LilywantbecomeNIUBI/fpga-system-integration/docs/evidence/adc_remap_v2/timing_report.txt

//Copyright (C)2014-2026 Gowin Semiconductor Corporation.
//All rights reserved.

INTRODUCTION:
The document contains two main sections: Timing Report Directory and Core Timing Report.

============================================================
Note:Timing Report Directory

1. Timing Message
2. Timing Summaries
	2.1 STA Tool Run Summary
	2.2 Clock Summary
	2.3 Max Frequency Summary
	2.4 Total Negative Slack Summary
3. Timing Details
	3.1 Path Slacks Table
		3.1.1 Setup Paths Table
		3.1.2 Hold Paths Table
		3.1.3 Recovery Paths Table
		3.1.4 Removal Paths Table
	3.2 Minimum Pulse Width Table
	3.3 Timing Report By Analysis Type
		3.3.1 Setup Analysis Report
		3.3.2 Hold Analysis Report
		3.3.3 Recovery Analysis Report
		3.3.4 Removal Analysis Report
	3.4 Minimum Pulse Width Report
	3.5 High Fanout Nets Report
	3.6 Route Congestions Report
	3.7 Timing Exceptions Report
		3.7.1 Setup Analysis Report
		3.7.2 Hold Analysis Report
		3.7.3 Recovery Analysis Report
		3.7.4 Recovery Analysis Report
	3.8 Timing Constraints Report

============================================================

Note:Core Timing Report

1. Timing Messages
<Report Title>: Timing Analysis Report
<Design File>: E:\Gowin_project\fpga_project\team_repos\fpga-system-integration\build\system\impl\gwsynthesis\system.vg
<Physical Constraints File>: E:\Gowin_project\fpga_project\team_repos\fpga-system-integration\build\system\system.cst
<Timing Constraints File>: E:\Gowin_project\fpga_project\team_repos\fpga-system-integration\build\system\system.sdc
<Tool Version>: V1.9.12.04 (64-bit)
<Part Number>: GW5AT-LV138PG484AC1/I0
<Device>: GW5AT-138
<Device Version>: B
<Created Time>: Thu Oct 29 13:29:05 2026

2. Timing Summaries
2.1 STA Tool Run Summary
<Setup Delay Model>:Slow 0.873V 0C C1/I0
<Hold Delay Model>:Fast 0.927V 85C C1/I0
<Numbers of Paths Analyzed>:73251
<Numbers of Endpoints Analyzed>:58299
<Numbers of Falling Endpoints>:5
<Numbers of Setup Violated Endpoints>:0
<Numbers of Hold Violated Endpoints>:0

2.2 Clock Summary
  NO.   Clock Name     Type      Period   Frequency    Rise     Fall    Source    Master      Objects
 ===== ============ =========== ======== ============ ======= ======== ========= ======== ================
  1     sys50        Base        20.000   50.000MHz    0.000   10.000                      clk50m
  2     cam_pclk     Base        11.905   84.000MHz    0.000   5.952                       camera_pclk
  3     eth_rx125    Base        8.000    125.000MHz   0.000   4.000                       rgmii_rxc
  4     control50    Generated   20.000   50.000MHz    0.000   10.000   clk50m    sys50    camera/clk50
  5     eth125       Generated   8.000    125.000MHz   0.000   4.000    clk50m    sys50    camera/clk125

2.3 Max Frequency Summary
  NO.   Clock Name    Constraint    Actual Fmax    Level   Entity
 ===== ============ ============== ============== ======= ========
  1     sys50        50.000(MHz)    73.301(MHz)    8       TOP
  2     cam_pclk     84.000(MHz)    84.184(MHz)    16      TOP
  3     eth_rx125    125.000(MHz)   372.537(MHz)   3       TOP
  4     control50    50.000(MHz)    158.688(MHz)   9       TOP
  5     eth125       125.000(MHz)   125.589(MHz)   1       TOP

2.4 Total Negative Slack Summary
  Clock Name   Analysis Type   EndPoints TNS   Number of EndPoints
 ============ =============== =============== =====================
  sys50        setup           0.000           0
  sys50        hold            0.000           0
  cam_pclk     setup           0.000           0
  cam_pclk     hold            0.000           0
  eth_rx125    setup           0.000           0
  eth_rx125    hold            0.000           0
  control50    setup           0.000           0
  control50    hold            0.000           0
  eth125       setup           0.000           0
  eth125       hold            0.000           0

3. Timing Details
3.1 Path Slacks Table
3.1.1 Setup Paths Table
<Report Command>:report_timing -setup -max_paths 25 -max_common_paths 1
  Path Number   Path Slack                     From Node                                           To Node                         From Clock      To Clock     Relation   Clock Skew   Data Delay
 ============= ============ ================================================ =================================================== ============== ============== ========== ============ ============
  1             0.026        camera/tracker/forward_u_6_s1/Q                  camera/tracker/lk/n1522_s/C[28]                     cam_pclk:[R]   cam_pclk:[R]   11.905     0.033        11.121
  2             0.029        camera/tracker/forward_u_6_s1/Q                  camera/tracker/lk/n1338_s/C[10]                     cam_pclk:[R]   cam_pclk:[R]   11.905     0.025        11.171
  3             0.038        camera/stream/frame_address_10_s9/Q              camera/stream/ram_ram_3_13_s/ADB[10]                eth125:[R]     eth125:[R]     8.000      0.066        7.962
  4             0.042        camera/tracker/forward_u_6_s1/Q                  camera/tracker/lk/n1522_s/C[45]                     cam_pclk:[R]   cam_pclk:[R]   11.905     0.033        11.313
  5             0.047        camera/tracker/sort_j_3_s3/Q                     camera/tracker/sort_u_sort_u_RAMREG_13_G[7]_s0/CE   cam_pclk:[R]   cam_pclk:[R]   11.905     0.020        11.558
  6             0.052        camera/stream/frame_address_2_s11/Q              camera/stream/ram_ram_1_1_s/ADB[2]                  eth125:[R]     eth125:[R]     8.000      0.050        7.963
  7             0.056        camera/tracker/forward_u_6_s1/Q                  camera/tracker/lk/n1522_s/C[46]                     cam_pclk:[R]   cam_pclk:[R]   11.905     0.033        11.186
  8             0.063        camera/stream/line_ram_line_ram_0_0_s/DO[5]      camera/runtime_network.net/udp/tx_data_5_s0/D       eth125:[R]     eth125:[R]     8.000      -0.022       7.902
  9             0.064        camera/runtime_network.net/retry_count_26_s0/Q   camera/runtime_network.net/action_2_s17/D           eth125:[R]     eth125:[R]     8.000      0.009        7.869
  10            0.074        camera/runtime_network.net/retry_count_26_s0/Q   camera/runtime_network.net/action_2_s8/D            eth125:[R]     eth125:[R]     8.000      0.041        7.828
  11            0.074        camera/runtime_network.net/retry_count_26_s0/Q   camera/runtime_network.net/action_2_s7/D            eth125:[R]     eth125:[R]     8.000      0.041        7.828
  12            0.074        camera/runtime_network.net/retry_count_26_s0/Q   camera/runtime_network.net/action_2_s6/D            eth125:[R]     eth125:[R]     8.000      0.041        7.828
  13            0.074        camera/runtime_network.net/retry_count_26_s0/Q   camera/runtime_network.net/action_2_s4/D            eth125:[R]     eth125:[R]     8.000      0.041        7.828
  14            0.074        camera/runtime_network.net/retry_count_26_s0/Q   camera/runtime_network.net/action_2_s0/D            eth125:[R]     eth125:[R]     8.000      0.041        7.828
  15            0.079        camera/stream/line_ram_line_ram_0_0_s/DO[15]     camera/runtime_network.net/udp/tx_data_7_s0/D       eth125:[R]     eth125:[R]     8.000      -0.028       7.892
  16            0.088        camera/tracker/forward_v_9_s1/Q                  camera/tracker/lk/n1338_s/A[10]                     cam_pclk:[R]   cam_pclk:[R]   11.905     -0.003       11.294
  17            0.092        camera/stream/line_ram_line_ram_0_0_s/DO[14]     camera/runtime_network.net/udp/tx_data_6_s0/D       eth125:[R]     eth125:[R]     8.000      -0.022       7.873
  18            0.092        camera/runtime_network.net/retry_count_26_s0/Q   camera/runtime_network.net/action_2_s16/D           eth125:[R]     eth125:[R]     8.000      0.052        7.799
  19            0.092        camera/runtime_network.net/retry_count_26_s0/Q   camera/runtime_network.net/action_2_s13/D           eth125:[R]     eth125:[R]     8.000      0.052        7.799
  20            0.097        camera/tracker/forward_u_6_s1/Q                  camera/tracker/lk/n1522_s/C[47]                     cam_pclk:[R]   cam_pclk:[R]   11.905     0.033        11.186
  21            0.101        camera/runtime_network.net/retry_count_26_s0/Q   camera/runtime_network.net/retry_count_3_s0/D       eth125:[R]     eth125:[R]     8.000      0.020        7.822
  22            0.101        camera/stream/line_ram_line_ram_0_0_s/DO[2]      camera/runtime_network.net/udp/tx_data_2_s0/D       eth125:[R]     eth125:[R]     8.000      -0.022       7.864
  23            0.104        camera/tracker/sort_j_3_s3/Q                     camera/tracker/sort_u_sort_u_RAMREG_15_G[2]_s0/CE   cam_pclk:[R]   cam_pclk:[R]   11.905     -0.070       11.591
  24            0.110        camera/tracker/x2_4_s0/Q                         camera/tracker/y2_1_s0/CE                           cam_pclk:[R]   cam_pclk:[R]   11.905     -0.015       11.529
  25            0.110        camera/tracker/x2_4_s0/Q                         camera/tracker/y2_4_s0/CE                           cam_pclk:[R]   cam_pclk:[R]   11.905     -0.015       11.529

3.1.2 Hold Paths Table
<Report Command>:report_timing -hold -max_paths 25 -max_common_paths 1
  Path Number   Path Slack                           From Node                                                       To Node                               From Clock       To Clock      Relation   Clock Skew   Data Delay
 ============= ============ ============================================================ =============================================================== =============== =============== ========== ============ ============
  1             0.216        camera/grid/a_col_6_s0/Q                                     camera/grid/vertical_y_vertical_y_0_0_s/ADB[10]                 cam_pclk:[R]    cam_pclk:[R]    0.000      -0.009       0.256
  2             0.222        camera/stream/frame_address_2_s1/Q                           camera/stream/ram_ram_0_15_s/ADB[2]                             eth125:[R]      eth125:[R]      0.000      -0.008       0.262
  3             0.230        camera/grid/a_col_2_s0/Q                                     camera/grid/vertical_y_vertical_y_0_0_s/ADB[6]                  cam_pclk:[R]    cam_pclk:[R]    0.000      0.003        0.258
  4             0.232        camera/pixels/out_pixel_3_s0/Q                               camera/stream/ram_ram_2_3_s/DI[0]                               cam_pclk:[R]    cam_pclk:[R]    0.000      -0.002       0.267
  5             0.239        camera/runtime_network.net/write_index_6_s5/Q                camera/runtime_network.net/packet_ram_packet_ram_0_0_s/ADA[9]   eth125:[R]      eth125:[R]      0.000      0.007        0.265
  6             0.247        sender/uart/count_3_s1/Q                                     sender/uart/count_3_s1/D                                        sys50:[R]       sys50:[R]       0.000      0.000        0.270
  7             0.247        imu_status/debug_seq_9_s0/Q                                  imu_status/debug_seq_9_s0/D                                     sys50:[R]       sys50:[R]       0.000      0.000        0.270
  8             0.247        imu_status/debug_seq_24_s0/Q                                 imu_status/debug_seq_24_s0/D                                    sys50:[R]       sys50:[R]       0.000      0.000        0.270
  9             0.247        imu/reader/bus/received_4_s0/Q                               imu/reader/bus/received_4_s0/D                                  sys50:[R]       sys50:[R]       0.000      0.000        0.270
  10            0.247        imu/reader/wait_count_27_s0/Q                                imu/reader/wait_count_27_s0/D                                   sys50:[R]       sys50:[R]       0.000      0.000        0.270
  11            0.247        camera/runtime_network.semantics/frame_idle_cycles_0_s3/Q    camera/runtime_network.semantics/frame_idle_cycles_0_s3/D       eth125:[R]      eth125:[R]      0.000      0.000        0.270
  12            0.247        camera/runtime_network.semantics/frame_idle_cycles_15_s1/Q   camera/runtime_network.semantics/frame_idle_cycles_15_s1/D      eth125:[R]      eth125:[R]      0.000      0.000        0.270
  13            0.247        camera/runtime_network.semantics/frame_idle_cycles_24_s1/Q   camera/runtime_network.semantics/frame_idle_cycles_24_s1/D      eth125:[R]      eth125:[R]      0.000      0.000        0.270
  14            0.247        camera/runtime_network.semantics/frame_idle_cycles_25_s1/Q   camera/runtime_network.semantics/frame_idle_cycles_25_s1/D      eth125:[R]      eth125:[R]      0.000      0.000        0.270
  15            0.247        camera/runtime_network.semantics/frame_idle_cycles_31_s1/Q   camera/runtime_network.semantics/frame_idle_cycles_31_s1/D      eth125:[R]      eth125:[R]      0.000      0.000        0.270
  16            0.247        camera/runtime_network.semantics/idle_cycles_12_s1/Q         camera/runtime_network.semantics/idle_cycles_12_s1/D            eth125:[R]      eth125:[R]      0.000      0.000        0.270
  17            0.247        camera/runtime_network.semantics/idle_cycles_15_s1/Q         camera/runtime_network.semantics/idle_cycles_15_s1/D            eth125:[R]      eth125:[R]      0.000      0.000        0.270
  18            0.247        camera/runtime_network.semantics/idle_cycles_19_s1/Q         camera/runtime_network.semantics/idle_cycles_19_s1/D            eth125:[R]      eth125:[R]      0.000      0.000        0.270
  19            0.247        camera/runtime_network.semantics/idle_cycles_31_s1/Q         camera/runtime_network.semantics/idle_cycles_31_s1/D            eth125:[R]      eth125:[R]      0.000      0.000        0.270
  20            0.247        camera/runtime_network.net/udp/cnt_data_3_s0/Q               camera/runtime_network.net/udp/cnt_data_3_s0/D                  eth125:[R]      eth125:[R]      0.000      0.000        0.270
  21            0.247        camera/runtime_network.net/udp/cnt_data_14_s0/Q              camera/runtime_network.net/udp/cnt_data_14_s0/D                 eth125:[R]      eth125:[R]      0.000      0.000        0.270
  22            0.247        camera/runtime_network.net/udp/cnt_preamble_0_s0/Q           camera/runtime_network.net/udp/cnt_preamble_0_s0/D              eth125:[R]      eth125:[R]      0.000      0.000        0.270
  23            0.247        camera/runtime_network.net/udp/cnt_preamble_1_s0/Q           camera/runtime_network.net/udp/cnt_preamble_1_s0/D              eth125:[R]      eth125:[R]      0.000      0.000        0.270
  24            0.247        camera/runtime_network.net/preamble_1_s1/Q                   camera/runtime_network.net/preamble_1_s1/D                      eth_rx125:[R]   eth_rx125:[R]   0.000      0.000        0.270
  25            0.247        camera/runtime_network.net/arp_index_2_s1/Q                  camera/runtime_network.net/arp_index_2_s1/D                     eth125:[R]      eth125:[R]      0.000      0.000        0.270

3.1.3 Recovery Paths Table
<Report Command>:report_timing -recovery -max_paths 25 -max_common_paths 1
  Path Number   Path Slack                    From Node                                  To Node                  From Clock      To Clock     Relation   Clock Skew   Data Delay
 ============= ============ ============================================= ===================================== ============== ============== ========== ============ ============
  1             2.022        camera/cap_reset/release_pipe_2_s0/Q          camera/tracker/lk/n2885_s/RESET[0]    cam_pclk:[R]   cam_pclk:[R]   11.905     -0.021       9.398
  2             2.272        camera/cap_reset/release_pipe_2_s0/Q          camera/tracker/lk/n2787_s/RESET[0]    cam_pclk:[R]   cam_pclk:[R]   11.905     -0.029       9.156
  3             2.454        camera/cap_reset/release_pipe_2_s0/Q          camera/tracker/lk/n2835_s/RESET[0]    cam_pclk:[R]   cam_pclk:[R]   11.905     -0.021       8.966
  4             2.571        camera/cap_reset/release_pipe_2_s0/Q          camera/tracker/lk/n2739_s/RESET[0]    cam_pclk:[R]   cam_pclk:[R]   11.905     0.068        8.762
  5             2.623        camera/cap_reset/release_pipe_2_s0/Q          camera/tracker/lk/n2691_s/RESET[0]    cam_pclk:[R]   cam_pclk:[R]   11.905     0.076        8.701
  6             4.184        camera/cap_reset/release_pipe_2_s0/Q          camera/tracker/n4966_s/RESET[0]       cam_pclk:[R]   cam_pclk:[R]   11.905     -0.029       7.245
  7             4.252        camera/cap_reset/release_pipe_2_s0/Q          camera/grid/n310_s/RESET[0]           cam_pclk:[R]   cam_pclk:[R]   11.905     -0.029       7.176
  8             4.346        camera/cap_reset/release_pipe_2_s0/Q          camera/tracker/n4674_s0/RESET[0]      cam_pclk:[R]   cam_pclk:[R]   11.905     -0.021       7.129
  9             4.398        camera/cap_reset/release_pipe_2_s0/Q          camera/tracker/lk/n1522_s/RESET[0]    cam_pclk:[R]   cam_pclk:[R]   11.905     -0.012       7.014
  10            4.400        camera/perception_reset/release_pipe_2_s0/Q   camera/stream/gap_0_s3/CLEAR          eth125:[R]     eth125:[R]     8.000      -0.017       3.304
  11            4.400        camera/perception_reset/release_pipe_2_s0/Q   camera/stream/gap_1_s0/CLEAR          eth125:[R]     eth125:[R]     8.000      -0.017       3.304
  12            4.400        camera/perception_reset/release_pipe_2_s0/Q   camera/stream/gap_2_s0/CLEAR          eth125:[R]     eth125:[R]     8.000      -0.017       3.304
  13            4.400        camera/perception_reset/release_pipe_2_s0/Q   camera/stream/ws1_0_s0/CLEAR          eth125:[R]     eth125:[R]     8.000      -0.017       3.304
  14            4.400        camera/perception_reset/release_pipe_2_s0/Q   camera/stream/state_1_s4/CLEAR        eth125:[R]     eth125:[R]     8.000      -0.008       3.296
  15            4.400        camera/perception_reset/release_pipe_2_s0/Q   camera/stream/state_2_s9/CLEAR        eth125:[R]     eth125:[R]     8.000      -0.008       3.296
  16            4.400        camera/perception_reset/release_pipe_2_s0/Q   camera/stream/state_2_s8/CLEAR        eth125:[R]     eth125:[R]     8.000      0.000        3.287
  17            4.400        camera/perception_reset/release_pipe_2_s0/Q   camera/stream/index_0_s4/CLEAR        eth125:[R]     eth125:[R]     8.000      -0.008       3.296
  18            4.400        camera/perception_reset/release_pipe_2_s0/Q   camera/stream/index_1_s3/CLEAR        eth125:[R]     eth125:[R]     8.000      0.000        3.287
  19            4.400        camera/perception_reset/release_pipe_2_s0/Q   camera/stream/state_0_s2/CLEAR        eth125:[R]     eth125:[R]     8.000      0.000        3.287
  20            4.400        camera/perception_reset/release_pipe_2_s0/Q   camera/stream/state_1_s3/CLEAR        eth125:[R]     eth125:[R]     8.000      -0.008       3.296
  21            4.400        camera/perception_reset/release_pipe_2_s0/Q   camera/stream/state_1_s2/CLEAR        eth125:[R]     eth125:[R]     8.000      0.000        3.287
  22            4.400        camera/perception_reset/release_pipe_2_s0/Q   camera/stream/state_2_s7/CLEAR        eth125:[R]     eth125:[R]     8.000      0.000        3.287
  23            4.400        camera/perception_reset/release_pipe_2_s0/Q   camera/stream/rptr_0_s4/CLEAR         eth125:[R]     eth125:[R]     8.000      0.000        3.287
  24            4.400        camera/perception_reset/release_pipe_2_s0/Q   camera/stream/word_index_0_s1/CLEAR   eth125:[R]     eth125:[R]     8.000      -0.008       3.296
  25            4.400        camera/perception_reset/release_pipe_2_s0/Q   camera/stream/word_index_4_s1/CLEAR   eth125:[R]     eth125:[R]     8.000      -0.008       3.296

3.1.4 Removal Paths Table
<Report Command>:report_timing -removal -max_paths 25 -max_common_paths 1
  Path Number   Path Slack                          From Node                                                      To Node                               From Clock       To Clock      Relation   Clock Skew   Data Delay
 ============= ============ ========================================================== =============================================================== =============== =============== ========== ============ ============
  1             0.369        camera/runtime_network.receive_reset/release_pipe_2_s1/Q   camera/runtime_network.net/write_mask_67_s0/CLEAR               eth_rx125:[R]   eth_rx125:[R]   0.000      0.004        0.318
  2             0.369        camera/runtime_network.receive_reset/release_pipe_2_s1/Q   camera/runtime_network.net/write_mask_69_s0/CLEAR               eth_rx125:[R]   eth_rx125:[R]   0.000      0.004        0.318
  3             0.369        camera/runtime_network.receive_reset/release_pipe_2_s1/Q   camera/runtime_network.net/write_mask_71_s0/CLEAR               eth_rx125:[R]   eth_rx125:[R]   0.000      0.004        0.318
  4             0.369        camera/runtime_network.receive_reset/release_pipe_2_s1/Q   camera/runtime_network.net/write_mask_73_s0/CLEAR               eth_rx125:[R]   eth_rx125:[R]   0.000      0.004        0.318
  5             0.369        camera/runtime_network.receive_reset/release_pipe_2_s1/Q   camera/runtime_network.net/rx_byte_2_s0/CLEAR                   eth_rx125:[R]   eth_rx125:[R]   0.000      0.004        0.318
  6             0.380        camera/sys_reset/release_pipe_2_s0/Q                       camera/config_camera/bus/dly_cnt_4_s1/CLEAR                     control50:[R]   control50:[R]   0.000      -0.007       0.339
  7             0.380        camera/sys_reset/release_pipe_2_s0/Q                       camera/config_camera/bus/dly_cnt_5_s1/CLEAR                     control50:[R]   control50:[R]   0.000      -0.007       0.339
  8             0.380        camera/sys_reset/release_pipe_2_s0/Q                       camera/config_camera/bus/dly_cnt_6_s1/CLEAR                     control50:[R]   control50:[R]   0.000      -0.007       0.339
  9             0.380        camera/sys_reset/release_pipe_2_s0/Q                       camera/config_camera/bus/dly_cnt_7_s1/CLEAR                     control50:[R]   control50:[R]   0.000      -0.007       0.339
  10            0.381        camera/sys_reset/release_pipe_2_s0/Q                       camera/config_camera/bus/i2c_bit_shift/state.RD_DATA_s0/CLEAR   control50:[R]   control50:[R]   0.000      0.002        0.332
  11            0.382        camera/sys_reset/release_pipe_2_s0/Q                       camera/config_camera/bus/RW_Done_s2/CLEAR                       control50:[R]   control50:[R]   0.000      -0.005       0.339
  12            0.382        camera/sys_reset/release_pipe_2_s0/Q                       camera/config_camera/bus/dly_cnt_2_s1/CLEAR                     control50:[R]   control50:[R]   0.000      -0.005       0.339
  13            0.383        camera/sys_reset/release_pipe_2_s0/Q                       camera/config_camera/bus/dly_cnt_15_s1/CLEAR                    control50:[R]   control50:[R]   0.000      -0.004       0.339
  14            0.383        camera/sys_reset/release_pipe_2_s0/Q                       camera/config_camera/bus/dly_cnt_16_s1/CLEAR                    control50:[R]   control50:[R]   0.000      -0.004       0.339
  15            0.383        camera/sys_reset/release_pipe_2_s0/Q                       camera/config_camera/bus/dly_cnt_17_s1/CLEAR                    control50:[R]   control50:[R]   0.000      -0.004       0.339
  16            0.385        camera/runtime_network.receive_reset/release_pipe_2_s1/Q   camera/runtime_network.net/write_mask_23_s0/CLEAR               eth_rx125:[R]   eth_rx125:[R]   0.000      -0.005       0.342
  17            0.385        camera/runtime_network.receive_reset/release_pipe_2_s1/Q   camera/runtime_network.net/write_mask_27_s0/CLEAR               eth_rx125:[R]   eth_rx125:[R]   0.000      -0.005       0.342
  18            0.385        camera/runtime_network.receive_reset/release_pipe_2_s1/Q   camera/runtime_network.net/write_mask_65_s0/CLEAR               eth_rx125:[R]   eth_rx125:[R]   0.000      -0.005       0.342
  19            0.385        camera/runtime_network.receive_reset/release_pipe_2_s1/Q   camera/runtime_network.net/write_mask_76_s0/CLEAR               eth_rx125:[R]   eth_rx125:[R]   0.000      -0.005       0.342
  20            0.385        camera/runtime_network.receive_reset/release_pipe_2_s1/Q   camera/runtime_network.net/write_mask_77_s0/CLEAR               eth_rx125:[R]   eth_rx125:[R]   0.000      -0.005       0.342
  21            0.385        camera/runtime_network.receive_reset/release_pipe_2_s1/Q   camera/runtime_network.net/write_mask_78_s0/CLEAR               eth_rx125:[R]   eth_rx125:[R]   0.000      -0.005       0.342
  22            0.387        camera/sys_reset/release_pipe_2_s0/Q                       camera/config_camera/bus/dly_cnt_12_s1/CLEAR                    control50:[R]   control50:[R]   0.000      0.000        0.339
  23            0.387        camera/sys_reset/release_pipe_2_s0/Q                       camera/config_camera/bus/dly_cnt_13_s1/CLEAR                    control50:[R]   control50:[R]   0.000      0.000        0.339
  24            0.387        camera/sys_reset/release_pipe_2_s0/Q                       camera/config_camera/bus/dly_cnt_14_s1/CLEAR                    control50:[R]   control50:[R]   0.000      0.000        0.339
  25            0.387        camera/sys_reset/release_pipe_2_s0/Q                       camera/config_camera/bus/state.IDLE_s0/PRESET                   control50:[R]   control50:[R]   0.000      0.000        0.339

3.2 Minimum Pulse Width Table
Report Command:report_min_pulse_width -nworst 10 -detail
  Number   Slack    Actual Width   Required Width         Type         Clock                   Objects
 ======== ======== ============== ================ ================== ======== =======================================
  1        -0.688   0.212          0.900            High Pulse Width   eth125   camera/stream/ram_ram_0_1_s
  2        -0.688   0.212          0.900            High Pulse Width   eth125   camera/stream/ram_ram_2_15_s
  3        -0.688   0.212          0.900            High Pulse Width   eth125   camera/stream/ram_ram_3_7_s
  4        -0.688   0.212          0.900            High Pulse Width   eth125   camera/stream/ram_ram_4_1_s
  5        -0.688   0.212          0.900            High Pulse Width   eth125   camera/stream/ram_ram_4_13_s
  6        -0.688   0.212          0.900            High Pulse Width   eth125   camera/stream/ram_ram_5_5_s
  7        -0.688   0.212          0.900            High Pulse Width   eth125   camera/stream/ram_ram_6_4_s
  8        -0.688   0.212          0.900            High Pulse Width   eth125   camera/stream/ram_ram_6_10_s
  9        -0.688   0.212          0.900            High Pulse Width   eth125   camera/stream/line_ram_line_ram_0_0_s
  10       -0.688   0.212          0.900            High Pulse Width   eth125   camera/stream/ram_ram_0_14_s

3.3 Timing Report By Analysis Type
3.3.1 Setup Analysis Report
Report Command:report_timing -setup -max_paths 25 -max_common_paths 1
						Path1
Path Summary:
Slack             : 0.026
Data Arrival Time : 16.583
Data Required Time: 16.609
From              : camera/tracker/forward_u_6_s1
To                : camera/tracker/lk/n1522_s
Launch Clk        : cam_pclk:[R]
Latch Clk         : cam_pclk:[R]

Data Arrival Path:
    AT     DELAY   TYPE   RF   FANOUT       LOC                      NODE
 ======== ======= ====== ==== ======== ============== ===================================
  0.000    0.000                                       active clock edge time
  0.000    0.000                                       cam_pclk
  0.000    0.000   tCL    RR   1        IOL2[A]        camera_pclk_ibuf/I
  0.614    0.614   tINS   RR   5101     IOL2[A]        camera_pclk_ibuf/O
  5.462    4.848   tNET   RR   1        R40C46[1][A]   camera/tracker/forward_u_6_s1/CLK
  5.807    0.344   tC2Q   RR   11       R40C46[1][A]   camera/tracker/forward_u_6_s1/Q
  6.262    0.456   tNET   RR   1        R44C47[2][A]   camera/tracker/n1646_s3/I0
  6.773    0.511   tINS   RR   1        R44C47[2][A]   camera/tracker/n1646_s3/F
  7.116    0.343   tNET   RR   2        R45C47[0][A]   camera/tracker/reverse_x_0_s/I1
  7.607    0.490   tINS   RR   1        R45C47[0][A]   camera/tracker/reverse_x_0_s/COUT
  7.607    0.000   tNET   RR   2        R45C47[0][B]   camera/tracker/reverse_x_1_s/CIN
  7.873    0.267   tINS   RR   3        R45C47[0][B]   camera/tracker/reverse_x_1_s/SUM
  8.337    0.463   tNET   RR   1        R49C47[3][B]   camera/tracker/lk/n218_s6/I1
  8.830    0.493   tINS   RR   1        R49C47[3][B]   camera/tracker/lk/n218_s6/F
  8.832    0.002   tNET   RR   1        R49C47[1][B]   camera/tracker/lk/n218_s5/I2
  9.353    0.521   tINS   RR   2        R49C47[1][B]   camera/tracker/lk/n218_s5/F
  9.886    0.533   tNET   RR   1        R50C51[2][B]   camera/tracker/lk/n217_s6/I3
  10.146   0.260   tINS   RR   2        R50C51[2][B]   camera/tracker/lk/n217_s6/F
  10.284   0.138   tNET   RR   1        R50C51[3][A]   camera/tracker/lk/n216_s6/I3
  10.571   0.287   tINS   RF   2        R50C51[3][A]   camera/tracker/lk/n216_s6/F
  10.716   0.145   tNET   FF   1        R50C51[2][A]   camera/tracker/lk/n215_s6/I3
  10.976   0.260   tINS   FR   3        R50C51[2][A]   camera/tracker/lk/n215_s6/F
  11.136   0.160   tNET   RR   1        R49C51[3][A]   camera/tracker/lk/n214_s6/I3
  11.423   0.287   tINS   RF   2        R49C51[3][A]   camera/tracker/lk/n214_s6/F
  11.432   0.009   tNET   FF   1        R49C51[1][B]   camera/tracker/lk/n213_s6/I3
  11.888   0.457   tINS   FR   3        R49C51[1][B]   camera/tracker/lk/n213_s6/F
  12.215   0.326   tNET   RR   1        R49C49[3][A]   camera/tracker/lk/n4680_s39/I2
  12.502   0.287   tINS   RF   2        R49C49[3][A]   camera/tracker/lk/n4680_s39/F
  12.511   0.009   tNET   FF   1        R49C49[2][A]   camera/tracker/lk/n211_s5/I3
  12.967   0.457   tINS   FR   1        R49C49[2][A]   camera/tracker/lk/n211_s5/F
  14.005   1.037   tNET   RR   2        R60C58[2][A]   camera/tracker/lk/n322_s/I0
  14.545   0.540   tINS   RF   1        R60C58[2][A]   camera/tracker/lk/n322_s/COUT
  14.545   0.000   tNET   FF   2        R60C58[2][B]   camera/tracker/lk/n321_s/CIN
  14.811   0.267   tINS   FR   5        R60C58[2][B]   camera/tracker/lk/n321_s/SUM
  15.568   0.757   tNET   RR   1        R57C55[3][A]   camera/tracker/lk/n4713_s43/I0
  15.830   0.262   tINS   RR   16       R57C55[3][A]   camera/tracker/lk/n4713_s43/F
  16.583   0.753   tNET   RR   1        DSP_R55[17]    camera/tracker/lk/n1522_s/C[28]

Data Required Path:
    AT     DELAY    TYPE   RF   FANOUT       LOC                     NODE
 ======== ======== ====== ==== ======== ============= ==================================
  11.905   11.905                                      active clock edge time
  11.905   0.000                                       cam_pclk
  11.905   0.000    tCL    RR   1        IOL2[A]       camera_pclk_ibuf/I
  12.519   0.614    tINS   RR   5101     IOL2[A]       camera_pclk_ibuf/O
  17.334   4.815    tNET   RR   1        DSP_R55[17]   camera/tracker/lk/n1522_s/CLK[0]
  16.609   -0.725   tSu         1        DSP_R55[17]   camera/tracker/lk/n1522_s

Path Statistics:
Clock Skew: -0.033
Setup Relationship: 11.905
Logic Level: 16
Arrival Clock Path delay: (cell: 0.614 11.245%,
                     route: 4.848 88.755%)
Arrival Data Path Delay: (cell: 5.644 50.754%,
                    route: 5.132 46.151%,
                    tC2Q: 0.344 3.096%)
Required Clock Path Delay: (cell: 0.614 11.314%,
                     route: 4.815 88.686%)

						Path2
Path Summary:
Slack             : 0.029
Data Arrival Time : 16.634
Data Required Time: 16.663
From              : camera/tracker/forward_u_6_s1
To                : camera/tracker/lk/n1338_s
Launch Clk        : cam_pclk:[R]
Latch Clk         : cam_pclk:[R]

Data Arrival Path:
    AT     DELAY   TYPE   RF   FANOUT       LOC                      NODE
 ======== ======= ====== ==== ======== ============== ===================================
  0.000    0.000                                       active clock edge time
  0.000    0.000                                       cam_pclk
  0.000    0.000   tCL    RR   1        IOL2[A]        camera_pclk_ibuf/I
  0.614    0.614   tINS   RR   5101     IOL2[A]        camera_pclk_ibuf/O
  5.462    4.848   tNET   RR   1        R40C46[1][A]   camera/tracker/forward_u_6_s1/CLK
  5.807    0.344   tC2Q   RR   11       R40C46[1][A]   camera/tracker/forward_u_6_s1/Q
  6.262    0.456   tNET   RR   1        R44C47[2][A]   camera/tracker/n1646_s3/I0
  6.773    0.511   tINS   RR   1        R44C47[2][A]   camera/tracker/n1646_s3/F
  7.116    0.343   tNET   RR   2        R45C47[0][A]   camera/tracker/reverse_x_0_s/I1
  7.607    0.490   tINS   RR   1        R45C47[0][A]   camera/tracker/reverse_x_0_s/COUT
  7.607    0.000   tNET   RR   2        R45C47[0][B]   camera/tracker/reverse_x_1_s/CIN
  7.873    0.267   tINS   RR   3        R45C47[0][B]   camera/tracker/reverse_x_1_s/SUM
  8.337    0.463   tNET   RR   1        R49C47[3][B]   camera/tracker/lk/n218_s6/I1
  8.830    0.493   tINS   RR   1        R49C47[3][B]   camera/tracker/lk/n218_s6/F
  8.832    0.002   tNET   RR   1        R49C47[1][B]   camera/tracker/lk/n218_s5/I2
  9.353    0.521   tINS   RR   2        R49C47[1][B]   camera/tracker/lk/n218_s5/F
  9.886    0.533   tNET   RR   1        R50C51[2][B]   camera/tracker/lk/n217_s6/I3
  10.146   0.260   tINS   RR   2        R50C51[2][B]   camera/tracker/lk/n217_s6/F
  10.284   0.138   tNET   RR   1        R50C51[3][A]   camera/tracker/lk/n216_s6/I3
  10.571   0.287   tINS   RF   2        R50C51[3][A]   camera/tracker/lk/n216_s6/F
  10.716   0.145   tNET   FF   1        R50C51[2][A]   camera/tracker/lk/n215_s6/I3
  10.976   0.260   tINS   FR   3        R50C51[2][A]   camera/tracker/lk/n215_s6/F
  11.136   0.160   tNET   RR   1        R49C51[3][A]   camera/tracker/lk/n214_s6/I3
  11.423   0.287   tINS   RF   2        R49C51[3][A]   camera/tracker/lk/n214_s6/F
  11.432   0.009   tNET   FF   1        R49C51[1][B]   camera/tracker/lk/n213_s6/I3
  11.888   0.457   tINS   FR   3        R49C51[1][B]   camera/tracker/lk/n213_s6/F
  12.215   0.326   tNET   RR   1        R49C49[3][A]   camera/tracker/lk/n4680_s39/I2
  12.502   0.287   tINS   RF   2        R49C49[3][A]   camera/tracker/lk/n4680_s39/F
  12.511   0.009   tNET   FF   1        R49C49[2][A]   camera/tracker/lk/n211_s5/I3
  12.967   0.457   tINS   FR   1        R49C49[2][A]   camera/tracker/lk/n211_s5/F
  14.005   1.037   tNET   RR   2        R60C58[2][A]   camera/tracker/lk/n322_s/I0
  14.708   0.703   tINS   RR   1        R60C58[2][A]   camera/tracker/lk/n322_s/SUM
  15.636   0.928   tNET   RR   1        R54C54[0][A]   camera/tracker/lk/n4714_s37/I0
  15.896   0.260   tINS   RR   3        R54C54[0][A]   camera/tracker/lk/n4714_s37/F
  16.634   0.738   tNET   RR   1        DSP_R55[18]    camera/tracker/lk/n1338_s/C[10]

Data Required Path:
    AT     DELAY    TYPE   RF   FANOUT       LOC                     NODE
 ======== ======== ====== ==== ======== ============= ==================================
  11.905   11.905                                      active clock edge time
  11.905   0.000                                       cam_pclk
  11.905   0.000    tCL    RR   1        IOL2[A]       camera_pclk_ibuf/I
  12.519   0.614    tINS   RR   5101     IOL2[A]       camera_pclk_ibuf/O
  17.342   4.823    tNET   RR   1        DSP_R55[18]   camera/tracker/lk/n1338_s/CLK[0]
  16.663   -0.680   tSu         1        DSP_R55[18]   camera/tracker/lk/n1338_s

Path Statistics:
Clock Skew: -0.025
Setup Relationship: 11.905
Logic Level: 15
Arrival Clock Path delay: (cell: 0.614 11.245%,
                     route: 4.848 88.755%)
Arrival Data Path Delay: (cell: 5.538 49.577%,
                    route: 5.289 47.341%,
                    tC2Q: 0.344 3.082%)
Required Clock Path Delay: (cell: 0.614 11.296%,
                     route: 4.823 88.704%)

						Path3
Path Summary:
Slack             : 0.038
Data Arrival Time : 15.152
Data Required Time: 15.189
From              : camera/stream/frame_address_10_s9
To                : camera/stream/ram_ram_3_13_s
Launch Clk        : eth125:[R]
Latch Clk         : eth125:[R]

Data Arrival Path:
    AT     DELAY   TYPE   RF   FANOUT         LOC                          NODE
 ======== ======= ====== ==== ======== ================== =======================================
  0.000    0.000                                           active clock edge time
  0.000    0.000                                           eth125
  3.835    3.835   tCL    RR   4971     PLL_B[2]           camera/pll/PLL_inst/CLKOUT1
  7.190    3.355   tNET   RR   1        R56C76[0][A]       camera/stream/frame_address_10_s9/CLK
  7.534    0.344   tC2Q   RR   16       R56C76[0][A]       camera/stream/frame_address_10_s9/Q
  15.152   7.617   tNET   RR   1        BSRAM_R64[23][A]   camera/stream/ram_ram_3_13_s/ADB[10]

Data Required Path:
    AT     DELAY   TYPE   RF   FANOUT         LOC                        NODE
 ======== ======= ====== ==== ======== ================== ===================================
  8.000    8.000                                           active clock edge time
  8.000    0.000                                           eth125
  11.835   3.835   tCL    RR   4971     PLL_B[2]           camera/pll/PLL_inst/CLKOUT1
  15.124   3.289   tNET   RR   1        BSRAM_R64[23][A]   camera/stream/ram_ram_3_13_s/CLKB
  15.189   0.065   tSu         1        BSRAM_R64[23][A]   camera/stream/ram_ram_3_13_s

Path Statistics:
Clock Skew: -0.066
Setup Relationship: 8.000
Logic Level: 1
Arrival Clock Path delay: (cell: 0.000 0.000%,
                     route: 3.355 100.000%)
Arrival Data Path Delay: (cell: 0.000 0.000%,
                    route: 7.617 95.676%,
                    tC2Q: 0.344 4.324%)
Required Clock Path Delay: (cell: 0.000 0.000%,
                     route: 3.289 100.000%)

						Path4
Path Summary:
Slack             : 0.042
Data Arrival Time : 16.775
Data Required Time: 16.817
From              : camera/tracker/forward_u_6_s1
To                : camera/tracker/lk/n1522_s
Launch Clk        : cam_pclk:[R]
Latch Clk         : cam_pclk:[R]

Data Arrival Path:
    AT     DELAY   TYPE   RF   FANOUT       LOC                      NODE
 ======== ======= ====== ==== ======== ============== ===================================
  0.000    0.000                                       active clock edge time
  0.000    0.000                                       cam_pclk
  0.000    0.000   tCL    RR   1        IOL2[A]        camera_pclk_ibuf/I
  0.614    0.614   tINS   RR   5101     IOL2[A]        camera_pclk_ibuf/O
  5.462    4.848   tNET   RR   1        R40C46[1][A]   camera/tracker/forward_u_6_s1/CLK
  5.807    0.344   tC2Q   RR   11       R40C46[1][A]   camera/tracker/forward_u_6_s1/Q
  6.262    0.456   tNET   RR   1        R44C47[2][A]   camera/tracker/n1646_s3/I0
  6.773    0.511   tINS   RR   1        R44C47[2][A]   camera/tracker/n1646_s3/F
  7.116    0.343   tNET   RR   2        R45C47[0][A]   camera/tracker/reverse_x_0_s/I1
  7.607    0.490   tINS   RR   1        R45C47[0][A]   camera/tracker/reverse_x_0_s/COUT
  7.607    0.000   tNET   RR   2        R45C47[0][B]   camera/tracker/reverse_x_1_s/CIN
  7.873    0.267   tINS   RR   3        R45C47[0][B]   camera/tracker/reverse_x_1_s/SUM
  8.337    0.463   tNET   RR   1        R49C47[3][B]   camera/tracker/lk/n218_s6/I1
  8.830    0.493   tINS   RR   1        R49C47[3][B]   camera/tracker/lk/n218_s6/F
  8.832    0.002   tNET   RR   1        R49C47[1][B]   camera/tracker/lk/n218_s5/I2
  9.353    0.521   tINS   RR   2        R49C47[1][B]   camera/tracker/lk/n218_s5/F
  9.886    0.533   tNET   RR   1        R50C51[2][B]   camera/tracker/lk/n217_s6/I3
  10.146   0.260   tINS   RR   2        R50C51[2][B]   camera/tracker/lk/n217_s6/F
  10.284   0.138   tNET   RR   1        R50C51[3][A]   camera/tracker/lk/n216_s6/I3
  10.571   0.287   tINS   RF   2        R50C51[3][A]   camera/tracker/lk/n216_s6/F
  10.716   0.145   tNET   FF   1        R50C51[2][A]   camera/tracker/lk/n215_s6/I3
  10.976   0.260   tINS   FR   3        R50C51[2][A]   camera/tracker/lk/n215_s6/F
  11.136   0.160   tNET   RR   1        R49C51[3][A]   camera/tracker/lk/n214_s6/I3
  11.423   0.287   tINS   RF   2        R49C51[3][A]   camera/tracker/lk/n214_s6/F
  11.432   0.009   tNET   FF   1        R49C51[1][B]   camera/tracker/lk/n213_s6/I3
  11.888   0.457   tINS   FR   3        R49C51[1][B]   camera/tracker/lk/n213_s6/F
  12.215   0.326   tNET   RR   1        R49C49[3][A]   camera/tracker/lk/n4680_s39/I2
  12.502   0.287   tINS   RF   2        R49C49[3][A]   camera/tracker/lk/n4680_s39/F
  12.511   0.009   tNET   FF   1        R49C49[2][A]   camera/tracker/lk/n211_s5/I3
  12.967   0.457   tINS   FR   1        R49C49[2][A]   camera/tracker/lk/n211_s5/F
  14.005   1.037   tNET   RR   2        R60C58[2][A]   camera/tracker/lk/n322_s/I0
  14.545   0.540   tINS   RF   1        R60C58[2][A]   camera/tracker/lk/n322_s/COUT
  14.545   0.000   tNET   FF   2        R60C58[2][B]   camera/tracker/lk/n321_s/CIN
  14.811   0.267   tINS   FR   5        R60C58[2][B]   camera/tracker/lk/n321_s/SUM
  15.568   0.757   tNET   RR   1        R57C55[0][A]   camera/tracker/lk/n4713_s37/I0
  16.025   0.457   tINS   RR   11       R57C55[0][A]   camera/tracker/lk/n4713_s37/F
  16.775   0.750   tNET   RR   1        DSP_R55[17]    camera/tracker/lk/n1522_s/C[45]

Data Required Path:
    AT     DELAY    TYPE   RF   FANOUT       LOC                     NODE
 ======== ======== ====== ==== ======== ============= ==================================
  11.905   11.905                                      active clock edge time
  11.905   0.000                                       cam_pclk
  11.905   0.000    tCL    RR   1        IOL2[A]       camera_pclk_ibuf/I
  12.519   0.614    tINS   RR   5101     IOL2[A]       camera_pclk_ibuf/O
  17.334   4.815    tNET   RR   1        DSP_R55[17]   camera/tracker/lk/n1522_s/CLK[0]
  16.817   -0.517   tSu         1        DSP_R55[17]   camera/tracker/lk/n1522_s

Path Statistics:
Clock Skew: -0.033
Setup Relationship: 11.905
Logic Level: 16
Arrival Clock Path delay: (cell: 0.614 11.245%,
                     route: 4.848 88.755%)
Arrival Data Path Delay: (cell: 5.839 51.611%,
                    route: 5.130 45.346%,
                    tC2Q: 0.344 3.043%)
Required Clock Path Delay: (cell: 0.614 11.314%,
                     route: 4.815 88.686%)

						Path5
Path Summary:
Slack             : 0.047
Data Arrival Time : 16.916
Data Required Time: 16.962
From              : camera/tracker/sort_j_3_s3
To                : camera/tracker/sort_u_sort_u_RAMREG_13_G[7]_s0
Launch Clk        : cam_pclk:[R]
Latch Clk         : cam_pclk:[R]

Data Arrival Path:
    AT     DELAY   TYPE   RF   FANOUT       LOC                              NODE
 ======== ======= ====== ==== ======== ============== ===================================================
  0.000    0.000                                       active clock edge time
  0.000    0.000                                       cam_pclk
  0.000    0.000   tCL    RR   1        IOL2[A]        camera_pclk_ibuf/I
  0.614    0.614   tINS   RR   5101     IOL2[A]        camera_pclk_ibuf/O
  5.357    4.743   tNET   RR   1        R40C35[3][B]   camera/tracker/sort_j_3_s3/CLK
  5.701    0.344   tC2Q   RR   16       R40C35[3][B]   camera/tracker/sort_j_3_s3/Q
  6.993    1.291   tNET   RR   1        R38C32[2][B]   camera/tracker/n3796_s17/I3
  7.504    0.511   tINS   RR   16       R38C32[2][B]   camera/tracker/n3796_s17/F
  8.318    0.815   tNET   RR   1        R35C30[0][B]   camera/tracker/sort_u_RAMOUT_105_G[0]_s42/I2
  8.829    0.511   tINS   RR   1        R35C30[0][B]   camera/tracker/sort_u_RAMOUT_105_G[0]_s42/F
  8.829    0.000   tNET   RR   1        R35C30[0][A]   camera/tracker/sort_u_RAMOUT_105_G[0]_s20/I1
  8.964    0.135   tINS   RR   1        R35C30[0][A]   camera/tracker/sort_u_RAMOUT_105_G[0]_s20/O
  8.964    0.000   tNET   RR   1        R35C30[0][B]   camera/tracker/sort_u_RAMOUT_105_G[0]_s10/I1
  9.042    0.078   tINS   RR   1        R35C30[0][B]   camera/tracker/sort_u_RAMOUT_105_G[0]_s10/O
  9.042    0.000   tNET   RR   1        R35C30[1][B]   camera/tracker/sort_u_RAMOUT_105_G[0]_s4/I1
  9.119    0.078   tINS   RR   2        R35C30[1][B]   camera/tracker/sort_u_RAMOUT_105_G[0]_s4/O
  10.680   1.560   tNET   RR   2        R31C34[0][B]   camera/tracker/n3816_s39/I1
  11.170   0.490   tINS   RR   1        R31C34[0][B]   camera/tracker/n3816_s39/COUT
  11.170   0.000   tNET   RR   2        R31C34[1][A]   camera/tracker/n3816_s40/CIN
  11.215   0.045   tINS   RR   1        R31C34[1][A]   camera/tracker/n3816_s40/COUT
  11.215   0.000   tNET   RR   2        R31C34[1][B]   camera/tracker/n3816_s41/CIN
  11.260   0.045   tINS   RR   1        R31C34[1][B]   camera/tracker/n3816_s41/COUT
  11.260   0.000   tNET   RR   2        R31C34[2][A]   camera/tracker/n3816_s42/CIN
  11.305   0.045   tINS   RR   1        R31C34[2][A]   camera/tracker/n3816_s42/COUT
  11.305   0.000   tNET   RR   2        R31C34[2][B]   camera/tracker/n3816_s43/CIN
  11.350   0.045   tINS   RR   1        R31C34[2][B]   camera/tracker/n3816_s43/COUT
  11.350   0.000   tNET   RR   2        R31C35[0][A]   camera/tracker/n3816_s44/CIN
  11.395   0.045   tINS   RR   1        R31C35[0][A]   camera/tracker/n3816_s44/COUT
  11.395   0.000   tNET   RR   2        R31C35[0][B]   camera/tracker/n3816_s45/CIN
  11.440   0.045   tINS   RR   1        R31C35[0][B]   camera/tracker/n3816_s45/COUT
  11.440   0.000   tNET   RR   2        R31C35[1][A]   camera/tracker/n3816_s46/CIN
  11.485   0.045   tINS   RR   1        R31C35[1][A]   camera/tracker/n3816_s46/COUT
  11.485   0.000   tNET   RR   2        R31C35[1][B]   camera/tracker/n3816_s47/CIN
  11.530   0.045   tINS   RR   7        R31C35[1][B]   camera/tracker/n3816_s47/COUT
  12.641   1.110   tNET   RR   1        R43C32[0][B]   camera/tracker/sort_u_s1376/I1
  13.151   0.511   tINS   RR   10       R43C32[0][B]   camera/tracker/sort_u_s1376/F
  13.323   0.172   tNET   RR   1        R43C31[2][A]   camera/tracker/sort_u_s1373/I2
  13.583   0.260   tINS   RR   8        R43C31[2][A]   camera/tracker/sort_u_s1373/F
  14.154   0.570   tNET   RR   1        R41C34[2][B]   camera/tracker/sort_u_s1304/I2
  14.610   0.457   tINS   RR   16       R41C34[2][B]   camera/tracker/sort_u_s1304/F
  16.916   2.305   tNET   RR   1        R35C28[2][A]   camera/tracker/sort_u_sort_u_RAMREG_13_G[7]_s0/CE

Data Required Path:
    AT     DELAY    TYPE   RF   FANOUT       LOC                               NODE
 ======== ======== ====== ==== ======== ============== ====================================================
  11.905   11.905                                       active clock edge time
  11.905   0.000                                        cam_pclk
  11.905   0.000    tCL    RR   1        IOL2[A]        camera_pclk_ibuf/I
  12.519   0.614    tINS   RR   5101     IOL2[A]        camera_pclk_ibuf/O
  17.242   4.723    tNET   RR   1        R35C28[2][A]   camera/tracker/sort_u_sort_u_RAMREG_13_G[7]_s0/CLK
  16.962   -0.280   tSu         1        R35C28[2][A]   camera/tracker/sort_u_sort_u_RAMREG_13_G[7]_s0

Path Statistics:
Clock Skew: -0.020
Setup Relationship: 11.905
Logic Level: 9
Arrival Clock Path delay: (cell: 0.614 11.466%,
                     route: 4.743 88.534%)
Arrival Data Path Delay: (cell: 3.390 29.326%,
                    route: 7.824 67.695%,
                    tC2Q: 0.344 2.978%)
Required Clock Path Delay: (cell: 0.614 11.508%,
                     route: 4.723 88.492%)

						Path6
Path Summary:
Slack             : 0.052
Data Arrival Time : 15.137
Data Required Time: 15.189
From              : camera/stream/frame_address_2_s11
To                : camera/stream/ram_ram_1_1_s
Launch Clk        : eth125:[R]
Latch Clk         : eth125:[R]

Data Arrival Path:
    AT     DELAY   TYPE   RF   FANOUT        LOC                        NODE
 ======== ======= ====== ==== ======== =============== =======================================
  0.000    0.000                                        active clock edge time
  0.000    0.000                                        eth125
  3.835    3.835   tCL    RR   4971     PLL_B[2]        camera/pll/PLL_inst/CLKOUT1
  7.174    3.339   tNET   RR   1        R53C78[0][B]    camera/stream/frame_address_2_s11/CLK
  7.518    0.344   tC2Q   RR   16       R53C78[0][B]    camera/stream/frame_address_2_s11/Q
  15.137   7.618   tNET   RR   1        BSRAM_R64[20]   camera/stream/ram_ram_1_1_s/ADB[2]

Data Required Path:
    AT     DELAY   TYPE   RF   FANOUT        LOC                      NODE
 ======== ======= ====== ==== ======== =============== ==================================
  8.000    8.000                                        active clock edge time
  8.000    0.000                                        eth125
  11.835   3.835   tCL    RR   4971     PLL_B[2]        camera/pll/PLL_inst/CLKOUT1
  15.124   3.289   tNET   RR   1        BSRAM_R64[20]   camera/stream/ram_ram_1_1_s/CLKB
  15.189   0.065   tSu         1        BSRAM_R64[20]   camera/stream/ram_ram_1_1_s

Path Statistics:
Clock Skew: -0.050
Setup Relationship: 8.000
Logic Level: 1
Arrival Clock Path delay: (cell: 0.000 0.000%,
                     route: 3.339 100.000%)
Arrival Data Path Delay: (cell: 0.000 0.000%,
                    route: 7.618 95.677%,
                    tC2Q: 0.344 4.323%)
Required Clock Path Delay: (cell: 0.000 0.000%,
                     route: 3.289 100.000%)

						Path7
Path Summary:
Slack             : 0.056
Data Arrival Time : 16.648
Data Required Time: 16.705
From              : camera/tracker/forward_u_6_s1
To                : camera/tracker/lk/n1522_s
Launch Clk        : cam_pclk:[R]
Latch Clk         : cam_pclk:[R]

Data Arrival Path:
    AT     DELAY   TYPE   RF   FANOUT       LOC                      NODE
 ======== ======= ====== ==== ======== ============== ===================================
  0.000    0.000                                       active clock edge time
  0.000    0.000                                       cam_pclk
  0.000    0.000   tCL    RR   1        IOL2[A]        camera_pclk_ibuf/I
  0.614    0.614   tINS   RR   5101     IOL2[A]        camera_pclk_ibuf/O
  5.462    4.848   tNET   RR   1        R40C46[1][A]   camera/tracker/forward_u_6_s1/CLK
  5.807    0.344   tC2Q   RR   11       R40C46[1][A]   camera/tracker/forward_u_6_s1/Q
  6.262    0.456   tNET   RR   1        R44C47[2][A]   camera/tracker/n1646_s3/I0
  6.773    0.511   tINS   RR   1        R44C47[2][A]   camera/tracker/n1646_s3/F
  7.116    0.343   tNET   RR   2        R45C47[0][A]   camera/tracker/reverse_x_0_s/I1
  7.607    0.490   tINS   RR   1        R45C47[0][A]   camera/tracker/reverse_x_0_s/COUT
  7.607    0.000   tNET   RR   2        R45C47[0][B]   camera/tracker/reverse_x_1_s/CIN
  7.873    0.267   tINS   RR   3        R45C47[0][B]   camera/tracker/reverse_x_1_s/SUM
  8.337    0.463   tNET   RR   1        R49C47[3][B]   camera/tracker/lk/n218_s6/I1
  8.830    0.493   tINS   RR   1        R49C47[3][B]   camera/tracker/lk/n218_s6/F
  8.832    0.002   tNET   RR   1        R49C47[1][B]   camera/tracker/lk/n218_s5/I2
  9.353    0.521   tINS   RR   2        R49C47[1][B]   camera/tracker/lk/n218_s5/F
  9.886    0.533   tNET   RR   1        R50C51[2][B]   camera/tracker/lk/n217_s6/I3
  10.146   0.260   tINS   RR   2        R50C51[2][B]   camera/tracker/lk/n217_s6/F
  10.284   0.138   tNET   RR   1        R50C51[3][A]   camera/tracker/lk/n216_s6/I3
  10.571   0.287   tINS   RF   2        R50C51[3][A]   camera/tracker/lk/n216_s6/F
  10.716   0.145   tNET   FF   1        R50C51[2][A]   camera/tracker/lk/n215_s6/I3
  10.976   0.260   tINS   FR   3        R50C51[2][A]   camera/tracker/lk/n215_s6/F
  11.136   0.160   tNET   RR   1        R49C51[3][A]   camera/tracker/lk/n214_s6/I3
  11.423   0.287   tINS   RF   2        R49C51[3][A]   camera/tracker/lk/n214_s6/F
  11.432   0.009   tNET   FF   1        R49C51[1][B]   camera/tracker/lk/n213_s6/I3
  11.888   0.457   tINS   FR   3        R49C51[1][B]   camera/tracker/lk/n213_s6/F
  12.215   0.326   tNET   RR   1        R49C49[3][A]   camera/tracker/lk/n4680_s39/I2
  12.502   0.287   tINS   RF   2        R49C49[3][A]   camera/tracker/lk/n4680_s39/F
  12.511   0.009   tNET   FF   1        R49C49[2][A]   camera/tracker/lk/n211_s5/I3
  12.967   0.457   tINS   FR   1        R49C49[2][A]   camera/tracker/lk/n211_s5/F
  14.005   1.037   tNET   RR   2        R60C58[2][A]   camera/tracker/lk/n322_s/I0
  14.545   0.540   tINS   RF   1        R60C58[2][A]   camera/tracker/lk/n322_s/COUT
  14.545   0.000   tNET   FF   2        R60C58[2][B]   camera/tracker/lk/n321_s/CIN
  14.811   0.267   tINS   FR   5        R60C58[2][B]   camera/tracker/lk/n321_s/SUM
  15.568   0.757   tNET   RR   1        R57C55[0][A]   camera/tracker/lk/n4713_s37/I0
  16.025   0.457   tINS   RR   11       R57C55[0][A]   camera/tracker/lk/n4713_s37/F
  16.648   0.623   tNET   RR   1        DSP_R55[17]    camera/tracker/lk/n1522_s/C[46]

Data Required Path:
    AT     DELAY    TYPE   RF   FANOUT       LOC                     NODE
 ======== ======== ====== ==== ======== ============= ==================================
  11.905   11.905                                      active clock edge time
  11.905   0.000                                       cam_pclk
  11.905   0.000    tCL    RR   1        IOL2[A]       camera_pclk_ibuf/I
  12.519   0.614    tINS   RR   5101     IOL2[A]       camera_pclk_ibuf/O
  17.334   4.815    tNET   RR   1        DSP_R55[17]   camera/tracker/lk/n1522_s/CLK[0]
  16.705   -0.629   tSu         1        DSP_R55[17]   camera/tracker/lk/n1522_s

Path Statistics:
Clock Skew: -0.033
Setup Relationship: 11.905
Logic Level: 16
Arrival Clock Path delay: (cell: 0.614 11.245%,
                     route: 4.848 88.755%)
Arrival Data Path Delay: (cell: 5.839 52.198%,
                    route: 5.003 44.725%,
                    tC2Q: 0.344 3.078%)
Required Clock Path Delay: (cell: 0.614 11.314%,
                     route: 4.815 88.686%)

						Path8
Path Summary:
Slack             : 0.063
Data Arrival Time : 15.070
Data Required Time: 15.132
From              : camera/stream/line_ram_line_ram_0_0_s
To                : camera/runtime_network.net/udp/tx_data_5_s0
Launch Clk        : eth125:[R]
Latch Clk         : eth125:[R]

Data Arrival Path:
    AT     DELAY   TYPE   RF   FANOUT        LOC                            NODE
 ======== ======= ====== ==== ======== =============== ===============================================
  0.000    0.000                                        active clock edge time
  0.000    0.000                                        eth125
  3.835    3.835   tCL    RR   4971     PLL_B[2]        camera/pll/PLL_inst/CLKOUT1
  7.168    3.333   tNET   RR   16       BSRAM_R64[15]   camera/stream/line_ram_line_ram_0_0_s/CLKB
  8.977    1.809   tC2Q   RR   1        BSRAM_R64[15]   camera/stream/line_ram_line_ram_0_0_s/DO[5]
  10.356   1.379   tNET   RR   1        R45C71[1][B]    camera/stream/payload_5_s0/I1
  10.813   0.457   tINS   RR   1        R45C71[1][B]    camera/stream/payload_5_s0/F
  12.138   1.325   tNET   RR   1        R68C78[1][B]    camera/stream/payload_5_s/I2
  12.398   0.260   tINS   RR   2        R68C78[1][B]    camera/stream/payload_5_s/F
  12.997   0.600   tNET   RR   1        R77C80[2][A]    camera/runtime_network.net/udp/n936_s21/I0
  13.257   0.260   tINS   RR   1        R77C80[2][A]    camera/runtime_network.net/udp/n936_s21/F
  13.788   0.531   tNET   RR   1        R75C82[0][B]    camera/runtime_network.net/udp/n936_s15/I1
  14.048   0.260   tINS   RR   1        R75C82[0][B]    camera/runtime_network.net/udp/n936_s15/F
  14.203   0.155   tNET   RR   1        R74C82[2][B]    camera/runtime_network.net/udp/n936_s9/I2
  14.463   0.260   tINS   RR   1        R74C82[2][B]    camera/runtime_network.net/udp/n936_s9/F
  14.810   0.346   tNET   RR   1        R74C84[1][B]    camera/runtime_network.net/udp/n936_s6/I3
  15.070   0.260   tINS   RR   1        R74C84[1][B]    camera/runtime_network.net/udp/n936_s6/F
  15.070   0.000   tNET   RR   1        R74C84[1][B]    camera/runtime_network.net/udp/tx_data_5_s0/D

Data Required Path:
    AT     DELAY    TYPE   RF   FANOUT       LOC                             NODE
 ======== ======== ====== ==== ======== ============== =================================================
  8.000    8.000                                        active clock edge time
  8.000    0.000                                        eth125
  11.835   3.835    tCL    RR   4971     PLL_B[2]       camera/pll/PLL_inst/CLKOUT1
  15.190   3.355    tNET   RR   1        R74C84[1][B]   camera/runtime_network.net/udp/tx_data_5_s0/CLK
  15.132   -0.057   tSu         1        R74C84[1][B]   camera/runtime_network.net/udp/tx_data_5_s0

Path Statistics:
Clock Skew: 0.022
Setup Relationship: 8.000
Logic Level: 7
Arrival Clock Path delay: (cell: 0.000 0.000%,
                     route: 3.333 100.000%)
Arrival Data Path Delay: (cell: 1.756 22.224%,
                    route: 4.337 54.883%,
                    tC2Q: 1.809 22.893%)
Required Clock Path Delay: (cell: 0.000 0.000%,
                     route: 3.355 100.000%)

						Path9
Path Summary:
Slack             : 0.064
Data Arrival Time : 15.024
Data Required Time: 15.088
From              : camera/runtime_network.net/retry_count_26_s0
To                : camera/runtime_network.net/action_2_s17
Launch Clk        : eth125:[R]
Latch Clk         : eth125:[R]

Data Arrival Path:
    AT     DELAY   TYPE   RF   FANOUT        LOC                              NODE
 ======== ======= ====== ==== ======== =============== ==================================================
  0.000    0.000                                        active clock edge time
  0.000    0.000                                        eth125
  3.835    3.835   tCL    RR   4971     PLL_B[2]        camera/pll/PLL_inst/CLKOUT1
  7.154    3.319   tNET   RR   1        R74C97[0][A]    camera/runtime_network.net/retry_count_26_s0/CLK
  7.499    0.344   tC2Q   RR   3        R74C97[0][A]    camera/runtime_network.net/retry_count_26_s0/Q
  8.256    0.757   tNET   RR   1        R78C102[3][B]   camera/runtime_network.net/n14594_s10/I0
  8.772    0.516   tINS   RR   1        R78C102[3][B]   camera/runtime_network.net/n14594_s10/F
  8.927    0.155   tNET   RR   1        R79C102[1][A]   camera/runtime_network.net/n14594_s8/I2
  9.438    0.511   tINS   RR   3        R79C102[1][A]   camera/runtime_network.net/n14594_s8/F
  9.920    0.481   tNET   RR   1        R80C103[3][A]   camera/runtime_network.net/n14621_s7/I3
  10.412   0.493   tINS   RR   2        R80C103[3][A]   camera/runtime_network.net/n14621_s7/F
  10.570   0.157   tNET   RR   1        R79C103[3][B]   camera/runtime_network.net/n14621_s6/I2
  11.086   0.516   tINS   RR   11       R79C103[3][B]   camera/runtime_network.net/n14621_s6/F
  12.020   0.934   tNET   RR   1        R70C93[2][B]    camera/runtime_network.net/n10253_s5/I3
  12.541   0.521   tINS   RR   4        R70C93[2][B]    camera/runtime_network.net/n10253_s5/F
  12.891   0.350   tNET   RR   1        R71C92[1][A]    camera/runtime_network.net/n10253_s9/I0
  13.402   0.511   tINS   RR   9        R71C92[1][A]    camera/runtime_network.net/n10253_s9/F
  14.503   1.101   tNET   RR   1        R60C101[0][A]   camera/runtime_network.net/n10252_s21/I2
  15.024   0.521   tINS   RR   1        R60C101[0][A]   camera/runtime_network.net/n10252_s21/F
  15.024   0.000   tNET   RR   1        R60C101[0][A]   camera/runtime_network.net/action_2_s17/D

Data Required Path:
    AT     DELAY    TYPE   RF   FANOUT        LOC                           NODE
 ======== ======== ====== ==== ======== =============== =============================================
  8.000    8.000                                         active clock edge time
  8.000    0.000                                         eth125
  11.835   3.835    tCL    RR   4971     PLL_B[2]        camera/pll/PLL_inst/CLKOUT1
  15.145   3.310    tNET   RR   1        R60C101[0][A]   camera/runtime_network.net/action_2_s17/CLK
  15.088   -0.057   tSu         1        R60C101[0][A]   camera/runtime_network.net/action_2_s17

Path Statistics:
Clock Skew: -0.009
Setup Relationship: 8.000
Logic Level: 8
Arrival Clock Path delay: (cell: 0.000 0.000%,
                     route: 3.319 100.000%)
Arrival Data Path Delay: (cell: 3.589 45.604%,
                    route: 3.936 50.021%,
                    tC2Q: 0.344 4.375%)
Required Clock Path Delay: (cell: 0.000 0.000%,
                     route: 3.310 100.000%)

						Path10
Path Summary:
Slack             : 0.074
Data Arrival Time : 14.982
Data Required Time: 15.056
From              : camera/runtime_network.net/retry_count_26_s0
To                : camera/runtime_network.net/action_2_s8
Launch Clk        : eth125:[R]
Latch Clk         : eth125:[R]

Data Arrival Path:
    AT     DELAY   TYPE   RF   FANOUT        LOC                              NODE
 ======== ======= ====== ==== ======== =============== ==================================================
  0.000    0.000                                        active clock edge time
  0.000    0.000                                        eth125
  3.835    3.835   tCL    RR   4971     PLL_B[2]        camera/pll/PLL_inst/CLKOUT1
  7.154    3.319   tNET   RR   1        R74C97[0][A]    camera/runtime_network.net/retry_count_26_s0/CLK
  7.499    0.344   tC2Q   RR   3        R74C97[0][A]    camera/runtime_network.net/retry_count_26_s0/Q
  8.256    0.757   tNET   RR   1        R78C102[3][B]   camera/runtime_network.net/n14594_s10/I0
  8.772    0.516   tINS   RR   1        R78C102[3][B]   camera/runtime_network.net/n14594_s10/F
  8.927    0.155   tNET   RR   1        R79C102[1][A]   camera/runtime_network.net/n14594_s8/I2
  9.438    0.511   tINS   RR   3        R79C102[1][A]   camera/runtime_network.net/n14594_s8/F
  9.920    0.481   tNET   RR   1        R80C103[3][A]   camera/runtime_network.net/n14621_s7/I3
  10.412   0.493   tINS   RR   2        R80C103[3][A]   camera/runtime_network.net/n14621_s7/F
  10.570   0.157   tNET   RR   1        R79C103[3][B]   camera/runtime_network.net/n14621_s6/I2
  11.086   0.516   tINS   RR   11       R79C103[3][B]   camera/runtime_network.net/n14621_s6/F
  12.020   0.934   tNET   RR   1        R70C93[2][B]    camera/runtime_network.net/n10253_s5/I3
  12.541   0.521   tINS   RR   4        R70C93[2][B]    camera/runtime_network.net/n10253_s5/F
  12.891   0.350   tNET   RR   1        R71C92[2][B]    camera/runtime_network.net/n10253_s8/I0
  13.412   0.521   tINS   RR   10       R71C92[2][B]    camera/runtime_network.net/n10253_s8/F
  14.471   1.060   tNET   RR   1        R68C103[2][A]   camera/runtime_network.net/n10252_s12/I2
  14.982   0.511   tINS   RR   1        R68C103[2][A]   camera/runtime_network.net/n10252_s12/F
  14.982   0.000   tNET   RR   1        R68C103[2][A]   camera/runtime_network.net/action_2_s8/D

Data Required Path:
    AT     DELAY    TYPE   RF   FANOUT        LOC                           NODE
 ======== ======== ====== ==== ======== =============== ============================================
  8.000    8.000                                         active clock edge time
  8.000    0.000                                         eth125
  11.835   3.835    tCL    RR   4971     PLL_B[2]        camera/pll/PLL_inst/CLKOUT1
  15.113   3.278    tNET   RR   1        R68C103[2][A]   camera/runtime_network.net/action_2_s8/CLK
  15.056   -0.057   tSu         1        R68C103[2][A]   camera/runtime_network.net/action_2_s8

Path Statistics:
Clock Skew: -0.041
Setup Relationship: 8.000
Logic Level: 8
Arrival Clock Path delay: (cell: 0.000 0.000%,
                     route: 3.319 100.000%)
Arrival Data Path Delay: (cell: 3.589 45.847%,
                    route: 3.895 49.756%,
                    tC2Q: 0.344 4.398%)
Required Clock Path Delay: (cell: 0.000 0.000%,
                     route: 3.278 100.000%)

						Path11
Path Summary:
Slack             : 0.074
Data Arrival Time : 14.982
Data Required Time: 15.056
From              : camera/runtime_network.net/retry_count_26_s0
To                : camera/runtime_network.net/action_2_s7
Launch Clk        : eth125:[R]
Latch Clk         : eth125:[R]

Data Arrival Path:
    AT     DELAY   TYPE   RF   FANOUT        LOC                              NODE
 ======== ======= ====== ==== ======== =============== ==================================================
  0.000    0.000                                        active clock edge time
  0.000    0.000                                        eth125
  3.835    3.835   tCL    RR   4971     PLL_B[2]        camera/pll/PLL_inst/CLKOUT1
  7.154    3.319   tNET   RR   1        R74C97[0][A]    camera/runtime_network.net/retry_count_26_s0/CLK
  7.499    0.344   tC2Q   RR   3        R74C97[0][A]    camera/runtime_network.net/retry_count_26_s0/Q
  8.256    0.757   tNET   RR   1        R78C102[3][B]   camera/runtime_network.net/n14594_s10/I0
  8.772    0.516   tINS   RR   1        R78C102[3][B]   camera/runtime_network.net/n14594_s10/F
  8.927    0.155   tNET   RR   1        R79C102[1][A]   camera/runtime_network.net/n14594_s8/I2
  9.438    0.511   tINS   RR   3        R79C102[1][A]   camera/runtime_network.net/n14594_s8/F
  9.920    0.481   tNET   RR   1        R80C103[3][A]   camera/runtime_network.net/n14621_s7/I3
  10.412   0.493   tINS   RR   2        R80C103[3][A]   camera/runtime_network.net/n14621_s7/F
  10.570   0.157   tNET   RR   1        R79C103[3][B]   camera/runtime_network.net/n14621_s6/I2
  11.086   0.516   tINS   RR   11       R79C103[3][B]   camera/runtime_network.net/n14621_s6/F
  12.020   0.934   tNET   RR   1        R70C93[2][B]    camera/runtime_network.net/n10253_s5/I3
  12.541   0.521   tINS   RR   4        R70C93[2][B]    camera/runtime_network.net/n10253_s5/F
  12.891   0.350   tNET   RR   1        R71C92[2][B]    camera/runtime_network.net/n10253_s8/I0
  13.412   0.521   tINS   RR   10       R71C92[2][B]    camera/runtime_network.net/n10253_s8/F
  14.471   1.060   tNET   RR   1        R68C103[2][B]   camera/runtime_network.net/n10252_s11/I2
  14.982   0.511   tINS   RR   1        R68C103[2][B]   camera/runtime_network.net/n10252_s11/F
  14.982   0.000   tNET   RR   1        R68C103[2][B]   camera/runtime_network.net/action_2_s7/D

Data Required Path:
    AT     DELAY    TYPE   RF   FANOUT        LOC                           NODE
 ======== ======== ====== ==== ======== =============== ============================================
  8.000    8.000                                         active clock edge time
  8.000    0.000                                         eth125
  11.835   3.835    tCL    RR   4971     PLL_B[2]        camera/pll/PLL_inst/CLKOUT1
  15.113   3.278    tNET   RR   1        R68C103[2][B]   camera/runtime_network.net/action_2_s7/CLK
  15.056   -0.057   tSu         1        R68C103[2][B]   camera/runtime_network.net/action_2_s7

Path Statistics:
Clock Skew: -0.041
Setup Relationship: 8.000
Logic Level: 8
Arrival Clock Path delay: (cell: 0.000 0.000%,
                     route: 3.319 100.000%)
Arrival Data Path Delay: (cell: 3.589 45.847%,
                    route: 3.895 49.756%,
                    tC2Q: 0.344 4.398%)
Required Clock Path Delay: (cell: 0.000 0.000%,
                     route: 3.278 100.000%)

						Path12
Path Summary:
Slack             : 0.074
Data Arrival Time : 14.982
Data Required Time: 15.056
From              : camera/runtime_network.net/retry_count_26_s0
To                : camera/runtime_network.net/action_2_s6
Launch Clk        : eth125:[R]
Latch Clk         : eth125:[R]

Data Arrival Path:
    AT     DELAY   TYPE   RF   FANOUT        LOC                              NODE
 ======== ======= ====== ==== ======== =============== ==================================================
  0.000    0.000                                        active clock edge time
  0.000    0.000                                        eth125
  3.835    3.835   tCL    RR   4971     PLL_B[2]        camera/pll/PLL_inst/CLKOUT1
  7.154    3.319   tNET   RR   1        R74C97[0][A]    camera/runtime_network.net/retry_count_26_s0/CLK
  7.499    0.344   tC2Q   RR   3        R74C97[0][A]    camera/runtime_network.net/retry_count_26_s0/Q
  8.256    0.757   tNET   RR   1        R78C102[3][B]   camera/runtime_network.net/n14594_s10/I0
  8.772    0.516   tINS   RR   1        R78C102[3][B]   camera/runtime_network.net/n14594_s10/F
  8.927    0.155   tNET   RR   1        R79C102[1][A]   camera/runtime_network.net/n14594_s8/I2
  9.438    0.511   tINS   RR   3        R79C102[1][A]   camera/runtime_network.net/n14594_s8/F
  9.920    0.481   tNET   RR   1        R80C103[3][A]   camera/runtime_network.net/n14621_s7/I3
  10.412   0.493   tINS   RR   2        R80C103[3][A]   camera/runtime_network.net/n14621_s7/F
  10.570   0.157   tNET   RR   1        R79C103[3][B]   camera/runtime_network.net/n14621_s6/I2
  11.086   0.516   tINS   RR   11       R79C103[3][B]   camera/runtime_network.net/n14621_s6/F
  12.020   0.934   tNET   RR   1        R70C93[2][B]    camera/runtime_network.net/n10253_s5/I3
  12.541   0.521   tINS   RR   4        R70C93[2][B]    camera/runtime_network.net/n10253_s5/F
  12.891   0.350   tNET   RR   1        R71C92[2][B]    camera/runtime_network.net/n10253_s8/I0
  13.412   0.521   tINS   RR   10       R71C92[2][B]    camera/runtime_network.net/n10253_s8/F
  14.471   1.060   tNET   RR   1        R68C103[1][A]   camera/runtime_network.net/n10252_s10/I2
  14.982   0.511   tINS   RR   1        R68C103[1][A]   camera/runtime_network.net/n10252_s10/F
  14.982   0.000   tNET   RR   1        R68C103[1][A]   camera/runtime_network.net/action_2_s6/D

Data Required Path:
    AT     DELAY    TYPE   RF   FANOUT        LOC                           NODE
 ======== ======== ====== ==== ======== =============== ============================================
  8.000    8.000                                         active clock edge time
  8.000    0.000                                         eth125
  11.835   3.835    tCL    RR   4971     PLL_B[2]        camera/pll/PLL_inst/CLKOUT1
  15.113   3.278    tNET   RR   1        R68C103[1][A]   camera/runtime_network.net/action_2_s6/CLK
  15.056   -0.057   tSu         1        R68C103[1][A]   camera/runtime_network.net/action_2_s6

Path Statistics:
Clock Skew: -0.041
Setup Relationship: 8.000
Logic Level: 8
Arrival Clock Path delay: (cell: 0.000 0.000%,
                     route: 3.319 100.000%)
Arrival Data Path Delay: (cell: 3.589 45.847%,
                    route: 3.895 49.756%,
                    tC2Q: 0.344 4.398%)
Required Clock Path Delay: (cell: 0.000 0.000%,
                     route: 3.278 100.000%)

						Path13
Path Summary:
Slack             : 0.074
Data Arrival Time : 14.982
Data Required Time: 15.056
From              : camera/runtime_network.net/retry_count_26_s0
To                : camera/runtime_network.net/action_2_s4
Launch Clk        : eth125:[R]
Latch Clk         : eth125:[R]

Data Arrival Path:
    AT     DELAY   TYPE   RF   FANOUT        LOC                              NODE
 ======== ======= ====== ==== ======== =============== ==================================================
  0.000    0.000                                        active clock edge time
  0.000    0.000                                        eth125
  3.835    3.835   tCL    RR   4971     PLL_B[2]        camera/pll/PLL_inst/CLKOUT1
  7.154    3.319   tNET   RR   1        R74C97[0][A]    camera/runtime_network.net/retry_count_26_s0/CLK
  7.499    0.344   tC2Q   RR   3        R74C97[0][A]    camera/runtime_network.net/retry_count_26_s0/Q
  8.256    0.757   tNET   RR   1        R78C102[3][B]   camera/runtime_network.net/n14594_s10/I0
  8.772    0.516   tINS   RR   1        R78C102[3][B]   camera/runtime_network.net/n14594_s10/F
  8.927    0.155   tNET   RR   1        R79C102[1][A]   camera/runtime_network.net/n14594_s8/I2
  9.438    0.511   tINS   RR   3        R79C102[1][A]   camera/runtime_network.net/n14594_s8/F
  9.920    0.481   tNET   RR   1        R80C103[3][A]   camera/runtime_network.net/n14621_s7/I3
  10.412   0.493   tINS   RR   2        R80C103[3][A]   camera/runtime_network.net/n14621_s7/F
  10.570   0.157   tNET   RR   1        R79C103[3][B]   camera/runtime_network.net/n14621_s6/I2
  11.086   0.516   tINS   RR   11       R79C103[3][B]   camera/runtime_network.net/n14621_s6/F
  12.020   0.934   tNET   RR   1        R70C93[2][B]    camera/runtime_network.net/n10253_s5/I3
  12.541   0.521   tINS   RR   4        R70C93[2][B]    camera/runtime_network.net/n10253_s5/F
  12.891   0.350   tNET   RR   1        R71C92[2][B]    camera/runtime_network.net/n10253_s8/I0
  13.412   0.521   tINS   RR   10       R71C92[2][B]    camera/runtime_network.net/n10253_s8/F
  14.471   1.060   tNET   RR   1        R68C103[0][A]   camera/runtime_network.net/n10252_s8/I2
  14.982   0.511   tINS   RR   1        R68C103[0][A]   camera/runtime_network.net/n10252_s8/F
  14.982   0.000   tNET   RR   1        R68C103[0][A]   camera/runtime_network.net/action_2_s4/D

Data Required Path:
    AT     DELAY    TYPE   RF   FANOUT        LOC                           NODE
 ======== ======== ====== ==== ======== =============== ============================================
  8.000    8.000                                         active clock edge time
  8.000    0.000                                         eth125
  11.835   3.835    tCL    RR   4971     PLL_B[2]        camera/pll/PLL_inst/CLKOUT1
  15.113   3.278    tNET   RR   1        R68C103[0][A]   camera/runtime_network.net/action_2_s4/CLK
  15.056   -0.057   tSu         1        R68C103[0][A]   camera/runtime_network.net/action_2_s4

Path Statistics:
Clock Skew: -0.041
Setup Relationship: 8.000
Logic Level: 8
Arrival Clock Path delay: (cell: 0.000 0.000%,
                     route: 3.319 100.000%)
Arrival Data Path Delay: (cell: 3.589 45.847%,
                    route: 3.895 49.756%,
                    tC2Q: 0.344 4.398%)
Required Clock Path Delay: (cell: 0.000 0.000%,
                     route: 3.278 100.000%)

						Path14
Path Summary:
Slack             : 0.074
Data Arrival Time : 14.982
Data Required Time: 15.056
From              : camera/runtime_network.net/retry_count_26_s0
To                : camera/runtime_network.net/action_2_s0
Launch Clk        : eth125:[R]
Latch Clk         : eth125:[R]

Data Arrival Path:
    AT     DELAY   TYPE   RF   FANOUT        LOC                              NODE
 ======== ======= ====== ==== ======== =============== ==================================================
  0.000    0.000                                        active clock edge time
  0.000    0.000                                        eth125
  3.835    3.835   tCL    RR   4971     PLL_B[2]        camera/pll/PLL_inst/CLKOUT1
  7.154    3.319   tNET   RR   1        R74C97[0][A]    camera/runtime_network.net/retry_count_26_s0/CLK
  7.499    0.344   tC2Q   RR   3        R74C97[0][A]    camera/runtime_network.net/retry_count_26_s0/Q
  8.256    0.757   tNET   RR   1        R78C102[3][B]   camera/runtime_network.net/n14594_s10/I0
  8.772    0.516   tINS   RR   1        R78C102[3][B]   camera/runtime_network.net/n14594_s10/F
  8.927    0.155   tNET   RR   1        R79C102[1][A]   camera/runtime_network.net/n14594_s8/I2
  9.438    0.511   tINS   RR   3        R79C102[1][A]   camera/runtime_network.net/n14594_s8/F
  9.920    0.481   tNET   RR   1        R80C103[3][A]   camera/runtime_network.net/n14621_s7/I3
  10.412   0.493   tINS   RR   2        R80C103[3][A]   camera/runtime_network.net/n14621_s7/F
  10.570   0.157   tNET   RR   1        R79C103[3][B]   camera/runtime_network.net/n14621_s6/I2
  11.086   0.516   tINS   RR   11       R79C103[3][B]   camera/runtime_network.net/n14621_s6/F
  12.020   0.934   tNET   RR   1        R70C93[2][B]    camera/runtime_network.net/n10253_s5/I3
  12.541   0.521   tINS   RR   4        R70C93[2][B]    camera/runtime_network.net/n10253_s5/F
  12.891   0.350   tNET   RR   1        R71C92[2][B]    camera/runtime_network.net/n10253_s8/I0
  13.412   0.521   tINS   RR   10       R71C92[2][B]    camera/runtime_network.net/n10253_s8/F
  14.471   1.060   tNET   RR   1        R68C103[0][B]   camera/runtime_network.net/n10252_s1/I2
  14.982   0.511   tINS   RR   1        R68C103[0][B]   camera/runtime_network.net/n10252_s1/F
  14.982   0.000   tNET   RR   1        R68C103[0][B]   camera/runtime_network.net/action_2_s0/D

Data Required Path:
    AT     DELAY    TYPE   RF   FANOUT        LOC                           NODE
 ======== ======== ====== ==== ======== =============== ============================================
  8.000    8.000                                         active clock edge time
  8.000    0.000                                         eth125
  11.835   3.835    tCL    RR   4971     PLL_B[2]        camera/pll/PLL_inst/CLKOUT1
  15.113   3.278    tNET   RR   1        R68C103[0][B]   camera/runtime_network.net/action_2_s0/CLK
  15.056   -0.057   tSu         1        R68C103[0][B]   camera/runtime_network.net/action_2_s0

Path Statistics:
Clock Skew: -0.041
Setup Relationship: 8.000
Logic Level: 8
Arrival Clock Path delay: (cell: 0.000 0.000%,
                     route: 3.319 100.000%)
Arrival Data Path Delay: (cell: 3.589 45.847%,
                    route: 3.895 49.756%,
                    tC2Q: 0.344 4.398%)
Required Clock Path Delay: (cell: 0.000 0.000%,
                     route: 3.278 100.000%)

						Path15
Path Summary:
Slack             : 0.079
Data Arrival Time : 15.060
Data Required Time: 15.139
From              : camera/stream/line_ram_line_ram_0_0_s
To                : camera/runtime_network.net/udp/tx_data_7_s0
Launch Clk        : eth125:[R]
Latch Clk         : eth125:[R]

Data Arrival Path:
    AT     DELAY   TYPE   RF   FANOUT        LOC                            NODE
 ======== ======= ====== ==== ======== =============== ===============================================
  0.000    0.000                                        active clock edge time
  0.000    0.000                                        eth125
  3.835    3.835   tCL    RR   4971     PLL_B[2]        camera/pll/PLL_inst/CLKOUT1
  7.168    3.333   tNET   RR   16       BSRAM_R64[15]   camera/stream/line_ram_line_ram_0_0_s/CLKB
  8.977    1.809   tC2Q   RR   1        BSRAM_R64[15]   camera/stream/line_ram_line_ram_0_0_s/DO[15]
  10.538   1.561   tNET   RR   1        R45C71[2][B]    camera/stream/payload_7_s1/I0
  10.798   0.260   tINS   RR   1        R45C71[2][B]    camera/stream/payload_7_s1/F
  11.953   1.155   tNET   RR   1        R69C78[3][B]    camera/stream/payload_7_s/I2
  12.470   0.516   tINS   RR   2        R69C78[3][B]    camera/stream/payload_7_s/F
  13.069   0.600   tNET   RR   1        R77C81[0][A]    camera/runtime_network.net/udp/n932_s17/I0
  13.580   0.511   tINS   RR   1        R77C81[0][A]    camera/runtime_network.net/udp/n932_s17/F
  13.923   0.343   tNET   RR   1        R75C82[2][B]    camera/runtime_network.net/udp/n932_s10/I2
  14.434   0.511   tINS   RR   1        R75C82[2][B]    camera/runtime_network.net/udp/n932_s10/F
  14.800   0.366   tNET   RR   1        R75C85[2][B]    camera/runtime_network.net/udp/n932_s7/I3
  15.060   0.260   tINS   RR   1        R75C85[2][B]    camera/runtime_network.net/udp/n932_s7/F
  15.060   0.000   tNET   RR   1        R75C85[2][B]    camera/runtime_network.net/udp/tx_data_7_s0/D

Data Required Path:
    AT     DELAY    TYPE   RF   FANOUT       LOC                             NODE
 ======== ======== ====== ==== ======== ============== =================================================
  8.000    8.000                                        active clock edge time
  8.000    0.000                                        eth125
  11.835   3.835    tCL    RR   4971     PLL_B[2]       camera/pll/PLL_inst/CLKOUT1
  15.196   3.361    tNET   RR   1        R75C85[2][B]   camera/runtime_network.net/udp/tx_data_7_s0/CLK
  15.139   -0.057   tSu         1        R75C85[2][B]   camera/runtime_network.net/udp/tx_data_7_s0

Path Statistics:
Clock Skew: 0.028
Setup Relationship: 8.000
Logic Level: 6
Arrival Clock Path delay: (cell: 0.000 0.000%,
                     route: 3.333 100.000%)
Arrival Data Path Delay: (cell: 2.058 26.073%,
                    route: 4.025 51.005%,
                    tC2Q: 1.809 22.922%)
Required Clock Path Delay: (cell: 0.000 0.000%,
                     route: 3.361 100.000%)

						Path16
Path Summary:
Slack             : 0.088
Data Arrival Time : 16.728
Data Required Time: 16.817
From              : camera/tracker/forward_v_9_s1
To                : camera/tracker/lk/n1338_s
Launch Clk        : cam_pclk:[R]
Latch Clk         : cam_pclk:[R]

Data Arrival Path:
    AT     DELAY   TYPE   RF   FANOUT       LOC                      NODE
 ======== ======= ====== ==== ======== ============== ===================================
  0.000    0.000                                       active clock edge time
  0.000    0.000                                       cam_pclk
  0.000    0.000   tCL    RR   1        IOL2[A]        camera_pclk_ibuf/I
  0.614    0.614   tINS   RR   5101     IOL2[A]        camera_pclk_ibuf/O
  5.434    4.820   tNET   RR   1        R45C47[2][B]   camera/tracker/forward_v_9_s1/CLK
  5.779    0.344   tC2Q   RR   10       R45C47[2][B]   camera/tracker/forward_v_9_s1/Q
  6.163    0.385   tNET   RR   1        R44C49[3][B]   camera/tracker/n1674_s3/I3
  6.680    0.516   tINS   RR   1        R44C49[3][B]   camera/tracker/n1674_s3/F
  7.583    0.903   tNET   RR   2        R45C54[1][A]   camera/tracker/reverse_y_2_s/I1
  8.143    0.560   tINS   RR   3        R45C54[1][A]   camera/tracker/reverse_y_2_s/SUM
  8.570    0.426   tNET   RR   1        R47C53[0][B]   camera/tracker/lk/n250_s6/I0
  9.091    0.521   tINS   RR   1        R47C53[0][B]   camera/tracker/lk/n250_s6/F
  9.093    0.002   tNET   RR   1        R47C53[0][A]   camera/tracker/lk/n250_s5/I2
  9.604    0.511   tINS   RR   2        R47C53[0][A]   camera/tracker/lk/n250_s5/F
  9.796    0.192   tNET   RR   1        R47C51[0][B]   camera/tracker/lk/n249_s6/I3
  10.056   0.260   tINS   RR   2        R47C51[0][B]   camera/tracker/lk/n249_s6/F
  10.401   0.345   tNET   RR   1        R47C48[2][B]   camera/tracker/lk/n248_s6/I3
  10.912   0.511   tINS   RR   2        R47C48[2][B]   camera/tracker/lk/n248_s6/F
  11.050   0.138   tNET   RR   1        R47C48[3][B]   camera/tracker/lk/n247_s6/I3
  11.312   0.262   tINS   RR   3        R47C48[3][B]   camera/tracker/lk/n247_s6/F
  11.829   0.516   tNET   RR   1        R47C52[3][B]   camera/tracker/lk/n246_s6/I3
  12.116   0.287   tINS   RF   2        R47C52[3][B]   camera/tracker/lk/n246_s6/F
  12.261   0.145   tNET   FF   1        R47C51[3][B]   camera/tracker/lk/n245_s6/I3
  12.777   0.516   tINS   FR   3        R47C51[3][B]   camera/tracker/lk/n245_s6/F
  13.125   0.348   tNET   RR   1        R49C52[1][A]   camera/tracker/lk/n4697_s38/I2
  13.636   0.511   tINS   RR   2        R49C52[1][A]   camera/tracker/lk/n4697_s38/F
  13.979   0.343   tNET   RR   1        R48C54[3][B]   camera/tracker/lk/n243_s5/I3
  14.471   0.493   tINS   RR   1        R48C54[3][B]   camera/tracker/lk/n243_s5/F
  14.627   0.155   tNET   RR   2        R48C55[2][A]   camera/tracker/lk/n387_s/I0
  15.330   0.703   tINS   RR   1        R48C55[2][A]   camera/tracker/lk/n387_s/SUM
  15.485   0.155   tNET   RR   1        R49C55[3][B]   camera/tracker/lk/n4731_s38/I0
  15.978   0.493   tINS   RR   2        R49C55[3][B]   camera/tracker/lk/n4731_s38/F
  16.728   0.750   tNET   RR   1        DSP_R55[18]    camera/tracker/lk/n1338_s/A[10]

Data Required Path:
    AT     DELAY    TYPE   RF   FANOUT       LOC                     NODE
 ======== ======== ====== ==== ======== ============= ==================================
  11.905   11.905                                      active clock edge time
  11.905   0.000                                       cam_pclk
  11.905   0.000    tCL    RR   1        IOL2[A]       camera_pclk_ibuf/I
  12.519   0.614    tINS   RR   5101     IOL2[A]       camera_pclk_ibuf/O
  17.342   4.823    tNET   RR   1        DSP_R55[18]   camera/tracker/lk/n1338_s/CLK[0]
  16.817   -0.526   tSu         1        DSP_R55[18]   camera/tracker/lk/n1338_s

Path Statistics:
Clock Skew: 0.003
Setup Relationship: 11.905
Logic Level: 14
Arrival Clock Path delay: (cell: 0.614 11.303%,
                     route: 4.820 88.697%)
Arrival Data Path Delay: (cell: 6.144 54.398%,
                    route: 4.806 42.554%,
                    tC2Q: 0.344 3.048%)
Required Clock Path Delay: (cell: 0.614 11.296%,
                     route: 4.823 88.704%)

						Path17
Path Summary:
Slack             : 0.092
Data Arrival Time : 15.040
Data Required Time: 15.132
From              : camera/stream/line_ram_line_ram_0_0_s
To                : camera/runtime_network.net/udp/tx_data_6_s0
Launch Clk        : eth125:[R]
Latch Clk         : eth125:[R]

Data Arrival Path:
    AT     DELAY   TYPE   RF   FANOUT        LOC                            NODE
 ======== ======= ====== ==== ======== =============== ===============================================
  0.000    0.000                                        active clock edge time
  0.000    0.000                                        eth125
  3.835    3.835   tCL    RR   4971     PLL_B[2]        camera/pll/PLL_inst/CLKOUT1
  7.168    3.333   tNET   RR   16       BSRAM_R64[15]   camera/stream/line_ram_line_ram_0_0_s/CLKB
  8.977    1.809   tC2Q   RR   1        BSRAM_R64[15]   camera/stream/line_ram_line_ram_0_0_s/DO[14]
  10.403   1.426   tNET   RR   1        R45C71[2][A]    camera/stream/payload_6_s1/I0
  10.663   0.260   tINS   RR   1        R45C71[2][A]    camera/stream/payload_6_s1/F
  11.818   1.155   tNET   RR   1        R69C76[0][B]    camera/stream/payload_6_s/I1
  12.329   0.511   tINS   RR   2        R69C76[0][B]    camera/stream/payload_6_s/F
  13.238   0.909   tNET   RR   1        R76C81[0][A]    camera/runtime_network.net/udp/n934_s15/I0
  13.498   0.260   tINS   RR   1        R76C81[0][A]    camera/runtime_network.net/udp/n934_s15/F
  13.899   0.400   tNET   RR   1        R74C82[3][A]    camera/runtime_network.net/udp/n934_s11/I1
  14.185   0.287   tINS   RF   1        R74C82[3][A]    camera/runtime_network.net/udp/n934_s11/F
  14.530   0.344   tNET   FF   1        R74C84[0][B]    camera/runtime_network.net/udp/n934_s7/I3
  15.040   0.511   tINS   FR   1        R74C84[0][B]    camera/runtime_network.net/udp/n934_s7/F
  15.040   0.000   tNET   RR   1        R74C84[0][B]    camera/runtime_network.net/udp/tx_data_6_s0/D

Data Required Path:
    AT     DELAY    TYPE   RF   FANOUT       LOC                             NODE
 ======== ======== ====== ==== ======== ============== =================================================
  8.000    8.000                                        active clock edge time
  8.000    0.000                                        eth125
  11.835   3.835    tCL    RR   4971     PLL_B[2]       camera/pll/PLL_inst/CLKOUT1
  15.190   3.355    tNET   RR   1        R74C84[0][B]   camera/runtime_network.net/udp/tx_data_6_s0/CLK
  15.132   -0.057   tSu         1        R74C84[0][B]   camera/runtime_network.net/udp/tx_data_6_s0

Path Statistics:
Clock Skew: 0.022
Setup Relationship: 8.000
Logic Level: 6
Arrival Clock Path delay: (cell: 0.000 0.000%,
                     route: 3.333 100.000%)
Arrival Data Path Delay: (cell: 1.828 23.221%,
                    route: 4.236 53.801%,
                    tC2Q: 1.809 22.978%)
Required Clock Path Delay: (cell: 0.000 0.000%,
                     route: 3.355 100.000%)

						Path18
Path Summary:
Slack             : 0.092
Data Arrival Time : 14.953
Data Required Time: 15.045
From              : camera/runtime_network.net/retry_count_26_s0
To                : camera/runtime_network.net/action_2_s16
Launch Clk        : eth125:[R]
Latch Clk         : eth125:[R]

Data Arrival Path:
    AT     DELAY   TYPE   RF   FANOUT        LOC                              NODE
 ======== ======= ====== ==== ======== =============== ==================================================
  0.000    0.000                                        active clock edge time
  0.000    0.000                                        eth125
  3.835    3.835   tCL    RR   4971     PLL_B[2]        camera/pll/PLL_inst/CLKOUT1
  7.154    3.319   tNET   RR   1        R74C97[0][A]    camera/runtime_network.net/retry_count_26_s0/CLK
  7.499    0.344   tC2Q   RR   3        R74C97[0][A]    camera/runtime_network.net/retry_count_26_s0/Q
  8.256    0.757   tNET   RR   1        R78C102[3][B]   camera/runtime_network.net/n14594_s10/I0
  8.772    0.516   tINS   RR   1        R78C102[3][B]   camera/runtime_network.net/n14594_s10/F
  8.927    0.155   tNET   RR   1        R79C102[1][A]   camera/runtime_network.net/n14594_s8/I2
  9.438    0.511   tINS   RR   3        R79C102[1][A]   camera/runtime_network.net/n14594_s8/F
  9.920    0.481   tNET   RR   1        R80C103[3][A]   camera/runtime_network.net/n14621_s7/I3
  10.412   0.493   tINS   RR   2        R80C103[3][A]   camera/runtime_network.net/n14621_s7/F
  10.570   0.157   tNET   RR   1        R79C103[3][B]   camera/runtime_network.net/n14621_s6/I2
  11.086   0.516   tINS   RR   11       R79C103[3][B]   camera/runtime_network.net/n14621_s6/F
  12.020   0.934   tNET   RR   1        R70C93[2][B]    camera/runtime_network.net/n10253_s5/I3
  12.541   0.521   tINS   RR   4        R70C93[2][B]    camera/runtime_network.net/n10253_s5/F
  12.891   0.350   tNET   RR   1        R71C92[1][A]    camera/runtime_network.net/n10253_s9/I0
  13.402   0.511   tINS   RR   9        R71C92[1][A]    camera/runtime_network.net/n10253_s9/F
  14.442   1.041   tNET   RR   1        R66C99[0][B]    camera/runtime_network.net/n10252_s20/I2
  14.953   0.511   tINS   RR   1        R66C99[0][B]    camera/runtime_network.net/n10252_s20/F
  14.953   0.000   tNET   RR   1        R66C99[0][B]    camera/runtime_network.net/action_2_s16/D

Data Required Path:
    AT     DELAY    TYPE   RF   FANOUT       LOC                           NODE
 ======== ======== ====== ==== ======== ============== =============================================
  8.000    8.000                                        active clock edge time
  8.000    0.000                                        eth125
  11.835   3.835    tCL    RR   4971     PLL_B[2]       camera/pll/PLL_inst/CLKOUT1
  15.102   3.267    tNET   RR   1        R66C99[0][B]   camera/runtime_network.net/action_2_s16/CLK
  15.045   -0.057   tSu         1        R66C99[0][B]   camera/runtime_network.net/action_2_s16

Path Statistics:
Clock Skew: -0.052
Setup Relationship: 8.000
Logic Level: 8
Arrival Clock Path delay: (cell: 0.000 0.000%,
                     route: 3.319 100.000%)
Arrival Data Path Delay: (cell: 3.579 45.889%,
                    route: 3.876 49.697%,
                    tC2Q: 0.344 4.414%)
Required Clock Path Delay: (cell: 0.000 0.000%,
                     route: 3.267 100.000%)

						Path19
Path Summary:
Slack             : 0.092
Data Arrival Time : 14.953
Data Required Time: 15.045
From              : camera/runtime_network.net/retry_count_26_s0
To                : camera/runtime_network.net/action_2_s13
Launch Clk        : eth125:[R]
Latch Clk         : eth125:[R]

Data Arrival Path:
    AT     DELAY   TYPE   RF   FANOUT        LOC                              NODE
 ======== ======= ====== ==== ======== =============== ==================================================
  0.000    0.000                                        active clock edge time
  0.000    0.000                                        eth125
  3.835    3.835   tCL    RR   4971     PLL_B[2]        camera/pll/PLL_inst/CLKOUT1
  7.154    3.319   tNET   RR   1        R74C97[0][A]    camera/runtime_network.net/retry_count_26_s0/CLK
  7.499    0.344   tC2Q   RR   3        R74C97[0][A]    camera/runtime_network.net/retry_count_26_s0/Q
  8.256    0.757   tNET   RR   1        R78C102[3][B]   camera/runtime_network.net/n14594_s10/I0
  8.772    0.516   tINS   RR   1        R78C102[3][B]   camera/runtime_network.net/n14594_s10/F
  8.927    0.155   tNET   RR   1        R79C102[1][A]   camera/runtime_network.net/n14594_s8/I2
  9.438    0.511   tINS   RR   3        R79C102[1][A]   camera/runtime_network.net/n14594_s8/F
  9.920    0.481   tNET   RR   1        R80C103[3][A]   camera/runtime_network.net/n14621_s7/I3
  10.412   0.493   tINS   RR   2        R80C103[3][A]   camera/runtime_network.net/n14621_s7/F
  10.570   0.157   tNET   RR   1        R79C103[3][B]   camera/runtime_network.net/n14621_s6/I2
  11.086   0.516   tINS   RR   11       R79C103[3][B]   camera/runtime_network.net/n14621_s6/F
  12.020   0.934   tNET   RR   1        R70C93[2][B]    camera/runtime_network.net/n10253_s5/I3
  12.541   0.521   tINS   RR   4        R70C93[2][B]    camera/runtime_network.net/n10253_s5/F
  12.891   0.350   tNET   RR   1        R71C92[1][A]    camera/runtime_network.net/n10253_s9/I0
  13.402   0.511   tINS   RR   9        R71C92[1][A]    camera/runtime_network.net/n10253_s9/F
  14.442   1.041   tNET   RR   1        R66C99[0][A]    camera/runtime_network.net/n10252_s17/I2
  14.953   0.511   tINS   RR   1        R66C99[0][A]    camera/runtime_network.net/n10252_s17/F
  14.953   0.000   tNET   RR   1        R66C99[0][A]    camera/runtime_network.net/action_2_s13/D

Data Required Path:
    AT     DELAY    TYPE   RF   FANOUT       LOC                           NODE
 ======== ======== ====== ==== ======== ============== =============================================
  8.000    8.000                                        active clock edge time
  8.000    0.000                                        eth125
  11.835   3.835    tCL    RR   4971     PLL_B[2]       camera/pll/PLL_inst/CLKOUT1
  15.102   3.267    tNET   RR   1        R66C99[0][A]   camera/runtime_network.net/action_2_s13/CLK
  15.045   -0.057   tSu         1        R66C99[0][A]   camera/runtime_network.net/action_2_s13

Path Statistics:
Clock Skew: -0.052
Setup Relationship: 8.000
Logic Level: 8
Arrival Clock Path delay: (cell: 0.000 0.000%,
                     route: 3.319 100.000%)
Arrival Data Path Delay: (cell: 3.579 45.889%,
                    route: 3.876 49.697%,
                    tC2Q: 0.344 4.414%)
Required Clock Path Delay: (cell: 0.000 0.000%,
                     route: 3.267 100.000%)

						Path20
Path Summary:
Slack             : 0.097
Data Arrival Time : 16.648
Data Required Time: 16.745
From              : camera/tracker/forward_u_6_s1
To                : camera/tracker/lk/n1522_s
Launch Clk        : cam_pclk:[R]
Latch Clk         : cam_pclk:[R]

Data Arrival Path:
    AT     DELAY   TYPE   RF   FANOUT       LOC                      NODE
 ======== ======= ====== ==== ======== ============== ===================================
  0.000    0.000                                       active clock edge time
  0.000    0.000                                       cam_pclk
  0.000    0.000   tCL    RR   1        IOL2[A]        camera_pclk_ibuf/I
  0.614    0.614   tINS   RR   5101     IOL2[A]        camera_pclk_ibuf/O
  5.462    4.848   tNET   RR   1        R40C46[1][A]   camera/tracker/forward_u_6_s1/CLK
  5.807    0.344   tC2Q   RR   11       R40C46[1][A]   camera/tracker/forward_u_6_s1/Q
  6.262    0.456   tNET   RR   1        R44C47[2][A]   camera/tracker/n1646_s3/I0
  6.773    0.511   tINS   RR   1        R44C47[2][A]   camera/tracker/n1646_s3/F
  7.116    0.343   tNET   RR   2        R45C47[0][A]   camera/tracker/reverse_x_0_s/I1
  7.607    0.490   tINS   RR   1        R45C47[0][A]   camera/tracker/reverse_x_0_s/COUT
  7.607    0.000   tNET   RR   2        R45C47[0][B]   camera/tracker/reverse_x_1_s/CIN
  7.873    0.267   tINS   RR   3        R45C47[0][B]   camera/tracker/reverse_x_1_s/SUM
  8.337    0.463   tNET   RR   1        R49C47[3][B]   camera/tracker/lk/n218_s6/I1
  8.830    0.493   tINS   RR   1        R49C47[3][B]   camera/tracker/lk/n218_s6/F
  8.832    0.002   tNET   RR   1        R49C47[1][B]   camera/tracker/lk/n218_s5/I2
  9.353    0.521   tINS   RR   2        R49C47[1][B]   camera/tracker/lk/n218_s5/F
  9.886    0.533   tNET   RR   1        R50C51[2][B]   camera/tracker/lk/n217_s6/I3
  10.146   0.260   tINS   RR   2        R50C51[2][B]   camera/tracker/lk/n217_s6/F
  10.284   0.138   tNET   RR   1        R50C51[3][A]   camera/tracker/lk/n216_s6/I3
  10.571   0.287   tINS   RF   2        R50C51[3][A]   camera/tracker/lk/n216_s6/F
  10.716   0.145   tNET   FF   1        R50C51[2][A]   camera/tracker/lk/n215_s6/I3
  10.976   0.260   tINS   FR   3        R50C51[2][A]   camera/tracker/lk/n215_s6/F
  11.136   0.160   tNET   RR   1        R49C51[3][A]   camera/tracker/lk/n214_s6/I3
  11.423   0.287   tINS   RF   2        R49C51[3][A]   camera/tracker/lk/n214_s6/F
  11.432   0.009   tNET   FF   1        R49C51[1][B]   camera/tracker/lk/n213_s6/I3
  11.888   0.457   tINS   FR   3        R49C51[1][B]   camera/tracker/lk/n213_s6/F
  12.215   0.326   tNET   RR   1        R49C49[3][A]   camera/tracker/lk/n4680_s39/I2
  12.502   0.287   tINS   RF   2        R49C49[3][A]   camera/tracker/lk/n4680_s39/F
  12.511   0.009   tNET   FF   1        R49C49[2][A]   camera/tracker/lk/n211_s5/I3
  12.967   0.457   tINS   FR   1        R49C49[2][A]   camera/tracker/lk/n211_s5/F
  14.005   1.037   tNET   RR   2        R60C58[2][A]   camera/tracker/lk/n322_s/I0
  14.545   0.540   tINS   RF   1        R60C58[2][A]   camera/tracker/lk/n322_s/COUT
  14.545   0.000   tNET   FF   2        R60C58[2][B]   camera/tracker/lk/n321_s/CIN
  14.811   0.267   tINS   FR   5        R60C58[2][B]   camera/tracker/lk/n321_s/SUM
  15.568   0.757   tNET   RR   1        R57C55[0][A]   camera/tracker/lk/n4713_s37/I0
  16.025   0.457   tINS   RR   11       R57C55[0][A]   camera/tracker/lk/n4713_s37/F
  16.648   0.623   tNET   RR   1        DSP_R55[17]    camera/tracker/lk/n1522_s/C[47]

Data Required Path:
    AT     DELAY    TYPE   RF   FANOUT       LOC                     NODE
 ======== ======== ====== ==== ======== ============= ==================================
  11.905   11.905                                      active clock edge time
  11.905   0.000                                       cam_pclk
  11.905   0.000    tCL    RR   1        IOL2[A]       camera_pclk_ibuf/I
  12.519   0.614    tINS   RR   5101     IOL2[A]       camera_pclk_ibuf/O
  17.334   4.815    tNET   RR   1        DSP_R55[17]   camera/tracker/lk/n1522_s/CLK[0]
  16.745   -0.589   tSu         1        DSP_R55[17]   camera/tracker/lk/n1522_s

Path Statistics:
Clock Skew: -0.033
Setup Relationship: 11.905
Logic Level: 16
Arrival Clock Path delay: (cell: 0.614 11.245%,
                     route: 4.848 88.755%)
Arrival Data Path Delay: (cell: 5.839 52.198%,
                    route: 5.003 44.725%,
                    tC2Q: 0.344 3.078%)
Required Clock Path Delay: (cell: 0.614 11.314%,
                     route: 4.815 88.686%)

						Path21
Path Summary:
Slack             : 0.101
Data Arrival Time : 14.977
Data Required Time: 15.077
From              : camera/runtime_network.net/retry_count_26_s0
To                : camera/runtime_network.net/retry_count_3_s0
Launch Clk        : eth125:[R]
Latch Clk         : eth125:[R]

Data Arrival Path:
    AT     DELAY   TYPE   RF   FANOUT        LOC                              NODE
 ======== ======= ====== ==== ======== =============== ==================================================
  0.000    0.000                                        active clock edge time
  0.000    0.000                                        eth125
  3.835    3.835   tCL    RR   4971     PLL_B[2]        camera/pll/PLL_inst/CLKOUT1
  7.154    3.319   tNET   RR   1        R74C97[0][A]    camera/runtime_network.net/retry_count_26_s0/CLK
  7.499    0.344   tC2Q   RR   3        R74C97[0][A]    camera/runtime_network.net/retry_count_26_s0/Q
  8.256    0.757   tNET   RR   1        R78C102[3][B]   camera/runtime_network.net/n14594_s10/I0
  8.772    0.516   tINS   RR   1        R78C102[3][B]   camera/runtime_network.net/n14594_s10/F
  8.927    0.155   tNET   RR   1        R79C102[1][A]   camera/runtime_network.net/n14594_s8/I2
  9.438    0.511   tINS   RR   3        R79C102[1][A]   camera/runtime_network.net/n14594_s8/F
  9.920    0.481   tNET   RR   1        R80C103[3][A]   camera/runtime_network.net/n14621_s7/I3
  10.412   0.493   tINS   RR   2        R80C103[3][A]   camera/runtime_network.net/n14621_s7/F
  10.570   0.157   tNET   RR   1        R79C103[3][B]   camera/runtime_network.net/n14621_s6/I2
  11.086   0.516   tINS   RR   11       R79C103[3][B]   camera/runtime_network.net/n14621_s6/F
  12.172   1.086   tNET   RR   1        R81C102[3][B]   camera/runtime_network.net/n14619_s6/I3
  12.688   0.516   tINS   RR   1        R81C102[3][B]   camera/runtime_network.net/n14619_s6/F
  13.629   0.941   tNET   RR   1        R75C96[0][B]    camera/runtime_network.net/n14619_s7/I0
  14.086   0.457   tINS   RR   1        R75C96[0][B]    camera/runtime_network.net/n14619_s7/F
  14.977   0.891   tNET   RR   1        R79C100[0][A]   camera/runtime_network.net/retry_count_3_s0/D

Data Required Path:
    AT     DELAY    TYPE   RF   FANOUT        LOC                             NODE
 ======== ======== ====== ==== ======== =============== =================================================
  8.000    8.000                                         active clock edge time
  8.000    0.000                                         eth125
  11.835   3.835    tCL    RR   4971     PLL_B[2]        camera/pll/PLL_inst/CLKOUT1
  15.135   3.300    tNET   RR   1        R79C100[0][A]   camera/runtime_network.net/retry_count_3_s0/CLK
  15.077   -0.057   tSu         1        R79C100[0][A]   camera/runtime_network.net/retry_count_3_s0

Path Statistics:
Clock Skew: -0.020
Setup Relationship: 8.000
Logic Level: 7
Arrival Clock Path delay: (cell: 0.000 0.000%,
                     route: 3.319 100.000%)
Arrival Data Path Delay: (cell: 3.009 38.473%,
                    route: 4.469 57.126%,
                    tC2Q: 0.344 4.401%)
Required Clock Path Delay: (cell: 0.000 0.000%,
                     route: 3.300 100.000%)

						Path22
Path Summary:
Slack             : 0.101
Data Arrival Time : 15.031
Data Required Time: 15.132
From              : camera/stream/line_ram_line_ram_0_0_s
To                : camera/runtime_network.net/udp/tx_data_2_s0
Launch Clk        : eth125:[R]
Latch Clk         : eth125:[R]

Data Arrival Path:
    AT     DELAY   TYPE   RF   FANOUT        LOC                            NODE
 ======== ======= ====== ==== ======== =============== ===============================================
  0.000    0.000                                        active clock edge time
  0.000    0.000                                        eth125
  3.835    3.835   tCL    RR   4971     PLL_B[2]        camera/pll/PLL_inst/CLKOUT1
  7.168    3.333   tNET   RR   16       BSRAM_R64[15]   camera/stream/line_ram_line_ram_0_0_s/CLKB
  8.977    1.809   tC2Q   RR   1        BSRAM_R64[15]   camera/stream/line_ram_line_ram_0_0_s/DO[2]
  9.980    1.003   tNET   RR   1        R47C72[3][B]    camera/stream/payload_2_s1/I1
  10.497   0.516   tINS   RR   1        R47C72[3][B]    camera/stream/payload_2_s1/F
  11.804   1.307   tNET   RR   1        R70C78[0][B]    camera/stream/payload_2_s/I2
  12.325   0.521   tINS   RR   2        R70C78[0][B]    camera/stream/payload_2_s/F
  12.942   0.618   tNET   RR   1        R77C80[1][A]    camera/runtime_network.net/udp/n942_s13/I0
  13.453   0.511   tINS   RR   1        R77C80[1][A]    camera/runtime_network.net/udp/n942_s13/F
  14.016   0.563   tNET   RR   1        R74C82[3][B]    camera/runtime_network.net/udp/n942_s10/I2
  14.302   0.287   tINS   RF   1        R74C82[3][B]    camera/runtime_network.net/udp/n942_s10/F
  14.511   0.208   tNET   FF   1        R74C84[1][A]    camera/runtime_network.net/udp/n942_s7/I3
  15.031   0.521   tINS   FR   1        R74C84[1][A]    camera/runtime_network.net/udp/n942_s7/F
  15.031   0.000   tNET   RR   1        R74C84[1][A]    camera/runtime_network.net/udp/tx_data_2_s0/D

Data Required Path:
    AT     DELAY    TYPE   RF   FANOUT       LOC                             NODE
 ======== ======== ====== ==== ======== ============== =================================================
  8.000    8.000                                        active clock edge time
  8.000    0.000                                        eth125
  11.835   3.835    tCL    RR   4971     PLL_B[2]       camera/pll/PLL_inst/CLKOUT1
  15.190   3.355    tNET   RR   1        R74C84[1][A]   camera/runtime_network.net/udp/tx_data_2_s0/CLK
  15.132   -0.057   tSu         1        R74C84[1][A]   camera/runtime_network.net/udp/tx_data_2_s0

Path Statistics:
Clock Skew: 0.022
Setup Relationship: 8.000
Logic Level: 6
Arrival Clock Path delay: (cell: 0.000 0.000%,
                     route: 3.333 100.000%)
Arrival Data Path Delay: (cell: 2.356 29.957%,
                    route: 3.699 47.039%,
                    tC2Q: 1.809 23.004%)
Required Clock Path Delay: (cell: 0.000 0.000%,
                     route: 3.355 100.000%)

						Path23
Path Summary:
Slack             : 0.104
Data Arrival Time : 16.948
Data Required Time: 17.052
From              : camera/tracker/sort_j_3_s3
To                : camera/tracker/sort_u_sort_u_RAMREG_15_G[2]_s0
Launch Clk        : cam_pclk:[R]
Latch Clk         : cam_pclk:[R]

Data Arrival Path:
    AT     DELAY   TYPE   RF   FANOUT       LOC                              NODE
 ======== ======= ====== ==== ======== ============== ===================================================
  0.000    0.000                                       active clock edge time
  0.000    0.000                                       cam_pclk
  0.000    0.000   tCL    RR   1        IOL2[A]        camera_pclk_ibuf/I
  0.614    0.614   tINS   RR   5101     IOL2[A]        camera_pclk_ibuf/O
  5.357    4.743   tNET   RR   1        R40C35[3][B]   camera/tracker/sort_j_3_s3/CLK
  5.701    0.344   tC2Q   RR   16       R40C35[3][B]   camera/tracker/sort_j_3_s3/Q
  6.993    1.291   tNET   RR   1        R38C32[2][B]   camera/tracker/n3796_s17/I3
  7.504    0.511   tINS   RR   16       R38C32[2][B]   camera/tracker/n3796_s17/F
  8.318    0.815   tNET   RR   1        R35C30[0][B]   camera/tracker/sort_u_RAMOUT_105_G[0]_s42/I2
  8.829    0.511   tINS   RR   1        R35C30[0][B]   camera/tracker/sort_u_RAMOUT_105_G[0]_s42/F
  8.829    0.000   tNET   RR   1        R35C30[0][A]   camera/tracker/sort_u_RAMOUT_105_G[0]_s20/I1
  8.964    0.135   tINS   RR   1        R35C30[0][A]   camera/tracker/sort_u_RAMOUT_105_G[0]_s20/O
  8.964    0.000   tNET   RR   1        R35C30[0][B]   camera/tracker/sort_u_RAMOUT_105_G[0]_s10/I1
  9.042    0.078   tINS   RR   1        R35C30[0][B]   camera/tracker/sort_u_RAMOUT_105_G[0]_s10/O
  9.042    0.000   tNET   RR   1        R35C30[1][B]   camera/tracker/sort_u_RAMOUT_105_G[0]_s4/I1
  9.119    0.078   tINS   RR   2        R35C30[1][B]   camera/tracker/sort_u_RAMOUT_105_G[0]_s4/O
  10.680   1.560   tNET   RR   2        R31C34[0][B]   camera/tracker/n3816_s39/I1
  11.170   0.490   tINS   RR   1        R31C34[0][B]   camera/tracker/n3816_s39/COUT
  11.170   0.000   tNET   RR   2        R31C34[1][A]   camera/tracker/n3816_s40/CIN
  11.215   0.045   tINS   RR   1        R31C34[1][A]   camera/tracker/n3816_s40/COUT
  11.215   0.000   tNET   RR   2        R31C34[1][B]   camera/tracker/n3816_s41/CIN
  11.260   0.045   tINS   RR   1        R31C34[1][B]   camera/tracker/n3816_s41/COUT
  11.260   0.000   tNET   RR   2        R31C34[2][A]   camera/tracker/n3816_s42/CIN
  11.305   0.045   tINS   RR   1        R31C34[2][A]   camera/tracker/n3816_s42/COUT
  11.305   0.000   tNET   RR   2        R31C34[2][B]   camera/tracker/n3816_s43/CIN
  11.350   0.045   tINS   RR   1        R31C34[2][B]   camera/tracker/n3816_s43/COUT
  11.350   0.000   tNET   RR   2        R31C35[0][A]   camera/tracker/n3816_s44/CIN
  11.395   0.045   tINS   RR   1        R31C35[0][A]   camera/tracker/n3816_s44/COUT
  11.395   0.000   tNET   RR   2        R31C35[0][B]   camera/tracker/n3816_s45/CIN
  11.440   0.045   tINS   RR   1        R31C35[0][B]   camera/tracker/n3816_s45/COUT
  11.440   0.000   tNET   RR   2        R31C35[1][A]   camera/tracker/n3816_s46/CIN
  11.485   0.045   tINS   RR   1        R31C35[1][A]   camera/tracker/n3816_s46/COUT
  11.485   0.000   tNET   RR   2        R31C35[1][B]   camera/tracker/n3816_s47/CIN
  11.530   0.045   tINS   RR   7        R31C35[1][B]   camera/tracker/n3816_s47/COUT
  12.544   1.014   tNET   RR   1        R42C33[1][A]   camera/tracker/sort_u_s1377/I1
  12.804   0.260   tINS   RR   16       R42C33[1][A]   camera/tracker/sort_u_s1377/F
  13.174   0.370   tNET   RR   1        R43C34[0][B]   camera/tracker/sort_u_s1346/I3
  13.685   0.511   tINS   RR   4        R43C34[0][B]   camera/tracker/sort_u_s1346/F
  14.203   0.519   tNET   RR   1        R42C32[0][A]   camera/tracker/sort_u_s1306/I0
  14.660   0.457   tINS   RR   16       R42C32[0][A]   camera/tracker/sort_u_s1306/F
  16.948   2.288   tNET   RR   1        R36C39[2][A]   camera/tracker/sort_u_sort_u_RAMREG_15_G[2]_s0/CE

Data Required Path:
    AT     DELAY    TYPE   RF   FANOUT       LOC                               NODE
 ======== ======== ====== ==== ======== ============== ====================================================
  11.905   11.905                                       active clock edge time
  11.905   0.000                                        cam_pclk
  11.905   0.000    tCL    RR   1        IOL2[A]        camera_pclk_ibuf/I
  12.519   0.614    tINS   RR   5101     IOL2[A]        camera_pclk_ibuf/O
  17.332   4.813    tNET   RR   1        R36C39[2][A]   camera/tracker/sort_u_sort_u_RAMREG_15_G[2]_s0/CLK
  17.052   -0.280   tSu         1        R36C39[2][A]   camera/tracker/sort_u_sort_u_RAMREG_15_G[2]_s0

Path Statistics:
Clock Skew: 0.070
Setup Relationship: 11.905
Logic Level: 9
Arrival Clock Path delay: (cell: 0.614 11.466%,
                     route: 4.743 88.534%)
Arrival Data Path Delay: (cell: 3.390 29.244%,
                    route: 7.857 67.786%,
                    tC2Q: 0.344 2.970%)
Required Clock Path Delay: (cell: 0.614 11.317%,
                     route: 4.813 88.683%)

						Path24
Path Summary:
Slack             : 0.110
Data Arrival Time : 16.962
Data Required Time: 17.072
From              : camera/tracker/x2_4_s0
To                : camera/tracker/y2_1_s0
Launch Clk        : cam_pclk:[R]
Latch Clk         : cam_pclk:[R]

Data Arrival Path:
    AT     DELAY   TYPE   RF   FANOUT       LOC                       NODE
 ======== ======= ====== ==== ======== ============== =====================================
  0.000    0.000                                       active clock edge time
  0.000    0.000                                       cam_pclk
  0.000    0.000   tCL    RR   1        IOL2[A]        camera_pclk_ibuf/I
  0.614    0.614   tINS   RR   5101     IOL2[A]        camera_pclk_ibuf/O
  5.433    4.818   tNET   RR   1        R34C56[0][A]   camera/tracker/x2_4_s0/CLK
  5.763    0.331   tC2Q   RF   10       R34C56[0][A]   camera/tracker/x2_4_s0/Q
  6.709    0.946   tNET   FF   2        R36C54[2][A]   camera/tracker/next_x2_4_s/I0
  7.249    0.540   tINS   FF   1        R36C54[2][A]   camera/tracker/next_x2_4_s/COUT
  7.249    0.000   tNET   FF   2        R36C54[2][B]   camera/tracker/next_x2_5_s/CIN
  7.294    0.045   tINS   FR   1        R36C54[2][B]   camera/tracker/next_x2_5_s/COUT
  7.294    0.000   tNET   RR   2        R36C55[0][A]   camera/tracker/next_x2_6_s/CIN
  7.339    0.045   tINS   RR   1        R36C55[0][A]   camera/tracker/next_x2_6_s/COUT
  7.339    0.000   tNET   RR   2        R36C55[0][B]   camera/tracker/next_x2_7_s/CIN
  7.385    0.045   tINS   RR   1        R36C55[0][B]   camera/tracker/next_x2_7_s/COUT
  7.385    0.000   tNET   RR   2        R36C55[1][A]   camera/tracker/next_x2_8_s/CIN
  7.430    0.045   tINS   RR   1        R36C55[1][A]   camera/tracker/next_x2_8_s/COUT
  7.430    0.000   tNET   RR   2        R36C55[1][B]   camera/tracker/next_x2_9_s/CIN
  7.475    0.045   tINS   RR   1        R36C55[1][B]   camera/tracker/next_x2_9_s/COUT
  7.475    0.000   tNET   RR   2        R36C55[2][A]   camera/tracker/next_x2_10_s/CIN
  7.520    0.045   tINS   RR   1        R36C55[2][A]   camera/tracker/next_x2_10_s/COUT
  7.520    0.000   tNET   RR   2        R36C55[2][B]   camera/tracker/next_x2_11_s/CIN
  7.565    0.045   tINS   RR   1        R36C55[2][B]   camera/tracker/next_x2_11_s/COUT
  7.565    0.000   tNET   RR   2        R36C56[0][A]   camera/tracker/next_x2_12_s/CIN
  7.610    0.045   tINS   RR   1        R36C56[0][A]   camera/tracker/next_x2_12_s/COUT
  7.610    0.000   tNET   RR   2        R36C56[0][B]   camera/tracker/next_x2_13_s/CIN
  7.655    0.045   tINS   RR   1        R36C56[0][B]   camera/tracker/next_x2_13_s/COUT
  7.655    0.000   tNET   RR   2        R36C56[1][A]   camera/tracker/next_x2_14_s/CIN
  7.700    0.045   tINS   RR   1        R36C56[1][A]   camera/tracker/next_x2_14_s/COUT
  7.700    0.000   tNET   RR   2        R36C56[1][B]   camera/tracker/next_x2_15_s/CIN
  7.745    0.045   tINS   RR   1        R36C56[1][B]   camera/tracker/next_x2_15_s/COUT
  7.745    0.000   tNET   RR   2        R36C56[2][A]   camera/tracker/next_x2_16_s/CIN
  7.790    0.045   tINS   RR   1        R36C56[2][A]   camera/tracker/next_x2_16_s/COUT
  7.790    0.000   tNET   RR   2        R36C56[2][B]   camera/tracker/next_x2_17_s/CIN
  8.056    0.267   tINS   RR   1        R36C56[2][B]   camera/tracker/next_x2_17_s/SUM
  8.399    0.343   tNET   RR   1        R36C57[3][A]   camera/tracker/track_ok_s23/I0
  8.810    0.411   tINS   RR   1        R36C57[3][A]   camera/tracker/track_ok_s23/F
  8.965    0.155   tNET   RR   1        R35C57[2][A]   camera/tracker/track_ok_s19/I2
  9.422    0.457   tINS   RR   1        R35C57[2][A]   camera/tracker/track_ok_s19/F
  9.424    0.002   tNET   RR   1        R35C57[2][B]   camera/tracker/track_ok_s12/I3
  9.881    0.457   tINS   RR   1        R35C57[2][B]   camera/tracker/track_ok_s12/F
  10.224   0.343   tNET   RR   1        R36C58[3][A]   camera/tracker/track_ok_s27/I0
  10.717   0.493   tINS   RR   1        R36C58[3][A]   camera/tracker/track_ok_s27/F
  11.328   0.611   tNET   RR   1        R47C58[3][B]   camera/tracker/track_ok_s26/I0
  11.615   0.287   tINS   RF   1        R47C58[3][B]   camera/tracker/track_ok_s26/F
  11.936   0.322   tNET   FF   1        R48C57[0][A]   camera/tracker/track_ok_s7/I3
  12.447   0.511   tINS   FR   7        R48C57[0][A]   camera/tracker/track_ok_s7/F
  13.017   0.570   tNET   RR   1        R42C56[1][A]   camera/tracker/tracked_fid_15_s8/I2
  13.277   0.260   tINS   RR   2        R42C56[1][A]   camera/tracker/tracked_fid_15_s8/F
  13.282   0.005   tNET   RR   1        R42C56[1][B]   camera/tracker/x1_15_s5/I3
  13.542   0.260   tINS   RR   2        R42C56[1][B]   camera/tracker/x1_15_s5/F
  14.393   0.852   tNET   RR   1        R48C59[1][B]   camera/tracker/x1_15_s6/I3
  14.653   0.260   tINS   RR   120      R48C59[1][B]   camera/tracker/x1_15_s6/F
  16.962   2.309   tNET   RR   1        R61C55[1][A]   camera/tracker/y2_1_s0/CE

Data Required Path:
    AT     DELAY    TYPE   RF   FANOUT       LOC                   NODE
 ======== ======== ====== ==== ======== ============== ============================
  11.905   11.905                                       active clock edge time
  11.905   0.000                                        cam_pclk
  11.905   0.000    tCL    RR   1        IOL2[A]        camera_pclk_ibuf/I
  12.519   0.614    tINS   RR   5101     IOL2[A]        camera_pclk_ibuf/O
  17.352   4.833    tNET   RR   1        R61C55[1][A]   camera/tracker/y2_1_s0/CLK
  17.072   -0.280   tSu         1        R61C55[1][A]   camera/tracker/y2_1_s0

Path Statistics:
Clock Skew: 0.015
Setup Relationship: 11.905
Logic Level: 13
Arrival Clock Path delay: (cell: 0.614 11.307%,
                     route: 4.818 88.693%)
Arrival Data Path Delay: (cell: 4.741 41.120%,
                    route: 6.457 56.011%,
                    tC2Q: 0.331 2.869%)
Required Clock Path Delay: (cell: 0.614 11.276%,
                     route: 4.833 88.724%)

						Path25
Path Summary:
Slack             : 0.110
Data Arrival Time : 16.962
Data Required Time: 17.072
From              : camera/tracker/x2_4_s0
To                : camera/tracker/y2_4_s0
Launch Clk        : cam_pclk:[R]
Latch Clk         : cam_pclk:[R]

Data Arrival Path:
    AT     DELAY   TYPE   RF   FANOUT       LOC                       NODE
 ======== ======= ====== ==== ======== ============== =====================================
  0.000    0.000                                       active clock edge time
  0.000    0.000                                       cam_pclk
  0.000    0.000   tCL    RR   1        IOL2[A]        camera_pclk_ibuf/I
  0.614    0.614   tINS   RR   5101     IOL2[A]        camera_pclk_ibuf/O
  5.433    4.818   tNET   RR   1        R34C56[0][A]   camera/tracker/x2_4_s0/CLK
  5.763    0.331   tC2Q   RF   10       R34C56[0][A]   camera/tracker/x2_4_s0/Q
  6.709    0.946   tNET   FF   2        R36C54[2][A]   camera/tracker/next_x2_4_s/I0
  7.249    0.540   tINS   FF   1        R36C54[2][A]   camera/tracker/next_x2_4_s/COUT
  7.249    0.000   tNET   FF   2        R36C54[2][B]   camera/tracker/next_x2_5_s/CIN
  7.294    0.045   tINS   FR   1        R36C54[2][B]   camera/tracker/next_x2_5_s/COUT
  7.294    0.000   tNET   RR   2        R36C55[0][A]   camera/tracker/next_x2_6_s/CIN
  7.339    0.045   tINS   RR   1        R36C55[0][A]   camera/tracker/next_x2_6_s/COUT
  7.339    0.000   tNET   RR   2        R36C55[0][B]   camera/tracker/next_x2_7_s/CIN
  7.385    0.045   tINS   RR   1        R36C55[0][B]   camera/tracker/next_x2_7_s/COUT
  7.385    0.000   tNET   RR   2        R36C55[1][A]   camera/tracker/next_x2_8_s/CIN
  7.430    0.045   tINS   RR   1        R36C55[1][A]   camera/tracker/next_x2_8_s/COUT
  7.430    0.000   tNET   RR   2        R36C55[1][B]   camera/tracker/next_x2_9_s/CIN
  7.475    0.045   tINS   RR   1        R36C55[1][B]   camera/tracker/next_x2_9_s/COUT
  7.475    0.000   tNET   RR   2        R36C55[2][A]   camera/tracker/next_x2_10_s/CIN
  7.520    0.045   tINS   RR   1        R36C55[2][A]   camera/tracker/next_x2_10_s/COUT
  7.520    0.000   tNET   RR   2        R36C55[2][B]   camera/tracker/next_x2_11_s/CIN
  7.565    0.045   tINS   RR   1        R36C55[2][B]   camera/tracker/next_x2_11_s/COUT
  7.565    0.000   tNET   RR   2        R36C56[0][A]   camera/tracker/next_x2_12_s/CIN
  7.610    0.045   tINS   RR   1        R36C56[0][A]   camera/tracker/next_x2_12_s/COUT
  7.610    0.000   tNET   RR   2        R36C56[0][B]   camera/tracker/next_x2_13_s/CIN
  7.655    0.045   tINS   RR   1        R36C56[0][B]   camera/tracker/next_x2_13_s/COUT
  7.655    0.000   tNET   RR   2        R36C56[1][A]   camera/tracker/next_x2_14_s/CIN
  7.700    0.045   tINS   RR   1        R36C56[1][A]   camera/tracker/next_x2_14_s/COUT
  7.700    0.000   tNET   RR   2        R36C56[1][B]   camera/tracker/next_x2_15_s/CIN
  7.745    0.045   tINS   RR   1        R36C56[1][B]   camera/tracker/next_x2_15_s/COUT
  7.745    0.000   tNET   RR   2        R36C56[2][A]   camera/tracker/next_x2_16_s/CIN
  7.790    0.045   tINS   RR   1        R36C56[2][A]   camera/tracker/next_x2_16_s/COUT
  7.790    0.000   tNET   RR   2        R36C56[2][B]   camera/tracker/next_x2_17_s/CIN
  8.056    0.267   tINS   RR   1        R36C56[2][B]   camera/tracker/next_x2_17_s/SUM
  8.399    0.343   tNET   RR   1        R36C57[3][A]   camera/tracker/track_ok_s23/I0
  8.810    0.411   tINS   RR   1        R36C57[3][A]   camera/tracker/track_ok_s23/F
  8.965    0.155   tNET   RR   1        R35C57[2][A]   camera/tracker/track_ok_s19/I2
  9.422    0.457   tINS   RR   1        R35C57[2][A]   camera/tracker/track_ok_s19/F
  9.424    0.002   tNET   RR   1        R35C57[2][B]   camera/tracker/track_ok_s12/I3
  9.881    0.457   tINS   RR   1        R35C57[2][B]   camera/tracker/track_ok_s12/F
  10.224   0.343   tNET   RR   1        R36C58[3][A]   camera/tracker/track_ok_s27/I0
  10.717   0.493   tINS   RR   1        R36C58[3][A]   camera/tracker/track_ok_s27/F
  11.328   0.611   tNET   RR   1        R47C58[3][B]   camera/tracker/track_ok_s26/I0
  11.615   0.287   tINS   RF   1        R47C58[3][B]   camera/tracker/track_ok_s26/F
  11.936   0.322   tNET   FF   1        R48C57[0][A]   camera/tracker/track_ok_s7/I3
  12.447   0.511   tINS   FR   7        R48C57[0][A]   camera/tracker/track_ok_s7/F
  13.017   0.570   tNET   RR   1        R42C56[1][A]   camera/tracker/tracked_fid_15_s8/I2
  13.277   0.260   tINS   RR   2        R42C56[1][A]   camera/tracker/tracked_fid_15_s8/F
  13.282   0.005   tNET   RR   1        R42C56[1][B]   camera/tracker/x1_15_s5/I3
  13.542   0.260   tINS   RR   2        R42C56[1][B]   camera/tracker/x1_15_s5/F
  14.393   0.852   tNET   RR   1        R48C59[1][B]   camera/tracker/x1_15_s6/I3
  14.653   0.260   tINS   RR   120      R48C59[1][B]   camera/tracker/x1_15_s6/F
  16.962   2.309   tNET   RR   1        R61C55[0][A]   camera/tracker/y2_4_s0/CE

Data Required Path:
    AT     DELAY    TYPE   RF   FANOUT       LOC                   NODE
 ======== ======== ====== ==== ======== ============== ============================
  11.905   11.905                                       active clock edge time
  11.905   0.000                                        cam_pclk
  11.905   0.000    tCL    RR   1        IOL2[A]        camera_pclk_ibuf/I
  12.519   0.614    tINS   RR   5101     IOL2[A]        camera_pclk_ibuf/O
  17.352   4.833    tNET   RR   1        R61C55[0][A]   camera/tracker/y2_4_s0/CLK
  17.072   -0.280   tSu         1        R61C55[0][A]   camera/tracker/y2_4_s0

Path Statistics:
Clock Skew: 0.015
Setup Relationship: 11.905
Logic Level: 13
Arrival Clock Path delay: (cell: 0.614 11.307%,
                     route: 4.818 88.693%)
Arrival Data Path Delay: (cell: 4.741 41.120%,
                    route: 6.457 56.011%,
                    tC2Q: 0.331 2.869%)
Required Clock Path Delay: (cell: 0.614 11.276%,
                     route: 4.833 88.724%)

3.3.2 Hold Analysis Report
Report Command:report_timing -hold -max_paths 25 -max_common_paths 1
						Path1
Path Summary:
Slack             : 0.216
Data Arrival Time : 2.781
Data Required Time: 2.565
From              : camera/grid/a_col_6_s0
To                : camera/grid/vertical_y_vertical_y_0_0_s
Launch Clk        : cam_pclk:[R]
Latch Clk         : cam_pclk:[R]

Data Arrival Path:
   AT     DELAY   TYPE   RF   FANOUT        LOC                             NODE
 ======= ======= ====== ==== ======== =============== =================================================
  0.000   0.000                                        active clock edge time
  0.000   0.000                                        cam_pclk
  0.000   0.000   tCL    RR   1        IOL2[A]         camera_pclk_ibuf/I
  0.608   0.608   tINS   RR   5101     IOL2[A]         camera_pclk_ibuf/O
  2.524   1.916   tNET   RR   1        R66C65[0][B]    camera/grid/a_col_6_s0/CLK
  2.654   0.130   tC2Q   RR   2        R66C65[0][B]    camera/grid/a_col_6_s0/Q
  2.781   0.127   tNET   RR   1        BSRAM_R64[13]   camera/grid/vertical_y_vertical_y_0_0_s/ADB[10]

Data Required Path:
   AT     DELAY   TYPE   RF   FANOUT        LOC                            NODE
 ======= ======= ====== ==== ======== =============== ==============================================
  0.000   0.000                                        active clock edge time
  0.000   0.000                                        cam_pclk
  0.000   0.000   tCL    RR   1        IOL2[A]         camera_pclk_ibuf/I
  0.608   0.608   tINS   RR   5101     IOL2[A]         camera_pclk_ibuf/O
  2.533   1.925   tNET   RR   1        BSRAM_R64[13]   camera/grid/vertical_y_vertical_y_0_0_s/CLKB
  2.565   0.032   tHld        1        BSRAM_R64[13]   camera/grid/vertical_y_vertical_y_0_0_s

Path Statistics:
Clock Skew: 0.009
Hold Relationship: 0.000
Logic Level: 1
Arrival Clock Path delay: (cell: 0.608 24.086%,
                     route: 1.916 75.914%)
Arrival Data Path Delay: (cell: 0.000 0.000%,
                    route: 0.127 49.474%,
                    tC2Q: 0.130 50.526%)
Required Clock Path Delay: (cell: 0.608 24.001%,
                     route: 1.925 75.999%)

						Path2
Path Summary:
Slack             : 0.222
Data Arrival Time : 3.398
Data Required Time: 3.176
From              : camera/stream/frame_address_2_s1
To                : camera/stream/ram_ram_0_15_s
Launch Clk        : eth125:[R]
Latch Clk         : eth125:[R]

Data Arrival Path:
   AT     DELAY   TYPE   RF   FANOUT         LOC                          NODE
 ======= ======= ====== ==== ======== ================== ======================================
  0.000   0.000                                           active clock edge time
  0.000   0.000                                           eth125
  1.869   1.869   tCL    RR   4971     PLL_B[2]           camera/pll/PLL_inst/CLKOUT1
  3.136   1.267   tNET   RR   1        R65C79[2][B]       camera/stream/frame_address_2_s1/CLK
  3.266   0.130   tC2Q   RR   27       R65C79[2][B]       camera/stream/frame_address_2_s1/Q
  3.398   0.132   tNET   RR   1        BSRAM_R64[16][A]   camera/stream/ram_ram_0_15_s/ADB[2]

Data Required Path:
   AT     DELAY   TYPE   RF   FANOUT         LOC                        NODE
 ======= ======= ====== ==== ======== ================== ===================================
  0.000   0.000                                           active clock edge time
  0.000   0.000                                           eth125
  1.869   1.869   tCL    RR   4971     PLL_B[2]           camera/pll/PLL_inst/CLKOUT1
  3.144   1.275   tNET   RR   1        BSRAM_R64[16][A]   camera/stream/ram_ram_0_15_s/CLKB
  3.176   0.032   tHld        1        BSRAM_R64[16][A]   camera/stream/ram_ram_0_15_s

Path Statistics:
Clock Skew: 0.008
Hold Relationship: 0.000
Logic Level: 1
Arrival Clock Path delay: (cell: 0.000 0.000%,
                     route: 1.267 100.000%)
Arrival Data Path Delay: (cell: 0.000 0.000%,
                    route: 0.132 50.515%,
                    tC2Q: 0.130 49.485%)
Required Clock Path Delay: (cell: 0.000 0.000%,
                     route: 1.275 100.000%)

						Path3
Path Summary:
Slack             : 0.230
Data Arrival Time : 2.794
Data Required Time: 2.565
From              : camera/grid/a_col_2_s0
To                : camera/grid/vertical_y_vertical_y_0_0_s
Launch Clk        : cam_pclk:[R]
Latch Clk         : cam_pclk:[R]

Data Arrival Path:
   AT     DELAY   TYPE   RF   FANOUT        LOC                             NODE
 ======= ======= ====== ==== ======== =============== ================================================
  0.000   0.000                                        active clock edge time
  0.000   0.000                                        cam_pclk
  0.000   0.000   tCL    RR   1        IOL2[A]         camera_pclk_ibuf/I
  0.608   0.608   tINS   RR   5101     IOL2[A]         camera_pclk_ibuf/O
  2.536   1.928   tNET   RR   1        R70C65[2][B]    camera/grid/a_col_2_s0/CLK
  2.666   0.130   tC2Q   RR   2        R70C65[2][B]    camera/grid/a_col_2_s0/Q
  2.794   0.129   tNET   RR   1        BSRAM_R64[13]   camera/grid/vertical_y_vertical_y_0_0_s/ADB[6]

Data Required Path:
   AT     DELAY   TYPE   RF   FANOUT        LOC                            NODE
 ======= ======= ====== ==== ======== =============== ==============================================
  0.000   0.000                                        active clock edge time
  0.000   0.000                                        cam_pclk
  0.000   0.000   tCL    RR   1        IOL2[A]         camera_pclk_ibuf/I
  0.608   0.608   tINS   RR   5101     IOL2[A]         camera_pclk_ibuf/O
  2.533   1.925   tNET   RR   1        BSRAM_R64[13]   camera/grid/vertical_y_vertical_y_0_0_s/CLKB
  2.565   0.032   tHld        1        BSRAM_R64[13]   camera/grid/vertical_y_vertical_y_0_0_s

Path Statistics:
Clock Skew: -0.003
Hold Relationship: 0.000
Logic Level: 1
Arrival Clock Path delay: (cell: 0.608 23.973%,
                     route: 1.928 76.027%)
Arrival Data Path Delay: (cell: 0.000 0.000%,
                    route: 0.129 49.826%,
                    tC2Q: 0.130 50.174%)
Required Clock Path Delay: (cell: 0.608 24.001%,
                     route: 1.925 75.999%)

						Path4
Path Summary:
Slack             : 0.232
Data Arrival Time : 2.795
Data Required Time: 2.563
From              : camera/pixels/out_pixel_3_s0
To                : camera/stream/ram_ram_2_3_s
Launch Clk        : cam_pclk:[R]
Latch Clk         : cam_pclk:[R]

Data Arrival Path:
   AT     DELAY   TYPE   RF   FANOUT       LOC                      NODE
 ======= ======= ====== ==== ======== ============== ===================================
  0.000   0.000                                       active clock edge time
  0.000   0.000                                       cam_pclk
  0.000   0.000   tCL    RR   1        IOL2[A]        camera_pclk_ibuf/I
  0.608   0.608   tINS   RR   5101     IOL2[A]        camera_pclk_ibuf/O
  2.528   1.920   tNET   RR   1        R86C46[0][A]   camera/pixels/out_pixel_3_s0/CLK
  2.657   0.130   tC2Q   RR   8        R86C46[0][A]   camera/pixels/out_pixel_3_s0/Q
  2.795   0.138   tNET   RR   1        BSRAM_R82[9]   camera/stream/ram_ram_2_3_s/DI[0]

Data Required Path:
   AT     DELAY   TYPE   RF   FANOUT       LOC                      NODE
 ======= ======= ====== ==== ======== ============== ==================================
  0.000   0.000                                       active clock edge time
  0.000   0.000                                       cam_pclk
  0.000   0.000   tCL    RR   1        IOL2[A]        camera_pclk_ibuf/I
  0.608   0.608   tINS   RR   5101     IOL2[A]        camera_pclk_ibuf/O
  2.529   1.921   tNET   RR   1        BSRAM_R82[9]   camera/stream/ram_ram_2_3_s/CLKA
  2.563   0.033   tHld        1        BSRAM_R82[9]   camera/stream/ram_ram_2_3_s

Path Statistics:
Clock Skew: 0.002
Hold Relationship: 0.000
Logic Level: 1
Arrival Clock Path delay: (cell: 0.608 24.052%,
                     route: 1.920 75.948%)
Arrival Data Path Delay: (cell: 0.000 0.000%,
                    route: 0.138 51.515%,
                    tC2Q: 0.130 48.485%)
Required Clock Path Delay: (cell: 0.608 24.035%,
                     route: 1.921 75.965%)

						Path5
Path Summary:
Slack             : 0.239
Data Arrival Time : 3.409
Data Required Time: 3.170
From              : camera/runtime_network.net/write_index_6_s5
To                : camera/runtime_network.net/packet_ram_packet_ram_0_0_s
Launch Clk        : eth125:[R]
Latch Clk         : eth125:[R]

Data Arrival Path:
   AT     DELAY   TYPE   RF   FANOUT         LOC                                      NODE
 ======= ======= ====== ==== ======== ================== ===============================================================
  0.000   0.000                                           active clock edge time
  0.000   0.000                                           eth125
  1.869   1.869   tCL    RR   4971     PLL_B[2]           camera/pll/PLL_inst/CLKOUT1
  3.143   1.275   tNET   RR   1        R70C82[0][B]       camera/runtime_network.net/write_index_6_s5/CLK
  3.273   0.130   tC2Q   RR   4        R70C82[0][B]       camera/runtime_network.net/write_index_6_s5/Q
  3.409   0.136   tNET   RR   1        BSRAM_R82[16][B]   camera/runtime_network.net/packet_ram_packet_ram_0_0_s/ADA[9]

Data Required Path:
   AT     DELAY   TYPE   RF   FANOUT         LOC                                     NODE
 ======= ======= ====== ==== ======== ================== =============================================================
  0.000   0.000                                           active clock edge time
  0.000   0.000                                           eth125
  1.869   1.869   tCL    RR   4971     PLL_B[2]           camera/pll/PLL_inst/CLKOUT1
  3.137   1.268   tNET   RR   1        BSRAM_R82[16][B]   camera/runtime_network.net/packet_ram_packet_ram_0_0_s/CLKA
  3.170   0.033   tHld        1        BSRAM_R82[16][B]   camera/runtime_network.net/packet_ram_packet_ram_0_0_s

Path Statistics:
Clock Skew: -0.007
Hold Relationship: 0.000
Logic Level: 1
Arrival Clock Path delay: (cell: 0.000 0.000%,
                     route: 1.275 100.000%)
Arrival Data Path Delay: (cell: 0.000 0.000%,
                    route: 0.136 51.186%,
                    tC2Q: 0.130 48.814%)
Required Clock Path Delay: (cell: 0.000 0.000%,
                     route: 1.268 100.000%)

						Path6
Path Summary:
Slack             : 0.247
Data Arrival Time : 2.136
Data Required Time: 1.889
From              : sender/uart/count_3_s1
To                : sender/uart/count_3_s1
Launch Clk        : sys50:[R]
Latch Clk         : sys50:[R]

Data Arrival Path:
   AT     DELAY   TYPE   RF   FANOUT        LOC                   NODE
 ======= ======= ====== ==== ======== =============== ============================
  0.000   0.000                                        active clock edge time
  0.000   0.000                                        sys50
  0.000   0.000   tCL    RR   1        IOB116[A]       clk50m_ibuf/I
  0.608   0.608   tINS   RR   5833     IOB116[A]       clk50m_ibuf/O
  1.866   1.258   tNET   RR   1        R48C127[0][A]   sender/uart/count_3_s1/CLK
  1.993   0.127   tC2Q   RF   2        R48C127[0][A]   sender/uart/count_3_s1/Q
  1.998   0.005   tNET   FF   1        R48C127[0][A]   sender/uart/n173_s2/I2
  2.136   0.138   tINS   FF   1        R48C127[0][A]   sender/uart/n173_s2/F
  2.136   0.000   tNET   FF   1        R48C127[0][A]   sender/uart/count_3_s1/D

Data Required Path:
   AT     DELAY   TYPE   RF   FANOUT        LOC                   NODE
 ======= ======= ====== ==== ======== =============== ============================
  0.000   0.000                                        active clock edge time
  0.000   0.000                                        sys50
  0.000   0.000   tCL    RR   1        IOB116[A]       clk50m_ibuf/I
  0.608   0.608   tINS   RR   5833     IOB116[A]       clk50m_ibuf/O
  1.866   1.258   tNET   RR   1        R48C127[0][A]   sender/uart/count_3_s1/CLK
  1.889   0.022   tHld        1        R48C127[0][A]   sender/uart/count_3_s1

Path Statistics:
Clock Skew: 0.000
Hold Relationship: 0.000
Logic Level: 2
Arrival Clock Path delay: (cell: 0.608 32.578%,
                     route: 1.258 67.422%)
Arrival Data Path Delay: (cell: 0.138 51.000%,
                    route: 0.005 2.000%,
                    tC2Q: 0.127 47.000%)
Required Clock Path Delay: (cell: 0.608 32.578%,
                     route: 1.258 67.422%)

						Path7
Path Summary:
Slack             : 0.247
Data Arrival Time : 2.135
Data Required Time: 1.888
From              : imu_status/debug_seq_9_s0
To                : imu_status/debug_seq_9_s0
Launch Clk        : sys50:[R]
Latch Clk         : sys50:[R]

Data Arrival Path:
   AT     DELAY   TYPE   RF   FANOUT        LOC                    NODE
 ======= ======= ====== ==== ======== =============== ===============================
  0.000   0.000                                        active clock edge time
  0.000   0.000                                        sys50
  0.000   0.000   tCL    RR   1        IOB116[A]       clk50m_ibuf/I
  0.608   0.608   tINS   RR   5833     IOB116[A]       clk50m_ibuf/O
  1.865   1.257   tNET   RR   1        R29C147[0][A]   imu_status/debug_seq_9_s0/CLK
  1.992   0.127   tC2Q   RF   5        R29C147[0][A]   imu_status/debug_seq_9_s0/Q
  1.998   0.005   tNET   FF   1        R29C147[0][A]   imu_status/n108_s4/I0
  2.135   0.138   tINS   FF   1        R29C147[0][A]   imu_status/n108_s4/F
  2.135   0.000   tNET   FF   1        R29C147[0][A]   imu_status/debug_seq_9_s0/D

Data Required Path:
   AT     DELAY   TYPE   RF   FANOUT        LOC                    NODE
 ======= ======= ====== ==== ======== =============== ===============================
  0.000   0.000                                        active clock edge time
  0.000   0.000                                        sys50
  0.000   0.000   tCL    RR   1        IOB116[A]       clk50m_ibuf/I
  0.608   0.608   tINS   RR   5833     IOB116[A]       clk50m_ibuf/O
  1.865   1.257   tNET   RR   1        R29C147[0][A]   imu_status/debug_seq_9_s0/CLK
  1.888   0.022   tHld        1        R29C147[0][A]   imu_status/debug_seq_9_s0

Path Statistics:
Clock Skew: 0.000
Hold Relationship: 0.000
Logic Level: 2
Arrival Clock Path delay: (cell: 0.608 32.593%,
                     route: 1.257 67.407%)
Arrival Data Path Delay: (cell: 0.138 51.000%,
                    route: 0.005 2.000%,
                    tC2Q: 0.127 47.000%)
Required Clock Path Delay: (cell: 0.608 32.593%,
                     route: 1.257 67.407%)

						Path8
Path Summary:
Slack             : 0.247
Data Arrival Time : 2.124
Data Required Time: 1.876
From              : imu_status/debug_seq_24_s0
To                : imu_status/debug_seq_24_s0
Launch Clk        : sys50:[R]
Latch Clk         : sys50:[R]

Data Arrival Path:
   AT     DELAY   TYPE   RF   FANOUT        LOC                     NODE
 ======= ======= ====== ==== ======== =============== ================================
  0.000   0.000                                        active clock edge time
  0.000   0.000                                        sys50
  0.000   0.000   tCL    RR   1        IOB116[A]       clk50m_ibuf/I
  0.608   0.608   tINS   RR   5833     IOB116[A]       clk50m_ibuf/O
  1.854   1.246   tNET   RR   1        R30C154[1][A]   imu_status/debug_seq_24_s0/CLK
  1.980   0.127   tC2Q   RF   3        R30C154[1][A]   imu_status/debug_seq_24_s0/Q
  1.986   0.005   tNET   FF   1        R30C154[1][A]   imu_status/n93_s4/I3
  2.124   0.138   tINS   FF   1        R30C154[1][A]   imu_status/n93_s4/F
  2.124   0.000   tNET   FF   1        R30C154[1][A]   imu_status/debug_seq_24_s0/D

Data Required Path:
   AT     DELAY   TYPE   RF   FANOUT        LOC                     NODE
 ======= ======= ====== ==== ======== =============== ================================
  0.000   0.000                                        active clock edge time
  0.000   0.000                                        sys50
  0.000   0.000   tCL    RR   1        IOB116[A]       clk50m_ibuf/I
  0.608   0.608   tINS   RR   5833     IOB116[A]       clk50m_ibuf/O
  1.854   1.246   tNET   RR   1        R30C154[1][A]   imu_status/debug_seq_24_s0/CLK
  1.876   0.022   tHld        1        R30C154[1][A]   imu_status/debug_seq_24_s0

Path Statistics:
Clock Skew: 0.000
Hold Relationship: 0.000
Logic Level: 2
Arrival Clock Path delay: (cell: 0.608 32.799%,
                     route: 1.246 67.201%)
Arrival Data Path Delay: (cell: 0.138 51.000%,
                    route: 0.005 2.000%,
                    tC2Q: 0.127 47.000%)
Required Clock Path Delay: (cell: 0.608 32.799%,
                     route: 1.246 67.201%)

						Path9
Path Summary:
Slack             : 0.247
Data Arrival Time : 2.136
Data Required Time: 1.889
From              : imu/reader/bus/received_4_s0
To                : imu/reader/bus/received_4_s0
Launch Clk        : sys50:[R]
Latch Clk         : sys50:[R]

Data Arrival Path:
   AT     DELAY   TYPE   RF   FANOUT        LOC                      NODE
 ======= ======= ====== ==== ======== =============== ==================================
  0.000   0.000                                        active clock edge time
  0.000   0.000                                        sys50
  0.000   0.000   tCL    RR   1        IOB116[A]       clk50m_ibuf/I
  0.608   0.608   tINS   RR   5833     IOB116[A]       clk50m_ibuf/O
  1.866   1.258   tNET   RR   1        R48C125[0][A]   imu/reader/bus/received_4_s0/CLK
  1.993   0.127   tC2Q   RF   3        R48C125[0][A]   imu/reader/bus/received_4_s0/Q
  1.998   0.005   tNET   FF   1        R48C125[0][A]   imu/reader/bus/n1846_s2/I1
  2.136   0.138   tINS   FF   1        R48C125[0][A]   imu/reader/bus/n1846_s2/F
  2.136   0.000   tNET   FF   1        R48C125[0][A]   imu/reader/bus/received_4_s0/D

Data Required Path:
   AT     DELAY   TYPE   RF   FANOUT        LOC                      NODE
 ======= ======= ====== ==== ======== =============== ==================================
  0.000   0.000                                        active clock edge time
  0.000   0.000                                        sys50
  0.000   0.000   tCL    RR   1        IOB116[A]       clk50m_ibuf/I
  0.608   0.608   tINS   RR   5833     IOB116[A]       clk50m_ibuf/O
  1.866   1.258   tNET   RR   1        R48C125[0][A]   imu/reader/bus/received_4_s0/CLK
  1.889   0.022   tHld        1        R48C125[0][A]   imu/reader/bus/received_4_s0

Path Statistics:
Clock Skew: 0.000
Hold Relationship: 0.000
Logic Level: 2
Arrival Clock Path delay: (cell: 0.608 32.578%,
                     route: 1.258 67.422%)
Arrival Data Path Delay: (cell: 0.138 51.000%,
                    route: 0.005 2.000%,
                    tC2Q: 0.127 47.000%)
Required Clock Path Delay: (cell: 0.608 32.578%,
                     route: 1.258 67.422%)

						Path10
Path Summary:
Slack             : 0.247
Data Arrival Time : 2.136
Data Required Time: 1.889
From              : imu/reader/wait_count_27_s0
To                : imu/reader/wait_count_27_s0
Launch Clk        : sys50:[R]
Latch Clk         : sys50:[R]

Data Arrival Path:
   AT     DELAY   TYPE   RF   FANOUT        LOC                     NODE
 ======= ======= ====== ==== ======== =============== =================================
  0.000   0.000                                        active clock edge time
  0.000   0.000                                        sys50
  0.000   0.000   tCL    RR   1        IOB116[A]       clk50m_ibuf/I
  0.608   0.608   tINS   RR   5833     IOB116[A]       clk50m_ibuf/O
  1.866   1.258   tNET   RR   1        R48C115[0][A]   imu/reader/wait_count_27_s0/CLK
  1.993   0.127   tC2Q   RF   3        R48C115[0][A]   imu/reader/wait_count_27_s0/Q
  1.998   0.005   tNET   FF   1        R48C115[0][A]   imu/reader/n3614_s39/I2
  2.136   0.138   tINS   FF   1        R48C115[0][A]   imu/reader/n3614_s39/F
  2.136   0.000   tNET   FF   1        R48C115[0][A]   imu/reader/wait_count_27_s0/D

Data Required Path:
   AT     DELAY   TYPE   RF   FANOUT        LOC                     NODE
 ======= ======= ====== ==== ======== =============== =================================
  0.000   0.000                                        active clock edge time
  0.000   0.000                                        sys50
  0.000   0.000   tCL    RR   1        IOB116[A]       clk50m_ibuf/I
  0.608   0.608   tINS   RR   5833     IOB116[A]       clk50m_ibuf/O
  1.866   1.258   tNET   RR   1        R48C115[0][A]   imu/reader/wait_count_27_s0/CLK
  1.889   0.022   tHld        1        R48C115[0][A]   imu/reader/wait_count_27_s0

Path Statistics:
Clock Skew: 0.000
Hold Relationship: 0.000
Logic Level: 2
Arrival Clock Path delay: (cell: 0.608 32.578%,
                     route: 1.258 67.422%)
Arrival Data Path Delay: (cell: 0.138 51.000%,
                    route: 0.005 2.000%,
                    tC2Q: 0.127 47.000%)
Required Clock Path Delay: (cell: 0.608 32.578%,
                     route: 1.258 67.422%)

						Path11
Path Summary:
Slack             : 0.247
Data Arrival Time : 3.398
Data Required Time: 3.150
From              : camera/runtime_network.semantics/frame_idle_cycles_0_s3
To                : camera/runtime_network.semantics/frame_idle_cycles_0_s3
Launch Clk        : eth125:[R]
Latch Clk         : eth125:[R]

Data Arrival Path:
   AT     DELAY   TYPE   RF   FANOUT       LOC                                   NODE
 ======= ======= ====== ==== ======== ============== =============================================================
  0.000   0.000                                       active clock edge time
  0.000   0.000                                       eth125
  1.869   1.869   tCL    RR   4971     PLL_B[2]       camera/pll/PLL_inst/CLKOUT1
  3.128   1.259   tNET   RR   1        R31C88[1][A]   camera/runtime_network.semantics/frame_idle_cycles_0_s3/CLK
  3.255   0.127   tC2Q   RF   5        R31C88[1][A]   camera/runtime_network.semantics/frame_idle_cycles_0_s3/Q
  3.260   0.005   tNET   FF   1        R31C88[1][A]   camera/runtime_network.semantics/n1045_s7/I3
  3.398   0.138   tINS   FF   1        R31C88[1][A]   camera/runtime_network.semantics/n1045_s7/F
  3.398   0.000   tNET   FF   1        R31C88[1][A]   camera/runtime_network.semantics/frame_idle_cycles_0_s3/D

Data Required Path:
   AT     DELAY   TYPE   RF   FANOUT       LOC                                   NODE
 ======= ======= ====== ==== ======== ============== =============================================================
  0.000   0.000                                       active clock edge time
  0.000   0.000                                       eth125
  1.869   1.869   tCL    RR   4971     PLL_B[2]       camera/pll/PLL_inst/CLKOUT1
  3.128   1.259   tNET   RR   1        R31C88[1][A]   camera/runtime_network.semantics/frame_idle_cycles_0_s3/CLK
  3.150   0.022   tHld        1        R31C88[1][A]   camera/runtime_network.semantics/frame_idle_cycles_0_s3

Path Statistics:
Clock Skew: 0.000
Hold Relationship: 0.000
Logic Level: 2
Arrival Clock Path delay: (cell: 0.000 0.000%,
                     route: 1.259 100.000%)
Arrival Data Path Delay: (cell: 0.138 51.000%,
                    route: 0.005 2.000%,
                    tC2Q: 0.127 47.000%)
Required Clock Path Delay: (cell: 0.000 0.000%,
                     route: 1.259 100.000%)

						Path12
Path Summary:
Slack             : 0.247
Data Arrival Time : 3.398
Data Required Time: 3.150
From              : camera/runtime_network.semantics/frame_idle_cycles_15_s1
To                : camera/runtime_network.semantics/frame_idle_cycles_15_s1
Launch Clk        : eth125:[R]
Latch Clk         : eth125:[R]

Data Arrival Path:
   AT     DELAY   TYPE   RF   FANOUT       LOC                                    NODE
 ======= ======= ====== ==== ======== ============== ==============================================================
  0.000   0.000                                       active clock edge time
  0.000   0.000                                       eth125
  1.869   1.869   tCL    RR   4971     PLL_B[2]       camera/pll/PLL_inst/CLKOUT1
  3.128   1.259   tNET   RR   1        R31C84[1][A]   camera/runtime_network.semantics/frame_idle_cycles_15_s1/CLK
  3.255   0.127   tC2Q   RF   4        R31C84[1][A]   camera/runtime_network.semantics/frame_idle_cycles_15_s1/Q
  3.260   0.005   tNET   FF   1        R31C84[1][A]   camera/runtime_network.semantics/n1030_s4/I2
  3.398   0.138   tINS   FF   1        R31C84[1][A]   camera/runtime_network.semantics/n1030_s4/F
  3.398   0.000   tNET   FF   1        R31C84[1][A]   camera/runtime_network.semantics/frame_idle_cycles_15_s1/D

Data Required Path:
   AT     DELAY   TYPE   RF   FANOUT       LOC                                    NODE
 ======= ======= ====== ==== ======== ============== ==============================================================
  0.000   0.000                                       active clock edge time
  0.000   0.000                                       eth125
  1.869   1.869   tCL    RR   4971     PLL_B[2]       camera/pll/PLL_inst/CLKOUT1
  3.128   1.259   tNET   RR   1        R31C84[1][A]   camera/runtime_network.semantics/frame_idle_cycles_15_s1/CLK
  3.150   0.022   tHld        1        R31C84[1][A]   camera/runtime_network.semantics/frame_idle_cycles_15_s1

Path Statistics:
Clock Skew: 0.000
Hold Relationship: 0.000
Logic Level: 2
Arrival Clock Path delay: (cell: 0.000 0.000%,
                     route: 1.259 100.000%)
Arrival Data Path Delay: (cell: 0.138 51.000%,
                    route: 0.005 2.000%,
                    tC2Q: 0.127 47.000%)
Required Clock Path Delay: (cell: 0.000 0.000%,
                     route: 1.259 100.000%)

						Path13
Path Summary:
Slack             : 0.247
Data Arrival Time : 3.398
Data Required Time: 3.150
From              : camera/runtime_network.semantics/frame_idle_cycles_24_s1
To                : camera/runtime_network.semantics/frame_idle_cycles_24_s1
Launch Clk        : eth125:[R]
Latch Clk         : eth125:[R]

Data Arrival Path:
   AT     DELAY   TYPE   RF   FANOUT       LOC                                    NODE
 ======= ======= ====== ==== ======== ============== ==============================================================
  0.000   0.000                                       active clock edge time
  0.000   0.000                                       eth125
  1.869   1.869   tCL    RR   4971     PLL_B[2]       camera/pll/PLL_inst/CLKOUT1
  3.128   1.259   tNET   RR   1        R30C87[1][A]   camera/runtime_network.semantics/frame_idle_cycles_24_s1/CLK
  3.255   0.127   tC2Q   RF   3        R30C87[1][A]   camera/runtime_network.semantics/frame_idle_cycles_24_s1/Q
  3.260   0.005   tNET   FF   1        R30C87[1][A]   camera/runtime_network.semantics/n1021_s4/I3
  3.398   0.138   tINS   FF   1        R30C87[1][A]   camera/runtime_network.semantics/n1021_s4/F
  3.398   0.000   tNET   FF   1        R30C87[1][A]   camera/runtime_network.semantics/frame_idle_cycles_24_s1/D

Data Required Path:
   AT     DELAY   TYPE   RF   FANOUT       LOC                                    NODE
 ======= ======= ====== ==== ======== ============== ==============================================================
  0.000   0.000                                       active clock edge time
  0.000   0.000                                       eth125
  1.869   1.869   tCL    RR   4971     PLL_B[2]       camera/pll/PLL_inst/CLKOUT1
  3.128   1.259   tNET   RR   1        R30C87[1][A]   camera/runtime_network.semantics/frame_idle_cycles_24_s1/CLK
  3.150   0.022   tHld        1        R30C87[1][A]   camera/runtime_network.semantics/frame_idle_cycles_24_s1

Path Statistics:
Clock Skew: 0.000
Hold Relationship: 0.000
Logic Level: 2
Arrival Clock Path delay: (cell: 0.000 0.000%,
                     route: 1.259 100.000%)
Arrival Data Path Delay: (cell: 0.138 51.000%,
                    route: 0.005 2.000%,
                    tC2Q: 0.127 47.000%)
Required Clock Path Delay: (cell: 0.000 0.000%,
                     route: 1.259 100.000%)

						Path14
Path Summary:
Slack             : 0.247
Data Arrival Time : 3.398
Data Required Time: 3.150
From              : camera/runtime_network.semantics/frame_idle_cycles_25_s1
To                : camera/runtime_network.semantics/frame_idle_cycles_25_s1
Launch Clk        : eth125:[R]
Latch Clk         : eth125:[R]

Data Arrival Path:
   AT     DELAY   TYPE   RF   FANOUT       LOC                                    NODE
 ======= ======= ====== ==== ======== ============== ==============================================================
  0.000   0.000                                       active clock edge time
  0.000   0.000                                       eth125
  1.869   1.869   tCL    RR   4971     PLL_B[2]       camera/pll/PLL_inst/CLKOUT1
  3.128   1.259   tNET   RR   1        R30C87[0][A]   camera/runtime_network.semantics/frame_idle_cycles_25_s1/CLK
  3.255   0.127   tC2Q   RF   2        R30C87[0][A]   camera/runtime_network.semantics/frame_idle_cycles_25_s1/Q
  3.260   0.005   tNET   FF   1        R30C87[0][A]   camera/runtime_network.semantics/n1020_s2/I3
  3.398   0.138   tINS   FF   1        R30C87[0][A]   camera/runtime_network.semantics/n1020_s2/F
  3.398   0.000   tNET   FF   1        R30C87[0][A]   camera/runtime_network.semantics/frame_idle_cycles_25_s1/D

Data Required Path:
   AT     DELAY   TYPE   RF   FANOUT       LOC                                    NODE
 ======= ======= ====== ==== ======== ============== ==============================================================
  0.000   0.000                                       active clock edge time
  0.000   0.000                                       eth125
  1.869   1.869   tCL    RR   4971     PLL_B[2]       camera/pll/PLL_inst/CLKOUT1
  3.128   1.259   tNET   RR   1        R30C87[0][A]   camera/runtime_network.semantics/frame_idle_cycles_25_s1/CLK
  3.150   0.022   tHld        1        R30C87[0][A]   camera/runtime_network.semantics/frame_idle_cycles_25_s1

Path Statistics:
Clock Skew: 0.000
Hold Relationship: 0.000
Logic Level: 2
Arrival Clock Path delay: (cell: 0.000 0.000%,
                     route: 1.259 100.000%)
Arrival Data Path Delay: (cell: 0.138 51.000%,
                    route: 0.005 2.000%,
                    tC2Q: 0.127 47.000%)
Required Clock Path Delay: (cell: 0.000 0.000%,
                     route: 1.259 100.000%)

						Path15
Path Summary:
Slack             : 0.247
Data Arrival Time : 3.398
Data Required Time: 3.150
From              : camera/runtime_network.semantics/frame_idle_cycles_31_s1
To                : camera/runtime_network.semantics/frame_idle_cycles_31_s1
Launch Clk        : eth125:[R]
Latch Clk         : eth125:[R]

Data Arrival Path:
   AT     DELAY   TYPE   RF   FANOUT       LOC                                    NODE
 ======= ======= ====== ==== ======== ============== ==============================================================
  0.000   0.000                                       active clock edge time
  0.000   0.000                                       eth125
  1.869   1.869   tCL    RR   4971     PLL_B[2]       camera/pll/PLL_inst/CLKOUT1
  3.128   1.259   tNET   RR   1        R30C85[0][A]   camera/runtime_network.semantics/frame_idle_cycles_31_s1/CLK
  3.255   0.127   tC2Q   RF   2        R30C85[0][A]   camera/runtime_network.semantics/frame_idle_cycles_31_s1/Q
  3.260   0.005   tNET   FF   1        R30C85[0][A]   camera/runtime_network.semantics/n1014_s2/I3
  3.398   0.138   tINS   FF   1        R30C85[0][A]   camera/runtime_network.semantics/n1014_s2/F
  3.398   0.000   tNET   FF   1        R30C85[0][A]   camera/runtime_network.semantics/frame_idle_cycles_31_s1/D

Data Required Path:
   AT     DELAY   TYPE   RF   FANOUT       LOC                                    NODE
 ======= ======= ====== ==== ======== ============== ==============================================================
  0.000   0.000                                       active clock edge time
  0.000   0.000                                       eth125
  1.869   1.869   tCL    RR   4971     PLL_B[2]       camera/pll/PLL_inst/CLKOUT1
  3.128   1.259   tNET   RR   1        R30C85[0][A]   camera/runtime_network.semantics/frame_idle_cycles_31_s1/CLK
  3.150   0.022   tHld        1        R30C85[0][A]   camera/runtime_network.semantics/frame_idle_cycles_31_s1

Path Statistics:
Clock Skew: 0.000
Hold Relationship: 0.000
Logic Level: 2
Arrival Clock Path delay: (cell: 0.000 0.000%,
                     route: 1.259 100.000%)
Arrival Data Path Delay: (cell: 0.138 51.000%,
                    route: 0.005 2.000%,
                    tC2Q: 0.127 47.000%)
Required Clock Path Delay: (cell: 0.000 0.000%,
                     route: 1.259 100.000%)

						Path16
Path Summary:
Slack             : 0.247
Data Arrival Time : 3.434
Data Required Time: 3.186
From              : camera/runtime_network.semantics/idle_cycles_12_s1
To                : camera/runtime_network.semantics/idle_cycles_12_s1
Launch Clk        : eth125:[R]
Latch Clk         : eth125:[R]

Data Arrival Path:
   AT     DELAY   TYPE   RF   FANOUT       LOC                                 NODE
 ======= ======= ====== ==== ======== ============== ========================================================
  0.000   0.000                                       active clock edge time
  0.000   0.000                                       eth125
  1.869   1.869   tCL    RR   4971     PLL_B[2]       camera/pll/PLL_inst/CLKOUT1
  3.164   1.295   tNET   RR   1        R41C91[0][A]   camera/runtime_network.semantics/idle_cycles_12_s1/CLK
  3.291   0.127   tC2Q   RF   3        R41C91[0][A]   camera/runtime_network.semantics/idle_cycles_12_s1/Q
  3.296   0.005   tNET   FF   1        R41C91[0][A]   camera/runtime_network.semantics/n1148_s1/I2
  3.434   0.138   tINS   FF   1        R41C91[0][A]   camera/runtime_network.semantics/n1148_s1/F
  3.434   0.000   tNET   FF   1        R41C91[0][A]   camera/runtime_network.semantics/idle_cycles_12_s1/D

Data Required Path:
   AT     DELAY   TYPE   RF   FANOUT       LOC                                 NODE
 ======= ======= ====== ==== ======== ============== ========================================================
  0.000   0.000                                       active clock edge time
  0.000   0.000                                       eth125
  1.869   1.869   tCL    RR   4971     PLL_B[2]       camera/pll/PLL_inst/CLKOUT1
  3.164   1.295   tNET   RR   1        R41C91[0][A]   camera/runtime_network.semantics/idle_cycles_12_s1/CLK
  3.186   0.022   tHld        1        R41C91[0][A]   camera/runtime_network.semantics/idle_cycles_12_s1

Path Statistics:
Clock Skew: 0.000
Hold Relationship: 0.000
Logic Level: 2
Arrival Clock Path delay: (cell: 0.000 0.000%,
                     route: 1.295 100.000%)
Arrival Data Path Delay: (cell: 0.138 51.000%,
                    route: 0.005 2.000%,
                    tC2Q: 0.127 47.000%)
Required Clock Path Delay: (cell: 0.000 0.000%,
                     route: 1.295 100.000%)

						Path17
Path Summary:
Slack             : 0.247
Data Arrival Time : 3.426
Data Required Time: 3.179
From              : camera/runtime_network.semantics/idle_cycles_15_s1
To                : camera/runtime_network.semantics/idle_cycles_15_s1
Launch Clk        : eth125:[R]
Latch Clk         : eth125:[R]

Data Arrival Path:
   AT     DELAY   TYPE   RF   FANOUT       LOC                                 NODE
 ======= ======= ====== ==== ======== ============== ========================================================
  0.000   0.000                                       active clock edge time
  0.000   0.000                                       eth125
  1.869   1.869   tCL    RR   4971     PLL_B[2]       camera/pll/PLL_inst/CLKOUT1
  3.156   1.287   tNET   RR   1        R41C93[0][A]   camera/runtime_network.semantics/idle_cycles_15_s1/CLK
  3.283   0.127   tC2Q   RF   4        R41C93[0][A]   camera/runtime_network.semantics/idle_cycles_15_s1/Q
  3.289   0.005   tNET   FF   1        R41C93[0][A]   camera/runtime_network.semantics/n1145_s1/I1
  3.426   0.138   tINS   FF   1        R41C93[0][A]   camera/runtime_network.semantics/n1145_s1/F
  3.426   0.000   tNET   FF   1        R41C93[0][A]   camera/runtime_network.semantics/idle_cycles_15_s1/D

Data Required Path:
   AT     DELAY   TYPE   RF   FANOUT       LOC                                 NODE
 ======= ======= ====== ==== ======== ============== ========================================================
  0.000   0.000                                       active clock edge time
  0.000   0.000                                       eth125
  1.869   1.869   tCL    RR   4971     PLL_B[2]       camera/pll/PLL_inst/CLKOUT1
  3.156   1.287   tNET   RR   1        R41C93[0][A]   camera/runtime_network.semantics/idle_cycles_15_s1/CLK
  3.179   0.022   tHld        1        R41C93[0][A]   camera/runtime_network.semantics/idle_cycles_15_s1

Path Statistics:
Clock Skew: 0.000
Hold Relationship: 0.000
Logic Level: 2
Arrival Clock Path delay: (cell: 0.000 0.000%,
                     route: 1.287 100.000%)
Arrival Data Path Delay: (cell: 0.138 51.000%,
                    route: 0.005 2.000%,
                    tC2Q: 0.127 47.000%)
Required Clock Path Delay: (cell: 0.000 0.000%,
                     route: 1.287 100.000%)

						Path18
Path Summary:
Slack             : 0.247
Data Arrival Time : 3.424
Data Required Time: 3.177
From              : camera/runtime_network.semantics/idle_cycles_19_s1
To                : camera/runtime_network.semantics/idle_cycles_19_s1
Launch Clk        : eth125:[R]
Latch Clk         : eth125:[R]

Data Arrival Path:
   AT     DELAY   TYPE   RF   FANOUT       LOC                                 NODE
 ======= ======= ====== ==== ======== ============== ========================================================
  0.000   0.000                                       active clock edge time
  0.000   0.000                                       eth125
  1.869   1.869   tCL    RR   4971     PLL_B[2]       camera/pll/PLL_inst/CLKOUT1
  3.154   1.285   tNET   RR   1        R40C92[1][A]   camera/runtime_network.semantics/idle_cycles_19_s1/CLK
  3.281   0.127   tC2Q   RF   4        R40C92[1][A]   camera/runtime_network.semantics/idle_cycles_19_s1/Q
  3.287   0.005   tNET   FF   1        R40C92[1][A]   camera/runtime_network.semantics/n1141_s1/I3
  3.424   0.138   tINS   FF   1        R40C92[1][A]   camera/runtime_network.semantics/n1141_s1/F
  3.424   0.000   tNET   FF   1        R40C92[1][A]   camera/runtime_network.semantics/idle_cycles_19_s1/D

Data Required Path:
   AT     DELAY   TYPE   RF   FANOUT       LOC                                 NODE
 ======= ======= ====== ==== ======== ============== ========================================================
  0.000   0.000                                       active clock edge time
  0.000   0.000                                       eth125
  1.869   1.869   tCL    RR   4971     PLL_B[2]       camera/pll/PLL_inst/CLKOUT1
  3.154   1.285   tNET   RR   1        R40C92[1][A]   camera/runtime_network.semantics/idle_cycles_19_s1/CLK
  3.177   0.022   tHld        1        R40C92[1][A]   camera/runtime_network.semantics/idle_cycles_19_s1

Path Statistics:
Clock Skew: 0.000
Hold Relationship: 0.000
Logic Level: 2
Arrival Clock Path delay: (cell: 0.000 0.000%,
                     route: 1.285 100.000%)
Arrival Data Path Delay: (cell: 0.138 51.000%,
                    route: 0.005 2.000%,
                    tC2Q: 0.127 47.000%)
Required Clock Path Delay: (cell: 0.000 0.000%,
                     route: 1.285 100.000%)

						Path19
Path Summary:
Slack             : 0.247
Data Arrival Time : 3.427
Data Required Time: 3.180
From              : camera/runtime_network.semantics/idle_cycles_31_s1
To                : camera/runtime_network.semantics/idle_cycles_31_s1
Launch Clk        : eth125:[R]
Latch Clk         : eth125:[R]

Data Arrival Path:
   AT     DELAY   TYPE   RF   FANOUT       LOC                                 NODE
 ======= ======= ====== ==== ======== ============== ========================================================
  0.000   0.000                                       active clock edge time
  0.000   0.000                                       eth125
  1.869   1.869   tCL    RR   4971     PLL_B[2]       camera/pll/PLL_inst/CLKOUT1
  3.157   1.289   tNET   RR   1        R38C92[0][A]   camera/runtime_network.semantics/idle_cycles_31_s1/CLK
  3.284   0.127   tC2Q   RF   2        R38C92[0][A]   camera/runtime_network.semantics/idle_cycles_31_s1/Q
  3.290   0.005   tNET   FF   1        R38C92[0][A]   camera/runtime_network.semantics/n1129_s1/I3
  3.427   0.138   tINS   FF   1        R38C92[0][A]   camera/runtime_network.semantics/n1129_s1/F
  3.427   0.000   tNET   FF   1        R38C92[0][A]   camera/runtime_network.semantics/idle_cycles_31_s1/D

Data Required Path:
   AT     DELAY   TYPE   RF   FANOUT       LOC                                 NODE
 ======= ======= ====== ==== ======== ============== ========================================================
  0.000   0.000                                       active clock edge time
  0.000   0.000                                       eth125
  1.869   1.869   tCL    RR   4971     PLL_B[2]       camera/pll/PLL_inst/CLKOUT1
  3.157   1.289   tNET   RR   1        R38C92[0][A]   camera/runtime_network.semantics/idle_cycles_31_s1/CLK
  3.180   0.022   tHld        1        R38C92[0][A]   camera/runtime_network.semantics/idle_cycles_31_s1

Path Statistics:
Clock Skew: 0.000
Hold Relationship: 0.000
Logic Level: 2
Arrival Clock Path delay: (cell: 0.000 0.000%,
                     route: 1.289 100.000%)
Arrival Data Path Delay: (cell: 0.138 51.000%,
                    route: 0.005 2.000%,
                    tC2Q: 0.127 47.000%)
Required Clock Path Delay: (cell: 0.000 0.000%,
                     route: 1.289 100.000%)

						Path20
Path Summary:
Slack             : 0.247
Data Arrival Time : 3.428
Data Required Time: 3.180
From              : camera/runtime_network.net/udp/cnt_data_3_s0
To                : camera/runtime_network.net/udp/cnt_data_3_s0
Launch Clk        : eth125:[R]
Latch Clk         : eth125:[R]

Data Arrival Path:
   AT     DELAY   TYPE   RF   FANOUT       LOC                              NODE
 ======= ======= ====== ==== ======== ============== ==================================================
  0.000   0.000                                       active clock edge time
  0.000   0.000                                       eth125
  1.869   1.869   tCL    RR   4971     PLL_B[2]       camera/pll/PLL_inst/CLKOUT1
  3.158   1.289   tNET   RR   1        R79C82[0][A]   camera/runtime_network.net/udp/cnt_data_3_s0/CLK
  3.285   0.127   tC2Q   RF   2        R79C82[0][A]   camera/runtime_network.net/udp/cnt_data_3_s0/Q
  3.290   0.005   tNET   FF   1        R79C82[0][A]   camera/runtime_network.net/udp/n826_s1/I1
  3.428   0.138   tINS   FF   1        R79C82[0][A]   camera/runtime_network.net/udp/n826_s1/F
  3.428   0.000   tNET   FF   1        R79C82[0][A]   camera/runtime_network.net/udp/cnt_data_3_s0/D

Data Required Path:
   AT     DELAY   TYPE   RF   FANOUT       LOC                              NODE
 ======= ======= ====== ==== ======== ============== ==================================================
  0.000   0.000                                       active clock edge time
  0.000   0.000                                       eth125
  1.869   1.869   tCL    RR   4971     PLL_B[2]       camera/pll/PLL_inst/CLKOUT1
  3.158   1.289   tNET   RR   1        R79C82[0][A]   camera/runtime_network.net/udp/cnt_data_3_s0/CLK
  3.180   0.022   tHld        1        R79C82[0][A]   camera/runtime_network.net/udp/cnt_data_3_s0

Path Statistics:
Clock Skew: 0.000
Hold Relationship: 0.000
Logic Level: 2
Arrival Clock Path delay: (cell: 0.000 0.000%,
                     route: 1.289 100.000%)
Arrival Data Path Delay: (cell: 0.138 51.000%,
                    route: 0.005 2.000%,
                    tC2Q: 0.127 47.000%)
Required Clock Path Delay: (cell: 0.000 0.000%,
                     route: 1.289 100.000%)

						Path21
Path Summary:
Slack             : 0.247
Data Arrival Time : 3.424
Data Required Time: 3.177
From              : camera/runtime_network.net/udp/cnt_data_14_s0
To                : camera/runtime_network.net/udp/cnt_data_14_s0
Launch Clk        : eth125:[R]
Latch Clk         : eth125:[R]

Data Arrival Path:
   AT     DELAY   TYPE   RF   FANOUT       LOC                              NODE
 ======= ======= ====== ==== ======== ============== ===================================================
  0.000   0.000                                       active clock edge time
  0.000   0.000                                       eth125
  1.869   1.869   tCL    RR   4971     PLL_B[2]       camera/pll/PLL_inst/CLKOUT1
  3.154   1.285   tNET   RR   1        R79C83[0][A]   camera/runtime_network.net/udp/cnt_data_14_s0/CLK
  3.281   0.127   tC2Q   RF   4        R79C83[0][A]   camera/runtime_network.net/udp/cnt_data_14_s0/Q
  3.286   0.005   tNET   FF   1        R79C83[0][A]   camera/runtime_network.net/udp/n815_s1/I2
  3.424   0.138   tINS   FF   1        R79C83[0][A]   camera/runtime_network.net/udp/n815_s1/F
  3.424   0.000   tNET   FF   1        R79C83[0][A]   camera/runtime_network.net/udp/cnt_data_14_s0/D

Data Required Path:
   AT     DELAY   TYPE   RF   FANOUT       LOC                              NODE
 ======= ======= ====== ==== ======== ============== ===================================================
  0.000   0.000                                       active clock edge time
  0.000   0.000                                       eth125
  1.869   1.869   tCL    RR   4971     PLL_B[2]       camera/pll/PLL_inst/CLKOUT1
  3.154   1.285   tNET   RR   1        R79C83[0][A]   camera/runtime_network.net/udp/cnt_data_14_s0/CLK
  3.177   0.022   tHld        1        R79C83[0][A]   camera/runtime_network.net/udp/cnt_data_14_s0

Path Statistics:
Clock Skew: 0.000
Hold Relationship: 0.000
Logic Level: 2
Arrival Clock Path delay: (cell: 0.000 0.000%,
                     route: 1.285 100.000%)
Arrival Data Path Delay: (cell: 0.138 51.000%,
                    route: 0.005 2.000%,
                    tC2Q: 0.127 47.000%)
Required Clock Path Delay: (cell: 0.000 0.000%,
                     route: 1.285 100.000%)

						Path22
Path Summary:
Slack             : 0.247
Data Arrival Time : 3.412
Data Required Time: 3.165
From              : camera/runtime_network.net/udp/cnt_preamble_0_s0
To                : camera/runtime_network.net/udp/cnt_preamble_0_s0
Launch Clk        : eth125:[R]
Latch Clk         : eth125:[R]

Data Arrival Path:
   AT     DELAY   TYPE   RF   FANOUT       LOC                                NODE
 ======= ======= ====== ==== ======== ============== ======================================================
  0.000   0.000                                       active clock edge time
  0.000   0.000                                       eth125
  1.869   1.869   tCL    RR   4971     PLL_B[2]       camera/pll/PLL_inst/CLKOUT1
  3.142   1.273   tNET   RR   1        R72C85[0][A]   camera/runtime_network.net/udp/cnt_preamble_0_s0/CLK
  3.269   0.127   tC2Q   RF   4        R72C85[0][A]   camera/runtime_network.net/udp/cnt_preamble_0_s0/Q
  3.274   0.005   tNET   FF   1        R72C85[0][A]   camera/runtime_network.net/udp/n742_s2/I0
  3.412   0.138   tINS   FF   1        R72C85[0][A]   camera/runtime_network.net/udp/n742_s2/F
  3.412   0.000   tNET   FF   1        R72C85[0][A]   camera/runtime_network.net/udp/cnt_preamble_0_s0/D

Data Required Path:
   AT     DELAY   TYPE   RF   FANOUT       LOC                                NODE
 ======= ======= ====== ==== ======== ============== ======================================================
  0.000   0.000                                       active clock edge time
  0.000   0.000                                       eth125
  1.869   1.869   tCL    RR   4971     PLL_B[2]       camera/pll/PLL_inst/CLKOUT1
  3.142   1.273   tNET   RR   1        R72C85[0][A]   camera/runtime_network.net/udp/cnt_preamble_0_s0/CLK
  3.165   0.022   tHld        1        R72C85[0][A]   camera/runtime_network.net/udp/cnt_preamble_0_s0

Path Statistics:
Clock Skew: 0.000
Hold Relationship: 0.000
Logic Level: 2
Arrival Clock Path delay: (cell: 0.000 0.000%,
                     route: 1.273 100.000%)
Arrival Data Path Delay: (cell: 0.138 51.000%,
                    route: 0.005 2.000%,
                    tC2Q: 0.127 47.000%)
Required Clock Path Delay: (cell: 0.000 0.000%,
                     route: 1.273 100.000%)

						Path23
Path Summary:
Slack             : 0.247
Data Arrival Time : 3.412
Data Required Time: 3.165
From              : camera/runtime_network.net/udp/cnt_preamble_1_s0
To                : camera/runtime_network.net/udp/cnt_preamble_1_s0
Launch Clk        : eth125:[R]
Latch Clk         : eth125:[R]

Data Arrival Path:
   AT     DELAY   TYPE   RF   FANOUT       LOC                                NODE
 ======= ======= ====== ==== ======== ============== ======================================================
  0.000   0.000                                       active clock edge time
  0.000   0.000                                       eth125
  1.869   1.869   tCL    RR   4971     PLL_B[2]       camera/pll/PLL_inst/CLKOUT1
  3.142   1.273   tNET   RR   1        R72C85[1][A]   camera/runtime_network.net/udp/cnt_preamble_1_s0/CLK
  3.269   0.127   tC2Q   RF   3        R72C85[1][A]   camera/runtime_network.net/udp/cnt_preamble_1_s0/Q
  3.274   0.005   tNET   FF   1        R72C85[1][A]   camera/runtime_network.net/udp/n741_s1/I1
  3.412   0.138   tINS   FF   1        R72C85[1][A]   camera/runtime_network.net/udp/n741_s1/F
  3.412   0.000   tNET   FF   1        R72C85[1][A]   camera/runtime_network.net/udp/cnt_preamble_1_s0/D

Data Required Path:
   AT     DELAY   TYPE   RF   FANOUT       LOC                                NODE
 ======= ======= ====== ==== ======== ============== ======================================================
  0.000   0.000                                       active clock edge time
  0.000   0.000                                       eth125
  1.869   1.869   tCL    RR   4971     PLL_B[2]       camera/pll/PLL_inst/CLKOUT1
  3.142   1.273   tNET   RR   1        R72C85[1][A]   camera/runtime_network.net/udp/cnt_preamble_1_s0/CLK
  3.165   0.022   tHld        1        R72C85[1][A]   camera/runtime_network.net/udp/cnt_preamble_1_s0

Path Statistics:
Clock Skew: 0.000
Hold Relationship: 0.000
Logic Level: 2
Arrival Clock Path delay: (cell: 0.000 0.000%,
                     route: 1.273 100.000%)
Arrival Data Path Delay: (cell: 0.138 51.000%,
                    route: 0.005 2.000%,
                    tC2Q: 0.127 47.000%)
Required Clock Path Delay: (cell: 0.000 0.000%,
                     route: 1.273 100.000%)

						Path24
Path Summary:
Slack             : 0.247
Data Arrival Time : 2.165
Data Required Time: 1.917
From              : camera/runtime_network.net/preamble_1_s1
To                : camera/runtime_network.net/preamble_1_s1
Launch Clk        : eth_rx125:[R]
Latch Clk         : eth_rx125:[R]

Data Arrival Path:
   AT     DELAY   TYPE   RF   FANOUT        LOC                            NODE
 ======= ======= ====== ==== ======== =============== ==============================================
  0.000   0.000                                        active clock edge time
  0.000   0.000                                        eth_rx125
  0.000   0.000   tCL    RR   1        IOB122[A]       rgmii_rxc_ibuf/I
  0.608   0.608   tINS   RR   850      IOB122[A]       rgmii_rxc_ibuf/O
  1.895   1.287   tNET   RR   1        R48C112[1][A]   camera/runtime_network.net/preamble_1_s1/CLK
  2.022   0.127   tC2Q   RF   3        R48C112[1][A]   camera/runtime_network.net/preamble_1_s1/Q
  2.027   0.005   tNET   FF   1        R48C112[1][A]   camera/runtime_network.net/n1530_s2/I3
  2.165   0.138   tINS   FF   1        R48C112[1][A]   camera/runtime_network.net/n1530_s2/F
  2.165   0.000   tNET   FF   1        R48C112[1][A]   camera/runtime_network.net/preamble_1_s1/D

Data Required Path:
   AT     DELAY   TYPE   RF   FANOUT        LOC                            NODE
 ======= ======= ====== ==== ======== =============== ==============================================
  0.000   0.000                                        active clock edge time
  0.000   0.000                                        eth_rx125
  0.000   0.000   tCL    RR   1        IOB122[A]       rgmii_rxc_ibuf/I
  0.608   0.608   tINS   RR   850      IOB122[A]       rgmii_rxc_ibuf/O
  1.895   1.287   tNET   RR   1        R48C112[1][A]   camera/runtime_network.net/preamble_1_s1/CLK
  1.917   0.022   tHld        1        R48C112[1][A]   camera/runtime_network.net/preamble_1_s1

Path Statistics:
Clock Skew: 0.000
Hold Relationship: 0.000
Logic Level: 2
Arrival Clock Path delay: (cell: 0.608 32.083%,
                     route: 1.287 67.917%)
Arrival Data Path Delay: (cell: 0.138 51.000%,
                    route: 0.005 2.000%,
                    tC2Q: 0.127 47.000%)
Required Clock Path Delay: (cell: 0.608 32.083%,
                     route: 1.287 67.917%)

						Path25
Path Summary:
Slack             : 0.247
Data Arrival Time : 3.409
Data Required Time: 3.161
From              : camera/runtime_network.net/arp_index_2_s1
To                : camera/runtime_network.net/arp_index_2_s1
Launch Clk        : eth125:[R]
Latch Clk         : eth125:[R]

Data Arrival Path:
   AT     DELAY   TYPE   RF   FANOUT       LOC                            NODE
 ======= ======= ====== ==== ======== ============== ===============================================
  0.000   0.000                                       active clock edge time
  0.000   0.000                                       eth125
  1.869   1.869   tCL    RR   4971     PLL_B[2]       camera/pll/PLL_inst/CLKOUT1
  3.139   1.270   tNET   RR   1        R51C85[1][A]   camera/runtime_network.net/arp_index_2_s1/CLK
  3.266   0.127   tC2Q   RF   4        R51C85[1][A]   camera/runtime_network.net/arp_index_2_s1/Q
  3.271   0.005   tNET   FF   1        R51C85[1][A]   camera/runtime_network.net/n12226_s11/I3
  3.409   0.138   tINS   FF   1        R51C85[1][A]   camera/runtime_network.net/n12226_s11/F
  3.409   0.000   tNET   FF   1        R51C85[1][A]   camera/runtime_network.net/arp_index_2_s1/D

Data Required Path:
   AT     DELAY   TYPE   RF   FANOUT       LOC                            NODE
 ======= ======= ====== ==== ======== ============== ===============================================
  0.000   0.000                                       active clock edge time
  0.000   0.000                                       eth125
  1.869   1.869   tCL    RR   4971     PLL_B[2]       camera/pll/PLL_inst/CLKOUT1
  3.139   1.270   tNET   RR   1        R51C85[1][A]   camera/runtime_network.net/arp_index_2_s1/CLK
  3.161   0.022   tHld        1        R51C85[1][A]   camera/runtime_network.net/arp_index_2_s1

Path Statistics:
Clock Skew: 0.000
Hold Relationship: 0.000
Logic Level: 2
Arrival Clock Path delay: (cell: 0.000 0.000%,
                     route: 1.270 100.000%)
Arrival Data Path Delay: (cell: 0.138 51.000%,
                    route: 0.005 2.000%,
                    tC2Q: 0.127 47.000%)
Required Clock Path Delay: (cell: 0.000 0.000%,
                     route: 1.270 100.000%)

3.3.3 Recovery Analysis Report
Report Command:report_timing -recovery -max_paths 25 -max_common_paths 1
						Path1
Path Summary:
Slack             : 2.022
Data Arrival Time : 14.815
Data Required Time: 16.838
From              : camera/cap_reset/release_pipe_2_s0
To                : camera/tracker/lk/n2885_s
Launch Clk        : cam_pclk:[R]
Latch Clk         : cam_pclk:[R]

Data Arrival Path:
    AT     DELAY   TYPE   RF   FANOUT       LOC                         NODE
 ======== ======= ====== ==== ======== ============== ========================================
  0.000    0.000                                       active clock edge time
  0.000    0.000                                       cam_pclk
  0.000    0.000   tCL    RR   1        IOL2[A]        camera_pclk_ibuf/I
  0.614    0.614   tINS   RR   5101     IOL2[A]        camera_pclk_ibuf/O
  5.417    4.803   tNET   RR   1        R68C55[0][B]   camera/cap_reset/release_pipe_2_s0/CLK
  5.761    0.344   tC2Q   RR   3876     R68C55[0][B]   camera/cap_reset/release_pipe_2_s0/Q
  10.360   4.599   tNET   RR   1        R65C73[0][A]   camera/capture/n17_s2/I0
  10.736   0.376   tINS   RF   22       R65C73[0][A]   camera/capture/n17_s2/F
  14.815   4.079   tNET   FF   1        DSP_R73[16]    camera/tracker/lk/n2885_s/RESET[0]

Data Required Path:
    AT     DELAY    TYPE   RF   FANOUT       LOC                     NODE
 ======== ======== ====== ==== ======== ============= ==================================
  11.905   11.905                                      active clock edge time
  11.905   0.000                                       cam_pclk
  11.905   0.000    tCL    RR   1        IOL2[A]       camera_pclk_ibuf/I
  12.519   0.614    tINS   RR   5101     IOL2[A]       camera_pclk_ibuf/O
  17.342   4.823    tNET   RR   1        DSP_R73[16]   camera/tracker/lk/n2885_s/CLK[0]
  16.838   -0.505   tSu         1        DSP_R73[16]   camera/tracker/lk/n2885_s

Path Statistics:
Clock Skew: 0.021
Setup Relationship: 11.905
Logic Level: 2
Arrival Clock Path delay: (cell: 0.614 11.339%,
                     route: 4.803 88.661%)
Arrival Data Path Delay: (cell: 0.376 3.998%,
                    route: 8.678 92.339%,
                    tC2Q: 0.344 3.663%)
Required Clock Path Delay: (cell: 0.614 11.296%,
                     route: 4.823 88.704%)

						Path2
Path Summary:
Slack             : 2.272
Data Arrival Time : 14.574
Data Required Time: 16.846
From              : camera/cap_reset/release_pipe_2_s0
To                : camera/tracker/lk/n2787_s
Launch Clk        : cam_pclk:[R]
Latch Clk         : cam_pclk:[R]

Data Arrival Path:
    AT     DELAY   TYPE   RF   FANOUT       LOC                         NODE
 ======== ======= ====== ==== ======== ============== ========================================
  0.000    0.000                                       active clock edge time
  0.000    0.000                                       cam_pclk
  0.000    0.000   tCL    RR   1        IOL2[A]        camera_pclk_ibuf/I
  0.614    0.614   tINS   RR   5101     IOL2[A]        camera_pclk_ibuf/O
  5.417    4.803   tNET   RR   1        R68C55[0][B]   camera/cap_reset/release_pipe_2_s0/CLK
  5.761    0.344   tC2Q   RR   3876     R68C55[0][B]   camera/cap_reset/release_pipe_2_s0/Q
  10.360   4.599   tNET   RR   1        R65C73[0][A]   camera/capture/n17_s2/I0
  10.736   0.376   tINS   RF   22       R65C73[0][A]   camera/capture/n17_s2/F
  14.574   3.837   tNET   FF   1        DSP_R73[14]    camera/tracker/lk/n2787_s/RESET[0]

Data Required Path:
    AT     DELAY    TYPE   RF   FANOUT       LOC                     NODE
 ======== ======== ====== ==== ======== ============= ==================================
  11.905   11.905                                      active clock edge time
  11.905   0.000                                       cam_pclk
  11.905   0.000    tCL    RR   1        IOL2[A]       camera_pclk_ibuf/I
  12.519   0.614    tINS   RR   5101     IOL2[A]       camera_pclk_ibuf/O
  17.351   4.832    tNET   RR   1        DSP_R73[14]   camera/tracker/lk/n2787_s/CLK[0]
  16.846   -0.505   tSu         1        DSP_R73[14]   camera/tracker/lk/n2787_s

Path Statistics:
Clock Skew: 0.029
Setup Relationship: 11.905
Logic Level: 2
Arrival Clock Path delay: (cell: 0.614 11.339%,
                     route: 4.803 88.661%)
Arrival Data Path Delay: (cell: 0.376 4.104%,
                    route: 8.436 92.137%,
                    tC2Q: 0.344 3.760%)
Required Clock Path Delay: (cell: 0.614 11.279%,
                     route: 4.832 88.721%)

						Path3
Path Summary:
Slack             : 2.454
Data Arrival Time : 14.383
Data Required Time: 16.838
From              : camera/cap_reset/release_pipe_2_s0
To                : camera/tracker/lk/n2835_s
Launch Clk        : cam_pclk:[R]
Latch Clk         : cam_pclk:[R]

Data Arrival Path:
    AT     DELAY   TYPE   RF   FANOUT       LOC                         NODE
 ======== ======= ====== ==== ======== ============== ========================================
  0.000    0.000                                       active clock edge time
  0.000    0.000                                       cam_pclk
  0.000    0.000   tCL    RR   1        IOL2[A]        camera_pclk_ibuf/I
  0.614    0.614   tINS   RR   5101     IOL2[A]        camera_pclk_ibuf/O
  5.417    4.803   tNET   RR   1        R68C55[0][B]   camera/cap_reset/release_pipe_2_s0/CLK
  5.761    0.344   tC2Q   RR   3876     R68C55[0][B]   camera/cap_reset/release_pipe_2_s0/Q
  10.360   4.599   tNET   RR   1        R65C73[0][A]   camera/capture/n17_s2/I0
  10.736   0.376   tINS   RF   22       R65C73[0][A]   camera/capture/n17_s2/F
  14.383   3.647   tNET   FF   1        DSP_R73[12]    camera/tracker/lk/n2835_s/RESET[0]

Data Required Path:
    AT     DELAY    TYPE   RF   FANOUT       LOC                     NODE
 ======== ======== ====== ==== ======== ============= ==================================
  11.905   11.905                                      active clock edge time
  11.905   0.000                                       cam_pclk
  11.905   0.000    tCL    RR   1        IOL2[A]       camera_pclk_ibuf/I
  12.519   0.614    tINS   RR   5101     IOL2[A]       camera_pclk_ibuf/O
  17.342   4.823    tNET   RR   1        DSP_R73[12]   camera/tracker/lk/n2835_s/CLK[0]
  16.838   -0.505   tSu         1        DSP_R73[12]   camera/tracker/lk/n2835_s

Path Statistics:
Clock Skew: 0.021
Setup Relationship: 11.905
Logic Level: 2
Arrival Clock Path delay: (cell: 0.614 11.339%,
                     route: 4.803 88.661%)
Arrival Data Path Delay: (cell: 0.376 4.191%,
                    route: 8.246 91.970%,
                    tC2Q: 0.344 3.839%)
Required Clock Path Delay: (cell: 0.614 11.296%,
                     route: 4.823 88.704%)

						Path4
Path Summary:
Slack             : 2.571
Data Arrival Time : 14.179
Data Required Time: 16.749
From              : camera/cap_reset/release_pipe_2_s0
To                : camera/tracker/lk/n2739_s
Launch Clk        : cam_pclk:[R]
Latch Clk         : cam_pclk:[R]

Data Arrival Path:
    AT     DELAY   TYPE   RF   FANOUT       LOC                         NODE
 ======== ======= ====== ==== ======== ============== ========================================
  0.000    0.000                                       active clock edge time
  0.000    0.000                                       cam_pclk
  0.000    0.000   tCL    RR   1        IOL2[A]        camera_pclk_ibuf/I
  0.614    0.614   tINS   RR   5101     IOL2[A]        camera_pclk_ibuf/O
  5.417    4.803   tNET   RR   1        R68C55[0][B]   camera/cap_reset/release_pipe_2_s0/CLK
  5.761    0.344   tC2Q   RR   3876     R68C55[0][B]   camera/cap_reset/release_pipe_2_s0/Q
  10.360   4.599   tNET   RR   1        R65C73[0][A]   camera/capture/n17_s2/I0
  10.736   0.376   tINS   RF   22       R65C73[0][A]   camera/capture/n17_s2/F
  14.179   3.442   tNET   FF   1        DSP_R73[10]    camera/tracker/lk/n2739_s/RESET[0]

Data Required Path:
    AT     DELAY    TYPE   RF   FANOUT       LOC                     NODE
 ======== ======== ====== ==== ======== ============= ==================================
  11.905   11.905                                      active clock edge time
  11.905   0.000                                       cam_pclk
  11.905   0.000    tCL    RR   1        IOL2[A]       camera_pclk_ibuf/I
  12.519   0.614    tINS   RR   5101     IOL2[A]       camera_pclk_ibuf/O
  17.254   4.735    tNET   RR   1        DSP_R73[10]   camera/tracker/lk/n2739_s/CLK[0]
  16.749   -0.505   tSu         1        DSP_R73[10]   camera/tracker/lk/n2739_s

Path Statistics:
Clock Skew: -0.068
Setup Relationship: 11.905
Logic Level: 2
Arrival Clock Path delay: (cell: 0.614 11.339%,
                     route: 4.803 88.661%)
Arrival Data Path Delay: (cell: 0.376 4.289%,
                    route: 8.042 91.782%,
                    tC2Q: 0.344 3.929%)
Required Clock Path Delay: (cell: 0.614 11.483%,
                     route: 4.735 88.517%)

						Path5
Path Summary:
Slack             : 2.623
Data Arrival Time : 14.118
Data Required Time: 16.741
From              : camera/cap_reset/release_pipe_2_s0
To                : camera/tracker/lk/n2691_s
Launch Clk        : cam_pclk:[R]
Latch Clk         : cam_pclk:[R]

Data Arrival Path:
    AT     DELAY   TYPE   RF   FANOUT       LOC                         NODE
 ======== ======= ====== ==== ======== ============== ========================================
  0.000    0.000                                       active clock edge time
  0.000    0.000                                       cam_pclk
  0.000    0.000   tCL    RR   1        IOL2[A]        camera_pclk_ibuf/I
  0.614    0.614   tINS   RR   5101     IOL2[A]        camera_pclk_ibuf/O
  5.417    4.803   tNET   RR   1        R68C55[0][B]   camera/cap_reset/release_pipe_2_s0/CLK
  5.761    0.344   tC2Q   RR   3876     R68C55[0][B]   camera/cap_reset/release_pipe_2_s0/Q
  10.360   4.599   tNET   RR   1        R65C73[0][A]   camera/capture/n17_s2/I0
  10.736   0.376   tINS   RF   22       R65C73[0][A]   camera/capture/n17_s2/F
  14.118   3.382   tNET   FF   1        DSP_R73[8]     camera/tracker/lk/n2691_s/RESET[0]

Data Required Path:
    AT     DELAY    TYPE   RF   FANOUT      LOC                     NODE
 ======== ======== ====== ==== ======== ============ ==================================
  11.905   11.905                                     active clock edge time
  11.905   0.000                                      cam_pclk
  11.905   0.000    tCL    RR   1        IOL2[A]      camera_pclk_ibuf/I
  12.519   0.614    tINS   RR   5101     IOL2[A]      camera_pclk_ibuf/O
  17.246   4.727    tNET   RR   1        DSP_R73[8]   camera/tracker/lk/n2691_s/CLK[0]
  16.741   -0.505   tSu         1        DSP_R73[8]   camera/tracker/lk/n2691_s

Path Statistics:
Clock Skew: -0.076
Setup Relationship: 11.905
Logic Level: 2
Arrival Clock Path delay: (cell: 0.614 11.339%,
                     route: 4.803 88.661%)
Arrival Data Path Delay: (cell: 0.376 4.319%,
                    route: 7.981 91.725%,
                    tC2Q: 0.344 3.957%)
Required Clock Path Delay: (cell: 0.614 11.501%,
                     route: 4.727 88.499%)

						Path6
Path Summary:
Slack             : 4.184
Data Arrival Time : 12.662
Data Required Time: 16.846
From              : camera/cap_reset/release_pipe_2_s0
To                : camera/tracker/n4966_s
Launch Clk        : cam_pclk:[R]
Latch Clk         : cam_pclk:[R]

Data Arrival Path:
    AT     DELAY   TYPE   RF   FANOUT       LOC                         NODE
 ======== ======= ====== ==== ======== ============== ========================================
  0.000    0.000                                       active clock edge time
  0.000    0.000                                       cam_pclk
  0.000    0.000   tCL    RR   1        IOL2[A]        camera_pclk_ibuf/I
  0.614    0.614   tINS   RR   5101     IOL2[A]        camera_pclk_ibuf/O
  5.417    4.803   tNET   RR   1        R68C55[0][B]   camera/cap_reset/release_pipe_2_s0/CLK
  5.761    0.344   tC2Q   RR   3876     R68C55[0][B]   camera/cap_reset/release_pipe_2_s0/Q
  10.360   4.599   tNET   RR   1        R65C73[0][A]   camera/capture/n17_s2/I0
  10.736   0.376   tINS   RF   22       R65C73[0][A]   camera/capture/n17_s2/F
  12.662   1.926   tNET   FF   1        DSP_R55[15]    camera/tracker/n4966_s/RESET[0]

Data Required Path:
    AT     DELAY    TYPE   RF   FANOUT       LOC                   NODE
 ======== ======== ====== ==== ======== ============= ===============================
  11.905   11.905                                      active clock edge time
  11.905   0.000                                       cam_pclk
  11.905   0.000    tCL    RR   1        IOL2[A]       camera_pclk_ibuf/I
  12.519   0.614    tINS   RR   5101     IOL2[A]       camera_pclk_ibuf/O
  17.351   4.832    tNET   RR   1        DSP_R55[15]   camera/tracker/n4966_s/CLK[0]
  16.846   -0.505   tSu         1        DSP_R55[15]   camera/tracker/n4966_s

Path Statistics:
Clock Skew: 0.029
Setup Relationship: 11.905
Logic Level: 2
Arrival Clock Path delay: (cell: 0.614 11.339%,
                     route: 4.803 88.661%)
Arrival Data Path Delay: (cell: 0.376 5.186%,
                    route: 6.525 90.062%,
                    tC2Q: 0.344 4.752%)
Required Clock Path Delay: (cell: 0.614 11.279%,
                     route: 4.832 88.721%)

						Path7
Path Summary:
Slack             : 4.252
Data Arrival Time : 12.594
Data Required Time: 16.846
From              : camera/cap_reset/release_pipe_2_s0
To                : camera/grid/n310_s
Launch Clk        : cam_pclk:[R]
Latch Clk         : cam_pclk:[R]

Data Arrival Path:
    AT     DELAY   TYPE   RF   FANOUT       LOC                         NODE
 ======== ======= ====== ==== ======== ============== ========================================
  0.000    0.000                                       active clock edge time
  0.000    0.000                                       cam_pclk
  0.000    0.000   tCL    RR   1        IOL2[A]        camera_pclk_ibuf/I
  0.614    0.614   tINS   RR   5101     IOL2[A]        camera_pclk_ibuf/O
  5.417    4.803   tNET   RR   1        R68C55[0][B]   camera/cap_reset/release_pipe_2_s0/CLK
  5.761    0.344   tC2Q   RR   3876     R68C55[0][B]   camera/cap_reset/release_pipe_2_s0/Q
  10.360   4.599   tNET   RR   1        R65C73[0][A]   camera/capture/n17_s2/I0
  10.736   0.376   tINS   RF   22       R65C73[0][A]   camera/capture/n17_s2/F
  12.594   1.857   tNET   FF   1        DSP_R55[23]    camera/grid/n310_s/RESET[0]

Data Required Path:
    AT     DELAY    TYPE   RF   FANOUT       LOC                 NODE
 ======== ======== ====== ==== ======== ============= ===========================
  11.905   11.905                                      active clock edge time
  11.905   0.000                                       cam_pclk
  11.905   0.000    tCL    RR   1        IOL2[A]       camera_pclk_ibuf/I
  12.519   0.614    tINS   RR   5101     IOL2[A]       camera_pclk_ibuf/O
  17.351   4.832    tNET   RR   1        DSP_R55[23]   camera/grid/n310_s/CLK[0]
  16.846   -0.505   tSu         1        DSP_R55[23]   camera/grid/n310_s

Path Statistics:
Clock Skew: 0.029
Setup Relationship: 11.905
Logic Level: 2
Arrival Clock Path delay: (cell: 0.614 11.339%,
                     route: 4.803 88.661%)
Arrival Data Path Delay: (cell: 0.376 5.236%,
                    route: 6.456 89.967%,
                    tC2Q: 0.344 4.797%)
Required Clock Path Delay: (cell: 0.614 11.279%,
                     route: 4.832 88.721%)

						Path8
Path Summary:
Slack             : 4.346
Data Arrival Time : 12.546
Data Required Time: 16.892
From              : camera/cap_reset/release_pipe_2_s0
To                : camera/tracker/n4674_s0
Launch Clk        : cam_pclk:[R]
Latch Clk         : cam_pclk:[R]

Data Arrival Path:
    AT     DELAY   TYPE   RF   FANOUT        LOC                          NODE
 ======== ======= ====== ==== ======== ================ ========================================
  0.000    0.000                                         active clock edge time
  0.000    0.000                                         cam_pclk
  0.000    0.000   tCL    RR   1        IOL2[A]          camera_pclk_ibuf/I
  0.614    0.614   tINS   RR   5101     IOL2[A]          camera_pclk_ibuf/O
  5.417    4.803   tNET   RR   1        R68C55[0][B]     camera/cap_reset/release_pipe_2_s0/CLK
  5.761    0.344   tC2Q   RR   3876     R68C55[0][B]     camera/cap_reset/release_pipe_2_s0/Q
  10.360   4.599   tNET   RR   1        R65C73[0][A]     camera/capture/n17_s2/I0
  10.736   0.376   tINS   RF   22       R65C73[0][A]     camera/capture/n17_s2/F
  12.546   1.810   tNET   FF   1        DSP_R55[14][B]   camera/tracker/n4674_s0/RESET[0]

Data Required Path:
    AT     DELAY    TYPE   RF   FANOUT        LOC                      NODE
 ======== ======== ====== ==== ======== ================ ================================
  11.905   11.905                                         active clock edge time
  11.905   0.000                                          cam_pclk
  11.905   0.000    tCL    RR   1        IOL2[A]          camera_pclk_ibuf/I
  12.519   0.614    tINS   RR   5101     IOL2[A]          camera_pclk_ibuf/O
  17.342   4.823    tNET   RR   1        DSP_R55[14][B]   camera/tracker/n4674_s0/CLK[0]
  16.892   -0.450   tSu         1        DSP_R55[14][B]   camera/tracker/n4674_s0

Path Statistics:
Clock Skew: 0.021
Setup Relationship: 11.905
Logic Level: 2
Arrival Clock Path delay: (cell: 0.614 11.339%,
                     route: 4.803 88.661%)
Arrival Data Path Delay: (cell: 0.376 5.271%,
                    route: 6.409 89.901%,
                    tC2Q: 0.344 4.829%)
Required Clock Path Delay: (cell: 0.614 11.296%,
                     route: 4.823 88.704%)

						Path9
Path Summary:
Slack             : 4.398
Data Arrival Time : 12.432
Data Required Time: 16.829
From              : camera/cap_reset/release_pipe_2_s0
To                : camera/tracker/lk/n1522_s
Launch Clk        : cam_pclk:[R]
Latch Clk         : cam_pclk:[R]

Data Arrival Path:
    AT     DELAY   TYPE   RF   FANOUT       LOC                         NODE
 ======== ======= ====== ==== ======== ============== ========================================
  0.000    0.000                                       active clock edge time
  0.000    0.000                                       cam_pclk
  0.000    0.000   tCL    RR   1        IOL2[A]        camera_pclk_ibuf/I
  0.614    0.614   tINS   RR   5101     IOL2[A]        camera_pclk_ibuf/O
  5.417    4.803   tNET   RR   1        R68C55[0][B]   camera/cap_reset/release_pipe_2_s0/CLK
  5.761    0.344   tC2Q   RR   3876     R68C55[0][B]   camera/cap_reset/release_pipe_2_s0/Q
  10.360   4.599   tNET   RR   1        R65C73[0][A]   camera/capture/n17_s2/I0
  10.736   0.376   tINS   RF   22       R65C73[0][A]   camera/capture/n17_s2/F
  12.432   1.695   tNET   FF   1        DSP_R55[17]    camera/tracker/lk/n1522_s/RESET[0]

Data Required Path:
    AT     DELAY    TYPE   RF   FANOUT       LOC                     NODE
 ======== ======== ====== ==== ======== ============= ==================================
  11.905   11.905                                      active clock edge time
  11.905   0.000                                       cam_pclk
  11.905   0.000    tCL    RR   1        IOL2[A]       camera_pclk_ibuf/I
  12.519   0.614    tINS   RR   5101     IOL2[A]       camera_pclk_ibuf/O
  17.334   4.815    tNET   RR   1        DSP_R55[17]   camera/tracker/lk/n1522_s/CLK[0]
  16.829   -0.505   tSu         1        DSP_R55[17]   camera/tracker/lk/n1522_s

Path Statistics:
Clock Skew: 0.012
Setup Relationship: 11.905
Logic Level: 2
Arrival Clock Path delay: (cell: 0.614 11.339%,
                     route: 4.803 88.661%)
Arrival Data Path Delay: (cell: 0.376 5.357%,
                    route: 6.294 89.735%,
                    tC2Q: 0.344 4.908%)
Required Clock Path Delay: (cell: 0.614 11.314%,
                     route: 4.815 88.686%)

						Path10
Path Summary:
Slack             : 4.400
Data Arrival Time : 10.453
Data Required Time: 14.853
From              : camera/perception_reset/release_pipe_2_s0
To                : camera/stream/gap_0_s3
Launch Clk        : eth125:[R]
Latch Clk         : eth125:[R]

Data Arrival Path:
    AT     DELAY   TYPE   RF   FANOUT       LOC                            NODE
 ======== ======= ====== ==== ======== ============== ===============================================
  0.000    0.000                                       active clock edge time
  0.000    0.000                                       eth125
  3.835    3.835   tCL    RR   4971     PLL_B[2]       camera/pll/PLL_inst/CLKOUT1
  7.149    3.313   tNET   RR   1        R50C76[1][A]   camera/perception_reset/release_pipe_2_s0/CLK
  7.479    0.331   tC2Q   RF   1093     R50C76[1][A]   camera/perception_reset/release_pipe_2_s0/Q
  10.453   2.973   tNET   FF   1        R68C78[3][A]   camera/stream/gap_0_s3/CLEAR

Data Required Path:
    AT     DELAY    TYPE   RF   FANOUT       LOC                   NODE
 ======== ======== ====== ==== ======== ============== =============================
  8.000    8.000                                        active clock edge time
  8.000    0.000                                        eth125
  11.835   3.835    tCL    RR   4971     PLL_B[2]       camera/pll/PLL_inst/CLKOUT1
  15.165   3.330    tNET   RR   1        R68C78[3][A]   camera/stream/gap_0_s3/CLK
  14.853   -0.313   tSu         1        R68C78[3][A]   camera/stream/gap_0_s3

Path Statistics:
Clock Skew: 0.017
Setup Relationship: 8.000
Logic Level: 1
Arrival Clock Path delay: (cell: 0.000 0.000%,
                     route: 3.313 100.000%)
Arrival Data Path Delay: (cell: 0.000 0.000%,
                    route: 2.973 89.990%,
                    tC2Q: 0.331 10.010%)
Required Clock Path Delay: (cell: 0.000 0.000%,
                     route: 3.330 100.000%)

						Path11
Path Summary:
Slack             : 4.400
Data Arrival Time : 10.453
Data Required Time: 14.853
From              : camera/perception_reset/release_pipe_2_s0
To                : camera/stream/gap_1_s0
Launch Clk        : eth125:[R]
Latch Clk         : eth125:[R]

Data Arrival Path:
    AT     DELAY   TYPE   RF   FANOUT       LOC                            NODE
 ======== ======= ====== ==== ======== ============== ===============================================
  0.000    0.000                                       active clock edge time
  0.000    0.000                                       eth125
  3.835    3.835   tCL    RR   4971     PLL_B[2]       camera/pll/PLL_inst/CLKOUT1
  7.149    3.313   tNET   RR   1        R50C76[1][A]   camera/perception_reset/release_pipe_2_s0/CLK
  7.479    0.331   tC2Q   RF   1093     R50C76[1][A]   camera/perception_reset/release_pipe_2_s0/Q
  10.453   2.973   tNET   FF   1        R68C78[0][B]   camera/stream/gap_1_s0/CLEAR

Data Required Path:
    AT     DELAY    TYPE   RF   FANOUT       LOC                   NODE
 ======== ======== ====== ==== ======== ============== =============================
  8.000    8.000                                        active clock edge time
  8.000    0.000                                        eth125
  11.835   3.835    tCL    RR   4971     PLL_B[2]       camera/pll/PLL_inst/CLKOUT1
  15.165   3.330    tNET   RR   1        R68C78[0][B]   camera/stream/gap_1_s0/CLK
  14.853   -0.313   tSu         1        R68C78[0][B]   camera/stream/gap_1_s0

Path Statistics:
Clock Skew: 0.017
Setup Relationship: 8.000
Logic Level: 1
Arrival Clock Path delay: (cell: 0.000 0.000%,
                     route: 3.313 100.000%)
Arrival Data Path Delay: (cell: 0.000 0.000%,
                    route: 2.973 89.990%,
                    tC2Q: 0.331 10.010%)
Required Clock Path Delay: (cell: 0.000 0.000%,
                     route: 3.330 100.000%)

						Path12
Path Summary:
Slack             : 4.400
Data Arrival Time : 10.453
Data Required Time: 14.853
From              : camera/perception_reset/release_pipe_2_s0
To                : camera/stream/gap_2_s0
Launch Clk        : eth125:[R]
Latch Clk         : eth125:[R]

Data Arrival Path:
    AT     DELAY   TYPE   RF   FANOUT       LOC                            NODE
 ======== ======= ====== ==== ======== ============== ===============================================
  0.000    0.000                                       active clock edge time
  0.000    0.000                                       eth125
  3.835    3.835   tCL    RR   4971     PLL_B[2]       camera/pll/PLL_inst/CLKOUT1
  7.149    3.313   tNET   RR   1        R50C76[1][A]   camera/perception_reset/release_pipe_2_s0/CLK
  7.479    0.331   tC2Q   RF   1093     R50C76[1][A]   camera/perception_reset/release_pipe_2_s0/Q
  10.453   2.973   tNET   FF   1        R68C78[0][A]   camera/stream/gap_2_s0/CLEAR

Data Required Path:
    AT     DELAY    TYPE   RF   FANOUT       LOC                   NODE
 ======== ======== ====== ==== ======== ============== =============================
  8.000    8.000                                        active clock edge time
  8.000    0.000                                        eth125
  11.835   3.835    tCL    RR   4971     PLL_B[2]       camera/pll/PLL_inst/CLKOUT1
  15.165   3.330    tNET   RR   1        R68C78[0][A]   camera/stream/gap_2_s0/CLK
  14.853   -0.313   tSu         1        R68C78[0][A]   camera/stream/gap_2_s0

Path Statistics:
Clock Skew: 0.017
Setup Relationship: 8.000
Logic Level: 1
Arrival Clock Path delay: (cell: 0.000 0.000%,
                     route: 3.313 100.000%)
Arrival Data Path Delay: (cell: 0.000 0.000%,
                    route: 2.973 89.990%,
                    tC2Q: 0.331 10.010%)
Required Clock Path Delay: (cell: 0.000 0.000%,
                     route: 3.330 100.000%)

						Path13
Path Summary:
Slack             : 4.400
Data Arrival Time : 10.453
Data Required Time: 14.853
From              : camera/perception_reset/release_pipe_2_s0
To                : camera/stream/ws1_0_s0
Launch Clk        : eth125:[R]
Latch Clk         : eth125:[R]

Data Arrival Path:
    AT     DELAY   TYPE   RF   FANOUT       LOC                            NODE
 ======== ======= ====== ==== ======== ============== ===============================================
  0.000    0.000                                       active clock edge time
  0.000    0.000                                       eth125
  3.835    3.835   tCL    RR   4971     PLL_B[2]       camera/pll/PLL_inst/CLKOUT1
  7.149    3.313   tNET   RR   1        R50C76[1][A]   camera/perception_reset/release_pipe_2_s0/CLK
  7.479    0.331   tC2Q   RF   1093     R50C76[1][A]   camera/perception_reset/release_pipe_2_s0/Q
  10.453   2.973   tNET   FF   1        R68C78[1][B]   camera/stream/ws1_0_s0/CLEAR

Data Required Path:
    AT     DELAY    TYPE   RF   FANOUT       LOC                   NODE
 ======== ======== ====== ==== ======== ============== =============================
  8.000    8.000                                        active clock edge time
  8.000    0.000                                        eth125
  11.835   3.835    tCL    RR   4971     PLL_B[2]       camera/pll/PLL_inst/CLKOUT1
  15.165   3.330    tNET   RR   1        R68C78[1][B]   camera/stream/ws1_0_s0/CLK
  14.853   -0.313   tSu         1        R68C78[1][B]   camera/stream/ws1_0_s0

Path Statistics:
Clock Skew: 0.017
Setup Relationship: 8.000
Logic Level: 1
Arrival Clock Path delay: (cell: 0.000 0.000%,
                     route: 3.313 100.000%)
Arrival Data Path Delay: (cell: 0.000 0.000%,
                    route: 2.973 89.990%,
                    tC2Q: 0.331 10.010%)
Required Clock Path Delay: (cell: 0.000 0.000%,
                     route: 3.330 100.000%)

						Path14
Path Summary:
Slack             : 4.400
Data Arrival Time : 10.444
Data Required Time: 14.844
From              : camera/perception_reset/release_pipe_2_s0
To                : camera/stream/state_1_s4
Launch Clk        : eth125:[R]
Latch Clk         : eth125:[R]

Data Arrival Path:
    AT     DELAY   TYPE   RF   FANOUT       LOC                            NODE
 ======== ======= ====== ==== ======== ============== ===============================================
  0.000    0.000                                       active clock edge time
  0.000    0.000                                       eth125
  3.835    3.835   tCL    RR   4971     PLL_B[2]       camera/pll/PLL_inst/CLKOUT1
  7.149    3.313   tNET   RR   1        R50C76[1][A]   camera/perception_reset/release_pipe_2_s0/CLK
  7.479    0.331   tC2Q   RF   1093     R50C76[1][A]   camera/perception_reset/release_pipe_2_s0/Q
  10.444   2.965   tNET   FF   1        R68C79[0][B]   camera/stream/state_1_s4/CLEAR

Data Required Path:
    AT     DELAY    TYPE   RF   FANOUT       LOC                    NODE
 ======== ======== ====== ==== ======== ============== ==============================
  8.000    8.000                                        active clock edge time
  8.000    0.000                                        eth125
  11.835   3.835    tCL    RR   4971     PLL_B[2]       camera/pll/PLL_inst/CLKOUT1
  15.157   3.322    tNET   RR   1        R68C79[0][B]   camera/stream/state_1_s4/CLK
  14.844   -0.313   tSu         1        R68C79[0][B]   camera/stream/state_1_s4

Path Statistics:
Clock Skew: 0.008
Setup Relationship: 8.000
Logic Level: 1
Arrival Clock Path delay: (cell: 0.000 0.000%,
                     route: 3.313 100.000%)
Arrival Data Path Delay: (cell: 0.000 0.000%,
                    route: 2.965 89.964%,
                    tC2Q: 0.331 10.036%)
Required Clock Path Delay: (cell: 0.000 0.000%,
                     route: 3.322 100.000%)

						Path15
Path Summary:
Slack             : 4.400
Data Arrival Time : 10.444
Data Required Time: 14.844
From              : camera/perception_reset/release_pipe_2_s0
To                : camera/stream/state_2_s9
Launch Clk        : eth125:[R]
Latch Clk         : eth125:[R]

Data Arrival Path:
    AT     DELAY   TYPE   RF   FANOUT       LOC                            NODE
 ======== ======= ====== ==== ======== ============== ===============================================
  0.000    0.000                                       active clock edge time
  0.000    0.000                                       eth125
  3.835    3.835   tCL    RR   4971     PLL_B[2]       camera/pll/PLL_inst/CLKOUT1
  7.149    3.313   tNET   RR   1        R50C76[1][A]   camera/perception_reset/release_pipe_2_s0/CLK
  7.479    0.331   tC2Q   RF   1093     R50C76[1][A]   camera/perception_reset/release_pipe_2_s0/Q
  10.444   2.965   tNET   FF   1        R68C79[1][A]   camera/stream/state_2_s9/CLEAR

Data Required Path:
    AT     DELAY    TYPE   RF   FANOUT       LOC                    NODE
 ======== ======== ====== ==== ======== ============== ==============================
  8.000    8.000                                        active clock edge time
  8.000    0.000                                        eth125
  11.835   3.835    tCL    RR   4971     PLL_B[2]       camera/pll/PLL_inst/CLKOUT1
  15.157   3.322    tNET   RR   1        R68C79[1][A]   camera/stream/state_2_s9/CLK
  14.844   -0.313   tSu         1        R68C79[1][A]   camera/stream/state_2_s9

Path Statistics:
Clock Skew: 0.008
Setup Relationship: 8.000
Logic Level: 1
Arrival Clock Path delay: (cell: 0.000 0.000%,
                     route: 3.313 100.000%)
Arrival Data Path Delay: (cell: 0.000 0.000%,
                    route: 2.965 89.964%,
                    tC2Q: 0.331 10.036%)
Required Clock Path Delay: (cell: 0.000 0.000%,
                     route: 3.322 100.000%)

						Path16
Path Summary:
Slack             : 4.400
Data Arrival Time : 10.436
Data Required Time: 14.836
From              : camera/perception_reset/release_pipe_2_s0
To                : camera/stream/state_2_s8
Launch Clk        : eth125:[R]
Latch Clk         : eth125:[R]

Data Arrival Path:
    AT     DELAY   TYPE   RF   FANOUT       LOC                            NODE
 ======== ======= ====== ==== ======== ============== ===============================================
  0.000    0.000                                       active clock edge time
  0.000    0.000                                       eth125
  3.835    3.835   tCL    RR   4971     PLL_B[2]       camera/pll/PLL_inst/CLKOUT1
  7.149    3.313   tNET   RR   1        R50C76[1][A]   camera/perception_reset/release_pipe_2_s0/CLK
  7.479    0.331   tC2Q   RF   1093     R50C76[1][A]   camera/perception_reset/release_pipe_2_s0/Q
  10.436   2.956   tNET   FF   1        R68C80[2][B]   camera/stream/state_2_s8/CLEAR

Data Required Path:
    AT     DELAY    TYPE   RF   FANOUT       LOC                    NODE
 ======== ======== ====== ==== ======== ============== ==============================
  8.000    8.000                                        active clock edge time
  8.000    0.000                                        eth125
  11.835   3.835    tCL    RR   4971     PLL_B[2]       camera/pll/PLL_inst/CLKOUT1
  15.149   3.313    tNET   RR   1        R68C80[2][B]   camera/stream/state_2_s8/CLK
  14.836   -0.313   tSu         1        R68C80[2][B]   camera/stream/state_2_s8

Path Statistics:
Clock Skew: 0.000
Setup Relationship: 8.000
Logic Level: 1
Arrival Clock Path delay: (cell: 0.000 0.000%,
                     route: 3.313 100.000%)
Arrival Data Path Delay: (cell: 0.000 0.000%,
                    route: 2.956 89.938%,
                    tC2Q: 0.331 10.062%)
Required Clock Path Delay: (cell: 0.000 0.000%,
                     route: 3.313 100.000%)

						Path17
Path Summary:
Slack             : 4.400
Data Arrival Time : 10.444
Data Required Time: 14.844
From              : camera/perception_reset/release_pipe_2_s0
To                : camera/stream/index_0_s4
Launch Clk        : eth125:[R]
Latch Clk         : eth125:[R]

Data Arrival Path:
    AT     DELAY   TYPE   RF   FANOUT       LOC                            NODE
 ======== ======= ====== ==== ======== ============== ===============================================
  0.000    0.000                                       active clock edge time
  0.000    0.000                                       eth125
  3.835    3.835   tCL    RR   4971     PLL_B[2]       camera/pll/PLL_inst/CLKOUT1
  7.149    3.313   tNET   RR   1        R50C76[1][A]   camera/perception_reset/release_pipe_2_s0/CLK
  7.479    0.331   tC2Q   RF   1093     R50C76[1][A]   camera/perception_reset/release_pipe_2_s0/Q
  10.444   2.965   tNET   FF   1        R68C77[1][A]   camera/stream/index_0_s4/CLEAR

Data Required Path:
    AT     DELAY    TYPE   RF   FANOUT       LOC                    NODE
 ======== ======== ====== ==== ======== ============== ==============================
  8.000    8.000                                        active clock edge time
  8.000    0.000                                        eth125
  11.835   3.835    tCL    RR   4971     PLL_B[2]       camera/pll/PLL_inst/CLKOUT1
  15.157   3.322    tNET   RR   1        R68C77[1][A]   camera/stream/index_0_s4/CLK
  14.844   -0.313   tSu         1        R68C77[1][A]   camera/stream/index_0_s4

Path Statistics:
Clock Skew: 0.008
Setup Relationship: 8.000
Logic Level: 1
Arrival Clock Path delay: (cell: 0.000 0.000%,
                     route: 3.313 100.000%)
Arrival Data Path Delay: (cell: 0.000 0.000%,
                    route: 2.965 89.964%,
                    tC2Q: 0.331 10.036%)
Required Clock Path Delay: (cell: 0.000 0.000%,
                     route: 3.322 100.000%)

						Path18
Path Summary:
Slack             : 4.400
Data Arrival Time : 10.436
Data Required Time: 14.836
From              : camera/perception_reset/release_pipe_2_s0
To                : camera/stream/index_1_s3
Launch Clk        : eth125:[R]
Latch Clk         : eth125:[R]

Data Arrival Path:
    AT     DELAY   TYPE   RF   FANOUT       LOC                            NODE
 ======== ======= ====== ==== ======== ============== ===============================================
  0.000    0.000                                       active clock edge time
  0.000    0.000                                       eth125
  3.835    3.835   tCL    RR   4971     PLL_B[2]       camera/pll/PLL_inst/CLKOUT1
  7.149    3.313   tNET   RR   1        R50C76[1][A]   camera/perception_reset/release_pipe_2_s0/CLK
  7.479    0.331   tC2Q   RF   1093     R50C76[1][A]   camera/perception_reset/release_pipe_2_s0/Q
  10.436   2.956   tNET   FF   1        R68C76[1][B]   camera/stream/index_1_s3/CLEAR

Data Required Path:
    AT     DELAY    TYPE   RF   FANOUT       LOC                    NODE
 ======== ======== ====== ==== ======== ============== ==============================
  8.000    8.000                                        active clock edge time
  8.000    0.000                                        eth125
  11.835   3.835    tCL    RR   4971     PLL_B[2]       camera/pll/PLL_inst/CLKOUT1
  15.149   3.313    tNET   RR   1        R68C76[1][B]   camera/stream/index_1_s3/CLK
  14.836   -0.313   tSu         1        R68C76[1][B]   camera/stream/index_1_s3

Path Statistics:
Clock Skew: 0.000
Setup Relationship: 8.000
Logic Level: 1
Arrival Clock Path delay: (cell: 0.000 0.000%,
                     route: 3.313 100.000%)
Arrival Data Path Delay: (cell: 0.000 0.000%,
                    route: 2.956 89.938%,
                    tC2Q: 0.331 10.062%)
Required Clock Path Delay: (cell: 0.000 0.000%,
                     route: 3.313 100.000%)

						Path19
Path Summary:
Slack             : 4.400
Data Arrival Time : 10.436
Data Required Time: 14.836
From              : camera/perception_reset/release_pipe_2_s0
To                : camera/stream/state_0_s2
Launch Clk        : eth125:[R]
Latch Clk         : eth125:[R]

Data Arrival Path:
    AT     DELAY   TYPE   RF   FANOUT       LOC                            NODE
 ======== ======= ====== ==== ======== ============== ===============================================
  0.000    0.000                                       active clock edge time
  0.000    0.000                                       eth125
  3.835    3.835   tCL    RR   4971     PLL_B[2]       camera/pll/PLL_inst/CLKOUT1
  7.149    3.313   tNET   RR   1        R50C76[1][A]   camera/perception_reset/release_pipe_2_s0/CLK
  7.479    0.331   tC2Q   RF   1093     R50C76[1][A]   camera/perception_reset/release_pipe_2_s0/Q
  10.436   2.956   tNET   FF   1        R68C80[0][B]   camera/stream/state_0_s2/CLEAR

Data Required Path:
    AT     DELAY    TYPE   RF   FANOUT       LOC                    NODE
 ======== ======== ====== ==== ======== ============== ==============================
  8.000    8.000                                        active clock edge time
  8.000    0.000                                        eth125
  11.835   3.835    tCL    RR   4971     PLL_B[2]       camera/pll/PLL_inst/CLKOUT1
  15.149   3.313    tNET   RR   1        R68C80[0][B]   camera/stream/state_0_s2/CLK
  14.836   -0.313   tSu         1        R68C80[0][B]   camera/stream/state_0_s2

Path Statistics:
Clock Skew: 0.000
Setup Relationship: 8.000
Logic Level: 1
Arrival Clock Path delay: (cell: 0.000 0.000%,
                     route: 3.313 100.000%)
Arrival Data Path Delay: (cell: 0.000 0.000%,
                    route: 2.956 89.938%,
                    tC2Q: 0.331 10.062%)
Required Clock Path Delay: (cell: 0.000 0.000%,
                     route: 3.313 100.000%)

						Path20
Path Summary:
Slack             : 4.400
Data Arrival Time : 10.444
Data Required Time: 14.844
From              : camera/perception_reset/release_pipe_2_s0
To                : camera/stream/state_1_s3
Launch Clk        : eth125:[R]
Latch Clk         : eth125:[R]

Data Arrival Path:
    AT     DELAY   TYPE   RF   FANOUT       LOC                            NODE
 ======== ======= ====== ==== ======== ============== ===============================================
  0.000    0.000                                       active clock edge time
  0.000    0.000                                       eth125
  3.835    3.835   tCL    RR   4971     PLL_B[2]       camera/pll/PLL_inst/CLKOUT1
  7.149    3.313   tNET   RR   1        R50C76[1][A]   camera/perception_reset/release_pipe_2_s0/CLK
  7.479    0.331   tC2Q   RF   1093     R50C76[1][A]   camera/perception_reset/release_pipe_2_s0/Q
  10.444   2.965   tNET   FF   1        R68C79[0][A]   camera/stream/state_1_s3/CLEAR

Data Required Path:
    AT     DELAY    TYPE   RF   FANOUT       LOC                    NODE
 ======== ======== ====== ==== ======== ============== ==============================
  8.000    8.000                                        active clock edge time
  8.000    0.000                                        eth125
  11.835   3.835    tCL    RR   4971     PLL_B[2]       camera/pll/PLL_inst/CLKOUT1
  15.157   3.322    tNET   RR   1        R68C79[0][A]   camera/stream/state_1_s3/CLK
  14.844   -0.313   tSu         1        R68C79[0][A]   camera/stream/state_1_s3

Path Statistics:
Clock Skew: 0.008
Setup Relationship: 8.000
Logic Level: 1
Arrival Clock Path delay: (cell: 0.000 0.000%,
                     route: 3.313 100.000%)
Arrival Data Path Delay: (cell: 0.000 0.000%,
                    route: 2.965 89.964%,
                    tC2Q: 0.331 10.036%)
Required Clock Path Delay: (cell: 0.000 0.000%,
                     route: 3.322 100.000%)

						Path21
Path Summary:
Slack             : 4.400
Data Arrival Time : 10.436
Data Required Time: 14.836
From              : camera/perception_reset/release_pipe_2_s0
To                : camera/stream/state_1_s2
Launch Clk        : eth125:[R]
Latch Clk         : eth125:[R]

Data Arrival Path:
    AT     DELAY   TYPE   RF   FANOUT       LOC                            NODE
 ======== ======= ====== ==== ======== ============== ===============================================
  0.000    0.000                                       active clock edge time
  0.000    0.000                                       eth125
  3.835    3.835   tCL    RR   4971     PLL_B[2]       camera/pll/PLL_inst/CLKOUT1
  7.149    3.313   tNET   RR   1        R50C76[1][A]   camera/perception_reset/release_pipe_2_s0/CLK
  7.479    0.331   tC2Q   RF   1093     R50C76[1][A]   camera/perception_reset/release_pipe_2_s0/Q
  10.436   2.956   tNET   FF   1        R68C80[1][B]   camera/stream/state_1_s2/CLEAR

Data Required Path:
    AT     DELAY    TYPE   RF   FANOUT       LOC                    NODE
 ======== ======== ====== ==== ======== ============== ==============================
  8.000    8.000                                        active clock edge time
  8.000    0.000                                        eth125
  11.835   3.835    tCL    RR   4971     PLL_B[2]       camera/pll/PLL_inst/CLKOUT1
  15.149   3.313    tNET   RR   1        R68C80[1][B]   camera/stream/state_1_s2/CLK
  14.836   -0.313   tSu         1        R68C80[1][B]   camera/stream/state_1_s2

Path Statistics:
Clock Skew: 0.000
Setup Relationship: 8.000
Logic Level: 1
Arrival Clock Path delay: (cell: 0.000 0.000%,
                     route: 3.313 100.000%)
Arrival Data Path Delay: (cell: 0.000 0.000%,
                    route: 2.956 89.938%,
                    tC2Q: 0.331 10.062%)
Required Clock Path Delay: (cell: 0.000 0.000%,
                     route: 3.313 100.000%)

						Path22
Path Summary:
Slack             : 4.400
Data Arrival Time : 10.436
Data Required Time: 14.836
From              : camera/perception_reset/release_pipe_2_s0
To                : camera/stream/state_2_s7
Launch Clk        : eth125:[R]
Latch Clk         : eth125:[R]

Data Arrival Path:
    AT     DELAY   TYPE   RF   FANOUT       LOC                            NODE
 ======== ======= ====== ==== ======== ============== ===============================================
  0.000    0.000                                       active clock edge time
  0.000    0.000                                       eth125
  3.835    3.835   tCL    RR   4971     PLL_B[2]       camera/pll/PLL_inst/CLKOUT1
  7.149    3.313   tNET   RR   1        R50C76[1][A]   camera/perception_reset/release_pipe_2_s0/CLK
  7.479    0.331   tC2Q   RF   1093     R50C76[1][A]   camera/perception_reset/release_pipe_2_s0/Q
  10.436   2.956   tNET   FF   1        R68C80[2][A]   camera/stream/state_2_s7/CLEAR

Data Required Path:
    AT     DELAY    TYPE   RF   FANOUT       LOC                    NODE
 ======== ======== ====== ==== ======== ============== ==============================
  8.000    8.000                                        active clock edge time
  8.000    0.000                                        eth125
  11.835   3.835    tCL    RR   4971     PLL_B[2]       camera/pll/PLL_inst/CLKOUT1
  15.149   3.313    tNET   RR   1        R68C80[2][A]   camera/stream/state_2_s7/CLK
  14.836   -0.313   tSu         1        R68C80[2][A]   camera/stream/state_2_s7

Path Statistics:
Clock Skew: 0.000
Setup Relationship: 8.000
Logic Level: 1
Arrival Clock Path delay: (cell: 0.000 0.000%,
                     route: 3.313 100.000%)
Arrival Data Path Delay: (cell: 0.000 0.000%,
                    route: 2.956 89.938%,
                    tC2Q: 0.331 10.062%)
Required Clock Path Delay: (cell: 0.000 0.000%,
                     route: 3.313 100.000%)

						Path23
Path Summary:
Slack             : 4.400
Data Arrival Time : 10.436
Data Required Time: 14.836
From              : camera/perception_reset/release_pipe_2_s0
To                : camera/stream/rptr_0_s4
Launch Clk        : eth125:[R]
Latch Clk         : eth125:[R]

Data Arrival Path:
    AT     DELAY   TYPE   RF   FANOUT       LOC                            NODE
 ======== ======= ====== ==== ======== ============== ===============================================
  0.000    0.000                                       active clock edge time
  0.000    0.000                                       eth125
  3.835    3.835   tCL    RR   4971     PLL_B[2]       camera/pll/PLL_inst/CLKOUT1
  7.149    3.313   tNET   RR   1        R50C76[1][A]   camera/perception_reset/release_pipe_2_s0/CLK
  7.479    0.331   tC2Q   RF   1093     R50C76[1][A]   camera/perception_reset/release_pipe_2_s0/Q
  10.436   2.956   tNET   FF   1        R68C76[0][A]   camera/stream/rptr_0_s4/CLEAR

Data Required Path:
    AT     DELAY    TYPE   RF   FANOUT       LOC                   NODE
 ======== ======== ====== ==== ======== ============== =============================
  8.000    8.000                                        active clock edge time
  8.000    0.000                                        eth125
  11.835   3.835    tCL    RR   4971     PLL_B[2]       camera/pll/PLL_inst/CLKOUT1
  15.149   3.313    tNET   RR   1        R68C76[0][A]   camera/stream/rptr_0_s4/CLK
  14.836   -0.313   tSu         1        R68C76[0][A]   camera/stream/rptr_0_s4

Path Statistics:
Clock Skew: 0.000
Setup Relationship: 8.000
Logic Level: 1
Arrival Clock Path delay: (cell: 0.000 0.000%,
                     route: 3.313 100.000%)
Arrival Data Path Delay: (cell: 0.000 0.000%,
                    route: 2.956 89.938%,
                    tC2Q: 0.331 10.062%)
Required Clock Path Delay: (cell: 0.000 0.000%,
                     route: 3.313 100.000%)

						Path24
Path Summary:
Slack             : 4.400
Data Arrival Time : 10.444
Data Required Time: 14.844
From              : camera/perception_reset/release_pipe_2_s0
To                : camera/stream/word_index_0_s1
Launch Clk        : eth125:[R]
Latch Clk         : eth125:[R]

Data Arrival Path:
    AT     DELAY   TYPE   RF   FANOUT       LOC                            NODE
 ======== ======= ====== ==== ======== ============== ===============================================
  0.000    0.000                                       active clock edge time
  0.000    0.000                                       eth125
  3.835    3.835   tCL    RR   4971     PLL_B[2]       camera/pll/PLL_inst/CLKOUT1
  7.149    3.313   tNET   RR   1        R50C76[1][A]   camera/perception_reset/release_pipe_2_s0/CLK
  7.479    0.331   tC2Q   RF   1093     R50C76[1][A]   camera/perception_reset/release_pipe_2_s0/Q
  10.444   2.965   tNET   FF   1        R68C73[2][B]   camera/stream/word_index_0_s1/CLEAR

Data Required Path:
    AT     DELAY    TYPE   RF   FANOUT       LOC                      NODE
 ======== ======== ====== ==== ======== ============== ===================================
  8.000    8.000                                        active clock edge time
  8.000    0.000                                        eth125
  11.835   3.835    tCL    RR   4971     PLL_B[2]       camera/pll/PLL_inst/CLKOUT1
  15.157   3.322    tNET   RR   1        R68C73[2][B]   camera/stream/word_index_0_s1/CLK
  14.844   -0.313   tSu         1        R68C73[2][B]   camera/stream/word_index_0_s1

Path Statistics:
Clock Skew: 0.008
Setup Relationship: 8.000
Logic Level: 1
Arrival Clock Path delay: (cell: 0.000 0.000%,
                     route: 3.313 100.000%)
Arrival Data Path Delay: (cell: 0.000 0.000%,
                    route: 2.965 89.964%,
                    tC2Q: 0.331 10.036%)
Required Clock Path Delay: (cell: 0.000 0.000%,
                     route: 3.322 100.000%)

						Path25
Path Summary:
Slack             : 4.400
Data Arrival Time : 10.444
Data Required Time: 14.844
From              : camera/perception_reset/release_pipe_2_s0
To                : camera/stream/word_index_4_s1
Launch Clk        : eth125:[R]
Latch Clk         : eth125:[R]

Data Arrival Path:
    AT     DELAY   TYPE   RF   FANOUT       LOC                            NODE
 ======== ======= ====== ==== ======== ============== ===============================================
  0.000    0.000                                       active clock edge time
  0.000    0.000                                       eth125
  3.835    3.835   tCL    RR   4971     PLL_B[2]       camera/pll/PLL_inst/CLKOUT1
  7.149    3.313   tNET   RR   1        R50C76[1][A]   camera/perception_reset/release_pipe_2_s0/CLK
  7.479    0.331   tC2Q   RF   1093     R50C76[1][A]   camera/perception_reset/release_pipe_2_s0/Q
  10.444   2.965   tNET   FF   1        R68C73[1][B]   camera/stream/word_index_4_s1/CLEAR

Data Required Path:
    AT     DELAY    TYPE   RF   FANOUT       LOC                      NODE
 ======== ======== ====== ==== ======== ============== ===================================
  8.000    8.000                                        active clock edge time
  8.000    0.000                                        eth125
  11.835   3.835    tCL    RR   4971     PLL_B[2]       camera/pll/PLL_inst/CLKOUT1
  15.157   3.322    tNET   RR   1        R68C73[1][B]   camera/stream/word_index_4_s1/CLK
  14.844   -0.313   tSu         1        R68C73[1][B]   camera/stream/word_index_4_s1

Path Statistics:
Clock Skew: 0.008
Setup Relationship: 8.000
Logic Level: 1
Arrival Clock Path delay: (cell: 0.000 0.000%,
                     route: 3.313 100.000%)
Arrival Data Path Delay: (cell: 0.000 0.000%,
                    route: 2.965 89.964%,
                    tC2Q: 0.331 10.036%)
Required Clock Path Delay: (cell: 0.000 0.000%,
                     route: 3.322 100.000%)

3.3.4 Removal Analysis Report
Report Command:report_timing -removal -max_paths 25 -max_common_paths 1
						Path1
Path Summary:
Slack             : 0.369
Data Arrival Time : 2.220
Data Required Time: 1.851
From              : camera/runtime_network.receive_reset/release_pipe_2_s1
To                : camera/runtime_network.net/write_mask_67_s0
Launch Clk        : eth_rx125:[R]
Latch Clk         : eth_rx125:[R]

Data Arrival Path:
   AT     DELAY   TYPE   RF   FANOUT        LOC                                   NODE
 ======= ======= ====== ==== ======== =============== ============================================================
  0.000   0.000                                        active clock edge time
  0.000   0.000                                        eth_rx125
  0.000   0.000   tCL    RR   1        IOB122[A]       rgmii_rxc_ibuf/I
  0.608   0.608   tINS   RR   850      IOB122[A]       rgmii_rxc_ibuf/O
  1.902   1.294   tNET   RR   1        R49C101[1][A]   camera/runtime_network.receive_reset/release_pipe_2_s1/CLK
  2.032   0.130   tC2Q   RR   211      R49C101[1][A]   camera/runtime_network.receive_reset/release_pipe_2_s1/Q
  2.220   0.188   tNET   RR   1        R49C100[1][B]   camera/runtime_network.net/write_mask_67_s0/CLEAR

Data Required Path:
   AT     DELAY    TYPE   RF   FANOUT        LOC                             NODE
 ======= ======== ====== ==== ======== =============== =================================================
  0.000   0.000                                         active clock edge time
  0.000   0.000                                         eth_rx125
  0.000   0.000    tCL    RR   1        IOB122[A]       rgmii_rxc_ibuf/I
  0.608   0.608    tINS   RR   850      IOB122[A]       rgmii_rxc_ibuf/O
  1.899   1.291    tNET   RR   1        R49C100[1][B]   camera/runtime_network.net/write_mask_67_s0/CLK
  1.851   -0.048   tHld        1        R49C100[1][B]   camera/runtime_network.net/write_mask_67_s0

Path Statistics:
Clock Skew: -0.004
Hold Relationship: 0.000
Logic Level: 1
Arrival Clock Path delay: (cell: 0.608 31.961%,
                     route: 1.294 68.039%)
Arrival Data Path Delay: (cell: 0.000 0.000%,
                    route: 0.188 59.207%,
                    tC2Q: 0.130 40.793%)
Required Clock Path Delay: (cell: 0.608 32.022%,
                     route: 1.291 67.978%)

						Path2
Path Summary:
Slack             : 0.369
Data Arrival Time : 2.220
Data Required Time: 1.851
From              : camera/runtime_network.receive_reset/release_pipe_2_s1
To                : camera/runtime_network.net/write_mask_69_s0
Launch Clk        : eth_rx125:[R]
Latch Clk         : eth_rx125:[R]

Data Arrival Path:
   AT     DELAY   TYPE   RF   FANOUT        LOC                                   NODE
 ======= ======= ====== ==== ======== =============== ============================================================
  0.000   0.000                                        active clock edge time
  0.000   0.000                                        eth_rx125
  0.000   0.000   tCL    RR   1        IOB122[A]       rgmii_rxc_ibuf/I
  0.608   0.608   tINS   RR   850      IOB122[A]       rgmii_rxc_ibuf/O
  1.902   1.294   tNET   RR   1        R49C101[1][A]   camera/runtime_network.receive_reset/release_pipe_2_s1/CLK
  2.032   0.130   tC2Q   RR   211      R49C101[1][A]   camera/runtime_network.receive_reset/release_pipe_2_s1/Q
  2.220   0.188   tNET   RR   1        R49C100[1][A]   camera/runtime_network.net/write_mask_69_s0/CLEAR

Data Required Path:
   AT     DELAY    TYPE   RF   FANOUT        LOC                             NODE
 ======= ======== ====== ==== ======== =============== =================================================
  0.000   0.000                                         active clock edge time
  0.000   0.000                                         eth_rx125
  0.000   0.000    tCL    RR   1        IOB122[A]       rgmii_rxc_ibuf/I
  0.608   0.608    tINS   RR   850      IOB122[A]       rgmii_rxc_ibuf/O
  1.899   1.291    tNET   RR   1        R49C100[1][A]   camera/runtime_network.net/write_mask_69_s0/CLK
  1.851   -0.048   tHld        1        R49C100[1][A]   camera/runtime_network.net/write_mask_69_s0

Path Statistics:
Clock Skew: -0.004
Hold Relationship: 0.000
Logic Level: 1
Arrival Clock Path delay: (cell: 0.608 31.961%,
                     route: 1.294 68.039%)
Arrival Data Path Delay: (cell: 0.000 0.000%,
                    route: 0.188 59.207%,
                    tC2Q: 0.130 40.793%)
Required Clock Path Delay: (cell: 0.608 32.022%,
                     route: 1.291 67.978%)

						Path3
Path Summary:
Slack             : 0.369
Data Arrival Time : 2.220
Data Required Time: 1.851
From              : camera/runtime_network.receive_reset/release_pipe_2_s1
To                : camera/runtime_network.net/write_mask_71_s0
Launch Clk        : eth_rx125:[R]
Latch Clk         : eth_rx125:[R]

Data Arrival Path:
   AT     DELAY   TYPE   RF   FANOUT        LOC                                   NODE
 ======= ======= ====== ==== ======== =============== ============================================================
  0.000   0.000                                        active clock edge time
  0.000   0.000                                        eth_rx125
  0.000   0.000   tCL    RR   1        IOB122[A]       rgmii_rxc_ibuf/I
  0.608   0.608   tINS   RR   850      IOB122[A]       rgmii_rxc_ibuf/O
  1.902   1.294   tNET   RR   1        R49C101[1][A]   camera/runtime_network.receive_reset/release_pipe_2_s1/CLK
  2.032   0.130   tC2Q   RR   211      R49C101[1][A]   camera/runtime_network.receive_reset/release_pipe_2_s1/Q
  2.220   0.188   tNET   RR   1        R49C100[0][A]   camera/runtime_network.net/write_mask_71_s0/CLEAR

Data Required Path:
   AT     DELAY    TYPE   RF   FANOUT        LOC                             NODE
 ======= ======== ====== ==== ======== =============== =================================================
  0.000   0.000                                         active clock edge time
  0.000   0.000                                         eth_rx125
  0.000   0.000    tCL    RR   1        IOB122[A]       rgmii_rxc_ibuf/I
  0.608   0.608    tINS   RR   850      IOB122[A]       rgmii_rxc_ibuf/O
  1.899   1.291    tNET   RR   1        R49C100[0][A]   camera/runtime_network.net/write_mask_71_s0/CLK
  1.851   -0.048   tHld        1        R49C100[0][A]   camera/runtime_network.net/write_mask_71_s0

Path Statistics:
Clock Skew: -0.004
Hold Relationship: 0.000
Logic Level: 1
Arrival Clock Path delay: (cell: 0.608 31.961%,
                     route: 1.294 68.039%)
Arrival Data Path Delay: (cell: 0.000 0.000%,
                    route: 0.188 59.207%,
                    tC2Q: 0.130 40.793%)
Required Clock Path Delay: (cell: 0.608 32.022%,
                     route: 1.291 67.978%)

						Path4
Path Summary:
Slack             : 0.369
Data Arrival Time : 2.220
Data Required Time: 1.851
From              : camera/runtime_network.receive_reset/release_pipe_2_s1
To                : camera/runtime_network.net/write_mask_73_s0
Launch Clk        : eth_rx125:[R]
Latch Clk         : eth_rx125:[R]

Data Arrival Path:
   AT     DELAY   TYPE   RF   FANOUT        LOC                                   NODE
 ======= ======= ====== ==== ======== =============== ============================================================
  0.000   0.000                                        active clock edge time
  0.000   0.000                                        eth_rx125
  0.000   0.000   tCL    RR   1        IOB122[A]       rgmii_rxc_ibuf/I
  0.608   0.608   tINS   RR   850      IOB122[A]       rgmii_rxc_ibuf/O
  1.902   1.294   tNET   RR   1        R49C101[1][A]   camera/runtime_network.receive_reset/release_pipe_2_s1/CLK
  2.032   0.130   tC2Q   RR   211      R49C101[1][A]   camera/runtime_network.receive_reset/release_pipe_2_s1/Q
  2.220   0.188   tNET   RR   1        R49C100[2][A]   camera/runtime_network.net/write_mask_73_s0/CLEAR

Data Required Path:
   AT     DELAY    TYPE   RF   FANOUT        LOC                             NODE
 ======= ======== ====== ==== ======== =============== =================================================
  0.000   0.000                                         active clock edge time
  0.000   0.000                                         eth_rx125
  0.000   0.000    tCL    RR   1        IOB122[A]       rgmii_rxc_ibuf/I
  0.608   0.608    tINS   RR   850      IOB122[A]       rgmii_rxc_ibuf/O
  1.899   1.291    tNET   RR   1        R49C100[2][A]   camera/runtime_network.net/write_mask_73_s0/CLK
  1.851   -0.048   tHld        1        R49C100[2][A]   camera/runtime_network.net/write_mask_73_s0

Path Statistics:
Clock Skew: -0.004
Hold Relationship: 0.000
Logic Level: 1
Arrival Clock Path delay: (cell: 0.608 31.961%,
                     route: 1.294 68.039%)
Arrival Data Path Delay: (cell: 0.000 0.000%,
                    route: 0.188 59.207%,
                    tC2Q: 0.130 40.793%)
Required Clock Path Delay: (cell: 0.608 32.022%,
                     route: 1.291 67.978%)

						Path5
Path Summary:
Slack             : 0.369
Data Arrival Time : 2.220
Data Required Time: 1.851
From              : camera/runtime_network.receive_reset/release_pipe_2_s1
To                : camera/runtime_network.net/rx_byte_2_s0
Launch Clk        : eth_rx125:[R]
Latch Clk         : eth_rx125:[R]

Data Arrival Path:
   AT     DELAY   TYPE   RF   FANOUT        LOC                                   NODE
 ======= ======= ====== ==== ======== =============== ============================================================
  0.000   0.000                                        active clock edge time
  0.000   0.000                                        eth_rx125
  0.000   0.000   tCL    RR   1        IOB122[A]       rgmii_rxc_ibuf/I
  0.608   0.608   tINS   RR   850      IOB122[A]       rgmii_rxc_ibuf/O
  1.902   1.294   tNET   RR   1        R49C101[1][A]   camera/runtime_network.receive_reset/release_pipe_2_s1/CLK
  2.032   0.130   tC2Q   RR   211      R49C101[1][A]   camera/runtime_network.receive_reset/release_pipe_2_s1/Q
  2.220   0.188   tNET   RR   1        R49C100[0][B]   camera/runtime_network.net/rx_byte_2_s0/CLEAR

Data Required Path:
   AT     DELAY    TYPE   RF   FANOUT        LOC                           NODE
 ======= ======== ====== ==== ======== =============== =============================================
  0.000   0.000                                         active clock edge time
  0.000   0.000                                         eth_rx125
  0.000   0.000    tCL    RR   1        IOB122[A]       rgmii_rxc_ibuf/I
  0.608   0.608    tINS   RR   850      IOB122[A]       rgmii_rxc_ibuf/O
  1.899   1.291    tNET   RR   1        R49C100[0][B]   camera/runtime_network.net/rx_byte_2_s0/CLK
  1.851   -0.048   tHld        1        R49C100[0][B]   camera/runtime_network.net/rx_byte_2_s0

Path Statistics:
Clock Skew: -0.004
Hold Relationship: 0.000
Logic Level: 1
Arrival Clock Path delay: (cell: 0.608 31.961%,
                     route: 1.294 68.039%)
Arrival Data Path Delay: (cell: 0.000 0.000%,
                    route: 0.188 59.207%,
                    tC2Q: 0.130 40.793%)
Required Clock Path Delay: (cell: 0.608 32.022%,
                     route: 1.291 67.978%)

						Path6
Path Summary:
Slack             : 0.380
Data Arrival Time : 3.013
Data Required Time: 2.633
From              : camera/sys_reset/release_pipe_2_s0
To                : camera/config_camera/bus/dly_cnt_4_s1
Launch Clk        : control50:[R]
Latch Clk         : control50:[R]

Data Arrival Path:
   AT     DELAY   TYPE   RF   FANOUT        LOC                           NODE
 ======= ======= ====== ==== ======== =============== =============================================
  0.000   0.000                                        active clock edge time
  0.000   0.000                                        control50
  1.869   1.869   tCL    RR   219      PLL_B[2]        camera/pll/PLL_inst/CLKOUT0
  2.674   0.805   tNET   RR   1        R78C130[2][A]   camera/sys_reset/release_pipe_2_s0/CLK
  2.804   0.130   tC2Q   RR   175      R78C130[2][A]   camera/sys_reset/release_pipe_2_s0/Q
  3.013   0.210   tNET   RR   1        R76C131[0][A]   camera/config_camera/bus/dly_cnt_4_s1/CLEAR

Data Required Path:
   AT     DELAY    TYPE   RF   FANOUT        LOC                          NODE
 ======= ======== ====== ==== ======== =============== ===========================================
  0.000   0.000                                         active clock edge time
  0.000   0.000                                         control50
  1.869   1.869    tCL    RR   219      PLL_B[2]        camera/pll/PLL_inst/CLKOUT0
  2.681   0.812    tNET   RR   1        R76C131[0][A]   camera/config_camera/bus/dly_cnt_4_s1/CLK
  2.633   -0.048   tHld        1        R76C131[0][A]   camera/config_camera/bus/dly_cnt_4_s1

Path Statistics:
Clock Skew: 0.007
Hold Relationship: 0.000
Logic Level: 1
Arrival Clock Path delay: (cell: 0.000 0.000%,
                     route: 0.805 100.000%)
Arrival Data Path Delay: (cell: 0.000 0.000%,
                    route: 0.210 61.804%,
                    tC2Q: 0.130 38.196%)
Required Clock Path Delay: (cell: 0.000 0.000%,
                     route: 0.812 100.000%)

						Path7
Path Summary:
Slack             : 0.380
Data Arrival Time : 3.013
Data Required Time: 2.633
From              : camera/sys_reset/release_pipe_2_s0
To                : camera/config_camera/bus/dly_cnt_5_s1
Launch Clk        : control50:[R]
Latch Clk         : control50:[R]

Data Arrival Path:
   AT     DELAY   TYPE   RF   FANOUT        LOC                           NODE
 ======= ======= ====== ==== ======== =============== =============================================
  0.000   0.000                                        active clock edge time
  0.000   0.000                                        control50
  1.869   1.869   tCL    RR   219      PLL_B[2]        camera/pll/PLL_inst/CLKOUT0
  2.674   0.805   tNET   RR   1        R78C130[2][A]   camera/sys_reset/release_pipe_2_s0/CLK
  2.804   0.130   tC2Q   RR   175      R78C130[2][A]   camera/sys_reset/release_pipe_2_s0/Q
  3.013   0.210   tNET   RR   1        R76C131[2][A]   camera/config_camera/bus/dly_cnt_5_s1/CLEAR

Data Required Path:
   AT     DELAY    TYPE   RF   FANOUT        LOC                          NODE
 ======= ======== ====== ==== ======== =============== ===========================================
  0.000   0.000                                         active clock edge time
  0.000   0.000                                         control50
  1.869   1.869    tCL    RR   219      PLL_B[2]        camera/pll/PLL_inst/CLKOUT0
  2.681   0.812    tNET   RR   1        R76C131[2][A]   camera/config_camera/bus/dly_cnt_5_s1/CLK
  2.633   -0.048   tHld        1        R76C131[2][A]   camera/config_camera/bus/dly_cnt_5_s1

Path Statistics:
Clock Skew: 0.007
Hold Relationship: 0.000
Logic Level: 1
Arrival Clock Path delay: (cell: 0.000 0.000%,
                     route: 0.805 100.000%)
Arrival Data Path Delay: (cell: 0.000 0.000%,
                    route: 0.210 61.804%,
                    tC2Q: 0.130 38.196%)
Required Clock Path Delay: (cell: 0.000 0.000%,
                     route: 0.812 100.000%)

						Path8
Path Summary:
Slack             : 0.380
Data Arrival Time : 3.013
Data Required Time: 2.633
From              : camera/sys_reset/release_pipe_2_s0
To                : camera/config_camera/bus/dly_cnt_6_s1
Launch Clk        : control50:[R]
Latch Clk         : control50:[R]

Data Arrival Path:
   AT     DELAY   TYPE   RF   FANOUT        LOC                           NODE
 ======= ======= ====== ==== ======== =============== =============================================
  0.000   0.000                                        active clock edge time
  0.000   0.000                                        control50
  1.869   1.869   tCL    RR   219      PLL_B[2]        camera/pll/PLL_inst/CLKOUT0
  2.674   0.805   tNET   RR   1        R78C130[2][A]   camera/sys_reset/release_pipe_2_s0/CLK
  2.804   0.130   tC2Q   RR   175      R78C130[2][A]   camera/sys_reset/release_pipe_2_s0/Q
  3.013   0.210   tNET   RR   1        R76C131[3][A]   camera/config_camera/bus/dly_cnt_6_s1/CLEAR

Data Required Path:
   AT     DELAY    TYPE   RF   FANOUT        LOC                          NODE
 ======= ======== ====== ==== ======== =============== ===========================================
  0.000   0.000                                         active clock edge time
  0.000   0.000                                         control50
  1.869   1.869    tCL    RR   219      PLL_B[2]        camera/pll/PLL_inst/CLKOUT0
  2.681   0.812    tNET   RR   1        R76C131[3][A]   camera/config_camera/bus/dly_cnt_6_s1/CLK
  2.633   -0.048   tHld        1        R76C131[3][A]   camera/config_camera/bus/dly_cnt_6_s1

Path Statistics:
Clock Skew: 0.007
Hold Relationship: 0.000
Logic Level: 1
Arrival Clock Path delay: (cell: 0.000 0.000%,
                     route: 0.805 100.000%)
Arrival Data Path Delay: (cell: 0.000 0.000%,
                    route: 0.210 61.804%,
                    tC2Q: 0.130 38.196%)
Required Clock Path Delay: (cell: 0.000 0.000%,
                     route: 0.812 100.000%)

						Path9
Path Summary:
Slack             : 0.380
Data Arrival Time : 3.013
Data Required Time: 2.633
From              : camera/sys_reset/release_pipe_2_s0
To                : camera/config_camera/bus/dly_cnt_7_s1
Launch Clk        : control50:[R]
Latch Clk         : control50:[R]

Data Arrival Path:
   AT     DELAY   TYPE   RF   FANOUT        LOC                           NODE
 ======= ======= ====== ==== ======== =============== =============================================
  0.000   0.000                                        active clock edge time
  0.000   0.000                                        control50
  1.869   1.869   tCL    RR   219      PLL_B[2]        camera/pll/PLL_inst/CLKOUT0
  2.674   0.805   tNET   RR   1        R78C130[2][A]   camera/sys_reset/release_pipe_2_s0/CLK
  2.804   0.130   tC2Q   RR   175      R78C130[2][A]   camera/sys_reset/release_pipe_2_s0/Q
  3.013   0.210   tNET   RR   1        R76C131[0][B]   camera/config_camera/bus/dly_cnt_7_s1/CLEAR

Data Required Path:
   AT     DELAY    TYPE   RF   FANOUT        LOC                          NODE
 ======= ======== ====== ==== ======== =============== ===========================================
  0.000   0.000                                         active clock edge time
  0.000   0.000                                         control50
  1.869   1.869    tCL    RR   219      PLL_B[2]        camera/pll/PLL_inst/CLKOUT0
  2.681   0.812    tNET   RR   1        R76C131[0][B]   camera/config_camera/bus/dly_cnt_7_s1/CLK
  2.633   -0.048   tHld        1        R76C131[0][B]   camera/config_camera/bus/dly_cnt_7_s1

Path Statistics:
Clock Skew: 0.007
Hold Relationship: 0.000
Logic Level: 1
Arrival Clock Path delay: (cell: 0.000 0.000%,
                     route: 0.805 100.000%)
Arrival Data Path Delay: (cell: 0.000 0.000%,
                    route: 0.210 61.804%,
                    tC2Q: 0.130 38.196%)
Required Clock Path Delay: (cell: 0.000 0.000%,
                     route: 0.812 100.000%)

						Path10
Path Summary:
Slack             : 0.381
Data Arrival Time : 3.006
Data Required Time: 2.625
From              : camera/sys_reset/release_pipe_2_s0
To                : camera/config_camera/bus/i2c_bit_shift/state.RD_DATA_s0
Launch Clk        : control50:[R]
Latch Clk         : control50:[R]

Data Arrival Path:
   AT     DELAY   TYPE   RF   FANOUT        LOC                                    NODE
 ======= ======= ====== ==== ======== =============== ===============================================================
  0.000   0.000                                        active clock edge time
  0.000   0.000                                        control50
  1.869   1.869   tCL    RR   219      PLL_B[2]        camera/pll/PLL_inst/CLKOUT0
  2.674   0.805   tNET   RR   1        R78C130[2][A]   camera/sys_reset/release_pipe_2_s0/CLK
  2.804   0.130   tC2Q   RR   175      R78C130[2][A]   camera/sys_reset/release_pipe_2_s0/Q
  3.006   0.203   tNET   RR   1        R79C132[2][A]   camera/config_camera/bus/i2c_bit_shift/state.RD_DATA_s0/CLEAR

Data Required Path:
   AT     DELAY    TYPE   RF   FANOUT        LOC                                   NODE
 ======= ======== ====== ==== ======== =============== =============================================================
  0.000   0.000                                         active clock edge time
  0.000   0.000                                         control50
  1.869   1.869    tCL    RR   219      PLL_B[2]        camera/pll/PLL_inst/CLKOUT0
  2.673   0.804    tNET   RR   1        R79C132[2][A]   camera/config_camera/bus/i2c_bit_shift/state.RD_DATA_s0/CLK
  2.625   -0.048   tHld        1        R79C132[2][A]   camera/config_camera/bus/i2c_bit_shift/state.RD_DATA_s0

Path Statistics:
Clock Skew: -0.002
Hold Relationship: 0.000
Logic Level: 1
Arrival Clock Path delay: (cell: 0.000 0.000%,
                     route: 0.805 100.000%)
Arrival Data Path Delay: (cell: 0.000 0.000%,
                    route: 0.203 60.976%,
                    tC2Q: 0.130 39.024%)
Required Clock Path Delay: (cell: 0.000 0.000%,
                     route: 0.804 100.000%)

						Path11
Path Summary:
Slack             : 0.382
Data Arrival Time : 3.013
Data Required Time: 2.632
From              : camera/sys_reset/release_pipe_2_s0
To                : camera/config_camera/bus/RW_Done_s2
Launch Clk        : control50:[R]
Latch Clk         : control50:[R]

Data Arrival Path:
   AT     DELAY   TYPE   RF   FANOUT        LOC                          NODE
 ======= ======= ====== ==== ======== =============== ===========================================
  0.000   0.000                                        active clock edge time
  0.000   0.000                                        control50
  1.869   1.869   tCL    RR   219      PLL_B[2]        camera/pll/PLL_inst/CLKOUT0
  2.674   0.805   tNET   RR   1        R78C130[2][A]   camera/sys_reset/release_pipe_2_s0/CLK
  2.804   0.130   tC2Q   RR   175      R78C130[2][A]   camera/sys_reset/release_pipe_2_s0/Q
  3.013   0.210   tNET   RR   1        R77C131[0][A]   camera/config_camera/bus/RW_Done_s2/CLEAR

Data Required Path:
   AT     DELAY    TYPE   RF   FANOUT        LOC                         NODE
 ======= ======== ====== ==== ======== =============== =========================================
  0.000   0.000                                         active clock edge time
  0.000   0.000                                         control50
  1.869   1.869    tCL    RR   219      PLL_B[2]        camera/pll/PLL_inst/CLKOUT0
  2.679   0.810    tNET   RR   1        R77C131[0][A]   camera/config_camera/bus/RW_Done_s2/CLK
  2.632   -0.048   tHld        1        R77C131[0][A]   camera/config_camera/bus/RW_Done_s2

Path Statistics:
Clock Skew: 0.005
Hold Relationship: 0.000
Logic Level: 1
Arrival Clock Path delay: (cell: 0.000 0.000%,
                     route: 0.805 100.000%)
Arrival Data Path Delay: (cell: 0.000 0.000%,
                    route: 0.210 61.804%,
                    tC2Q: 0.130 38.196%)
Required Clock Path Delay: (cell: 0.000 0.000%,
                     route: 0.810 100.000%)

						Path12
Path Summary:
Slack             : 0.382
Data Arrival Time : 3.013
Data Required Time: 2.632
From              : camera/sys_reset/release_pipe_2_s0
To                : camera/config_camera/bus/dly_cnt_2_s1
Launch Clk        : control50:[R]
Latch Clk         : control50:[R]

Data Arrival Path:
   AT     DELAY   TYPE   RF   FANOUT        LOC                           NODE
 ======= ======= ====== ==== ======== =============== =============================================
  0.000   0.000                                        active clock edge time
  0.000   0.000                                        control50
  1.869   1.869   tCL    RR   219      PLL_B[2]        camera/pll/PLL_inst/CLKOUT0
  2.674   0.805   tNET   RR   1        R78C130[2][A]   camera/sys_reset/release_pipe_2_s0/CLK
  2.804   0.130   tC2Q   RR   175      R78C130[2][A]   camera/sys_reset/release_pipe_2_s0/Q
  3.013   0.210   tNET   RR   1        R77C131[2][A]   camera/config_camera/bus/dly_cnt_2_s1/CLEAR

Data Required Path:
   AT     DELAY    TYPE   RF   FANOUT        LOC                          NODE
 ======= ======== ====== ==== ======== =============== ===========================================
  0.000   0.000                                         active clock edge time
  0.000   0.000                                         control50
  1.869   1.869    tCL    RR   219      PLL_B[2]        camera/pll/PLL_inst/CLKOUT0
  2.679   0.810    tNET   RR   1        R77C131[2][A]   camera/config_camera/bus/dly_cnt_2_s1/CLK
  2.632   -0.048   tHld        1        R77C131[2][A]   camera/config_camera/bus/dly_cnt_2_s1

Path Statistics:
Clock Skew: 0.005
Hold Relationship: 0.000
Logic Level: 1
Arrival Clock Path delay: (cell: 0.000 0.000%,
                     route: 0.805 100.000%)
Arrival Data Path Delay: (cell: 0.000 0.000%,
                    route: 0.210 61.804%,
                    tC2Q: 0.130 38.196%)
Required Clock Path Delay: (cell: 0.000 0.000%,
                     route: 0.810 100.000%)

						Path13
Path Summary:
Slack             : 0.383
Data Arrival Time : 3.013
Data Required Time: 2.630
From              : camera/sys_reset/release_pipe_2_s0
To                : camera/config_camera/bus/dly_cnt_15_s1
Launch Clk        : control50:[R]
Latch Clk         : control50:[R]

Data Arrival Path:
   AT     DELAY   TYPE   RF   FANOUT        LOC                            NODE
 ======= ======= ====== ==== ======== =============== ==============================================
  0.000   0.000                                        active clock edge time
  0.000   0.000                                        control50
  1.869   1.869   tCL    RR   219      PLL_B[2]        camera/pll/PLL_inst/CLKOUT0
  2.674   0.805   tNET   RR   1        R78C130[2][A]   camera/sys_reset/release_pipe_2_s0/CLK
  2.804   0.130   tC2Q   RR   175      R78C130[2][A]   camera/sys_reset/release_pipe_2_s0/Q
  3.013   0.210   tNET   RR   1        R78C131[2][B]   camera/config_camera/bus/dly_cnt_15_s1/CLEAR

Data Required Path:
   AT     DELAY    TYPE   RF   FANOUT        LOC                           NODE
 ======= ======== ====== ==== ======== =============== ============================================
  0.000   0.000                                         active clock edge time
  0.000   0.000                                         control50
  1.869   1.869    tCL    RR   219      PLL_B[2]        camera/pll/PLL_inst/CLKOUT0
  2.678   0.809    tNET   RR   1        R78C131[2][B]   camera/config_camera/bus/dly_cnt_15_s1/CLK
  2.630   -0.048   tHld        1        R78C131[2][B]   camera/config_camera/bus/dly_cnt_15_s1

Path Statistics:
Clock Skew: 0.004
Hold Relationship: 0.000
Logic Level: 1
Arrival Clock Path delay: (cell: 0.000 0.000%,
                     route: 0.805 100.000%)
Arrival Data Path Delay: (cell: 0.000 0.000%,
                    route: 0.210 61.804%,
                    tC2Q: 0.130 38.196%)
Required Clock Path Delay: (cell: 0.000 0.000%,
                     route: 0.809 100.000%)

						Path14
Path Summary:
Slack             : 0.383
Data Arrival Time : 3.013
Data Required Time: 2.630
From              : camera/sys_reset/release_pipe_2_s0
To                : camera/config_camera/bus/dly_cnt_16_s1
Launch Clk        : control50:[R]
Latch Clk         : control50:[R]

Data Arrival Path:
   AT     DELAY   TYPE   RF   FANOUT        LOC                            NODE
 ======= ======= ====== ==== ======== =============== ==============================================
  0.000   0.000                                        active clock edge time
  0.000   0.000                                        control50
  1.869   1.869   tCL    RR   219      PLL_B[2]        camera/pll/PLL_inst/CLKOUT0
  2.674   0.805   tNET   RR   1        R78C130[2][A]   camera/sys_reset/release_pipe_2_s0/CLK
  2.804   0.130   tC2Q   RR   175      R78C130[2][A]   camera/sys_reset/release_pipe_2_s0/Q
  3.013   0.210   tNET   RR   1        R78C131[0][A]   camera/config_camera/bus/dly_cnt_16_s1/CLEAR

Data Required Path:
   AT     DELAY    TYPE   RF   FANOUT        LOC                           NODE
 ======= ======== ====== ==== ======== =============== ============================================
  0.000   0.000                                         active clock edge time
  0.000   0.000                                         control50
  1.869   1.869    tCL    RR   219      PLL_B[2]        camera/pll/PLL_inst/CLKOUT0
  2.678   0.809    tNET   RR   1        R78C131[0][A]   camera/config_camera/bus/dly_cnt_16_s1/CLK
  2.630   -0.048   tHld        1        R78C131[0][A]   camera/config_camera/bus/dly_cnt_16_s1

Path Statistics:
Clock Skew: 0.004
Hold Relationship: 0.000
Logic Level: 1
Arrival Clock Path delay: (cell: 0.000 0.000%,
                     route: 0.805 100.000%)
Arrival Data Path Delay: (cell: 0.000 0.000%,
                    route: 0.210 61.804%,
                    tC2Q: 0.130 38.196%)
Required Clock Path Delay: (cell: 0.000 0.000%,
                     route: 0.809 100.000%)

						Path15
Path Summary:
Slack             : 0.383
Data Arrival Time : 3.013
Data Required Time: 2.630
From              : camera/sys_reset/release_pipe_2_s0
To                : camera/config_camera/bus/dly_cnt_17_s1
Launch Clk        : control50:[R]
Latch Clk         : control50:[R]

Data Arrival Path:
   AT     DELAY   TYPE   RF   FANOUT        LOC                            NODE
 ======= ======= ====== ==== ======== =============== ==============================================
  0.000   0.000                                        active clock edge time
  0.000   0.000                                        control50
  1.869   1.869   tCL    RR   219      PLL_B[2]        camera/pll/PLL_inst/CLKOUT0
  2.674   0.805   tNET   RR   1        R78C130[2][A]   camera/sys_reset/release_pipe_2_s0/CLK
  2.804   0.130   tC2Q   RR   175      R78C130[2][A]   camera/sys_reset/release_pipe_2_s0/Q
  3.013   0.210   tNET   RR   1        R78C131[0][B]   camera/config_camera/bus/dly_cnt_17_s1/CLEAR

Data Required Path:
   AT     DELAY    TYPE   RF   FANOUT        LOC                           NODE
 ======= ======== ====== ==== ======== =============== ============================================
  0.000   0.000                                         active clock edge time
  0.000   0.000                                         control50
  1.869   1.869    tCL    RR   219      PLL_B[2]        camera/pll/PLL_inst/CLKOUT0
  2.678   0.809    tNET   RR   1        R78C131[0][B]   camera/config_camera/bus/dly_cnt_17_s1/CLK
  2.630   -0.048   tHld        1        R78C131[0][B]   camera/config_camera/bus/dly_cnt_17_s1

Path Statistics:
Clock Skew: 0.004
Hold Relationship: 0.000
Logic Level: 1
Arrival Clock Path delay: (cell: 0.000 0.000%,
                     route: 0.805 100.000%)
Arrival Data Path Delay: (cell: 0.000 0.000%,
                    route: 0.210 61.804%,
                    tC2Q: 0.130 38.196%)
Required Clock Path Delay: (cell: 0.000 0.000%,
                     route: 0.809 100.000%)

						Path16
Path Summary:
Slack             : 0.385
Data Arrival Time : 2.244
Data Required Time: 1.859
From              : camera/runtime_network.receive_reset/release_pipe_2_s1
To                : camera/runtime_network.net/write_mask_23_s0
Launch Clk        : eth_rx125:[R]
Latch Clk         : eth_rx125:[R]

Data Arrival Path:
   AT     DELAY   TYPE   RF   FANOUT        LOC                                   NODE
 ======= ======= ====== ==== ======== =============== ============================================================
  0.000   0.000                                        active clock edge time
  0.000   0.000                                        eth_rx125
  0.000   0.000   tCL    RR   1        IOB122[A]       rgmii_rxc_ibuf/I
  0.608   0.608   tINS   RR   850      IOB122[A]       rgmii_rxc_ibuf/O
  1.902   1.294   tNET   RR   1        R49C101[1][A]   camera/runtime_network.receive_reset/release_pipe_2_s1/CLK
  2.032   0.130   tC2Q   RR   211      R49C101[1][A]   camera/runtime_network.receive_reset/release_pipe_2_s1/Q
  2.244   0.212   tNET   RR   1        R47C101[0][B]   camera/runtime_network.net/write_mask_23_s0/CLEAR

Data Required Path:
   AT     DELAY    TYPE   RF   FANOUT        LOC                             NODE
 ======= ======== ====== ==== ======== =============== =================================================
  0.000   0.000                                         active clock edge time
  0.000   0.000                                         eth_rx125
  0.000   0.000    tCL    RR   1        IOB122[A]       rgmii_rxc_ibuf/I
  0.608   0.608    tINS   RR   850      IOB122[A]       rgmii_rxc_ibuf/O
  1.907   1.299    tNET   RR   1        R47C101[0][B]   camera/runtime_network.net/write_mask_23_s0/CLK
  1.859   -0.048   tHld        1        R47C101[0][B]   camera/runtime_network.net/write_mask_23_s0

Path Statistics:
Clock Skew: 0.005
Hold Relationship: 0.000
Logic Level: 1
Arrival Clock Path delay: (cell: 0.608 31.961%,
                     route: 1.294 68.039%)
Arrival Data Path Delay: (cell: 0.000 0.000%,
                    route: 0.212 62.105%,
                    tC2Q: 0.130 37.895%)
Required Clock Path Delay: (cell: 0.608 31.886%,
                     route: 1.299 68.114%)

						Path17
Path Summary:
Slack             : 0.385
Data Arrival Time : 2.244
Data Required Time: 1.859
From              : camera/runtime_network.receive_reset/release_pipe_2_s1
To                : camera/runtime_network.net/write_mask_27_s0
Launch Clk        : eth_rx125:[R]
Latch Clk         : eth_rx125:[R]

Data Arrival Path:
   AT     DELAY   TYPE   RF   FANOUT        LOC                                   NODE
 ======= ======= ====== ==== ======== =============== ============================================================
  0.000   0.000                                        active clock edge time
  0.000   0.000                                        eth_rx125
  0.000   0.000   tCL    RR   1        IOB122[A]       rgmii_rxc_ibuf/I
  0.608   0.608   tINS   RR   850      IOB122[A]       rgmii_rxc_ibuf/O
  1.902   1.294   tNET   RR   1        R49C101[1][A]   camera/runtime_network.receive_reset/release_pipe_2_s1/CLK
  2.032   0.130   tC2Q   RR   211      R49C101[1][A]   camera/runtime_network.receive_reset/release_pipe_2_s1/Q
  2.244   0.212   tNET   RR   1        R47C101[0][A]   camera/runtime_network.net/write_mask_27_s0/CLEAR

Data Required Path:
   AT     DELAY    TYPE   RF   FANOUT        LOC                             NODE
 ======= ======== ====== ==== ======== =============== =================================================
  0.000   0.000                                         active clock edge time
  0.000   0.000                                         eth_rx125
  0.000   0.000    tCL    RR   1        IOB122[A]       rgmii_rxc_ibuf/I
  0.608   0.608    tINS   RR   850      IOB122[A]       rgmii_rxc_ibuf/O
  1.907   1.299    tNET   RR   1        R47C101[0][A]   camera/runtime_network.net/write_mask_27_s0/CLK
  1.859   -0.048   tHld        1        R47C101[0][A]   camera/runtime_network.net/write_mask_27_s0

Path Statistics:
Clock Skew: 0.005
Hold Relationship: 0.000
Logic Level: 1
Arrival Clock Path delay: (cell: 0.608 31.961%,
                     route: 1.294 68.039%)
Arrival Data Path Delay: (cell: 0.000 0.000%,
                    route: 0.212 62.105%,
                    tC2Q: 0.130 37.895%)
Required Clock Path Delay: (cell: 0.608 31.886%,
                     route: 1.299 68.114%)

						Path18
Path Summary:
Slack             : 0.385
Data Arrival Time : 2.244
Data Required Time: 1.859
From              : camera/runtime_network.receive_reset/release_pipe_2_s1
To                : camera/runtime_network.net/write_mask_65_s0
Launch Clk        : eth_rx125:[R]
Latch Clk         : eth_rx125:[R]

Data Arrival Path:
   AT     DELAY   TYPE   RF   FANOUT        LOC                                   NODE
 ======= ======= ====== ==== ======== =============== ============================================================
  0.000   0.000                                        active clock edge time
  0.000   0.000                                        eth_rx125
  0.000   0.000   tCL    RR   1        IOB122[A]       rgmii_rxc_ibuf/I
  0.608   0.608   tINS   RR   850      IOB122[A]       rgmii_rxc_ibuf/O
  1.902   1.294   tNET   RR   1        R49C101[1][A]   camera/runtime_network.receive_reset/release_pipe_2_s1/CLK
  2.032   0.130   tC2Q   RR   211      R49C101[1][A]   camera/runtime_network.receive_reset/release_pipe_2_s1/Q
  2.244   0.212   tNET   RR   1        R47C101[1][B]   camera/runtime_network.net/write_mask_65_s0/CLEAR

Data Required Path:
   AT     DELAY    TYPE   RF   FANOUT        LOC                             NODE
 ======= ======== ====== ==== ======== =============== =================================================
  0.000   0.000                                         active clock edge time
  0.000   0.000                                         eth_rx125
  0.000   0.000    tCL    RR   1        IOB122[A]       rgmii_rxc_ibuf/I
  0.608   0.608    tINS   RR   850      IOB122[A]       rgmii_rxc_ibuf/O
  1.907   1.299    tNET   RR   1        R47C101[1][B]   camera/runtime_network.net/write_mask_65_s0/CLK
  1.859   -0.048   tHld        1        R47C101[1][B]   camera/runtime_network.net/write_mask_65_s0

Path Statistics:
Clock Skew: 0.005
Hold Relationship: 0.000
Logic Level: 1
Arrival Clock Path delay: (cell: 0.608 31.961%,
                     route: 1.294 68.039%)
Arrival Data Path Delay: (cell: 0.000 0.000%,
                    route: 0.212 62.105%,
                    tC2Q: 0.130 37.895%)
Required Clock Path Delay: (cell: 0.608 31.886%,
                     route: 1.299 68.114%)

						Path19
Path Summary:
Slack             : 0.385
Data Arrival Time : 2.244
Data Required Time: 1.859
From              : camera/runtime_network.receive_reset/release_pipe_2_s1
To                : camera/runtime_network.net/write_mask_76_s0
Launch Clk        : eth_rx125:[R]
Latch Clk         : eth_rx125:[R]

Data Arrival Path:
   AT     DELAY   TYPE   RF   FANOUT        LOC                                   NODE
 ======= ======= ====== ==== ======== =============== ============================================================
  0.000   0.000                                        active clock edge time
  0.000   0.000                                        eth_rx125
  0.000   0.000   tCL    RR   1        IOB122[A]       rgmii_rxc_ibuf/I
  0.608   0.608   tINS   RR   850      IOB122[A]       rgmii_rxc_ibuf/O
  1.902   1.294   tNET   RR   1        R49C101[1][A]   camera/runtime_network.receive_reset/release_pipe_2_s1/CLK
  2.032   0.130   tC2Q   RR   211      R49C101[1][A]   camera/runtime_network.receive_reset/release_pipe_2_s1/Q
  2.244   0.212   tNET   RR   1        R47C101[3][A]   camera/runtime_network.net/write_mask_76_s0/CLEAR

Data Required Path:
   AT     DELAY    TYPE   RF   FANOUT        LOC                             NODE
 ======= ======== ====== ==== ======== =============== =================================================
  0.000   0.000                                         active clock edge time
  0.000   0.000                                         eth_rx125
  0.000   0.000    tCL    RR   1        IOB122[A]       rgmii_rxc_ibuf/I
  0.608   0.608    tINS   RR   850      IOB122[A]       rgmii_rxc_ibuf/O
  1.907   1.299    tNET   RR   1        R47C101[3][A]   camera/runtime_network.net/write_mask_76_s0/CLK
  1.859   -0.048   tHld        1        R47C101[3][A]   camera/runtime_network.net/write_mask_76_s0

Path Statistics:
Clock Skew: 0.005
Hold Relationship: 0.000
Logic Level: 1
Arrival Clock Path delay: (cell: 0.608 31.961%,
                     route: 1.294 68.039%)
Arrival Data Path Delay: (cell: 0.000 0.000%,
                    route: 0.212 62.105%,
                    tC2Q: 0.130 37.895%)
Required Clock Path Delay: (cell: 0.608 31.886%,
                     route: 1.299 68.114%)

						Path20
Path Summary:
Slack             : 0.385
Data Arrival Time : 2.244
Data Required Time: 1.859
From              : camera/runtime_network.receive_reset/release_pipe_2_s1
To                : camera/runtime_network.net/write_mask_77_s0
Launch Clk        : eth_rx125:[R]
Latch Clk         : eth_rx125:[R]

Data Arrival Path:
   AT     DELAY   TYPE   RF   FANOUT        LOC                                   NODE
 ======= ======= ====== ==== ======== =============== ============================================================
  0.000   0.000                                        active clock edge time
  0.000   0.000                                        eth_rx125
  0.000   0.000   tCL    RR   1        IOB122[A]       rgmii_rxc_ibuf/I
  0.608   0.608   tINS   RR   850      IOB122[A]       rgmii_rxc_ibuf/O
  1.902   1.294   tNET   RR   1        R49C101[1][A]   camera/runtime_network.receive_reset/release_pipe_2_s1/CLK
  2.032   0.130   tC2Q   RR   211      R49C101[1][A]   camera/runtime_network.receive_reset/release_pipe_2_s1/Q
  2.244   0.212   tNET   RR   1        R47C101[2][A]   camera/runtime_network.net/write_mask_77_s0/CLEAR

Data Required Path:
   AT     DELAY    TYPE   RF   FANOUT        LOC                             NODE
 ======= ======== ====== ==== ======== =============== =================================================
  0.000   0.000                                         active clock edge time
  0.000   0.000                                         eth_rx125
  0.000   0.000    tCL    RR   1        IOB122[A]       rgmii_rxc_ibuf/I
  0.608   0.608    tINS   RR   850      IOB122[A]       rgmii_rxc_ibuf/O
  1.907   1.299    tNET   RR   1        R47C101[2][A]   camera/runtime_network.net/write_mask_77_s0/CLK
  1.859   -0.048   tHld        1        R47C101[2][A]   camera/runtime_network.net/write_mask_77_s0

Path Statistics:
Clock Skew: 0.005
Hold Relationship: 0.000
Logic Level: 1
Arrival Clock Path delay: (cell: 0.608 31.961%,
                     route: 1.294 68.039%)
Arrival Data Path Delay: (cell: 0.000 0.000%,
                    route: 0.212 62.105%,
                    tC2Q: 0.130 37.895%)
Required Clock Path Delay: (cell: 0.608 31.886%,
                     route: 1.299 68.114%)

						Path21
Path Summary:
Slack             : 0.385
Data Arrival Time : 2.244
Data Required Time: 1.859
From              : camera/runtime_network.receive_reset/release_pipe_2_s1
To                : camera/runtime_network.net/write_mask_78_s0
Launch Clk        : eth_rx125:[R]
Latch Clk         : eth_rx125:[R]

Data Arrival Path:
   AT     DELAY   TYPE   RF   FANOUT        LOC                                   NODE
 ======= ======= ====== ==== ======== =============== ============================================================
  0.000   0.000                                        active clock edge time
  0.000   0.000                                        eth_rx125
  0.000   0.000   tCL    RR   1        IOB122[A]       rgmii_rxc_ibuf/I
  0.608   0.608   tINS   RR   850      IOB122[A]       rgmii_rxc_ibuf/O
  1.902   1.294   tNET   RR   1        R49C101[1][A]   camera/runtime_network.receive_reset/release_pipe_2_s1/CLK
  2.032   0.130   tC2Q   RR   211      R49C101[1][A]   camera/runtime_network.receive_reset/release_pipe_2_s1/Q
  2.244   0.212   tNET   RR   1        R47C101[2][B]   camera/runtime_network.net/write_mask_78_s0/CLEAR

Data Required Path:
   AT     DELAY    TYPE   RF   FANOUT        LOC                             NODE
 ======= ======== ====== ==== ======== =============== =================================================
  0.000   0.000                                         active clock edge time
  0.000   0.000                                         eth_rx125
  0.000   0.000    tCL    RR   1        IOB122[A]       rgmii_rxc_ibuf/I
  0.608   0.608    tINS   RR   850      IOB122[A]       rgmii_rxc_ibuf/O
  1.907   1.299    tNET   RR   1        R47C101[2][B]   camera/runtime_network.net/write_mask_78_s0/CLK
  1.859   -0.048   tHld        1        R47C101[2][B]   camera/runtime_network.net/write_mask_78_s0

Path Statistics:
Clock Skew: 0.005
Hold Relationship: 0.000
Logic Level: 1
Arrival Clock Path delay: (cell: 0.608 31.961%,
                     route: 1.294 68.039%)
Arrival Data Path Delay: (cell: 0.000 0.000%,
                    route: 0.212 62.105%,
                    tC2Q: 0.130 37.895%)
Required Clock Path Delay: (cell: 0.608 31.886%,
                     route: 1.299 68.114%)

						Path22
Path Summary:
Slack             : 0.387
Data Arrival Time : 3.013
Data Required Time: 2.626
From              : camera/sys_reset/release_pipe_2_s0
To                : camera/config_camera/bus/dly_cnt_12_s1
Launch Clk        : control50:[R]
Latch Clk         : control50:[R]

Data Arrival Path:
   AT     DELAY   TYPE   RF   FANOUT        LOC                            NODE
 ======= ======= ====== ==== ======== =============== ==============================================
  0.000   0.000                                        active clock edge time
  0.000   0.000                                        control50
  1.869   1.869   tCL    RR   219      PLL_B[2]        camera/pll/PLL_inst/CLKOUT0
  2.674   0.805   tNET   RR   1        R78C130[2][A]   camera/sys_reset/release_pipe_2_s0/CLK
  2.804   0.130   tC2Q   RR   175      R78C130[2][A]   camera/sys_reset/release_pipe_2_s0/Q
  3.013   0.210   tNET   RR   1        R78C132[2][B]   camera/config_camera/bus/dly_cnt_12_s1/CLEAR

Data Required Path:
   AT     DELAY    TYPE   RF   FANOUT        LOC                           NODE
 ======= ======== ====== ==== ======== =============== ============================================
  0.000   0.000                                         active clock edge time
  0.000   0.000                                         control50
  1.869   1.869    tCL    RR   219      PLL_B[2]        camera/pll/PLL_inst/CLKOUT0
  2.674   0.805    tNET   RR   1        R78C132[2][B]   camera/config_camera/bus/dly_cnt_12_s1/CLK
  2.626   -0.048   tHld        1        R78C132[2][B]   camera/config_camera/bus/dly_cnt_12_s1

Path Statistics:
Clock Skew: 0.000
Hold Relationship: 0.000
Logic Level: 1
Arrival Clock Path delay: (cell: 0.000 0.000%,
                     route: 0.805 100.000%)
Arrival Data Path Delay: (cell: 0.000 0.000%,
                    route: 0.210 61.804%,
                    tC2Q: 0.130 38.196%)
Required Clock Path Delay: (cell: 0.000 0.000%,
                     route: 0.805 100.000%)

						Path23
Path Summary:
Slack             : 0.387
Data Arrival Time : 3.013
Data Required Time: 2.626
From              : camera/sys_reset/release_pipe_2_s0
To                : camera/config_camera/bus/dly_cnt_13_s1
Launch Clk        : control50:[R]
Latch Clk         : control50:[R]

Data Arrival Path:
   AT     DELAY   TYPE   RF   FANOUT        LOC                            NODE
 ======= ======= ====== ==== ======== =============== ==============================================
  0.000   0.000                                        active clock edge time
  0.000   0.000                                        control50
  1.869   1.869   tCL    RR   219      PLL_B[2]        camera/pll/PLL_inst/CLKOUT0
  2.674   0.805   tNET   RR   1        R78C130[2][A]   camera/sys_reset/release_pipe_2_s0/CLK
  2.804   0.130   tC2Q   RR   175      R78C130[2][A]   camera/sys_reset/release_pipe_2_s0/Q
  3.013   0.210   tNET   RR   1        R78C132[2][A]   camera/config_camera/bus/dly_cnt_13_s1/CLEAR

Data Required Path:
   AT     DELAY    TYPE   RF   FANOUT        LOC                           NODE
 ======= ======== ====== ==== ======== =============== ============================================
  0.000   0.000                                         active clock edge time
  0.000   0.000                                         control50
  1.869   1.869    tCL    RR   219      PLL_B[2]        camera/pll/PLL_inst/CLKOUT0
  2.674   0.805    tNET   RR   1        R78C132[2][A]   camera/config_camera/bus/dly_cnt_13_s1/CLK
  2.626   -0.048   tHld        1        R78C132[2][A]   camera/config_camera/bus/dly_cnt_13_s1

Path Statistics:
Clock Skew: 0.000
Hold Relationship: 0.000
Logic Level: 1
Arrival Clock Path delay: (cell: 0.000 0.000%,
                     route: 0.805 100.000%)
Arrival Data Path Delay: (cell: 0.000 0.000%,
                    route: 0.210 61.804%,
                    tC2Q: 0.130 38.196%)
Required Clock Path Delay: (cell: 0.000 0.000%,
                     route: 0.805 100.000%)

						Path24
Path Summary:
Slack             : 0.387
Data Arrival Time : 3.013
Data Required Time: 2.626
From              : camera/sys_reset/release_pipe_2_s0
To                : camera/config_camera/bus/dly_cnt_14_s1
Launch Clk        : control50:[R]
Latch Clk         : control50:[R]

Data Arrival Path:
   AT     DELAY   TYPE   RF   FANOUT        LOC                            NODE
 ======= ======= ====== ==== ======== =============== ==============================================
  0.000   0.000                                        active clock edge time
  0.000   0.000                                        control50
  1.869   1.869   tCL    RR   219      PLL_B[2]        camera/pll/PLL_inst/CLKOUT0
  2.674   0.805   tNET   RR   1        R78C130[2][A]   camera/sys_reset/release_pipe_2_s0/CLK
  2.804   0.130   tC2Q   RR   175      R78C130[2][A]   camera/sys_reset/release_pipe_2_s0/Q
  3.013   0.210   tNET   RR   1        R78C132[1][A]   camera/config_camera/bus/dly_cnt_14_s1/CLEAR

Data Required Path:
   AT     DELAY    TYPE   RF   FANOUT        LOC                           NODE
 ======= ======== ====== ==== ======== =============== ============================================
  0.000   0.000                                         active clock edge time
  0.000   0.000                                         control50
  1.869   1.869    tCL    RR   219      PLL_B[2]        camera/pll/PLL_inst/CLKOUT0
  2.674   0.805    tNET   RR   1        R78C132[1][A]   camera/config_camera/bus/dly_cnt_14_s1/CLK
  2.626   -0.048   tHld        1        R78C132[1][A]   camera/config_camera/bus/dly_cnt_14_s1

Path Statistics:
Clock Skew: 0.000
Hold Relationship: 0.000
Logic Level: 1
Arrival Clock Path delay: (cell: 0.000 0.000%,
                     route: 0.805 100.000%)
Arrival Data Path Delay: (cell: 0.000 0.000%,
                    route: 0.210 61.804%,
                    tC2Q: 0.130 38.196%)
Required Clock Path Delay: (cell: 0.000 0.000%,
                     route: 0.805 100.000%)

						Path25
Path Summary:
Slack             : 0.387
Data Arrival Time : 3.013
Data Required Time: 2.626
From              : camera/sys_reset/release_pipe_2_s0
To                : camera/config_camera/bus/state.IDLE_s0
Launch Clk        : control50:[R]
Latch Clk         : control50:[R]

Data Arrival Path:
   AT     DELAY   TYPE   RF   FANOUT        LOC                            NODE
 ======= ======= ====== ==== ======== =============== ===============================================
  0.000   0.000                                        active clock edge time
  0.000   0.000                                        control50
  1.869   1.869   tCL    RR   219      PLL_B[2]        camera/pll/PLL_inst/CLKOUT0
  2.674   0.805   tNET   RR   1        R78C130[2][A]   camera/sys_reset/release_pipe_2_s0/CLK
  2.804   0.130   tC2Q   RR   175      R78C130[2][A]   camera/sys_reset/release_pipe_2_s0/Q
  3.013   0.210   tNET   RR   1        R78C132[0][A]   camera/config_camera/bus/state.IDLE_s0/PRESET

Data Required Path:
   AT     DELAY    TYPE   RF   FANOUT        LOC                           NODE
 ======= ======== ====== ==== ======== =============== ============================================
  0.000   0.000                                         active clock edge time
  0.000   0.000                                         control50
  1.869   1.869    tCL    RR   219      PLL_B[2]        camera/pll/PLL_inst/CLKOUT0
  2.674   0.805    tNET   RR   1        R78C132[0][A]   camera/config_camera/bus/state.IDLE_s0/CLK
  2.626   -0.048   tHld        1        R78C132[0][A]   camera/config_camera/bus/state.IDLE_s0

Path Statistics:
Clock Skew: 0.000
Hold Relationship: 0.000
Logic Level: 1
Arrival Clock Path delay: (cell: 0.000 0.000%,
                     route: 0.805 100.000%)
Arrival Data Path Delay: (cell: 0.000 0.000%,
                    route: 0.210 61.804%,
                    tC2Q: 0.130 38.196%)
Required Clock Path Delay: (cell: 0.000 0.000%,
                     route: 0.805 100.000%)

3.4 Minimum Pulse Width Report
Report Command:report_min_pulse_width -nworst 10 -detail

								MPW1
MPW Summary:
Slack:          -0.688
Actual Width:   0.212
Required Width: 0.900
Type:           High Pulse Width
Clock:          eth125
Objects:        camera/stream/ram_ram_0_1_s

Late clock Path:
   AT     DELAY   TYPE   RF                 NODE
 ======= ======= ====== ==== ==================================
  0.000   0.000               active clock edge time
  0.000   0.000               eth125
  3.835   3.835   tCL    RR   camera/pll/PLL_inst/CLKOUT1
  7.176   3.341   tNET   RR   camera/stream/ram_ram_0_1_s/CLKB

Early clock Path:
   AT     DELAY   TYPE   RF                 NODE
 ======= ======= ====== ==== ==================================
  4.000   0.000               active clock edge time
  4.000   0.000               eth125
  5.869   1.869   tCL    FF   camera/pll/PLL_inst/CLKOUT1
  7.388   1.519   tNET   FF   camera/stream/ram_ram_0_1_s/CLKB

								MPW2
MPW Summary:
Slack:          -0.688
Actual Width:   0.212
Required Width: 0.900
Type:           High Pulse Width
Clock:          eth125
Objects:        camera/stream/ram_ram_2_15_s

Late clock Path:
   AT     DELAY   TYPE   RF                 NODE
 ======= ======= ====== ==== ===================================
  0.000   0.000               active clock edge time
  0.000   0.000               eth125
  3.835   3.835   tCL    RR   camera/pll/PLL_inst/CLKOUT1
  7.176   3.341   tNET   RR   camera/stream/ram_ram_2_15_s/CLKB

Early clock Path:
   AT     DELAY   TYPE   RF                 NODE
 ======= ======= ====== ==== ===================================
  4.000   0.000               active clock edge time
  4.000   0.000               eth125
  5.869   1.869   tCL    FF   camera/pll/PLL_inst/CLKOUT1
  7.388   1.519   tNET   FF   camera/stream/ram_ram_2_15_s/CLKB

								MPW3
MPW Summary:
Slack:          -0.688
Actual Width:   0.212
Required Width: 0.900
Type:           High Pulse Width
Clock:          eth125
Objects:        camera/stream/ram_ram_3_7_s

Late clock Path:
   AT     DELAY   TYPE   RF                 NODE
 ======= ======= ====== ==== ==================================
  0.000   0.000               active clock edge time
  0.000   0.000               eth125
  3.835   3.835   tCL    RR   camera/pll/PLL_inst/CLKOUT1
  7.176   3.341   tNET   RR   camera/stream/ram_ram_3_7_s/CLKB

Early clock Path:
   AT     DELAY   TYPE   RF                 NODE
 ======= ======= ====== ==== ==================================
  4.000   0.000               active clock edge time
  4.000   0.000               eth125
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
 ======= ======= ====== ==== ===================================
  4.000   0.000               active clock edge time
  4.000   0.000               eth125
  5.869   1.869   tCL    FF   camera/pll/PLL_inst/CLKOUT1
  7.388   1.519   tNET   FF   camera/stream/ram_ram_6_10_s/CLKB

								MPW9
MPW Summary:
Slack:          -0.688
Actual Width:   0.212
Required Width: 0.900
Type:           High Pulse Width
Clock:          eth125
Objects:        camera/stream/line_ram_line_ram_0_0_s

Late clock Path:
   AT     DELAY   TYPE   RF                      NODE
 ======= ======= ====== ==== ============================================
  0.000   0.000               active clock edge time
  0.000   0.000               eth125
  3.835   3.835   tCL    RR   camera/pll/PLL_inst/CLKOUT1
  7.176   3.341   tNET   RR   camera/stream/line_ram_line_ram_0_0_s/CLKA

Early clock Path:
   AT     DELAY   TYPE   RF                      NODE
 ======= ======= ====== ==== ============================================
  4.000   0.000               active clock edge time
  4.000   0.000               eth125
  5.869   1.869   tCL    FF   camera/pll/PLL_inst/CLKOUT1
  7.388   1.519   tNET   FF   camera/stream/line_ram_line_ram_0_0_s/CLKA

								MPW10
MPW Summary:
Slack:          -0.688
Actual Width:   0.212
Required Width: 0.900
Type:           High Pulse Width
Clock:          eth125
Objects:        camera/stream/ram_ram_0_14_s

Late clock Path:
   AT     DELAY   TYPE   RF                 NODE
 ======= ======= ====== ==== ===================================
  0.000   0.000               active clock edge time
  0.000   0.000               eth125
  3.835   3.835   tCL    RR   camera/pll/PLL_inst/CLKOUT1
  7.176   3.341   tNET   RR   camera/stream/ram_ram_0_14_s/CLKB

Early clock Path:
   AT     DELAY   TYPE   RF                 NODE
 ======= ======= ====== ==== ===================================
  4.000   0.000               active clock edge time
  4.000   0.000               eth125
  5.869   1.869   tCL    FF   camera/pll/PLL_inst/CLKOUT1
  7.388   1.519   tNET   FF   camera/stream/ram_ram_0_14_s/CLKB

3.5 High Fanout Nets Report
Report Command:report_high_fanout_nets -max_nets 10
  FANOUT                  NET NAME                   WORST SLACK   MAX DELAY
 ======== ========================================= ============= ===========
  5833     clk50m_d                                  6.358         3.328
  5101     camera_pclk_d                             0.026         4.861
  4971     camera/clk125                             0.038         3.380
  4839     led_d[0]                                  6.358         4.001
  3876     camera/cap_rst_n                          1.685         4.654
  915      core/n394_5                               6.358         6.548
  850      rgmii_rxc_d                               2.982         3.586
  375      sender/active_383_11                      15.090        2.901
  368      camera/runtime_network.net/arp_crc_31_7   0.598         3.895
  359      telemetry/crc/n1714_5                     12.270        4.072

3.6 Route Congestions Report
Report Command:report_route_congestion -max_grids 10
  GRID LOC   ROUTE CONGESTIONS
 ========== ===================
  R66C79     0.903
  R47C34     0.806
  R48C34     0.792
  R47C35     0.778
  R52C77     0.764
  R54C71     0.764
  R42C34     0.764
  R45C53     0.764
  R61C96     0.764
  R53C73     0.750

3.7 Timing Exceptions Report
3.7.1 Setup Analysis Report
Report Command:report_exceptions -setup -max_paths 5 -max_common_paths 1
No timing exceptions to report!

3.7.2 Hold Analysis Report
Report Command:report_exceptions -hold -max_paths 5 -max_common_paths 1
No timing exceptions to report!

3.7.3 Recovery Analysis Report
Report Command:report_exceptions -recovery -max_paths 5 -max_common_paths 1
No timing exceptions to report!

3.7.4 Removal Analysis Report
Report Command:report_exceptions -removal -max_paths 5 -max_common_paths 1
No timing exceptions to report!

3.8 Timing Constraints Report
   SDC Command Type     State                                                        Detail Command
 ==================== ========= =========================================================================================================================
  TC_CLOCK             Actived   create_clock -name sys50 -period 20 [get_ports {clk50m}]
  TC_CLOCK             Actived   create_clock -name cam_pclk -period 11.9047 [get_ports {camera_pclk}]
  TC_CLOCK             Actived   create_clock -name eth_rx125 -period 8 [get_ports {rgmii_rxc}]
  TC_GENERATED_CLOCK   Actived   create_generated_clock -name control50 -source [get_ports {clk50m}] -divide_by 1 [get_nets {camera/clk50}]
  TC_GENERATED_CLOCK   Actived   create_generated_clock -name eth125 -source [get_ports {clk50m}] -multiply_by 5 -divide_by 2 [get_nets {camera/clk125}]
  TC_INPUT_DELAY       Actived   set_input_delay -clock cam_pclk -clock_fall -max 2.0 [get_ports {camera_data[*] camera_href camera_vsync}]
  TC_INPUT_DELAY       Actived   set_input_delay -clock cam_pclk -clock_fall -min 0.0 [get_ports {camera_data[*] camera_href camera_vsync}]
  TC_INPUT_DELAY       Actived   set_input_delay -clock eth_rx125 -max 2.2 [get_ports {rgmii_rxd[*] rgmii_rxctl}]
  TC_INPUT_DELAY       Actived   set_input_delay -clock eth_rx125 -min 1.8 [get_ports {rgmii_rxd[*] rgmii_rxctl}]
  TC_INPUT_DELAY       Actived   set_input_delay -clock eth_rx125 -clock_fall -add_delay -max 2.2 [get_ports {rgmii_rxd[*] rgmii_rxctl}]
  TC_INPUT_DELAY       Actived   set_input_delay -clock eth_rx125 -clock_fall -add_delay -min 1.8 [get_ports {rgmii_rxd[*] rgmii_rxctl}]
  TC_FALSE_PATH        Actived   set_false_path -from [get_ports {reset_n}]
  TC_FALSE_PATH        Actived   set_false_path -to [get_pins {camera/perception_reset/release_pipe*/CLEAR}]
  TC_FALSE_PATH        Actived   set_false_path -to [get_pins {camera/runtime_network.network_reset/release_pipe*/CLEAR}]
  TC_FALSE_PATH        Actived   set_false_path -to [get_pins {camera/runtime_network.receive_reset/release_pipe*/CLEAR}]
  TC_FALSE_PATH        Actived   set_false_path -to [get_pins {imu/reader/bus/scl_sync_0_s0/D}]
  TC_FALSE_PATH        Actived   set_false_path -to [get_pins {imu/reader/bus/sda_sync_0_s0/D}]
  TC_FALSE_PATH        Actived   set_false_path -to [get_pins {rx/rx_meta_s0/D}]
  TC_FALSE_PATH        Actived   set_false_path -to [get_pins {core/enc_l/ab_meta_0_s0/D}]
  TC_FALSE_PATH        Actived   set_false_path -to [get_pins {core/enc_l/ab_meta_1_s0/D}]
  TC_FALSE_PATH        Actived   set_false_path -to [get_pins {core/enc_r/ab_meta_0_s0/D}]
  TC_FALSE_PATH        Actived   set_false_path -to [get_pins {core/enc_r/ab_meta_1_s0/D}]
  TC_CLOCK_GROUP       Actived   set_clock_groups -asynchronous -group [get_clocks {cam_pclk}] -group [get_clocks {sys50 control50 eth125}]
  TC_CLOCK_GROUP       Actived   set_clock_groups -asynchronous -group [get_clocks {eth_rx125}] -group [get_clocks {sys50 control50 eth125 cam_pclk}]
