LilywantbecomeNIUBI/fpga-system-integration/docs/LIDAR_CONNECTION_CHECK_20261103.md

# 雷达接线后实测 2026-11-03

STL-27L 经 FPGA 原始点云链路和车载路由器接收。恢复已验证的整机 SRAM 位流后，直接只读采集 10 秒，没有发送电机指令。

- 完整扫描 98 圈，9.921 Hz，约 21598 点/秒。
- 诊断窗口 9.8 秒：有效原生包 17638，转发 17638；新增丢包、串口帧错误、CRC 错误、格式错误、超时均为 0。
- 扫描组装缺包、不完整扫描和 UDP 丢包均为 0。
- 累计 dropped_packets 为 143802，是本次采集前的历史计数；窗口内不增长。
- PC 上位机已重新打开并收到新鲜电机与姿态数据；电机未使能，速度和 PWM 均为 0。
- Nano 网页接收器保留 FPGA 重启前的序列，返回 restart_required，网页旧缓存不能用于判断本次雷达状态。本机 SSH 密钥登录不可用，未重启 Nano 服务、未修改冻结版本。

原始记录：runs/commissioning/lidar_connection_20261103_111905/，含 frames.bin 和 scan_latest.json。精简结果见同目录 evidence JSON。
