LilywantbecomeNIUBI/fpga-system-integration/docs/MECANUM_1KHZ_EXTENDED_20261103.md

# 麦轮1kHz速度环与扩展行程（2026-11-03）

最终整机已下载SRAM，位流来自`build/lidar_raw_ethernet_20261102/mecanum/20261103T013936Z`，
SHA256为`a6c985da256170d09ab8c46de288c0465298cb4d9b6af44e0ce6ce2a079b5bd5`。
Place 2 / Route 1共542.8秒，Setup/Hold为0/0，四项整机审计与原始点读出/重试余量审计通过。
原PR1014和eth125 MPW -0.849ns保留，完整STA签核仍标为未通过，按已授权的实验边界上板；未写Flash。

## 重新架空后的实测

用户在首轮测试后更正：前面三档实际未架空。原始记录保留，但不作为架空验收，见`test_condition_correction.json`。
用户重新架空后，已静止校零并重新完成2、4、6档；6档持续2秒，其余各1.1秒。

| 档位 | 标称单轴目标 | 最后约0.4秒四轮平均轮缘换算速度 | 峰值PWM | 运动期间I2C错误增量 |
|---|---:|---:|---:|---:|
| 2 | 50.3 mm/s | 46.9 mm/s | 9.1% | 17 |
| 4 | 100.5 mm/s | 88.0 mm/s | 10.6% | 8 |
| 6 | 150.8 mm/s | 148.5 mm/s | 14.6% | 26 |

6档后段四轮分别约147.7、149.6、149.4、147.3mm/s，最大差约1.5%；为编码器按标称75mm轮径换算，
不代表落地车速标定。每档四轮反馈正向、UDP无丢包、STOP和约250ms看门狗通过，最终未使能、PWM与速度均归零、锁存故障为0。
1kHz功能位和CONTROL_SHIFT=6由实板遥测确认。静止5秒观察未新增I2C错误，原始与推理图传均约30fps。

**IMU间歇NACK仍未解决**，本轮不能称整机完全正常；4m行程和正反360/720°功能通过仿真，落地距离/角度精度尚未验收。
新版上位机已重新打开并只读连接，能够继续导出实时数据供远程观察。

用户随后确认IMU线曾断开并已重连，已进行专门复测，见`imu_reconnect_verification.json`：
校零成功，陀螺偏置从-20更新为-32；校零前后累计错误增加1次。随后静止8秒无新增错误，
2档转动1.1秒新增10次NACK，停车后再静止8秒无新增错误，网络无丢包、最终停车归零。
因此静止通信恢复，但电机运动时的间歇错误仍可复现，遥测尚不足以确定具体原因。上位机已恢复只读连接。

用户随后确认更换IMU供电并断电重启，已重下载同一SHA256的SRAM固件、恢复端点并校零。
此次静止前后各8秒均无新增错误；2档1.1秒、4档1.1秒、6档2秒分别新增0、1、3次NACK。
此前相同架空6档2秒为26次，本轮短测错误减少但没有消失。恢复上位机后又记录到位置/整圈目标操作，
错误累计继续到23次。因此不能只凭这次供电更换和重启后的对比认定纹波为根因。
具体新供电来源和电压尚未提供。记录见`imu_supply_retest.json`；测试后已确认停车，未重编译或写Flash。

## 断电后重载

本次仅下载SRAM，断电后需重载。以下命令在仓库根目录运行，端点示例使用当前无线地址192.168.50.100：

```powershell
python tools/mecanum/program_sram.py build/lidar_raw_ethernet_20261102/mecanum/20261103T013936Z --experimental --expected-sha256 a6c985da256170d09ab8c46de288c0465298cb4d9b6af44e0ce6ce2a079b5bd5
python tools/task4/telemetry_endpoint.py --bind 192.168.50.100 --slot pc --target 192.168.50.100 --video-port 6102
python tools/task4/telemetry_endpoint.py --bind 192.168.50.100 --slot nano --target 192.168.50.20 --video-port 6102
```

再运行`start_mecanum_router.cmd`或桌面无线快捷方式打开上位机。切换有线/无线后由启动器检测PC出口，
命令本身不会ARM、发非零目标或切换Nano服务。

## 行为与范围

新整机保留同一套四轮引脚、UDP6206命令/UDP6205状态和Nano双端点。

- 定点旋转支持正反720°，可连续执行360°整圈；累计角度独立于IMU的±180°表示。
- 单次直线/任意方向平移距离支持4000mm；相对位置X/Y各支持±4000mm。
- 四轮速度内环更新1000Hz，位置/航向外环100Hz，PWM载波10000Hz。
- 默认单轴平移目标约151mm/s，原默认约126mm/s；实际速度由编码器反馈确认，不把标称目标当实测。
- 默认动作时限60秒，继续保留250ms命令看门狗、故障停车、抗积分饱和、斜坡与换向保护。

## 运算结构

四个轮子各自并行实例化 M/T 混合轮速估计和定点流水 PI，不使用软件轮询四个电机。
低速使用编码器边沿周期，高速使用8个1ms桶的滚动窗口，输出Q8的“原始计数/10ms”，每1ms刷新。
M/T除法采用32时钟恢复除法；PI在约40时钟内完成，50MHz下均显著短于1ms。
速度环在估计触发后延后40个FPGA时钟采样，覆盖低速周期估计延迟。
原始10ms轮速遥测和高分辨率位置计数不改变；新增的快速反馈只供速度闭环使用。

PI继续以100Hz参考Kp/Ki语义换算。积分分母中保留10倍因子，不对Ki逐步取整为0。
PWM变化率从20‰/10ms换为2‰/1ms，实际斜坡不变；换向静止等待从10个10ms周期换为100个1ms周期。
PWM上限仍为300‰（30%），本轮默认先提升目标速度，不同时扩大电压占空比限制。
纯横移的150‰起步前馈仍受总PWM限幅和积分抗饱和约束。

## 长行程与整圈编码

V3的24字节命令帧、CRC16和48字节M4/P4状态帧保持不变。
旧POSE opcode6保留；新增opcode9用于明确有方向的旋转，z单位为0.1°，范围±7200。
新定点旋转入口使用opcode9，累计航向不会在360°时被误判为0°到达；位置加大角度组合也使用扩展入口。
M4第45字节新增功能位：bit0=1kHz速度环，bit1=opcode9整圈旋转；旧接收器可忽略该保留字节。

控制位置比例从原始计数/16调整为/64（CONTROL_SHIFT=6）。16位位置目标和Q16局部坐标因而覆盖约4m，
不再因4000mm约63662个旧控制计数而溢出。raw_counts_per_rev=60000、轮径75mm仍为既有标称配置，实际轮径/滑移需标定。
低速缩放保留有符号余数，原始编码器遥测精度没有被丢弃。
默认Kp512→2048、Ki32→128，抵消控制误差单位缩小4倍；角度外环增益和横移前馈渐退距离也同步换算。
新速度档1约等于25.13mm/s，默认档6约150.8mm/s，旧档20约125.7mm/s。
新上位机在ARM前检查控制比例，整圈动作还检查功能位，避免新单位目标发给旧固件。
完成判定要求M4/P4序号匹配且姿态状态在本次目标发送之后收到；延迟到达的上一目标完成状态不能结束新动作。

## 来源与验证

保留 `vendor/mecanum_team` 原件不改。四轮快速PI来自已在仓库中的 `fpga/motor/wheel_control_1khz.sv`，
复制为 `mc_wheel_control_1khz` 后接入横移前馈；M/T估计复用 `fpga/motor/wheel_speed_hybrid.sv`。
`fpga/mecanum/local_overrides.json` 逐项记录相对导入快照的有意修改及SHA256，未修改导入模块继续逐字校验。

专项覆盖：

- 正/反360°和720°、穿越±180°回绕、不可提前到达。
- 3.5m直线/斜线和4m边界的独立运动学模型与坐标溢出检查。
- 四个真实核心并行1kHz节拍、100Hz外环、M/T量纲、STOP及估计故障接口。
- 相同物理时间内新旧PI积分和斜坡一致性、正负前馈、换向和零目标。
- 真实UDP整圈命令经过MAC、CDC、CRC解析到36000 centideg目标，保留网络停车检查。
- 完整生产顶层12000原始雷达点、视频、IMU6500、CRC和输出禁用回归；真实M4/P4功能位与比例核对。

离线回归已通过30组HDL仿真、28项上游Python测试和19项集成Python测试；
冻结整机仿真通过12000点与视频/IMU/CRC检查，实际输出的26帧遥测已核对1kHz功能位和CONTROL_SHIFT=6。

冻结构建：`build/lidar_raw_ethernet_20261102/mecanum/20261102T231025Z`。
首次构建在位流生成阶段达到1800秒超时；部分位流不能下载，超时日志和结果保留为`timeout_attempt1_*`。
同一冻结源码的重跑已结束，Setup/Hold为1/0；唯一Setup违例为eth125网络复位到遥测pending状态，余量-0.039ns。
该候选未下载。原始结果与审计保存在证据目录的`setup_failure_*`中。
后续已拆开内部队列接纳条件和接口复位门控，并补齐通道0的调度专用ARP命中副本。
命令、双端点和47帧逐周期网络等价回归通过。随后增量尝试因PA2136匹配不足被终止；用户明确授权全量后，
Place 0 / Route 2虽仅484.8秒但有701个Setup违例，未下载。最终使用上述Place 2 / Route 1版本。

新建冻结构建可运行：

```powershell
python tools/task4/build_ethernet.py --system --mecanum --raw-points --clock-cleanup --route-option 1 --timeout-seconds 5400
```

该入口现默认使用[整机增量构建](WHOLE_SYSTEM_INCREMENTAL.md)，保存并复用完整`.pr`参考；不会静默回退全量布线。

实测按用户确认四轮架空进行，先零目标，再速度档2/4/6短时前进；不在架空状态宣称完成真实车身360°或3米落地距离验收。
原PR1014、eth125帧缓存RAM的MPW和运动时IMU I2C NACK问题继续保留，不用速度环提频掩盖这些余项。
