LilywantbecomeNIUBI/fpga-system-integration/docs/MECANUM_ROUTER_BOARD_20261103.md

# 路由器控制上板验证（2026-11-03）

用户已上电，并明确确认四轮架空、允许短时低速动作。
下载 `20261102T215739Z` 到 SRAM，位流 SHA256：
`22797c7779a044874aa65f45f28bcf4f12d0483c672f760984b265a79ca3aced`。未写 Flash。
PC 保持 `.10`，Nano 保持第二端点 `.20:6102`，新增 PC 第一端点 `.10:6102`；均接车载路由器 LAN。
本轮所有命令走 UDP6206，状态走 UDP6205，没有打开车辆命令串口。

| 检查 | 实测结果 |
| --- | --- |
| CLEAR、零目标 ARM、STOP | 回执通过；零目标全过程 PWM=0 |
| 停发命令看门狗 | ARM 回执后约 249.96ms 撤销使能并锁存故障 |
| 旧 ARM 重放 | STOP/CLEAR 后重放旧序号，没有重新使能 |
| 架空低速前进 | 完成 1.1s 窗口；四轮编码器增量均为正 |
| 最大驱动/反馈 | PWM 101‰（10.1%）；最大原始轮速 158 计数/10ms |
| 结束状态 | armed=false、故障0、四轮 PWM=0、四轮轮速=0 |
| UDP/CRC | 本轮运动接收102帧，拒收、丢失、重复、过期计数均为0 |
| Nano 公共页面交付 | 原图29.38FPS，识别24.83FPS；每帧键唯一 |
| 静止复查 | IMU WHO=0x70，数据新鲜；NACK计数保持10，没有继续增加 |

前进窗口 FL/FR/RL/RR 原始编码器增量分别为 4208、2522、4870、2734。
这是短时架空驱动、正向反馈与停车验证，不能据此认定落地里程、横移或定角精度通过。
运动期间累计10次可恢复 I²C NACK，沿用既有的校准航向保持策略；不把这些错误记作通信稳定性通过。

首次零目标测试在紧邻发送 STOP/CLEAR 后未能确认 CLEAR，未发送非零目标；已保持停车。
测试脚本改为逐条等待新鲜回执后，全部网络控制项目通过。保留首次失败记录以明确验收过程。
验证脚本：`tools/mecanum/check_router_live.py`，非零动作必须同时提供 `--motion --wheels-raised`。
再次运行会主动产生一次1.1秒低速前进，不能将它当作只读监控命令。

本次实际验证的是有线接口。电脑 WLAN 当前在 `10.194.x.x`，尚未连接到板端 `192.168.50.x` LAN；
无线实测需先连到同一车载路由器 Wi-Fi 后，按其 WLAN 地址配置 PC 槽并绑定该地址。
雷达未收到数据，保持既有暂缓范围。MPW -0.849ns / PR1014 原时序余项仍保留。

逐帧命令/反馈、下载记录、视频及静态复查证据见 `docs/evidence/router_board_20261103/`。
