LilywantbecomeNIUBI/fpga-system-integration/docs/IMU_MPU6050_20261102.md

# MPU-6050 更换及上板测试准备（RevB）

2026-11-02。按用户本轮补充确认执行：原 IMU 已损坏，新模块是之前照片中的 MPU-6050；载板为 99×99mm RevB，模块自带 AD0 下拉，且外形不碰相邻元件。沿用原座八针直插，不增加飞线。新固定孔与固定方式按实物实施，不把外形避让等同于旧固定孔通用。

## 接线结论

| 模块针位 | RevB J_IMU1 同号端点 | 本次配置 |
|---|---|---|
| 1 / VCC | VIO_3V3 | 原座3.3V供电 |
| 2 / GND | GND | 共地 |
| 3 / SCL | P7-39 / F19 | LVCMOS33、开漏、FPGA内部不上拉 |
| 4 / SDA | P7-40 / F20 | 同上 |
| 5 / XDA | 原IMU_AD0，经10k上拉3.3V | 关闭辅助总线主机和旁路 |
| 6 / XCL | 原IMU_CS_H，经10k上拉3.3V | 同上 |
| 7 / AD0 | RevB未连接 | 使用模块自带下拉，地址0x68 |
| 8 / INT | 100k弱下拉，不接FPGA | 不使用硬件中断，轮询状态 |

F19/F20球号不变；F18保持原用途，不改成AD0输出。载板网络依据此前直接核对的 `D:/活动/比赛/电赛/FPGA/Carrier_Hall_RevB/carrier_hall_revb.kicad_pcb` 和同目录 `pin_netlist.csv`。RevC第7针连F18的分支不适用于本车。模块与载板的I²C上拉仍由实物供电后检查高/低电平确认；本轮没有测量物理电压。

## 已修改的软件

- `fpga/imu/mpu6050_reader.v`：地址0x68；先检查WHO_AM_I=0x68，器件复位后再检查；默认上电、复位、唤醒各等待100ms；配置寄存器逐项读回。
- 总线请求400kHz，并强制限制不超过400kHz；复用的开漏主机在50MHz下名义SCL约379kHz，保留时钟拉伸、超时和总线恢复。
- SMPLRT_DIV=0，DLPF_CFG=1，1kHz，±4g（8192 LSB/g）与±1000dps（32.8 LSB/(°/s)）；温度为 raw/340+36.53℃。辅助主机、旁路和FIFO关闭。
- 轮询0x3A的DATA_RDY位，再从0x3B一次读取14字节；六轴与温度同时提交。MPU6050的0x8000是有效负满量程值，不继承旧ICM的无效值过滤规则。
- 保留3ms样本过期提示、10ms采样看门狗、NACK/超时/身份/回读失败诊断与自动重新初始化。序号表示成功读取次数，时间戳是观察时间，不保证等于芯片转换时间或不漏转换。
- 混合UART仍用v2/48字节帧，MPU配置ID=4、WHO=0x68、fast_bus=0；PC与Nano共用解析器按配置ID使用正确温度/角速度换算，旧ICM配置2/3仍可回放。
- `tools/build_system.py` 增加独立产物目录及对应网表/CDC审计；本次使用现有 `system_top` 与现行电机/编码器引脚表，不切换任务四M2引脚配置。

## 数字验证

已通过 `python tools/test_mpu6050.py`：总线地址、400kHz上限及Fast-mode高低电平时间、量程/采样率配置、14字节原子更新、温度字节位置、负满量程值、3ms/10ms过期处理、NACK、突发期间SCL超时、错误身份、配置回读错误、复位不完成及恢复。

`python tools/test_system.py` 已通过70项Python测试、电机/串口数字回归、68个集成引脚唯一性、LK及双目标网络测试。`python tools/test_full_top.py` 已通过实际集成顶层数字仿真：15次IMU提交、25条混合遥测、CRC错误0；相机/网络与IMU故障隔离、STOP及旧无刷禁用输出检查通过。行为传感器不代替真实MPU6050验证。

## 布局布线与产物

独立构建命令：

```powershell
python tools/build_system.py --output-dir build/mpu6050_system_20261102
```

整机项目：`build/mpu6050_system_20261102/system.gprj`；位流：该目录 `impl/pnr/system.fs`；结果：`result.json`。首次新模块检查使用另建的 `build/mpu6050_bringup_20261102/system.gprj`，顶层 `mpu6050_bringup_top`。两个项目均已完成综合、布局布线和位流生成，源码哈希一致。

| 候选 | Setup / Hold违规 | 最小脉宽裕量 | 其他检查 | 用途 |
|---|---:|---:|---|---|
| IMU静态检查版 | 0 / 0 | +7.983ns | 无时钟布线告警；20个电机输出OBUF输入均为GND | 首次上板静态检查；仅IMU/串口/LED |
| 整机system_top | 0 / 0 | eth125 −0.688ns | 网表与CDC审计通过；control50裕量+5.849ns；仍有camera_pclk_d通用时钟布线告警 | 已完成布线，整体时序未签核 |

整机 `result.json` 的 `passed=false` 如实保留原有最小脉宽和时钟布线问题，不通过放宽约束将其改为成功。IMU检查版 `passed=true`，没有命令接收入口，D157B四路控制与旧无刷EN/PWM/CAL共20路输出固定低；未将编码器引脚改成输出，也未占用F18。该版本不提供图传、雷达或电机功能。

位流SHA256：

- IMU检查版：`3ae6b25c5d456d7b941743bf136d4ea1ec72d0c62e90170d44d7c67bf56dad88`
- 整机候选：`0119fce42e3a509da65d84633cebd111d6873c566657698c99f5f919c2a39692`

IMU检查顶层的实际50Hz串口数字仿真也通过：7个完整样本、CRC错误0、观测原始读取速率999.650Hz，20路电机输出始终为低。加速的只有仿真启动等待，实际位流仍使用默认100ms等待。

交付目录：`dist/mpu6050_revb_20261102`，包含 `imu_check.fs`、`system_candidate_timing_pending.fs`、配套Nano代码、构建结果、说明与逐文件SHA256清单。证据位于 `docs/evidence/mpu6050_20261102`。旧工程产物保留，本轮尚未下载、连接实物串口或写Flash。

## 上板顺序

1. 断电后按VCC/Pin1方向安装新模块，保持电机动力支路断开。上电先检查模块无异常发热、SCL/SDA空闲为高、AD0为低。
2. 首次只用 `imu_check.fs` 做SRAM静态测试，先核对SHA256。此文不表示已下载。整机候选仍有原工程时序问题，不作为签核版；本轮不执行整机下载。
3. 配套Nano包在 `dist/mpu6050_revb_20261102/nano`，PC直接使用本仓库新版解析器。先更新网关解析器，再检查新配置ID；旧网关无法正确解释配置4。不改变模型、视觉目录、系统环境或串口所有权。
4. 检查版不输出电机遥测，使用下方 `--imu-only`；整机候选的后续检查去掉该参数并检查电机停机遥测。静止读取10秒，要求WHO=0x68、config_id=4、ready=1、fault/stale=0，CRC、I²C错误和丢帧计数为0，原始读取速率约1kHz，50Hz调试遥测，电机未解锁且输出为0。
5. 手动倾斜和旋转检查各轴符号与安装朝向。轴向保持传感器原始坐标，未凭旧模块安装方向推断新模块方向；随后做静止零偏/安装零点确认，再恢复整车并发测试。

独占PC串口时可使用以下只读工具（将COM号替换为实际端口；先关闭原串口占用者）：

```powershell
python tools/verify_mpu6050.py --port COM20 --seconds 10 --imu-only
```

它只接收，不发送串口字节或运动命令，保存 `results/mpu6050_时间戳/rx.bin` 和 `result.json`。离线验收已有UART记录可用 `--input 路径/rx.bin`，IMU检查版记录同时加 `--imu-only`。检查版的电机固定低由RTL、综合后网表与数字仿真确认，不把缺少电机遥测解释成已读到电机停机反馈。Nano网关已独占串口时沿用网关观测，不另开PC串口。新包仅准备，未部署。

## 器件依据

[TDK/InvenSense PS-MPU-6000A-00 Rev3.4](https://product.tdk.com/system/files/dam/doc/product/sensor/mortion-inertial/imu/data_sheet/mpu-6000-datasheet1.pdf)；RM-MPU-6000A-00 Rev4.2寄存器手册。此前本地提取文本位于 `D:/活动/比赛/电赛/FPGA/小车模型/tmp/pdfs/lqr_at8236/mpu6050_product.txt` 与 `mpu6050_registers.txt`，本轮对照采样率、量程、DRDY、复位、辅助总线与温度定义实施。商品模块的AD0下拉和机械避让来自用户实物确认。
