LilywantbecomeNIUBI/fpga-system-integration/docs/MECANUM_BOARD_20261103.md

# 麦轮整机上板记录（2026-11-03）

当前实板为 `20261102T204810Z` 的全点麦轮整机，位流 SHA256：
`301375bdc7a0986f922ff4993270adc94a04d638824f10f2bb3c58d8ca80ef51`。
通过 Gowin USB cable/location 357 核对器件 ID `0011081B` 后下载 SRAM，未写 Flash。
用户已确认四轮架空；本次没有落地移动。

## 本次发现并修复的合并问题

旧 `20261102T201012Z` 位流的球位正确，但构建脚本把所有 chassis 组信号按电机输出生成下拉，
遗漏了队友 CST 中时钟、复位、UART TX、IMU 和 LED 的 `PULL_MODE=NONE`。
其中 IMU SCL/SDA 的内部下拉与原工程不同，上板持续 NACK、WHO=0、无法校准，手动重连也不恢复。

现在按队友 CST 原样继承所有 `IO_PORT` 电气属性，仅将 IMU 端口名映射到整机名称。
新增回归逐条比较电气声明，下载工具也逐条核对，避免只检查球位再次漏检。
修正后重建、重新布线，Setup/Hold 仍为 0/0；RTL 文件哈希完全未变，原雷达/网络/摄像头优化均保留。
修正版上板后 WHO=0x70、完成校准，初始静态通信错误计数为 0。

同时修复了冻结构建目录在同一秒内重名的问题，避免构建检查后立即编译发生 FileExistsError。

## 实板检查结果

| 检查 | 结果 |
| --- | --- |
| UDP M4/P4 遥测 | 正常；静态及控制检查没有 CRC 或 UDP 序号丢失 |
| IMU | MPU6500，WHO=0x70，已校准、数据新鲜；手动重连/校准回执及恢复通过 |
| COM15 控制 | CLEAR、零目标 ARM、STOP 回执通过 |
| 看门狗 | 零目标 ARM 后不续期，250 ms 看门狗撤销使能并锁存故障；STOP/CLEAR 后恢复 |
| 短时架空前进 | 1.1 s，轴速度限制 8 控制计数/10 ms；四轮反馈均为正 |
| 实测驱动/反馈 | 最大 PWM 96‰（9.6%），最大原始轮速 150 计数/10 ms |
| 最终停车 | armed=false、四轮 PWM=0、四轮速度=0、控制故障=0 |
| Nano 图传/光流 | 恢复在线；后续 4 秒收到 123 帧，图像/光流坏包增量均为 0；图像缺帧增量 6 |
| 雷达 | 用户明确未接线、暂缓；RX 字节 0 不作为本轮其他功能的失败项 |

前进窗口的 FL/FR/RL/RR 原始编码器增量分别为 4978、3554、5114、2422。
该测试确认短时驱动、正方向反馈和停车，不代表落地里程/横移/定角精度验收通过。
所有状态从网口读取，运动命令经 COM15；最终已将第二网口目标恢复 Nano 192.168.50.20:6102。
IMU 和四轮的验收依据是直接解码 M4/P4，不能把旧看板的双轮/九轴字段当作新协议的验收数据。

## 仍需保留的余项

运动期间 IMU 累计出现 **4 次 I²C NACK**，错误上下文标记 armed/PWM/外环均在运行；之后自动恢复，
最终校准保留、数据未过期、错误码恢复 0。静态成功不代表带电机干扰时通信完全稳定。
已有原始逐帧记录，后续需要针对这一现象继续检查；本次没有改动队友的断线保留航向策略。

完整 FPGA signoff 仍未通过：PCLK 的 MPW/PR1014 余项没有因实板能出图而消失。
雷达和落地运动精度未验，因此 `full_hardware_acceptance_passed` 明确保留 false。

证据在 `docs/evidence/mecanum-board-20261103`；冻结构建、Programmer 日志与原始 UDP 数据在
`build/lidar_raw_ethernet_20261102/mecanum/20261102T204810Z/board_20261103_045703`。
测试工具位于 `tools/mecanum/program_sram.py`、`verify_live.py`、`check_controls.py`、`check_low_speed.py`；
运动工具必须显式传入 `--wheels-raised`，遇到过旧反馈、反向反馈、故障或超速会结束，并在 finally 中 STOP。
