LilywantbecomeNIUBI/fpga-system-integration/docs/MECANUM_INTEGRATION_20261103.md

# 麦轮整机集成（2026-11-03）

独立分支：`codex/mecanum-integration-20261103`。基线为
`timing-refactor-20261103`（`acaff0457777a5a4b50c86a7274178452ff09d20`）。
以太网智能体仍在原 checkout 工作；本分支不包含其未提交修改。

后续按用户指定的冻结版 `20261102T192736Z` 迁入其已验证修复，并完成全点模式的 Setup/Hold 0/0 验证；
最新结论、剩余 PCLK 问题和原临界路径加固结果见 [全点整机时序记录](RAW_MECANUM_TIMING_20261103.md)。
以下基线说明描述初次集成时的状态，不能据此忽略该后续迁移。

## 新入口与保留版本

- 新整机顶层：`fpga/mecanum/system_mecanum_top.sv`。
- 保留旧双轮顶层 `fpga/navigation/system_task4_top.sv`、所有已发布位流和全点雷达代码。
- 队友原件保存在 `vendor/mecanum_team`，SHA256 在 `manifest.json`；该快照不参与整机综合。
- 参与综合的副本在 `fpga/mecanum`，模块统一加 `mc_` 前缀。只改造顶层遥测接口，闭环、混轮、编码器、PWM、IMU 实现保留。
- `mc_mecanum_top` 默认保留串口遥测，便于复用原有测试；整机顶层固定启用网口遥测。

## 当前接入范围

四轮位置闭环、定角、任意角度平移、MPU6050/6500、摄像头、光流、视觉事件、360 扇区最近回波雷达。
相机、光流和以太网源码沿用已提交基线，没有为本次集成修改它们的时序实现。

旧 `nav_core` 用双轮里程计及左右轮目标，不适用于四轮横移。因此新顶层使用队友的麦轮相对位置闭环，
**没有启用旧的双轮自动导航/避障驱动**。这部分需另行移植运动模型，不能把左右轮命令直接复制到四个轮子。

IMU 总线由队友驱动独占：100 Hz 陀螺采样、20 Hz P4 姿态遥测，不启用原整机的 1 kHz 九轴字段接口。
沿用队友的断线保留最近航向策略：首次校准完成后，缺帧不单独触发 IMU 停车，P4 仍报告过旧及通信错误。
不会积分断线期间的未知运动；串口命令 250 ms 看门狗、STOP、四轮故障停车继续存在。
这与原主工程的 IMU 超时策略不同，是明确保留的队友行为，并非已完成的两种策略统一。

## 协议与接收端

控制：UART 115200/8N1，V3 24 字节。只保留 0 STOP、1 ARM、3 CLEAR、6 POSE、7 KEEPALIVE、8 IMU 重连校零。
2/4/5 已取消，不重新引入遥控、单轮或保持朝向速度模式。方向保留字段必须为 0。

状态：UDP 6205，现有 TLM1 外封装，内含 48 字节 M4/P4 或雷达帧。M4/P4 为小端 CRC，旧 IMU 帧仍为大端 CRC，
接收器按包头分别处理。`frame_uart_mux` 保持完整活动帧直到网口握手完成；周期快照拥塞时保留较新的待发送值。
全部状态走网口，整机 UART TX 空闲。相机/光流/视觉事件沿用原独立 UDP 通道。

PC 调试入口（运行时需 pyserial；离线测试不接设备）：

```powershell
python host/mecanum/gui.py --telemetry-bind 192.168.50.10
python host/mecanum/console.py --port COMxx --action monitor --telemetry-bind 192.168.50.10
```

GUI 保持默认离线；连接后从 UDP 收状态、从选定串口发命令。监测 CLI 不主动发运动命令。
上述 PC 入口需要 FPGA 的遥测目标已指向 PC；默认硬件网络配置可能仍指向 Nano。
不自动改网络目标。现有 `tools/task4/telemetry_endpoint.py` 可在硬件联调时配置目标，注意它也影响视频目标，须与图传使用方协调。
同一台机器的 GUI 和独立接收器不能同时占用 6205。

Nano：`config/nano.mecanum.ethernet.example.json`，只接收并在 `/api/state` 的 `mecanum` 字段导出四轮及姿态，
旧双轮 HTTP 控制接口明确拒绝命令，不打开命令串口。PC 调试时若改遥测目标到 PC，Nano 不会同时收到该单播。
本次没有部署 Nano 服务，也没有修改正在使用的串口/网口配置。

## 接线与仍需实车确认的内容

新引脚表：`hardware/mecanum.json`，沿用队友四轮 P7 接法；IMU F19/F20，雷达 B16。
原整机 M2 双轮引脚配置不能用于本顶层。构建脚本检查与相机、以太网的引脚重复。

| 逻辑轮位 | PWM P7 | 编码器 P7 | 固定电机/反馈取反 |
| --- | --- | --- | --- |
| FL 左前 | 23/24 | 27/36 | 是 |
| FR 右前 | 21/22 | 31/32 | 否 |
| RL 左后 | 25/26 | 34/35 | 是 |
| RR 右后 | 28/33 | 37/38 | 否 |

表中是顶层前轮交换后的物理轮序。`pins.csv` 外部数组索引 0/1 不是交换后的逻辑 FL/FR。
固定取反值 `0101`、`CONTROL_SHIFT=4`、30% PWM 上限、15% 纯横移起步补偿保持。
最新源码 `LATERAL_REVERSE=0`，约定 +X 前、+Y 左、+Z 逆时针。
队友文档保留了相互覆盖的历史横向标定，最新段明确此修改尚未下载；不能据“源码通过时序”宣称该方向已实车确认。

## 离线验证与构建

```powershell
python tools/mecanum/test.py
python tools/mecanum/build.py
# 上一条输出冻结目录，再传给整机仿真：
python tools/mecanum/test_system.py <冻结目录>
```

`test.py` 在导入后的 RTL 上运行队友测试（24 个 bench）以及集成背压测试，共 25 组；另运行原 28 项上位机测试及新增协议测试。
上游 `tools/test.py` 漏带 `tb_pose_serial_top` 需要的 MPU 模型；本入口显式加入模型，并用 `-s` 限定仿真根，快照原件保持不改。

整机测试含实际 MPU6500 I²C 模型、1000 个合成雷达包及一个损坏包、独立最近回波参考、视频并发、内外 CRC、四轮未使能输出和 UART 空闲检查。
PHY 初始化和视频字节沿用原测试的注入方法；这不能证明实际 PHY 启动或摄像头电气链路正常。

构建脚本只生成冻结源码、GPRJ/CST/SDC、引脚审计与 `build.tcl`，不抢占高云进程、不下载。
真实综合后的同步器名字、SDC 命中、完整时序和资源占用尚需检查，不能据离线仿真判定时序通过。
以太网基线本身仍有已记录的 6 个 setup/recovery 违例以及脉宽/PR1014 问题，另一智能体正在优化。

## 后续合并以太网优化

等待对方把其最终修改提交后，再将明确的提交或分支合并到本集成分支。不要复制其工作目录或切换其分支。
麦轮改动集中在独立目录，现有以太网/视觉时序源码无本次修改，便于合并其修复。
合并后重新执行两侧回归、冻结整机源码、完整 PnR 和时序审计，再做上板验证。
本次未下载 SRAM 或 Flash。
