LilywantbecomeNIUBI/fpga-system-integration/docs/pin_plan_v0.md

# 当前引脚方案：已验证编码器映射 — 2026-10-30

按现有 ACG720（138K）开发板设计，P7 对应关系已核对开发板通用原理图第 11 页及现有 GPIO 映射。用户于 2026-10-29 确认驱动板为 D157B（带稳压、电机 6Pin 插座）。后续实物照片显示D157B 1.1，两个电机插座编码器供电脚均标3V3，用户确认编码器3.3V供电；实际AB波形及转接线尚未测量确认。

## 底盘接口

方向均相对 FPGA。A 通道暂定义左轮，B 通道暂定义右轮；安装后用独立配置校准电机与编码器符号。

| 功能 | 顶层端口 | P7 针号 | FPGA 球号 | 方向 | 驱动模块端点 |
|---|---|---:|---|---|---|
| 左轮控制 1 | left_in1 | 21 | D17 | OUT | AIN1 / D157B J4-4 |
| 左轮控制 2 | left_in2 | 22 | C17 | OUT | AIN2 / D157B J4-3 |
| 右轮控制 1 | right_in1 | 23 | E16 | OUT | BIN1 / D157B J4-2 |
| 右轮控制 2 | right_in2 | 24 | D16 | OUT | BIN2 / D157B J4-1 |
| 左编码器 A | left_enc_a | 31 | F16 | IN | level shifter <- E1A / D157B J5-1 |
| 左编码器 B | left_enc_b | 32 | E17 | IN | level shifter <- E1B / D157B J5-2 |
| 右编码器 A | right_enc_a | 27 | C18 | IN | level shifter <- E2A / D157B J5-3 |
| 右编码器 B | right_enc_b | 36 | D19 | IN | level shifter <- E2B / D157B J5-4 |
| 未使用预留 | p7_37_unused | 37 | F18 | — | 无外部许可依赖，不接29→37跳线 |
| 信号地 | — | 12/30 | — | 电源 | 驱动、电平转换、FPGA共地 |

本车使用 D157B，左电机接 Motor_A 6Pin 插座，右电机接 Motor_B 6Pin 插座。用户确认使用防呆排线直连，本阶段不要求重新排线。表中 FPGA 侧 J4/J5 针号按所附 D157B 原理图定义，接线时核对实物丝印和修订版。万向轮无需电气引脚。

**本版取代此前复用无刷PWM的引脚方案，旧位流不能按新表接线。** 拔下AD7606模块与载板之间的数字接口连接，使ADC_BUSY/DOUT等旧输出和新信号完全断开；从载板/FPGA侧引线。ADC只有7根独立GPIO，右编码器B额外使用P7-36原雷达UART；P7-37不使用；当前STL-27L改走Nano USB，载板雷达TTL接口不能仍接雷达或USB转串口的输出。ADC接口中两个CONVST针脚为同一网络，不能当成两根GPIO。

现有POWER_DRV8323HR_V1.01说明书注明DRV_EN板载R29=10kΩ下拉、默认低；芯片ENABLE低时进入休眠。此依据适用于该版本，实物仍需核对。旧无刷电机机械安装、UVW相线和驱动信号线可以保留，不再与新D157B信号复用。新顶层固定两路DRV_EN、全部12路PWM、两路CAL为0。建议断开旧驱动动力电源支路，并在配置/重启期间确认DRV_EN保持低；固件禁用不是物理断能。不要将EN直接短接地后再允许旧固件把同一GPIO推高。再次下载旧平衡固件前必须恢复接线检查。

## ADC载板侧取线位置

| P7 | 旧网络 | 旧载板接口端点 | 新用途 |
|---:|---|---|---|
|21|ADC_CONVST|J_ADC_DIG1-7/8（同一网）|AIN1|
|22|ADC_BUSY|J_ADC_DIG1-12|AIN2|
|23|ADC_CS_N|J_ADC_DIG1-11|BIN1|
|24|ADC_SCLK|J_ADC_DIG1-10|BIN2|
|25|ADC_DOUT_A|J_ADC_DIG1-22|当前未使用，左编码器已改P7-31|
|26|ADC_DOUT_B|J_ADC_DIG1-23|当前未使用，左编码器已改P7-32|
|27|ADC_RESET|J_ADC_DIG1-9|E2A，经3.3V调理|
|36|LIDAR_UART_RX|J_LIDAR_CORE1-1|E2B，经3.3V调理|
|37|LIDAR_UART_TX|J_LIDAR_CORE1-2|当前未使用；无外部许可输入|

接口端点来自现有Carrier_Hall_RevB映射；实物版本和插头观察方向未现场核验，不按排线颜色猜针号。

## 电平和供电

- 控制与输入统一为 LVCMOS33。AT8236 芯片手册第 4 页给出 VIH 最小 1.5V，3.3V 输出满足芯片逻辑高门限；仍需核对实际模块输入电路。
- 旧版原理图的电机6Pin编码器供电标为5V，AB直接引出；但本车实物D157B 1.1插座丝印为3V3，用户确认3.3V供电，客服确认编码器支持3.3～5V。AB在3.3V域且无5V上拉时可直接接FPGA，不强制外加转换模块；若实际为5V信号，则仍需经确认适用的缓冲器或分压/上拉电路。不要把供电支持范围当作实测输出波形。
- 电机由驱动 VM 接外部 12V，不能从 FPGA GPIO 或 P7 供电。FPGA 保持原供电；D157B 的 5V/3V3 输出不接 FPGA 的电源输出，避免电源并联反灌。P7-11 是 5V，P7-29 是 3.3V，均不属于信号针脚。
- D157B 自带稳压，按模块电源输入接 12V 和 GND，无需另给模块 VREF 接独立 3.3V 电源；不要套用 D107A 的 VCC 接法。
- 四路驱动控制在驱动端预留外部下拉，使 FPGA 配置期间保持 00；具体阻值结合模块电路确认。硬件急停应直接切断驱动能量，本有刷工程不再包含 `estop_n` 输入，也不接29→37跳线。
- D157B 的 ADC 是 VIN 经 1/11 分压的模拟输出，不能接普通 FPGA 数字 IO。此版不连接；如需采集，另接外部 ADC 并核对量程。

## FPGA 控制约定

每轮使用 IN1/IN2 两根线，不额外虚构 EN、DIR、nFAULT 或电流反馈端口。AT8236 输入真值表：00 滑行/休眠，10/01 两个电气方向，11 刹车。电气方向不等于车体前进方向。

电机V1采用 PWM=10kHz（模块手册建议值）。速度闭环已改为现场诊断验证过的慢衰减：正输出在01驱动/11刹车间切换，负输出在10驱动/11刹车间切换；占空比表示驱动时间，零输出和未使能均为00。每次从零输出启动，先以11刹车态维持约1.1ms唤醒，再进入PWM；换向先降为零、进入00，确认静止并等待后才允许反向。物理轮向和编码器符号仍须实测。具体实现见 `motor_v1.md`。

电机V1已包含输入同步、AB解码与异常跳变统计、速度窗口、左右轮独立符号、速度环、加减速限制、指令超时、停机锁存。编码器每输出轴转计数、轮径和轮距暂不填默认值。

## 系统接口预留

完整球号清单见 `hardware/pins.csv`；摄像头和 RGMII 从既有 fpga-robot 约束预留，音频从 fpga-audio 预留。统一顶层已集成视觉/网口/IMU；音频仍预留。引脚检查不能证明电气兼容。

- P7-36 D19 已用于右编码器B；P7-37 F18未使用；FPGA雷达UART不再可用。P7-38 E18仅预留。
- P7-39 F19 / P7-40 F20：MPU-6050 的 I2C SCL/SDA，对应载板 J_IMU1-3/4，与照片模块第 3/4 针同序；外部上拉到 3.3V，整排直插条件和驱动状态见下节。
- P7-21~24/27/31/32 已用于D157B，不能同时连接旧外设；P7-25/26/28/33/34/35 保留备用，不沿用旧 MT6701 SPI 协议。
- P7-7 F13、P7-18 C15 保留为旧驱动关闭输出，两种新顶层均固定低；全部旧PWM和CAL也固定低。旧驱动建议断开动力电源，机械及相线可保留。
- 板载 UART TX M15 / RX J21，50MHz 时钟 Y18、复位 F15；UART双向通路已在电机/IMU独立候选验证，集成候选需另行验收。
- 摄像头使用原 P4 接口，网口使用板载 PHY，音频保留原板载接口，Nano/PC 优先沿用以太网。

未来仅能有一个集成顶层和统一引脚所有权；不能拼接多个旧 CST，旧无刷端口仅可作为固定低的禁用输出，不能实例化旧FOC控制；旧ADC和载板雷达UART不能再占用新信号。

## MPU-6050 整排直插复核 — 2026-11-02

用户已确认载板为 99x99mm RevB，要求不飞线，当前优先核对原座八针整排直插。此前“后四针不同，因此一定不能整排插”的判断已撤回：必须按实际网络判断；弱上拉/弱下拉不等于 FPGA 输出冲突。

| 新模块针位/丝印 | 载板 J_IMU1 同号接点 | 判断 |
|---|---|---|
| 1 / VCC | 3.3V | 对应；需核对模块稳压输出及逻辑电平 |
| 2 / GND | GND | 对应 |
| 3 / SCL | F19 / P7-39 | 对应，球号不变 |
| 4 / SDA | F20 / P7-40 | 对应，球号不变 |
| 5 / XDA | 原 IMU_AD0，经 10k 上拉 3.3V | 辅助总线端接弱上拉，不是 FPGA 输出；保持辅助主机/旁路关闭 |
| 6 / XCL | 原 IMU_CS_H，经 10k 上拉 3.3V | 同上，名称不同本身不构成不能插的理由 |
| 7 / AD0 | RevB：未连接，不通往 FPGA | 用户已确认模块自带AD0下拉，选0x68 |
| 8 / INT | 经 100k 下拉 GND，不接 FPGA | 可作为未使用中断输出的弱负载；本方案轮询，不读取该脚 |

用户已确认：实物是 RevB，新模块自带 AD0 下拉，且外形不碰相邻元件。第 7 针由模块下拉固定低，使用七位地址 0x68；F18 不新增输出。SCL/SDA 保持 F19/F20、LVCMOS33、PULL_MODE=NONE。辅助 XDA/XCL 仅接原载板10k弱上拉，驱动关闭辅助主机和旁路；INT 未接 FPGA，使用状态轮询。

`hardware/pins.csv` 状态为 `mpu6050_ad0_low_bringup_pending`。RTL 已改为 MPU-6050 初始化、最大400kHz、1kHz、±4g/±1000dps与14字节突发读取；配置ID为4，WHO_AM_I=0x68。原机械固定孔不据外形避让确认推断为通用，实际固定按新模块实施。布线与上板状态见 [MPU-6050 更换记录](IMU_MPU6050_20261102.md)。
