LilywantbecomeNIUBI/fpga-system-integration/docs/TIMING_ROOT_CAUSES_20261103.md

# 用户提出的时序根因核查与修复

核查依据是用户提供的路径分析、当前 RTL，以及上一轮冻结报告
`build/lidar_ethernet_20261102/system/20261102T155742Z`。
用户材料主要引用更早的 `20261102T134609Z`：其 eth125 为 828 个违规，上一轮读出流水修复后已为 508 个，全局 setup 为 550 个。不能把旧报告的数量直接当作当前状态。

最终冻结构建为 `build/lidar_ethernet_20261102/system/20261102T172152Z`，使用 place=2、route=0、资源复制和原时钟约束。修改八个 RTL 文件，没有下载或写 Flash。第一轮物理试验 `20261102T164613Z` 也完整保留。

## 逐项判断

| 用户判断 | 核查结果及处理 |
|---|---|
| bridge/age、semantics/idle_cycles 的宽增量链太长 | 路径成立。改为最多 8 位一段的加法器，使用寄存的预进位；比较器仍寄存，清零/暂停/到期优先级保持一致。不能仅凭 RTL 含异步复位就断定一定不能使用 ALU。 |
| vision bridge 下游 ready 直达宽输出 CE | 成立。改为两槽保守队列和寄存写入级；ready 只通过已寄存占用影响后续准入，不组合驱动宽总线写使能。 |
| flow 输入类型译码、stream_ready 驱动宽槽位控制 | 成立。输入数据先采样，类型和 ready 按八个 32 位分组寄存；快控制保持原始实时响应，事件数据经分组快照/写入级到队列。 |
| frame_address 自增与大扇出耦合 | 成立。保留 16 位主计数器，并拆成短进位段；各 Bank 增加 15 位地址寄存器，Bank 选择、有效和行写地址同步增加一拍。综合后确认主计数器 16 个 FF、本地地址 60 个 FF。此前已通过的输出寄存级继续保留。 |
| 雷达 FIFO 读出后应加一拍 | 方向成立。原来已有同步 `fifo_q`，但它会成为 BSRAM 读口，不能算额外的本地逻辑输出流水。本次增加 `point_record` 和 P_BUFFER 状态，将 FIFO 读口与角度除以 100 的量化逻辑分开，时间戳和错误/丢失 epoch 一起传递。 |
| VFH first 路径需要进一步分级 | 成立。将谷边界索引、heading 换算、范围判断拆拍；精确目标所在扇区的搜索也分开计算 heading。226 组独立参考结果一致。 |
| us_counter 产生的脉冲跨模块导致导航长路径 | 路径存在，但代码根因描述不准确。实际穿过 `sample_age_us` 的 32 位减法、`sample_stale` 比较，再进入导航 healthy 和状态提交门控，并非 us 脉冲直驱积分。改为注册过期标志，预先保存截止时间前一微秒，在原本的微秒边界断言。没有在导航健康链上简单延后一拍。 |
| 网络 action 扇出及 RX frame_length CE 过长 | 成立。最终保留原来的全局动作编码，每个不超过 32 位的数据字独立保存 one-hot 操作选择和 load，共 18 个局部数据字模块；ARP 头冻结后经 15 组寄存 load/shift 装入/移动，增加一个 ARP 装入周期。RX 预计算“下一字节计数是否在 64..128”，另寄存 255 饱和标志，EOF/增量使用这些结果。CRC、错误帧、邮箱和字节协议不变。 |

## 为保持语义做的配套改造

两个桥接器将快速有效性/停车控制与事件输出分开。快速控制仍使用当前输入和原始到期边界；事件侧数据与分类同时寄存，epoch 标识防止给旧观测套用新观测的有效期。
每次准入先预留队列空间，数据实际写入后才发布 event_valid；下游背压期间，已经发布的载荷保持不变。连续输入可以合并为最新状态，不能丢失最终状态或混合不同帧字段。语义桥的有效性/到期/帧号不匹配判断与未掩码数据一起寄存，写槽位时再进行掩码，不把比较器和字段写入放在同一长路径上。

预进位寄存器表示当前低位是否即将产生进位，只在对应计数器递增时推进；清零同时清除进位状态，冻结时保持。不能把简单的分段独立自增当作同一个计数器。

图像地址再加一拍后，行预填充总有效流水扩为四级。也修复了先前复现的 TOP=0 无补边条件；4×2 图像、2 行画布的原失败用例现在通过。12×24 图像另验证了行中跨越地址 255→256 时，分段进位、Bank 选择和像素顺序不变。

## 功能验证

- `tools/test_perception.py --events-only`：像素、跨 Bank、无补边、双槽位、读写时钟比、事件、公平性、精确到期、UDP/FCS/IP 校验均通过。光流数值模型复用哈希一致的已验证结果。
- `tools/task4/test_timing_refactor.py`：85,000 拍与固定 SHA 的旧 RTL 对照；覆盖跨 8/16 位进位、冻结、清零、刷新、语义帧号匹配/不匹配、快速控制和 LED。连续 500 拍输入另查事件字段与帧号一致、不乱序、不饥饿，最终帧保留。
- 同一脚本检查 IMU 阈值 0/1/7、微秒计数回绕、到期后刷新和提交恰逢计时边沿；已有真实 I2C 模型测试另覆盖 3ms 告警、10ms 看门狗、NACK/WHO/配置/总线异常恢复。
- 旧双网口黄金测试 47 帧逐字节一致，含 ARP、双目标重放、CRC/IP/UDP、缓存失效和坏包拒收。
- RX 长度另覆盖 63/64/65/127/128/129 和 254/255/256/300 字节，检查饱和、坏 FCS、后续正常接收与邮箱释放。
- VFH 226 组参考通过；导航 STOP、租约、IMU 过期、原始障碍、里程计和 RPP 测试通过。
- 本轮冻结源码的整机仿真通过：360 点独立最近回波参考、视频/事件并发、七类状态、电机未 ARM 时输出低、UART 空闲。该测试强制 PHY 初始化并注入视频，不代替实物启动验收。

弹性队列测试台改为在稳定的时钟相位采样，允许合法的 valid 气泡，仍严格检查 300 条向量的顺序、背压不可变性、复位隔离和无重复输出。没有放宽数据检查。

## MPW 与 PR1014：成立的事实和不能直接下的结论

用户按旧报告计算 `4ns − PLL 早晚差 − 时钟网络早晚差`，能解释那一条 MPW 报告的数值。但 tNET 随布局/布线而变，数值不是由“125MHz + generated clock”决定的恒量；相邻两轮已经分别出现 −0.849ns 和 −0.844ns。仅凭这条报告也不能断定工具是否或如何应用 CPPR。

已核查稳定静态版的综合网表：其中七个 BSRAM 都在 `lidar_scan_360_source`，时钟为 `clk50m_d`，没有 eth125 图像帧缓存 BSRAM。这部分判断正确，说明两种顶层的时钟负载和脉宽检查对象不同，不能把静态版通过等同于整机时钟无问题。

静态版最差 MPW 的具体对象是 `network/telemetry_bridge/dst_payload_417_s0`：STA Actual Width=0.246ns，Required Width=0.225ns，裕量 +0.021ns；其 PLL 早晚差仍是 1.966ns，时钟网络早晚差为 1.788ns。整机 BSRAM 的要求则为 0.900ns。这进一步支持“检查对象和时钟树预算不同”，但这些是 STA 计算值，不能当作示波器测量。

PR1014 确实仍涉及 camera_pclk_d 的物理输入走线；数据流水不能消除它。没有把 PLL 输出重新声明成无关时钟，也没有修改 MPW/告警验收条件来制造通过结果。

## 本轮物理结果

两轮物理试验均正常完成。第一轮全局 setup 统计 537（sys50=13、eth_rx125=7、eth125=517），光流桥与原计数链问题改善，但全局 one-hot 动作没有解决网络宽载荷扇出，不能把总数小幅下降视为充分修复。因此最终采用局部数据字控制，修正 RX 饱和、图像分段计数和语义桥掩码分级。

最终结果（约 599 秒）：

| 指标 | 修改前 `155742Z` | 最终 `172152Z` |
|---|---:|---:|
| 工具 setup 违规端点统计 | 550 | 6 |
| hold 违规 | 0 | 0 |
| sys50 违规 | 38 | 0 |
| eth_rx125 违规 | 4 | 0 |
| cam_pclk / control50 违规 | 0 / 0 | 0 / 0 |
| eth125 违规统计 | 508 | 6 |
| 最小脉宽裕量 | −0.844 ns | −0.849 ns |
| 寄存器 | 38994 | 40659 |
| 逻辑 LUT/ALU | 48955 | 49528 |
| BSRAM | 236/340 | 236/340 |
| DSP | 73.5 | 73 |
| PRIMARY / LW | 5/8、5/8 | 5/8、5/8 |

新增 1665 个寄存器，约占器件寄存器容量 1.20 个百分点；BRAM 没有增加。sys50 最差 setup 裕量 +0.594ns，eth_rx125 最差 +0.266ns。

图像路径定向检查完整覆盖：主地址计数器 16 个端点最差 +3.324ns，本地地址 60 个端点最差 +4.540ns；BSRAM→本地输出 64 个端点最差 +0.538ns，本地输出/选择→cached_word 16 个端点最差 +3.710ns。原文所列 age/idle_cycles、flow_bridge、图像读地址/数据、雷达量化、VFH 和 IMU 过期计算路径已不在失败路径中。

### 剩余六个端点

工具的 setup 总计包含四条数据 setup 和两条异步复位释放检查。默认 setup 路径表只显示前四条，必须同时阅读详细 Recovery 报告，不能漏掉后两条。

| 源 → 目的 | 裕量 |
|---|---:|
| net/parse_state → net/retry_count2[9] | −0.058ns |
| net/clear_cache2 → control_words[2]/operation[7] | −0.028ns |
| net/clear_cache2 → send_length_words[0]/operation[7] | −0.021ns |
| net/retry_count[2] → net/retry_count[8] | −0.009ns |
| perception_reset/release_pipe[2] → bridge/have_latest_s7/CLEAR | −0.069ns |
| perception_reset/release_pipe[2] → bridge/have_latest_s9/CLEAR | −0.062ns |

最后两条复位释放路径的网络延时为 7.358ns，复位驱动扇出 871，属于下一步需处理的局部复位分发问题。没有把它们加入 false path。其余四条需要继续处理重试计数/缓存失效调度控制。

MPW 和 PCLK PR1014 仍未通过，故整机 `passed=false`，没有下载。位流 SHA256：`50e1a2b6ba466ce55fd9ac65c9b36bcbd0eb74dba02331a2c3c8d9b2435b7a70`。
完整证据为冻结目录中的 `result.json`、`test_result.json`、`frame_read_timing_audit.json`、`routing_diagnosis.json` 和 `impl/pnr/sensor.tr`。工作树中网络文件的末尾空白清理单独记在 `working_tree_formatting.json`，冻结的编译输入未改动，逻辑文本一致。
