LilywantbecomeNIUBI/fpga-system-integration/docs/BOARD_SENSING_20261031.md

# 2026-10-31 感知系统首次集成上板

已用实验候选完成IMU、双目标图传、Nano YOLOv8n及FPGA目标LK的现场联调；
独立环境光流先后两次停滞，整体感知验收未通过。没有修改RTL或生产上位机代码。
用户说明当前编码器来自无刷电机，本轮不测试编码器、底盘或平衡控制。

## 候选和现场连接

位流采用2026-10-30最终Place 2 / Route 1候选，SHA256：
`2cdcd3b5ef230803076bee9ee2459d907492653605ee032888d4a11317610fd4`。
下载前核对构建和回归输入哈希、位流哈希；JTAG location 290、器件ID `0x0011081B`。
用户确认电机12V断开后，两次仅执行SRAM Program，同一候选均收到Finished；未写Flash。
这是下载输入及Programmer完成记录，不是FPGA内位流哈希回读。

Setup/Hold=0/0、Setup最差+0.012ns；MPW −0.688ns仍未决、未豁免。
PR1014仅保留既有B1接线的限定配置豁免，整体timing_signoff仍为false。
实测不解除这些时序边界，也不证明停滞由MPW导致或MPW是假违例。

PC有线192.168.50.10与FPGA 192.168.50.30建立1Gbps链路。
最终slot 0发送到PC UDP6104，slot 1发送到Nano 192.168.50.20 UDP6102；
感知事件UDP6202随slot 1发送到Nano。PC综合传感页为
<http://127.0.0.1:8875>，通过Nano HTTP8766读取检测和感知事件。
PC临时网关独占COM20、115200，IMU和电机遥测共用该串口；没有部署Nano串口网关。
8872为早期测试会话，后续图传已经移到8875。

Nano使用独立目录`/home/liwei/robot_sensing_board_20261031_002906`，
36个部署源文件逐项哈希核验。复用原目录的YOLOv8n FP16 TensorRT引擎，
模型未改、旧工程未覆盖。临时启动包装器额外保存原始感知事件；包装器哈希单独记录。
首启模型目录参数错误导致FileNotFoundError，修正为现有`models/yolov8n-coco-320`
后正常加载；错误记录保留，不计为成功推理。

## 观测结果

| 项目 | 现场结果 | 适用范围 |
|---|---|---|
| IMU静态20秒 | 1002个上传样本；原始采样约1002.53Hz、上传50.13Hz；WHO_AM_I=0x47；CRC、序号丢失、传感器错误均0 | 静态通信/采样检查通过，未做安装轴和零偏标定 |
| 双目标图传 | PC和Nano均收到真实320×320 RGB565画面；坏包格式计数0 | 存在缺帧，不是无损验收 |
| YOLO | 用户摆放真实饮料瓶，class39、置信度约0.87～0.90；FPGA收到语义反馈并应答 | 非静态图片或人工框替代检测 |
| 目标LK | 用户左右移动瓶子；初始窗口38个采样点track_valid，质量875～1000‰，原图框中心X范围558～893 | 观察到真实跟踪；仍有边界/颜色失效，不代表持续全程有效 |
| 独立环境光流 | 同位流重载后恢复连续向量，随后再次停滞 | 未通过 |
| 避障 | 超时后显示unknown、停车建议、速度建议0；向量推进期间状态也曾间歇过期 | 失效遮罩可观察；未完成真实障碍方向/风险响应验收 |

模型加载前后的窗口分别保存，不能混用累计fps。最后44.53秒稳定窗口：

| 数据 | 增量/实测速率 |
|---|---|
| PC视频 | 1329帧，29.85fps，缺7帧，坏包0 |
| Nano视频 | 946帧，21.25fps，缺382帧，坏包0 |
| Nano推理 | 943次，21.18fps |
| IMU | 2233个上传样本，CRC及序号缺口新增0 |
| LK | 87次状态采样中46次track_valid |
| 环境流 | 87次采样均过期，帧号固定7016 |

Nano部分反馈已到14帧年龄边界，并出现拒绝计数增长；不能据此宣布满帧率并发通过。
原始事件日志与较频繁的HTTP轮询均开启，它们对接收和推理负载的贡献尚未分离。
网关最终UART CRC累计1，重载之后的上述稳态窗口新增0；不把整场累计写成0。
网关记录队列丢弃0、记录错误为空。

## 复现的待修问题

1. **环境流局部停滞**：首次结果帧停在2197，最后保留向量为序号70、坐标(112,32)。
   真实相机/目标事件继续前进，OFST仍发送但为stale，cycles和dropped_frames持续变化。
   同位流重载后恢复，记录到4103个不同环境流结果帧及523832个向量包；随后再次停在7016。
   最后原始事件尾段包含3886个OFST，帧号全部为7016，且没有OFLW，丢帧从3839增至7724。
   这排除了仅页面缓存不更新；求解器/握手/实现层根因仍未定位。
2. **避障状态更新稀疏**：上述重载后样本中仅338个OFST，相比连续向量帧明显不足。
   源端状态生成、CDC、仲裁与接收端负载尚未分离，不能直接称为网络丢包。
3. **接收器复位帧号恢复**：SRAM重载后两个图像组帧器保留旧完成帧号28273，
   新低帧号的数据包仍到达，但画面/推理不再推进。现有AutoAssembler只在静默后
   捕获到fid≤32时开启新代次，端点重新配置可能错过该窗口。
   本次重建独立图像接收会话后恢复；生产代码尚未修复。
4. **Nano并发吞吐**：稳定窗口约21fps，并有明显缺帧和语义时效压力。
   需要分别测量UDP接收队列、组帧、事件处理、HTTP快照和推理线程，不能只看GPU单次耗时。

下一轮应先增加环境流grid/patch/divider状态、完成握手及阶段周期的只读诊断，
定位停滞，再验证超时恢复；同时修正图像接收代次处理并分离Nano负载测量。
自动重启不能替代停滞原因定位。

## 证据和运行边界

归档摘要：[evidence/board_sensing_20261031/summary.json](evidence/board_sensing_20261031/summary.json)。
其中保留下载日志、静态UART原始压缩数据、并发窗口统计、部署清单、原始事件尾段及摘要，
全部带SHA256。完整原始文件和临时启动程序位于本机
`runs/commissioning/system_static_20261031_002906/`，未包含凭据或令牌到证据目录。

Nano与PC墙钟约差12小时，未假定时间同步；结论使用设备帧号、事件顺序及各自本地时间间隔，
不提供未经同步的跨设备精确延迟。

没有发送ARM、DRIVE或非零目标，直连静态脚本及临时网关只发送STOP。
最终未ARM、两轮应用输出0。编码器输入不用于本轮判断，旧无刷驱动关闭输出保持原固件逻辑。
没有测试自动运动、平衡、真实障碍方向响应或温压范围，也没有消除既有MPW和PCLK路由问题。
