LilywantbecomeNIUBI/fpga-system-integration/docs/closed_loop_20261029.md

# 有刷轮速闭环与专用调参台 — 2026-10-29

本次仅修改本仓库的有刷独立工程和系统集成电机路径。原无刷仓库保留；系统摄像头、网络与 IMU 路径保留。未下载 FPGA，未启动实物电机，未测试雷达。

## 最终行为

- 删除 `estop_n` 顶层输入、控制复位依赖和有效管脚约束。P7-37/F18 未使用，不接 P7-29→37 跳线。
- 删除轮控制器的开环路径、CLI 模式选择及网关 `permille` 入口。ARM/DRIVE 要求 flags bit0=1、Kp>0，旧开环命令会被拒绝。
- 保留上电锁存、CLEAR→ARM 零目标确认、STOP、FPGA 250ms 有效指令看门狗、网关 200ms 心跳/遥测超时、输出限幅、斜坡、换向等待及编码器异常保护。
- 仅提供轮速 PI。目标/反馈为四倍频计数/10ms，不假设 Xp28 减速比、每圈计数、轮径或方向。默认 50MHz、100Hz 控制、10kHz PWM、±300‰ 限幅、20‰/周期斜坡。
- 混合串口保持电机 48 字节/20Hz、IMU 48 字节/100Hz。旧无刷 16 路输出保持低。

## 专用上位机

`python host/motor_tuner.py` 默认启动离线页面 `http://127.0.0.1:8874/`。上位机只访问已有网关，不打开 COM20，也不绑定视频、推理或 IMU 端口。原 8872 视觉/IMU 状态台保留观测入口与 STOP。

界面包含左右目标/反馈曲线、Q8 PI 参数、电机/编码器方向、占空比、位置、故障与累计非法跳变、单轮选择、显式解锁、STOP、100..5000ms 限时测试和 CSV 日志。CSV 包含配置与运行模式。默认目标为零；解锁本身不发非零目标。参数变化需先停机再解锁。

网关固定限时测试的目标与截止时间，心跳不能改变目标或延长测试；到期 STOP 并释放控制。切换窗口、隐藏/关闭页面会释放控制；失联、故障、网关重启后均不自动重新解锁。页面要求网关具有 `timed_test_supported` 能力，旧进程不会开放解锁。

实际连接须先更新并重启唯一网关，再使用：

```powershell
python host/motor_tuner.py --live --token-file runs/commissioning/sram_static_20261029_143616/session_token.json
```

令牌仅在本机读取，不打印、不提交。不要并行打开第二个 COM20 连接。现有正在运行的现场网关和状态台未由本次改造自动替换；8874 提供离线预览。

## 验证与边界

22 项 Python 回归、电机/编码器/PWM/串口仿真、LK 与双目标 UDP 回归、完整生产顶层数字仿真均通过。顶层仿真中记录 15 个 IMU 样本、18 个控制周期和 285919 个以太网发送字节，并验证 STOP 关闭输出。传感器与 PLL 使用行为模型，不代表板级电气、机械运动或闭环实车通过。

浏览器通过完全模拟的 HTTP 网关验证零目标解锁、左轮单独限时测试、到期停车、控制权释放和恢复后保持停机。模拟反馈不能证明真实编码器或电机状态，结果见 `docs/evidence/closed_loop_20261029/`。

集成和独立电机工程均已完成 Gowin 综合布线，源码哈希一致，Setup/Hold 均为零违例。集成位流 SHA-256 为 `6e2c3673da3f7b59ec3bedc7f4c8b8f929f10872138157213d3eaf8d9bb95ef6`，独立电机位流为 `b6f7f2cc6c4ea10872be17c30efa8566a34dd7cf7cc2391c055b5c63d147ae25`。125MHz 最小高脉宽裕量仍为 -0.688ns（实际0.212ns，要求0.900ns），完整时序签核未通过。Setup/Hold 零违例不能覆盖 125MHz 最小脉宽和摄像头 PCLK 通用路由问题；未改变时钟频率或放宽约束来规避这些告警。

## 下一次现场操作

当前物理供电未知。本轮没有执行下载或实车运动，磁盘上的新位流不能证明 FPGA 内当前运行版本。

1. 区分 FPGA 的 USB/逻辑电源和 D157B 电机驱动的 12V 电源。先断开驱动 12V，保持逻辑观测；软件 STOP 不等于物理断电。
2. 复核两路电机、四路驱动信号、AB 编码器与共地。左驱动 P7-21/22，右驱动 P7-23/24；左 AB P7-25/26，右 AB P7-27/36。用户确认编码器使用 3.3V；ADC 已拆离。杜邦线可能松动，先确认接触可靠。
3. 分别手转左、右轮，检查反馈独立、方向可解释、静止稳定及非法跳变。此前左轮一次手转净 -223 计数同时增加 118 次非法跳变，右轮尚未可靠验证；不能屏蔽保护或用闭环加力掩盖此问题。
4. 反馈可靠后，再单独安排 SRAM 下载，重新检查零输出遥测与 STOP/CLEAR/ARM 确认；下载不与转动合并，不烧 Flash。
5. 真正转动前重新确认驱动供电、双轮悬空、线缆和人员状态。之后才由操作员显式解锁与选择单轮限时测试。两轮闭环、方向和物理速度标定仍需实车验收。

旧日志中 `clear_ack` 后 `arm_ack_timeout` 的根因尚未在实物上证实。取消外部许可只消除了该软件依赖，不证明串口下行、编码器接触或电机链路已经恢复。
