LilywantbecomeNIUBI/fpga-system-integration/docs/encoder_review_20261030.md

# 有刷AB编码器资料、RTL与实测日志复核（2026-10-30）

## 结论

现有证据支持“累计非法跳变不等于位置持续错误”。清零复测中的1188次错误集中在位置不变的一小段，之后有较长的有效位置变化且不再报错。不能再仅凭累计值非零，就判断编码器持续失效或禁止一切后续验证；也不能据位置数字有变化就认定精度、方向、左右映射及100Hz速度反馈均已通过。

物理根因尚未确定。实际A/B原始状态轨迹和具体手转动作没有同步标记，无法把异常定为器件损坏、串扰、接线错误、供电变化或RTL/实现故障。本次只做离线研究，未修改生产RTL/保护门限、未下载、未发运动命令。

## 厂家资料

本地资料根目录：`D:/活动/比赛/电赛/FPGA/硬件资料/【WHEELTEC】AT8236驱动模块附送资料/【WHEELTEC】AT8236驱动模块附送资料_V2.8_2026.07.25/`。

1. `2.编码器的使用教程与测速原理/编码器波形与原理简述.png`：A/B有相位先后，用于判转向；编码器需要3.3～5V供电，高电平随供电。它不提供本车准确线数，也不能证明实车脉宽、相位或板级电压。
2. `1.用户手册与教程视频/编码器测试相关说明.txt`：示波器双通道测AB，分别确认供电和输出；万用表平均值只能粗查有无翻转，不证明正交质量。
3. `1.用户手册与教程视频/AT8236带稳压模块问题排查和检测方法(2025.07.10) .pdf`第7页：D157B编码器部分主要承担导线和供电，AB由主控读取，不经过AT8236电机功率控制逻辑。旧资料的5V示例不替代本车已确认的3.3V版本。
4. `1.用户手册与教程视频/电机驱动模块使用手册—AT8236-2025.08.27.pdf`第17～18页：TIM编码器模式使用CH1/CH2；应把采样频率、倍频、减速比、编码器线数纳入速度计算，不能套用裸计数目标。
5. `4.例程源码/1.STM32例程/2.D157B例程/`四个ZIP内的`encoder.c`和`tim.c`已经读取：

|例程|编码模式|滤波写法|方向|
|---|---|---|---|
|霍尔标准库2025.7.8|TI12，四倍频|TIM_ICFilter=10|Read_Encoder保留符号|
|GMR标准库2025.7.8|TI12，四倍频|TIM_ICFilter=10|Read_Encoder取绝对值|
|霍尔HAL 2026.8.18|TI1，二倍频|IC1Filter=0、IC2Filter=0|本次仅核对初始化，未据此认定整体控制行为|
|GMR HAL 2026.8.18|TI1，二倍频|IC1Filter=0、IC2Filter=0|同上|

标准库文件的滤波初始化只有一次TIM_ICInit，不能由“10”推断两路等效滤波时间，更不能将10当作10个时钟或10ms。HAL与标准库的倍频和滤波均不同，不存在一套可不经核对直接照搬的统一配置。之前sources.md对已读标准库的描述不应扩展到HAL版本。

## 对照当前RTL

`fpga/motor/encoder_ab.sv`使用50MHz时钟、两级同步，候选AB二位向量稳定后更新stable。默认FILTER_CYCLES=8，从候选建立到稳定提交约9个时钟（约0.18us），另外还有同步、译码寄存器延迟；不是8ms级去抖。

正常状态变化每次只翻转一位，四倍频增减计数；previous XOR stable为11时累计invalid_count，但step=0，位置和窗口计数都不增加。两位跳变既可能是漏掉中间状态，也可能是两路相关扰动；现有计数不能区分二者。

共同AB稳定滤波不会保留任何比稳定门限更短的中间状态。因此在不知道实际最短有效相间隔前，不应盲目大幅加长滤波；否则可能将原本可解码的相邻变化合并成对角跳变。手转下滤波门限是否是主因仍需实际波形，不凭50MHz名义频率作结论。

通用四倍频解码中把对角状态变化视为无方向信息并忽略，并非本工程特有规则。参考Microchip QEI参考手册Table 15-1，第15-3页：<https://ww1.microchip.com/downloads/en/devicedoc/s15.pdf>。这不意味着Microchip硬件的输入滤波与本工程完全等效。

## 按时间重读清零复测

日志源：`runs/commissioning/speed_live_20261030_021751/gateway/20261030_021751_*/fpga_uart.bin`（目录内实际记录），以`zero_retest_before.json`与`zero_retest_after.json`的packet 4569～6025定位。离线解码该窗口1457帧，整段抓取CRC错误0。

|片段|记录事实|
|---|---|
|packet 5401～5468，约3.35s首末间隔|左累计非法跳变1670→2858，新增1188；有增量的64个遥测间隔中，左位置差均0、该帧左速度均0；最大每相邻20Hz帧新增34|
|packet 5468～6025，约27.85s|左非法跳变恒2858；左位置最小−16941、最大−8462，跨度8479；这说明有明显位置变化而没有新增错误|
|右轮|本次窗口右非法跳变恒1；终点位置仅比起点增加1，不能认定右轮完成有效转动|

错误段“位置无净变化”是遥测事实，不等于物理轮子绝对静止；50ms内正负增量可能抵消，速度字段只代表最近10ms，不能还原整个50ms内每个控制窗口。没有把1188当作丢失1188个真实位置脉冲，也没有按此计算位置误差百分比。

该模式符合“对角扰动被忽略、随后正常计数”的一种解释，但现有数据不能证明具体电气原因，也不能证明之前没有丢数。归纳为持续位置失真过于武断；将累计错误当作完全无害也证据不足。

## 实际RTL离线实验

研究台：`tests/diagnostics/tb_encoder_research.sv`，50MHz、FILTER_CYCLES=8，输入边沿与时钟错开，变化不同驻留时间。

|输入|实际RTL结果|说明|
|---|---|---|
|200圈理想四状态正转再反转|+800再回0，invalid始终0|未发现该干净输入下误报|
|00→11→00的相关双线扰动|位置仍0，invalid增加2|位置净值可不变，同时存在错误诊断|
|实际正转中00→01→11的01状态未被接收|整圈期望+4，接收+2、invalid增加1|某些非法跳变确实意味着丢计数|
|00→01→00的单相来回变化|位置0，invalid0|并非所有干扰都会被这个指标发现|

这些是构造输入的离线机理验证，不是对实车AB波形的重放，不能凭相似性确定物理根因。输出存于`build/encoder_research_20261030/rtl_research.log`；时间分析存于同目录`capture_analysis.json`。

## 保护与下一步

当前FPGA保护不是“累计非零就停机”。`motor_core.sv`每10ms更新上次计数，只在已ARM且某轮本周期新增大于8时锁存bit2。STOP状态也更新统计基线，所以历史累计1188不会在下一次ARM时自动等价为本周期1188次。诊断累计不应直接作为全程有效性判据；现有20Hz日志也不足以反推出每个10ms窗口是否会越界。阈值8是本工程初版值，不是厂家规定。

优先验证“计数是否可信”：供电稳定、STOP下明确标记单轮动作起止，检查只转一轮时另一轮不跟随；标记轮子起点，重复同向整圈计数并检查重复性，再验证往返一致性（考虑减速箱回差、编码器分辨率和手转定位误差）。同时按运动段/非运动段分别统计新增非法跳变，而不是只读总数。不能用尚未确认的Xp28减速比和霍尔/GMR线数算伪精确RPM。

如果仍有“位置不变但invalid快速增加”的段，下一项固件诊断应记录原始AB边沿、滤波后AB、对角跳变方向（00↔11或01↔10）、合法正/负增量和100Hz窗口统计，并保留独立停机。由这些证据决定是否需要独立双通道滤波、滤波参数调整或保护策略调整；本次没有屏蔽保护。

## 后续左轮约半圈检查：发现两路同时响应

用户提出大致转半圈。先STOP并保存起点，明确提示保持供电不变、只转左轮前进约180°、右轮不动；用户回复“半圈完成”。起点左右速度/输出均0、未解锁，新鲜遥测。

原始位置左−18404→−18766（−362），右20681→21500（+819）；左非法跳变11288→11521（新增233），右恒1（新增0）。终点左右速度/输出均0，保持STOP。

按本次首末遥测序号筛选原始UART的824帧，CRC错误0。左右两路第一次变化都在packet 15645，最后变化都在packet 15743；左47个变化间隔、右48个变化间隔。此结果支持两路在同一物理动作期间同时响应，不能用旧累计或前后不同操作来解释本窗口两路响应。

在用户确实仅转左轮的前提下，应优先检查实体轮与显示通道的对应、AB输入独立性或相关耦合，不能只将其归为左编码器位置算法故障。这个证据不能直接区分接线、板级耦合或固件路径错误；还需分别标记实体左右轮并检查四个输入。不要将362或819简单乘2并填写CPR，因为当前独立性未通过且转角为估计值。

本次原始端点及汇总：`runs/commissioning/speed_live_20261030_021751/half_turn_20261030_023023/`。未发送ARM/DRIVE或非零目标。

### 提醒补共地后的再次约半圈检查（02:36:37起点）

用户报告前次没有连地，告知D157B GND接ENC1-5或FPGA GND、不并联3.3V电源。再次提示确认共地、保持供电、STOP下只转左轮前进约半圈，用户回复完成并明确“不是很准的半圈”。此回复不代替实际电气通断测量。

本次左位置−21810→−22090（−280），右位置变化0；左非法跳变新增147，右新增0。终点新鲜遥测、左右速度/输出均0、未ARM。相较前次右通道同步响应，本窗口右通道未跟随，是独立性改善的证据；不凭单次窗口确认所有串扰已消除，也不能把−280乘2作为准确CPR。左新增诊断仍存在，需继续判断其对应输入状态和位置误差。原始端点及汇总：`runs/commissioning/speed_live_20261030_021751/half_turn_ground_20261030_023637/`。
