LilywantbecomeNIUBI/fpga-system-integration/docs/left_encoder_alt_20261030.md

# 左编码器换脚候选与可用IO盘点（2026-10-30）

当前ADC复用版本左AB使用P7-25/B17、P7-26/B18。为比较输入管脚和载板走线，独立准备左AB换脚固件；不修改解码器、PI、右轮、驱动输出及电机保护。不预先认定旧IO或电路损坏。

## 选定的独立备选

|编码器线|新P7|FPGA球号|原载板信号|载板取线点|
|---|---:|---|---|---|
|左E1A|31|F16|ENC1_CLK|J_ENC1 第3脚（CLK）|
|左E1B|32|E17|ENC1_DO|J_ENC1 第4脚（DO）|

两路均约束为LVCMOS33输入。须先拔掉原ENC1/MT6701模块及信号连接，避免DO输出与D157B编码器相连。J_ENC1第1脚是载板3.3V输出，第2脚是原CS，第5脚为GND；只使用已核对的信号脚及共地，不并联D157B和载板电源输出。

P7针号与FPGA封装坐标相对旧脚更分散，但不保证实际PCB线长或物理距离，也不代表换了供电Bank。单靠封装坐标不能判断芯片内部距离。本候选用于对比IO/走线，不能证明或排除Bank供电问题。

构建入口：`python tools/build_motor.py --left-encoder-alt`。独立工程为`build/motor_left_alt/motor.gprj`，位流为`build/motor_left_alt/impl/pnr/motor.fs`。标准`build/motor/`和`hardware/pins.csv`保留原映射。下载工具必须显式加`--left-encoder-alt`才选择本候选，并校验固定哈希；默认仍选择标准目录。

候选CST与标准CST对比只改变left_enc_a（B17→F16）、left_enc_b（B18→E17），无重复球号。所有其余约束保留。构建和离线检查不代表已经下载或板级通过。

候选构建完成：Setup/Hold违规均0，源码哈希与构建记录一致。P&R引脚报告确认左AB为F16/2、E17/2，右AB为C18/2、D19/2，均为LVCMOS33（仍在Bank 2）。候选位流SHA256为`be049edb9456adf52f59454b9aff5829289c93f32b4ee524b8d79c6b81ddd78c`。

## 本次下载与静态结果

2026-10-30用户明确要求按本方案下载。先通过原网关STOP并正常关闭网关，再由下载进程独占COM13，直接发送STOP并收到未使能、零输出确认。未将未确认的12V物理断电状态记为已断电。

执行`python tools/commission_motor_static.py --port COM13 --left-encoder-alt --verify-stop`，扫描location 354、设备ID 0x0011081B，SRAM Program显示Finished。未写Flash，未发送ARM/DRIVE。

下载后5秒收到100帧电机状态，CRC错误0，双轮速度/占空比均0且未使能。左非法跳变在首末帧均为1（静态窗口内未增加），右均0；不能写成左非法跳变累计为0，也不能据此判定手转通过。日志为`runs/commissioning/speed_static_20261030_005430/`。随后恢复唯一串口网关与8874调参页，保持STOP，等待手转对比验证。

## 断电后重载与手转重测

2026-10-30后续用户要求再测。起初网关无有效遥测，用户确认FPGA尚未供电；之后明确确认FPGA已供电、D157B 12V断开。重载同一P7-31/32位流至SRAM，日志`runs/commissioning/speed_static_20261030_021729/`：100帧、CRC错误0、未解锁零输出，左右非法跳变首末均1。

恢复网关，保存手转前基线：左右位置均0，非法跳变均1。用户按提示接通D157B 12V，在STOP下按前进方向先左后右手转，并回复完成。完成后快照左位置−6799、右+3688，左非法跳变1670、右1，即本轮左新增1669次、右新增0次。该快照左窗口速度为11，不宣称快照时两轮均物理静止；左右输出均0、未使能。

上述汇总包含接通12V及手转前后全部时段，不能据此判定手转过程中一直存在非法跳变。起点/终点保存于当次`speed_live_latest.txt`所指目录的`manual_retry_before.json`、`manual_retry_after.json`及`manual_retry_summary.json`。该summary的`encoder_check_passed=false`及“换脚未消除异常”结论过于宽泛，以下按时间复查予以更正；原始记录不覆盖。

### 用户指出手转时无新增非法跳变后的复查

原始UART共3069帧，CRC错误0。左非法跳变最后一次增加发生在packet 943（1669→1670）。从该帧起往后的2416帧中，左位置从−3280变化至−10239、位置跨度6964，最大速度绝对值22计数/10ms，但非法跳变始终1670；右非法跳变全程为1，无新增。这支持后续手转过程中计数变化且未新增非法跳变，与用户页面观察一致。

不能把接通12V前基线到终点的1669次增量全部归因于手转。较早跳变的具体现场动作未同步标注，尚不能确定是供电切换、接触变化还是更早手转产生。撤回仅凭汇总就认定新引脚下左手转仍异常、以及据此要求立即对调AB输入的结论。后续应在编码器供电稳定后设起点，按明确起止窗口验证。此复查不代表动力闭环已通过。

### 页面实际清零后的独立复测（02:21:53）

用户要求清零再测。先STOP并读取新鲜状态，左右速度与输出均0、未使能；基线原始位置为左−17910/右3688、非法跳变1670/1。通过浏览器点击“本次计数清零”，页面显示位置0/0、非法跳变0/0及起点02:21:53。随后提示保持供电不变、先左后右手转，用户回复完成。

完成后页面明确显示左新增非法跳变1188、右0，原始累计2858/1，原始计数与HTTP状态一致。右轮本窗口位置只变化1计数，不能确认右轮有效手转或通过。左位置在后续观察中仍改变，不将不同读取时刻的位置当作固定终点；非法跳变在页面快照及HTTP终点均为1188新增。全程STOP、未使能、零输出、串口错误帧0。

本次确有清零后的新增非法跳变，不能解释为历史累计；发生于该手转检查窗口，但具体信号根因仍未知。截图`runs/commissioning/zero_retest_result_20261030.png`，本次网关目录中的`zero_retest_before.json`、`zero_retest_after.json`保存原始端点。未做动力闭环。

## P7候选资源

下表是当前软件未分配给底盘有效信号、可在解除旧电路占用后复用的资源，并非已经证明实物悬空。

|P7|球号|原网络/载板端点|复用条件|
|---:|---|---|---|
|28|C19|ENC1_CS_N / J_ENC1-2|断开旧ENC1；板上原CS上拉支路仍在|
|31|F16|ENC1_CLK / J_ENC1-3|断开旧ENC1；本次选为左A|
|32|E17|ENC1_DO / J_ENC1-4|断开旧ENC1输出；本次选为左B|
|33|D20|ENC2_CS_N / J_ENC2-2|断开旧ENC2；板上原CS上拉支路仍在|
|34|C20|ENC2_CLK / J_ENC2-3|断开旧ENC2|
|35|E19|ENC2_DO / J_ENC2-4|断开旧ENC2输出|
|37|F18|LIDAR_UART_TX / J_LIDAR_CORE1-2|当前无外部许可用途；确认旧雷达/串口连接断开，原R_LTX支路仍在|
|38|E18|LIDAR_MOTO_CMD / R_BASE1-1|连接雷达电机两管缓冲输入，不优先用于编码器输入；载板MOTOCTL输出不是同一直接GPIO网|
|9|E13|M1_FAULT_N / J_DRV1-14|仍可能连接旧驱动故障输出，不优先；先完全隔离|
|20|B16|M2_FAULT_N / J_DRV2-14|仍可能连接旧驱动故障输出，不优先；先完全隔离|

P7-39/40保留IMU；P7-36仍为右编码器B；P7-21～24为D157B驱动、27为右编码器A。旧无刷PWM/EN/CAL继续固定低，不挪作本次输入。11/29为电源，12/30为地，不是GPIO。

载板端点依据`D:/活动/比赛/电赛/FPGA/Carrier_Hall_RevB/GPIO_40Pin_映射.csv`与`接口与丝印说明.md`；当前实物版本和观察朝向仍须按丝印/针号确认。新候选下载前须断开驱动12V、保留逻辑供电、正常释放唯一串口占用；新固件与新接线必须成对使用，先STOP手转反馈再安排动力测试。
