LilywantbecomeNIUBI/fpga-system-integration/docs/MOTOR_IMU_20261030.md

# 电机＋IMU接入与运动阶段入口

用户现场确认2026-10-30六段起步、停车、左右转基本正确。该反馈支持低速基本动作，不替代整题路线、转角、导航或高速验收。轮径65mm；约1500计数/圈仍为粗估，1m/s尚未达到。

## 数据与端口

- PC上位机8874：`/home`入口、`/motor`轮速及同页IMU面板（`#imu`）。刷新当前服务即可显示。`/imu`独立页在下次正常重启上位机后也可使用。
- Nano网关8873：现有本机配置选择的地址；电机与IMU共用Nano CH340 UART，115200 8N1，唯一串口拥有者仍为Nano。
- FPGA IMU：P7-39/F19 SCL、P7-40/F20 SDA，3.3V逻辑与共地；ICM42688 WHO_AM_I应为0x47。I2C采样1kHz、UART每20个样本取1个，即约50Hz。
- 视觉台沿用8872，图像UDP6102、事件6202等依配置；本次没有启动或宣称验证摄像头链路。IMU不需要另开PC串口或视频端口。

IMU面板显示新鲜状态、三轴加速度/角速度、主机估算俯仰与横滚及CRC/采样信息；过期清空读数，航向角未实现，IMU当前不参与电机控制。

## 候选与验证

构建：`python tools/build_motor.py --left-encoder-alt --pwm-limit 350 --with-imu`。

独立输出目录`build/motor_left_alt/motor_pwm_350_imu`，保留左P7-31/32、四路上拉、左连续性解码/右A双边沿、35%PWM限幅、Kp4096/Ki128使用方式。原电机默认版仍为300‰且不开IMU，旧系统顶层未改成本车当前引脚版，不能直接下载旧system.fs替代。

候选SHA256 `fcc7f652f09718bd91977144d5fe75b05b28d764e9572c6e547714c3c4586e6e`，Setup/Hold违规0/0。新增真实I2C模型＋混合UART仿真验证电机、IMU、编码器诊断、轨迹四种帧及CRC0，STOP输出保持关闭；44项Python回归及三组Node页面测试通过。摘要见`docs/evidence/motor_imu_20261030.json`。

用户随后确认12V断开、逻辑/JTAG/UART保留且IMU已连接。上述候选已SRAM下载成功，Flash未写；55次静态查询确认轮速和IMU同时在线，未ARM、零输出。IMU WHO_AM_I=0x47、原始采样约1002.5Hz、上传约50.1Hz，传感器错误、IMU CRC错误和发送丢帧均0。下载切换时网关累计UART CRC为1，随后30次连续观察未新增（仍1）；8874转发的新鲜IMU也通过。板上证据见`docs/evidence/motor_imu_board_20261030.json`。当前电机12V仍按用户最后确认断开，未发送运动指令；恢复动力须再次获得现场确认。

静止加速度约Z=-1g，姿态约横滚-177°，反映传感器安装坐标朝下，不可直接把该值作为车体倾角控制。整题运动测试前需明确前向/竖直轴、零点与角速度符号；航向角和完整运动闭环尚未接入。

本次尝试正常重启8874被自动审批策略阻止，故保留原服务，通过即时读取HTML的既有路由呈现IMU面板，无需重启；独立`/imu`路由待下次重启生效。
