LilywantbecomeNIUBI/fpga-system-integration/docs/sources.md

# 资料依据和未决项

核对时间：2026-10-29。本仓库不上传供应商原始 PDF、例程压缩包或模型。

本地资料根目录：`D:/活动/比赛/电赛/FPGA/硬件资料/`。

| 资料 | 本次使用内容 |
|---|---|
| `ACG720_硬件图纸/ACG720-138&60K通用原理图.pdf` 第11页 | P7 排针号、电源、封装球号；已渲染核对 |
| `【WHEELTEC】AT8236驱动模块附送资料/【WHEELTEC】AT8236驱动模块附送资料_V2.8_2026.07.25/1.用户手册与教程视频/电机驱动模块使用手册—AT8236-2025.08.27.pdf` | 10kHz建议、IN1/IN2逻辑、两种模块接口 |
| 同资料包 `5.原理图/2.AT8236稳压模块原理图（D157B）.pdf` | J4/J5针序、编码器5V供电、AB直接引出、VIN分压；已渲染核对 |
| 同资料包 `6.芯片手册/AT8236芯片手册.PDF` 第4~6页 | 输入门限、真值表、休眠和唤醒时序 |
| `team_repos/fpga-sensor/docs/hardware/GPIO_40Pin_mapping.csv` | 既有P7映射交叉核对 |
| `team_repos/fpga-robot/fpga/constraints/robot.cst` | 摄像头/网口/时钟/LED/UART/IMU/雷达的候选球号来源；仓库HEAD `8c07906608fd95df9d43b6c4a66320e981fc2d57` |
| `team_repos/fpga-audio/docs/pins.csv` | 音频接口预留；仓库HEAD `ca5d98e0b67cb0cf89b10f34bd76da01da1dcbe9` |
| `team_repos/fpga-balance/motor_control/constraints/motor_selftest.cst` | UART RX J21候选来源 |

上列来源路径以原工作区为基准；本次读取工作树，HEAD仅供定位，不声称其内容与HEAD逐字一致。`hardware/source_hashes.json` 保存实际读取文件的SHA256。

供应商用户手册中电压/电流表述与芯片手册存在差异；不能用芯片峰值电流或芯片最大电压作为实际模块连续能力。本方案仅按用户指定12V设计，驱动和电机电流能力待核实。

Arduino例程注释和手册对编码器A/B、电机正负的描述也有差异。本设计遵循原理图网名，不依照例程注释推断左右轮前进符号。

用户已于 2026-10-29 确认：实际驱动板为 D157B，带稳压、电机 6Pin 插座。此确认不包含 PCB 修订号或电机编码器规格。

随后用户提供MG513商品参数截图，并确认电机直接以防呆插座连接驱动板，无需本阶段重新核对排线。截图所列型号及未覆盖的参数详见 `motor_v1.md`。另已读取资料包 `4.例程源码/1.STM32例程/2.D157B例程/` 下霍尔和GMR两份标准库ZIP的 `encoder.c`、`pwm.c`、`moto.c`、`main.c`，用于参考AB计数、PWM与PI结构，未复制供应商代码。两份例程均采用TIM编码器TI12模式、数字滤波、10kHz PWM；GMR版本Read_Encoder取绝对值，霍尔版本保留符号。本实现保留双向符号、固定采样周期；不用例程中未定时的while循环采样或示例PI增益。

待确认：

- 实际仍为ACG720 138K板卡，以及使用原载板还是新转接板。
- D157B实际PCB修订版。
- MG513Xp28-12V对应的准确型号、编码器供电/输出类型、分辨率、实际减速比和电流能力。用户已提供商品参数截图；截图不能唯一确定Xp28型号及编码器参数，暂以计数域控制，不作为RTL开发阻塞项。
- 轮径、轮距、万向轮布置、急停回路、供电方案及四路电平转换器件。
