LilywantbecomeNIUBI/fpga-system-integration/docs/task4/M2上板验证_20261031.md

# M2 专用整车固件首次静态上板（2026-10-31）

已将 `system_task4_top` / `task4_m2` 候选下载到 FPGA SRAM，不写 Flash。用户确认下载期间电机12V断开、原DRV8323移除，其余逻辑/JTAG/IMU连接保留。未发送 CLEAR、ARM、DRIVE 或导航 START。

当前实际程序使用 [M2接线表](M2接线.md)，不是默认 `system_top` 的旧接线。M2九路分配还与本地RevC的P7映射逐项核对一致。

## 构建与时序

构建工具补入了已验证的control50迁移约束：cam_pclk/control50不再被异步时钟组整体屏蔽，Gray指针、握手和held-data mailbox保留10ns延迟预算；PLL generated clock仍绑定输出引脚。没有放宽时钟、改PLL主时钟或豁免MPW。

全套任务四离线回归通过，包括1083组算术、226组VFH、921600雷达位流、RPP/位姿/保护、完整系统混合遥测及理想运动学用例。参与构建的RTL哈希与通过的完整系统回归逐项一致。

Place2/Route1达到1200秒上限，未生成位流，记录保留。目录迁移曾使两次短重试自动重新综合，已中止并记录；最终采用已有的“综合后恢复冻结网表再PnR”流程。Place3/Route0完成并被选择；未完成的Place2/Route0在选中候选下载后停止，不宣称它时序失败。

|检查|选中候选|
|---|---:|
|Setup / Hold违例端点|0 / 0|
|control50域内最差Setup|+2.061ns|
|cam_pclk域内最差Setup|+0.359ns|
|sys50 / eth125报告Fmax|50.362 / 125.064MHz|
|MPW|−0.688ns，仍未决|
|PR1014|B1现有非专用PCLK接线的限定配置边界，仍记录|

两个域的Setup数字来自定向report_timing，不是全局WNS。跨域18个Gray指针路径及3个mailbox的数据预算检查通过；处理模块实际时钟及LK唯一5位状态寄存器检查通过。Setup/Hold通过不等于完整时序签核，MPW尚未解决，125MHz和sys50裕量也有限。

- 网表SHA256：`82e930e63316b7adf95372c4d93236586625f1f24594dc296bc2b4b5519973dd`
- SRAM位流SHA256：`d8af664f3f72161b27aec40b3b5e7d7185236b24db83d9a7f82a5962dee3fb2e`
- 选中目录：`build/task4/system_/20261031T042625Z_p3r0`

## 板上结果与待测项

JTAG识别ID `0011081B`，程序下载返回 `Finished.`。新的UART为COM13；独立实机诊断页在 `http://127.0.0.1:8877/`，单独记录原始串口，不与旧COM20网关或8876演示台共用UART。

首次10秒采集收到200条电机、501条IMU、63条导航及编码器诊断/轨迹帧，两个解析器CRC错误均为0。IMU WHO_AM_I=0x47、ready=1、fault=0；电机一直未ARM、左右applied=0，上电待CLEAR的fault bit0保留。导航未启动、输出许可为0。

首次检查脚本错误要求STOP更新`last_sequence`，因此该次脚本返回失败；RTL本来只在ARM/DRIVE更新序号，这不是板卡异常。后续通过一次无运动含义的未支持操作码0x3F，使`rejected_commands`按预期从0增加到1，再发送STOP并持续采集零输出，独立确认PC→FPGA和FPGA→PC双向通信。没有为验证通信而ARM或清除上电联锁。原失败记录、检查器修正说明和后续通过记录均保留。

截至归档快照，雷达包/错误计数均为0，尚不能确认雷达电气接入；编码器手转验证等待用户操作，不能把启动时左轮−1计数当作通过。PC以太网仍显示断开，因此本次新载板未验证图传、YOLO或实际光流输出。既往control50的300秒板测不替代本次新载板验收。

新增导航帧复用原IMU辅助遥测通道；原`tx_drop_count`因此会包含辅助通道丢弃，不能直接当作IMU采样丢失计数。本次IMU接收约50Hz，导航约6.3Hz，未声称所有10Hz导航状态均无丢失。

下一步需确认编码器供电与两轮A/B手转计数，以及雷达供电、TX→M2-14和共地，再做轮向/轮距/每圈计数等实测标定。四路驱动输出的实际电机动作和自主导航均未验收。

## 后续断电边界

用户开始手转后，UART流停止，随后明确报告开发板曾断电并要求重下。SRAM配置不能跨断电保留，上述下载及正常静态结果只作为历史窗口。中断窗口里两轮无新增边沿、雷达包为0，UART解析累计1次CRC错误；因为数据随后过期，这段不作为有效编码器或雷达验收，也不据此判定接线故障。

重下时USB下载器354恢复可见，但JTAG目标扫描提示没有有效FPGA目标，尚未再次下载。已请用户恢复FPGA逻辑供电并接稳JTAG，电机12V继续隔离。当前状态见[断电记录](evidence/m2_board_20261031/power_loss.json)。

完整记录见 [汇总](evidence/m2_board_20261031/summary.json)、[时序](evidence/m2_board_20261031/timing.txt)、[串口双向检查](evidence/m2_board_20261031/uart_followup.json) 与 [文件哈希清单](evidence/m2_board_20261031/manifest.json)。位流和综合网表不纳入源码归档，以以上哈希标识。
