LilywantbecomeNIUBI/fpga-system-integration/docs/evidence/adc_remap_v2/pin_plan.md

# 引脚方案 V1：ADC接口复用 — 2026-10-29

按现有 ACG720（138K）开发板设计，P7 对应关系已核对开发板通用原理图第 11 页及现有 GPIO 映射。用户于 2026-10-29 确认驱动板为 D157B（带稳压、电机 6Pin 插座）。实际 PCB 修订版、电机编码器规格和实际转接线尚待确认，本表是候选设计。

## 底盘接口

方向均相对 FPGA。A 通道暂定义左轮，B 通道暂定义右轮；安装后用独立配置校准电机与编码器符号。

| 功能 | 顶层端口 | P7 针号 | FPGA 球号 | 方向 | 驱动模块端点 |
|---|---|---:|---|---|---|
| 左轮控制 1 | left_in1 | 21 | D17 | OUT | AIN1 / D157B J4-4 |
| 左轮控制 2 | left_in2 | 22 | C17 | OUT | AIN2 / D157B J4-3 |
| 右轮控制 1 | right_in1 | 23 | E16 | OUT | BIN1 / D157B J4-2 |
| 右轮控制 2 | right_in2 | 24 | D16 | OUT | BIN2 / D157B J4-1 |
| 左编码器 A | left_enc_a | 25 | B17 | IN | level shifter <- E1A / D157B J5-1 |
| 左编码器 B | left_enc_b | 26 | B18 | IN | level shifter <- E1B / D157B J5-2 |
| 右编码器 A | right_enc_a | 27 | C18 | IN | level shifter <- E2A / D157B J5-3 |
| 右编码器 B | right_enc_b | 36 | D19 | IN | level shifter <- E2B / D157B J5-4 |
| 外部停机状态 | estop_n | 37 | F18 | IN | external safety status / external pulldown |
| 信号地 | — | 12/30 | — | 电源 | 驱动、电平转换、FPGA共地 |

本车使用 D157B，左电机接 Motor_A 6Pin 插座，右电机接 Motor_B 6Pin 插座。用户确认使用防呆排线直连，本阶段不要求重新排线。表中 FPGA 侧 J4/J5 针号按所附 D157B 原理图定义，接线时核对实物丝印和修订版。万向轮无需电气引脚。

**本版取代此前复用无刷PWM的引脚方案，旧位流不能按新表接线。** 拔下AD7606模块与载板之间的数字接口连接，使ADC_BUSY/DOUT等旧输出和新信号完全断开；从载板/FPGA侧引线。ADC只有7根独立GPIO，额外使用P7-36/37原雷达UART两根线；当前STL-27L改走Nano USB，载板雷达TTL接口不能仍接雷达或USB转串口的输出。ADC接口中两个CONVST针脚为同一网络，不能当成两根GPIO。

现有POWER_DRV8323HR_V1.01说明书注明DRV_EN板载R29=10kΩ下拉、默认低；芯片ENABLE低时进入休眠。此依据适用于该版本，实物仍需核对。旧无刷电机机械安装、UVW相线和驱动信号线可以保留，不再与新D157B信号复用。新顶层固定两路DRV_EN、全部12路PWM、两路CAL为0。建议断开旧驱动动力电源支路，并在配置/重启期间确认DRV_EN保持低；固件禁用不是物理断能。不要将EN直接短接地后再允许旧固件把同一GPIO推高。再次下载旧平衡固件前必须恢复接线检查。

## ADC载板侧取线位置

| P7 | 旧网络 | 旧载板接口端点 | 新用途 |
|---:|---|---|---|
|21|ADC_CONVST|J_ADC_DIG1-7/8（同一网）|AIN1|
|22|ADC_BUSY|J_ADC_DIG1-12|AIN2|
|23|ADC_CS_N|J_ADC_DIG1-11|BIN1|
|24|ADC_SCLK|J_ADC_DIG1-10|BIN2|
|25|ADC_DOUT_A|J_ADC_DIG1-22|E1A，经3.3V调理|
|26|ADC_DOUT_B|J_ADC_DIG1-23|E1B，经3.3V调理|
|27|ADC_RESET|J_ADC_DIG1-9|E2A，经3.3V调理|
|36|LIDAR_UART_RX|J_LIDAR_CORE1-1|E2B，经3.3V调理|
|37|LIDAR_UART_TX|J_LIDAR_CORE1-2|急停状态，低停机|

接口端点来自现有Carrier_Hall_RevB映射；实物版本和插头观察方向未现场核验，不按排线颜色猜针号。

## 电平和供电

- 控制与输入统一为 LVCMOS33。AT8236 芯片手册第 4 页给出 VIH 最小 1.5V，3.3V 输出满足芯片逻辑高门限；仍需核对实际模块输入电路。
- D157B 原理图中电机 6Pin 的编码器电源为 5V，E1A/E1B/E2A/E2B 直接引出，没有板载 5V→3.3V 转换。四路 AB 必须经过经器件手册确认可接收 5V 的 3.3V 缓冲器，或按实际输出类型设计的分压/上拉电路。不要仅凭“AB 编码器”推断其电压、推挽/开漏类型。
- 电机由驱动 VM 接外部 12V，不能从 FPGA GPIO 或 P7 供电。FPGA 保持原供电；D157B 的 5V/3V3 输出不接 FPGA 的电源输出，避免电源并联反灌。P7-11 是 5V，P7-29 是 3.3V，均不属于信号针脚。
- D157B 自带稳压，按模块电源输入接 12V 和 GND，无需另给模块 VREF 接独立 3.3V 电源；不要套用 D107A 的 VCC 接法。
- 四路驱动控制在驱动端预留外部下拉，使 FPGA 配置期间保持 00；具体阻值结合模块电路确认。硬件急停应直接切断驱动能量，`estop_n` 只反馈状态，不能替代断电回路。
- D157B 的 ADC 是 VIN 经 1/11 分压的模拟输出，不能接普通 FPGA 数字 IO。此版不连接；如需采集，另接外部 ADC 并核对量程。

## FPGA 控制约定

每轮使用 IN1/IN2 两根线，不额外虚构 EN、DIR、nFAULT 或电流反馈端口。AT8236 输入真值表：00 滑行/休眠，10/01 两个电气方向，11 刹车。电气方向不等于车体前进方向。

电机V1采用 PWM=10kHz（模块手册建议值）。正电气方向采用 PWM/0，负电气方向采用 0/PWM，零输出和未使能均为 00。每次从零输出启动，先以11刹车态维持约1.1ms唤醒，再进入PWM；换向先降为零、进入00，确认静止并等待后才允许反向。不能把其他例程的占空比极性直接套入。具体实现见 `motor_v1.md`。

电机V1已包含输入同步、AB解码与异常跳变统计、速度窗口、左右轮独立符号、速度环、加减速限制、指令超时、停机锁存。编码器每输出轴转计数、轮径和轮距暂不填默认值。

## 系统接口预留

完整球号清单见 `hardware/pins.csv`；摄像头和 RGMII 从既有 fpga-robot 约束预留，音频从 fpga-audio 预留。统一顶层已集成视觉/网口/IMU；音频仍预留。引脚检查不能证明电气兼容。

- P7-36 D19 / P7-37 F18 已用于右编码器B/急停状态；FPGA雷达UART不再可用。P7-38 E18仅预留。
- P7-39 F19 / P7-40 F20：IMU I2C SCL/SDA，外部上拉到 3.3V。
- P7-21~27 已用于D157B，不能同时连接外部ADC；P7-28/31/32/33/34/35 保留备用，不沿用旧 MT6701 SPI 协议。
- P7-7 F13、P7-18 C15 保留为旧驱动关闭输出，两种新顶层均固定低；全部旧PWM和CAL也固定低。旧驱动建议断开动力电源，机械及相线可保留。
- 板载 UART TX M15 / RX J21，50MHz 时钟 Y18、复位 F15；实际 UART 双向通路需要验证。
- 摄像头使用原 P4 接口，网口使用板载 PHY，音频保留原板载接口，Nano/PC 优先沿用以太网。

未来仅能有一个集成顶层和统一引脚所有权；不能拼接多个旧 CST，旧无刷端口仅可作为固定低的禁用输出，不能实例化旧FOC控制；旧ADC和载板雷达UART不能再占用新信号。
