LilywantbecomeNIUBI/fpga-system-integration/docs/task4/evidence/system_synthesis.html

- Synthesis Messages
- Synthesis Details
- Resource
  - Resource Usage Summary
  - Resource Utilization Summary
- Timing
  - Clock Summary
  - Max Frequency Summary
  - Detail Timing Paths Informations

# Synthesis Messages

Report Title | GowinSynthesis Report

Design File

E:\Gowin_project\fpga_project\team_repos\fpga-system-integration\build\task4\system_\20261030T213259Z\source\fpga\motor\at8236_pwm.sv
E:\Gowin_project\fpga_project\team_repos\fpga-system-integration\build\task4\system_\20261030T213259Z\source\fpga\motor\brushed_motor_top.sv
E:\Gowin_project\fpga_project\team_repos\fpga-system-integration\build\task4\system_\20261030T213259Z\source\fpga\motor\encoder_ab.sv
E:\Gowin_project\fpga_project\team_repos\fpga-system-integration\build\task4\system_\20261030T213259Z\source\fpga\motor\encoder_diagnostics.sv
E:\Gowin_project\fpga_project\team_repos\fpga-system-integration\build\task4\system_\20261030T213259Z\source\fpga\motor\frame_transport.sv
E:\Gowin_project\fpga_project\team_repos\fpga-system-integration\build\task4\system_\20261030T213259Z\source\fpga\motor\motor_core.sv
E:\Gowin_project\fpga_project\team_repos\fpga-system-integration\build\task4\system_\20261030T213259Z\source\fpga\motor\motor_protocol.sv
E:\Gowin_project\fpga_project\team_repos\fpga-system-integration\build\task4\system_\20261030T213259Z\source\fpga\motor\motor_telemetry.sv
E:\Gowin_project\fpga_project\team_repos\fpga-system-integration\build\task4\system_\20261030T213259Z\source\fpga\motor\uart_byte.sv
E:\Gowin_project\fpga_project\team_repos\fpga-system-integration\build\task4\system_\20261030T213259Z\source\fpga\motor\wheel_control.sv
E:\Gowin_project\fpga_project\team_repos\fpga-system-integration\build\task4\system_\20261030T213259Z\source\fpga\navigation\nav_command_mux.sv
E:\Gowin_project\fpga_project\team_repos\fpga-system-integration\build\task4\system_\20261030T213259Z\source\fpga\navigation\nav_core.sv
E:\Gowin_project\fpga_project\team_repos\fpga-system-integration\build\task4\system_\20261030T213259Z\source\fpga\navigation\nav_histogram.sv
E:\Gowin_project\fpga_project\team_repos\fpga-system-integration\build\task4\system_\20261030T213259Z\source\fpga\navigation\nav_math.sv
E:\Gowin_project\fpga_project\team_repos\fpga-system-integration\build\task4\system_\20261030T213259Z\source\fpga\navigation\nav_status_source.sv
E:\Gowin_project\fpga_project\team_repos\fpga-system-integration\build\task4\system_\20261030T213259Z\source\fpga\navigation\nav_timing_harness.sv
E:\Gowin_project\fpga_project\team_repos\fpga-system-integration\build\task4\system_\20261030T213259Z\source\fpga\navigation\nav_vfh.sv
E:\Gowin_project\fpga_project\team_repos\fpga-system-integration\build\task4\system_\20261030T213259Z\source\fpga\navigation\system_task4_top.sv
E:\Gowin_project\fpga_project\team_repos\fpga-system-integration\build\task4\system_\20261030T213259Z\source\fpga\navigation\task4_chassis.sv
E:\Gowin_project\fpga_project\team_repos\fpga-system-integration\build\task4\system_\20261030T213259Z\source\fpga\system\imu_status_source.sv
E:\Gowin_project\fpga_project\team_repos\fpga-system-integration\build\task4\system_\20261030T213259Z\source\fpga\vision\src\optical_flow\frame_memory.sv
E:\Gowin_project\fpga_project\team_repos\fpga-system-integration\build\task4\system_\20261030T213259Z\source\fpga\imu\icm42688_fast_reader.v
E:\Gowin_project\fpga_project\team_repos\fpga-system-integration\build\task4\system_\20261030T213259Z\source\fpga\imu\imu_1khz_core.v
E:\Gowin_project\fpga_project\team_repos\fpga-system-integration\build\task4\system_\20261030T213259Z\source\fpga\imu\imu_fast_i2c_master.v
E:\Gowin_project\fpga_project\team_repos\fpga-system-integration\build\task4\system_\20261030T213259Z\source\fpga\system\event_packet_mux.v
E:\Gowin_project\fpga_project\team_repos\fpga-system-integration\build\task4\system_\20261030T213259Z\source\fpga\system\flow_observer.v
E:\Gowin_project\fpga_project\team_repos\fpga-system-integration\build\task4\system_\20261030T213259Z\source\fpga\vision\src\camera_status_uart.v
E:\Gowin_project\fpga_project\team_repos\fpga-system-integration\build\task4\system_\20261030T213259Z\source\fpga\vision\src\network_runtime_dual.v
E:\Gowin_project\fpga_project\team_repos\fpga-system-integration\build\task4\system_\20261030T213259Z\source\fpga\vision\src\ov5640_config.v
E:\Gowin_project\fpga_project\team_repos\fpga-system-integration\build\task4\system_\20261030T213259Z\source\fpga\vision\src\reset_sync.v
E:\Gowin_project\fpga_project\team_repos\fpga-system-integration\build\task4\system_\20261030T213259Z\source\fpga\vision\src\rgmii_input.v
E:\Gowin_project\fpga_project\team_repos\fpga-system-integration\build\task4\system_\20261030T213259Z\source\fpga\vision\src\rgmii_output.v
E:\Gowin_project\fpga_project\team_repos\fpga-system-integration\build\task4\system_\20261030T213259Z\source\fpga\vision\src\camera_init\ov5640_init_table_rgb.v
E:\Gowin_project\fpga_project\team_repos\fpga-system-integration\build\task4\system_\20261030T213259Z\source\fpga\vision\src\ethernet_pll\ethernet_pll.v
E:\Gowin_project\fpga_project\team_repos\fpga-system-integration\build\task4\system_\20261030T213259Z\source\fpga\vision\src\eth_udp_gmii\crc32_d8.v
E:\Gowin_project\fpga_project\team_repos\fpga-system-integration\build\task4\system_\20261030T213259Z\source\fpga\vision\src\eth_udp_gmii\eth_udp_tx_gmii.v
E:\Gowin_project\fpga_project\team_repos\fpga-system-integration\build\task4\system_\20261030T213259Z\source\fpga\vision\src\eth_udp_gmii\ip_checksum.v
E:\Gowin_project\fpga_project\team_repos\fpga-system-integration\build\task4\system_\20261030T213259Z\source\fpga\vision\src\mdio\mdio_bit_shift.v
E:\Gowin_project\fpga_project\team_repos\fpga-system-integration\build\task4\system_\20261030T213259Z\source\fpga\vision\src\mdio\phy_reg_config.v
E:\Gowin_project\fpga_project\team_repos\fpga-system-integration\build\task4\system_\20261030T213259Z\source\fpga\vision\src\optical_flow\camera_flow.v
E:\Gowin_project\fpga_project\team_repos\fpga-system-integration\build\task4\system_\20261030T213259Z\source\fpga\vision\src\optical_flow\camera_flow_v0_top.v
E:\Gowin_project\fpga_project\team_repos\fpga-system-integration\build\task4\system_\20261030T213259Z\source\fpga\vision\src\optical_flow\camera_flow_v1_top.v
E:\Gowin_project\fpga_project\team_repos\fpga-system-integration\build\task4\system_\20261030T213259Z\source\fpga\vision\src\optical_flow\camera_flow_v2_top.v
E:\Gowin_project\fpga_project\team_repos\fpga-system-integration\build\task4\system_\20261030T213259Z\source\fpga\vision\src\optical_flow\flow_avoidance.v
E:\Gowin_project\fpga_project\team_repos\fpga-system-integration\build\task4\system_\20261030T213259Z\source\fpga\vision\src\optical_flow\flow_avoidance_top.v
E:\Gowin_project\fpga_project\team_repos\fpga-system-integration\build\task4\system_\20261030T213259Z\source\fpga\vision\src\optical_flow\flow_event_bridge.v
E:\Gowin_project\fpga_project\team_repos\fpga-system-integration\build\task4\system_\20261030T213259Z\source\fpga\vision\src\optical_flow\flow_event_source.v
E:\Gowin_project\fpga_project\team_repos\fpga-system-integration\build\task4\system_\20261030T213259Z\source\fpga\vision\src\optical_flow\flow_frame_store.v
E:\Gowin_project\fpga_project\team_repos\fpga-system-integration\build\task4\system_\20261030T213259Z\source\fpga\vision\src\optical_flow\flow_grid.v
E:\Gowin_project\fpga_project\team_repos\fpga-system-integration\build\task4\system_\20261030T213259Z\source\fpga\vision\src\optical_flow\flow_grid_pyramid.v
E:\Gowin_project\fpga_project\team_repos\fpga-system-integration\build\task4\system_\20261030T213259Z\source\fpga\vision\src\optical_flow\flow_lk_patch.v
E:\Gowin_project\fpga_project\team_repos\fpga-system-integration\build\task4\system_\20261030T213259Z\source\fpga\vision\src\optical_flow\flow_pipeline.v
E:\Gowin_project\fpga_project\team_repos\fpga-system-integration\build\task4\system_\20261030T213259Z\source\fpga\vision\src\optical_flow\flow_v2_core.v
E:\Gowin_project\fpga_project\team_repos\fpga-system-integration\build\task4\system_\20261030T213259Z\source\fpga\vision\src\vision\camera_perception.v
E:\Gowin_project\fpga_project\team_repos\fpga-system-integration\build\task4\system_\20261030T213259Z\source\fpga\vision\src\vision\vision_divider.v
E:\Gowin_project\fpga_project\team_repos\fpga-system-integration\build\task4\system_\20261030T213259Z\source\fpga\vision\src\vision\vision_dvp_capture.v
E:\Gowin_project\fpga_project\team_repos\fpga-system-integration\build\task4\system_\20261030T213259Z\source\fpga\vision\src\vision\vision_feature_grid.v
E:\Gowin_project\fpga_project\team_repos\fpga-system-integration\build\task4\system_\20261030T213259Z\source\fpga\vision\src\vision\vision_frame_stream.v
E:\Gowin_project\fpga_project\team_repos\fpga-system-integration\build\task4\system_\20261030T213259Z\source\fpga\vision\src\vision\vision_lk_tracker.v
E:\Gowin_project\fpga_project\team_repos\fpga-system-integration\build\task4\system_\20261030T213259Z\source\fpga\vision\src\vision\vision_mailbox.v
E:\Gowin_project\fpga_project\team_repos\fpga-system-integration\build\task4\system_\20261030T213259Z\source\fpga\vision\src\vision\vision_pixel_pipeline.v
E:\Gowin_project\fpga_project\team_repos\fpga-system-integration\build\task4\system_\20261030T213259Z\source\fpga\vision\src\vision\vision_result_core.v
E:\Gowin_project\fpga_project\team_repos\fpga-system-integration\build\task4\system_\20261030T213259Z\source\fpga\vision\src\vision\vision_tracker.v
E:\Gowin_project\fpga_project\team_repos\fpga-system-integration\build\task4\system_\20261030T213259Z\source\fpga\vision\src\vision\vision_v23_bridge.v
E:\Gowin_project\fpga_project\team_repos\fpga-system-integration\build\task4\system_\20261030T213259Z\source\fpga\vision\src\camera_init\i2c_control\i2c_bit_shift.v
E:\Gowin_project\fpga_project\team_repos\fpga-system-integration\build\task4\system_\20261030T213259Z\source\fpga\vision\src\camera_init\i2c_control\i2c_control.v
E:\Gowin_project\fpga_project\team_repos\fpga-system-integration\build\task4\system_\20261030T213259Z\source\fpga\navigation\lidar\stl27l_node_parser.v
E:\Gowin_project\fpga_project\team_repos\fpga-system-integration\build\task4\system_\20261030T213259Z\source\fpga\navigation\lidar\stl27l_uart_rx.v
GowinSynthesis Constraints File | ---
Tool Version | V1.9.12.04 (64-bit)
Part Number | GW5AT-LV138PG484AC1/I0
Device | GW5AT-138
Device Version | B
Created Time | Sat Oct 31 05:35:51 2026
Legal Announcement | Copyright (C)2014-2026 Gowin Semiconductor Corporation. ALL rights reserved.

# Synthesis Details

Top Level Module | system_task4_top

Synthesis Process

Running parser:
CPU time = 0h 0m 2s, Elapsed time = 0h 0m 2s, Peak memory usage = 464.629MB
Running netlist conversion:
CPU time = 0h 0m 0s, Elapsed time = 0h 0m 0s, Peak memory usage = 0MB
Running device independent optimization:
Optimizing Phase 0: CPU time = 0h 0m 8s, Elapsed time = 0h 0m 8s, Peak memory usage = 464.629MB
Optimizing Phase 1: CPU time = 0h 0m 4s, Elapsed time = 0h 0m 4s, Peak memory usage = 464.629MB
Optimizing Phase 2: CPU time = 0h 0m 26s, Elapsed time = 0h 0m 26s, Peak memory usage = 464.629MB
Running inference:
Inferring Phase 0: CPU time = 0h 0m 10s, Elapsed time = 0h 0m 10s, Peak memory usage = 464.629MB
Inferring Phase 1: CPU time = 0h 0m 2s, Elapsed time = 0h 0m 2s, Peak memory usage = 464.629MB
Inferring Phase 2: CPU time = 0h 0m 0.484s, Elapsed time = 0h 0m 0.505s, Peak memory usage = 464.629MB
Inferring Phase 3: CPU time = 0h 0m 0.421s, Elapsed time = 0h 0m 0.429s, Peak memory usage = 464.629MB
Running technical mapping:
Tech-Mapping Phase 0: CPU time = 0h 0m 17s, Elapsed time = 0h 0m 17s, Peak memory usage = 464.629MB
Tech-Mapping Phase 1: CPU time = 0h 0m 3s, Elapsed time = 0h 0m 3s, Peak memory usage = 464.629MB
Tech-Mapping Phase 2: CPU time = 0h 0m 5s, Elapsed time = 0h 0m 5s, Peak memory usage = 464.629MB
Tech-Mapping Phase 3: CPU time = 0h 1m 13s, Elapsed time = 0h 1m 13s, Peak memory usage = 464.629MB
Tech-Mapping Phase 4: CPU time = 0h 0m 5s, Elapsed time = 0h 0m 5s, Peak memory usage = 464.629MB
Generate output files:
CPU time = 0h 0m 4s, Elapsed time = 0h 0m 5s, Peak memory usage = 920.395MB
Total Time and Memory Usage | CPU time = 0h 2m 39s, Elapsed time = 0h 2m 40s, Peak memory usage = 920.395MB

# Resource

## Resource Usage Summary

Resource | Usage
I/O Port | 69
I/O Buf | 69
IBUF | 25
OBUF | 40
TBUF | 1
IOBUF | 3
Register | 33835
DFFSE | 5
DFFRE | 7595
DFFPE | 570
DFFCE | 25665
LUT | 36291
LUT2 | 2931
LUT3 | 14321
LUT4 | 19039
ALU | 8515
ALU | 8515
INV | 112
INV | 112
IOLOGIC | 16
IDDR | 5
ODDR | 6
IODELAY | 5
DSP
MULTALU27X18 | 31
MULT12X12 | 9
MULT27X36 | 17
MULTADDALU12X12 | 5
BSRAM | 220
SDPB | 217
SDPX9B | 2
pROM | 1
CLOCK | 1
PLL | 1

## Resource Utilization Summary

Resource | Usage | Utilization
Logic | 44918(36403 LUT, 8515 ALU) / 138240 | 33%
Register | 33835 / 139095 | 25%
--Register as Latch | 0 / 139095 | 0%
--Register as FF | 33835 / 139095 | 25%
BSRAM | 220 / 340 | 65%

# Timing

## Clock Summary:

NO. | Clock Name | Type | Period | Frequency(MHz) | Rise | Fall | Source | Master | Object
1 | clk50m | Base | 20.000 | 50.000 | 0.000 | 10.000 | | | clk50m_ibuf/I
2 | rgmii_rxc | Base | 10.000 | 100.000 | 0.000 | 5.000 | | | rgmii_rxc_ibuf/I
3 | camera_pclk | Base | 10.000 | 100.000 | 0.000 | 5.000 | | | camera_pclk_ibuf/I
4 | camera/pll/PLL_inst/CLKOUT0.default_gen_clk | Generated | 20.000 | 50.000 | 0.000 | 10.000 | clk50m_ibuf/I | clk50m | camera/pll/PLL_inst/CLKOUT0
5 | camera/pll/PLL_inst/CLKOUT1.default_gen_clk | Generated | 8.000 | 125.000 | 0.000 | 4.000 | clk50m_ibuf/I | clk50m | camera/pll/PLL_inst/CLKOUT1

## Max Frequency Summary:

NO. | Clock Name | Constraint | Actual Fmax | Logic Level | Entity
1 | clk50m | 50.000(MHz) | 52.738(MHz) | 19 | TOP
2 | rgmii_rxc | 100.000(MHz) | 194.889(MHz) | 6 | TOP
3 | camera_pclk | 100.000(MHz) | 85.800(MHz) | 16 | TOP
4 | camera/pll/PLL_inst/CLKOUT0.default_gen_clk | 50.000(MHz) | 103.576(MHz) | 12 | TOP
5 | camera/pll/PLL_inst/CLKOUT1.default_gen_clk | 125.000(MHz) | 105.119(MHz) | 13 | TOP

## Detail Timing Paths Information

### Path 1

Path Summary:

Slack | -8.113
Data Arrival Time | 40.763
Data Required Time | 32.650
From | camera/runtime_network.net/memory[29]_0_s0
To | camera/runtime_network.net/check_sum_19_s1
Launch Clk | rgmii_rxc[R]
Latch Clk | camera/pll/PLL_inst/CLKOUT1.default_gen_clk[R]

Data Arrival Path:

AT | DELAY | TYPE | RF | FANOUT | NODE
30.000 | 30.000 | | | | active clock edge time
30.000 | 0.000 | | | | rgmii_rxc
30.000 | 0.000 | tCL | RR | 1 | rgmii_rxc_ibuf/I
30.000 | 0.000 | tINS | RR | 825 | rgmii_rxc_ibuf/O
30.371 | 0.371 | tNET | RR | 1 | camera/runtime_network.net/memory[29]_0_s0/CLK
30.715 | 0.344 | tC2Q | RR | 11 | camera/runtime_network.net/memory[29]_0_s0/Q
31.087 | 0.371 | tNET | RR | 2 | camera/runtime_network.net/n7634_s/I1
31.627 | 0.540 | tINS | RF | 1 | camera/runtime_network.net/n7634_s/COUT
31.627 | 0.000 | tNET | FF | 2 | camera/runtime_network.net/n7633_s/CIN
31.672 | 0.045 | tINS | FR | 1 | camera/runtime_network.net/n7633_s/COUT
31.672 | 0.000 | tNET | RR | 2 | camera/runtime_network.net/n7632_s/CIN
31.717 | 0.045 | tINS | RR | 1 | camera/runtime_network.net/n7632_s/COUT
31.717 | 0.000 | tNET | RR | 2 | camera/runtime_network.net/n7631_s/CIN
31.762 | 0.045 | tINS | RR | 1 | camera/runtime_network.net/n7631_s/COUT
31.762 | 0.000 | tNET | RR | 2 | camera/runtime_network.net/n7630_s/CIN
31.807 | 0.045 | tINS | RR | 1 | camera/runtime_network.net/n7630_s/COUT
31.807 | 0.000 | tNET | RR | 2 | camera/runtime_network.net/n7629_s/CIN
31.852 | 0.045 | tINS | RR | 1 | camera/runtime_network.net/n7629_s/COUT
31.852 | 0.000 | tNET | RR | 2 | camera/runtime_network.net/n7628_s/CIN
32.071 | 0.219 | tINS | RR | 5 | camera/runtime_network.net/n7628_s/SUM
32.442 | 0.371 | tNET | RR | 1 | camera/runtime_network.net/n7660_s6/I0
32.963 | 0.521 | tINS | RR | 2 | camera/runtime_network.net/n7660_s6/F
33.334 | 0.371 | tNET | RR | 1 | camera/runtime_network.net/n7660_s4/I2
33.791 | 0.457 | tINS | RR | 5 | camera/runtime_network.net/n7660_s4/F
34.162 | 0.371 | tNET | RR | 1 | camera/runtime_network.net/n7654_s7/I2
34.619 | 0.457 | tINS | RR | 1 | camera/runtime_network.net/n7654_s7/F
34.990 | 0.371 | tNET | RR | 1 | camera/runtime_network.net/n7654_s5/I2
35.447 | 0.457 | tINS | RR | 3 | camera/runtime_network.net/n7654_s5/F
35.819 | 0.371 | tNET | RR | 1 | camera/runtime_network.net/n7653_s5/I0
36.339 | 0.521 | tINS | RR | 3 | camera/runtime_network.net/n7653_s5/F
36.711 | 0.371 | tNET | RR | 1 | camera/runtime_network.net/n7653_s3/I2
37.167 | 0.457 | tINS | RR | 1 | camera/runtime_network.net/n7653_s3/F
37.539 | 0.371 | tNET | RR | 2 | camera/runtime_network.net/n7693_s/I0
38.074 | 0.535 | tINS | RF | 1 | camera/runtime_network.net/n7693_s/COUT
38.074 | 0.000 | tNET | FF | 2 | camera/runtime_network.net/n7692_s/CIN
38.293 | 0.219 | tINS | FR | 1 | camera/runtime_network.net/n7692_s/SUM
38.665 | 0.371 | tNET | RR | 2 | camera/runtime_network.net/n7692_s0/I0
39.200 | 0.535 | tINS | RF | 1 | camera/runtime_network.net/n7692_s0/COUT
39.200 | 0.000 | tNET | FF | 2 | camera/runtime_network.net/n7691_s0/CIN
39.245 | 0.045 | tINS | FR | 1 | camera/runtime_network.net/n7691_s0/COUT
39.245 | 0.000 | tNET | RR | 2 | camera/runtime_network.net/n7690_s0/CIN
39.290 | 0.045 | tINS | RR | 1 | camera/runtime_network.net/n7690_s0/COUT
39.290 | 0.000 | tNET | RR | 2 | camera/runtime_network.net/n7689_s0/CIN
39.510 | 0.219 | tINS | RR | 1 | camera/runtime_network.net/n7689_s0/SUM
39.881 | 0.371 | tNET | RR | 1 | camera/runtime_network.net/n8950_s20/I1
40.392 | 0.511 | tINS | RR | 1 | camera/runtime_network.net/n8950_s20/F
40.763 | 0.371 | tNET | RR | 1 | camera/runtime_network.net/check_sum_19_s1/D

Data Required Path:

AT | DELAY | TYPE | RF | FANOUT | NODE
32.000 | 32.000 | | | | active clock edge time
32.000 | 0.000 | | | | camera/pll/PLL_inst/CLKOUT1.default_gen_clk
32.371 | 0.371 | tCL | RR | 6185 | camera/pll/PLL_inst/CLKOUT1
32.743 | 0.371 | tNET | RR | 1 | camera/runtime_network.net/check_sum_19_s1/CLK
32.708 | -0.035 | tUnc | | | camera/runtime_network.net/check_sum_19_s1
32.650 | -0.057 | tSu | | 1 | camera/runtime_network.net/check_sum_19_s1

Path Statistics:

Clock Skew: | 0.371
Setup Relationship: | 2.000
Logic Level: | 15
Arrival Clock Path Delay: | cell: 0.000, 0.000%; route: 0.371, 100.000%
Arrival Data Path Delay: | cell: 5.964, 57.389%; route: 4.084, 39.298%; tC2Q: 0.344, 3.313%
Required Clock Path Delay: | cell: 0.000, 0.000%; route: 0.371, 100.000%

### Path 2

Path Summary:

Slack | -8.068
Data Arrival Time | 40.718
Data Required Time | 32.650
From | camera/runtime_network.net/memory[29]_0_s0
To | camera/runtime_network.net/check_sum_18_s1
Launch Clk | rgmii_rxc[R]
Latch Clk | camera/pll/PLL_inst/CLKOUT1.default_gen_clk[R]

Data Arrival Path:

AT | DELAY | TYPE | RF | FANOUT | NODE
30.000 | 30.000 | | | | active clock edge time
30.000 | 0.000 | | | | rgmii_rxc
30.000 | 0.000 | tCL | RR | 1 | rgmii_rxc_ibuf/I
30.000 | 0.000 | tINS | RR | 825 | rgmii_rxc_ibuf/O
30.371 | 0.371 | tNET | RR | 1 | camera/runtime_network.net/memory[29]_0_s0/CLK
30.715 | 0.344 | tC2Q | RR | 11 | camera/runtime_network.net/memory[29]_0_s0/Q
31.087 | 0.371 | tNET | RR | 2 | camera/runtime_network.net/n7634_s/I1
31.627 | 0.540 | tINS | RF | 1 | camera/runtime_network.net/n7634_s/COUT
31.627 | 0.000 | tNET | FF | 2 | camera/runtime_network.net/n7633_s/CIN
31.672 | 0.045 | tINS | FR | 1 | camera/runtime_network.net/n7633_s/COUT
31.672 | 0.000 | tNET | RR | 2 | camera/runtime_network.net/n7632_s/CIN
31.717 | 0.045 | tINS | RR | 1 | camera/runtime_network.net/n7632_s/COUT
31.717 | 0.000 | tNET | RR | 2 | camera/runtime_network.net/n7631_s/CIN
31.762 | 0.045 | tINS | RR | 1 | camera/runtime_network.net/n7631_s/COUT
31.762 | 0.000 | tNET | RR | 2 | camera/runtime_network.net/n7630_s/CIN
31.807 | 0.045 | tINS | RR | 1 | camera/runtime_network.net/n7630_s/COUT
31.807 | 0.000 | tNET | RR | 2 | camera/runtime_network.net/n7629_s/CIN
31.852 | 0.045 | tINS | RR | 1 | camera/runtime_network.net/n7629_s/COUT
31.852 | 0.000 | tNET | RR | 2 | camera/runtime_network.net/n7628_s/CIN
32.071 | 0.219 | tINS | RR | 5 | camera/runtime_network.net/n7628_s/SUM
32.442 | 0.371 | tNET | RR | 1 | camera/runtime_network.net/n7660_s6/I0
32.963 | 0.521 | tINS | RR | 2 | camera/runtime_network.net/n7660_s6/F
33.334 | 0.371 | tNET | RR | 1 | camera/runtime_network.net/n7660_s4/I2
33.791 | 0.457 | tINS | RR | 5 | camera/runtime_network.net/n7660_s4/F
34.162 | 0.371 | tNET | RR | 1 | camera/runtime_network.net/n7654_s7/I2
34.619 | 0.457 | tINS | RR | 1 | camera/runtime_network.net/n7654_s7/F
34.990 | 0.371 | tNET | RR | 1 | camera/runtime_network.net/n7654_s5/I2
35.447 | 0.457 | tINS | RR | 3 | camera/runtime_network.net/n7654_s5/F
35.819 | 0.371 | tNET | RR | 1 | camera/runtime_network.net/n7653_s5/I0
36.339 | 0.521 | tINS | RR | 3 | camera/runtime_network.net/n7653_s5/F
36.711 | 0.371 | tNET | RR | 1 | camera/runtime_network.net/n7653_s3/I2
37.167 | 0.457 | tINS | RR | 1 | camera/runtime_network.net/n7653_s3/F
37.539 | 0.371 | tNET | RR | 2 | camera/runtime_network.net/n7693_s/I0
38.074 | 0.535 | tINS | RF | 1 | camera/runtime_network.net/n7693_s/COUT
38.074 | 0.000 | tNET | FF | 2 | camera/runtime_network.net/n7692_s/CIN
38.293 | 0.219 | tINS | FR | 1 | camera/runtime_network.net/n7692_s/SUM
38.665 | 0.371 | tNET | RR | 2 | camera/runtime_network.net/n7692_s0/I0
39.200 | 0.535 | tINS | RF | 1 | camera/runtime_network.net/n7692_s0/COUT
39.200 | 0.000 | tNET | FF | 2 | camera/runtime_network.net/n7691_s0/CIN
39.245 | 0.045 | tINS | FR | 1 | camera/runtime_network.net/n7691_s0/COUT
39.245 | 0.000 | tNET | RR | 2 | camera/runtime_network.net/n7690_s0/CIN
39.465 | 0.219 | tINS | RR | 1 | camera/runtime_network.net/n7690_s0/SUM
39.836 | 0.371 | tNET | RR | 1 | camera/runtime_network.net/n8951_s20/I1
40.347 | 0.511 | tINS | RR | 1 | camera/runtime_network.net/n8951_s20/F
40.718 | 0.371 | tNET | RR | 1 | camera/runtime_network.net/check_sum_18_s1/D

Data Required Path:

AT | DELAY | TYPE | RF | FANOUT | NODE
32.000 | 32.000 | | | | active clock edge time
32.000 | 0.000 | | | | camera/pll/PLL_inst/CLKOUT1.default_gen_clk
32.371 | 0.371 | tCL | RR | 6185 | camera/pll/PLL_inst/CLKOUT1
32.743 | 0.371 | tNET | RR | 1 | camera/runtime_network.net/check_sum_18_s1/CLK
32.708 | -0.035 | tUnc | | | camera/runtime_network.net/check_sum_18_s1
32.650 | -0.057 | tSu | | 1 | camera/runtime_network.net/check_sum_18_s1

Path Statistics:

Clock Skew: | 0.371
Setup Relationship: | 2.000
Logic Level: | 15
Arrival Clock Path Delay: | cell: 0.000, 0.000%; route: 0.371, 100.000%
Arrival Data Path Delay: | cell: 5.919, 57.204%; route: 4.084, 39.469%; tC2Q: 0.344, 3.327%
Required Clock Path Delay: | cell: 0.000, 0.000%; route: 0.371, 100.000%

### Path 3

Path Summary:

Slack | -8.023
Data Arrival Time | 40.673
Data Required Time | 32.650
From | camera/runtime_network.net/memory[29]_0_s0
To | camera/runtime_network.net/check_sum_17_s1
Launch Clk | rgmii_rxc[R]
Latch Clk | camera/pll/PLL_inst/CLKOUT1.default_gen_clk[R]

Data Arrival Path:

AT | DELAY | TYPE | RF | FANOUT | NODE
30.000 | 30.000 | | | | active clock edge time
30.000 | 0.000 | | | | rgmii_rxc
30.000 | 0.000 | tCL | RR | 1 | rgmii_rxc_ibuf/I
30.000 | 0.000 | tINS | RR | 825 | rgmii_rxc_ibuf/O
30.371 | 0.371 | tNET | RR | 1 | camera/runtime_network.net/memory[29]_0_s0/CLK
30.715 | 0.344 | tC2Q | RR | 11 | camera/runtime_network.net/memory[29]_0_s0/Q
31.087 | 0.371 | tNET | RR | 2 | camera/runtime_network.net/n7634_s/I1
31.627 | 0.540 | tINS | RF | 1 | camera/runtime_network.net/n7634_s/COUT
31.627 | 0.000 | tNET | FF | 2 | camera/runtime_network.net/n7633_s/CIN
31.672 | 0.045 | tINS | FR | 1 | camera/runtime_network.net/n7633_s/COUT
31.672 | 0.000 | tNET | RR | 2 | camera/runtime_network.net/n7632_s/CIN
31.717 | 0.045 | tINS | RR | 1 | camera/runtime_network.net/n7632_s/COUT
31.717 | 0.000 | tNET | RR | 2 | camera/runtime_network.net/n7631_s/CIN
31.762 | 0.045 | tINS | RR | 1 | camera/runtime_network.net/n7631_s/COUT
31.762 | 0.000 | tNET | RR | 2 | camera/runtime_network.net/n7630_s/CIN
31.807 | 0.045 | tINS | RR | 1 | camera/runtime_network.net/n7630_s/COUT
31.807 | 0.000 | tNET | RR | 2 | camera/runtime_network.net/n7629_s/CIN
31.852 | 0.045 | tINS | RR | 1 | camera/runtime_network.net/n7629_s/COUT
31.852 | 0.000 | tNET | RR | 2 | camera/runtime_network.net/n7628_s/CIN
32.071 | 0.219 | tINS | RR | 5 | camera/runtime_network.net/n7628_s/SUM
32.442 | 0.371 | tNET | RR | 1 | camera/runtime_network.net/n7660_s6/I0
32.963 | 0.521 | tINS | RR | 2 | camera/runtime_network.net/n7660_s6/F
33.334 | 0.371 | tNET | RR | 1 | camera/runtime_network.net/n7660_s4/I2
33.791 | 0.457 | tINS | RR | 5 | camera/runtime_network.net/n7660_s4/F
34.162 | 0.371 | tNET | RR | 1 | camera/runtime_network.net/n7654_s7/I2
34.619 | 0.457 | tINS | RR | 1 | camera/runtime_network.net/n7654_s7/F
34.990 | 0.371 | tNET | RR | 1 | camera/runtime_network.net/n7654_s5/I2
35.447 | 0.457 | tINS | RR | 3 | camera/runtime_network.net/n7654_s5/F
35.819 | 0.371 | tNET | RR | 1 | camera/runtime_network.net/n7653_s5/I0
36.339 | 0.521 | tINS | RR | 3 | camera/runtime_network.net/n7653_s5/F
36.711 | 0.371 | tNET | RR | 1 | camera/runtime_network.net/n7653_s3/I2
37.167 | 0.457 | tINS | RR | 1 | camera/runtime_network.net/n7653_s3/F
37.539 | 0.371 | tNET | RR | 2 | camera/runtime_network.net/n7693_s/I0
38.074 | 0.535 | tINS | RF | 1 | camera/runtime_network.net/n7693_s/COUT
38.074 | 0.000 | tNET | FF | 2 | camera/runtime_network.net/n7692_s/CIN
38.293 | 0.219 | tINS | FR | 1 | camera/runtime_network.net/n7692_s/SUM
38.665 | 0.371 | tNET | RR | 2 | camera/runtime_network.net/n7692_s0/I0
39.200 | 0.535 | tINS | RF | 1 | camera/runtime_network.net/n7692_s0/COUT
39.200 | 0.000 | tNET | FF | 2 | camera/runtime_network.net/n7691_s0/CIN
39.420 | 0.219 | tINS | FR | 1 | camera/runtime_network.net/n7691_s0/SUM
39.791 | 0.371 | tNET | RR | 1 | camera/runtime_network.net/n8952_s20/I1
40.302 | 0.511 | tINS | RR | 1 | camera/runtime_network.net/n8952_s20/F
40.673 | 0.371 | tNET | RR | 1 | camera/runtime_network.net/check_sum_17_s1/D

Data Required Path:

AT | DELAY | TYPE | RF | FANOUT | NODE
32.000 | 32.000 | | | | active clock edge time
32.000 | 0.000 | | | | camera/pll/PLL_inst/CLKOUT1.default_gen_clk
32.371 | 0.371 | tCL | RR | 6185 | camera/pll/PLL_inst/CLKOUT1
32.743 | 0.371 | tNET | RR | 1 | camera/runtime_network.net/check_sum_17_s1/CLK
32.708 | -0.035 | tUnc | | | camera/runtime_network.net/check_sum_17_s1
32.650 | -0.057 | tSu | | 1 | camera/runtime_network.net/check_sum_17_s1

Path Statistics:

Clock Skew: | 0.371
Setup Relationship: | 2.000
Logic Level: | 15
Arrival Clock Path Delay: | cell: 0.000, 0.000%; route: 0.371, 100.000%
Arrival Data Path Delay: | cell: 5.874, 57.016%; route: 4.084, 39.642%; tC2Q: 0.344, 3.342%
Required Clock Path Delay: | cell: 0.000, 0.000%; route: 0.371, 100.000%

### Path 4

Path Summary:

Slack | -7.973
Data Arrival Time | 40.623
Data Required Time | 32.650
From | camera/runtime_network.net/memory[29]_0_s0
To | camera/runtime_network.net/check_sum_16_s1
Launch Clk | rgmii_rxc[R]
Latch Clk | camera/pll/PLL_inst/CLKOUT1.default_gen_clk[R]

Data Arrival Path:

AT | DELAY | TYPE | RF | FANOUT | NODE
30.000 | 30.000 | | | | active clock edge time
30.000 | 0.000 | | | | rgmii_rxc
30.000 | 0.000 | tCL | RR | 1 | rgmii_rxc_ibuf/I
30.000 | 0.000 | tINS | RR | 825 | rgmii_rxc_ibuf/O
30.371 | 0.371 | tNET | RR | 1 | camera/runtime_network.net/memory[29]_0_s0/CLK
30.715 | 0.344 | tC2Q | RR | 11 | camera/runtime_network.net/memory[29]_0_s0/Q
31.087 | 0.371 | tNET | RR | 2 | camera/runtime_network.net/n7634_s/I1
31.627 | 0.540 | tINS | RF | 1 | camera/runtime_network.net/n7634_s/COUT
31.627 | 0.000 | tNET | FF | 2 | camera/runtime_network.net/n7633_s/CIN
31.672 | 0.045 | tINS | FR | 1 | camera/runtime_network.net/n7633_s/COUT
31.672 | 0.000 | tNET | RR | 2 | camera/runtime_network.net/n7632_s/CIN
31.717 | 0.045 | tINS | RR | 1 | camera/runtime_network.net/n7632_s/COUT
31.717 | 0.000 | tNET | RR | 2 | camera/runtime_network.net/n7631_s/CIN
31.762 | 0.045 | tINS | RR | 1 | camera/runtime_network.net/n7631_s/COUT
31.762 | 0.000 | tNET | RR | 2 | camera/runtime_network.net/n7630_s/CIN
31.807 | 0.045 | tINS | RR | 1 | camera/runtime_network.net/n7630_s/COUT
31.807 | 0.000 | tNET | RR | 2 | camera/runtime_network.net/n7629_s/CIN
31.852 | 0.045 | tINS | RR | 1 | camera/runtime_network.net/n7629_s/COUT
31.852 | 0.000 | tNET | RR | 2 | camera/runtime_network.net/n7628_s/CIN
32.071 | 0.219 | tINS | RR | 5 | camera/runtime_network.net/n7628_s/SUM
32.442 | 0.371 | tNET | RR | 1 | camera/runtime_network.net/n7660_s6/I0
32.963 | 0.521 | tINS | RR | 2 | camera/runtime_network.net/n7660_s6/F
33.334 | 0.371 | tNET | RR | 1 | camera/runtime_network.net/n7660_s4/I2
33.791 | 0.457 | tINS | RR | 5 | camera/runtime_network.net/n7660_s4/F
34.162 | 0.371 | tNET | RR | 1 | camera/runtime_network.net/n7654_s7/I2
34.619 | 0.457 | tINS | RR | 1 | camera/runtime_network.net/n7654_s7/F
34.990 | 0.371 | tNET | RR | 1 | camera/runtime_network.net/n7654_s5/I2
35.447 | 0.457 | tINS | RR | 3 | camera/runtime_network.net/n7654_s5/F
35.819 | 0.371 | tNET | RR | 1 | camera/runtime_network.net/n7653_s5/I0
36.339 | 0.521 | tINS | RR | 3 | camera/runtime_network.net/n7653_s5/F
36.711 | 0.371 | tNET | RR | 1 | camera/runtime_network.net/n7653_s3/I2
37.167 | 0.457 | tINS | RR | 1 | camera/runtime_network.net/n7653_s3/F
37.539 | 0.371 | tNET | RR | 2 | camera/runtime_network.net/n7693_s/I0
38.244 | 0.705 | tINS | RR | 1 | camera/runtime_network.net/n7693_s/SUM
38.615 | 0.371 | tNET | RR | 2 | camera/runtime_network.net/n7693_s0/I0
39.151 | 0.535 | tINS | RF | 1 | camera/runtime_network.net/n7693_s0/COUT
39.151 | 0.000 | tNET | FF | 2 | camera/runtime_network.net/n7692_s0/CIN
39.370 | 0.219 | tINS | FR | 1 | camera/runtime_network.net/n7692_s0/SUM
39.741 | 0.371 | tNET | RR | 1 | camera/runtime_network.net/n8953_s20/I1
40.252 | 0.511 | tINS | RR | 1 | camera/runtime_network.net/n8953_s20/F
40.623 | 0.371 | tNET | RR | 1 | camera/runtime_network.net/check_sum_16_s1/D

Data Required Path:

AT | DELAY | TYPE | RF | FANOUT | NODE
32.000 | 32.000 | | | | active clock edge time
32.000 | 0.000 | | | | camera/pll/PLL_inst/CLKOUT1.default_gen_clk
32.371 | 0.371 | tCL | RR | 6185 | camera/pll/PLL_inst/CLKOUT1
32.743 | 0.371 | tNET | RR | 1 | camera/runtime_network.net/check_sum_16_s1/CLK
32.708 | -0.035 | tUnc | | | camera/runtime_network.net/check_sum_16_s1
32.650 | -0.057 | tSu | | 1 | camera/runtime_network.net/check_sum_16_s1

Path Statistics:

Clock Skew: | 0.371
Setup Relationship: | 2.000
Logic Level: | 14
Arrival Clock Path Delay: | cell: 0.000, 0.000%; route: 0.371, 100.000%
Arrival Data Path Delay: | cell: 5.824, 56.809%; route: 4.084, 39.833%; tC2Q: 0.344, 3.358%
Required Clock Path Delay: | cell: 0.000, 0.000%; route: 0.371, 100.000%

### Path 5

Path Summary:

Slack | -7.938
Data Arrival Time | 40.589
Data Required Time | 32.650
From | camera/runtime_network.net/memory[29]_0_s0
To | camera/runtime_network.net/check_sum_20_s1
Launch Clk | rgmii_rxc[R]
Latch Clk | camera/pll/PLL_inst/CLKOUT1.default_gen_clk[R]

Data Arrival Path:

AT | DELAY | TYPE | RF | FANOUT | NODE
30.000 | 30.000 | | | | active clock edge time
30.000 | 0.000 | | | | rgmii_rxc
30.000 | 0.000 | tCL | RR | 1 | rgmii_rxc_ibuf/I
30.000 | 0.000 | tINS | RR | 825 | rgmii_rxc_ibuf/O
30.371 | 0.371 | tNET | RR | 1 | camera/runtime_network.net/memory[29]_0_s0/CLK
30.715 | 0.344 | tC2Q | RR | 11 | camera/runtime_network.net/memory[29]_0_s0/Q
31.087 | 0.371 | tNET | RR | 2 | camera/runtime_network.net/n7634_s/I1
31.627 | 0.540 | tINS | RF | 1 | camera/runtime_network.net/n7634_s/COUT
31.627 | 0.000 | tNET | FF | 2 | camera/runtime_network.net/n7633_s/CIN
31.672 | 0.045 | tINS | FR | 1 | camera/runtime_network.net/n7633_s/COUT
31.672 | 0.000 | tNET | RR | 2 | camera/runtime_network.net/n7632_s/CIN
31.717 | 0.045 | tINS | RR | 1 | camera/runtime_network.net/n7632_s/COUT
31.717 | 0.000 | tNET | RR | 2 | camera/runtime_network.net/n7631_s/CIN
31.762 | 0.045 | tINS | RR | 1 | camera/runtime_network.net/n7631_s/COUT
31.762 | 0.000 | tNET | RR | 2 | camera/runtime_network.net/n7630_s/CIN
31.807 | 0.045 | tINS | RR | 1 | camera/runtime_network.net/n7630_s/COUT
31.807 | 0.000 | tNET | RR | 2 | camera/runtime_network.net/n7629_s/CIN
31.852 | 0.045 | tINS | RR | 1 | camera/runtime_network.net/n7629_s/COUT
31.852 | 0.000 | tNET | RR | 2 | camera/runtime_network.net/n7628_s/CIN
32.071 | 0.219 | tINS | RR | 5 | camera/runtime_network.net/n7628_s/SUM
32.442 | 0.371 | tNET | RR | 1 | camera/runtime_network.net/n7660_s6/I0
32.963 | 0.521 | tINS | RR | 2 | camera/runtime_network.net/n7660_s6/F
33.334 | 0.371 | tNET | RR | 1 | camera/runtime_network.net/n7660_s4/I2
33.791 | 0.457 | tINS | RR | 5 | camera/runtime_network.net/n7660_s4/F
34.162 | 0.371 | tNET | RR | 1 | camera/runtime_network.net/n7654_s7/I2
34.619 | 0.457 | tINS | RR | 1 | camera/runtime_network.net/n7654_s7/F
34.990 | 0.371 | tNET | RR | 1 | camera/runtime_network.net/n7654_s5/I2
35.447 | 0.457 | tINS | RR | 3 | camera/runtime_network.net/n7654_s5/F
35.819 | 0.371 | tNET | RR | 1 | camera/runtime_network.net/n7653_s5/I0
36.339 | 0.521 | tINS | RR | 3 | camera/runtime_network.net/n7653_s5/F
36.711 | 0.371 | tNET | RR | 1 | camera/runtime_network.net/n7653_s3/I2
37.167 | 0.457 | tINS | RR | 1 | camera/runtime_network.net/n7653_s3/F
37.539 | 0.371 | tNET | RR | 2 | camera/runtime_network.net/n7693_s/I0
38.074 | 0.535 | tINS | RF | 1 | camera/runtime_network.net/n7693_s/COUT
38.074 | 0.000 | tNET | FF | 2 | camera/runtime_network.net/n7692_s/CIN
38.293 | 0.219 | tINS | FR | 1 | camera/runtime_network.net/n7692_s/SUM
38.665 | 0.371 | tNET | RR | 2 | camera/runtime_network.net/n7692_s0/I0
39.200 | 0.535 | tINS | RF | 1 | camera/runtime_network.net/n7692_s0/COUT
39.200 | 0.000 | tNET | FF | 2 | camera/runtime_network.net/n7691_s0/CIN
39.245 | 0.045 | tINS | FR | 1 | camera/runtime_network.net/n7691_s0/COUT
39.245 | 0.000 | tNET | RR | 2 | camera/runtime_network.net/n7690_s0/CIN
39.290 | 0.045 | tINS | RR | 1 | camera/runtime_network.net/n7690_s0/COUT
39.290 | 0.000 | tNET | RR | 2 | camera/runtime_network.net/n7689_s0/CIN
39.335 | 0.045 | tINS | RR | 1 | camera/runtime_network.net/n7689_s0/COUT
39.707 | 0.371 | tNET | RR | 1 | camera/runtime_network.net/n8949_s22/I1
40.217 | 0.511 | tINS | RR | 1 | camera/runtime_network.net/n8949_s22/F
40.588 | 0.371 | tNET | RR | 1 | camera/runtime_network.net/check_sum_20_s1/D

Data Required Path:

AT | DELAY | TYPE | RF | FANOUT | NODE
32.000 | 32.000 | | | | active clock edge time
32.000 | 0.000 | | | | camera/pll/PLL_inst/CLKOUT1.default_gen_clk
32.371 | 0.371 | tCL | RR | 6185 | camera/pll/PLL_inst/CLKOUT1
32.743 | 0.371 | tNET | RR | 1 | camera/runtime_network.net/check_sum_20_s1/CLK
32.708 | -0.035 | tUnc | | | camera/runtime_network.net/check_sum_20_s1
32.650 | -0.057 | tSu | | 1 | camera/runtime_network.net/check_sum_20_s1

Path Statistics:

Clock Skew: | 0.371
Setup Relationship: | 2.000
Logic Level: | 15
Arrival Clock Path Delay: | cell: 0.000, 0.000%; route: 0.371, 100.000%
Arrival Data Path Delay: | cell: 5.789, 56.662%; route: 4.084, 39.969%; tC2Q: 0.344, 3.369%
Required Clock Path Delay: | cell: 0.000, 0.000%; route: 0.371, 100.000%

### Path 6

Path Summary:

Slack | -7.924
Data Arrival Time | 40.574
Data Required Time | 32.650
From | camera/runtime_network.net/memory[29]_0_s0
To | camera/runtime_network.net/check_sum_15_s1
Launch Clk | rgmii_rxc[R]
Latch Clk | camera/pll/PLL_inst/CLKOUT1.default_gen_clk[R]

Data Arrival Path:

AT | DELAY | TYPE | RF | FANOUT | NODE
30.000 | 30.000 | | | | active clock edge time
30.000 | 0.000 | | | | rgmii_rxc
30.000 | 0.000 | tCL | RR | 1 | rgmii_rxc_ibuf/I
30.000 | 0.000 | tINS | RR | 825 | rgmii_rxc_ibuf/O
30.371 | 0.371 | tNET | RR | 1 | camera/runtime_network.net/memory[29]_0_s0/CLK
30.715 | 0.344 | tC2Q | RR | 11 | camera/runtime_network.net/memory[29]_0_s0/Q
31.087 | 0.371 | tNET | RR | 2 | camera/runtime_network.net/n7634_s/I1
31.627 | 0.540 | tINS | RF | 1 | camera/runtime_network.net/n7634_s/COUT
31.627 | 0.000 | tNET | FF | 2 | camera/runtime_network.net/n7633_s/CIN
31.672 | 0.045 | tINS | FR | 1 | camera/runtime_network.net/n7633_s/COUT
31.672 | 0.000 | tNET | RR | 2 | camera/runtime_network.net/n7632_s/CIN
31.717 | 0.045 | tINS | RR | 1 | camera/runtime_network.net/n7632_s/COUT
31.717 | 0.000 | tNET | RR | 2 | camera/runtime_network.net/n7631_s/CIN
31.762 | 0.045 | tINS | RR | 1 | camera/runtime_network.net/n7631_s/COUT
31.762 | 0.000 | tNET | RR | 2 | camera/runtime_network.net/n7630_s/CIN
31.807 | 0.045 | tINS | RR | 1 | camera/runtime_network.net/n7630_s/COUT
31.807 | 0.000 | tNET | RR | 2 | camera/runtime_network.net/n7629_s/CIN
31.852 | 0.045 | tINS | RR | 1 | camera/runtime_network.net/n7629_s/COUT
31.852 | 0.000 | tNET | RR | 2 | camera/runtime_network.net/n7628_s/CIN
32.071 | 0.219 | tINS | RR | 5 | camera/runtime_network.net/n7628_s/SUM
32.442 | 0.371 | tNET | RR | 1 | camera/runtime_network.net/n7660_s6/I0
32.963 | 0.521 | tINS | RR | 2 | camera/runtime_network.net/n7660_s6/F
33.334 | 0.371 | tNET | RR | 1 | camera/runtime_network.net/n7660_s4/I2
33.791 | 0.457 | tINS | RR | 5 | camera/runtime_network.net/n7660_s4/F
34.162 | 0.371 | tNET | RR | 1 | camera/runtime_network.net/n7654_s7/I2
34.619 | 0.457 | tINS | RR | 1 | camera/runtime_network.net/n7654_s7/F
34.990 | 0.371 | tNET | RR | 1 | camera/runtime_network.net/n7654_s5/I2
35.447 | 0.457 | tINS | RR | 3 | camera/runtime_network.net/n7654_s5/F
35.819 | 0.371 | tNET | RR | 1 | camera/runtime_network.net/n7653_s5/I0
36.339 | 0.521 | tINS | RR | 3 | camera/runtime_network.net/n7653_s5/F
36.711 | 0.371 | tNET | RR | 1 | camera/runtime_network.net/n7653_s3/I2
37.167 | 0.457 | tINS | RR | 1 | camera/runtime_network.net/n7653_s3/F
37.539 | 0.371 | tNET | RR | 2 | camera/runtime_network.net/n7693_s/I0
38.244 | 0.705 | tINS | RR | 1 | camera/runtime_network.net/n7693_s/SUM
38.615 | 0.371 | tNET | RR | 2 | camera/runtime_network.net/n7693_s0/I0
39.321 | 0.705 | tINS | RR | 1 | camera/runtime_network.net/n7693_s0/SUM
39.692 | 0.371 | tNET | RR | 1 | camera/runtime_network.net/n8954_s20/I1
40.203 | 0.511 | tINS | RR | 1 | camera/runtime_network.net/n8954_s20/F
40.574 | 0.371 | tNET | RR | 1 | camera/runtime_network.net/check_sum_15_s1/D

Data Required Path:

AT | DELAY | TYPE | RF | FANOUT | NODE
32.000 | 32.000 | | | | active clock edge time
32.000 | 0.000 | | | | camera/pll/PLL_inst/CLKOUT1.default_gen_clk
32.371 | 0.371 | tCL | RR | 6185 | camera/pll/PLL_inst/CLKOUT1
32.743 | 0.371 | tNET | RR | 1 | camera/runtime_network.net/check_sum_15_s1/CLK
32.708 | -0.035 | tUnc | | | camera/runtime_network.net/check_sum_15_s1
32.650 | -0.057 | tSu | | 1 | camera/runtime_network.net/check_sum_15_s1

Path Statistics:

Clock Skew: | 0.371
Setup Relationship: | 2.000
Logic Level: | 13
Arrival Clock Path Delay: | cell: 0.000, 0.000%; route: 0.371, 100.000%
Arrival Data Path Delay: | cell: 5.775, 56.600%; route: 4.084, 40.026%; tC2Q: 0.344, 3.374%
Required Clock Path Delay: | cell: 0.000, 0.000%; route: 0.371, 100.000%

### Path 7

Path Summary:

Slack | -7.081
Data Arrival Time | 39.731
Data Required Time | 32.650
From | camera/runtime_network.net/memory[29]_0_s0
To | camera/runtime_network.net/check_sum_14_s1
Launch Clk | rgmii_rxc[R]
Latch Clk | camera/pll/PLL_inst/CLKOUT1.default_gen_clk[R]

Data Arrival Path:

AT | DELAY | TYPE | RF | FANOUT | NODE
30.000 | 30.000 | | | | active clock edge time
30.000 | 0.000 | | | | rgmii_rxc
30.000 | 0.000 | tCL | RR | 1 | rgmii_rxc_ibuf/I
30.000 | 0.000 | tINS | RR | 825 | rgmii_rxc_ibuf/O
30.371 | 0.371 | tNET | RR | 1 | camera/runtime_network.net/memory[29]_0_s0/CLK
30.715 | 0.344 | tC2Q | RR | 11 | camera/runtime_network.net/memory[29]_0_s0/Q
31.087 | 0.371 | tNET | RR | 2 | camera/runtime_network.net/n7634_s/I1
31.627 | 0.540 | tINS | RF | 1 | camera/runtime_network.net/n7634_s/COUT
31.627 | 0.000 | tNET | FF | 2 | camera/runtime_network.net/n7633_s/CIN
31.672 | 0.045 | tINS | FR | 1 | camera/runtime_network.net/n7633_s/COUT
31.672 | 0.000 | tNET | RR | 2 | camera/runtime_network.net/n7632_s/CIN
31.717 | 0.045 | tINS | RR | 1 | camera/runtime_network.net/n7632_s/COUT
31.717 | 0.000 | tNET | RR | 2 | camera/runtime_network.net/n7631_s/CIN
31.762 | 0.045 | tINS | RR | 1 | camera/runtime_network.net/n7631_s/COUT
31.762 | 0.000 | tNET | RR | 2 | camera/runtime_network.net/n7630_s/CIN
31.807 | 0.045 | tINS | RR | 1 | camera/runtime_network.net/n7630_s/COUT
31.807 | 0.000 | tNET | RR | 2 | camera/runtime_network.net/n7629_s/CIN
31.852 | 0.045 | tINS | RR | 1 | camera/runtime_network.net/n7629_s/COUT
31.852 | 0.000 | tNET | RR | 2 | camera/runtime_network.net/n7628_s/CIN
32.071 | 0.219 | tINS | RR | 5 | camera/runtime_network.net/n7628_s/SUM
32.442 | 0.371 | tNET | RR | 1 | camera/runtime_network.net/n7660_s6/I0
32.963 | 0.521 | tINS | RR | 2 | camera/runtime_network.net/n7660_s6/F
33.334 | 0.371 | tNET | RR | 1 | camera/runtime_network.net/n7660_s4/I2
33.791 | 0.457 | tINS | RR | 5 | camera/runtime_network.net/n7660_s4/F
34.162 | 0.371 | tNET | RR | 1 | camera/runtime_network.net/n7654_s7/I2
34.619 | 0.457 | tINS | RR | 1 | camera/runtime_network.net/n7654_s7/F
34.990 | 0.371 | tNET | RR | 1 | camera/runtime_network.net/n7654_s5/I2
35.447 | 0.457 | tINS | RR | 3 | camera/runtime_network.net/n7654_s5/F
35.819 | 0.371 | tNET | RR | 1 | camera/runtime_network.net/n7655_s4/I2
36.275 | 0.457 | tINS | RR | 1 | camera/runtime_network.net/n7655_s4/F
36.646 | 0.371 | tNET | RR | 2 | camera/runtime_network.net/n7695_s/I0
37.352 | 0.705 | tINS | RR | 1 | camera/runtime_network.net/n7695_s/SUM
37.723 | 0.371 | tNET | RR | 2 | camera/runtime_network.net/n7695_s0/I0
38.259 | 0.535 | tINS | RF | 1 | camera/runtime_network.net/n7695_s0/COUT
38.259 | 0.000 | tNET | FF | 2 | camera/runtime_network.net/n7694_s0/CIN
38.478 | 0.219 | tINS | FR | 1 | camera/runtime_network.net/n7694_s0/SUM
38.849 | 0.371 | tNET | RR | 1 | camera/runtime_network.net/n8955_s20/I1
39.360 | 0.511 | tINS | RR | 1 | camera/runtime_network.net/n8955_s20/F
39.731 | 0.371 | tNET | RR | 1 | camera/runtime_network.net/check_sum_14_s1/D

Data Required Path:

AT | DELAY | TYPE | RF | FANOUT | NODE
32.000 | 32.000 | | | | active clock edge time
32.000 | 0.000 | | | | camera/pll/PLL_inst/CLKOUT1.default_gen_clk
32.371 | 0.371 | tCL | RR | 6185 | camera/pll/PLL_inst/CLKOUT1
32.743 | 0.371 | tNET | RR | 1 | camera/runtime_network.net/check_sum_14_s1/CLK
32.708 | -0.035 | tUnc | | | camera/runtime_network.net/check_sum_14_s1
32.650 | -0.057 | tSu | | 1 | camera/runtime_network.net/check_sum_14_s1

Path Statistics:

Clock Skew: | 0.371
Setup Relationship: | 2.000
Logic Level: | 13
Arrival Clock Path Delay: | cell: 0.000, 0.000%; route: 0.371, 100.000%
Arrival Data Path Delay: | cell: 5.303, 56.659%; route: 3.712, 39.663%; tC2Q: 0.344, 3.678%
Required Clock Path Delay: | cell: 0.000, 0.000%; route: 0.371, 100.000%

### Path 8

Path Summary:

Slack | -7.032
Data Arrival Time | 39.682
Data Required Time | 32.650
From | camera/runtime_network.net/memory[29]_0_s0
To | camera/runtime_network.net/check_sum_13_s1
Launch Clk | rgmii_rxc[R]
Latch Clk | camera/pll/PLL_inst/CLKOUT1.default_gen_clk[R]

Data Arrival Path:

AT | DELAY | TYPE | RF | FANOUT | NODE
30.000 | 30.000 | | | | active clock edge time
30.000 | 0.000 | | | | rgmii_rxc
30.000 | 0.000 | tCL | RR | 1 | rgmii_rxc_ibuf/I
30.000 | 0.000 | tINS | RR | 825 | rgmii_rxc_ibuf/O
30.371 | 0.371 | tNET | RR | 1 | camera/runtime_network.net/memory[29]_0_s0/CLK
30.715 | 0.344 | tC2Q | RR | 11 | camera/runtime_network.net/memory[29]_0_s0/Q
31.087 | 0.371 | tNET | RR | 2 | camera/runtime_network.net/n7634_s/I1
31.627 | 0.540 | tINS | RF | 1 | camera/runtime_network.net/n7634_s/COUT
31.627 | 0.000 | tNET | FF | 2 | camera/runtime_network.net/n7633_s/CIN
31.672 | 0.045 | tINS | FR | 1 | camera/runtime_network.net/n7633_s/COUT
31.672 | 0.000 | tNET | RR | 2 | camera/runtime_network.net/n7632_s/CIN
31.717 | 0.045 | tINS | RR | 1 | camera/runtime_network.net/n7632_s/COUT
31.717 | 0.000 | tNET | RR | 2 | camera/runtime_network.net/n7631_s/CIN
31.762 | 0.045 | tINS | RR | 1 | camera/runtime_network.net/n7631_s/COUT
31.762 | 0.000 | tNET | RR | 2 | camera/runtime_network.net/n7630_s/CIN
31.807 | 0.045 | tINS | RR | 1 | camera/runtime_network.net/n7630_s/COUT
31.807 | 0.000 | tNET | RR | 2 | camera/runtime_network.net/n7629_s/CIN
31.852 | 0.045 | tINS | RR | 1 | camera/runtime_network.net/n7629_s/COUT
31.852 | 0.000 | tNET | RR | 2 | camera/runtime_network.net/n7628_s/CIN
32.071 | 0.219 | tINS | RR | 5 | camera/runtime_network.net/n7628_s/SUM
32.442 | 0.371 | tNET | RR | 1 | camera/runtime_network.net/n7660_s6/I0
32.963 | 0.521 | tINS | RR | 2 | camera/runtime_network.net/n7660_s6/F
33.334 | 0.371 | tNET | RR | 1 | camera/runtime_network.net/n7660_s4/I2
33.791 | 0.457 | tINS | RR | 5 | camera/runtime_network.net/n7660_s4/F
34.162 | 0.371 | tNET | RR | 1 | camera/runtime_network.net/n7654_s7/I2
34.619 | 0.457 | tINS | RR | 1 | camera/runtime_network.net/n7654_s7/F
34.990 | 0.371 | tNET | RR | 1 | camera/runtime_network.net/n7654_s5/I2
35.447 | 0.457 | tINS | RR | 3 | camera/runtime_network.net/n7654_s5/F
35.819 | 0.371 | tNET | RR | 1 | camera/runtime_network.net/n7655_s4/I2
36.275 | 0.457 | tINS | RR | 1 | camera/runtime_network.net/n7655_s4/F
36.646 | 0.371 | tNET | RR | 2 | camera/runtime_network.net/n7695_s/I0
37.352 | 0.705 | tINS | RR | 1 | camera/runtime_network.net/n7695_s/SUM
37.723 | 0.371 | tNET | RR | 2 | camera/runtime_network.net/n7695_s0/I0
38.429 | 0.705 | tINS | RR | 1 | camera/runtime_network.net/n7695_s0/SUM
38.800 | 0.371 | tNET | RR | 1 | camera/runtime_network.net/n8956_s20/I1
39.311 | 0.511 | tINS | RR | 1 | camera/runtime_network.net/n8956_s20/F
39.682 | 0.371 | tNET | RR | 1 | camera/runtime_network.net/check_sum_13_s1/D

Data Required Path:

AT | DELAY | TYPE | RF | FANOUT | NODE
32.000 | 32.000 | | | | active clock edge time
32.000 | 0.000 | | | | camera/pll/PLL_inst/CLKOUT1.default_gen_clk
32.371 | 0.371 | tCL | RR | 6185 | camera/pll/PLL_inst/CLKOUT1
32.743 | 0.371 | tNET | RR | 1 | camera/runtime_network.net/check_sum_13_s1/CLK
32.708 | -0.035 | tUnc | | | camera/runtime_network.net/check_sum_13_s1
32.650 | -0.057 | tSu | | 1 | camera/runtime_network.net/check_sum_13_s1

Path Statistics:

Clock Skew: | 0.371
Setup Relationship: | 2.000
Logic Level: | 12
Arrival Clock Path Delay: | cell: 0.000, 0.000%; route: 0.371, 100.000%
Arrival Data Path Delay: | cell: 5.254, 56.429%; route: 3.712, 39.874%; tC2Q: 0.344, 3.697%
Required Clock Path Delay: | cell: 0.000, 0.000%; route: 0.371, 100.000%

### Path 9

Path Summary:

Slack | -6.357
Data Arrival Time | 39.007
Data Required Time | 32.650
From | camera/runtime_network.net/memory[29]_0_s0
To | camera/runtime_network.net/check_sum_12_s1
Launch Clk | rgmii_rxc[R]
Latch Clk | camera/pll/PLL_inst/CLKOUT1.default_gen_clk[R]

Data Arrival Path:

AT | DELAY | TYPE | RF | FANOUT | NODE
30.000 | 30.000 | | | | active clock edge time
30.000 | 0.000 | | | | rgmii_rxc
30.000 | 0.000 | tCL | RR | 1 | rgmii_rxc_ibuf/I
30.000 | 0.000 | tINS | RR | 825 | rgmii_rxc_ibuf/O
30.371 | 0.371 | tNET | RR | 1 | camera/runtime_network.net/memory[29]_0_s0/CLK
30.715 | 0.344 | tC2Q | RR | 11 | camera/runtime_network.net/memory[29]_0_s0/Q
31.087 | 0.371 | tNET | RR | 2 | camera/runtime_network.net/n7634_s/I1
31.627 | 0.540 | tINS | RF | 1 | camera/runtime_network.net/n7634_s/COUT
31.627 | 0.000 | tNET | FF | 2 | camera/runtime_network.net/n7633_s/CIN
31.672 | 0.045 | tINS | FR | 1 | camera/runtime_network.net/n7633_s/COUT
31.672 | 0.000 | tNET | RR | 2 | camera/runtime_network.net/n7632_s/CIN
31.717 | 0.045 | tINS | RR | 1 | camera/runtime_network.net/n7632_s/COUT
31.717 | 0.000 | tNET | RR | 2 | camera/runtime_network.net/n7631_s/CIN
31.762 | 0.045 | tINS | RR | 1 | camera/runtime_network.net/n7631_s/COUT
31.762 | 0.000 | tNET | RR | 2 | camera/runtime_network.net/n7630_s/CIN
31.807 | 0.045 | tINS | RR | 1 | camera/runtime_network.net/n7630_s/COUT
31.807 | 0.000 | tNET | RR | 2 | camera/runtime_network.net/n7629_s/CIN
31.852 | 0.045 | tINS | RR | 1 | camera/runtime_network.net/n7629_s/COUT
31.852 | 0.000 | tNET | RR | 2 | camera/runtime_network.net/n7628_s/CIN
32.071 | 0.219 | tINS | RR | 5 | camera/runtime_network.net/n7628_s/SUM
32.442 | 0.371 | tNET | RR | 1 | camera/runtime_network.net/n7660_s6/I0
32.963 | 0.521 | tINS | RR | 2 | camera/runtime_network.net/n7660_s6/F
33.334 | 0.371 | tNET | RR | 1 | camera/runtime_network.net/n7660_s4/I2
33.791 | 0.457 | tINS | RR | 5 | camera/runtime_network.net/n7660_s4/F
34.162 | 0.371 | tNET | RR | 1 | camera/runtime_network.net/n7658_s5/I2
34.619 | 0.457 | tINS | RR | 3 | camera/runtime_network.net/n7658_s5/F
34.990 | 0.371 | tNET | RR | 1 | camera/runtime_network.net/n7658_s3/I1
35.501 | 0.511 | tINS | RR | 1 | camera/runtime_network.net/n7658_s3/F
35.873 | 0.371 | tNET | RR | 2 | camera/runtime_network.net/n7698_s/I0
36.408 | 0.535 | tINS | RF | 1 | camera/runtime_network.net/n7698_s/COUT
36.408 | 0.000 | tNET | FF | 2 | camera/runtime_network.net/n7697_s/CIN
36.627 | 0.219 | tINS | FR | 1 | camera/runtime_network.net/n7697_s/SUM
36.999 | 0.371 | tNET | RR | 2 | camera/runtime_network.net/n7697_s0/I0
37.534 | 0.535 | tINS | RF | 1 | camera/runtime_network.net/n7697_s0/COUT
37.534 | 0.000 | tNET | FF | 2 | camera/runtime_network.net/n7696_s0/CIN
37.754 | 0.219 | tINS | FR | 1 | camera/runtime_network.net/n7696_s0/SUM
38.125 | 0.371 | tNET | RR | 1 | camera/runtime_network.net/n8957_s20/I1
38.635 | 0.511 | tINS | RR | 1 | camera/runtime_network.net/n8957_s20/F
39.007 | 0.371 | tNET | RR | 1 | camera/runtime_network.net/check_sum_12_s1/D

Data Required Path:

AT | DELAY | TYPE | RF | FANOUT | NODE
32.000 | 32.000 | | | | active clock edge time
32.000 | 0.000 | | | | camera/pll/PLL_inst/CLKOUT1.default_gen_clk
32.371 | 0.371 | tCL | RR | 6185 | camera/pll/PLL_inst/CLKOUT1
32.743 | 0.371 | tNET | RR | 1 | camera/runtime_network.net/check_sum_12_s1/CLK
32.708 | -0.035 | tUnc | | | camera/runtime_network.net/check_sum_12_s1
32.650 | -0.057 | tSu | | 1 | camera/runtime_network.net/check_sum_12_s1

Path Statistics:

Clock Skew: | 0.371
Setup Relationship: | 2.000
Logic Level: | 13
Arrival Clock Path Delay: | cell: 0.000, 0.000%; route: 0.371, 100.000%
Arrival Data Path Delay: | cell: 4.950, 57.322%; route: 3.341, 38.692%; tC2Q: 0.344, 3.986%
Required Clock Path Delay: | cell: 0.000, 0.000%; route: 0.371, 100.000%

### Path 10

Path Summary:

Slack | -6.307
Data Arrival Time | 38.957
Data Required Time | 32.650
From | camera/runtime_network.net/memory[29]_0_s0
To | camera/runtime_network.net/check_sum_11_s1
Launch Clk | rgmii_rxc[R]
Latch Clk | camera/pll/PLL_inst/CLKOUT1.default_gen_clk[R]

Data Arrival Path:

AT | DELAY | TYPE | RF | FANOUT | NODE
30.000 | 30.000 | | | | active clock edge time
30.000 | 0.000 | | | | rgmii_rxc
30.000 | 0.000 | tCL | RR | 1 | rgmii_rxc_ibuf/I
30.000 | 0.000 | tINS | RR | 825 | rgmii_rxc_ibuf/O
30.371 | 0.371 | tNET | RR | 1 | camera/runtime_network.net/memory[29]_0_s0/CLK
30.715 | 0.344 | tC2Q | RR | 11 | camera/runtime_network.net/memory[29]_0_s0/Q
31.087 | 0.371 | tNET | RR | 2 | camera/runtime_network.net/n7634_s/I1
31.627 | 0.540 | tINS | RF | 1 | camera/runtime_network.net/n7634_s/COUT
31.627 | 0.000 | tNET | FF | 2 | camera/runtime_network.net/n7633_s/CIN
31.672 | 0.045 | tINS | FR | 1 | camera/runtime_network.net/n7633_s/COUT
31.672 | 0.000 | tNET | RR | 2 | camera/runtime_network.net/n7632_s/CIN
31.717 | 0.045 | tINS | RR | 1 | camera/runtime_network.net/n7632_s/COUT
31.717 | 0.000 | tNET | RR | 2 | camera/runtime_network.net/n7631_s/CIN
31.762 | 0.045 | tINS | RR | 1 | camera/runtime_network.net/n7631_s/COUT
31.762 | 0.000 | tNET | RR | 2 | camera/runtime_network.net/n7630_s/CIN
31.807 | 0.045 | tINS | RR | 1 | camera/runtime_network.net/n7630_s/COUT
31.807 | 0.000 | tNET | RR | 2 | camera/runtime_network.net/n7629_s/CIN
31.852 | 0.045 | tINS | RR | 1 | camera/runtime_network.net/n7629_s/COUT
31.852 | 0.000 | tNET | RR | 2 | camera/runtime_network.net/n7628_s/CIN
32.071 | 0.219 | tINS | RR | 5 | camera/runtime_network.net/n7628_s/SUM
32.442 | 0.371 | tNET | RR | 1 | camera/runtime_network.net/n7660_s6/I0
32.963 | 0.521 | tINS | RR | 2 | camera/runtime_network.net/n7660_s6/F
33.334 | 0.371 | tNET | RR | 1 | camera/runtime_network.net/n7660_s4/I2
33.791 | 0.457 | tINS | RR | 5 | camera/runtime_network.net/n7660_s4/F
34.162 | 0.371 | tNET | RR | 1 | camera/runtime_network.net/n7658_s5/I2
34.619 | 0.457 | tINS | RR | 3 | camera/runtime_network.net/n7658_s5/F
34.990 | 0.371 | tNET | RR | 1 | camera/runtime_network.net/n7658_s3/I1
35.501 | 0.511 | tINS | RR | 1 | camera/runtime_network.net/n7658_s3/F
35.873 | 0.371 | tNET | RR | 2 | camera/runtime_network.net/n7698_s/I0
36.578 | 0.705 | tINS | RR | 1 | camera/runtime_network.net/n7698_s/SUM
36.949 | 0.371 | tNET | RR | 2 | camera/runtime_network.net/n7698_s0/I0
37.485 | 0.535 | tINS | RF | 1 | camera/runtime_network.net/n7698_s0/COUT
37.485 | 0.000 | tNET | FF | 2 | camera/runtime_network.net/n7697_s0/CIN
37.704 | 0.219 | tINS | FR | 1 | camera/runtime_network.net/n7697_s0/SUM
38.075 | 0.371 | tNET | RR | 1 | camera/runtime_network.net/n8958_s20/I1
38.586 | 0.511 | tINS | RR | 1 | camera/runtime_network.net/n8958_s20/F
38.957 | 0.371 | tNET | RR | 1 | camera/runtime_network.net/check_sum_11_s1/D

Data Required Path:

AT | DELAY | TYPE | RF | FANOUT | NODE
32.000 | 32.000 | | | | active clock edge time
32.000 | 0.000 | | | | camera/pll/PLL_inst/CLKOUT1.default_gen_clk
32.371 | 0.371 | tCL | RR | 6185 | camera/pll/PLL_inst/CLKOUT1
32.743 | 0.371 | tNET | RR | 1 | camera/runtime_network.net/check_sum_11_s1/CLK
32.708 | -0.035 | tUnc | | | camera/runtime_network.net/check_sum_11_s1
32.650 | -0.057 | tSu | | 1 | camera/runtime_network.net/check_sum_11_s1

Path Statistics:

Clock Skew: | 0.371
Setup Relationship: | 2.000
Logic Level: | 12
Arrival Clock Path Delay: | cell: 0.000, 0.000%; route: 0.371, 100.000%
Arrival Data Path Delay: | cell: 4.900, 57.076%; route: 3.341, 38.915%; tC2Q: 0.344, 4.009%
Required Clock Path Delay: | cell: 0.000, 0.000%; route: 0.371, 100.000%

### Path 11

Path Summary:

Slack | -6.258
Data Arrival Time | 38.908
Data Required Time | 32.650
From | camera/runtime_network.net/memory[29]_0_s0
To | camera/runtime_network.net/check_sum_10_s1
Launch Clk | rgmii_rxc[R]
Latch Clk | camera/pll/PLL_inst/CLKOUT1.default_gen_clk[R]

Data Arrival Path:

AT | DELAY | TYPE | RF | FANOUT | NODE
30.000 | 30.000 | | | | active clock edge time
30.000 | 0.000 | | | | rgmii_rxc
30.000 | 0.000 | tCL | RR | 1 | rgmii_rxc_ibuf/I
30.000 | 0.000 | tINS | RR | 825 | rgmii_rxc_ibuf/O
30.371 | 0.371 | tNET | RR | 1 | camera/runtime_network.net/memory[29]_0_s0/CLK
30.715 | 0.344 | tC2Q | RR | 11 | camera/runtime_network.net/memory[29]_0_s0/Q
31.087 | 0.371 | tNET | RR | 2 | camera/runtime_network.net/n7634_s/I1
31.627 | 0.540 | tINS | RF | 1 | camera/runtime_network.net/n7634_s/COUT
31.627 | 0.000 | tNET | FF | 2 | camera/runtime_network.net/n7633_s/CIN
31.672 | 0.045 | tINS | FR | 1 | camera/runtime_network.net/n7633_s/COUT
31.672 | 0.000 | tNET | RR | 2 | camera/runtime_network.net/n7632_s/CIN
31.717 | 0.045 | tINS | RR | 1 | camera/runtime_network.net/n7632_s/COUT
31.717 | 0.000 | tNET | RR | 2 | camera/runtime_network.net/n7631_s/CIN
31.762 | 0.045 | tINS | RR | 1 | camera/runtime_network.net/n7631_s/COUT
31.762 | 0.000 | tNET | RR | 2 | camera/runtime_network.net/n7630_s/CIN
31.807 | 0.045 | tINS | RR | 1 | camera/runtime_network.net/n7630_s/COUT
31.807 | 0.000 | tNET | RR | 2 | camera/runtime_network.net/n7629_s/CIN
31.852 | 0.045 | tINS | RR | 1 | camera/runtime_network.net/n7629_s/COUT
31.852 | 0.000 | tNET | RR | 2 | camera/runtime_network.net/n7628_s/CIN
32.071 | 0.219 | tINS | RR | 5 | camera/runtime_network.net/n7628_s/SUM
32.442 | 0.371 | tNET | RR | 1 | camera/runtime_network.net/n7660_s6/I0
32.963 | 0.521 | tINS | RR | 2 | camera/runtime_network.net/n7660_s6/F
33.334 | 0.371 | tNET | RR | 1 | camera/runtime_network.net/n7660_s4/I2
33.791 | 0.457 | tINS | RR | 5 | camera/runtime_network.net/n7660_s4/F
34.162 | 0.371 | tNET | RR | 1 | camera/runtime_network.net/n7658_s5/I2
34.619 | 0.457 | tINS | RR | 3 | camera/runtime_network.net/n7658_s5/F
34.990 | 0.371 | tNET | RR | 1 | camera/runtime_network.net/n7658_s3/I1
35.501 | 0.511 | tINS | RR | 1 | camera/runtime_network.net/n7658_s3/F
35.873 | 0.371 | tNET | RR | 2 | camera/runtime_network.net/n7698_s/I0
36.578 | 0.705 | tINS | RR | 1 | camera/runtime_network.net/n7698_s/SUM
36.949 | 0.371 | tNET | RR | 2 | camera/runtime_network.net/n7698_s0/I0
37.654 | 0.705 | tINS | RR | 1 | camera/runtime_network.net/n7698_s0/SUM
38.026 | 0.371 | tNET | RR | 1 | camera/runtime_network.net/n8959_s20/I1
38.536 | 0.511 | tINS | RR | 1 | camera/runtime_network.net/n8959_s20/F
38.908 | 0.371 | tNET | RR | 1 | camera/runtime_network.net/check_sum_10_s1/D

Data Required Path:

AT | DELAY | TYPE | RF | FANOUT | NODE
32.000 | 32.000 | | | | active clock edge time
32.000 | 0.000 | | | | camera/pll/PLL_inst/CLKOUT1.default_gen_clk
32.371 | 0.371 | tCL | RR | 6185 | camera/pll/PLL_inst/CLKOUT1
32.743 | 0.371 | tNET | RR | 1 | camera/runtime_network.net/check_sum_10_s1/CLK
32.708 | -0.035 | tUnc | | | camera/runtime_network.net/check_sum_10_s1
32.650 | -0.057 | tSu | | 1 | camera/runtime_network.net/check_sum_10_s1

Path Statistics:

Clock Skew: | 0.371
Setup Relationship: | 2.000
Logic Level: | 11
Arrival Clock Path Delay: | cell: 0.000, 0.000%; route: 0.371, 100.000%
Arrival Data Path Delay: | cell: 4.851, 56.826%; route: 3.341, 39.141%; tC2Q: 0.344, 4.033%
Required Clock Path Delay: | cell: 0.000, 0.000%; route: 0.371, 100.000%

### Path 12

Path Summary:

Slack | -5.479
Data Arrival Time | 38.129
Data Required Time | 32.650
From | camera/runtime_network.net/memory[29]_0_s0
To | camera/runtime_network.net/check_sum_9_s1
Launch Clk | rgmii_rxc[R]
Latch Clk | camera/pll/PLL_inst/CLKOUT1.default_gen_clk[R]

Data Arrival Path:

AT | DELAY | TYPE | RF | FANOUT | NODE
30.000 | 30.000 | | | | active clock edge time
30.000 | 0.000 | | | | rgmii_rxc
30.000 | 0.000 | tCL | RR | 1 | rgmii_rxc_ibuf/I
30.000 | 0.000 | tINS | RR | 825 | rgmii_rxc_ibuf/O
30.371 | 0.371 | tNET | RR | 1 | camera/runtime_network.net/memory[29]_0_s0/CLK
30.715 | 0.344 | tC2Q | RR | 11 | camera/runtime_network.net/memory[29]_0_s0/Q
31.087 | 0.371 | tNET | RR | 2 | camera/runtime_network.net/n7634_s/I1
31.627 | 0.540 | tINS | RF | 1 | camera/runtime_network.net/n7634_s/COUT
31.627 | 0.000 | tNET | FF | 2 | camera/runtime_network.net/n7633_s/CIN
31.672 | 0.045 | tINS | FR | 1 | camera/runtime_network.net/n7633_s/COUT
31.672 | 0.000 | tNET | RR | 2 | camera/runtime_network.net/n7632_s/CIN
31.717 | 0.045 | tINS | RR | 1 | camera/runtime_network.net/n7632_s/COUT
31.717 | 0.000 | tNET | RR | 2 | camera/runtime_network.net/n7631_s/CIN
31.762 | 0.045 | tINS | RR | 1 | camera/runtime_network.net/n7631_s/COUT
31.762 | 0.000 | tNET | RR | 2 | camera/runtime_network.net/n7630_s/CIN
31.807 | 0.045 | tINS | RR | 1 | camera/runtime_network.net/n7630_s/COUT
31.807 | 0.000 | tNET | RR | 2 | camera/runtime_network.net/n7629_s/CIN
31.852 | 0.045 | tINS | RR | 1 | camera/runtime_network.net/n7629_s/COUT
31.852 | 0.000 | tNET | RR | 2 | camera/runtime_network.net/n7628_s/CIN
32.071 | 0.219 | tINS | RR | 5 | camera/runtime_network.net/n7628_s/SUM
32.442 | 0.371 | tNET | RR | 1 | camera/runtime_network.net/n7660_s6/I0
32.963 | 0.521 | tINS | RR | 2 | camera/runtime_network.net/n7660_s6/F
33.334 | 0.371 | tNET | RR | 1 | camera/runtime_network.net/n7660_s4/I2
33.791 | 0.457 | tINS | RR | 5 | camera/runtime_network.net/n7660_s4/F
34.162 | 0.371 | tNET | RR | 1 | camera/runtime_network.net/n7660_s3/I1
34.673 | 0.511 | tINS | RR | 1 | camera/runtime_network.net/n7660_s3/F
35.044 | 0.371 | tNET | RR | 2 | camera/runtime_network.net/n7700_s/I0
35.750 | 0.705 | tINS | RR | 1 | camera/runtime_network.net/n7700_s/SUM
36.121 | 0.371 | tNET | RR | 2 | camera/runtime_network.net/n7700_s0/I0
36.657 | 0.535 | tINS | RF | 1 | camera/runtime_network.net/n7700_s0/COUT
36.657 | 0.000 | tNET | FF | 2 | camera/runtime_network.net/n7699_s0/CIN
36.876 | 0.219 | tINS | FR | 1 | camera/runtime_network.net/n7699_s0/SUM
37.247 | 0.371 | tNET | RR | 1 | camera/runtime_network.net/n8960_s20/I1
37.758 | 0.511 | tINS | RR | 1 | camera/runtime_network.net/n8960_s20/F
38.129 | 0.371 | tNET | RR | 1 | camera/runtime_network.net/check_sum_9_s1/D

Data Required Path:

AT | DELAY | TYPE | RF | FANOUT | NODE
32.000 | 32.000 | | | | active clock edge time
32.000 | 0.000 | | | | camera/pll/PLL_inst/CLKOUT1.default_gen_clk
32.371 | 0.371 | tCL | RR | 6185 | camera/pll/PLL_inst/CLKOUT1
32.743 | 0.371 | tNET | RR | 1 | camera/runtime_network.net/check_sum_9_s1/CLK
32.708 | -0.035 | tUnc | | | camera/runtime_network.net/check_sum_9_s1
32.650 | -0.057 | tSu | | 1 | camera/runtime_network.net/check_sum_9_s1

Path Statistics:

Clock Skew: | 0.371
Setup Relationship: | 2.000
Logic Level: | 11
Arrival Clock Path Delay: | cell: 0.000, 0.000%; route: 0.371, 100.000%
Arrival Data Path Delay: | cell: 4.444, 57.280%; route: 2.970, 38.283%; tC2Q: 0.344, 4.437%
Required Clock Path Delay: | cell: 0.000, 0.000%; route: 0.371, 100.000%

### Path 13

Path Summary:

Slack | -5.430
Data Arrival Time | 38.080
Data Required Time | 32.650
From | camera/runtime_network.net/memory[29]_0_s0
To | camera/runtime_network.net/check_sum_8_s1
Launch Clk | rgmii_rxc[R]
Latch Clk | camera/pll/PLL_inst/CLKOUT1.default_gen_clk[R]

Data Arrival Path:

AT | DELAY | TYPE | RF | FANOUT | NODE
30.000 | 30.000 | | | | active clock edge time
30.000 | 0.000 | | | | rgmii_rxc
30.000 | 0.000 | tCL | RR | 1 | rgmii_rxc_ibuf/I
30.000 | 0.000 | tINS | RR | 825 | rgmii_rxc_ibuf/O
30.371 | 0.371 | tNET | RR | 1 | camera/runtime_network.net/memory[29]_0_s0/CLK
30.715 | 0.344 | tC2Q | RR | 11 | camera/runtime_network.net/memory[29]_0_s0/Q
31.087 | 0.371 | tNET | RR | 2 | camera/runtime_network.net/n7634_s/I1
31.627 | 0.540 | tINS | RF | 1 | camera/runtime_network.net/n7634_s/COUT
31.627 | 0.000 | tNET | FF | 2 | camera/runtime_network.net/n7633_s/CIN
31.672 | 0.045 | tINS | FR | 1 | camera/runtime_network.net/n7633_s/COUT
31.672 | 0.000 | tNET | RR | 2 | camera/runtime_network.net/n7632_s/CIN
31.717 | 0.045 | tINS | RR | 1 | camera/runtime_network.net/n7632_s/COUT
31.717 | 0.000 | tNET | RR | 2 | camera/runtime_network.net/n7631_s/CIN
31.762 | 0.045 | tINS | RR | 1 | camera/runtime_network.net/n7631_s/COUT
31.762 | 0.000 | tNET | RR | 2 | camera/runtime_network.net/n7630_s/CIN
31.807 | 0.045 | tINS | RR | 1 | camera/runtime_network.net/n7630_s/COUT
31.807 | 0.000 | tNET | RR | 2 | camera/runtime_network.net/n7629_s/CIN
31.852 | 0.045 | tINS | RR | 1 | camera/runtime_network.net/n7629_s/COUT
31.852 | 0.000 | tNET | RR | 2 | camera/runtime_network.net/n7628_s/CIN
32.071 | 0.219 | tINS | RR | 5 | camera/runtime_network.net/n7628_s/SUM
32.442 | 0.371 | tNET | RR | 1 | camera/runtime_network.net/n7660_s6/I0
32.963 | 0.521 | tINS | RR | 2 | camera/runtime_network.net/n7660_s6/F
33.334 | 0.371 | tNET | RR | 1 | camera/runtime_network.net/n7660_s4/I2
33.791 | 0.457 | tINS | RR | 5 | camera/runtime_network.net/n7660_s4/F
34.162 | 0.371 | tNET | RR | 1 | camera/runtime_network.net/n7660_s3/I1
34.673 | 0.511 | tINS | RR | 1 | camera/runtime_network.net/n7660_s3/F
35.044 | 0.371 | tNET | RR | 2 | camera/runtime_network.net/n7700_s/I0
35.750 | 0.705 | tINS | RR | 1 | camera/runtime_network.net/n7700_s/SUM
36.121 | 0.371 | tNET | RR | 2 | camera/runtime_network.net/n7700_s0/I0
36.826 | 0.705 | tINS | RR | 1 | camera/runtime_network.net/n7700_s0/SUM
37.198 | 0.371 | tNET | RR | 1 | camera/runtime_network.net/n8961_s20/I1
37.708 | 0.511 | tINS | RR | 1 | camera/runtime_network.net/n8961_s20/F
38.080 | 0.371 | tNET | RR | 1 | camera/runtime_network.net/check_sum_8_s1/D

Data Required Path:

AT | DELAY | TYPE | RF | FANOUT | NODE
32.000 | 32.000 | | | | active clock edge time
32.000 | 0.000 | | | | camera/pll/PLL_inst/CLKOUT1.default_gen_clk
32.371 | 0.371 | tCL | RR | 6185 | camera/pll/PLL_inst/CLKOUT1
32.743 | 0.371 | tNET | RR | 1 | camera/runtime_network.net/check_sum_8_s1/CLK
32.708 | -0.035 | tUnc | | | camera/runtime_network.net/check_sum_8_s1
32.650 | -0.057 | tSu | | 1 | camera/runtime_network.net/check_sum_8_s1

Path Statistics:

Clock Skew: | 0.371
Setup Relationship: | 2.000
Logic Level: | 10
Arrival Clock Path Delay: | cell: 0.000, 0.000%; route: 0.371, 100.000%
Arrival Data Path Delay: | cell: 4.394, 57.005%; route: 2.970, 38.529%; tC2Q: 0.344, 4.466%
Required Clock Path Delay: | cell: 0.000, 0.000%; route: 0.371, 100.000%

### Path 14

Path Summary:

Slack | -5.263
Data Arrival Time | 37.913
Data Required Time | 32.650
From | camera/runtime_network.net/memory[11]_0_s0
To | camera/runtime_network.net/arp_accept_s0
Launch Clk | rgmii_rxc[R]
Latch Clk | camera/pll/PLL_inst/CLKOUT1.default_gen_clk[R]

Data Arrival Path:

AT | DELAY | TYPE | RF | FANOUT | NODE
30.000 | 30.000 | | | | active clock edge time
30.000 | 0.000 | | | | rgmii_rxc
30.000 | 0.000 | tCL | RR | 1 | rgmii_rxc_ibuf/I
30.000 | 0.000 | tINS | RR | 825 | rgmii_rxc_ibuf/O
30.371 | 0.371 | tNET | RR | 1 | camera/runtime_network.net/memory[11]_0_s0/CLK
30.715 | 0.344 | tC2Q | RR | 6 | camera/runtime_network.net/memory[11]_0_s0/Q
31.087 | 0.371 | tNET | RR | 2 | camera/runtime_network.net/n3776_s0/I1
31.627 | 0.540 | tINS | RF | 1 | camera/runtime_network.net/n3776_s0/COUT
31.627 | 0.000 | tNET | FF | 2 | camera/runtime_network.net/n3777_s0/CIN
31.672 | 0.045 | tINS | FR | 1 | camera/runtime_network.net/n3777_s0/COUT
31.672 | 0.000 | tNET | RR | 2 | camera/runtime_network.net/n3778_s0/CIN
31.717 | 0.045 | tINS | RR | 1 | camera/runtime_network.net/n3778_s0/COUT
31.717 | 0.000 | tNET | RR | 2 | camera/runtime_network.net/n3779_s0/CIN
31.762 | 0.045 | tINS | RR | 1 | camera/runtime_network.net/n3779_s0/COUT
31.762 | 0.000 | tNET | RR | 2 | camera/runtime_network.net/n3780_s0/CIN
31.807 | 0.045 | tINS | RR | 1 | camera/runtime_network.net/n3780_s0/COUT
31.807 | 0.000 | tNET | RR | 2 | camera/runtime_network.net/n3781_s0/CIN
31.852 | 0.045 | tINS | RR | 1 | camera/runtime_network.net/n3781_s0/COUT
31.852 | 0.000 | tNET | RR | 2 | camera/runtime_network.net/n3782_s0/CIN
31.897 | 0.045 | tINS | RR | 1 | camera/runtime_network.net/n3782_s0/COUT
31.897 | 0.000 | tNET | RR | 2 | camera/runtime_network.net/n3783_s0/CIN
31.942 | 0.045 | tINS | RR | 1 | camera/runtime_network.net/n3783_s0/COUT
31.942 | 0.000 | tNET | RR | 2 | camera/runtime_network.net/n3784_s0/CIN
31.987 | 0.045 | tINS | RR | 1 | camera/runtime_network.net/n3784_s0/COUT
31.987 | 0.000 | tNET | RR | 2 | camera/runtime_network.net/n3785_s0/CIN
32.032 | 0.045 | tINS | RR | 1 | camera/runtime_network.net/n3785_s0/COUT
32.032 | 0.000 | tNET | RR | 2 | camera/runtime_network.net/n3786_s0/CIN
32.077 | 0.045 | tINS | RR | 1 | camera/runtime_network.net/n3786_s0/COUT
32.077 | 0.000 | tNET | RR | 2 | camera/runtime_network.net/n3787_s0/CIN
32.122 | 0.045 | tINS | RR | 1 | camera/runtime_network.net/n3787_s0/COUT
32.122 | 0.000 | tNET | RR | 2 | camera/runtime_network.net/n3788_s0/CIN
32.167 | 0.045 | tINS | RR | 1 | camera/runtime_network.net/n3788_s0/COUT
32.167 | 0.000 | tNET | RR | 2 | camera/runtime_network.net/n3789_s0/CIN
32.212 | 0.045 | tINS | RR | 1 | camera/runtime_network.net/n3789_s0/COUT
32.212 | 0.000 | tNET | RR | 2 | camera/runtime_network.net/n3790_s0/CIN
32.257 | 0.045 | tINS | RR | 1 | camera/runtime_network.net/n3790_s0/COUT
32.257 | 0.000 | tNET | RR | 2 | camera/runtime_network.net/n3791_s0/CIN
32.302 | 0.045 | tINS | RR | 1 | camera/runtime_network.net/n3791_s0/COUT
32.302 | 0.000 | tNET | RR | 2 | camera/runtime_network.net/n3792_s0/CIN
32.347 | 0.045 | tINS | RR | 1 | camera/runtime_network.net/n3792_s0/COUT
32.347 | 0.000 | tNET | RR | 2 | camera/runtime_network.net/n3793_s0/CIN
32.392 | 0.045 | tINS | RR | 1 | camera/runtime_network.net/n3793_s0/COUT
32.392 | 0.000 | tNET | RR | 2 | camera/runtime_network.net/n3794_s0/CIN
32.437 | 0.045 | tINS | RR | 1 | camera/runtime_network.net/n3794_s0/COUT
32.437 | 0.000 | tNET | RR | 2 | camera/runtime_network.net/n3795_s0/CIN
32.482 | 0.045 | tINS | RR | 1 | camera/runtime_network.net/n3795_s0/COUT
32.482 | 0.000 | tNET | RR | 2 | camera/runtime_network.net/n3796_s0/CIN
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
34.624 | 0.511 | tINS | RR | 1 | camera/runtime_network.net/n3861_s21/F
34.995 | 0.371 | tNET | RR | 1 | camera/runtime_network.net/n3861_s11/I3
35.255 | 0.260 | tINS | RR | 1 | camera/runtime_network.net/n3861_s11/F
35.626 | 0.371 | tNET | RR | 1 | camera/runtime_network.net/n3861_s6/I2
36.083 | 0.457 | tINS | RR | 1 | camera/runtime_network.net/n3861_s6/F
36.454 | 0.371 | tNET | RR | 1 | camera/runtime_network.net/n3861_s2/I2
36.911 | 0.457 | tINS | RR | 1 | camera/runtime_network.net/n3861_s2/F
37.282 | 0.371 | tNET | RR | 1 | camera/runtime_network.net/n3861_s0/I3
37.542 | 0.260 | tINS | RR | 1 | camera/runtime_network.net/n3861_s0/F
37.913 | 0.371 | tNET | RR | 1 | camera/runtime_network.net/arp_accept_s0/D

Data Required Path:

AT | DELAY | TYPE | RF | FANOUT | NODE
32.000 | 32.000 | | | | active clock edge time
32.000 | 0.000 | | | | camera/pll/PLL_inst/CLKOUT1.default_gen_clk
32.371 | 0.371 | tCL | RR | 6185 | camera/pll/PLL_inst/CLKOUT1
32.743 | 0.371 | tNET | RR | 1 | camera/runtime_network.net/arp_accept_s0/CLK
32.708 | -0.035 | tUnc | | | camera/runtime_network.net/arp_accept_s0
32.650 | -0.057 | tSu | | 1 | camera/runtime_network.net/arp_accept_s0

Path Statistics:

Clock Skew: | 0.371
Setup Relationship: | 2.000
Logic Level: | 13
Arrival Clock Path Delay: | cell: 0.000, 0.000%; route: 0.371, 100.000%
Arrival Data Path Delay: | cell: 4.599, 60.979%; route: 2.599, 34.457%; tC2Q: 0.344, 4.564%
Required Clock Path Delay: | cell: 0.000, 0.000%; route: 0.371, 100.000%

### Path 15

Path Summary:

Slack | -4.511
Data Arrival Time | 37.161
Data Required Time | 32.650
From | camera/runtime_network.net/memory[29]_0_s0
To | camera/runtime_network.net/check_sum_7_s1
Launch Clk | rgmii_rxc[R]
Latch Clk | camera/pll/PLL_inst/CLKOUT1.default_gen_clk[R]

Data Arrival Path:

AT | DELAY | TYPE | RF | FANOUT | NODE
30.000 | 30.000 | | | | active clock edge time
30.000 | 0.000 | | | | rgmii_rxc
30.000 | 0.000 | tCL | RR | 1 | rgmii_rxc_ibuf/I
30.000 | 0.000 | tINS | RR | 825 | rgmii_rxc_ibuf/O
30.371 | 0.371 | tNET | RR | 1 | camera/runtime_network.net/memory[29]_0_s0/CLK
30.715 | 0.344 | tC2Q | RR | 11 | camera/runtime_network.net/memory[29]_0_s0/Q
31.087 | 0.371 | tNET | RR | 2 | camera/runtime_network.net/n7634_s/I1
31.627 | 0.540 | tINS | RF | 1 | camera/runtime_network.net/n7634_s/COUT
31.627 | 0.000 | tNET | FF | 2 | camera/runtime_network.net/n7633_s/CIN
31.672 | 0.045 | tINS | FR | 1 | camera/runtime_network.net/n7633_s/COUT
31.672 | 0.000 | tNET | RR | 2 | camera/runtime_network.net/n7632_s/CIN
31.891 | 0.219 | tINS | RR | 5 | camera/runtime_network.net/n7632_s/SUM
32.262 | 0.371 | tNET | RR | 1 | camera/runtime_network.net/n7663_s5/I1
32.773 | 0.511 | tINS | RR | 3 | camera/runtime_network.net/n7663_s5/F
33.144 | 0.371 | tNET | RR | 1 | camera/runtime_network.net/n7663_s3/I1
33.655 | 0.511 | tINS | RR | 1 | camera/runtime_network.net/n7663_s3/F
34.026 | 0.371 | tNET | RR | 2 | camera/runtime_network.net/n7703_s/I0
34.562 | 0.535 | tINS | RF | 1 | camera/runtime_network.net/n7703_s/COUT
34.562 | 0.000 | tNET | FF | 2 | camera/runtime_network.net/n7702_s/CIN
34.781 | 0.219 | tINS | FR | 1 | camera/runtime_network.net/n7702_s/SUM
35.153 | 0.371 | tNET | RR | 2 | camera/runtime_network.net/n7702_s0/I0
35.688 | 0.535 | tINS | RF | 1 | camera/runtime_network.net/n7702_s0/COUT
35.688 | 0.000 | tNET | FF | 2 | camera/runtime_network.net/n7701_s0/CIN
35.907 | 0.219 | tINS | FR | 1 | camera/runtime_network.net/n7701_s0/SUM
36.279 | 0.371 | tNET | RR | 1 | camera/runtime_network.net/n8962_s20/I1
36.789 | 0.511 | tINS | RR | 1 | camera/runtime_network.net/n8962_s20/F
37.161 | 0.371 | tNET | RR | 1 | camera/runtime_network.net/check_sum_7_s1/D

Data Required Path:

AT | DELAY | TYPE | RF | FANOUT | NODE
32.000 | 32.000 | | | | active clock edge time
32.000 | 0.000 | | | | camera/pll/PLL_inst/CLKOUT1.default_gen_clk
32.371 | 0.371 | tCL | RR | 6185 | camera/pll/PLL_inst/CLKOUT1
32.743 | 0.371 | tNET | RR | 1 | camera/runtime_network.net/check_sum_7_s1/CLK
32.708 | -0.035 | tUnc | | | camera/runtime_network.net/check_sum_7_s1
32.650 | -0.057 | tSu | | 1 | camera/runtime_network.net/check_sum_7_s1

Path Statistics:

Clock Skew: | 0.371
Setup Relationship: | 2.000
Logic Level: | 10
Arrival Clock Path Delay: | cell: 0.000, 0.000%; route: 0.371, 100.000%
Arrival Data Path Delay: | cell: 3.846, 56.653%; route: 2.599, 38.277%; tC2Q: 0.344, 5.070%
Required Clock Path Delay: | cell: 0.000, 0.000%; route: 0.371, 100.000%

### Path 16

Path Summary:

Slack | -4.461
Data Arrival Time | 37.111
Data Required Time | 32.650
From | camera/runtime_network.net/memory[29]_0_s0
To | camera/runtime_network.net/check_sum_6_s1
Launch Clk | rgmii_rxc[R]
Latch Clk | camera/pll/PLL_inst/CLKOUT1.default_gen_clk[R]

Data Arrival Path:

AT | DELAY | TYPE | RF | FANOUT | NODE
30.000 | 30.000 | | | | active clock edge time
30.000 | 0.000 | | | | rgmii_rxc
30.000 | 0.000 | tCL | RR | 1 | rgmii_rxc_ibuf/I
30.000 | 0.000 | tINS | RR | 825 | rgmii_rxc_ibuf/O
30.371 | 0.371 | tNET | RR | 1 | camera/runtime_network.net/memory[29]_0_s0/CLK
30.715 | 0.344 | tC2Q | RR | 11 | camera/runtime_network.net/memory[29]_0_s0/Q
31.087 | 0.371 | tNET | RR | 2 | camera/runtime_network.net/n7634_s/I1
31.627 | 0.540 | tINS | RF | 1 | camera/runtime_network.net/n7634_s/COUT
31.627 | 0.000 | tNET | FF | 2 | camera/runtime_network.net/n7633_s/CIN
31.672 | 0.045 | tINS | FR | 1 | camera/runtime_network.net/n7633_s/COUT
31.672 | 0.000 | tNET | RR | 2 | camera/runtime_network.net/n7632_s/CIN
31.891 | 0.219 | tINS | RR | 5 | camera/runtime_network.net/n7632_s/SUM
32.262 | 0.371 | tNET | RR | 1 | camera/runtime_network.net/n7663_s5/I1
32.773 | 0.511 | tINS | RR | 3 | camera/runtime_network.net/n7663_s5/F
33.144 | 0.371 | tNET | RR | 1 | camera/runtime_network.net/n7663_s3/I1
33.655 | 0.511 | tINS | RR | 1 | camera/runtime_network.net/n7663_s3/F
34.026 | 0.371 | tNET | RR | 2 | camera/runtime_network.net/n7703_s/I0
34.732 | 0.705 | tINS | RR | 1 | camera/runtime_network.net/n7703_s/SUM
35.103 | 0.371 | tNET | RR | 2 | camera/runtime_network.net/n7703_s0/I0
35.639 | 0.535 | tINS | RF | 1 | camera/runtime_network.net/n7703_s0/COUT
35.639 | 0.000 | tNET | FF | 2 | camera/runtime_network.net/n7702_s0/CIN
35.858 | 0.219 | tINS | FR | 1 | camera/runtime_network.net/n7702_s0/SUM
36.229 | 0.371 | tNET | RR | 1 | camera/runtime_network.net/n8963_s20/I1
36.740 | 0.511 | tINS | RR | 1 | camera/runtime_network.net/n8963_s20/F
37.111 | 0.371 | tNET | RR | 1 | camera/runtime_network.net/check_sum_6_s1/D

Data Required Path:

AT | DELAY | TYPE | RF | FANOUT | NODE
32.000 | 32.000 | | | | active clock edge time
32.000 | 0.000 | | | | camera/pll/PLL_inst/CLKOUT1.default_gen_clk
32.371 | 0.371 | tCL | RR | 6185 | camera/pll/PLL_inst/CLKOUT1
32.743 | 0.371 | tNET | RR | 1 | camera/runtime_network.net/check_sum_6_s1/CLK
32.708 | -0.035 | tUnc | | | camera/runtime_network.net/check_sum_6_s1
32.650 | -0.057 | tSu | | 1 | camera/runtime_network.net/check_sum_6_s1

Path Statistics:

Clock Skew: | 0.371
Setup Relationship: | 2.000
Logic Level: | 9
Arrival Clock Path Delay: | cell: 0.000, 0.000%; route: 0.371, 100.000%
Arrival Data Path Delay: | cell: 3.797, 56.334%; route: 2.599, 38.558%; tC2Q: 0.344, 5.108%
Required Clock Path Delay: | cell: 0.000, 0.000%; route: 0.371, 100.000%

### Path 17

Path Summary:

Slack | -4.411
Data Arrival Time | 37.062
Data Required Time | 32.650
From | camera/runtime_network.net/memory[29]_0_s0
To | camera/runtime_network.net/check_sum_5_s1
Launch Clk | rgmii_rxc[R]
Latch Clk | camera/pll/PLL_inst/CLKOUT1.default_gen_clk[R]

Data Arrival Path:

AT | DELAY | TYPE | RF | FANOUT | NODE
30.000 | 30.000 | | | | active clock edge time
30.000 | 0.000 | | | | rgmii_rxc
30.000 | 0.000 | tCL | RR | 1 | rgmii_rxc_ibuf/I
30.000 | 0.000 | tINS | RR | 825 | rgmii_rxc_ibuf/O
30.371 | 0.371 | tNET | RR | 1 | camera/runtime_network.net/memory[29]_0_s0/CLK
30.715 | 0.344 | tC2Q | RR | 11 | camera/runtime_network.net/memory[29]_0_s0/Q
31.087 | 0.371 | tNET | RR | 2 | camera/runtime_network.net/n7634_s/I1
31.627 | 0.540 | tINS | RF | 1 | camera/runtime_network.net/n7634_s/COUT
31.627 | 0.000 | tNET | FF | 2 | camera/runtime_network.net/n7633_s/CIN
31.672 | 0.045 | tINS | FR | 1 | camera/runtime_network.net/n7633_s/COUT
31.672 | 0.000 | tNET | RR | 2 | camera/runtime_network.net/n7632_s/CIN
31.891 | 0.219 | tINS | RR | 5 | camera/runtime_network.net/n7632_s/SUM
32.262 | 0.371 | tNET | RR | 1 | camera/runtime_network.net/n7663_s5/I1
32.773 | 0.511 | tINS | RR | 3 | camera/runtime_network.net/n7663_s5/F
33.144 | 0.371 | tNET | RR | 1 | camera/runtime_network.net/n7663_s3/I1
33.655 | 0.511 | tINS | RR | 1 | camera/runtime_network.net/n7663_s3/F
34.026 | 0.371 | tNET | RR | 2 | camera/runtime_network.net/n7703_s/I0
34.732 | 0.705 | tINS | RR | 1 | camera/runtime_network.net/n7703_s/SUM
35.103 | 0.371 | tNET | RR | 2 | camera/runtime_network.net/n7703_s0/I0
35.808 | 0.705 | tINS | RR | 1 | camera/runtime_network.net/n7703_s0/SUM
36.180 | 0.371 | tNET | RR | 1 | camera/runtime_network.net/n8964_s20/I1
36.690 | 0.511 | tINS | RR | 1 | camera/runtime_network.net/n8964_s20/F
37.062 | 0.371 | tNET | RR | 1 | camera/runtime_network.net/check_sum_5_s1/D

Data Required Path:

AT | DELAY | TYPE | RF | FANOUT | NODE
32.000 | 32.000 | | | | active clock edge time
32.000 | 0.000 | | | | camera/pll/PLL_inst/CLKOUT1.default_gen_clk
32.371 | 0.371 | tCL | RR | 6185 | camera/pll/PLL_inst/CLKOUT1
32.743 | 0.371 | tNET | RR | 1 | camera/runtime_network.net/check_sum_5_s1/CLK
32.708 | -0.035 | tUnc | | | camera/runtime_network.net/check_sum_5_s1
32.650 | -0.057 | tSu | | 1 | camera/runtime_network.net/check_sum_5_s1

Path Statistics:

Clock Skew: | 0.371
Setup Relationship: | 2.000
Logic Level: | 8
Arrival Clock Path Delay: | cell: 0.000, 0.000%; route: 0.371, 100.000%
Arrival Data Path Delay: | cell: 3.747, 56.012%; route: 2.599, 38.843%; tC2Q: 0.344, 5.145%
Required Clock Path Delay: | cell: 0.000, 0.000%; route: 0.371, 100.000%
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
