LilywantbecomeNIUBI/fpga-system-integration/hardware/pins.csv

group | signal | ball | direction | p7 | endpoint | status
legacy_disabled | legacy_m1_pwm_disabled[5] | A13 | OUT | 1 | Old DRV8323 PWM fixed low; not D157B | fixed_low
legacy_disabled | legacy_m1_pwm_disabled[4] | A14 | OUT | 2 | Old DRV8323 PWM fixed low; not D157B | fixed_low
legacy_disabled | legacy_m1_pwm_disabled[3] | A15 | OUT | 3 | Old DRV8323 PWM fixed low; not D157B | fixed_low
legacy_disabled | legacy_m1_pwm_disabled[2] | A16 | OUT | 4 | Old DRV8323 PWM fixed low; not D157B | fixed_low
legacy_disabled | legacy_m2_pwm_disabled[4] | C13 | OUT | 13 | Old DRV8323 PWM fixed low; not D157B | fixed_low
legacy_disabled | legacy_m2_pwm_disabled[3] | B13 | OUT | 14 | Old DRV8323 PWM fixed low; not D157B | fixed_low
legacy_disabled | legacy_m2_pwm_disabled[2] | D14 | OUT | 15 | Old DRV8323 PWM fixed low; not D157B | fixed_low
legacy_disabled | legacy_m2_pwm_disabled[1] | D15 | OUT | 16 | Old DRV8323 PWM fixed low; not D157B | fixed_low
spare_p7 | spare_p7_20 | B16 | UNASSIGNED | 20 | Old FOC connection retained; not a new chassis signal | reserved
camera | camera_rst_n | N20 | OUT |  |  | reserved
camera | camera_pwdn | L1 | OUT |  |  | reserved
camera | camera_sclk | M20 | OUT |  |  | reserved
ethernet | eth_rst_n | V22 | OUT |  |  | reserved
ethernet | eth_mdc | AA18 | OUT |  |  | reserved
ethernet | rgmii_txen | AA19 | OUT |  |  | reserved
ethernet | rgmii_txd[3] | Y22 | OUT |  |  | reserved
ethernet | rgmii_txd[2] | W21 | OUT |  |  | reserved
ethernet | rgmii_txd[1] | W22 | OUT |  |  | reserved
ethernet | rgmii_txd[0] | U21 | OUT |  |  | reserved
ethernet | rgmii_gtxc | U22 | OUT |  |  | reserved
camera | camera_sdat | L18 | INOUT |  |  | reserved
ethernet | eth_mdio | W17 | INOUT |  |  | reserved
camera | camera_data[7] | E1 | IN |  |  | reserved
camera | camera_data[6] | D1 | IN |  |  | reserved
camera | camera_data[5] | G2 | IN |  |  | reserved
camera | camera_data[4] | F1 | IN |  |  | reserved
camera | camera_data[3] | H2 | IN |  |  | reserved
camera | camera_data[2] | G1 | IN |  |  | reserved
camera | camera_data[1] | J1 | IN |  |  | reserved
camera | camera_data[0] | J2 | IN |  |  | reserved
camera | camera_pclk | B1 | IN |  |  | reserved
camera | camera_href | A1 | IN |  |  | reserved
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
