LilywantbecomeNIUBI/fpga-system-integration/docs/task4/ideal_model.png

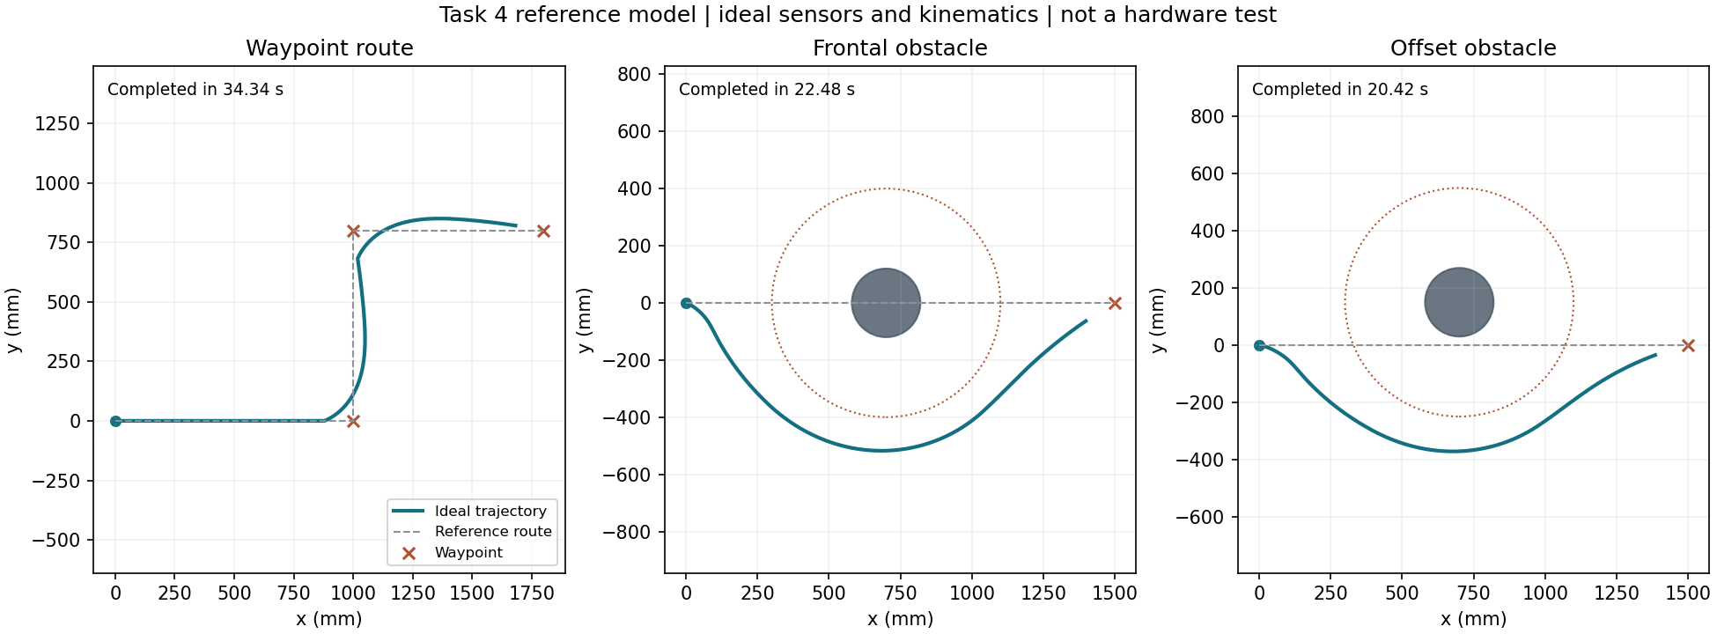
docs/task4/ideal_model.png
