LilywantbecomeNIUBI/fpga-system-integration/releases/experimental-360-routing-20261102/README.md

# 360 点整机实验版：已下载 SRAM，未通过时序验收

本目录包含实际下载的冻结源码、独立 Gowin 工程、压缩位流、时序报告、仿真及下载证据。
相机、光流、导航、IMU、360 点雷达、网口状态上传和原串口命令入口包含在整机中。

**实验状态：setup 881、hold 0，最小脉宽裕量 −0.849 ns，PR1014 仍存在。不得标为时序通过或实板功能验证通过。**
JTAG SRAM 下载完成，未写 Flash。下载后 PC 有线链路断开，未能完成 FPGA/Nano 网口验收。
该整机电机输出不再固定为 GND；仿真中未 ARM 时输出低，下载过程未发送任何串口控制命令。

优化内容：4 Bank RAM 写命令流水、资源复制、place=2/route=0、时钟资源清理和每域详细时序报告。
完整顶层仿真通过，BRAM 总量仍为 236，寄存器增加 288。全点雷达源码完整保留在 source 中。

位流 SHA256：`761696945e914e3685855dabc92544467e5f933eefae7305113223be1eeef2ff`。
`firmware.fs.gz` 是无损 gzip 压缩，用 Python `gzip.decompress` 解压后应核对上述哈希。
Gowin V1.9.12.04 打开 `sensor.gprj`，或执行 `gw_sh build.tcl` 可重新构建；重新构建可能得到不同布局。

恢复稳定版：标签 `lidar360-mpu6500-20261102`；原始稳定标签 `lidar360-static-20261102` 保持不变。
详细比较及后续瓶颈见 `ROUTING_OPTIMIZATION.md`。冻结仿真台中的本机夹具路径保留作证据。
