LilywantbecomeNIUBI/fpga-system-integration/docs/motor_validation.md

# 电机V1离线验证记录 — 2026-10-29

结论：独立双路有刷电机RTL及主机协议已实现，离线仿真与50MHz综合/布局布线通过。没有执行板卡下载、串口连接、电机运行或车辆动态验收；尚未与感知顶层集成。

| 项目 | 结果及证据 |
|---|---|
| AB解码仿真 | 四倍频正反计数、速度快照、毛刺过滤、非法跳变、极性反转、非零上电AB状态通过 |
| 单轮控制仿真 | PWM占空比、限幅、斜坡、静止换向等待、禁用关闭、PI抗饱和及简化无惯性模型收敛通过 |
| 双轮核心仿真 | 上电CLEAR/ARM、左右独立有符号目标、序号/回绕、重复/配置拒绝、超时、异步急停、无编码器运动与编码器异常保护通过 |
| UART端到端仿真 | 串行收发、CRC错误拒绝、残帧恢复、重复帧拒绝、状态快照CRC及STOP通过 |
| Python协议测试 | 3项通过：标准CRC向量、命令布局/范围校验、遥测流恢复 |
| 引脚审计 | 85个候选/预留信号球号无重复、36个P7 GPIO覆盖、9个底盘候选CST端口一致 |
| Gowin综合/布局布线 | V1.9.12.04，GW5AT-LV138PG484AC1/I0，50MHz，Setup=0、Hold=0违例 |
| 报告Fmax | 68.679MHz，仅代表该构建的内部时序估计 |
| 资源 | Logic 3242、Register 2046、DSP 6、I/O 23 |
| 旧驱动使能 | 综合网表确认F13/C15两路legacy disable输出均接GND；旧无刷工程未删除 |

构建启动时间UTC `2026-10-28T19:29:26Z`，对应北京时间2026-10-29 03:29:26。构建后重新核对所有输入文件哈希，与保存的仿真源文件一致。

固件SHA256：`12e18819862419ea4d281d124b373b247fe5ba98bf27ae0c2b24bcf98cc5c1be`。

本地工程：`build/motor/motor.gprj`；固件：`build/motor/impl/pnr/motor.fs`。生成物不提交Git，源码和构建脚本可重建。

详细证据：

- [构建参数与源码哈希](evidence/motor_v1/build.json)
- [仿真用例与源码哈希](evidence/motor_v1/simulation.json)
- [资源与布局布线报告](evidence/motor_v1/pnr_report.txt)

可在构建及测试成功后运行 `python tools/archive_motor_evidence.py` 重新归档；若源码已变或输出哈希不符，工具会拒绝归档。

简化仿真模型不包含实际电机电感、齿隙、摩擦、电池或车体动力学。当前PI增益和保护阈值尚未实车整定；额定电流、速度精度、载荷下稳定性、电气接线与动态性能均不能从该记录推断。编码器每输出轴转计数、极性和3.3V输入条件需要在后续悬空阶段确认。

2026-10-29 更新：有刷工程已移除外部许可输入与开环分支；当前保护回归使用软件 STOP、复位和看门狗。历史表中的“异步急停”仅描述旧版结果，不能作为新固件的外部许可功能。新版本实车轮速闭环仍未验收。
