LilywantbecomeNIUBI/fpga-system-integration/docs/DUAL_NETWORK_DEBUG_20261103.md

# 在线无线调试（2026-11-03）

已实际接通两条独立连接，不需要给车载路由器接 WAN：

| 用途 | 本次电脑接口 | 本次地址 |
| --- | --- | --- |
| 车辆控制、遥测、Nano 图传 | WLAN，CMCC-rDtN-5G | 192.168.50.100/24 |
| 互联网 / 在线协助 | Apple Mobile Device Ethernet，iPhone USB 网络共享 | 172.20.10.2/28，网关172.20.10.1 |

电脑到路由器的有线接口已断开；FPGA 到路由器的 LAN 网线继续保留。
本机另有 Meta 代理虚拟网卡；直接绑定源 IP 的 curl 探测受到其路径影响。
使用真实 DNS 及显式 USB 出口接口的独立 TLS 探测返回 HTTP200，随后切入车载 WLAN 后本次在线会话继续工作。
本次没有改动系统路由、代理配置或路由器 WAN。

## 已验证

无线 UDP6206 的 CLEAR、零目标 ARM、STOP、旧 ARM 拦截及约249.6ms看门狗均通过。
该轮遥测39帧，拒收、重复、丢失、过期计数均为0；四轮 PWM 和轮速保持0。
本轮没有执行非零运动目标，也不把零目标测试算作无线落地运动验收。

新上位机已用无线地址 `.100` 启动并连接，仅监测，不自动发起运动。
5秒状态观察中四轮停止、控制故障0、IMU已校准且数据新鲜；历史IMU NACK计数1910保持未增。
此前动作的可靠性仍须结合实际目标、完整反馈和电机/编码器标定判断，不能仅看网络连通。

## 在线读取方式

上位机每次连接会记录完整 M4/P4 反馈与发出的命令，文件位于：

- `host/runs/telemetry.<PID>.jsonl`：逐帧反馈及命令，单文件最多5MB，另保留一个轮换文件。
- `host/runs/live_status.<PID>.json`：按进程独立的当前状态，附带导出时间和电机/IMU数据年龄。
- `host/runs/live_status.json`：保留兼容入口，多窗口时不用于判定唯一当前来源。

只读检查命令：

```powershell
python tools/mecanum/observe_live.py
python tools/mecanum/observe_live.py --seconds 10 --out runs/wireless_observation.json
```

读取器只选取已连接、非演示且未过期的真实反馈；旧窗口、过期快照不会被当作当前状态。
不占用 UDP6205，不发送命令，可与上位机并用。在线协助时可以读取这些文件来分析四轮速度/PWM、位移、航向、到达状态及新增IMU错误。
上位机持续记录不代表聊天智能体在每一刻自动监测或自动发出报警；需要分析某次动作时，在聊天中指出动作即可读取对应记录。

## 以后启动

保持 iPhone USB 网络共享开启，再双击桌面“麦轮无线控制”。该入口连接已保存的车载 WLAN，配置 PC 回执到当前无线地址，再打开上位机。
若切换手机或网卡导致地址改变，重新启动入口即可重新检测。不要同时运行两个运动控制窗口。
