LilywantbecomeNIUBI/fpga-system-integration/docs/evidence/timing_fix_20261030/timing.html

# Timing Messages

Report Title | Timing Analysis Report
Design File | E:\Gowin_project\fpga_project\team_repos\fpga-system-integration\build\system\impl\gwsynthesis\system.vg
Physical Constraints File | E:\Gowin_project\fpga_project\team_repos\fpga-system-integration\build\system\system.cst
Timing Constraint File | E:\Gowin_project\fpga_project\team_repos\fpga-system-integration\build\system\system.sdc
Tool Version | V1.9.12.04 (64-bit)
Part Number | GW5AT-LV138PG484AC1/I0
Device | GW5AT-138
Device Version | B
Created Time | Fri Oct 30 21:28:53 2026
Legal Announcement | Copyright (C)2014-2026 Gowin Semiconductor Corporation. All rights reserved.

# Timing Summaries

## STA Tool Run Summary:

Setup Delay Model | Slow 0.873V 0C C1/I0
Hold Delay Model | Fast 0.927V 85C C1/I0
Numbers of Paths Analyzed | 94705
Numbers of Endpoints Analyzed | 78570
Numbers of Falling Endpoints | 5
Numbers of Setup Violated Endpoints | 0
Numbers of Hold Violated Endpoints | 0

## Clock Summary:

NO. | Clock Name | Type | Period | Frequency(MHz) | Rise | Fall | Source | Master | Objects
1 | sys50 | Base | 20.000 | 50.000 | 0.000 | 10.000 | | | clk50m
2 | cam_pclk | Base | 11.905 | 84.000 | 0.000 | 5.952 | | | camera_pclk
3 | eth_rx125 | Base | 8.000 | 125.000 | 0.000 | 4.000 | | | rgmii_rxc
4 | control50 | Generated | 20.000 | 50.000 | 0.000 | 10.000 | clk50m | sys50 | camera/pll/PLL_inst/CLKOUT0
5 | eth125 | Generated | 8.000 | 125.000 | 0.000 | 4.000 | clk50m | sys50 | camera/pll/PLL_inst/CLKOUT1

## Max Frequency Summary:

NO. | Clock Name | Constraint | Actual Fmax | Logic Level | Entity
1 | sys50 | 50.000(MHz) | 78.596(MHz) | 7 | TOP
2 | cam_pclk | 84.000(MHz) | 84.164(MHz) | 10 | TOP
3 | eth_rx125 | 125.000(MHz) | 153.620(MHz) | 5 | TOP
4 | control50 | 50.000(MHz) | 122.402(MHz) | 11 | TOP
5 | eth125 | 125.000(MHz) | 125.222(MHz) | 4 | TOP

## Total Negative Slack Summary:

Clock Name | Analysis Type | Endpoints TNS | Number of Endpoints
sys50 | Setup | 0.000 | 0
sys50 | Hold | 0.000 | 0
cam_pclk | Setup | 0.000 | 0
cam_pclk | Hold | 0.000 | 0
eth_rx125 | Setup | 0.000 | 0
eth_rx125 | Hold | 0.000 | 0
control50 | Setup | 0.000 | 0
control50 | Hold | 0.000 | 0
eth125 | Setup | 0.000 | 0
eth125 | Hold | 0.000 | 0

# Timing Details

## Path Slacks Table:

### Setup Paths Table

#### Report Command:report_timing -setup -max_paths 25 -max_common_paths 1

Path Number | Path Slack | From Node | To Node | From Clock | To Clock | Relation | Clock Skew | Data Delay
1 | 0.014 | camera/runtime_network.net/lookup2_valid_s0/Q | camera/flow_bridge/event_payload_107_s0/CE | eth125:[R] | eth125:[R] | 8.000 | -0.017 | 7.723
2 | 0.020 | camera/stream/index_0_s4/Q | camera/runtime_network.net/udp/tx_data_0_s0/D | eth125:[R] | eth125:[R] | 8.000 | -0.007 | 7.929
3 | 0.023 | camera/flow_sensor/flow/two_scale.grid/patch/wy_1_s0/Q | camera/flow_sensor/flow/two_scale.grid/patch/read_address_13_s0/D | cam_pclk:[R] | cam_pclk:[R] | 11.905 | -0.117 | 11.941
4 | 0.027 | camera/runtime_network.net/lookup2_valid_s0/Q | camera/flow_bridge/event_payload_91_s0/CE | eth125:[R] | eth125:[R] | 8.000 | -0.024 | 7.716
5 | 0.027 | camera/runtime_network.net/lookup2_valid_s0/Q | camera/flow_bridge/event_payload_92_s0/CE | eth125:[R] | eth125:[R] | 8.000 | -0.024 | 7.716
6 | 0.042 | camera/runtime_network.semantics/last_age_frame_6_s0/Q | camera/runtime_network.semantics/reason_0_s1/CE | eth125:[R] | eth125:[R] | 8.000 | -0.017 | 7.695
7 | 0.042 | camera/runtime_network.semantics/last_age_frame_6_s0/Q | camera/runtime_network.semantics/reason_1_s1/CE | eth125:[R] | eth125:[R] | 8.000 | -0.017 | 7.695
8 | 0.042 | camera/runtime_network.semantics/last_age_frame_6_s0/Q | camera/runtime_network.semantics/reason_2_s1/CE | eth125:[R] | eth125:[R] | 8.000 | -0.017 | 7.695
9 | 0.061 | camera/flow_bridge/age_0_s3/Q | camera/flow_bridge/age_31_s4/D | eth125:[R] | eth125:[R] | 8.000 | 0.000 | 7.882
10 | 0.069 | camera/flow_sensor/flow/two_scale.grid/patch/gy_2_s0/Q | camera/flow_sensor/flow/two_scale.grid/patch/yy_17_s0/D | cam_pclk:[R] | cam_pclk:[R] | 11.905 | 0.074 | 11.705
11 | 0.100 | camera/runtime_network.net/lookup2_valid_s0/Q | camera/flow_bridge/event_payload_27_s0/CE | eth125:[R] | eth125:[R] | 8.000 | 0.004 | 7.615
12 | 0.102 | camera/flow_sensor/flow/two_scale.grid/patch/gy_2_s0/Q | camera/flow_sensor/flow/two_scale.grid/patch/yt_17_s0/D | cam_pclk:[R] | cam_pclk:[R] | 11.905 | 0.088 | 11.657
13 | 0.102 | camera/tracker/semantic_fid_0_s1/Q | camera/tracker/state_1_s1/D | cam_pclk:[R] | cam_pclk:[R] | 11.905 | 0.045 | 11.700
14 | 0.102 | camera/tracker/semantic_fid_0_s1/Q | camera/tracker/state_1_s0/D | cam_pclk:[R] | cam_pclk:[R] | 11.905 | 0.045 | 11.700
15 | 0.109 | camera/runtime_network.net/lookup2_valid_s0/Q | camera/flow_bridge/event_payload_14_s0/CE | eth125:[R] | eth125:[R] | 8.000 | -0.004 | 7.615
16 | 0.109 | camera/runtime_network.net/lookup2_valid_s0/Q | camera/flow_bridge/event_payload_16_s0/CE | eth125:[R] | eth125:[R] | 8.000 | -0.004 | 7.615
17 | 0.109 | camera/runtime_network.net/lookup2_valid_s0/Q | camera/flow_bridge/event_payload_24_s0/CE | eth125:[R] | eth125:[R] | 8.000 | -0.004 | 7.615
18 | 0.109 | camera/runtime_network.net/lookup2_valid_s0/Q | camera/flow_bridge/event_payload_28_s0/CE | eth125:[R] | eth125:[R] | 8.000 | -0.004 | 7.615
19 | 0.109 | camera/runtime_network.net/lookup2_valid_s0/Q | camera/flow_bridge/event_payload_29_s0/CE | eth125:[R] | eth125:[R] | 8.000 | -0.004 | 7.615
20 | 0.109 | camera/runtime_network.net/lookup2_valid_s0/Q | camera/flow_bridge/event_payload_30_s0/CE | eth125:[R] | eth125:[R] | 8.000 | -0.004 | 7.615
21 | 0.127 | camera/runtime_network.net/retry_count2_1_s0/Q | camera/runtime_network.net/retry_count2_12_s0/D | eth125:[R] | eth125:[R] | 8.000 | 0.006 | 7.810
22 | 0.127 | camera/runtime_network.net/retry_count2_1_s0/Q | camera/runtime_network.net/retry_count2_14_s0/D | eth125:[R] | eth125:[R] | 8.000 | 0.006 | 7.810
23 | 0.129 | camera/tracker/job_fid_0_s4/Q | camera/tracker/history_miss_s1/CE | cam_pclk:[R] | cam_pclk:[R] | 11.905 | 0.029 | 11.467
24 | 0.132 | camera/runtime_network.net/retry_count2_1_s0/Q | camera/runtime_network.net/retry_count2_18_s0/D | eth125:[R] | eth125:[R] | 8.000 | 0.011 | 7.800
25 | 0.147 | camera/runtime_network.net/lookup2_valid_s0/Q | camera/flow_bridge/vector_dirty_s1/CE | eth125:[R] | eth125:[R] | 8.000 | -0.030 | 7.603

### Hold Paths Table

#### Report Command:report_timing -hold -max_paths 25 -max_common_paths 1

Path Number | Path Slack | From Node | To Node | From Clock | To Clock | Relation | Clock Skew | Data Delay
1 | 0.206 | camera/flow_sensor/avoidance.safety/norm_0_s/CASO[23] | camera/flow_sensor/avoidance.safety/norm_0_s0/CASI[23] | cam_pclk:[R] | cam_pclk:[R] | 0.000 | -0.004 | 0.120
2 | 0.207 | camera/flow_sensor/avoidance.safety/norm_0_s/CASO[10] | camera/flow_sensor/avoidance.safety/norm_0_s0/CASI[10] | cam_pclk:[R] | cam_pclk:[R] | 0.000 | -0.004 | 0.123
3 | 0.208 | camera/flow_sensor/avoidance.safety/norm_0_s/CASO[25] | camera/flow_sensor/avoidance.safety/norm_0_s0/CASI[25] | cam_pclk:[R] | cam_pclk:[R] | 0.000 | -0.004 | 0.121
4 | 0.209 | camera/flow_sensor/avoidance.safety/norm_0_s/CASO[1] | camera/flow_sensor/avoidance.safety/norm_0_s0/CASI[1] | cam_pclk:[R] | cam_pclk:[R] | 0.000 | -0.004 | 0.125
5 | 0.210 | camera/flow_sensor/avoidance.safety/norm_0_s/CASO[2] | camera/flow_sensor/avoidance.safety/norm_0_s0/CASI[2] | cam_pclk:[R] | cam_pclk:[R] | 0.000 | -0.004 | 0.125
6 | 0.213 | camera/flow_sensor/avoidance.safety/dot_0_s/CASO[23] | camera/flow_sensor/avoidance.safety/dot_0_s0/CASI[23] | cam_pclk:[R] | cam_pclk:[R] | 0.000 | 0.004 | 0.120
7 | 0.214 | camera/flow_sensor/avoidance.safety/dot_0_s/CASO[10] | camera/flow_sensor/avoidance.safety/dot_0_s0/CASI[10] | cam_pclk:[R] | cam_pclk:[R] | 0.000 | 0.004 | 0.123
8 | 0.214 | camera/flow_sensor/avoidance.safety/norm_0_s/CASO[12] | camera/flow_sensor/avoidance.safety/norm_0_s0/CASI[12] | cam_pclk:[R] | cam_pclk:[R] | 0.000 | -0.004 | 0.126
9 | 0.215 | camera/flow_sensor/avoidance.safety/norm_0_s/CASO[27] | camera/flow_sensor/avoidance.safety/norm_0_s0/CASI[27] | cam_pclk:[R] | cam_pclk:[R] | 0.000 | -0.004 | 0.121
10 | 0.215 | camera/flow_sensor/avoidance.safety/dot_0_s/CASO[25] | camera/flow_sensor/avoidance.safety/dot_0_s0/CASI[25] | cam_pclk:[R] | cam_pclk:[R] | 0.000 | 0.004 | 0.121
11 | 0.216 | camera/flow_sensor/avoidance.safety/dot_0_s/CASO[1] | camera/flow_sensor/avoidance.safety/dot_0_s0/CASI[1] | cam_pclk:[R] | cam_pclk:[R] | 0.000 | 0.004 | 0.125
12 | 0.217 | camera/flow_sensor/avoidance.safety/norm_0_s/CASO[22] | camera/flow_sensor/avoidance.safety/norm_0_s0/CASI[22] | cam_pclk:[R] | cam_pclk:[R] | 0.000 | -0.004 | 0.125
13 | 0.217 | camera/flow_sensor/avoidance.safety/dot_0_s/CASO[2] | camera/flow_sensor/avoidance.safety/dot_0_s0/CASI[2] | cam_pclk:[R] | cam_pclk:[R] | 0.000 | 0.004 | 0.125
14 | 0.220 | camera/grid/feature_address_0_s0/Q | camera/tracker/memory_memory_0_4_s/ADA[0] | cam_pclk:[R] | cam_pclk:[R] | 0.000 | -0.009 | 0.262
15 | 0.220 | camera/flow_sensor/avoidance.safety/norm_0_s/CASO[21] | camera/flow_sensor/avoidance.safety/norm_0_s0/CASI[21] | cam_pclk:[R] | cam_pclk:[R] | 0.000 | -0.004 | 0.125
16 | 0.220 | camera/flow_sensor/avoidance.safety/norm_0_s/CASO[11] | camera/flow_sensor/avoidance.safety/norm_0_s0/CASI[11] | cam_pclk:[R] | cam_pclk:[R] | 0.000 | -0.004 | 0.125
17 | 0.221 | camera/flow_sensor/avoidance.safety/norm_0_s/CASO[0] | camera/flow_sensor/avoidance.safety/norm_0_s0/CASI[0] | cam_pclk:[R] | cam_pclk:[R] | 0.000 | -0.004 | 0.130
18 | 0.221 | camera/flow_sensor/avoidance.safety/norm_0_s/CASO[24] | camera/flow_sensor/avoidance.safety/norm_0_s0/CASI[24] | cam_pclk:[R] | cam_pclk:[R] | 0.000 | -0.004 | 0.122
19 | 0.221 | camera/flow_sensor/avoidance.safety/dot_0_s/CASO[12] | camera/flow_sensor/avoidance.safety/dot_0_s0/CASI[12] | cam_pclk:[R] | cam_pclk:[R] | 0.000 | 0.004 | 0.126
20 | 0.222 | camera/flow_sensor/avoidance.safety/dot_0_s/CASO[27] | camera/flow_sensor/avoidance.safety/dot_0_s0/CASI[27] | cam_pclk:[R] | cam_pclk:[R] | 0.000 | 0.004 | 0.121
21 | 0.224 | camera/flow_sensor/avoidance.safety/norm_0_s/CASO[9] | camera/flow_sensor/avoidance.safety/norm_0_s0/CASI[9] | cam_pclk:[R] | cam_pclk:[R] | 0.000 | -0.004 | 0.127
22 | 0.224 | camera/flow_sensor/avoidance.safety/dot_0_s/CASO[22] | camera/flow_sensor/avoidance.safety/dot_0_s0/CASI[22] | cam_pclk:[R] | cam_pclk:[R] | 0.000 | 0.004 | 0.125
23 | 0.226 | camera/flow_sensor/avoidance.safety/norm_0_s/CASO[31] | camera/flow_sensor/avoidance.safety/norm_0_s0/CASI[31] | cam_pclk:[R] | cam_pclk:[R] | 0.000 | -0.004 | 0.120
24 | 0.226 | camera/grid/feature_address_2_s0/Q | camera/tracker/memory_memory_0_4_s/ADA[2] | cam_pclk:[R] | cam_pclk:[R] | 0.000 | -0.009 | 0.268
25 | 0.227 | camera/flow_sensor/avoidance.safety/dot_0_s/CASO[21] | camera/flow_sensor/avoidance.safety/dot_0_s0/CASI[21] | cam_pclk:[R] | cam_pclk:[R] | 0.000 | 0.004 | 0.125

### Recovery Paths Table

#### Report Command:report_timing -recovery -max_paths 25 -max_common_paths 1

Path Number | Path Slack | From Node | To Node | From Clock | To Clock | Relation | Clock Skew | Data Delay
1 | 4.030 | camera/perception_reset/release_pipe_2_s0/Q | camera/event_mux/out_payload_59_s0/CLEAR | eth125:[R] | eth125:[R] | 8.000 | 0.006 | 3.651
2 | 4.030 | camera/perception_reset/release_pipe_2_s0/Q | camera/event_mux/out_payload_65_s0/CLEAR | eth125:[R] | eth125:[R] | 8.000 | 0.006 | 3.651
3 | 4.030 | camera/perception_reset/release_pipe_2_s0/Q | camera/event_mux/out_payload_77_s0/CLEAR | eth125:[R] | eth125:[R] | 8.000 | -0.002 | 3.660
4 | 4.030 | camera/perception_reset/release_pipe_2_s0/Q | camera/bridge/age_4_s3/CLEAR | eth125:[R] | eth125:[R] | 8.000 | -0.002 | 3.660
5 | 4.030 | camera/perception_reset/release_pipe_2_s0/Q | camera/bridge/age_6_s3/CLEAR | eth125:[R] | eth125:[R] | 8.000 | -0.002 | 3.660
6 | 4.030 | camera/perception_reset/release_pipe_2_s0/Q | camera/bridge/age_11_s1/CLEAR | eth125:[R] | eth125:[R] | 8.000 | 0.006 | 3.651
7 | 4.030 | camera/perception_reset/release_pipe_2_s0/Q | camera/bridge/event_payload_16_s0/CLEAR | eth125:[R] | eth125:[R] | 8.000 | 0.006 | 3.651
8 | 4.030 | camera/perception_reset/release_pipe_2_s0/Q | camera/bridge/event_payload_17_s0/CLEAR | eth125:[R] | eth125:[R] | 8.000 | 0.006 | 3.651
9 | 4.030 | camera/perception_reset/release_pipe_2_s0/Q | camera/bridge/event_payload_35_s0/CLEAR | eth125:[R] | eth125:[R] | 8.000 | 0.006 | 3.651
10 | 4.030 | camera/perception_reset/release_pipe_2_s0/Q | camera/bridge/event_payload_37_s0/CLEAR | eth125:[R] | eth125:[R] | 8.000 | 0.006 | 3.651
11 | 4.030 | camera/perception_reset/release_pipe_2_s0/Q | camera/bridge/event_payload_38_s0/CLEAR | eth125:[R] | eth125:[R] | 8.000 | 0.006 | 3.651
12 | 4.030 | camera/perception_reset/release_pipe_2_s0/Q | camera/bridge/event_payload_77_s0/CLEAR | eth125:[R] | eth125:[R] | 8.000 | -0.002 | 3.660
13 | 4.030 | camera/perception_reset/release_pipe_2_s0/Q | camera/bridge/event_payload_78_s0/CLEAR | eth125:[R] | eth125:[R] | 8.000 | -0.002 | 3.660
14 | 4.030 | camera/perception_reset/release_pipe_2_s0/Q | camera/bridge/event_payload_79_s0/CLEAR | eth125:[R] | eth125:[R] | 8.000 | -0.002 | 3.660
15 | 4.030 | camera/perception_reset/release_pipe_2_s0/Q | camera/bridge/event_payload_80_s0/CLEAR | eth125:[R] | eth125:[R] | 8.000 | -0.002 | 3.660
16 | 4.030 | camera/perception_reset/release_pipe_2_s0/Q | camera/bridge/event_payload_203_s0/CLEAR | eth125:[R] | eth125:[R] | 8.000 | -0.002 | 3.660
17 | 4.030 | camera/perception_reset/release_pipe_2_s0/Q | camera/bridge/have_observation_s0/CLEAR | eth125:[R] | eth125:[R] | 8.000 | 0.006 | 3.651
18 | 4.030 | camera/perception_reset/release_pipe_2_s0/Q | camera/bridge/latest_16_s0/CLEAR | eth125:[R] | eth125:[R] | 8.000 | 0.006 | 3.651
19 | 4.030 | camera/perception_reset/release_pipe_2_s0/Q | camera/bridge/latest_17_s0/CLEAR | eth125:[R] | eth125:[R] | 8.000 | 0.006 | 3.651
20 | 4.030 | camera/perception_reset/release_pipe_2_s0/Q | camera/bridge/latest_35_s0/CLEAR | eth125:[R] | eth125:[R] | 8.000 | 0.006 | 3.651
21 | 4.030 | camera/perception_reset/release_pipe_2_s0/Q | camera/bridge/latest_37_s0/CLEAR | eth125:[R] | eth125:[R] | 8.000 | 0.006 | 3.651
22 | 4.030 | camera/perception_reset/release_pipe_2_s0/Q | camera/bridge/latest_38_s0/CLEAR | eth125:[R] | eth125:[R] | 8.000 | 0.006 | 3.651
23 | 4.030 | camera/perception_reset/release_pipe_2_s0/Q | camera/bridge/latest_39_s0/CLEAR | eth125:[R] | eth125:[R] | 8.000 | 0.006 | 3.651
24 | 4.030 | camera/perception_reset/release_pipe_2_s0/Q | camera/bridge/latest_77_s0/CLEAR | eth125:[R] | eth125:[R] | 8.000 | -0.002 | 3.660
25 | 4.030 | camera/perception_reset/release_pipe_2_s0/Q | camera/bridge/latest_78_s0/CLEAR | eth125:[R] | eth125:[R] | 8.000 | -0.002 | 3.660

### Removal Paths Table

#### Report Command:report_timing -removal -max_paths 25 -max_common_paths 1

Path Number | Path Slack | From Node | To Node | From Clock | To Clock | Relation | Clock Skew | Data Delay
1 | 0.619 | camera/runtime_network.receive_reset/release_pipe_2_s1/Q | camera/runtime_network.net/write_mask_62_s0/CLEAR | eth_rx125:[R] | eth_rx125:[R] | 0.000 | 0.020 | 0.552
2 | 0.619 | camera/runtime_network.receive_reset/release_pipe_2_s1/Q | camera/runtime_network.net/write_mask_69_s0/CLEAR | eth_rx125:[R] | eth_rx125:[R] | 0.000 | 0.020 | 0.552
3 | 0.619 | camera/runtime_network.receive_reset/release_pipe_2_s1/Q | camera/runtime_network.net/write_mask_72_s0/CLEAR | eth_rx125:[R] | eth_rx125:[R] | 0.000 | 0.020 | 0.552
4 | 0.625 | camera/runtime_network.receive_reset/release_pipe_2_s1/Q | camera/runtime_network.net/write_mask_7_s0/CLEAR | eth_rx125:[R] | eth_rx125:[R] | 0.000 | 0.017 | 0.561
5 | 0.625 | camera/runtime_network.receive_reset/release_pipe_2_s1/Q | camera/runtime_network.net/write_mask_35_s0/CLEAR | eth_rx125:[R] | eth_rx125:[R] | 0.000 | 0.017 | 0.561
6 | 0.625 | camera/runtime_network.receive_reset/release_pipe_2_s1/Q | camera/runtime_network.net/write_mask_43_s0/CLEAR | eth_rx125:[R] | eth_rx125:[R] | 0.000 | 0.017 | 0.561
7 | 0.635 | camera/runtime_network.receive_reset/release_pipe_2_s1/Q | camera/runtime_network.net/rx_active_s1/CLEAR | eth_rx125:[R] | eth_rx125:[R] | 0.000 | -0.003 | 0.590
8 | 0.635 | camera/runtime_network.receive_reset/release_pipe_2_s1/Q | camera/runtime_network.net/rx_count_4_s2/CLEAR | eth_rx125:[R] | eth_rx125:[R] | 0.000 | -0.003 | 0.590
9 | 0.635 | camera/runtime_network.receive_reset/release_pipe_2_s1/Q | camera/runtime_network.net/rx_count_5_s2/CLEAR | eth_rx125:[R] | eth_rx125:[R] | 0.000 | -0.003 | 0.590
10 | 0.635 | camera/runtime_network.receive_reset/release_pipe_2_s1/Q | camera/runtime_network.net/rx_count_7_s0/CLEAR | eth_rx125:[R] | eth_rx125:[R] | 0.000 | -0.003 | 0.590
11 | 0.643 | camera/runtime_network.receive_reset/release_pipe_2_s1/Q | camera/runtime_network.net/write_byte_0_s1/CLEAR | eth_rx125:[R] | eth_rx125:[R] | 0.000 | 0.002 | 0.594
12 | 0.644 | camera/runtime_network.receive_reset/release_pipe_2_s1/Q | camera/runtime_network.net/write_mask_0_s0/CLEAR | eth_rx125:[R] | eth_rx125:[R] | 0.000 | -0.004 | 0.600
13 | 0.644 | camera/runtime_network.receive_reset/release_pipe_2_s1/Q | camera/runtime_network.net/write_mask_6_s0/CLEAR | eth_rx125:[R] | eth_rx125:[R] | 0.000 | -0.004 | 0.600
14 | 0.644 | camera/runtime_network.receive_reset/release_pipe_2_s1/Q | camera/runtime_network.net/write_mask_15_s0/CLEAR | eth_rx125:[R] | eth_rx125:[R] | 0.000 | -0.004 | 0.600
15 | 0.656 | camera/runtime_network.receive_reset/release_pipe_2_s1/Q | camera/runtime_network.net/ack_sync1_s0/CLEAR | eth_rx125:[R] | eth_rx125:[R] | 0.000 | 0.025 | 0.583
16 | 0.656 | camera/runtime_network.receive_reset/release_pipe_2_s1/Q | camera/runtime_network.net/ack_sync0_s0/CLEAR | eth_rx125:[R] | eth_rx125:[R] | 0.000 | 0.025 | 0.583
17 | 0.669 | camera/runtime_network.receive_reset/release_pipe_2_s1/Q | camera/runtime_network.net/write_byte_2_s2/CLEAR | eth_rx125:[R] | eth_rx125:[R] | 0.000 | -0.002 | 0.624
18 | 0.669 | camera/runtime_network.receive_reset/release_pipe_2_s1/Q | camera/runtime_network.net/write_byte_2_s1/CLEAR | eth_rx125:[R] | eth_rx125:[R] | 0.000 | -0.002 | 0.624
19 | 0.669 | camera/runtime_network.receive_reset/release_pipe_2_s1/Q | camera/runtime_network.net/write_byte_3_s2/CLEAR | eth_rx125:[R] | eth_rx125:[R] | 0.000 | -0.002 | 0.624
20 | 0.669 | camera/runtime_network.receive_reset/release_pipe_2_s1/Q | camera/runtime_network.net/write_byte_3_s1/CLEAR | eth_rx125:[R] | eth_rx125:[R] | 0.000 | -0.002 | 0.624
21 | 0.669 | camera/runtime_network.receive_reset/release_pipe_2_s1/Q | camera/runtime_network.net/write_byte_6_s1/CLEAR | eth_rx125:[R] | eth_rx125:[R] | 0.000 | -0.002 | 0.624
22 | 0.669 | camera/runtime_network.receive_reset/release_pipe_2_s1/Q | camera/runtime_network.net/write_byte_7_s2/CLEAR | eth_rx125:[R] | eth_rx125:[R] | 0.000 | -0.002 | 0.624
23 | 0.669 | camera/runtime_network.receive_reset/release_pipe_2_s1/Q | camera/runtime_network.net/write_byte_7_s1/CLEAR | eth_rx125:[R] | eth_rx125:[R] | 0.000 | -0.002 | 0.624
24 | 0.670 | camera/runtime_network.receive_reset/release_pipe_2_s1/Q | camera/runtime_network.net/write_mask_3_s0/CLEAR | eth_rx125:[R] | eth_rx125:[R] | 0.000 | 0.013 | 0.609
25 | 0.670 | camera/runtime_network.receive_reset/release_pipe_2_s1/Q | camera/runtime_network.net/write_mask_51_s0/CLEAR | eth_rx125:[R] | eth_rx125:[R] | 0.000 | 0.013 | 0.609

## Minimum Pulse Width Table:

Number | Slack | Actual Width | Required Width | Type | Clock | Objects

#### Report Command:report_min_pulse_width -nworst 10 -detail

1 | -0.688 | 0.212 | 0.900 | High Pulse Width | eth125 | camera/stream/ram_ram_0_6_s
2 | -0.688 | 0.212 | 0.900 | High Pulse Width | eth125 | camera/stream/ram_ram_0_12_s
3 | -0.688 | 0.212 | 0.900 | High Pulse Width | eth125 | camera/runtime_network.net/packet_ram_packet_ram_0_0_s
4 | -0.688 | 0.212 | 0.900 | High Pulse Width | eth125 | camera/stream/ram_ram_1_0_s
5 | -0.688 | 0.212 | 0.900 | High Pulse Width | eth125 | camera/stream/ram_ram_1_5_s
6 | -0.688 | 0.212 | 0.900 | High Pulse Width | eth125 | camera/stream/ram_ram_4_6_s
7 | -0.688 | 0.212 | 0.900 | High Pulse Width | eth125 | camera/stream/ram_ram_4_9_s
8 | -0.688 | 0.212 | 0.900 | High Pulse Width | eth125 | camera/stream/ram_ram_4_13_s
9 | -0.688 | 0.212 | 0.900 | High Pulse Width | eth125 | camera/stream/ram_ram_5_15_s
10 | -0.688 | 0.212 | 0.900 | High Pulse Width | eth125 | camera/stream/ram_ram_6_12_s

## Timing Report By Analysis Type:

### Setup Analysis Report

#### Report Command:report_timing -setup -max_paths 25 -max_common_paths 1

### Path1

Path Summary:

Slack | 0.014
Data Arrival Time | 14.845
Data Required Time | 14.859
From | camera/runtime_network.net/lookup2_valid_s0
To | camera/flow_bridge/event_payload_107_s0
Launch Clk | eth125:[R]
Latch Clk | eth125:[R]

Data Arrival Path:

AT | DELAY | TYPE | RF | FANOUT | LOC | NODE
0.000 | 0.000 | | | | | active clock edge time
0.000 | 0.000 | | | | | eth125
3.835 | 3.835 | tCL | RR | 5898 | PLL_B[2] | camera/pll/PLL_inst/CLKOUT1
7.122 | 3.287 | tNET | RR | 1 | R71C93[2][A] | camera/runtime_network.net/lookup2_valid_s0/CLK
7.466 | 0.344 | tC2Q | RR | 4 | R71C93[2][A] | camera/runtime_network.net/lookup2_valid_s0/Q
8.089 | 0.623 | tNET | RR | 1 | R70C90[3][B] | camera/runtime_network.status_211_s1/I2
8.606 | 0.516 | tINS | RR | 12 | R70C90[3][B] | camera/runtime_network.status_211_s1/F
9.823 | 1.217 | tNET | RR | 1 | R50C89[3][A] | camera/event_mux/available_s0/I1
10.339 | 0.516 | tINS | RR | 8 | R50C89[3][A] | camera/event_mux/available_s0/F
11.770 | 1.431 | tNET | RR | 1 | R27C99[3][B] | camera/flow_bridge/event_payload_255_s4/I0
12.287 | 0.516 | tINS | RR | 193 | R27C99[3][B] | camera/flow_bridge/event_payload_255_s4/F
14.845 | 2.558 | tNET | RR | 1 | R23C104[0][A] | camera/flow_bridge/event_payload_107_s0/CE

Data Required Path:

AT | DELAY | TYPE | RF | FANOUT | LOC | NODE
8.000 | 8.000 | | | | | active clock edge time
8.000 | 0.000 | | | | | eth125
11.835 | 3.835 | tCL | RR | 5898 | PLL_B[2] | camera/pll/PLL_inst/CLKOUT1
15.139 | 3.304 | tNET | RR | 1 | R23C104[0][A] | camera/flow_bridge/event_payload_107_s0/CLK
14.859 | -0.280 | tSu | | 1 | R23C104[0][A] | camera/flow_bridge/event_payload_107_s0

Path Statistics:

Clock Skew | 0.017
Setup Relationship | 8.000
Logic Level | 4
Arrival Clock Path Delay | cell: 0.000, 0.000%; route: 3.287, 100.000%
Arrival Data Path Delay | cell: 1.549, 20.058%; route: 5.830, 75.484%; tC2Q: 0.344, 4.457%
Required Clock Path Delay | cell: 0.000, 0.000%; route: 3.304, 100.000%

### Path2

Path Summary:

Slack | 0.020
Data Arrival Time | 15.118
Data Required Time | 15.139
From | camera/stream/index_0_s4
To | camera/runtime_network.net/udp/tx_data_0_s0
Launch Clk | eth125:[R]
Latch Clk | eth125:[R]

Data Arrival Path:

AT | DELAY | TYPE | RF | FANOUT | LOC | NODE
0.000 | 0.000 | | | | | active clock edge time
0.000 | 0.000 | | | | | eth125
3.835 | 3.835 | tCL | RR | 5898 | PLL_B[2] | camera/pll/PLL_inst/CLKOUT1
7.189 | 3.354 | tNET | RR | 1 | R42C67[1][A] | camera/stream/index_0_s4/CLK
7.534 | 0.344 | tC2Q | RR | 18 | R42C67[1][A] | camera/stream/index_0_s4/Q
8.066 | 0.532 | tNET | RR | 1 | R40C69[0][A] | camera/stream/header_0_s35/I2
8.587 | 0.521 | tINS | RR | 1 | R40C69[0][A] | camera/stream/header_0_s35/F
8.587 | 0.000 | tNET | RR | 1 | R40C69[0][A] | camera/stream/header_0_s34/I0
8.722 | 0.135 | tINS | RR | 1 | R40C69[0][A] | camera/stream/header_0_s34/O
9.370 | 0.648 | tNET | RR | 1 | R47C68[3][B] | camera/stream/payload_0_s2/I1
9.886 | 0.516 | tINS | RR | 1 | R47C68[3][B] | camera/stream/payload_0_s2/F
10.076 | 0.190 | tNET | RR | 1 | R49C68[2][B] | camera/stream/payload_0_s0/I3
10.587 | 0.511 | tINS | RR | 1 | R49C68[2][B] | camera/stream/payload_0_s0/F
11.710 | 1.123 | tNET | RR | 1 | R60C76[0][A] | camera/stream/payload_0_s/I0
12.166 | 0.457 | tINS | RR | 2 | R60C76[0][A] | camera/stream/payload_0_s/F
13.483 | 1.316 | tNET | RR | 1 | R75C86[0][A] | camera/runtime_network.net/udp/next_tx_data_0_s4/I0
13.939 | 0.457 | tINS | RR | 1 | R75C86[0][A] | camera/runtime_network.net/udp/next_tx_data_0_s4/F
14.095 | 0.155 | tNET | RR | 1 | R75C87[1][B] | camera/runtime_network.net/udp/next_tx_data_0_s1/I1
14.605 | 0.511 | tINS | RR | 1 | R75C87[1][B] | camera/runtime_network.net/udp/next_tx_data_0_s1/F
14.608 | 0.002 | tNET | RR | 1 | R75C87[0][A] | camera/runtime_network.net/udp/next_tx_data_0_s0/I1
15.118 | 0.511 | tINS | RR | 1 | R75C87[0][A] | camera/runtime_network.net/udp/next_tx_data_0_s0/F
15.118 | 0.000 | tNET | RR | 1 | R75C87[0][A] | camera/runtime_network.net/udp/tx_data_0_s0/D

Data Required Path:

AT | DELAY | TYPE | RF | FANOUT | LOC | NODE
8.000 | 8.000 | | | | | active clock edge time
8.000 | 0.000 | | | | | eth125
11.835 | 3.835 | tCL | RR | 5898 | PLL_B[2] | camera/pll/PLL_inst/CLKOUT1
15.196 | 3.361 | tNET | RR | 1 | R75C87[0][A] | camera/runtime_network.net/udp/tx_data_0_s0/CLK
15.139 | -0.057 | tSu | | 1 | R75C87[0][A] | camera/runtime_network.net/udp/tx_data_0_s0

Path Statistics:

Clock Skew | 0.007
Setup Relationship | 8.000
Logic Level | 8
Arrival Clock Path Delay | cell: 0.000, 0.000%; route: 3.354, 100.000%
Arrival Data Path Delay | cell: 3.618, 45.630%; route: 3.967, 50.028%; tC2Q: 0.344, 4.342%
Required Clock Path Delay | cell: 0.000, 0.000%; route: 3.361, 100.000%

### Path3

Path Summary:

Slack | 0.023
Data Arrival Time | 17.269
Data Required Time | 17.292
From | camera/flow_sensor/flow/two_scale.grid/patch/wy_1_s0
To | camera/flow_sensor/flow/two_scale.grid/patch/read_address_13_s0
Launch Clk | cam_pclk:[R]
Latch Clk | cam_pclk:[R]

Data Arrival Path:

AT | DELAY | TYPE | RF | FANOUT | LOC | NODE
0.000 | 0.000 | | | | | active clock edge time
0.000 | 0.000 | | | | | cam_pclk
0.000 | 0.000 | tCL | RR | 1 | IOL2[A] | camera_pclk_ibuf/I
0.614 | 0.614 | tINS | RR | 8189 | IOL2[A] | camera_pclk_ibuf/O
5.327 | 4.713 | tNET | RR | 1 | R34C23[0][B] | camera/flow_sensor/flow/two_scale.grid/patch/wy_1_s0/CLK
5.672 | 0.344 | tC2Q | RR | 6 | R34C23[0][B] | camera/flow_sensor/flow/two_scale.grid/patch/wy_1_s0/Q
5.836 | 0.164 | tNET | RR | 1 | R35C23[0][B] | camera/flow_sensor/flow/two_scale.grid/patch/n1452_s4/I1
6.357 | 0.521 | tINS | RR | 3 | R35C23[0][B] | camera/flow_sensor/flow/two_scale.grid/patch/n1452_s4/F
6.551 | 0.195 | tNET | RR | 1 | R33C23[0][B] | camera/flow_sensor/flow/two_scale.grid/patch/n1449_s4/I3
7.062 | 0.511 | tINS | RR | 5 | R33C23[0][B] | camera/flow_sensor/flow/two_scale.grid/patch/n1449_s4/F
7.412 | 0.350 | tNET | RR | 1 | R31C22[3][B] | camera/flow_sensor/flow/two_scale.grid/patch/n1446_s4/I3
7.928 | 0.516 | tINS | RR | 5 | R31C22[3][B] | camera/flow_sensor/flow/two_scale.grid/patch/n1446_s4/F
8.125 | 0.197 | tNET | RR | 1 | R33C22[1][B] | camera/flow_sensor/flow/two_scale.grid/patch/n1443_s4/I3
8.646 | 0.521 | tINS | RR | 5 | R33C22[1][B] | camera/flow_sensor/flow/two_scale.grid/patch/n1443_s4/F
9.327 | 0.681 | tNET | RR | 1 | R30C26[0][B] | camera/flow_sensor/flow/two_scale.grid/patch/n1442_s3/I1
9.587 | 0.260 | tINS | RR | 2 | R30C26[0][B] | camera/flow_sensor/flow/two_scale.grid/patch/n1442_s3/F
10.690 | 1.104 | tNET | RR | 84 | DSP_R19[6] | camera/flow_sensor/flow/two_scale.grid/patch/n1522_s/A[13]
12.658 | 1.968 | tINS | RR | 2 | DSP_R19[6] | camera/flow_sensor/flow/two_scale.grid/patch/n1522_s/DOUT[13]
13.273 | 0.614 | tNET | RR | 1 | R22C22[1][B] | camera/flow_sensor/flow/two_scale.grid/patch/n1664_s19/I2
13.532 | 0.260 | tINS | RR | 1 | R22C22[1][B] | camera/flow_sensor/flow/two_scale.grid/patch/n1664_s19/F
13.723 | 0.190 | tNET | RR | 1 | R22C24[3][B] | camera/flow_sensor/flow/two_scale.grid/patch/n1664_s14/I3
14.239 | 0.516 | tINS | RR | 1 | R22C24[3][B] | camera/flow_sensor/flow/two_scale.grid/patch/n1664_s14/F
14.827 | 0.588 | tNET | RR | 1 | R22C29[2][B] | camera/flow_sensor/flow/two_scale.grid/patch/n1664_s10/I3
15.087 | 0.260 | tINS | RR | 1 | R22C29[2][B] | camera/flow_sensor/flow/two_scale.grid/patch/n1664_s10/F
17.269 | 2.181 | tNET | RR | 1 | R18C69[2][B] | camera/flow_sensor/flow/two_scale.grid/patch/read_address_13_s0/D

Data Required Path:

AT | DELAY | TYPE | RF | FANOUT | LOC | NODE
11.905 | 11.905 | | | | | active clock edge time
11.905 | 0.000 | | | | | cam_pclk
11.905 | 0.000 | tCL | RR | 1 | IOL2[A] | camera_pclk_ibuf/I
12.519 | 0.614 | tINS | RR | 8189 | IOL2[A] | camera_pclk_ibuf/O
17.349 | 4.830 | tNET | RR | 1 | R18C69[2][B] | camera/flow_sensor/flow/two_scale.grid/patch/read_address_13_s0/CLK
17.292 | -0.057 | tSu | | 1 | R18C69[2][B] | camera/flow_sensor/flow/two_scale.grid/patch/read_address_13_s0

Path Statistics:

Clock Skew | 0.117
Setup Relationship | 11.905
Logic Level | 10
Arrival Clock Path Delay | cell: 0.614, 11.530%; route: 4.713, 88.470%
Arrival Data Path Delay | cell: 5.333, 44.660%; route: 6.264, 52.458%; tC2Q: 0.344, 2.883%
Required Clock Path Delay | cell: 0.614, 11.282%; route: 4.830, 88.718%

### Path4

Path Summary:

Slack | 0.027
Data Arrival Time | 14.838
Data Required Time | 14.865
From | camera/runtime_network.net/lookup2_valid_s0
To | camera/flow_bridge/event_payload_91_s0
Launch Clk | eth125:[R]
Latch Clk | eth125:[R]

Data Arrival Path:

AT | DELAY | TYPE | RF | FANOUT | LOC | NODE
0.000 | 0.000 | | | | | active clock edge time
0.000 | 0.000 | | | | | eth125
3.835 | 3.835 | tCL | RR | 5898 | PLL_B[2] | camera/pll/PLL_inst/CLKOUT1
7.122 | 3.287 | tNET | RR | 1 | R71C93[2][A] | camera/runtime_network.net/lookup2_valid_s0/CLK
7.466 | 0.344 | tC2Q | RR | 4 | R71C93[2][A] | camera/runtime_network.net/lookup2_valid_s0/Q
8.089 | 0.623 | tNET | RR | 1 | R70C90[3][B] | camera/runtime_network.status_211_s1/I2
8.606 | 0.516 | tINS | RR | 12 | R70C90[3][B] | camera/runtime_network.status_211_s1/F
9.823 | 1.217 | tNET | RR | 1 | R50C89[3][A] | camera/event_mux/available_s0/I1
10.339 | 0.516 | tINS | RR | 8 | R50C89[3][A] | camera/event_mux/available_s0/F
11.770 | 1.431 | tNET | RR | 1 | R27C99[3][B] | camera/flow_bridge/event_payload_255_s4/I0
12.287 | 0.516 | tINS | RR | 193 | R27C99[3][B] | camera/flow_bridge/event_payload_255_s4/F
14.838 | 2.552 | tNET | RR | 1 | R24C103[1][A] | camera/flow_bridge/event_payload_91_s0/CE

Data Required Path:

AT | DELAY | TYPE | RF | FANOUT | LOC | NODE
8.000 | 8.000 | | | | | active clock edge time
8.000 | 0.000 | | | | | eth125
11.835 | 3.835 | tCL | RR | 5898 | PLL_B[2] | camera/pll/PLL_inst/CLKOUT1
15.145 | 3.310 | tNET | RR | 1 | R24C103[1][A] | camera/flow_bridge/event_payload_91_s0/CLK
14.865 | -0.280 | tSu | | 1 | R24C103[1][A] | camera/flow_bridge/event_payload_91_s0

Path Statistics:

Clock Skew | 0.024
Setup Relationship | 8.000
Logic Level | 4
Arrival Clock Path Delay | cell: 0.000, 0.000%; route: 3.287, 100.000%
Arrival Data Path Delay | cell: 1.549, 20.076%; route: 5.823, 75.463%; tC2Q: 0.344, 4.461%
Required Clock Path Delay | cell: 0.000, 0.000%; route: 3.310, 100.000%

### Path5

Path Summary:

Slack | 0.027
Data Arrival Time | 14.838
Data Required Time | 14.865
From | camera/runtime_network.net/lookup2_valid_s0
To | camera/flow_bridge/event_payload_92_s0
Launch Clk | eth125:[R]
Latch Clk | eth125:[R]

Data Arrival Path:

AT | DELAY | TYPE | RF | FANOUT | LOC | NODE
0.000 | 0.000 | | | | | active clock edge time
0.000 | 0.000 | | | | | eth125
3.835 | 3.835 | tCL | RR | 5898 | PLL_B[2] | camera/pll/PLL_inst/CLKOUT1
7.122 | 3.287 | tNET | RR | 1 | R71C93[2][A] | camera/runtime_network.net/lookup2_valid_s0/CLK
7.466 | 0.344 | tC2Q | RR | 4 | R71C93[2][A] | camera/runtime_network.net/lookup2_valid_s0/Q
8.089 | 0.623 | tNET | RR | 1 | R70C90[3][B] | camera/runtime_network.status_211_s1/I2
8.606 | 0.516 | tINS | RR | 12 | R70C90[3][B] | camera/runtime_network.status_211_s1/F
9.823 | 1.217 | tNET | RR | 1 | R50C89[3][A] | camera/event_mux/available_s0/I1
10.339 | 0.516 | tINS | RR | 8 | R50C89[3][A] | camera/event_mux/available_s0/F
11.770 | 1.431 | tNET | RR | 1 | R27C99[3][B] | camera/flow_bridge/event_payload_255_s4/I0
12.287 | 0.516 | tINS | RR | 193 | R27C99[3][B] | camera/flow_bridge/event_payload_255_s4/F
14.838 | 2.552 | tNET | RR | 1 | R24C103[1][B] | camera/flow_bridge/event_payload_92_s0/CE

Data Required Path:

AT | DELAY | TYPE | RF | FANOUT | LOC | NODE
8.000 | 8.000 | | | | | active clock edge time
8.000 | 0.000 | | | | | eth125
11.835 | 3.835 | tCL | RR | 5898 | PLL_B[2] | camera/pll/PLL_inst/CLKOUT1
15.145 | 3.310 | tNET | RR | 1 | R24C103[1][B] | camera/flow_bridge/event_payload_92_s0/CLK
14.865 | -0.280 | tSu | | 1 | R24C103[1][B] | camera/flow_bridge/event_payload_92_s0

Path Statistics:

Clock Skew | 0.024
Setup Relationship | 8.000
Logic Level | 4
Arrival Clock Path Delay | cell: 0.000, 0.000%; route: 3.287, 100.000%
Arrival Data Path Delay | cell: 1.549, 20.076%; route: 5.823, 75.463%; tC2Q: 0.344, 4.461%
Required Clock Path Delay | cell: 0.000, 0.000%; route: 3.310, 100.000%

### Path6

Path Summary:

Slack | 0.042
Data Arrival Time | 14.808
Data Required Time | 14.850
From | camera/runtime_network.semantics/last_age_frame_6_s0
To | camera/runtime_network.semantics/reason_0_s1
Launch Clk | eth125:[R]
Latch Clk | eth125:[R]

Data Arrival Path:

AT | DELAY | TYPE | RF | FANOUT | LOC | NODE
0.000 | 0.000 | | | | | active clock edge time
0.000 | 0.000 | | | | | eth125
3.835 | 3.835 | tCL | RR | 5898 | PLL_B[2] | camera/pll/PLL_inst/CLKOUT1
7.113 | 3.278 | tNET | RR | 1 | R35C116[3][A] | camera/runtime_network.semantics/last_age_frame_6_s0/CLK
7.458 | 0.344 | tC2Q | RR | 1 | R35C116[3][A] | camera/runtime_network.semantics/last_age_frame_6_s0/Q
8.339 | 0.881 | tNET | RR | 2 | R36C116[0][A] | camera/runtime_network.semantics/n1187_s0/I0
8.874 | 0.535 | tINS | RF | 1 | R36C116[0][A] | camera/runtime_network.semantics/n1187_s0/COUT
8.874 | 0.000 | tNET | FF | 2 | R36C116[0][B] | camera/runtime_network.semantics/n1188_s0/CIN
8.919 | 0.045 | tINS | FR | 1 | R36C116[0][B] | camera/runtime_network.semantics/n1188_s0/COUT
8.919 | 0.000 | tNET | RR | 2 | R36C116[1][A] | camera/runtime_network.semantics/n1189_s0/CIN
8.964 | 0.045 | tINS | RR | 1 | R36C116[1][A] | camera/runtime_network.semantics/n1189_s0/COUT
8.964 | 0.000 | tNET | RR | 2 | R36C116[1][B] | camera/runtime_network.semantics/n1190_s0/CIN
9.009 | 0.045 | tINS | RR | 1 | R36C116[1][B] | camera/runtime_network.semantics/n1190_s0/COUT
9.009 | 0.000 | tNET | RR | 2 | R36C116[2][A] | camera/runtime_network.semantics/n1191_s0/CIN
9.054 | 0.045 | tINS | RR | 1 | R36C116[2][A] | camera/runtime_network.semantics/n1191_s0/COUT
9.054 | 0.000 | tNET | RR | 2 | R36C116[2][B] | camera/runtime_network.semantics/n1192_s0/CIN
9.099 | 0.045 | tINS | RR | 1 | R36C116[2][B] | camera/runtime_network.semantics/n1192_s0/COUT
9.099 | 0.000 | tNET | RR | 2 | R36C117[0][A] | camera/runtime_network.semantics/n1193_s0/CIN
9.144 | 0.045 | tINS | RR | 1 | R36C117[0][A] | camera/runtime_network.semantics/n1193_s0/COUT
9.144 | 0.000 | tNET | RR | 2 | R36C117[0][B] | camera/runtime_network.semantics/n1194_s0/CIN
9.189 | 0.045 | tINS | RR | 1 | R36C117[0][B] | camera/runtime_network.semantics/n1194_s0/COUT
9.189 | 0.000 | tNET | RR | 2 | R36C117[1][A] | camera/runtime_network.semantics/n1195_s0/CIN
9.234 | 0.045 | tINS | RR | 1 | R36C117[1][A] | camera/runtime_network.semantics/n1195_s0/COUT
9.234 | 0.000 | tNET | RR | 2 | R36C117[1][B] | camera/runtime_network.semantics/n1196_s0/CIN
9.279 | 0.045 | tINS | RF | 1 | R36C117[1][B] | camera/runtime_network.semantics/n1196_s0/COUT
10.264 | 0.985 | tNET | FF | 1 | R36C101[1][A] | camera/runtime_network.semantics/n3275_s4/I1
10.524 | 0.260 | tINS | FR | 2 | R36C101[1][A] | camera/runtime_network.semantics/n3275_s4/F
11.735 | 1.211 | tNET | RR | 1 | R54C95[0][A] | camera/runtime_network.semantics/sequence_seen_s6/I0
12.246 | 0.511 | tINS | RR | 2 | R54C95[0][A] | camera/runtime_network.semantics/sequence_seen_s6/F
13.521 | 1.276 | tNET | RR | 1 | R35C94[1][B] | camera/runtime_network.semantics/target_direction_1_s4/I3
13.781 | 0.260 | tINS | RR | 2 | R35C94[1][B] | camera/runtime_network.semantics/target_direction_1_s4/F
14.161 | 0.380 | tNET | RR | 1 | R35C98[0][A] | camera/runtime_network.semantics/reason_0_s3/I3
14.672 | 0.511 | tINS | RR | 3 | R35C98[0][A] | camera/runtime_network.semantics/reason_0_s3/F
14.808 | 0.136 | tNET | RR | 1 | R35C98[2][B] | camera/runtime_network.semantics/reason_0_s1/CE

Data Required Path:

AT | DELAY | TYPE | RF | FANOUT | LOC | NODE
8.000 | 8.000 | | | | | active clock edge time
8.000 | 0.000 | | | | | eth125
11.835 | 3.835 | tCL | RR | 5898 | PLL_B[2] | camera/pll/PLL_inst/CLKOUT1
15.130 | 3.295 | tNET | RR | 1 | R35C98[2][B] | camera/runtime_network.semantics/reason_0_s1/CLK
14.850 | -0.280 | tSu | | 1 | R35C98[2][B] | camera/runtime_network.semantics/reason_0_s1

Path Statistics:

Clock Skew | 0.017
Setup Relationship | 8.000
Logic Level | 8
Arrival Clock Path Delay | cell: 0.000, 0.000%; route: 3.278, 100.000%
Arrival Data Path Delay | cell: 2.482, 32.251%; route: 4.869, 63.275%; tC2Q: 0.344, 4.474%
Required Clock Path Delay | cell: 0.000, 0.000%; route: 3.295, 100.000%

### Path7

Path Summary:

Slack | 0.042
Data Arrival Time | 14.808
Data Required Time | 14.850
From | camera/runtime_network.semantics/last_age_frame_6_s0
To | camera/runtime_network.semantics/reason_1_s1
Launch Clk | eth125:[R]
Latch Clk | eth125:[R]

Data Arrival Path:

AT | DELAY | TYPE | RF | FANOUT | LOC | NODE
0.000 | 0.000 | | | | | active clock edge time
0.000 | 0.000 | | | | | eth125
3.835 | 3.835 | tCL | RR | 5898 | PLL_B[2] | camera/pll/PLL_inst/CLKOUT1
7.113 | 3.278 | tNET | RR | 1 | R35C116[3][A] | camera/runtime_network.semantics/last_age_frame_6_s0/CLK
7.458 | 0.344 | tC2Q | RR | 1 | R35C116[3][A] | camera/runtime_network.semantics/last_age_frame_6_s0/Q
8.339 | 0.881 | tNET | RR | 2 | R36C116[0][A] | camera/runtime_network.semantics/n1187_s0/I0
8.874 | 0.535 | tINS | RF | 1 | R36C116[0][A] | camera/runtime_network.semantics/n1187_s0/COUT
8.874 | 0.000 | tNET | FF | 2 | R36C116[0][B] | camera/runtime_network.semantics/n1188_s0/CIN
8.919 | 0.045 | tINS | FR | 1 | R36C116[0][B] | camera/runtime_network.semantics/n1188_s0/COUT
8.919 | 0.000 | tNET | RR | 2 | R36C116[1][A] | camera/runtime_network.semantics/n1189_s0/CIN
8.964 | 0.045 | tINS | RR | 1 | R36C116[1][A] | camera/runtime_network.semantics/n1189_s0/COUT
8.964 | 0.000 | tNET | RR | 2 | R36C116[1][B] | camera/runtime_network.semantics/n1190_s0/CIN
9.009 | 0.045 | tINS | RR | 1 | R36C116[1][B] | camera/runtime_network.semantics/n1190_s0/COUT
9.009 | 0.000 | tNET | RR | 2 | R36C116[2][A] | camera/runtime_network.semantics/n1191_s0/CIN
9.054 | 0.045 | tINS | RR | 1 | R36C116[2][A] | camera/runtime_network.semantics/n1191_s0/COUT
9.054 | 0.000 | tNET | RR | 2 | R36C116[2][B] | camera/runtime_network.semantics/n1192_s0/CIN
9.099 | 0.045 | tINS | RR | 1 | R36C116[2][B] | camera/runtime_network.semantics/n1192_s0/COUT
9.099 | 0.000 | tNET | RR | 2 | R36C117[0][A] | camera/runtime_network.semantics/n1193_s0/CIN
9.144 | 0.045 | tINS | RR | 1 | R36C117[0][A] | camera/runtime_network.semantics/n1193_s0/COUT
9.144 | 0.000 | tNET | RR | 2 | R36C117[0][B] | camera/runtime_network.semantics/n1194_s0/CIN
9.189 | 0.045 | tINS | RR | 1 | R36C117[0][B] | camera/runtime_network.semantics/n1194_s0/COUT
9.189 | 0.000 | tNET | RR | 2 | R36C117[1][A] | camera/runtime_network.semantics/n1195_s0/CIN
9.234 | 0.045 | tINS | RR | 1 | R36C117[1][A] | camera/runtime_network.semantics/n1195_s0/COUT
9.234 | 0.000 | tNET | RR | 2 | R36C117[1][B] | camera/runtime_network.semantics/n1196_s0/CIN
9.279 | 0.045 | tINS | RF | 1 | R36C117[1][B] | camera/runtime_network.semantics/n1196_s0/COUT
10.264 | 0.985 | tNET | FF | 1 | R36C101[1][A] | camera/runtime_network.semantics/n3275_s4/I1
10.524 | 0.260 | tINS | FR | 2 | R36C101[1][A] | camera/runtime_network.semantics/n3275_s4/F
11.735 | 1.211 | tNET | RR | 1 | R54C95[0][A] | camera/runtime_network.semantics/sequence_seen_s6/I0
12.246 | 0.511 | tINS | RR | 2 | R54C95[0][A] | camera/runtime_network.semantics/sequence_seen_s6/F
13.521 | 1.276 | tNET | RR | 1 | R35C94[1][B] | camera/runtime_network.semantics/target_direction_1_s4/I3
13.781 | 0.260 | tINS | RR | 2 | R35C94[1][B] | camera/runtime_network.semantics/target_direction_1_s4/F
14.161 | 0.380 | tNET | RR | 1 | R35C98[0][A] | camera/runtime_network.semantics/reason_0_s3/I3
14.672 | 0.511 | tINS | RR | 3 | R35C98[0][A] | camera/runtime_network.semantics/reason_0_s3/F
14.808 | 0.136 | tNET | RR | 1 | R35C98[2][A] | camera/runtime_network.semantics/reason_1_s1/CE

Data Required Path:

AT | DELAY | TYPE | RF | FANOUT | LOC | NODE
8.000 | 8.000 | | | | | active clock edge time
8.000 | 0.000 | | | | | eth125
11.835 | 3.835 | tCL | RR | 5898 | PLL_B[2] | camera/pll/PLL_inst/CLKOUT1
15.130 | 3.295 | tNET | RR | 1 | R35C98[2][A] | camera/runtime_network.semantics/reason_1_s1/CLK
14.850 | -0.280 | tSu | | 1 | R35C98[2][A] | camera/runtime_network.semantics/reason_1_s1

Path Statistics:

Clock Skew | 0.017
Setup Relationship | 8.000
Logic Level | 8
Arrival Clock Path Delay | cell: 0.000, 0.000%; route: 3.278, 100.000%
Arrival Data Path Delay | cell: 2.482, 32.251%; route: 4.869, 63.275%; tC2Q: 0.344, 4.474%
Required Clock Path Delay | cell: 0.000, 0.000%; route: 3.295, 100.000%

### Path8

Path Summary:

Slack | 0.042
Data Arrival Time | 14.808
Data Required Time | 14.850
From | camera/runtime_network.semantics/last_age_frame_6_s0
To | camera/runtime_network.semantics/reason_2_s1
Launch Clk | eth125:[R]
Latch Clk | eth125:[R]

Data Arrival Path:

AT | DELAY | TYPE | RF | FANOUT | LOC | NODE
0.000 | 0.000 | | | | | active clock edge time
0.000 | 0.000 | | | | | eth125
3.835 | 3.835 | tCL | RR | 5898 | PLL_B[2] | camera/pll/PLL_inst/CLKOUT1
7.113 | 3.278 | tNET | RR | 1 | R35C116[3][A] | camera/runtime_network.semantics/last_age_frame_6_s0/CLK
7.458 | 0.344 | tC2Q | RR | 1 | R35C116[3][A] | camera/runtime_network.semantics/last_age_frame_6_s0/Q
8.339 | 0.881 | tNET | RR | 2 | R36C116[0][A] | camera/runtime_network.semantics/n1187_s0/I0
8.874 | 0.535 | tINS | RF | 1 | R36C116[0][A] | camera/runtime_network.semantics/n1187_s0/COUT
8.874 | 0.000 | tNET | FF | 2 | R36C116[0][B] | camera/runtime_network.semantics/n1188_s0/CIN
8.919 | 0.045 | tINS | FR | 1 | R36C116[0][B] | camera/runtime_network.semantics/n1188_s0/COUT
8.919 | 0.000 | tNET | RR | 2 | R36C116[1][A] | camera/runtime_network.semantics/n1189_s0/CIN
8.964 | 0.045 | tINS | RR | 1 | R36C116[1][A] | camera/runtime_network.semantics/n1189_s0/COUT
8.964 | 0.000 | tNET | RR | 2 | R36C116[1][B] | camera/runtime_network.semantics/n1190_s0/CIN
9.009 | 0.045 | tINS | RR | 1 | R36C116[1][B] | camera/runtime_network.semantics/n1190_s0/COUT
9.009 | 0.000 | tNET | RR | 2 | R36C116[2][A] | camera/runtime_network.semantics/n1191_s0/CIN
9.054 | 0.045 | tINS | RR | 1 | R36C116[2][A] | camera/runtime_network.semantics/n1191_s0/COUT
9.054 | 0.000 | tNET | RR | 2 | R36C116[2][B] | camera/runtime_network.semantics/n1192_s0/CIN
9.099 | 0.045 | tINS | RR | 1 | R36C116[2][B] | camera/runtime_network.semantics/n1192_s0/COUT
9.099 | 0.000 | tNET | RR | 2 | R36C117[0][A] | camera/runtime_network.semantics/n1193_s0/CIN
9.144 | 0.045 | tINS | RR | 1 | R36C117[0][A] | camera/runtime_network.semantics/n1193_s0/COUT
9.144 | 0.000 | tNET | RR | 2 | R36C117[0][B] | camera/runtime_network.semantics/n1194_s0/CIN
9.189 | 0.045 | tINS | RR | 1 | R36C117[0][B] | camera/runtime_network.semantics/n1194_s0/COUT
9.189 | 0.000 | tNET | RR | 2 | R36C117[1][A] | camera/runtime_network.semantics/n1195_s0/CIN
9.234 | 0.045 | tINS | RR | 1 | R36C117[1][A] | camera/runtime_network.semantics/n1195_s0/COUT
9.234 | 0.000 | tNET | RR | 2 | R36C117[1][B] | camera/runtime_network.semantics/n1196_s0/CIN
9.279 | 0.045 | tINS | RF | 1 | R36C117[1][B] | camera/runtime_network.semantics/n1196_s0/COUT
10.264 | 0.985 | tNET | FF | 1 | R36C101[1][A] | camera/runtime_network.semantics/n3275_s4/I1
10.524 | 0.260 | tINS | FR | 2 | R36C101[1][A] | camera/runtime_network.semantics/n3275_s4/F
11.735 | 1.211 | tNET | RR | 1 | R54C95[0][A] | camera/runtime_network.semantics/sequence_seen_s6/I0
12.246 | 0.511 | tINS | RR | 2 | R54C95[0][A] | camera/runtime_network.semantics/sequence_seen_s6/F
13.521 | 1.276 | tNET | RR | 1 | R35C94[1][B] | camera/runtime_network.semantics/target_direction_1_s4/I3
13.781 | 0.260 | tINS | RR | 2 | R35C94[1][B] | camera/runtime_network.semantics/target_direction_1_s4/F
14.161 | 0.380 | tNET | RR | 1 | R35C98[0][A] | camera/runtime_network.semantics/reason_0_s3/I3
14.672 | 0.511 | tINS | RR | 3 | R35C98[0][A] | camera/runtime_network.semantics/reason_0_s3/F
14.808 | 0.136 | tNET | RR | 1 | R35C98[3][A] | camera/runtime_network.semantics/reason_2_s1/CE

Data Required Path:

AT | DELAY | TYPE | RF | FANOUT | LOC | NODE
8.000 | 8.000 | | | | | active clock edge time
8.000 | 0.000 | | | | | eth125
11.835 | 3.835 | tCL | RR | 5898 | PLL_B[2] | camera/pll/PLL_inst/CLKOUT1
15.130 | 3.295 | tNET | RR | 1 | R35C98[3][A] | camera/runtime_network.semantics/reason_2_s1/CLK
14.850 | -0.280 | tSu | | 1 | R35C98[3][A] | camera/runtime_network.semantics/reason_2_s1

Path Statistics:

Clock Skew | 0.017
Setup Relationship | 8.000
Logic Level | 8
Arrival Clock Path Delay | cell: 0.000, 0.000%; route: 3.278, 100.000%
Arrival Data Path Delay | cell: 2.482, 32.251%; route: 4.869, 63.275%; tC2Q: 0.344, 4.474%
Required Clock Path Delay | cell: 0.000, 0.000%; route: 3.295, 100.000%

### Path9

Path Summary:

Slack | 0.061
Data Arrival Time | 15.004
Data Required Time | 15.064
From | camera/flow_bridge/age_0_s3
To | camera/flow_bridge/age_31_s4
Launch Clk | eth125:[R]
Latch Clk | eth125:[R]

Data Arrival Path:

AT | DELAY | TYPE | RF | FANOUT | LOC | NODE
0.000 | 0.000 | | | | | active clock edge time
0.000 | 0.000 | | | | | eth125
3.835 | 3.835 | tCL | RR | 5898 | PLL_B[2] | camera/pll/PLL_inst/CLKOUT1
7.122 | 3.287 | tNET | RR | 1 | R27C92[0][B] | camera/flow_bridge/age_0_s3/CLK
7.466 | 0.344 | tC2Q | RR | 4 | R27C92[0][B] | camera/flow_bridge/age_0_s3/Q
7.747 | 0.281 | tNET | RR | 1 | R27C90[0][A] | camera/flow_bridge/n654_s3/I2
8.258 | 0.511 | tINS | RR | 4 | R27C90[0][A] | camera/flow_bridge/n654_s3/F
8.534 | 0.276 | tNET | RR | 1 | R29C90[0][A] | camera/flow_bridge/n651_s3/I3
8.794 | 0.260 | tINS | RR | 4 | R29C90[0][A] | camera/flow_bridge/n651_s3/F
9.073 | 0.279 | tNET | RR | 1 | R29C92[0][A] | camera/flow_bridge/n648_s3/I3
9.332 | 0.260 | tINS | RR | 6 | R29C92[0][A] | camera/flow_bridge/n648_s3/F
10.072 | 0.739 | tNET | RR | 1 | R27C89[1][A] | camera/flow_bridge/n643_s4/I2
10.331 | 0.260 | tINS | RR | 5 | R27C89[1][A] | camera/flow_bridge/n643_s4/F
10.684 | 0.352 | tNET | RR | 1 | R26C90[3][B] | camera/flow_bridge/n634_s3/I3
10.946 | 0.262 | tINS | RR | 4 | R26C90[3][B] | camera/flow_bridge/n634_s3/F
11.674 | 0.728 | tNET | RR | 1 | R26C101[1][B] | camera/flow_bridge/n631_s3/I3
12.184 | 0.511 | tINS | RR | 4 | R26C101[1][B] | camera/flow_bridge/n631_s3/F
12.327 | 0.143 | tNET | RR | 1 | R26C101[3][B] | camera/flow_bridge/n629_s4/I2
12.589 | 0.262 | tINS | RR | 2 | R26C101[3][B] | camera/flow_bridge/n629_s4/F
13.279 | 0.690 | tNET | RR | 1 | R26C96[1][B] | camera/flow_bridge/n626_s3/I3
13.539 | 0.260 | tINS | RR | 1 | R26C96[1][B] | camera/flow_bridge/n626_s3/F
13.917 | 0.378 | tNET | RR | 1 | R26C92[3][B] | camera/flow_bridge/n626_s6/I2
14.327 | 0.411 | tINS | RR | 1 | R26C92[3][B] | camera/flow_bridge/n626_s6/F
14.483 | 0.155 | tNET | RR | 1 | R27C92[2][B] | camera/flow_bridge/n626_s7/I0
15.004 | 0.521 | tINS | RR | 1 | R27C92[2][B] | camera/flow_bridge/n626_s7/F
15.004 | 0.000 | tNET | RR | 1 | R27C92[2][B] | camera/flow_bridge/age_31_s4/D

Data Required Path:

AT | DELAY | TYPE | RF | FANOUT | LOC | NODE
8.000 | 8.000 | | | | | active clock edge time
8.000 | 0.000 | | | | | eth125
11.835 | 3.835 | tCL | RR | 5898 | PLL_B[2] | camera/pll/PLL_inst/CLKOUT1
15.122 | 3.287 | tNET | RR | 1 | R27C92[2][B] | camera/flow_bridge/age_31_s4/CLK
15.064 | -0.057 | tSu | | 1 | R27C92[2][B] | camera/flow_bridge/age_31_s4

Path Statistics:

Clock Skew | 0.000
Setup Relationship | 8.000
Logic Level | 11
Arrival Clock Path Delay | cell: 0.000, 0.000%; route: 3.287, 100.000%
Arrival Data Path Delay | cell: 3.517, 44.619%; route: 4.021, 51.013%; tC2Q: 0.344, 4.368%
Required Clock Path Delay | cell: 0.000, 0.000%; route: 3.287, 100.000%

### Path10

Path Summary:

Slack | 0.069
Data Arrival Time | 17.116
Data Required Time | 17.185
From | camera/flow_sensor/flow/two_scale.grid/patch/gy_2_s0
To | camera/flow_sensor/flow/two_scale.grid/patch/yy_17_s0
Launch Clk | cam_pclk:[R]
Latch Clk | cam_pclk:[R]

Data Arrival Path:

AT | DELAY | TYPE | RF | FANOUT | LOC | NODE
0.000 | 0.000 | | | | | active clock edge time
0.000 | 0.000 | | | | | cam_pclk
0.000 | 0.000 | tCL | RR | 1 | IOL2[A] | camera_pclk_ibuf/I
0.614 | 0.614 | tINS | RR | 8189 | IOL2[A] | camera_pclk_ibuf/O
5.412 | 4.798 | tNET | RR | 1 | R31C47[1][B] | camera/flow_sensor/flow/two_scale.grid/patch/gy_2_s0/CLK
5.756 | 0.344 | tC2Q | RR | 29 | R31C47[1][B] | camera/flow_sensor/flow/two_scale.grid/patch/gy_2_s0/Q
9.625 | 3.869 | tNET | RR | 1 | R22C36[1][B] | camera/flow_sensor/flow/two_scale.grid/patch/n2012_s86/I1
10.136 | 0.511 | tINS | RR | 2 | R22C36[1][B] | camera/flow_sensor/flow/two_scale.grid/patch/n2012_s86/F
10.362 | 0.226 | tNET | RR | 2 | R22C37[0][A] | camera/flow_sensor/flow/two_scale.grid/patch/n2012_ATree_1_0_DOUT_1_s/I0
10.902 | 0.540 | tINS | RF | 1 | R22C37[0][A] | camera/flow_sensor/flow/two_scale.grid/patch/n2012_ATree_1_0_DOUT_1_s/COUT
10.902 | 0.000 | tNET | FF | 2 | R22C37[0][B] | camera/flow_sensor/flow/two_scale.grid/patch/n2012_ATree_1_0_DOUT_2_s/CIN
10.947 | 0.045 | tINS | FR | 1 | R22C37[0][B] | camera/flow_sensor/flow/two_scale.grid/patch/n2012_ATree_1_0_DOUT_2_s/COUT
10.947 | 0.000 | tNET | RR | 2 | R22C37[1][A] | camera/flow_sensor/flow/two_scale.grid/patch/n2012_ATree_1_0_DOUT_3_s/CIN
10.992 | 0.045 | tINS | RR | 1 | R22C37[1][A] | camera/flow_sensor/flow/two_scale.grid/patch/n2012_ATree_1_0_DOUT_3_s/COUT
10.992 | 0.000 | tNET | RR | 2 | R22C37[1][B] | camera/flow_sensor/flow/two_scale.grid/patch/n2012_ATree_1_0_DOUT_4_s/CIN
11.037 | 0.045 | tINS | RR | 1 | R22C37[1][B] | camera/flow_sensor/flow/two_scale.grid/patch/n2012_ATree_1_0_DOUT_4_s/COUT
11.037 | 0.000 | tNET | RR | 2 | R22C37[2][A] | camera/flow_sensor/flow/two_scale.grid/patch/n2012_ATree_1_0_DOUT_5_s/CIN
11.082 | 0.045 | tINS | RR | 1 | R22C37[2][A] | camera/flow_sensor/flow/two_scale.grid/patch/n2012_ATree_1_0_DOUT_5_s/COUT
11.082 | 0.000 | tNET | RR | 2 | R22C37[2][B] | camera/flow_sensor/flow/two_scale.grid/patch/n2012_ATree_1_0_DOUT_6_s/CIN
11.348 | 0.267 | tINS | RR | 1 | R22C37[2][B] | camera/flow_sensor/flow/two_scale.grid/patch/n2012_ATree_1_0_DOUT_6_s/SUM
12.102 | 0.754 | tNET | RR | 2 | R23C34[2][B] | camera/flow_sensor/flow/two_scale.grid/patch/n2012_ATree_2_0_DOUT_5_s/I0
12.642 | 0.540 | tINS | RF | 1 | R23C34[2][B] | camera/flow_sensor/flow/two_scale.grid/patch/n2012_ATree_2_0_DOUT_5_s/COUT
12.642 | 0.000 | tNET | FF | 2 | R23C35[0][A] | camera/flow_sensor/flow/two_scale.grid/patch/n2012_ATree_2_0_DOUT_6_s/CIN
12.687 | 0.045 | tINS | FR | 1 | R23C35[0][A] | camera/flow_sensor/flow/two_scale.grid/patch/n2012_ATree_2_0_DOUT_6_s/COUT
12.687 | 0.000 | tNET | RR | 2 | R23C35[0][B] | camera/flow_sensor/flow/two_scale.grid/patch/n2012_ATree_2_0_DOUT_7_s/CIN
12.732 | 0.045 | tINS | RR | 1 | R23C35[0][B] | camera/flow_sensor/flow/two_scale.grid/patch/n2012_ATree_2_0_DOUT_7_s/COUT
12.732 | 0.000 | tNET | RR | 2 | R23C35[1][A] | camera/flow_sensor/flow/two_scale.grid/patch/n2012_ATree_2_0_DOUT_8_s/CIN
12.777 | 0.045 | tINS | RR | 1 | R23C35[1][A] | camera/flow_sensor/flow/two_scale.grid/patch/n2012_ATree_2_0_DOUT_8_s/COUT
12.777 | 0.000 | tNET | RR | 2 | R23C35[1][B] | camera/flow_sensor/flow/two_scale.grid/patch/n2012_ATree_2_0_DOUT_9_s/CIN
12.822 | 0.045 | tINS | RR | 1 | R23C35[1][B] | camera/flow_sensor/flow/two_scale.grid/patch/n2012_ATree_2_0_DOUT_9_s/COUT
12.822 | 0.000 | tNET | RR | 2 | R23C35[2][A] | camera/flow_sensor/flow/two_scale.grid/patch/n2012_ATree_2_0_DOUT_10_s/CIN
13.042 | 0.219 | tINS | RR | 1 | R23C35[2][A] | camera/flow_sensor/flow/two_scale.grid/patch/n2012_ATree_2_0_DOUT_10_s/SUM
13.922 | 0.881 | tNET | RR | 2 | R23C32[1][A] | camera/flow_sensor/flow/two_scale.grid/patch/n2012_ATree_3_0_DOUT_8_s/I0
14.462 | 0.540 | tINS | RF | 1 | R23C32[1][A] | camera/flow_sensor/flow/two_scale.grid/patch/n2012_ATree_3_0_DOUT_8_s/COUT
14.462 | 0.000 | tNET | FF | 2 | R23C32[1][B] | camera/flow_sensor/flow/two_scale.grid/patch/n2012_ATree_3_0_DOUT_9_s/CIN
14.507 | 0.045 | tINS | FR | 1 | R23C32[1][B] | camera/flow_sensor/flow/two_scale.grid/patch/n2012_ATree_3_0_DOUT_9_s/COUT
14.507 | 0.000 | tNET | RR | 2 | R23C32[2][A] | camera/flow_sensor/flow/two_scale.grid/patch/n2012_ATree_3_0_DOUT_10_s/CIN
14.552 | 0.045 | tINS | RR | 1 | R23C32[2][A] | camera/flow_sensor/flow/two_scale.grid/patch/n2012_ATree_3_0_DOUT_10_s/COUT
14.552 | 0.000 | tNET | RR | 2 | R23C32[2][B] | camera/flow_sensor/flow/two_scale.grid/patch/n2012_ATree_3_0_DOUT_11_s/CIN
14.819 | 0.267 | tINS | RR | 1 | R23C32[2][B] | camera/flow_sensor/flow/two_scale.grid/patch/n2012_ATree_3_0_DOUT_11_s/SUM
15.672 | 0.853 | tNET | RR | 2 | R27C35[0][B] | camera/flow_sensor/flow/two_scale.grid/patch/n2014_s/I0
16.212 | 0.540 | tINS | RF | 1 | R27C35[0][B] | camera/flow_sensor/flow/two_scale.grid/patch/n2014_s/COUT
16.212 | 0.000 | tNET | FF | 2 | R27C35[1][A] | camera/flow_sensor/flow/two_scale.grid/patch/n2012_ATree_4_0_DOUT_8_s/CIN
16.257 | 0.045 | tINS | FR | 1 | R27C35[1][A] | camera/flow_sensor/flow/two_scale.grid/patch/n2012_ATree_4_0_DOUT_8_s/COUT
16.257 | 0.000 | tNET | RR | 2 | R27C35[1][B] | camera/flow_sensor/flow/two_scale.grid/patch/n2012_ATree_4_0_DOUT_9_s/CIN
16.523 | 0.267 | tINS | RR | 1 | R27C35[1][B] | camera/flow_sensor/flow/two_scale.grid/patch/n2012_ATree_4_0_DOUT_9_s/SUM
16.660 | 0.136 | tNET | RR | 1 | R27C35[2][A] | camera/flow_sensor/flow/two_scale.grid/patch/n2012_s120/I2
17.116 | 0.457 | tINS | RR | 1 | R27C35[2][A] | camera/flow_sensor/flow/two_scale.grid/patch/n2012_s120/F
17.116 | 0.000 | tNET | RR | 1 | R27C35[2][A] | camera/flow_sensor/flow/two_scale.grid/patch/yy_17_s0/D

Data Required Path:

AT | DELAY | TYPE | RF | FANOUT | LOC | NODE
11.905 | 11.905 | | | | | active clock edge time
11.905 | 0.000 | | | | | cam_pclk
11.905 | 0.000 | tCL | RR | 1 | IOL2[A] | camera_pclk_ibuf/I
12.519 | 0.614 | tINS | RR | 8189 | IOL2[A] | camera_pclk_ibuf/O
17.242 | 4.723 | tNET | RR | 1 | R27C35[2][A] | camera/flow_sensor/flow/two_scale.grid/patch/yy_17_s0/CLK
17.185 | -0.057 | tSu | | 1 | R27C35[2][A] | camera/flow_sensor/flow/two_scale.grid/patch/yy_17_s0

Path Statistics:

Clock Skew | -0.074
Setup Relationship | 11.905
Logic Level | 12
Arrival Clock Path Delay | cell: 0.614, 11.350%; route: 4.798, 88.650%
Arrival Data Path Delay | cell: 4.642, 39.658%; route: 6.719, 57.401%; tC2Q: 0.344, 2.941%
Required Clock Path Delay | cell: 0.614, 11.508%; route: 4.723, 88.492%

### Path11

Path Summary:

Slack | 0.100
Data Arrival Time | 14.737
Data Required Time | 14.837
From | camera/runtime_network.net/lookup2_valid_s0
To | camera/flow_bridge/event_payload_27_s0
Launch Clk | eth125:[R]
Latch Clk | eth125:[R]

Data Arrival Path:

AT | DELAY | TYPE | RF | FANOUT | LOC | NODE
0.000 | 0.000 | | | | | active clock edge time
0.000 | 0.000 | | | | | eth125
3.835 | 3.835 | tCL | RR | 5898 | PLL_B[2] | camera/pll/PLL_inst/CLKOUT1
7.122 | 3.287 | tNET | RR | 1 | R71C93[2][A] | camera/runtime_network.net/lookup2_valid_s0/CLK
7.466 | 0.344 | tC2Q | RR | 4 | R71C93[2][A] | camera/runtime_network.net/lookup2_valid_s0/Q
8.089 | 0.623 | tNET | RR | 1 | R70C90[3][B] | camera/runtime_network.status_211_s1/I2
8.606 | 0.516 | tINS | RR | 12 | R70C90[3][B] | camera/runtime_network.status_211_s1/F
9.823 | 1.217 | tNET | RR | 1 | R50C89[3][A] | camera/event_mux/available_s0/I1
10.339 | 0.516 | tINS | RR | 8 | R50C89[3][A] | camera/event_mux/available_s0/F
11.770 | 1.431 | tNET | RR | 1 | R27C99[3][B] | camera/flow_bridge/event_payload_255_s4/I0
12.287 | 0.516 | tINS | RR | 193 | R27C99[3][B] | camera/flow_bridge/event_payload_255_s4/F
14.737 | 2.450 | tNET | RR | 1 | R29C103[1][B] | camera/flow_bridge/event_payload_27_s0/CE

Data Required Path:

AT | DELAY | TYPE | RF | FANOUT | LOC | NODE
8.000 | 8.000 | | | | | active clock edge time
8.000 | 0.000 | | | | | eth125
11.835 | 3.835 | tCL | RR | 5898 | PLL_B[2] | camera/pll/PLL_inst/CLKOUT1
15.117 | 3.282 | tNET | RR | 1 | R29C103[1][B] | camera/flow_bridge/event_payload_27_s0/CLK
14.837 | -0.280 | tSu | | 1 | R29C103[1][B] | camera/flow_bridge/event_payload_27_s0

Path Statistics:

Clock Skew | -0.004
Setup Relationship | 8.000
Logic Level | 4
Arrival Clock Path Delay | cell: 0.000, 0.000%; route: 3.287, 100.000%
Arrival Data Path Delay | cell: 1.549, 20.343%; route: 5.722, 75.137%; tC2Q: 0.344, 4.521%
Required Clock Path Delay | cell: 0.000, 0.000%; route: 3.282, 100.000%

### Path12

Path Summary:

Slack | 0.102
Data Arrival Time | 17.069
Data Required Time | 17.171
From | camera/flow_sensor/flow/two_scale.grid/patch/gy_2_s0
To | camera/flow_sensor/flow/two_scale.grid/patch/yt_17_s0
Launch Clk | cam_pclk:[R]
Latch Clk | cam_pclk:[R]

Data Arrival Path:

AT | DELAY | TYPE | RF | FANOUT | LOC | NODE
0.000 | 0.000 | | | | | active clock edge time
0.000 | 0.000 | | | | | cam_pclk
0.000 | 0.000 | tCL | RR | 1 | IOL2[A] | camera_pclk_ibuf/I
0.614 | 0.614 | tINS | RR | 8189 | IOL2[A] | camera_pclk_ibuf/O
5.412 | 4.798 | tNET | RR | 1 | R31C47[1][B] | camera/flow_sensor/flow/two_scale.grid/patch/gy_2_s0/CLK
5.756 | 0.344 | tC2Q | RR | 29 | R31C47[1][B] | camera/flow_sensor/flow/two_scale.grid/patch/gy_2_s0/Q
9.500 | 3.744 | tNET | RR | 1 | R22C47[3][A] | camera/flow_sensor/flow/two_scale.grid/patch/n2066_s86/I0
9.911 | 0.411 | tINS | RR | 1 | R22C47[3][A] | camera/flow_sensor/flow/two_scale.grid/patch/n2066_s86/F
10.047 | 0.136 | tNET | RR | 2 | R22C47[0][B] | camera/flow_sensor/flow/two_scale.grid/patch/n2066_ATree_1_0_DOUT_1_s/I0
10.587 | 0.540 | tINS | RF | 1 | R22C47[0][B] | camera/flow_sensor/flow/two_scale.grid/patch/n2066_ATree_1_0_DOUT_1_s/COUT
10.587 | 0.000 | tNET | FF | 2 | R22C47[1][A] | camera/flow_sensor/flow/two_scale.grid/patch/n2066_ATree_1_0_DOUT_2_s/CIN
10.632 | 0.045 | tINS | FR | 1 | R22C47[1][A] | camera/flow_sensor/flow/two_scale.grid/patch/n2066_ATree_1_0_DOUT_2_s/COUT
10.632 | 0.000 | tNET | RR | 2 | R22C47[1][B] | camera/flow_sensor/flow/two_scale.grid/patch/n2066_ATree_1_0_DOUT_3_s/CIN
10.677 | 0.045 | tINS | RR | 1 | R22C47[1][B] | camera/flow_sensor/flow/two_scale.grid/patch/n2066_ATree_1_0_DOUT_3_s/COUT
10.677 | 0.000 | tNET | RR | 2 | R22C47[2][A] | camera/flow_sensor/flow/two_scale.grid/patch/n2066_ATree_1_0_DOUT_4_s/CIN
10.722 | 0.045 | tINS | RR | 1 | R22C47[2][A] | camera/flow_sensor/flow/two_scale.grid/patch/n2066_ATree_1_0_DOUT_4_s/COUT
10.722 | 0.000 | tNET | RR | 2 | R22C47[2][B] | camera/flow_sensor/flow/two_scale.grid/patch/n2066_ATree_1_0_DOUT_5_s/CIN
10.767 | 0.045 | tINS | RR | 1 | R22C47[2][B] | camera/flow_sensor/flow/two_scale.grid/patch/n2066_ATree_1_0_DOUT_5_s/COUT
10.767 | 0.000 | tNET | RR | 2 | R22C48[0][A] | camera/flow_sensor/flow/two_scale.grid/patch/n2066_ATree_1_0_DOUT_6_s/CIN
10.812 | 0.045 | tINS | RR | 1 | R22C48[0][A] | camera/flow_sensor/flow/two_scale.grid/patch/n2066_ATree_1_0_DOUT_6_s/COUT
10.812 | 0.000 | tNET | RR | 2 | R22C48[0][B] | camera/flow_sensor/flow/two_scale.grid/patch/n2066_ATree_1_0_DOUT_7_s/CIN
10.857 | 0.045 | tINS | RR | 1 | R22C48[0][B] | camera/flow_sensor/flow/two_scale.grid/patch/n2066_ATree_1_0_DOUT_7_s/COUT
10.857 | 0.000 | tNET | RR | 2 | R22C48[1][A] | camera/flow_sensor/flow/two_scale.grid/patch/n2066_ATree_1_0_DOUT_8_s/CIN
10.902 | 0.045 | tINS | RR | 1 | R22C48[1][A] | camera/flow_sensor/flow/two_scale.grid/patch/n2066_ATree_1_0_DOUT_8_s/COUT
10.902 | 0.000 | tNET | RR | 2 | R22C48[1][B] | camera/flow_sensor/flow/two_scale.grid/patch/n2066_ATree_1_0_DOUT_9_s/CIN
10.947 | 0.045 | tINS | RR | 1 | R22C48[1][B] | camera/flow_sensor/flow/two_scale.grid/patch/n2066_ATree_1_0_DOUT_9_s/COUT
10.947 | 0.000 | tNET | RR | 2 | R22C48[2][A] | camera/flow_sensor/flow/two_scale.grid/patch/n2066_ATree_1_0_DOUT_10_s/CIN
10.992 | 0.045 | tINS | RR | 1 | R22C48[2][A] | camera/flow_sensor/flow/two_scale.grid/patch/n2066_ATree_1_0_DOUT_10_s/COUT
10.992 | 0.000 | tNET | RR | 2 | R22C48[2][B] | camera/flow_sensor/flow/two_scale.grid/patch/n2066_ATree_1_0_DOUT_11_s/CIN
11.037 | 0.045 | tINS | RR | 1 | R22C48[2][B] | camera/flow_sensor/flow/two_scale.grid/patch/n2066_ATree_1_0_DOUT_11_s/COUT
11.037 | 0.000 | tNET | RR | 2 | R22C49[0][A] | camera/flow_sensor/flow/two_scale.grid/patch/n2066_ATree_1_0_DOUT_12_s/CIN
11.256 | 0.219 | tINS | RR | 1 | R22C49[0][A] | camera/flow_sensor/flow/two_scale.grid/patch/n2066_ATree_1_0_DOUT_12_s/SUM
12.451 | 1.195 | tNET | RR | 2 | R33C44[2][B] | camera/flow_sensor/flow/two_scale.grid/patch/n2066_ATree_2_0_DOUT_11_s/I0
12.991 | 0.540 | tINS | RF | 1 | R33C44[2][B] | camera/flow_sensor/flow/two_scale.grid/patch/n2066_ATree_2_0_DOUT_11_s/COUT
12.991 | 0.000 | tNET | FF | 2 | R33C45[0][A] | camera/flow_sensor/flow/two_scale.grid/patch/n2066_ATree_2_0_DOUT_12_s/CIN
13.036 | 0.045 | tINS | FR | 1 | R33C45[0][A] | camera/flow_sensor/flow/two_scale.grid/patch/n2066_ATree_2_0_DOUT_12_s/COUT
13.036 | 0.000 | tNET | RR | 2 | R33C45[0][B] | camera/flow_sensor/flow/two_scale.grid/patch/n2066_ATree_2_0_DOUT_13_s/CIN
13.303 | 0.267 | tINS | RR | 1 | R33C45[0][B] | camera/flow_sensor/flow/two_scale.grid/patch/n2066_ATree_2_0_DOUT_13_s/SUM
13.834 | 0.531 | tNET | RR | 2 | R34C42[2][B] | camera/flow_sensor/flow/two_scale.grid/patch/n2066_ATree_3_0_DOUT_11_s/I0
14.374 | 0.540 | tINS | RF | 1 | R34C42[2][B] | camera/flow_sensor/flow/two_scale.grid/patch/n2066_ATree_3_0_DOUT_11_s/COUT
14.374 | 0.000 | tNET | FF | 2 | R34C43[0][A] | camera/flow_sensor/flow/two_scale.grid/patch/n2066_ATree_3_0_DOUT_12_s/CIN
14.593 | 0.219 | tINS | FR | 1 | R34C43[0][A] | camera/flow_sensor/flow/two_scale.grid/patch/n2066_ATree_3_0_DOUT_12_s/SUM
15.562 | 0.969 | tNET | RR | 2 | R31C36[1][A] | camera/flow_sensor/flow/two_scale.grid/patch/n2066_ATree_4_0_DOUT_8_s/I0
16.102 | 0.540 | tINS | RF | 1 | R31C36[1][A] | camera/flow_sensor/flow/two_scale.grid/patch/n2066_ATree_4_0_DOUT_8_s/COUT
16.102 | 0.000 | tNET | FF | 2 | R31C36[1][B] | camera/flow_sensor/flow/two_scale.grid/patch/n2066_ATree_4_0_DOUT_9_s/CIN
16.373 | 0.271 | tINS | FF | 1 | R31C36[1][B] | camera/flow_sensor/flow/two_scale.grid/patch/n2066_ATree_4_0_DOUT_9_s/SUM
16.558 | 0.186 | tNET | FF | 1 | R31C34[1][A] | camera/flow_sensor/flow/two_scale.grid/patch/n2066_s165/I2
17.069 | 0.511 | tINS | FR | 1 | R31C34[1][A] | camera/flow_sensor/flow/two_scale.grid/patch/n2066_s165/F
17.069 | 0.000 | tNET | RR | 1 | R31C34[1][A] | camera/flow_sensor/flow/two_scale.grid/patch/yt_17_s0/D

Data Required Path:

AT | DELAY | TYPE | RF | FANOUT | LOC | NODE
11.905 | 11.905 | | | | | active clock edge time
11.905 | 0.000 | | | | | cam_pclk
11.905 | 0.000 | tCL | RR | 1 | IOL2[A] | camera_pclk_ibuf/I
12.519 | 0.614 | tINS | RR | 8189 | IOL2[A] | camera_pclk_ibuf/O
17.228 | 4.709 | tNET | RR | 1 | R31C34[1][A] | camera/flow_sensor/flow/two_scale.grid/patch/yt_17_s0/CLK
17.171 | -0.057 | tSu | | 1 | R31C34[1][A] | camera/flow_sensor/flow/two_scale.grid/patch/yt_17_s0

Path Statistics:

Clock Skew | -0.088
Setup Relationship | 11.905
Logic Level | 12
Arrival Clock Path Delay | cell: 0.614, 11.350%; route: 4.798, 88.650%
Arrival Data Path Delay | cell: 4.553, 39.056%; route: 6.760, 57.991%; tC2Q: 0.344, 2.953%
Required Clock Path Delay | cell: 0.614, 11.538%; route: 4.709, 88.462%

### Path13

Path Summary:

Slack | 0.102
Data Arrival Time | 17.171
Data Required Time | 17.273
From | camera/tracker/semantic_fid_0_s1
To | camera/tracker/state_1_s1
Launch Clk | cam_pclk:[R]
Latch Clk | cam_pclk:[R]

Data Arrival Path:

AT | DELAY | TYPE | RF | FANOUT | LOC | NODE
0.000 | 0.000 | | | | | active clock edge time
0.000 | 0.000 | | | | | cam_pclk
0.000 | 0.000 | tCL | RR | 1 | IOL2[A] | camera_pclk_ibuf/I
0.614 | 0.614 | tINS | RR | 8189 | IOL2[A] | camera_pclk_ibuf/O
5.471 | 4.857 | tNET | RR | 1 | R58C57[3][B] | camera/tracker/semantic_fid_0_s1/CLK
5.802 | 0.331 | tC2Q | RF | 32 | R58C57[3][B] | camera/tracker/semantic_fid_0_s1/Q
6.526 | 0.724 | tNET | FF | 1 | R56C62[3][B] | camera/tracker/n2894_s49/I2
6.905 | 0.379 | tINS | FF | 1 | R56C62[3][B] | camera/tracker/n2894_s49/F
6.905 | 0.000 | tNET | FF | 1 | R56C62[3][A] | camera/tracker/n2894_s46/I1
7.100 | 0.195 | tINS | FF | 1 | R56C62[3][A] | camera/tracker/n2894_s46/O
7.100 | 0.000 | tNET | FF | 1 | R56C62[2][B] | camera/tracker/n2894_s39/I0
7.191 | 0.091 | tINS | FF | 1 | R56C62[2][B] | camera/tracker/n2894_s39/O
8.101 | 0.910 | tNET | FF | 2 | R61C54[0][B] | camera/tracker/n2897_s0/I0
8.637 | 0.535 | tINS | FF | 1 | R61C54[0][B] | camera/tracker/n2897_s0/COUT
8.637 | 0.000 | tNET | FF | 2 | R61C54[1][A] | camera/tracker/n2898_s0/CIN
8.682 | 0.045 | tINS | FR | 1 | R61C54[1][A] | camera/tracker/n2898_s0/COUT
8.682 | 0.000 | tNET | RR | 2 | R61C54[1][B] | camera/tracker/n2899_s0/CIN
8.727 | 0.045 | tINS | RR | 1 | R61C54[1][B] | camera/tracker/n2899_s0/COUT
8.727 | 0.000 | tNET | RR | 2 | R61C54[2][A] | camera/tracker/n2900_s0/CIN
8.772 | 0.045 | tINS | RR | 1 | R61C54[2][A] | camera/tracker/n2900_s0/COUT
8.772 | 0.000 | tNET | RR | 2 | R61C54[2][B] | camera/tracker/n2901_s0/CIN
8.817 | 0.045 | tINS | RR | 1 | R61C54[2][B] | camera/tracker/n2901_s0/COUT
8.817 | 0.000 | tNET | RR | 2 | R61C55[0][A] | camera/tracker/n2902_s0/CIN
8.862 | 0.045 | tINS | RR | 1 | R61C55[0][A] | camera/tracker/n2902_s0/COUT
8.862 | 0.000 | tNET | RR | 2 | R61C55[0][B] | camera/tracker/n2903_s0/CIN
8.907 | 0.045 | tINS | RR | 1 | R61C55[0][B] | camera/tracker/n2903_s0/COUT
8.907 | 0.000 | tNET | RR | 2 | R61C55[1][A] | camera/tracker/n2904_s0/CIN
8.952 | 0.045 | tINS | RR | 1 | R61C55[1][A] | camera/tracker/n2904_s0/COUT
8.952 | 0.000 | tNET | RR | 2 | R61C55[1][B] | camera/tracker/n2905_s0/CIN
8.997 | 0.045 | tINS | RR | 1 | R61C55[1][B] | camera/tracker/n2905_s0/COUT
8.997 | 0.000 | tNET | RR | 2 | R61C55[2][A] | camera/tracker/n2906_s0/CIN
9.042 | 0.045 | tINS | RR | 1 | R61C55[2][A] | camera/tracker/n2906_s0/COUT
9.042 | 0.000 | tNET | RR | 2 | R61C55[2][B] | camera/tracker/n2907_s0/CIN
9.087 | 0.045 | tINS | RR | 1 | R61C55[2][B] | camera/tracker/n2907_s0/COUT
9.087 | 0.000 | tNET | RR | 2 | R61C56[0][A] | camera/tracker/n2908_s0/CIN
9.132 | 0.045 | tINS | RR | 1 | R61C56[0][A] | camera/tracker/n2908_s0/COUT
9.132 | 0.000 | tNET | RR | 2 | R61C56[0][B] | camera/tracker/n2909_s0/CIN
9.177 | 0.045 | tINS | RR | 1 | R61C56[0][B] | camera/tracker/n2909_s0/COUT
9.177 | 0.000 | tNET | RR | 2 | R61C56[1][A] | camera/tracker/n2910_s0/CIN
9.222 | 0.045 | tINS | RR | 1 | R61C56[1][A] | camera/tracker/n2910_s0/COUT
9.222 | 0.000 | tNET | RR | 2 | R61C56[1][B] | camera/tracker/n2911_s0/CIN
9.267 | 0.045 | tINS | RR | 1 | R61C56[1][B] | camera/tracker/n2911_s0/COUT
10.256 | 0.989 | tNET | RR | 1 | R63C65[3][B] | camera/tracker/tracked_fid_15_s14/I3
10.518 | 0.262 | tINS | RR | 1 | R63C65[3][B] | camera/tracker/tracked_fid_15_s14/F
11.400 | 0.882 | tNET | RR | 1 | R66C70[2][B] | camera/tracker/tracked_fid_15_s11/I1
11.856 | 0.457 | tINS | RR | 1 | R66C70[2][B] | camera/tracker/tracked_fid_15_s11/F
12.012 | 0.155 | tNET | RR | 1 | R65C70[1][B] | camera/tracker/tracked_fid_15_s9/I3
12.468 | 0.457 | tINS | RR | 1 | R65C70[1][B] | camera/tracker/tracked_fid_15_s9/F
12.471 | 0.002 | tNET | RR | 1 | R65C70[3][B] | camera/tracker/tracked_fid_15_s7/I3
12.987 | 0.516 | tINS | RR | 4 | R65C70[3][B] | camera/tracker/tracked_fid_15_s7/F
13.454 | 0.467 | tNET | RR | 1 | R69C71[3][A] | camera/tracker/tracked_fid_15_s6/I1
13.947 | 0.493 | tINS | RR | 5 | R69C71[3][A] | camera/tracker/tracked_fid_15_s6/F
14.492 | 0.546 | tNET | RR | 1 | R66C69[1][A] | camera/tracker/n6430_s10/I3
14.752 | 0.260 | tINS | RR | 1 | R66C69[1][A] | camera/tracker/n6430_s10/F
15.462 | 0.710 | tNET | RR | 1 | R72C69[2][B] | camera/tracker/n6430_s6/I1
15.722 | 0.260 | tINS | RR | 1 | R72C69[2][B] | camera/tracker/n6430_s6/F
16.065 | 0.343 | tNET | RR | 1 | R71C67[1][A] | camera/tracker/n6430_s4/I0
16.576 | 0.511 | tINS | RR | 2 | R71C67[1][A] | camera/tracker/n6430_s4/F
16.714 | 0.138 | tNET | RR | 1 | R71C67[0][B] | camera/tracker/n6430_s33/I1
17.171 | 0.457 | tINS | RR | 1 | R71C67[0][B] | camera/tracker/n6430_s33/F
17.171 | 0.000 | tNET | RR | 1 | R71C67[0][B] | camera/tracker/state_1_s1/D

Data Required Path:

AT | DELAY | TYPE | RF | FANOUT | LOC | NODE
11.905 | 11.905 | | | | | active clock edge time
11.905 | 0.000 | | | | | cam_pclk
11.905 | 0.000 | tCL | RR | 1 | IOL2[A] | camera_pclk_ibuf/I
12.519 | 0.614 | tINS | RR | 8189 | IOL2[A] | camera_pclk_ibuf/O
17.331 | 4.812 | tNET | RR | 1 | R71C67[0][B] | camera/tracker/state_1_s1/CLK
17.273 | -0.057 | tSu | | 1 | R71C67[0][B] | camera/tracker/state_1_s1

Path Statistics:

Clock Skew | -0.045
Setup Relationship | 11.905
Logic Level | 15
Arrival Clock Path Delay | cell: 0.614, 11.228%; route: 4.857, 88.772%
Arrival Data Path Delay | cell: 5.502, 47.029%; route: 5.867, 50.144%; tC2Q: 0.331, 2.827%
Required Clock Path Delay | cell: 0.614, 11.321%; route: 4.812, 88.679%

### Path14

Path Summary:

Slack | 0.102
Data Arrival Time | 17.171
Data Required Time | 17.273
From | camera/tracker/semantic_fid_0_s1
To | camera/tracker/state_1_s0
Launch Clk | cam_pclk:[R]
Latch Clk | cam_pclk:[R]

Data Arrival Path:

AT | DELAY | TYPE | RF | FANOUT | LOC | NODE
0.000 | 0.000 | | | | | active clock edge time
0.000 | 0.000 | | | | | cam_pclk
0.000 | 0.000 | tCL | RR | 1 | IOL2[A] | camera_pclk_ibuf/I
0.614 | 0.614 | tINS | RR | 8189 | IOL2[A] | camera_pclk_ibuf/O
5.471 | 4.857 | tNET | RR | 1 | R58C57[3][B] | camera/tracker/semantic_fid_0_s1/CLK
5.802 | 0.331 | tC2Q | RF | 32 | R58C57[3][B] | camera/tracker/semantic_fid_0_s1/Q
6.526 | 0.724 | tNET | FF | 1 | R56C62[3][B] | camera/tracker/n2894_s49/I2
6.905 | 0.379 | tINS | FF | 1 | R56C62[3][B] | camera/tracker/n2894_s49/F
6.905 | 0.000 | tNET | FF | 1 | R56C62[3][A] | camera/tracker/n2894_s46/I1
7.100 | 0.195 | tINS | FF | 1 | R56C62[3][A] | camera/tracker/n2894_s46/O
7.100 | 0.000 | tNET | FF | 1 | R56C62[2][B] | camera/tracker/n2894_s39/I0
7.191 | 0.091 | tINS | FF | 1 | R56C62[2][B] | camera/tracker/n2894_s39/O
8.101 | 0.910 | tNET | FF | 2 | R61C54[0][B] | camera/tracker/n2897_s0/I0
8.637 | 0.535 | tINS | FF | 1 | R61C54[0][B] | camera/tracker/n2897_s0/COUT
8.637 | 0.000 | tNET | FF | 2 | R61C54[1][A] | camera/tracker/n2898_s0/CIN
8.682 | 0.045 | tINS | FR | 1 | R61C54[1][A] | camera/tracker/n2898_s0/COUT
8.682 | 0.000 | tNET | RR | 2 | R61C54[1][B] | camera/tracker/n2899_s0/CIN
8.727 | 0.045 | tINS | RR | 1 | R61C54[1][B] | camera/tracker/n2899_s0/COUT
8.727 | 0.000 | tNET | RR | 2 | R61C54[2][A] | camera/tracker/n2900_s0/CIN
8.772 | 0.045 | tINS | RR | 1 | R61C54[2][A] | camera/tracker/n2900_s0/COUT
8.772 | 0.000 | tNET | RR | 2 | R61C54[2][B] | camera/tracker/n2901_s0/CIN
8.817 | 0.045 | tINS | RR | 1 | R61C54[2][B] | camera/tracker/n2901_s0/COUT
8.817 | 0.000 | tNET | RR | 2 | R61C55[0][A] | camera/tracker/n2902_s0/CIN
8.862 | 0.045 | tINS | RR | 1 | R61C55[0][A] | camera/tracker/n2902_s0/COUT
8.862 | 0.000 | tNET | RR | 2 | R61C55[0][B] | camera/tracker/n2903_s0/CIN
8.907 | 0.045 | tINS | RR | 1 | R61C55[0][B] | camera/tracker/n2903_s0/COUT
8.907 | 0.000 | tNET | RR | 2 | R61C55[1][A] | camera/tracker/n2904_s0/CIN
8.952 | 0.045 | tINS | RR | 1 | R61C55[1][A] | camera/tracker/n2904_s0/COUT
8.952 | 0.000 | tNET | RR | 2 | R61C55[1][B] | camera/tracker/n2905_s0/CIN
8.997 | 0.045 | tINS | RR | 1 | R61C55[1][B] | camera/tracker/n2905_s0/COUT
8.997 | 0.000 | tNET | RR | 2 | R61C55[2][A] | camera/tracker/n2906_s0/CIN
9.042 | 0.045 | tINS | RR | 1 | R61C55[2][A] | camera/tracker/n2906_s0/COUT
9.042 | 0.000 | tNET | RR | 2 | R61C55[2][B] | camera/tracker/n2907_s0/CIN
9.087 | 0.045 | tINS | RR | 1 | R61C55[2][B] | camera/tracker/n2907_s0/COUT
9.087 | 0.000 | tNET | RR | 2 | R61C56[0][A] | camera/tracker/n2908_s0/CIN
9.132 | 0.045 | tINS | RR | 1 | R61C56[0][A] | camera/tracker/n2908_s0/COUT
9.132 | 0.000 | tNET | RR | 2 | R61C56[0][B] | camera/tracker/n2909_s0/CIN
9.177 | 0.045 | tINS | RR | 1 | R61C56[0][B] | camera/tracker/n2909_s0/COUT
9.177 | 0.000 | tNET | RR | 2 | R61C56[1][A] | camera/tracker/n2910_s0/CIN
9.222 | 0.045 | tINS | RR | 1 | R61C56[1][A] | camera/tracker/n2910_s0/COUT
9.222 | 0.000 | tNET | RR | 2 | R61C56[1][B] | camera/tracker/n2911_s0/CIN
9.267 | 0.045 | tINS | RR | 1 | R61C56[1][B] | camera/tracker/n2911_s0/COUT
10.256 | 0.989 | tNET | RR | 1 | R63C65[3][B] | camera/tracker/tracked_fid_15_s14/I3
10.518 | 0.262 | tINS | RR | 1 | R63C65[3][B] | camera/tracker/tracked_fid_15_s14/F
11.400 | 0.882 | tNET | RR | 1 | R66C70[2][B] | camera/tracker/tracked_fid_15_s11/I1
11.856 | 0.457 | tINS | RR | 1 | R66C70[2][B] | camera/tracker/tracked_fid_15_s11/F
12.012 | 0.155 | tNET | RR | 1 | R65C70[1][B] | camera/tracker/tracked_fid_15_s9/I3
12.468 | 0.457 | tINS | RR | 1 | R65C70[1][B] | camera/tracker/tracked_fid_15_s9/F
12.471 | 0.002 | tNET | RR | 1 | R65C70[3][B] | camera/tracker/tracked_fid_15_s7/I3
12.987 | 0.516 | tINS | RR | 4 | R65C70[3][B] | camera/tracker/tracked_fid_15_s7/F
13.454 | 0.467 | tNET | RR | 1 | R69C71[3][A] | camera/tracker/tracked_fid_15_s6/I1
13.947 | 0.493 | tINS | RR | 5 | R69C71[3][A] | camera/tracker/tracked_fid_15_s6/F
14.492 | 0.546 | tNET | RR | 1 | R66C69[1][A] | camera/tracker/n6430_s10/I3
14.752 | 0.260 | tINS | RR | 1 | R66C69[1][A] | camera/tracker/n6430_s10/F
15.462 | 0.710 | tNET | RR | 1 | R72C69[2][B] | camera/tracker/n6430_s6/I1
15.722 | 0.260 | tINS | RR | 1 | R72C69[2][B] | camera/tracker/n6430_s6/F
16.065 | 0.343 | tNET | RR | 1 | R71C67[1][A] | camera/tracker/n6430_s4/I0
16.576 | 0.511 | tINS | RR | 2 | R71C67[1][A] | camera/tracker/n6430_s4/F
16.714 | 0.138 | tNET | RR | 1 | R71C67[0][A] | camera/tracker/n6430_s2/I1
17.171 | 0.457 | tINS | RR | 1 | R71C67[0][A] | camera/tracker/n6430_s2/F
17.171 | 0.000 | tNET | RR | 1 | R71C67[0][A] | camera/tracker/state_1_s0/D

Data Required Path:

AT | DELAY | TYPE | RF | FANOUT | LOC | NODE
11.905 | 11.905 | | | | | active clock edge time
11.905 | 0.000 | | | | | cam_pclk
11.905 | 0.000 | tCL | RR | 1 | IOL2[A] | camera_pclk_ibuf/I
12.519 | 0.614 | tINS | RR | 8189 | IOL2[A] | camera_pclk_ibuf/O
17.331 | 4.812 | tNET | RR | 1 | R71C67[0][A] | camera/tracker/state_1_s0/CLK
17.273 | -0.057 | tSu | | 1 | R71C67[0][A] | camera/tracker/state_1_s0

Path Statistics:

Clock Skew | -0.045
Setup Relationship | 11.905
Logic Level | 15
Arrival Clock Path Delay | cell: 0.614, 11.228%; route: 4.857, 88.772%
Arrival Data Path Delay | cell: 5.502, 47.029%; route: 5.867, 50.144%; tC2Q: 0.331, 2.827%
Required Clock Path Delay | cell: 0.614, 11.321%; route: 4.812, 88.679%

### Path15

Path Summary:

Slack | 0.109
Data Arrival Time | 14.737
Data Required Time | 14.846
From | camera/runtime_network.net/lookup2_valid_s0
To | camera/flow_bridge/event_payload_14_s0
Launch Clk | eth125:[R]
Latch Clk | eth125:[R]

Data Arrival Path:

AT | DELAY | TYPE | RF | FANOUT | LOC | NODE
0.000 | 0.000 | | | | | active clock edge time
0.000 | 0.000 | | | | | eth125
3.835 | 3.835 | tCL | RR | 5898 | PLL_B[2] | camera/pll/PLL_inst/CLKOUT1
7.122 | 3.287 | tNET | RR | 1 | R71C93[2][A] | camera/runtime_network.net/lookup2_valid_s0/CLK
7.466 | 0.344 | tC2Q | RR | 4 | R71C93[2][A] | camera/runtime_network.net/lookup2_valid_s0/Q
8.089 | 0.623 | tNET | RR | 1 | R70C90[3][B] | camera/runtime_network.status_211_s1/I2
8.606 | 0.516 | tINS | RR | 12 | R70C90[3][B] | camera/runtime_network.status_211_s1/F
9.823 | 1.217 | tNET | RR | 1 | R50C89[3][A] | camera/event_mux/available_s0/I1
10.339 | 0.516 | tINS | RR | 8 | R50C89[3][A] | camera/event_mux/available_s0/F
11.770 | 1.431 | tNET | RR | 1 | R27C99[3][B] | camera/flow_bridge/event_payload_255_s4/I0
12.287 | 0.516 | tINS | RR | 193 | R27C99[3][B] | camera/flow_bridge/event_payload_255_s4/F
14.737 | 2.450 | tNET | RR | 1 | R29C102[0][B] | camera/flow_bridge/event_payload_14_s0/CE

Data Required Path:

AT | DELAY | TYPE | RF | FANOUT | LOC | NODE
8.000 | 8.000 | | | | | active clock edge time
8.000 | 0.000 | | | | | eth125
11.835 | 3.835 | tCL | RR | 5898 | PLL_B[2] | camera/pll/PLL_inst/CLKOUT1
15.126 | 3.291 | tNET | RR | 1 | R29C102[0][B] | camera/flow_bridge/event_payload_14_s0/CLK
14.846 | -0.280 | tSu | | 1 | R29C102[0][B] | camera/flow_bridge/event_payload_14_s0

Path Statistics:

Clock Skew | 0.004
Setup Relationship | 8.000
Logic Level | 4
Arrival Clock Path Delay | cell: 0.000, 0.000%; route: 3.287, 100.000%
Arrival Data Path Delay | cell: 1.549, 20.343%; route: 5.722, 75.137%; tC2Q: 0.344, 4.521%
Required Clock Path Delay | cell: 0.000, 0.000%; route: 3.291, 100.000%

### Path16

Path Summary:

Slack | 0.109
Data Arrival Time | 14.737
Data Required Time | 14.846
From | camera/runtime_network.net/lookup2_valid_s0
To | camera/flow_bridge/event_payload_16_s0
Launch Clk | eth125:[R]
Latch Clk | eth125:[R]

Data Arrival Path:

AT | DELAY | TYPE | RF | FANOUT | LOC | NODE
0.000 | 0.000 | | | | | active clock edge time
0.000 | 0.000 | | | | | eth125
3.835 | 3.835 | tCL | RR | 5898 | PLL_B[2] | camera/pll/PLL_inst/CLKOUT1
7.122 | 3.287 | tNET | RR | 1 | R71C93[2][A] | camera/runtime_network.net/lookup2_valid_s0/CLK
7.466 | 0.344 | tC2Q | RR | 4 | R71C93[2][A] | camera/runtime_network.net/lookup2_valid_s0/Q
8.089 | 0.623 | tNET | RR | 1 | R70C90[3][B] | camera/runtime_network.status_211_s1/I2
8.606 | 0.516 | tINS | RR | 12 | R70C90[3][B] | camera/runtime_network.status_211_s1/F
9.823 | 1.217 | tNET | RR | 1 | R50C89[3][A] | camera/event_mux/available_s0/I1
10.339 | 0.516 | tINS | RR | 8 | R50C89[3][A] | camera/event_mux/available_s0/F
11.770 | 1.431 | tNET | RR | 1 | R27C99[3][B] | camera/flow_bridge/event_payload_255_s4/I0
12.287 | 0.516 | tINS | RR | 193 | R27C99[3][B] | camera/flow_bridge/event_payload_255_s4/F
14.737 | 2.450 | tNET | RR | 1 | R29C102[3][A] | camera/flow_bridge/event_payload_16_s0/CE

Data Required Path:

AT | DELAY | TYPE | RF | FANOUT | LOC | NODE
8.000 | 8.000 | | | | | active clock edge time
8.000 | 0.000 | | | | | eth125
11.835 | 3.835 | tCL | RR | 5898 | PLL_B[2] | camera/pll/PLL_inst/CLKOUT1
15.126 | 3.291 | tNET | RR | 1 | R29C102[3][A] | camera/flow_bridge/event_payload_16_s0/CLK
14.846 | -0.280 | tSu | | 1 | R29C102[3][A] | camera/flow_bridge/event_payload_16_s0

Path Statistics:

Clock Skew | 0.004
Setup Relationship | 8.000
Logic Level | 4
Arrival Clock Path Delay | cell: 0.000, 0.000%; route: 3.287, 100.000%
Arrival Data Path Delay | cell: 1.549, 20.343%; route: 5.722, 75.137%; tC2Q: 0.344, 4.521%
Required Clock Path Delay | cell: 0.000, 0.000%; route: 3.291, 100.000%

### Path17

Path Summary:

Slack | 0.109
Data Arrival Time | 14.737
Data Required Time | 14.846
From | camera/runtime_network.net/lookup2_valid_s0
To | camera/flow_bridge/event_payload_24_s0
Launch Clk | eth125:[R]
Latch Clk | eth125:[R]

Data Arrival Path:

AT | DELAY | TYPE | RF | FANOUT | LOC | NODE
0.000 | 0.000 | | | | | active clock edge time
0.000 | 0.000 | | | | | eth125
3.835 | 3.835 | tCL | RR | 5898 | PLL_B[2] | camera/pll/PLL_inst/CLKOUT1
7.122 | 3.287 | tNET | RR | 1 | R71C93[2][A] | camera/runtime_network.net/lookup2_valid_s0/CLK
7.466 | 0.344 | tC2Q | RR | 4 | R71C93[2][A] | camera/runtime_network.net/lookup2_valid_s0/Q
8.089 | 0.623 | tNET | RR | 1 | R70C90[3][B] | camera/runtime_network.status_211_s1/I2
8.606 | 0.516 | tINS | RR | 12 | R70C90[3][B] | camera/runtime_network.status_211_s1/F
9.823 | 1.217 | tNET | RR | 1 | R50C89[3][A] | camera/event_mux/available_s0/I1
10.339 | 0.516 | tINS | RR | 8 | R50C89[3][A] | camera/event_mux/available_s0/F
11.770 | 1.431 | tNET | RR | 1 | R27C99[3][B] | camera/flow_bridge/event_payload_255_s4/I0
12.287 | 0.516 | tINS | RR | 193 | R27C99[3][B] | camera/flow_bridge/event_payload_255_s4/F
14.737 | 2.450 | tNET | RR | 1 | R29C102[3][B] | camera/flow_bridge/event_payload_24_s0/CE

Data Required Path:

AT | DELAY | TYPE | RF | FANOUT | LOC | NODE
8.000 | 8.000 | | | | | active clock edge time
8.000 | 0.000 | | | | | eth125
11.835 | 3.835 | tCL | RR | 5898 | PLL_B[2] | camera/pll/PLL_inst/CLKOUT1
15.126 | 3.291 | tNET | RR | 1 | R29C102[3][B] | camera/flow_bridge/event_payload_24_s0/CLK
14.846 | -0.280 | tSu | | 1 | R29C102[3][B] | camera/flow_bridge/event_payload_24_s0

Path Statistics:

Clock Skew | 0.004
Setup Relationship | 8.000
Logic Level | 4
Arrival Clock Path Delay | cell: 0.000, 0.000%; route: 3.287, 100.000%
Arrival Data Path Delay | cell: 1.549, 20.343%; route: 5.722, 75.137%; tC2Q: 0.344, 4.521%
Required Clock Path Delay | cell: 0.000, 0.000%; route: 3.291, 100.000%

### Path18

Path Summary:

Slack | 0.109
Data Arrival Time | 14.737
Data Required Time | 14.846
From | camera/runtime_network.net/lookup2_valid_s0
To | camera/flow_bridge/event_payload_28_s0
Launch Clk | eth125:[R]
Latch Clk | eth125:[R]

Data Arrival Path:

AT | DELAY | TYPE | RF | FANOUT | LOC | NODE
0.000 | 0.000 | | | | | active clock edge time
0.000 | 0.000 | | | | | eth125
3.835 | 3.835 | tCL | RR | 5898 | PLL_B[2] | camera/pll/PLL_inst/CLKOUT1
7.122 | 3.287 | tNET | RR | 1 | R71C93[2][A] | camera/runtime_network.net/lookup2_valid_s0/CLK
7.466 | 0.344 | tC2Q | RR | 4 | R71C93[2][A] | camera/runtime_network.net/lookup2_valid_s0/Q
8.089 | 0.623 | tNET | RR | 1 | R70C90[3][B] | camera/runtime_network.status_211_s1/I2
8.606 | 0.516 | tINS | RR | 12 | R70C90[3][B] | camera/runtime_network.status_211_s1/F
9.823 | 1.217 | tNET | RR | 1 | R50C89[3][A] | camera/event_mux/available_s0/I1
10.339 | 0.516 | tINS | RR | 8 | R50C89[3][A] | camera/event_mux/available_s0/F
11.770 | 1.431 | tNET | RR | 1 | R27C99[3][B] | camera/flow_bridge/event_payload_255_s4/I0
12.287 | 0.516 | tINS | RR | 193 | R27C99[3][B] | camera/flow_bridge/event_payload_255_s4/F
14.737 | 2.450 | tNET | RR | 1 | R29C102[2][A] | camera/flow_bridge/event_payload_28_s0/CE

Data Required Path:

AT | DELAY | TYPE | RF | FANOUT | LOC | NODE
8.000 | 8.000 | | | | | active clock edge time
8.000 | 0.000 | | | | | eth125
11.835 | 3.835 | tCL | RR | 5898 | PLL_B[2] | camera/pll/PLL_inst/CLKOUT1
15.126 | 3.291 | tNET | RR | 1 | R29C102[2][A] | camera/flow_bridge/event_payload_28_s0/CLK
14.846 | -0.280 | tSu | | 1 | R29C102[2][A] | camera/flow_bridge/event_payload_28_s0

Path Statistics:

Clock Skew | 0.004
Setup Relationship | 8.000
Logic Level | 4
Arrival Clock Path Delay | cell: 0.000, 0.000%; route: 3.287, 100.000%
Arrival Data Path Delay | cell: 1.549, 20.343%; route: 5.722, 75.137%; tC2Q: 0.344, 4.521%
Required Clock Path Delay | cell: 0.000, 0.000%; route: 3.291, 100.000%

### Path19

Path Summary:

Slack | 0.109
Data Arrival Time | 14.737
Data Required Time | 14.846
From | camera/runtime_network.net/lookup2_valid_s0
To | camera/flow_bridge/event_payload_29_s0
Launch Clk | eth125:[R]
Latch Clk | eth125:[R]

Data Arrival Path:

AT | DELAY | TYPE | RF | FANOUT | LOC | NODE
0.000 | 0.000 | | | | | active clock edge time
0.000 | 0.000 | | | | | eth125
3.835 | 3.835 | tCL | RR | 5898 | PLL_B[2] | camera/pll/PLL_inst/CLKOUT1
7.122 | 3.287 | tNET | RR | 1 | R71C93[2][A] | camera/runtime_network.net/lookup2_valid_s0/CLK
7.466 | 0.344 | tC2Q | RR | 4 | R71C93[2][A] | camera/runtime_network.net/lookup2_valid_s0/Q
8.089 | 0.623 | tNET | RR | 1 | R70C90[3][B] | camera/runtime_network.status_211_s1/I2
8.606 | 0.516 | tINS | RR | 12 | R70C90[3][B] | camera/runtime_network.status_211_s1/F
9.823 | 1.217 | tNET | RR | 1 | R50C89[3][A] | camera/event_mux/available_s0/I1
10.339 | 0.516 | tINS | RR | 8 | R50C89[3][A] | camera/event_mux/available_s0/F
11.770 | 1.431 | tNET | RR | 1 | R27C99[3][B] | camera/flow_bridge/event_payload_255_s4/I0
12.287 | 0.516 | tINS | RR | 193 | R27C99[3][B] | camera/flow_bridge/event_payload_255_s4/F
14.737 | 2.450 | tNET | RR | 1 | R29C102[2][B] | camera/flow_bridge/event_payload_29_s0/CE

Data Required Path:

AT | DELAY | TYPE | RF | FANOUT | LOC | NODE
8.000 | 8.000 | | | | | active clock edge time
8.000 | 0.000 | | | | | eth125
11.835 | 3.835 | tCL | RR | 5898 | PLL_B[2] | camera/pll/PLL_inst/CLKOUT1
15.126 | 3.291 | tNET | RR | 1 | R29C102[2][B] | camera/flow_bridge/event_payload_29_s0/CLK
14.846 | -0.280 | tSu | | 1 | R29C102[2][B] | camera/flow_bridge/event_payload_29_s0

Path Statistics:

Clock Skew | 0.004
Setup Relationship | 8.000
Logic Level | 4
Arrival Clock Path Delay | cell: 0.000, 0.000%; route: 3.287, 100.000%
Arrival Data Path Delay | cell: 1.549, 20.343%; route: 5.722, 75.137%; tC2Q: 0.344, 4.521%
Required Clock Path Delay | cell: 0.000, 0.000%; route: 3.291, 100.000%

### Path20

Path Summary:

Slack | 0.109
Data Arrival Time | 14.737
Data Required Time | 14.846
From | camera/runtime_network.net/lookup2_valid_s0
To | camera/flow_bridge/event_payload_30_s0
Launch Clk | eth125:[R]
Latch Clk | eth125:[R]

Data Arrival Path:

AT | DELAY | TYPE | RF | FANOUT | LOC | NODE
0.000 | 0.000 | | | | | active clock edge time
0.000 | 0.000 | | | | | eth125
3.835 | 3.835 | tCL | RR | 5898 | PLL_B[2] | camera/pll/PLL_inst/CLKOUT1
7.122 | 3.287 | tNET | RR | 1 | R71C93[2][A] | camera/runtime_network.net/lookup2_valid_s0/CLK
7.466 | 0.344 | tC2Q | RR | 4 | R71C93[2][A] | camera/runtime_network.net/lookup2_valid_s0/Q
8.089 | 0.623 | tNET | RR | 1 | R70C90[3][B] | camera/runtime_network.status_211_s1/I2
8.606 | 0.516 | tINS | RR | 12 | R70C90[3][B] | camera/runtime_network.status_211_s1/F
9.823 | 1.217 | tNET | RR | 1 | R50C89[3][A] | camera/event_mux/available_s0/I1
10.339 | 0.516 | tINS | RR | 8 | R50C89[3][A] | camera/event_mux/available_s0/F
11.770 | 1.431 | tNET | RR | 1 | R27C99[3][B] | camera/flow_bridge/event_payload_255_s4/I0
12.287 | 0.516 | tINS | RR | 193 | R27C99[3][B] | camera/flow_bridge/event_payload_255_s4/F
14.737 | 2.450 | tNET | RR | 1 | R29C102[0][A] | camera/flow_bridge/event_payload_30_s0/CE

Data Required Path:

AT | DELAY | TYPE | RF | FANOUT | LOC | NODE
8.000 | 8.000 | | | | | active clock edge time
8.000 | 0.000 | | | | | eth125
11.835 | 3.835 | tCL | RR | 5898 | PLL_B[2] | camera/pll/PLL_inst/CLKOUT1
15.126 | 3.291 | tNET | RR | 1 | R29C102[0][A] | camera/flow_bridge/event_payload_30_s0/CLK
14.846 | -0.280 | tSu | | 1 | R29C102[0][A] | camera/flow_bridge/event_payload_30_s0

Path Statistics:

Clock Skew | 0.004
Setup Relationship | 8.000
Logic Level | 4
Arrival Clock Path Delay | cell: 0.000, 0.000%; route: 3.287, 100.000%
Arrival Data Path Delay | cell: 1.549, 20.343%; route: 5.722, 75.137%; tC2Q: 0.344, 4.521%
Required Clock Path Delay | cell: 0.000, 0.000%; route: 3.291, 100.000%

### Path21

Path Summary:

Slack | 0.127
Data Arrival Time | 14.932
Data Required Time | 15.059
From | camera/runtime_network.net/retry_count2_1_s0
To | camera/runtime_network.net/retry_count2_12_s0
Launch Clk | eth125:[R]
Latch Clk | eth125:[R]

Data Arrival Path:

AT | DELAY | TYPE | RF | FANOUT | LOC | NODE
0.000 | 0.000 | | | | | active clock edge time
0.000 | 0.000 | | | | | eth125
3.835 | 3.835 | tCL | RR | 5898 | PLL_B[2] | camera/pll/PLL_inst/CLKOUT1
7.122 | 3.287 | tNET | RR | 1 | R81C96[0][A] | camera/runtime_network.net/retry_count2_1_s0/CLK
7.466 | 0.344 | tC2Q | RR | 3 | R81C96[0][A] | camera/runtime_network.net/retry_count2_1_s0/Q
7.607 | 0.141 | tNET | RR | 1 | R81C96[3][B] | camera/runtime_network.net/n15656_s7/I1
8.017 | 0.411 | tINS | RR | 1 | R81C96[3][B] | camera/runtime_network.net/n15656_s7/F
8.288 | 0.271 | tNET | RR | 1 | R83C96[2][B] | camera/runtime_network.net/n15653_s6/I1
8.799 | 0.511 | tINS | RR | 2 | R83C96[2][B] | camera/runtime_network.net/n15653_s6/F
8.992 | 0.192 | tNET | RR | 1 | R83C94[1][B] | camera/runtime_network.net/n15650_s7/I3
9.512 | 0.521 | tINS | RR | 3 | R83C94[1][B] | camera/runtime_network.net/n15650_s7/F
9.672 | 0.160 | tNET | RR | 1 | R84C94[0][A] | camera/runtime_network.net/n15641_s6/I3
10.193 | 0.521 | tINS | RR | 6 | R84C94[0][A] | camera/runtime_network.net/n15641_s6/F
10.545 | 0.352 | tNET | RR | 1 | R85C95[1][B] | camera/runtime_network.net/n15636_s7/I3
10.805 | 0.260 | tINS | RR | 3 | R85C95[1][B] | camera/runtime_network.net/n15636_s7/F
10.965 | 0.160 | tNET | RR | 1 | R84C95[3][B] | camera/runtime_network.net/n15632_s6/I1
11.481 | 0.516 | tINS | RR | 1 | R84C95[3][B] | camera/runtime_network.net/n15632_s6/F
11.671 | 0.190 | tNET | RR | 1 | R83C95[3][A] | camera/runtime_network.net/n15632_s5/I3
12.188 | 0.516 | tINS | RR | 4 | R83C95[3][A] | camera/runtime_network.net/n15632_s5/F
12.535 | 0.348 | tNET | RR | 1 | R85C96[1][B] | camera/runtime_network.net/n15627_s6/I3
12.795 | 0.260 | tINS | RR | 11 | R85C96[1][B] | camera/runtime_network.net/n15627_s6/F
13.159 | 0.363 | tNET | RR | 1 | R83C96[3][B] | camera/runtime_network.net/n15650_s6/I0
13.445 | 0.287 | tINS | RF | 9 | R83C96[3][B] | camera/runtime_network.net/n15650_s6/F
13.796 | 0.351 | tNET | FF | 1 | R84C94[1][A] | camera/runtime_network.net/n15646_s8/I3
14.317 | 0.521 | tINS | FR | 2 | R84C94[1][A] | camera/runtime_network.net/n15646_s8/F
14.475 | 0.157 | tNET | RR | 1 | R85C94[0][A] | camera/runtime_network.net/n15646_s4/I2
14.932 | 0.457 | tINS | RR | 1 | R85C94[0][A] | camera/runtime_network.net/n15646_s4/F
14.932 | 0.000 | tNET | RR | 1 | R85C94[0][A] | camera/runtime_network.net/retry_count2_12_s0/D

Data Required Path:

AT | DELAY | TYPE | RF | FANOUT | LOC | NODE
8.000 | 8.000 | | | | | active clock edge time
8.000 | 0.000 | | | | | eth125
11.835 | 3.835 | tCL | RR | 5898 | PLL_B[2] | camera/pll/PLL_inst/CLKOUT1
15.116 | 3.281 | tNET | RR | 1 | R85C94[0][A] | camera/runtime_network.net/retry_count2_12_s0/CLK
15.059 | -0.057 | tSu | | 1 | R85C94[0][A] | camera/runtime_network.net/retry_count2_12_s0

Path Statistics:

Clock Skew | -0.006
Setup Relationship | 8.000
Logic Level | 12
Arrival Clock Path Delay | cell: 0.000, 0.000%; route: 3.287, 100.000%
Arrival Data Path Delay | cell: 4.780, 61.207%; route: 2.685, 34.385%; tC2Q: 0.344, 4.408%
Required Clock Path Delay | cell: 0.000, 0.000%; route: 3.281, 100.000%

### Path22

Path Summary:

Slack | 0.127
Data Arrival Time | 14.932
Data Required Time | 15.059
From | camera/runtime_network.net/retry_count2_1_s0
To | camera/runtime_network.net/retry_count2_14_s0
Launch Clk | eth125:[R]
Latch Clk | eth125:[R]

Data Arrival Path:

AT | DELAY | TYPE | RF | FANOUT | LOC | NODE
0.000 | 0.000 | | | | | active clock edge time
0.000 | 0.000 | | | | | eth125
3.835 | 3.835 | tCL | RR | 5898 | PLL_B[2] | camera/pll/PLL_inst/CLKOUT1
7.122 | 3.287 | tNET | RR | 1 | R81C96[0][A] | camera/runtime_network.net/retry_count2_1_s0/CLK
7.466 | 0.344 | tC2Q | RR | 3 | R81C96[0][A] | camera/runtime_network.net/retry_count2_1_s0/Q
7.607 | 0.141 | tNET | RR | 1 | R81C96[3][B] | camera/runtime_network.net/n15656_s7/I1
8.017 | 0.411 | tINS | RR | 1 | R81C96[3][B] | camera/runtime_network.net/n15656_s7/F
8.288 | 0.271 | tNET | RR | 1 | R83C96[2][B] | camera/runtime_network.net/n15653_s6/I1
8.799 | 0.511 | tINS | RR | 2 | R83C96[2][B] | camera/runtime_network.net/n15653_s6/F
8.992 | 0.192 | tNET | RR | 1 | R83C94[1][B] | camera/runtime_network.net/n15650_s7/I3
9.512 | 0.521 | tINS | RR | 3 | R83C94[1][B] | camera/runtime_network.net/n15650_s7/F
9.672 | 0.160 | tNET | RR | 1 | R84C94[0][A] | camera/runtime_network.net/n15641_s6/I3
10.193 | 0.521 | tINS | RR | 6 | R84C94[0][A] | camera/runtime_network.net/n15641_s6/F
10.545 | 0.352 | tNET | RR | 1 | R85C95[1][B] | camera/runtime_network.net/n15636_s7/I3
10.805 | 0.260 | tINS | RR | 3 | R85C95[1][B] | camera/runtime_network.net/n15636_s7/F
10.965 | 0.160 | tNET | RR | 1 | R84C95[3][B] | camera/runtime_network.net/n15632_s6/I1
11.481 | 0.516 | tINS | RR | 1 | R84C95[3][B] | camera/runtime_network.net/n15632_s6/F
11.671 | 0.190 | tNET | RR | 1 | R83C95[3][A] | camera/runtime_network.net/n15632_s5/I3
12.188 | 0.516 | tINS | RR | 4 | R83C95[3][A] | camera/runtime_network.net/n15632_s5/F
12.535 | 0.348 | tNET | RR | 1 | R85C96[1][B] | camera/runtime_network.net/n15627_s6/I3
12.795 | 0.260 | tINS | RR | 11 | R85C96[1][B] | camera/runtime_network.net/n15627_s6/F
13.159 | 0.363 | tNET | RR | 1 | R83C96[3][B] | camera/runtime_network.net/n15650_s6/I0
13.445 | 0.287 | tINS | RF | 9 | R83C96[3][B] | camera/runtime_network.net/n15650_s6/F
13.796 | 0.351 | tNET | FF | 1 | R84C94[1][A] | camera/runtime_network.net/n15646_s8/I3
14.317 | 0.521 | tINS | FR | 2 | R84C94[1][A] | camera/runtime_network.net/n15646_s8/F
14.475 | 0.157 | tNET | RR | 1 | R85C94[0][B] | camera/runtime_network.net/n15644_s5/I1
14.932 | 0.457 | tINS | RR | 1 | R85C94[0][B] | camera/runtime_network.net/n15644_s5/F
14.932 | 0.000 | tNET | RR | 1 | R85C94[0][B] | camera/runtime_network.net/retry_count2_14_s0/D

Data Required Path:

AT | DELAY | TYPE | RF | FANOUT | LOC | NODE
8.000 | 8.000 | | | | | active clock edge time
8.000 | 0.000 | | | | | eth125
11.835 | 3.835 | tCL | RR | 5898 | PLL_B[2] | camera/pll/PLL_inst/CLKOUT1
15.116 | 3.281 | tNET | RR | 1 | R85C94[0][B] | camera/runtime_network.net/retry_count2_14_s0/CLK
15.059 | -0.057 | tSu | | 1 | R85C94[0][B] | camera/runtime_network.net/retry_count2_14_s0

Path Statistics:

Clock Skew | -0.006
Setup Relationship | 8.000
Logic Level | 12
Arrival Clock Path Delay | cell: 0.000, 0.000%; route: 3.287, 100.000%
Arrival Data Path Delay | cell: 4.780, 61.207%; route: 2.685, 34.385%; tC2Q: 0.344, 4.408%
Required Clock Path Delay | cell: 0.000, 0.000%; route: 3.281, 100.000%

### Path23

Path Summary:

Slack | 0.129
Data Arrival Time | 16.934
Data Required Time | 17.063
From | camera/tracker/job_fid_0_s4
To | camera/tracker/history_miss_s1
Launch Clk | cam_pclk:[R]
Latch Clk | cam_pclk:[R]

Data Arrival Path:

AT | DELAY | TYPE | RF | FANOUT | LOC | NODE
0.000 | 0.000 | | | | | active clock edge time
0.000 | 0.000 | | | | | cam_pclk
0.000 | 0.000 | tCL | RR | 1 | IOL2[A] | camera_pclk_ibuf/I
0.614 | 0.614 | tINS | RR | 8189 | IOL2[A] | camera_pclk_ibuf/O
5.467 | 4.853 | tNET | RR | 1 | R56C52[2][B] | camera/tracker/job_fid_0_s4/CLK
5.811 | 0.344 | tC2Q | RR | 32 | R56C52[2][B] | camera/tracker/job_fid_0_s4/Q
6.962 | 1.151 | tNET | RR | 1 | R60C56[3][A] | camera/tracker/previous_fid_1_s5/I1
7.478 | 0.516 | tINS | RR | 32 | R60C56[3][A] | camera/tracker/previous_fid_1_s5/F
8.402 | 0.924 | tNET | RR | 1 | R51C51[3][B] | camera/tracker/n3073_s45/I2
8.918 | 0.516 | tINS | RR | 1 | R51C51[3][B] | camera/tracker/n3073_s45/F
8.918 | 0.000 | tNET | RR | 1 | R51C51[3][A] | camera/tracker/n3073_s42/I1
9.053 | 0.135 | tINS | RR | 1 | R51C51[3][A] | camera/tracker/n3073_s42/O
9.053 | 0.000 | tNET | RR | 1 | R51C51[2][B] | camera/tracker/n3073_s41/I0
9.131 | 0.078 | tINS | RR | 2 | R51C51[2][B] | camera/tracker/n3073_s41/O
9.732 | 0.601 | tNET | RR | 1 | R63C51[3][A] | camera/tracker/point_index_3_s42/I0
10.248 | 0.516 | tINS | RR | 1 | R63C51[3][A] | camera/tracker/point_index_3_s42/F
10.250 | 0.002 | tNET | RR | 1 | R63C51[0][A] | camera/tracker/point_index_3_s33/I1
10.707 | 0.457 | tINS | RR | 1 | R63C51[0][A] | camera/tracker/point_index_3_s33/F
10.862 | 0.155 | tNET | RR | 1 | R62C51[1][A] | camera/tracker/point_index_3_s21/I2
11.373 | 0.511 | tINS | RR | 1 | R62C51[1][A] | camera/tracker/point_index_3_s21/F
11.528 | 0.155 | tNET | RR | 1 | R62C52[0][B] | camera/tracker/point_index_3_s12/I2
12.039 | 0.511 | tINS | RR | 1 | R62C52[0][B] | camera/tracker/point_index_3_s12/F
12.382 | 0.343 | tNET | RR | 1 | R63C54[3][B] | camera/tracker/point_index_3_s8/I3
12.644 | 0.262 | tINS | RR | 2 | R63C54[3][B] | camera/tracker/point_index_3_s8/F
13.070 | 0.425 | tNET | RR | 1 | R66C54[3][B] | camera/tracker/n6430_s5/I0
13.480 | 0.411 | tINS | RR | 1 | R66C54[3][B] | camera/tracker/n6430_s5/F
14.092 | 0.612 | tNET | RR | 1 | R66C62[2][A] | camera/tracker/n6430_s3/I3
14.603 | 0.511 | tINS | RR | 25 | R66C62[2][A] | camera/tracker/n6430_s3/F
15.707 | 1.104 | tNET | RR | 1 | R63C70[0][A] | camera/tracker/history_miss_s4/I3
16.217 | 0.511 | tINS | RR | 1 | R63C70[0][A] | camera/tracker/history_miss_s4/F
16.934 | 0.717 | tNET | RR | 1 | R65C65[3][A] | camera/tracker/history_miss_s1/CE

Data Required Path:

AT | DELAY | TYPE | RF | FANOUT | LOC | NODE
11.905 | 11.905 | | | | | active clock edge time
11.905 | 0.000 | | | | | cam_pclk
11.905 | 0.000 | tCL | RR | 1 | IOL2[A] | camera_pclk_ibuf/I
12.519 | 0.614 | tINS | RR | 8189 | IOL2[A] | camera_pclk_ibuf/O
17.343 | 4.824 | tNET | RR | 1 | R65C65[3][A] | camera/tracker/history_miss_s1/CLK
17.063 | -0.280 | tSu | | 1 | R65C65[3][A] | camera/tracker/history_miss_s1

Path Statistics:

Clock Skew | -0.029
Setup Relationship | 11.905
Logic Level | 11
Arrival Clock Path Delay | cell: 0.614, 11.236%; route: 4.853, 88.764%
Arrival Data Path Delay | cell: 4.934, 43.030%; route: 6.189, 53.968%; tC2Q: 0.344, 3.002%
Required Clock Path Delay | cell: 0.614, 11.295%; route: 4.824, 88.705%

### Path24

Path Summary:

Slack | 0.132
Data Arrival Time | 14.921
Data Required Time | 15.053
From | camera/runtime_network.net/retry_count2_1_s0
To | camera/runtime_network.net/retry_count2_18_s0
Launch Clk | eth125:[R]
Latch Clk | eth125:[R]

Data Arrival Path:

AT | DELAY | TYPE | RF | FANOUT | LOC | NODE
0.000 | 0.000 | | | | | active clock edge time
0.000 | 0.000 | | | | | eth125
3.835 | 3.835 | tCL | RR | 5898 | PLL_B[2] | camera/pll/PLL_inst/CLKOUT1
7.122 | 3.287 | tNET | RR | 1 | R81C96[0][A] | camera/runtime_network.net/retry_count2_1_s0/CLK
7.466 | 0.344 | tC2Q | RR | 3 | R81C96[0][A] | camera/runtime_network.net/retry_count2_1_s0/Q
7.607 | 0.141 | tNET | RR | 1 | R81C96[3][B] | camera/runtime_network.net/n15656_s7/I1
8.017 | 0.411 | tINS | RR | 1 | R81C96[3][B] | camera/runtime_network.net/n15656_s7/F
8.288 | 0.271 | tNET | RR | 1 | R83C96[2][B] | camera/runtime_network.net/n15653_s6/I1
8.799 | 0.511 | tINS | RR | 2 | R83C96[2][B] | camera/runtime_network.net/n15653_s6/F
8.992 | 0.192 | tNET | RR | 1 | R83C94[1][B] | camera/runtime_network.net/n15650_s7/I3
9.512 | 0.521 | tINS | RR | 3 | R83C94[1][B] | camera/runtime_network.net/n15650_s7/F
9.672 | 0.160 | tNET | RR | 1 | R84C94[0][A] | camera/runtime_network.net/n15641_s6/I3
10.193 | 0.521 | tINS | RR | 6 | R84C94[0][A] | camera/runtime_network.net/n15641_s6/F
10.545 | 0.352 | tNET | RR | 1 | R85C95[1][B] | camera/runtime_network.net/n15636_s7/I3
10.805 | 0.260 | tINS | RR | 3 | R85C95[1][B] | camera/runtime_network.net/n15636_s7/F
10.965 | 0.160 | tNET | RR | 1 | R84C95[3][B] | camera/runtime_network.net/n15632_s6/I1
11.481 | 0.516 | tINS | RR | 1 | R84C95[3][B] | camera/runtime_network.net/n15632_s6/F
11.671 | 0.190 | tNET | RR | 1 | R83C95[3][A] | camera/runtime_network.net/n15632_s5/I3
12.188 | 0.516 | tINS | RR | 4 | R83C95[3][A] | camera/runtime_network.net/n15632_s5/F
12.535 | 0.348 | tNET | RR | 1 | R85C96[1][B] | camera/runtime_network.net/n15627_s6/I3
12.795 | 0.260 | tINS | RR | 11 | R85C96[1][B] | camera/runtime_network.net/n15627_s6/F
13.241 | 0.446 | tNET | RR | 1 | R81C95[0][A] | camera/runtime_network.net/n4175_s1/I1
13.501 | 0.260 | tINS | RR | 3 | R81C95[0][A] | camera/runtime_network.net/n4175_s1/F
14.115 | 0.614 | tNET | RR | 1 | R84C94[3][B] | camera/runtime_network.net/n15640_s6/I0
14.525 | 0.411 | tINS | RR | 1 | R84C94[3][B] | camera/runtime_network.net/n15640_s6/F
14.662 | 0.136 | tNET | RR | 1 | R84C94[0][B] | camera/runtime_network.net/n15640_s4/I1
14.921 | 0.260 | tINS | RR | 1 | R84C94[0][B] | camera/runtime_network.net/n15640_s4/F
14.921 | 0.000 | tNET | RR | 1 | R84C94[0][B] | camera/runtime_network.net/retry_count2_18_s0/D

Data Required Path:

AT | DELAY | TYPE | RF | FANOUT | LOC | NODE
8.000 | 8.000 | | | | | active clock edge time
8.000 | 0.000 | | | | | eth125
11.835 | 3.835 | tCL | RR | 5898 | PLL_B[2] | camera/pll/PLL_inst/CLKOUT1
15.111 | 3.276 | tNET | RR | 1 | R84C94[0][B] | camera/runtime_network.net/retry_count2_18_s0/CLK
15.053 | -0.057 | tSu | | 1 | R84C94[0][B] | camera/runtime_network.net/retry_count2_18_s0

Path Statistics:

Clock Skew | -0.011
Setup Relationship | 8.000
Logic Level | 12
Arrival Clock Path Delay | cell: 0.000, 0.000%; route: 3.287, 100.000%
Arrival Data Path Delay | cell: 4.446, 57.003%; route: 3.009, 38.584%; tC2Q: 0.344, 4.414%
Required Clock Path Delay | cell: 0.000, 0.000%; route: 3.276, 100.000%

### Path25

Path Summary:

Slack | 0.147
Data Arrival Time | 14.725
Data Required Time | 14.872
From | camera/runtime_network.net/lookup2_valid_s0
To | camera/flow_bridge/vector_dirty_s1
Launch Clk | eth125:[R]
Latch Clk | eth125:[R]

Data Arrival Path:

AT | DELAY | TYPE | RF | FANOUT | LOC | NODE
0.000 | 0.000 | | | | | active clock edge time
0.000 | 0.000 | | | | | eth125
3.835 | 3.835 | tCL | RR | 5898 | PLL_B[2] | camera/pll/PLL_inst/CLKOUT1
7.122 | 3.287 | tNET | RR | 1 | R71C93[2][A] | camera/runtime_network.net/lookup2_valid_s0/CLK
7.466 | 0.344 | tC2Q | RR | 4 | R71C93[2][A] | camera/runtime_network.net/lookup2_valid_s0/Q
8.089 | 0.623 | tNET | RR | 1 | R70C90[3][B] | camera/runtime_network.status_211_s1/I2
8.606 | 0.516 | tINS | RR | 12 | R70C90[3][B] | camera/runtime_network.status_211_s1/F
9.823 | 1.217 | tNET | RR | 1 | R50C89[3][A] | camera/event_mux/available_s0/I1
10.339 | 0.516 | tINS | RR | 8 | R50C89[3][A] | camera/event_mux/available_s0/F
12.026 | 1.686 | tNET | RR | 1 | R27C94[0][B] | camera/flow_bridge/event_payload_255_s3/I0
12.482 | 0.457 | tINS | RR | 1 | R27C94[0][B] | camera/flow_bridge/event_payload_255_s3/F
12.806 | 0.324 | tNET | RR | 1 | R25C94[0][B] | camera/flow_bridge/n1210_s2/I2
13.327 | 0.521 | tINS | RR | 2 | R25C94[0][B] | camera/flow_bridge/n1210_s2/F
13.485 | 0.157 | tNET | RR | 1 | R25C94[1][B] | camera/flow_bridge/vector_dirty_s3/I1
14.006 | 0.521 | tINS | RR | 1 | R25C94[1][B] | camera/flow_bridge/vector_dirty_s3/F
14.725 | 0.719 | tNET | RR | 1 | R25C94[0][A] | camera/flow_bridge/vector_dirty_s1/CE

Data Required Path:

AT | DELAY | TYPE | RF | FANOUT | LOC | NODE
8.000 | 8.000 | | | | | active clock edge time
8.000 | 0.000 | | | | | eth125
11.835 | 3.835 | tCL | RR | 5898 | PLL_B[2] | camera/pll/PLL_inst/CLKOUT1
15.152 | 3.316 | tNET | RR | 1 | R25C94[0][A] | camera/flow_bridge/vector_dirty_s1/CLK
14.872 | -0.280 | tSu | | 1 | R25C94[0][A] | camera/flow_bridge/vector_dirty_s1

Path Statistics:

Clock Skew | 0.030
Setup Relationship | 8.000
Logic Level | 6
Arrival Clock Path Delay | cell: 0.000, 0.000%; route: 3.287, 100.000%
Arrival Data Path Delay | cell: 2.531, 33.294%; route: 4.727, 62.178%; tC2Q: 0.344, 4.528%
Required Clock Path Delay | cell: 0.000, 0.000%; route: 3.316, 100.000%

### Hold Analysis Report

#### Report Command:report_timing -hold -max_paths 25 -max_common_paths 1

### Path1

Path Summary:

Slack | 0.206
Data Arrival Time | 2.656
Data Required Time | 2.450
From | camera/flow_sensor/avoidance.safety/norm_0_s
To | camera/flow_sensor/avoidance.safety/norm_0_s0
Launch Clk | cam_pclk:[R]
Latch Clk | cam_pclk:[R]

Data Arrival Path:

AT | DELAY | TYPE | RF | FANOUT | LOC | NODE
0.000 | 0.000 | | | | | active clock edge time
0.000 | 0.000 | | | | | cam_pclk
0.000 | 0.000 | tCL | RR | 1 | IOL2[A] | camera_pclk_ibuf/I
0.608 | 0.608 | tINS | RR | 8189 | IOL2[A] | camera_pclk_ibuf/O
2.536 | 1.928 | tNET | RR | 48 | DSP_R37[26] | camera/flow_sensor/avoidance.safety/norm_0_s/CLK[0]
2.656 | 0.120 | tC2Q | RF | 1 | DSP_R37[26] | camera/flow_sensor/avoidance.safety/norm_0_s/CASO[23]
2.656 | 0.000 | tNET | FF | 1 | DSP_R37[27] | camera/flow_sensor/avoidance.safety/norm_0_s0/CASI[23]

Data Required Path:

AT | DELAY | TYPE | RF | FANOUT | LOC | NODE
0.000 | 0.000 | | | | | active clock edge time
0.000 | 0.000 | | | | | cam_pclk
0.000 | 0.000 | tCL | RR | 1 | IOL2[A] | camera_pclk_ibuf/I
0.608 | 0.608 | tINS | RR | 8189 | IOL2[A] | camera_pclk_ibuf/O
2.539 | 1.931 | tNET | RR | 1 | DSP_R37[27] | camera/flow_sensor/avoidance.safety/norm_0_s0/CLK[0]
2.450 | -0.089 | tHld | | 1 | DSP_R37[27] | camera/flow_sensor/avoidance.safety/norm_0_s0

Path Statistics:

Clock Skew | 0.004
Hold Relationship | 0.000
Logic Level | 1
Arrival Clock Path Delay | cell: 0.608, 23.975%; route: 1.928, 76.025%
Arrival Data Path Delay | cell: 0.000, 0.000%; route: 0.000, 0.000%; tC2Q: 0.120, 100.000%
Required Clock Path Delay | cell: 0.608, 23.941%; route: 1.931, 76.059%

### Path2

Path Summary:

Slack | 0.207
Data Arrival Time | 2.659
Data Required Time | 2.452
From | camera/flow_sensor/avoidance.safety/norm_0_s
To | camera/flow_sensor/avoidance.safety/norm_0_s0
Launch Clk | cam_pclk:[R]
Latch Clk | cam_pclk:[R]

Data Arrival Path:

AT | DELAY | TYPE | RF | FANOUT | LOC | NODE
0.000 | 0.000 | | | | | active clock edge time
0.000 | 0.000 | | | | | cam_pclk
0.000 | 0.000 | tCL | RR | 1 | IOL2[A] | camera_pclk_ibuf/I
0.608 | 0.608 | tINS | RR | 8189 | IOL2[A] | camera_pclk_ibuf/O
2.536 | 1.928 | tNET | RR | 48 | DSP_R37[26] | camera/flow_sensor/avoidance.safety/norm_0_s/CLK[0]
2.659 | 0.123 | tC2Q | RF | 1 | DSP_R37[26] | camera/flow_sensor/avoidance.safety/norm_0_s/CASO[10]
2.659 | 0.000 | tNET | FF | 1 | DSP_R37[27] | camera/flow_sensor/avoidance.safety/norm_0_s0/CASI[10]

Data Required Path:

AT | DELAY | TYPE | RF | FANOUT | LOC | NODE
0.000 | 0.000 | | | | | active clock edge time
0.000 | 0.000 | | | | | cam_pclk
0.000 | 0.000 | tCL | RR | 1 | IOL2[A] | camera_pclk_ibuf/I
0.608 | 0.608 | tINS | RR | 8189 | IOL2[A] | camera_pclk_ibuf/O
2.539 | 1.931 | tNET | RR | 1 | DSP_R37[27] | camera/flow_sensor/avoidance.safety/norm_0_s0/CLK[0]
2.452 | -0.087 | tHld | | 1 | DSP_R37[27] | camera/flow_sensor/avoidance.safety/norm_0_s0

Path Statistics:

Clock Skew | 0.004
Hold Relationship | 0.000
Logic Level | 1
Arrival Clock Path Delay | cell: 0.608, 23.975%; route: 1.928, 76.025%
Arrival Data Path Delay | cell: 0.000, 0.000%; route: 0.000, 0.000%; tC2Q: 0.123, 100.000%
Required Clock Path Delay | cell: 0.608, 23.941%; route: 1.931, 76.059%

### Path3

Path Summary:

Slack | 0.208
Data Arrival Time | 2.657
Data Required Time | 2.449
From | camera/flow_sensor/avoidance.safety/norm_0_s
To | camera/flow_sensor/avoidance.safety/norm_0_s0
Launch Clk | cam_pclk:[R]
Latch Clk | cam_pclk:[R]

Data Arrival Path:

AT | DELAY | TYPE | RF | FANOUT | LOC | NODE
0.000 | 0.000 | | | | | active clock edge time
0.000 | 0.000 | | | | | cam_pclk
0.000 | 0.000 | tCL | RR | 1 | IOL2[A] | camera_pclk_ibuf/I
0.608 | 0.608 | tINS | RR | 8189 | IOL2[A] | camera_pclk_ibuf/O
2.536 | 1.928 | tNET | RR | 48 | DSP_R37[26] | camera/flow_sensor/avoidance.safety/norm_0_s/CLK[0]
2.657 | 0.121 | tC2Q | RF | 1 | DSP_R37[26] | camera/flow_sensor/avoidance.safety/norm_0_s/CASO[25]
2.657 | 0.000 | tNET | FF | 1 | DSP_R37[27] | camera/flow_sensor/avoidance.safety/norm_0_s0/CASI[25]

Data Required Path:

AT | DELAY | TYPE | RF | FANOUT | LOC | NODE
0.000 | 0.000 | | | | | active clock edge time
0.000 | 0.000 | | | | | cam_pclk
0.000 | 0.000 | tCL | RR | 1 | IOL2[A] | camera_pclk_ibuf/I
0.608 | 0.608 | tINS | RR | 8189 | IOL2[A] | camera_pclk_ibuf/O
2.539 | 1.931 | tNET | RR | 1 | DSP_R37[27] | camera/flow_sensor/avoidance.safety/norm_0_s0/CLK[0]
2.449 | -0.090 | tHld | | 1 | DSP_R37[27] | camera/flow_sensor/avoidance.safety/norm_0_s0

Path Statistics:

Clock Skew | 0.004
Hold Relationship | 0.000
Logic Level | 1
Arrival Clock Path Delay | cell: 0.608, 23.975%; route: 1.928, 76.025%
Arrival Data Path Delay | cell: 0.000, 0.000%; route: 0.000, 0.000%; tC2Q: 0.121, 100.000%
Required Clock Path Delay | cell: 0.608, 23.941%; route: 1.931, 76.059%

### Path4

Path Summary:

Slack | 0.209
Data Arrival Time | 2.661
Data Required Time | 2.451
From | camera/flow_sensor/avoidance.safety/norm_0_s
To | camera/flow_sensor/avoidance.safety/norm_0_s0
Launch Clk | cam_pclk:[R]
Latch Clk | cam_pclk:[R]

Data Arrival Path:

AT | DELAY | TYPE | RF | FANOUT | LOC | NODE
0.000 | 0.000 | | | | | active clock edge time
0.000 | 0.000 | | | | | cam_pclk
0.000 | 0.000 | tCL | RR | 1 | IOL2[A] | camera_pclk_ibuf/I
0.608 | 0.608 | tINS | RR | 8189 | IOL2[A] | camera_pclk_ibuf/O
2.536 | 1.928 | tNET | RR | 48 | DSP_R37[26] | camera/flow_sensor/avoidance.safety/norm_0_s/CLK[0]
2.661 | 0.125 | tC2Q | RF | 1 | DSP_R37[26] | camera/flow_sensor/avoidance.safety/norm_0_s/CASO[1]
2.661 | 0.000 | tNET | FF | 1 | DSP_R37[27] | camera/flow_sensor/avoidance.safety/norm_0_s0/CASI[1]

Data Required Path:

AT | DELAY | TYPE | RF | FANOUT | LOC | NODE
0.000 | 0.000 | | | | | active clock edge time
0.000 | 0.000 | | | | | cam_pclk
0.000 | 0.000 | tCL | RR | 1 | IOL2[A] | camera_pclk_ibuf/I
0.608 | 0.608 | tINS | RR | 8189 | IOL2[A] | camera_pclk_ibuf/O
2.539 | 1.931 | tNET | RR | 1 | DSP_R37[27] | camera/flow_sensor/avoidance.safety/norm_0_s0/CLK[0]
2.451 | -0.088 | tHld | | 1 | DSP_R37[27] | camera/flow_sensor/avoidance.safety/norm_0_s0

Path Statistics:

Clock Skew | 0.004
Hold Relationship | 0.000
Logic Level | 1
Arrival Clock Path Delay | cell: 0.608, 23.975%; route: 1.928, 76.025%
Arrival Data Path Delay | cell: 0.000, 0.000%; route: 0.000, 0.000%; tC2Q: 0.125, 100.000%
Required Clock Path Delay | cell: 0.608, 23.941%; route: 1.931, 76.059%

### Path5

Path Summary:

Slack | 0.210
Data Arrival Time | 2.661
Data Required Time | 2.451
From | camera/flow_sensor/avoidance.safety/norm_0_s
To | camera/flow_sensor/avoidance.safety/norm_0_s0
Launch Clk | cam_pclk:[R]
Latch Clk | cam_pclk:[R]

Data Arrival Path:

AT | DELAY | TYPE | RF | FANOUT | LOC | NODE
0.000 | 0.000 | | | | | active clock edge time
0.000 | 0.000 | | | | | cam_pclk
0.000 | 0.000 | tCL | RR | 1 | IOL2[A] | camera_pclk_ibuf/I
0.608 | 0.608 | tINS | RR | 8189 | IOL2[A] | camera_pclk_ibuf/O
2.536 | 1.928 | tNET | RR | 48 | DSP_R37[26] | camera/flow_sensor/avoidance.safety/norm_0_s/CLK[0]
2.661 | 0.125 | tC2Q | RF | 1 | DSP_R37[26] | camera/flow_sensor/avoidance.safety/norm_0_s/CASO[2]
2.661 | 0.000 | tNET | FF | 1 | DSP_R37[27] | camera/flow_sensor/avoidance.safety/norm_0_s0/CASI[2]

Data Required Path:

AT | DELAY | TYPE | RF | FANOUT | LOC | NODE
0.000 | 0.000 | | | | | active clock edge time
0.000 | 0.000 | | | | | cam_pclk
0.000 | 0.000 | tCL | RR | 1 | IOL2[A] | camera_pclk_ibuf/I
0.608 | 0.608 | tINS | RR | 8189 | IOL2[A] | camera_pclk_ibuf/O
2.539 | 1.931 | tNET | RR | 1 | DSP_R37[27] | camera/flow_sensor/avoidance.safety/norm_0_s0/CLK[0]
2.451 | -0.089 | tHld | | 1 | DSP_R37[27] | camera/flow_sensor/avoidance.safety/norm_0_s0

Path Statistics:

Clock Skew | 0.004
Hold Relationship | 0.000
Logic Level | 1
Arrival Clock Path Delay | cell: 0.608, 23.975%; route: 1.928, 76.025%
Arrival Data Path Delay | cell: 0.000, 0.000%; route: 0.000, 0.000%; tC2Q: 0.125, 100.000%
Required Clock Path Delay | cell: 0.608, 23.941%; route: 1.931, 76.059%

### Path6

Path Summary:

Slack | 0.213
Data Arrival Time | 2.656
Data Required Time | 2.443
From | camera/flow_sensor/avoidance.safety/dot_0_s
To | camera/flow_sensor/avoidance.safety/dot_0_s0
Launch Clk | cam_pclk:[R]
Latch Clk | cam_pclk:[R]

Data Arrival Path:

AT | DELAY | TYPE | RF | FANOUT | LOC | NODE
0.000 | 0.000 | | | | | active clock edge time
0.000 | 0.000 | | | | | cam_pclk
0.000 | 0.000 | tCL | RR | 1 | IOL2[A] | camera_pclk_ibuf/I
0.608 | 0.608 | tINS | RR | 8189 | IOL2[A] | camera_pclk_ibuf/O
2.536 | 1.928 | tNET | RR | 48 | DSP_R37[24] | camera/flow_sensor/avoidance.safety/dot_0_s/CLK[0]
2.656 | 0.120 | tC2Q | RF | 1 | DSP_R37[24] | camera/flow_sensor/avoidance.safety/dot_0_s/CASO[23]
2.656 | 0.000 | tNET | FF | 1 | DSP_R37[25] | camera/flow_sensor/avoidance.safety/dot_0_s0/CASI[23]

Data Required Path:

AT | DELAY | TYPE | RF | FANOUT | LOC | NODE
0.000 | 0.000 | | | | | active clock edge time
0.000 | 0.000 | | | | | cam_pclk
0.000 | 0.000 | tCL | RR | 1 | IOL2[A] | camera_pclk_ibuf/I
0.608 | 0.608 | tINS | RR | 8189 | IOL2[A] | camera_pclk_ibuf/O
2.532 | 1.924 | tNET | RR | 1 | DSP_R37[25] | camera/flow_sensor/avoidance.safety/dot_0_s0/CLK[0]
2.443 | -0.089 | tHld | | 1 | DSP_R37[25] | camera/flow_sensor/avoidance.safety/dot_0_s0

Path Statistics:

Clock Skew | -0.004
Hold Relationship | 0.000
Logic Level | 1
Arrival Clock Path Delay | cell: 0.608, 23.975%; route: 1.928, 76.025%
Arrival Data Path Delay | cell: 0.000, 0.000%; route: 0.000, 0.000%; tC2Q: 0.120, 100.000%
Required Clock Path Delay | cell: 0.608, 24.009%; route: 1.924, 75.991%

### Path7

Path Summary:

Slack | 0.214
Data Arrival Time | 2.659
Data Required Time | 2.445
From | camera/flow_sensor/avoidance.safety/dot_0_s
To | camera/flow_sensor/avoidance.safety/dot_0_s0
Launch Clk | cam_pclk:[R]
Latch Clk | cam_pclk:[R]

Data Arrival Path:

AT | DELAY | TYPE | RF | FANOUT | LOC | NODE
0.000 | 0.000 | | | | | active clock edge time
0.000 | 0.000 | | | | | cam_pclk
0.000 | 0.000 | tCL | RR | 1 | IOL2[A] | camera_pclk_ibuf/I
0.608 | 0.608 | tINS | RR | 8189 | IOL2[A] | camera_pclk_ibuf/O
2.536 | 1.928 | tNET | RR | 48 | DSP_R37[24] | camera/flow_sensor/avoidance.safety/dot_0_s/CLK[0]
2.659 | 0.123 | tC2Q | RF | 1 | DSP_R37[24] | camera/flow_sensor/avoidance.safety/dot_0_s/CASO[10]
2.659 | 0.000 | tNET | FF | 1 | DSP_R37[25] | camera/flow_sensor/avoidance.safety/dot_0_s0/CASI[10]

Data Required Path:

AT | DELAY | TYPE | RF | FANOUT | LOC | NODE
0.000 | 0.000 | | | | | active clock edge time
0.000 | 0.000 | | | | | cam_pclk
0.000 | 0.000 | tCL | RR | 1 | IOL2[A] | camera_pclk_ibuf/I
0.608 | 0.608 | tINS | RR | 8189 | IOL2[A] | camera_pclk_ibuf/O
2.532 | 1.924 | tNET | RR | 1 | DSP_R37[25] | camera/flow_sensor/avoidance.safety/dot_0_s0/CLK[0]
2.445 | -0.087 | tHld | | 1 | DSP_R37[25] | camera/flow_sensor/avoidance.safety/dot_0_s0

Path Statistics:

Clock Skew | -0.004
Hold Relationship | 0.000
Logic Level | 1
Arrival Clock Path Delay | cell: 0.608, 23.975%; route: 1.928, 76.025%
Arrival Data Path Delay | cell: 0.000, 0.000%; route: 0.000, 0.000%; tC2Q: 0.123, 100.000%
Required Clock Path Delay | cell: 0.608, 24.009%; route: 1.924, 75.991%

### Path8

Path Summary:

Slack | 0.214
Data Arrival Time | 2.661
Data Required Time | 2.447
From | camera/flow_sensor/avoidance.safety/norm_0_s
To | camera/flow_sensor/avoidance.safety/norm_0_s0
Launch Clk | cam_pclk:[R]
Latch Clk | cam_pclk:[R]

Data Arrival Path:

AT | DELAY | TYPE | RF | FANOUT | LOC | NODE
0.000 | 0.000 | | | | | active clock edge time
0.000 | 0.000 | | | | | cam_pclk
0.000 | 0.000 | tCL | RR | 1 | IOL2[A] | camera_pclk_ibuf/I
0.608 | 0.608 | tINS | RR | 8189 | IOL2[A] | camera_pclk_ibuf/O
2.536 | 1.928 | tNET | RR | 48 | DSP_R37[26] | camera/flow_sensor/avoidance.safety/norm_0_s/CLK[0]
2.661 | 0.126 | tC2Q | RF | 1 | DSP_R37[26] | camera/flow_sensor/avoidance.safety/norm_0_s/CASO[12]
2.661 | 0.000 | tNET | FF | 1 | DSP_R37[27] | camera/flow_sensor/avoidance.safety/norm_0_s0/CASI[12]

Data Required Path:

AT | DELAY | TYPE | RF | FANOUT | LOC | NODE
0.000 | 0.000 | | | | | active clock edge time
0.000 | 0.000 | | | | | cam_pclk
0.000 | 0.000 | tCL | RR | 1 | IOL2[A] | camera_pclk_ibuf/I
0.608 | 0.608 | tINS | RR | 8189 | IOL2[A] | camera_pclk_ibuf/O
2.539 | 1.931 | tNET | RR | 1 | DSP_R37[27] | camera/flow_sensor/avoidance.safety/norm_0_s0/CLK[0]
2.447 | -0.092 | tHld | | 1 | DSP_R37[27] | camera/flow_sensor/avoidance.safety/norm_0_s0

Path Statistics:

Clock Skew | 0.004
Hold Relationship | 0.000
Logic Level | 1
Arrival Clock Path Delay | cell: 0.608, 23.975%; route: 1.928, 76.025%
Arrival Data Path Delay | cell: 0.000, 0.000%; route: 0.000, 0.000%; tC2Q: 0.126, 100.000%
Required Clock Path Delay | cell: 0.608, 23.941%; route: 1.931, 76.059%

### Path9

Path Summary:

Slack | 0.215
Data Arrival Time | 2.657
Data Required Time | 2.442
From | camera/flow_sensor/avoidance.safety/norm_0_s
To | camera/flow_sensor/avoidance.safety/norm_0_s0
Launch Clk | cam_pclk:[R]
Latch Clk | cam_pclk:[R]

Data Arrival Path:

AT | DELAY | TYPE | RF | FANOUT | LOC | NODE
0.000 | 0.000 | | | | | active clock edge time
0.000 | 0.000 | | | | | cam_pclk
0.000 | 0.000 | tCL | RR | 1 | IOL2[A] | camera_pclk_ibuf/I
0.608 | 0.608 | tINS | RR | 8189 | IOL2[A] | camera_pclk_ibuf/O
2.536 | 1.928 | tNET | RR | 48 | DSP_R37[26] | camera/flow_sensor/avoidance.safety/norm_0_s/CLK[0]
2.657 | 0.121 | tC2Q | RF | 1 | DSP_R37[26] | camera/flow_sensor/avoidance.safety/norm_0_s/CASO[27]
2.657 | 0.000 | tNET | FF | 1 | DSP_R37[27] | camera/flow_sensor/avoidance.safety/norm_0_s0/CASI[27]

Data Required Path:

AT | DELAY | TYPE | RF | FANOUT | LOC | NODE
0.000 | 0.000 | | | | | active clock edge time
0.000 | 0.000 | | | | | cam_pclk
0.000 | 0.000 | tCL | RR | 1 | IOL2[A] | camera_pclk_ibuf/I
0.608 | 0.608 | tINS | RR | 8189 | IOL2[A] | camera_pclk_ibuf/O
2.539 | 1.931 | tNET | RR | 1 | DSP_R37[27] | camera/flow_sensor/avoidance.safety/norm_0_s0/CLK[0]
2.442 | -0.097 | tHld | | 1 | DSP_R37[27] | camera/flow_sensor/avoidance.safety/norm_0_s0

Path Statistics:

Clock Skew | 0.004
Hold Relationship | 0.000
Logic Level | 1
Arrival Clock Path Delay | cell: 0.608, 23.975%; route: 1.928, 76.025%
Arrival Data Path Delay | cell: 0.000, 0.000%; route: 0.000, 0.000%; tC2Q: 0.121, 100.000%
Required Clock Path Delay | cell: 0.608, 23.941%; route: 1.931, 76.059%

### Path10

Path Summary:

Slack | 0.215
Data Arrival Time | 2.657
Data Required Time | 2.442
From | camera/flow_sensor/avoidance.safety/dot_0_s
To | camera/flow_sensor/avoidance.safety/dot_0_s0
Launch Clk | cam_pclk:[R]
Latch Clk | cam_pclk:[R]

Data Arrival Path:

AT | DELAY | TYPE | RF | FANOUT | LOC | NODE
0.000 | 0.000 | | | | | active clock edge time
0.000 | 0.000 | | | | | cam_pclk
0.000 | 0.000 | tCL | RR | 1 | IOL2[A] | camera_pclk_ibuf/I
0.608 | 0.608 | tINS | RR | 8189 | IOL2[A] | camera_pclk_ibuf/O
2.536 | 1.928 | tNET | RR | 48 | DSP_R37[24] | camera/flow_sensor/avoidance.safety/dot_0_s/CLK[0]
2.657 | 0.121 | tC2Q | RF | 1 | DSP_R37[24] | camera/flow_sensor/avoidance.safety/dot_0_s/CASO[25]
2.657 | 0.000 | tNET | FF | 1 | DSP_R37[25] | camera/flow_sensor/avoidance.safety/dot_0_s0/CASI[25]

Data Required Path:

AT | DELAY | TYPE | RF | FANOUT | LOC | NODE
0.000 | 0.000 | | | | | active clock edge time
0.000 | 0.000 | | | | | cam_pclk
0.000 | 0.000 | tCL | RR | 1 | IOL2[A] | camera_pclk_ibuf/I
0.608 | 0.608 | tINS | RR | 8189 | IOL2[A] | camera_pclk_ibuf/O
2.532 | 1.924 | tNET | RR | 1 | DSP_R37[25] | camera/flow_sensor/avoidance.safety/dot_0_s0/CLK[0]
2.442 | -0.090 | tHld | | 1 | DSP_R37[25] | camera/flow_sensor/avoidance.safety/dot_0_s0

Path Statistics:

Clock Skew | -0.004
Hold Relationship | 0.000
Logic Level | 1
Arrival Clock Path Delay | cell: 0.608, 23.975%; route: 1.928, 76.025%
Arrival Data Path Delay | cell: 0.000, 0.000%; route: 0.000, 0.000%; tC2Q: 0.121, 100.000%
Required Clock Path Delay | cell: 0.608, 24.009%; route: 1.924, 75.991%

### Path11

Path Summary:

Slack | 0.216
Data Arrival Time | 2.661
Data Required Time | 2.444
From | camera/flow_sensor/avoidance.safety/dot_0_s
To | camera/flow_sensor/avoidance.safety/dot_0_s0
Launch Clk | cam_pclk:[R]
Latch Clk | cam_pclk:[R]

Data Arrival Path:

AT | DELAY | TYPE | RF | FANOUT | LOC | NODE
0.000 | 0.000 | | | | | active clock edge time
0.000 | 0.000 | | | | | cam_pclk
0.000 | 0.000 | tCL | RR | 1 | IOL2[A] | camera_pclk_ibuf/I
0.608 | 0.608 | tINS | RR | 8189 | IOL2[A] | camera_pclk_ibuf/O
2.536 | 1.928 | tNET | RR | 48 | DSP_R37[24] | camera/flow_sensor/avoidance.safety/dot_0_s/CLK[0]
2.661 | 0.125 | tC2Q | RF | 1 | DSP_R37[24] | camera/flow_sensor/avoidance.safety/dot_0_s/CASO[1]
2.661 | 0.000 | tNET | FF | 1 | DSP_R37[25] | camera/flow_sensor/avoidance.safety/dot_0_s0/CASI[1]

Data Required Path:

AT | DELAY | TYPE | RF | FANOUT | LOC | NODE
0.000 | 0.000 | | | | | active clock edge time
0.000 | 0.000 | | | | | cam_pclk
0.000 | 0.000 | tCL | RR | 1 | IOL2[A] | camera_pclk_ibuf/I
0.608 | 0.608 | tINS | RR | 8189 | IOL2[A] | camera_pclk_ibuf/O
2.532 | 1.924 | tNET | RR | 1 | DSP_R37[25] | camera/flow_sensor/avoidance.safety/dot_0_s0/CLK[0]
2.444 | -0.088 | tHld | | 1 | DSP_R37[25] | camera/flow_sensor/avoidance.safety/dot_0_s0

Path Statistics:

Clock Skew | -0.004
Hold Relationship | 0.000
Logic Level | 1
Arrival Clock Path Delay | cell: 0.608, 23.975%; route: 1.928, 76.025%
Arrival Data Path Delay | cell: 0.000, 0.000%; route: 0.000, 0.000%; tC2Q: 0.125, 100.000%
Required Clock Path Delay | cell: 0.608, 24.009%; route: 1.924, 75.991%

### Path12

Path Summary:

Slack | 0.217
Data Arrival Time | 2.661
Data Required Time | 2.444
From | camera/flow_sensor/avoidance.safety/norm_0_s
To | camera/flow_sensor/avoidance.safety/norm_0_s0
Launch Clk | cam_pclk:[R]
Latch Clk | cam_pclk:[R]

Data Arrival Path:

AT | DELAY | TYPE | RF | FANOUT | LOC | NODE
0.000 | 0.000 | | | | | active clock edge time
0.000 | 0.000 | | | | | cam_pclk
0.000 | 0.000 | tCL | RR | 1 | IOL2[A] | camera_pclk_ibuf/I
0.608 | 0.608 | tINS | RR | 8189 | IOL2[A] | camera_pclk_ibuf/O
2.536 | 1.928 | tNET | RR | 48 | DSP_R37[26] | camera/flow_sensor/avoidance.safety/norm_0_s/CLK[0]
2.661 | 0.125 | tC2Q | RF | 1 | DSP_R37[26] | camera/flow_sensor/avoidance.safety/norm_0_s/CASO[22]
2.661 | 0.000 | tNET | FF | 1 | DSP_R37[27] | camera/flow_sensor/avoidance.safety/norm_0_s0/CASI[22]

Data Required Path:

AT | DELAY | TYPE | RF | FANOUT | LOC | NODE
0.000 | 0.000 | | | | | active clock edge time
0.000 | 0.000 | | | | | cam_pclk
0.000 | 0.000 | tCL | RR | 1 | IOL2[A] | camera_pclk_ibuf/I
0.608 | 0.608 | tINS | RR | 8189 | IOL2[A] | camera_pclk_ibuf/O
2.539 | 1.931 | tNET | RR | 1 | DSP_R37[27] | camera/flow_sensor/avoidance.safety/norm_0_s0/CLK[0]
2.444 | -0.096 | tHld | | 1 | DSP_R37[27] | camera/flow_sensor/avoidance.safety/norm_0_s0

Path Statistics:

Clock Skew | 0.004
Hold Relationship | 0.000
Logic Level | 1
Arrival Clock Path Delay | cell: 0.608, 23.975%; route: 1.928, 76.025%
Arrival Data Path Delay | cell: 0.000, 0.000%; route: 0.000, 0.000%; tC2Q: 0.125, 100.000%
Required Clock Path Delay | cell: 0.608, 23.941%; route: 1.931, 76.059%

### Path13

Path Summary:

Slack | 0.217
Data Arrival Time | 2.661
Data Required Time | 2.443
From | camera/flow_sensor/avoidance.safety/dot_0_s
To | camera/flow_sensor/avoidance.safety/dot_0_s0
Launch Clk | cam_pclk:[R]
Latch Clk | cam_pclk:[R]

Data Arrival Path:

AT | DELAY | TYPE | RF | FANOUT | LOC | NODE
0.000 | 0.000 | | | | | active clock edge time
0.000 | 0.000 | | | | | cam_pclk
0.000 | 0.000 | tCL | RR | 1 | IOL2[A] | camera_pclk_ibuf/I
0.608 | 0.608 | tINS | RR | 8189 | IOL2[A] | camera_pclk_ibuf/O
2.536 | 1.928 | tNET | RR | 48 | DSP_R37[24] | camera/flow_sensor/avoidance.safety/dot_0_s/CLK[0]
2.661 | 0.125 | tC2Q | RF | 1 | DSP_R37[24] | camera/flow_sensor/avoidance.safety/dot_0_s/CASO[2]
2.661 | 0.000 | tNET | FF | 1 | DSP_R37[25] | camera/flow_sensor/avoidance.safety/dot_0_s0/CASI[2]

Data Required Path:

AT | DELAY | TYPE | RF | FANOUT | LOC | NODE
0.000 | 0.000 | | | | | active clock edge time
0.000 | 0.000 | | | | | cam_pclk
0.000 | 0.000 | tCL | RR | 1 | IOL2[A] | camera_pclk_ibuf/I
0.608 | 0.608 | tINS | RR | 8189 | IOL2[A] | camera_pclk_ibuf/O
2.532 | 1.924 | tNET | RR | 1 | DSP_R37[25] | camera/flow_sensor/avoidance.safety/dot_0_s0/CLK[0]
2.443 | -0.089 | tHld | | 1 | DSP_R37[25] | camera/flow_sensor/avoidance.safety/dot_0_s0

Path Statistics:

Clock Skew | -0.004
Hold Relationship | 0.000
Logic Level | 1
Arrival Clock Path Delay | cell: 0.608, 23.975%; route: 1.928, 76.025%
Arrival Data Path Delay | cell: 0.000, 0.000%; route: 0.000, 0.000%; tC2Q: 0.125, 100.000%
Required Clock Path Delay | cell: 0.608, 24.009%; route: 1.924, 75.991%

### Path14

Path Summary:

Slack | 0.220
Data Arrival Time | 2.773
Data Required Time | 2.554
From | camera/grid/feature_address_0_s0
To | camera/tracker/memory_memory_0_4_s
Launch Clk | cam_pclk:[R]
Latch Clk | cam_pclk:[R]

Data Arrival Path:

AT | DELAY | TYPE | RF | FANOUT | LOC | NODE
0.000 | 0.000 | | | | | active clock edge time
0.000 | 0.000 | | | | | cam_pclk
0.000 | 0.000 | tCL | RR | 1 | IOL2[A] | camera_pclk_ibuf/I
0.608 | 0.608 | tINS | RR | 8189 | IOL2[A] | camera_pclk_ibuf/O
2.511 | 1.903 | tNET | RR | 1 | R84C33[0][A] | camera/grid/feature_address_0_s0/CLK
2.641 | 0.130 | tC2Q | RR | 26 | R84C33[0][A] | camera/grid/feature_address_0_s0/Q
2.773 | 0.132 | tNET | RR | 1 | BSRAM_R82[6][A] | camera/tracker/memory_memory_0_4_s/ADA[0]

Data Required Path:

AT | DELAY | TYPE | RF | FANOUT | LOC | NODE
0.000 | 0.000 | | | | | active clock edge time
0.000 | 0.000 | | | | | cam_pclk
0.000 | 0.000 | tCL | RR | 1 | IOL2[A] | camera_pclk_ibuf/I
0.608 | 0.608 | tINS | RR | 8189 | IOL2[A] | camera_pclk_ibuf/O
2.520 | 1.913 | tNET | RR | 1 | BSRAM_R82[6][A] | camera/tracker/memory_memory_0_4_s/CLKA
2.554 | 0.033 | tHld | | 1 | BSRAM_R82[6][A] | camera/tracker/memory_memory_0_4_s

Path Statistics:

Clock Skew | 0.009
Hold Relationship | 0.000
Logic Level | 1
Arrival Clock Path Delay | cell: 0.608, 24.207%; route: 1.903, 75.793%
Arrival Data Path Delay | cell: 0.000, 0.000%; route: 0.132, 50.515%; tC2Q: 0.130, 49.485%
Required Clock Path Delay | cell: 0.608, 24.121%; route: 1.913, 75.879%

### Path15

Path Summary:

Slack | 0.220
Data Arrival Time | 2.661
Data Required Time | 2.441
From | camera/flow_sensor/avoidance.safety/norm_0_s
To | camera/flow_sensor/avoidance.safety/norm_0_s0
Launch Clk | cam_pclk:[R]
Latch Clk | cam_pclk:[R]

Data Arrival Path:

AT | DELAY | TYPE | RF | FANOUT | LOC | NODE
0.000 | 0.000 | | | | | active clock edge time
0.000 | 0.000 | | | | | cam_pclk
0.000 | 0.000 | tCL | RR | 1 | IOL2[A] | camera_pclk_ibuf/I
0.608 | 0.608 | tINS | RR | 8189 | IOL2[A] | camera_pclk_ibuf/O
2.536 | 1.928 | tNET | RR | 48 | DSP_R37[26] | camera/flow_sensor/avoidance.safety/norm_0_s/CLK[0]
2.661 | 0.125 | tC2Q | RF | 1 | DSP_R37[26] | camera/flow_sensor/avoidance.safety/norm_0_s/CASO[21]
2.661 | 0.000 | tNET | FF | 1 | DSP_R37[27] | camera/flow_sensor/avoidance.safety/norm_0_s0/CASI[21]

Data Required Path:

AT | DELAY | TYPE | RF | FANOUT | LOC | NODE
0.000 | 0.000 | | | | | active clock edge time
0.000 | 0.000 | | | | | cam_pclk
0.000 | 0.000 | tCL | RR | 1 | IOL2[A] | camera_pclk_ibuf/I
0.608 | 0.608 | tINS | RR | 8189 | IOL2[A] | camera_pclk_ibuf/O
2.539 | 1.931 | tNET | RR | 1 | DSP_R37[27] | camera/flow_sensor/avoidance.safety/norm_0_s0/CLK[0]
2.441 | -0.098 | tHld | | 1 | DSP_R37[27] | camera/flow_sensor/avoidance.safety/norm_0_s0

Path Statistics:

Clock Skew | 0.004
Hold Relationship | 0.000
Logic Level | 1
Arrival Clock Path Delay | cell: 0.608, 23.975%; route: 1.928, 76.025%
Arrival Data Path Delay | cell: 0.000, 0.000%; route: 0.000, 0.000%; tC2Q: 0.125, 100.000%
Required Clock Path Delay | cell: 0.608, 23.941%; route: 1.931, 76.059%

### Path16

Path Summary:

Slack | 0.220
Data Arrival Time | 2.660
Data Required Time | 2.440
From | camera/flow_sensor/avoidance.safety/norm_0_s
To | camera/flow_sensor/avoidance.safety/norm_0_s0
Launch Clk | cam_pclk:[R]
Latch Clk | cam_pclk:[R]

Data Arrival Path:

AT | DELAY | TYPE | RF | FANOUT | LOC | NODE
0.000 | 0.000 | | | | | active clock edge time
0.000 | 0.000 | | | | | cam_pclk
0.000 | 0.000 | tCL | RR | 1 | IOL2[A] | camera_pclk_ibuf/I
0.608 | 0.608 | tINS | RR | 8189 | IOL2[A] | camera_pclk_ibuf/O
2.536 | 1.928 | tNET | RR | 48 | DSP_R37[26] | camera/flow_sensor/avoidance.safety/norm_0_s/CLK[0]
2.660 | 0.125 | tC2Q | RF | 1 | DSP_R37[26] | camera/flow_sensor/avoidance.safety/norm_0_s/CASO[11]
2.660 | 0.000 | tNET | FF | 1 | DSP_R37[27] | camera/flow_sensor/avoidance.safety/norm_0_s0/CASI[11]

Data Required Path:

AT | DELAY | TYPE | RF | FANOUT | LOC | NODE
0.000 | 0.000 | | | | | active clock edge time
0.000 | 0.000 | | | | | cam_pclk
0.000 | 0.000 | tCL | RR | 1 | IOL2[A] | camera_pclk_ibuf/I
0.608 | 0.608 | tINS | RR | 8189 | IOL2[A] | camera_pclk_ibuf/O
2.539 | 1.931 | tNET | RR | 1 | DSP_R37[27] | camera/flow_sensor/avoidance.safety/norm_0_s0/CLK[0]
2.440 | -0.099 | tHld | | 1 | DSP_R37[27] | camera/flow_sensor/avoidance.safety/norm_0_s0

Path Statistics:

Clock Skew | 0.004
Hold Relationship | 0.000
Logic Level | 1
Arrival Clock Path Delay | cell: 0.608, 23.975%; route: 1.928, 76.025%
Arrival Data Path Delay | cell: 0.000, 0.000%; route: 0.000, 0.000%; tC2Q: 0.125, 100.000%
Required Clock Path Delay | cell: 0.608, 23.941%; route: 1.931, 76.059%

### Path17

Path Summary:

Slack | 0.221
Data Arrival Time | 2.665
Data Required Time | 2.445
From | camera/flow_sensor/avoidance.safety/norm_0_s
To | camera/flow_sensor/avoidance.safety/norm_0_s0
Launch Clk | cam_pclk:[R]
Latch Clk | cam_pclk:[R]

Data Arrival Path:

AT | DELAY | TYPE | RF | FANOUT | LOC | NODE
0.000 | 0.000 | | | | | active clock edge time
0.000 | 0.000 | | | | | cam_pclk
0.000 | 0.000 | tCL | RR | 1 | IOL2[A] | camera_pclk_ibuf/I
0.608 | 0.608 | tINS | RR | 8189 | IOL2[A] | camera_pclk_ibuf/O
2.536 | 1.928 | tNET | RR | 48 | DSP_R37[26] | camera/flow_sensor/avoidance.safety/norm_0_s/CLK[0]
2.665 | 0.130 | tC2Q | RF | 1 | DSP_R37[26] | camera/flow_sensor/avoidance.safety/norm_0_s/CASO[0]
2.665 | 0.000 | tNET | FF | 1 | DSP_R37[27] | camera/flow_sensor/avoidance.safety/norm_0_s0/CASI[0]

Data Required Path:

AT | DELAY | TYPE | RF | FANOUT | LOC | NODE
0.000 | 0.000 | | | | | active clock edge time
0.000 | 0.000 | | | | | cam_pclk
0.000 | 0.000 | tCL | RR | 1 | IOL2[A] | camera_pclk_ibuf/I
0.608 | 0.608 | tINS | RR | 8189 | IOL2[A] | camera_pclk_ibuf/O
2.539 | 1.931 | tNET | RR | 1 | DSP_R37[27] | camera/flow_sensor/avoidance.safety/norm_0_s0/CLK[0]
2.445 | -0.094 | tHld | | 1 | DSP_R37[27] | camera/flow_sensor/avoidance.safety/norm_0_s0

Path Statistics:

Clock Skew | 0.004
Hold Relationship | 0.000
Logic Level | 1
Arrival Clock Path Delay | cell: 0.608, 23.975%; route: 1.928, 76.025%
Arrival Data Path Delay | cell: 0.000, 0.000%; route: 0.000, 0.000%; tC2Q: 0.130, 100.000%
Required Clock Path Delay | cell: 0.608, 23.941%; route: 1.931, 76.059%

### Path18

Path Summary:

Slack | 0.221
Data Arrival Time | 2.658
Data Required Time | 2.437
From | camera/flow_sensor/avoidance.safety/norm_0_s
To | camera/flow_sensor/avoidance.safety/norm_0_s0
Launch Clk | cam_pclk:[R]
Latch Clk | cam_pclk:[R]

Data Arrival Path:

AT | DELAY | TYPE | RF | FANOUT | LOC | NODE
0.000 | 0.000 | | | | | active clock edge time
0.000 | 0.000 | | | | | cam_pclk
0.000 | 0.000 | tCL | RR | 1 | IOL2[A] | camera_pclk_ibuf/I
0.608 | 0.608 | tINS | RR | 8189 | IOL2[A] | camera_pclk_ibuf/O
2.536 | 1.928 | tNET | RR | 48 | DSP_R37[26] | camera/flow_sensor/avoidance.safety/norm_0_s/CLK[0]
2.658 | 0.122 | tC2Q | RF | 1 | DSP_R37[26] | camera/flow_sensor/avoidance.safety/norm_0_s/CASO[24]
2.658 | 0.000 | tNET | FF | 1 | DSP_R37[27] | camera/flow_sensor/avoidance.safety/norm_0_s0/CASI[24]

Data Required Path:

AT | DELAY | TYPE | RF | FANOUT | LOC | NODE
0.000 | 0.000 | | | | | active clock edge time
0.000 | 0.000 | | | | | cam_pclk
0.000 | 0.000 | tCL | RR | 1 | IOL2[A] | camera_pclk_ibuf/I
0.608 | 0.608 | tINS | RR | 8189 | IOL2[A] | camera_pclk_ibuf/O
2.539 | 1.931 | tNET | RR | 1 | DSP_R37[27] | camera/flow_sensor/avoidance.safety/norm_0_s0/CLK[0]
2.437 | -0.103 | tHld | | 1 | DSP_R37[27] | camera/flow_sensor/avoidance.safety/norm_0_s0

Path Statistics:

Clock Skew | 0.004
Hold Relationship | 0.000
Logic Level | 1
Arrival Clock Path Delay | cell: 0.608, 23.975%; route: 1.928, 76.025%
Arrival Data Path Delay | cell: 0.000, 0.000%; route: 0.000, 0.000%; tC2Q: 0.122, 100.000%
Required Clock Path Delay | cell: 0.608, 23.941%; route: 1.931, 76.059%

### Path19

Path Summary:

Slack | 0.221
Data Arrival Time | 2.661
Data Required Time | 2.440
From | camera/flow_sensor/avoidance.safety/dot_0_s
To | camera/flow_sensor/avoidance.safety/dot_0_s0
Launch Clk | cam_pclk:[R]
Latch Clk | cam_pclk:[R]

Data Arrival Path:

AT | DELAY | TYPE | RF | FANOUT | LOC | NODE
0.000 | 0.000 | | | | | active clock edge time
0.000 | 0.000 | | | | | cam_pclk
0.000 | 0.000 | tCL | RR | 1 | IOL2[A] | camera_pclk_ibuf/I
0.608 | 0.608 | tINS | RR | 8189 | IOL2[A] | camera_pclk_ibuf/O
2.536 | 1.928 | tNET | RR | 48 | DSP_R37[24] | camera/flow_sensor/avoidance.safety/dot_0_s/CLK[0]
2.661 | 0.126 | tC2Q | RF | 1 | DSP_R37[24] | camera/flow_sensor/avoidance.safety/dot_0_s/CASO[12]
2.661 | 0.000 | tNET | FF | 1 | DSP_R37[25] | camera/flow_sensor/avoidance.safety/dot_0_s0/CASI[12]

Data Required Path:

AT | DELAY | TYPE | RF | FANOUT | LOC | NODE
0.000 | 0.000 | | | | | active clock edge time
0.000 | 0.000 | | | | | cam_pclk
0.000 | 0.000 | tCL | RR | 1 | IOL2[A] | camera_pclk_ibuf/I
0.608 | 0.608 | tINS | RR | 8189 | IOL2[A] | camera_pclk_ibuf/O
2.532 | 1.924 | tNET | RR | 1 | DSP_R37[25] | camera/flow_sensor/avoidance.safety/dot_0_s0/CLK[0]
2.440 | -0.092 | tHld | | 1 | DSP_R37[25] | camera/flow_sensor/avoidance.safety/dot_0_s0

Path Statistics:

Clock Skew | -0.004
Hold Relationship | 0.000
Logic Level | 1
Arrival Clock Path Delay | cell: 0.608, 23.975%; route: 1.928, 76.025%
Arrival Data Path Delay | cell: 0.000, 0.000%; route: 0.000, 0.000%; tC2Q: 0.126, 100.000%
Required Clock Path Delay | cell: 0.608, 24.009%; route: 1.924, 75.991%

### Path20

Path Summary:

Slack | 0.222
Data Arrival Time | 2.657
Data Required Time | 2.435
From | camera/flow_sensor/avoidance.safety/dot_0_s
To | camera/flow_sensor/avoidance.safety/dot_0_s0
Launch Clk | cam_pclk:[R]
Latch Clk | cam_pclk:[R]

Data Arrival Path:

AT | DELAY | TYPE | RF | FANOUT | LOC | NODE
0.000 | 0.000 | | | | | active clock edge time
0.000 | 0.000 | | | | | cam_pclk
0.000 | 0.000 | tCL | RR | 1 | IOL2[A] | camera_pclk_ibuf/I
0.608 | 0.608 | tINS | RR | 8189 | IOL2[A] | camera_pclk_ibuf/O
2.536 | 1.928 | tNET | RR | 48 | DSP_R37[24] | camera/flow_sensor/avoidance.safety/dot_0_s/CLK[0]
2.657 | 0.121 | tC2Q | RF | 1 | DSP_R37[24] | camera/flow_sensor/avoidance.safety/dot_0_s/CASO[27]
2.657 | 0.000 | tNET | FF | 1 | DSP_R37[25] | camera/flow_sensor/avoidance.safety/dot_0_s0/CASI[27]

Data Required Path:

AT | DELAY | TYPE | RF | FANOUT | LOC | NODE
0.000 | 0.000 | | | | | active clock edge time
0.000 | 0.000 | | | | | cam_pclk
0.000 | 0.000 | tCL | RR | 1 | IOL2[A] | camera_pclk_ibuf/I
0.608 | 0.608 | tINS | RR | 8189 | IOL2[A] | camera_pclk_ibuf/O
2.532 | 1.924 | tNET | RR | 1 | DSP_R37[25] | camera/flow_sensor/avoidance.safety/dot_0_s0/CLK[0]
2.435 | -0.097 | tHld | | 1 | DSP_R37[25] | camera/flow_sensor/avoidance.safety/dot_0_s0

Path Statistics:

Clock Skew | -0.004
Hold Relationship | 0.000
Logic Level | 1
Arrival Clock Path Delay | cell: 0.608, 23.975%; route: 1.928, 76.025%
Arrival Data Path Delay | cell: 0.000, 0.000%; route: 0.000, 0.000%; tC2Q: 0.121, 100.000%
Required Clock Path Delay | cell: 0.608, 24.009%; route: 1.924, 75.991%

### Path21

Path Summary:

Slack | 0.224
Data Arrival Time | 2.663
Data Required Time | 2.438
From | camera/flow_sensor/avoidance.safety/norm_0_s
To | camera/flow_sensor/avoidance.safety/norm_0_s0
Launch Clk | cam_pclk:[R]
Latch Clk | cam_pclk:[R]

Data Arrival Path:

AT | DELAY | TYPE | RF | FANOUT | LOC | NODE
0.000 | 0.000 | | | | | active clock edge time
0.000 | 0.000 | | | | | cam_pclk
0.000 | 0.000 | tCL | RR | 1 | IOL2[A] | camera_pclk_ibuf/I
0.608 | 0.608 | tINS | RR | 8189 | IOL2[A] | camera_pclk_ibuf/O
2.536 | 1.928 | tNET | RR | 48 | DSP_R37[26] | camera/flow_sensor/avoidance.safety/norm_0_s/CLK[0]
2.663 | 0.127 | tC2Q | RF | 1 | DSP_R37[26] | camera/flow_sensor/avoidance.safety/norm_0_s/CASO[9]
2.663 | 0.000 | tNET | FF | 1 | DSP_R37[27] | camera/flow_sensor/avoidance.safety/norm_0_s0/CASI[9]

Data Required Path:

AT | DELAY | TYPE | RF | FANOUT | LOC | NODE
0.000 | 0.000 | | | | | active clock edge time
0.000 | 0.000 | | | | | cam_pclk
0.000 | 0.000 | tCL | RR | 1 | IOL2[A] | camera_pclk_ibuf/I
0.608 | 0.608 | tINS | RR | 8189 | IOL2[A] | camera_pclk_ibuf/O
2.539 | 1.931 | tNET | RR | 1 | DSP_R37[27] | camera/flow_sensor/avoidance.safety/norm_0_s0/CLK[0]
2.438 | -0.101 | tHld | | 1 | DSP_R37[27] | camera/flow_sensor/avoidance.safety/norm_0_s0

Path Statistics:

Clock Skew | 0.004
Hold Relationship | 0.000
Logic Level | 1
Arrival Clock Path Delay | cell: 0.608, 23.975%; route: 1.928, 76.025%
Arrival Data Path Delay | cell: 0.000, 0.000%; route: 0.000, 0.000%; tC2Q: 0.127, 100.000%
Required Clock Path Delay | cell: 0.608, 23.941%; route: 1.931, 76.059%

### Path22

Path Summary:

Slack | 0.224
Data Arrival Time | 2.661
Data Required Time | 2.437
From | camera/flow_sensor/avoidance.safety/dot_0_s
To | camera/flow_sensor/avoidance.safety/dot_0_s0
Launch Clk | cam_pclk:[R]
Latch Clk | cam_pclk:[R]

Data Arrival Path:

AT | DELAY | TYPE | RF | FANOUT | LOC | NODE
0.000 | 0.000 | | | | | active clock edge time
0.000 | 0.000 | | | | | cam_pclk
0.000 | 0.000 | tCL | RR | 1 | IOL2[A] | camera_pclk_ibuf/I
0.608 | 0.608 | tINS | RR | 8189 | IOL2[A] | camera_pclk_ibuf/O
2.536 | 1.928 | tNET | RR | 48 | DSP_R37[24] | camera/flow_sensor/avoidance.safety/dot_0_s/CLK[0]
2.661 | 0.125 | tC2Q | RF | 1 | DSP_R37[24] | camera/flow_sensor/avoidance.safety/dot_0_s/CASO[22]
2.661 | 0.000 | tNET | FF | 1 | DSP_R37[25] | camera/flow_sensor/avoidance.safety/dot_0_s0/CASI[22]

Data Required Path:

AT | DELAY | TYPE | RF | FANOUT | LOC | NODE
0.000 | 0.000 | | | | | active clock edge time
0.000 | 0.000 | | | | | cam_pclk
0.000 | 0.000 | tCL | RR | 1 | IOL2[A] | camera_pclk_ibuf/I
0.608 | 0.608 | tINS | RR | 8189 | IOL2[A] | camera_pclk_ibuf/O
2.532 | 1.924 | tNET | RR | 1 | DSP_R37[25] | camera/flow_sensor/avoidance.safety/dot_0_s0/CLK[0]
2.437 | -0.096 | tHld | | 1 | DSP_R37[25] | camera/flow_sensor/avoidance.safety/dot_0_s0

Path Statistics:

Clock Skew | -0.004
Hold Relationship | 0.000
Logic Level | 1
Arrival Clock Path Delay | cell: 0.608, 23.975%; route: 1.928, 76.025%
Arrival Data Path Delay | cell: 0.000, 0.000%; route: 0.000, 0.000%; tC2Q: 0.125, 100.000%
Required Clock Path Delay | cell: 0.608, 24.009%; route: 1.924, 75.991%

### Path23

Path Summary:

Slack | 0.226
Data Arrival Time | 2.656
Data Required Time | 2.430
From | camera/flow_sensor/avoidance.safety/norm_0_s
To | camera/flow_sensor/avoidance.safety/norm_0_s0
Launch Clk | cam_pclk:[R]
Latch Clk | cam_pclk:[R]

Data Arrival Path:

AT | DELAY | TYPE | RF | FANOUT | LOC | NODE
0.000 | 0.000 | | | | | active clock edge time
0.000 | 0.000 | | | | | cam_pclk
0.000 | 0.000 | tCL | RR | 1 | IOL2[A] | camera_pclk_ibuf/I
0.608 | 0.608 | tINS | RR | 8189 | IOL2[A] | camera_pclk_ibuf/O
2.536 | 1.928 | tNET | RR | 48 | DSP_R37[26] | camera/flow_sensor/avoidance.safety/norm_0_s/CLK[0]
2.656 | 0.120 | tC2Q | RF | 1 | DSP_R37[26] | camera/flow_sensor/avoidance.safety/norm_0_s/CASO[31]
2.656 | 0.000 | tNET | FF | 1 | DSP_R37[27] | camera/flow_sensor/avoidance.safety/norm_0_s0/CASI[31]

Data Required Path:

AT | DELAY | TYPE | RF | FANOUT | LOC | NODE
0.000 | 0.000 | | | | | active clock edge time
0.000 | 0.000 | | | | | cam_pclk
0.000 | 0.000 | tCL | RR | 1 | IOL2[A] | camera_pclk_ibuf/I
0.608 | 0.608 | tINS | RR | 8189 | IOL2[A] | camera_pclk_ibuf/O
2.539 | 1.931 | tNET | RR | 1 | DSP_R37[27] | camera/flow_sensor/avoidance.safety/norm_0_s0/CLK[0]
2.430 | -0.109 | tHld | | 1 | DSP_R37[27] | camera/flow_sensor/avoidance.safety/norm_0_s0

Path Statistics:

Clock Skew | 0.004
Hold Relationship | 0.000
Logic Level | 1
Arrival Clock Path Delay | cell: 0.608, 23.975%; route: 1.928, 76.025%
Arrival Data Path Delay | cell: 0.000, 0.000%; route: 0.000, 0.000%; tC2Q: 0.120, 100.000%
Required Clock Path Delay | cell: 0.608, 23.941%; route: 1.931, 76.059%

### Path24

Path Summary:

Slack | 0.226
Data Arrival Time | 2.780
Data Required Time | 2.554
From | camera/grid/feature_address_2_s0
To | camera/tracker/memory_memory_0_4_s
Launch Clk | cam_pclk:[R]
Latch Clk | cam_pclk:[R]

Data Arrival Path:

AT | DELAY | TYPE | RF | FANOUT | LOC | NODE
0.000 | 0.000 | | | | | active clock edge time
0.000 | 0.000 | | | | | cam_pclk
0.000 | 0.000 | tCL | RR | 1 | IOL2[A] | camera_pclk_ibuf/I
0.608 | 0.608 | tINS | RR | 8189 | IOL2[A] | camera_pclk_ibuf/O
2.511 | 1.903 | tNET | RR | 1 | R84C33[1][A] | camera/grid/feature_address_2_s0/CLK
2.641 | 0.130 | tC2Q | RR | 26 | R84C33[1][A] | camera/grid/feature_address_2_s0/Q
2.780 | 0.139 | tNET | RR | 1 | BSRAM_R82[6][A] | camera/tracker/memory_memory_0_4_s/ADA[2]

Data Required Path:

AT | DELAY | TYPE | RF | FANOUT | LOC | NODE
0.000 | 0.000 | | | | | active clock edge time
0.000 | 0.000 | | | | | cam_pclk
0.000 | 0.000 | tCL | RR | 1 | IOL2[A] | camera_pclk_ibuf/I
0.608 | 0.608 | tINS | RR | 8189 | IOL2[A] | camera_pclk_ibuf/O
2.520 | 1.913 | tNET | RR | 1 | BSRAM_R82[6][A] | camera/tracker/memory_memory_0_4_s/CLKA
2.554 | 0.033 | tHld | | 1 | BSRAM_R82[6][A] | camera/tracker/memory_memory_0_4_s

Path Statistics:

Clock Skew | 0.009
Hold Relationship | 0.000
Logic Level | 1
Arrival Clock Path Delay | cell: 0.608, 24.207%; route: 1.903, 75.793%
Arrival Data Path Delay | cell: 0.000, 0.000%; route: 0.139, 51.678%; tC2Q: 0.130, 48.322%
Required Clock Path Delay | cell: 0.608, 24.121%; route: 1.913, 75.879%

### Path25

Path Summary:

Slack | 0.227
Data Arrival Time | 2.661
Data Required Time | 2.434
From | camera/flow_sensor/avoidance.safety/dot_0_s
To | camera/flow_sensor/avoidance.safety/dot_0_s0
Launch Clk | cam_pclk:[R]
Latch Clk | cam_pclk:[R]

Data Arrival Path:

AT | DELAY | TYPE | RF | FANOUT | LOC | NODE
0.000 | 0.000 | | | | | active clock edge time
0.000 | 0.000 | | | | | cam_pclk
0.000 | 0.000 | tCL | RR | 1 | IOL2[A] | camera_pclk_ibuf/I
0.608 | 0.608 | tINS | RR | 8189 | IOL2[A] | camera_pclk_ibuf/O
2.536 | 1.928 | tNET | RR | 48 | DSP_R37[24] | camera/flow_sensor/avoidance.safety/dot_0_s/CLK[0]
2.661 | 0.125 | tC2Q | RF | 1 | DSP_R37[24] | camera/flow_sensor/avoidance.safety/dot_0_s/CASO[21]
2.661 | 0.000 | tNET | FF | 1 | DSP_R37[25] | camera/flow_sensor/avoidance.safety/dot_0_s0/CASI[21]

Data Required Path:

AT | DELAY | TYPE | RF | FANOUT | LOC | NODE
0.000 | 0.000 | | | | | active clock edge time
0.000 | 0.000 | | | | | cam_pclk
0.000 | 0.000 | tCL | RR | 1 | IOL2[A] | camera_pclk_ibuf/I
0.608 | 0.608 | tINS | RR | 8189 | IOL2[A] | camera_pclk_ibuf/O
2.532 | 1.924 | tNET | RR | 1 | DSP_R37[25] | camera/flow_sensor/avoidance.safety/dot_0_s0/CLK[0]
2.434 | -0.098 | tHld | | 1 | DSP_R37[25] | camera/flow_sensor/avoidance.safety/dot_0_s0

Path Statistics:

Clock Skew | -0.004
Hold Relationship | 0.000
Logic Level | 1
Arrival Clock Path Delay | cell: 0.608, 23.975%; route: 1.928, 76.025%
Arrival Data Path Delay | cell: 0.000, 0.000%; route: 0.000, 0.000%; tC2Q: 0.125, 100.000%
Required Clock Path Delay | cell: 0.608, 24.009%; route: 1.924, 75.991%

### Recovery Analysis Report

#### Report Command:report_timing -recovery -max_paths 25 -max_common_paths 1

### Path1

Path Summary:

Slack | 4.030
Data Arrival Time | 10.856
Data Required Time | 14.886
From | camera/perception_reset/release_pipe_2_s0
To | camera/event_mux/out_payload_59_s0
Launch Clk | eth125:[R]
Latch Clk | eth125:[R]

Data Arrival Path:

AT | DELAY | TYPE | RF | FANOUT | LOC | NODE
0.000 | 0.000 | | | | | active clock edge time
0.000 | 0.000 | | | | | eth125
3.835 | 3.835 | tCL | RR | 5898 | PLL_B[2] | camera/pll/PLL_inst/CLKOUT1
7.204 | 3.369 | tNET | RR | 1 | R39C78[1][B] | camera/perception_reset/release_pipe_2_s0/CLK
7.535 | 0.331 | tC2Q | RF | 2032 | R39C78[1][B] | camera/perception_reset/release_pipe_2_s0/Q
10.856 | 3.320 | tNET | FF | 1 | R56C89[0][B] | camera/event_mux/out_payload_59_s0/CLEAR

Data Required Path:

AT | DELAY | TYPE | RF | FANOUT | LOC | NODE
8.000 | 8.000 | | | | | active clock edge time
8.000 | 0.000 | | | | | eth125
11.835 | 3.835 | tCL | RR | 5898 | PLL_B[2] | camera/pll/PLL_inst/CLKOUT1
15.198 | 3.363 | tNET | RR | 1 | R56C89[0][B] | camera/event_mux/out_payload_59_s0/CLK
14.886 | -0.313 | tSu | | 1 | R56C89[0][B] | camera/event_mux/out_payload_59_s0

Path Statistics:

Clock Skew | -0.006
Setup Relationship | 8.000
Logic Level | 1
Arrival Clock Path Delay | cell: 0.000, 0.000%; route: 3.369, 100.000%
Arrival Data Path Delay | cell: 0.000, 0.000%; route: 3.320, 90.941%; tC2Q: 0.331, 9.059%
Required Clock Path Delay | cell: 0.000, 0.000%; route: 3.363, 100.000%

### Path2

Path Summary:

Slack | 4.030
Data Arrival Time | 10.856
Data Required Time | 14.886
From | camera/perception_reset/release_pipe_2_s0
To | camera/event_mux/out_payload_65_s0
Launch Clk | eth125:[R]
Latch Clk | eth125:[R]

Data Arrival Path:

AT | DELAY | TYPE | RF | FANOUT | LOC | NODE
0.000 | 0.000 | | | | | active clock edge time
0.000 | 0.000 | | | | | eth125
3.835 | 3.835 | tCL | RR | 5898 | PLL_B[2] | camera/pll/PLL_inst/CLKOUT1
7.204 | 3.369 | tNET | RR | 1 | R39C78[1][B] | camera/perception_reset/release_pipe_2_s0/CLK
7.535 | 0.331 | tC2Q | RF | 2032 | R39C78[1][B] | camera/perception_reset/release_pipe_2_s0/Q
10.856 | 3.320 | tNET | FF | 1 | R56C89[0][A] | camera/event_mux/out_payload_65_s0/CLEAR

Data Required Path:

AT | DELAY | TYPE | RF | FANOUT | LOC | NODE
8.000 | 8.000 | | | | | active clock edge time
8.000 | 0.000 | | | | | eth125
11.835 | 3.835 | tCL | RR | 5898 | PLL_B[2] | camera/pll/PLL_inst/CLKOUT1
15.198 | 3.363 | tNET | RR | 1 | R56C89[0][A] | camera/event_mux/out_payload_65_s0/CLK
14.886 | -0.313 | tSu | | 1 | R56C89[0][A] | camera/event_mux/out_payload_65_s0

Path Statistics:

Clock Skew | -0.006
Setup Relationship | 8.000
Logic Level | 1
Arrival Clock Path Delay | cell: 0.000, 0.000%; route: 3.369, 100.000%
Arrival Data Path Delay | cell: 0.000, 0.000%; route: 3.320, 90.941%; tC2Q: 0.331, 9.059%
Required Clock Path Delay | cell: 0.000, 0.000%; route: 3.363, 100.000%

### Path3

Path Summary:

Slack | 4.030
Data Arrival Time | 10.864
Data Required Time | 14.894
From | camera/perception_reset/release_pipe_2_s0
To | camera/event_mux/out_payload_77_s0
Launch Clk | eth125:[R]
Latch Clk | eth125:[R]

Data Arrival Path:

AT | DELAY | TYPE | RF | FANOUT | LOC | NODE
0.000 | 0.000 | | | | | active clock edge time
0.000 | 0.000 | | | | | eth125
3.835 | 3.835 | tCL | RR | 5898 | PLL_B[2] | camera/pll/PLL_inst/CLKOUT1
7.204 | 3.369 | tNET | RR | 1 | R39C78[1][B] | camera/perception_reset/release_pipe_2_s0/CLK
7.535 | 0.331 | tC2Q | RF | 2032 | R39C78[1][B] | camera/perception_reset/release_pipe_2_s0/Q
10.864 | 3.329 | tNET | FF | 1 | R56C90[2][B] | camera/event_mux/out_payload_77_s0/CLEAR

Data Required Path:

AT | DELAY | TYPE | RF | FANOUT | LOC | NODE
8.000 | 8.000 | | | | | active clock edge time
8.000 | 0.000 | | | | | eth125
11.835 | 3.835 | tCL | RR | 5898 | PLL_B[2] | camera/pll/PLL_inst/CLKOUT1
15.207 | 3.372 | tNET | RR | 1 | R56C90[2][B] | camera/event_mux/out_payload_77_s0/CLK
14.894 | -0.313 | tSu | | 1 | R56C90[2][B] | camera/event_mux/out_payload_77_s0

Path Statistics:

Clock Skew | 0.002
Setup Relationship | 8.000
Logic Level | 1
Arrival Clock Path Delay | cell: 0.000, 0.000%; route: 3.369, 100.000%
Arrival Data Path Delay | cell: 0.000, 0.000%; route: 3.329, 90.962%; tC2Q: 0.331, 9.038%
Required Clock Path Delay | cell: 0.000, 0.000%; route: 3.372, 100.000%

### Path4

Path Summary:

Slack | 4.030
Data Arrival Time | 10.864
Data Required Time | 14.894
From | camera/perception_reset/release_pipe_2_s0
To | camera/bridge/age_4_s3
Launch Clk | eth125:[R]
Latch Clk | eth125:[R]

Data Arrival Path:

AT | DELAY | TYPE | RF | FANOUT | LOC | NODE
0.000 | 0.000 | | | | | active clock edge time
0.000 | 0.000 | | | | | eth125
3.835 | 3.835 | tCL | RR | 5898 | PLL_B[2] | camera/pll/PLL_inst/CLKOUT1
7.204 | 3.369 | tNET | RR | 1 | R39C78[1][B] | camera/perception_reset/release_pipe_2_s0/CLK
7.535 | 0.331 | tC2Q | RF | 2032 | R39C78[1][B] | camera/perception_reset/release_pipe_2_s0/Q
10.864 | 3.329 | tNET | FF | 1 | R56C78[0][B] | camera/bridge/age_4_s3/CLEAR

Data Required Path:

AT | DELAY | TYPE | RF | FANOUT | LOC | NODE
8.000 | 8.000 | | | | | active clock edge time
8.000 | 0.000 | | | | | eth125
11.835 | 3.835 | tCL | RR | 5898 | PLL_B[2] | camera/pll/PLL_inst/CLKOUT1
15.207 | 3.372 | tNET | RR | 1 | R56C78[0][B] | camera/bridge/age_4_s3/CLK
14.894 | -0.313 | tSu | | 1 | R56C78[0][B] | camera/bridge/age_4_s3

Path Statistics:

Clock Skew | 0.002
Setup Relationship | 8.000
Logic Level | 1
Arrival Clock Path Delay | cell: 0.000, 0.000%; route: 3.369, 100.000%
Arrival Data Path Delay | cell: 0.000, 0.000%; route: 3.329, 90.962%; tC2Q: 0.331, 9.038%
Required Clock Path Delay | cell: 0.000, 0.000%; route: 3.372, 100.000%

### Path5

Path Summary:

Slack | 4.030
Data Arrival Time | 10.864
Data Required Time | 14.894
From | camera/perception_reset/release_pipe_2_s0
To | camera/bridge/age_6_s3
Launch Clk | eth125:[R]
Latch Clk | eth125:[R]

Data Arrival Path:

AT | DELAY | TYPE | RF | FANOUT | LOC | NODE
0.000 | 0.000 | | | | | active clock edge time
0.000 | 0.000 | | | | | eth125
3.835 | 3.835 | tCL | RR | 5898 | PLL_B[2] | camera/pll/PLL_inst/CLKOUT1
7.204 | 3.369 | tNET | RR | 1 | R39C78[1][B] | camera/perception_reset/release_pipe_2_s0/CLK
7.535 | 0.331 | tC2Q | RF | 2032 | R39C78[1][B] | camera/perception_reset/release_pipe_2_s0/Q
10.864 | 3.329 | tNET | FF | 1 | R56C78[0][A] | camera/bridge/age_6_s3/CLEAR

Data Required Path:

AT | DELAY | TYPE | RF | FANOUT | LOC | NODE
8.000 | 8.000 | | | | | active clock edge time
8.000 | 0.000 | | | | | eth125
11.835 | 3.835 | tCL | RR | 5898 | PLL_B[2] | camera/pll/PLL_inst/CLKOUT1
15.207 | 3.372 | tNET | RR | 1 | R56C78[0][A] | camera/bridge/age_6_s3/CLK
14.894 | -0.313 | tSu | | 1 | R56C78[0][A] | camera/bridge/age_6_s3

Path Statistics:

Clock Skew | 0.002
Setup Relationship | 8.000
Logic Level | 1
Arrival Clock Path Delay | cell: 0.000, 0.000%; route: 3.369, 100.000%
Arrival Data Path Delay | cell: 0.000, 0.000%; route: 3.329, 90.962%; tC2Q: 0.331, 9.038%
Required Clock Path Delay | cell: 0.000, 0.000%; route: 3.372, 100.000%

### Path6

Path Summary:

Slack | 4.030
Data Arrival Time | 10.856
Data Required Time | 14.886
From | camera/perception_reset/release_pipe_2_s0
To | camera/bridge/age_11_s1
Launch Clk | eth125:[R]
Latch Clk | eth125:[R]

Data Arrival Path:

AT | DELAY | TYPE | RF | FANOUT | LOC | NODE
0.000 | 0.000 | | | | | active clock edge time
0.000 | 0.000 | | | | | eth125
3.835 | 3.835 | tCL | RR | 5898 | PLL_B[2] | camera/pll/PLL_inst/CLKOUT1
7.204 | 3.369 | tNET | RR | 1 | R39C78[1][B] | camera/perception_reset/release_pipe_2_s0/CLK
7.535 | 0.331 | tC2Q | RF | 2032 | R39C78[1][B] | camera/perception_reset/release_pipe_2_s0/Q
10.856 | 3.320 | tNET | FF | 1 | R56C79[1][B] | camera/bridge/age_11_s1/CLEAR

Data Required Path:

AT | DELAY | TYPE | RF | FANOUT | LOC | NODE
8.000 | 8.000 | | | | | active clock edge time
8.000 | 0.000 | | | | | eth125
11.835 | 3.835 | tCL | RR | 5898 | PLL_B[2] | camera/pll/PLL_inst/CLKOUT1
15.198 | 3.363 | tNET | RR | 1 | R56C79[1][B] | camera/bridge/age_11_s1/CLK
14.886 | -0.313 | tSu | | 1 | R56C79[1][B] | camera/bridge/age_11_s1

Path Statistics:

Clock Skew | -0.006
Setup Relationship | 8.000
Logic Level | 1
Arrival Clock Path Delay | cell: 0.000, 0.000%; route: 3.369, 100.000%
Arrival Data Path Delay | cell: 0.000, 0.000%; route: 3.320, 90.941%; tC2Q: 0.331, 9.059%
Required Clock Path Delay | cell: 0.000, 0.000%; route: 3.363, 100.000%

### Path7

Path Summary:

Slack | 4.030
Data Arrival Time | 10.856
Data Required Time | 14.886
From | camera/perception_reset/release_pipe_2_s0
To | camera/bridge/event_payload_16_s0
Launch Clk | eth125:[R]
Latch Clk | eth125:[R]

Data Arrival Path:

AT | DELAY | TYPE | RF | FANOUT | LOC | NODE
0.000 | 0.000 | | | | | active clock edge time
0.000 | 0.000 | | | | | eth125
3.835 | 3.835 | tCL | RR | 5898 | PLL_B[2] | camera/pll/PLL_inst/CLKOUT1
7.204 | 3.369 | tNET | RR | 1 | R39C78[1][B] | camera/perception_reset/release_pipe_2_s0/CLK
7.535 | 0.331 | tC2Q | RF | 2032 | R39C78[1][B] | camera/perception_reset/release_pipe_2_s0/Q
10.856 | 3.320 | tNET | FF | 1 | R56C85[2][A] | camera/bridge/event_payload_16_s0/CLEAR

Data Required Path:

AT | DELAY | TYPE | RF | FANOUT | LOC | NODE
8.000 | 8.000 | | | | | active clock edge time
8.000 | 0.000 | | | | | eth125
11.835 | 3.835 | tCL | RR | 5898 | PLL_B[2] | camera/pll/PLL_inst/CLKOUT1
15.198 | 3.363 | tNET | RR | 1 | R56C85[2][A] | camera/bridge/event_payload_16_s0/CLK
14.886 | -0.313 | tSu | | 1 | R56C85[2][A] | camera/bridge/event_payload_16_s0

Path Statistics:

Clock Skew | -0.006
Setup Relationship | 8.000
Logic Level | 1
Arrival Clock Path Delay | cell: 0.000, 0.000%; route: 3.369, 100.000%
Arrival Data Path Delay | cell: 0.000, 0.000%; route: 3.320, 90.941%; tC2Q: 0.331, 9.059%
Required Clock Path Delay | cell: 0.000, 0.000%; route: 3.363, 100.000%

### Path8

Path Summary:

Slack | 4.030
Data Arrival Time | 10.856
Data Required Time | 14.886
From | camera/perception_reset/release_pipe_2_s0
To | camera/bridge/event_payload_17_s0
Launch Clk | eth125:[R]
Latch Clk | eth125:[R]

Data Arrival Path:

AT | DELAY | TYPE | RF | FANOUT | LOC | NODE
0.000 | 0.000 | | | | | active clock edge time
0.000 | 0.000 | | | | | eth125
3.835 | 3.835 | tCL | RR | 5898 | PLL_B[2] | camera/pll/PLL_inst/CLKOUT1
7.204 | 3.369 | tNET | RR | 1 | R39C78[1][B] | camera/perception_reset/release_pipe_2_s0/CLK
7.535 | 0.331 | tC2Q | RF | 2032 | R39C78[1][B] | camera/perception_reset/release_pipe_2_s0/Q
10.856 | 3.320 | tNET | FF | 1 | R56C83[1][A] | camera/bridge/event_payload_17_s0/CLEAR

Data Required Path:

AT | DELAY | TYPE | RF | FANOUT | LOC | NODE
8.000 | 8.000 | | | | | active clock edge time
8.000 | 0.000 | | | | | eth125
11.835 | 3.835 | tCL | RR | 5898 | PLL_B[2] | camera/pll/PLL_inst/CLKOUT1
15.198 | 3.363 | tNET | RR | 1 | R56C83[1][A] | camera/bridge/event_payload_17_s0/CLK
14.886 | -0.313 | tSu | | 1 | R56C83[1][A] | camera/bridge/event_payload_17_s0

Path Statistics:

Clock Skew | -0.006
Setup Relationship | 8.000
Logic Level | 1
Arrival Clock Path Delay | cell: 0.000, 0.000%; route: 3.369, 100.000%
Arrival Data Path Delay | cell: 0.000, 0.000%; route: 3.320, 90.941%; tC2Q: 0.331, 9.059%
Required Clock Path Delay | cell: 0.000, 0.000%; route: 3.363, 100.000%

### Path9

Path Summary:

Slack | 4.030
Data Arrival Time | 10.856
Data Required Time | 14.886
From | camera/perception_reset/release_pipe_2_s0
To | camera/bridge/event_payload_35_s0
Launch Clk | eth125:[R]
Latch Clk | eth125:[R]

Data Arrival Path:

AT | DELAY | TYPE | RF | FANOUT | LOC | NODE
0.000 | 0.000 | | | | | active clock edge time
0.000 | 0.000 | | | | | eth125
3.835 | 3.835 | tCL | RR | 5898 | PLL_B[2] | camera/pll/PLL_inst/CLKOUT1
7.204 | 3.369 | tNET | RR | 1 | R39C78[1][B] | camera/perception_reset/release_pipe_2_s0/CLK
7.535 | 0.331 | tC2Q | RF | 2032 | R39C78[1][B] | camera/perception_reset/release_pipe_2_s0/Q
10.856 | 3.320 | tNET | FF | 1 | R56C85[3][A] | camera/bridge/event_payload_35_s0/CLEAR

Data Required Path:

AT | DELAY | TYPE | RF | FANOUT | LOC | NODE
8.000 | 8.000 | | | | | active clock edge time
8.000 | 0.000 | | | | | eth125
11.835 | 3.835 | tCL | RR | 5898 | PLL_B[2] | camera/pll/PLL_inst/CLKOUT1
15.198 | 3.363 | tNET | RR | 1 | R56C85[3][A] | camera/bridge/event_payload_35_s0/CLK
14.886 | -0.313 | tSu | | 1 | R56C85[3][A] | camera/bridge/event_payload_35_s0

Path Statistics:

Clock Skew | -0.006
Setup Relationship | 8.000
Logic Level | 1
Arrival Clock Path Delay | cell: 0.000, 0.000%; route: 3.369, 100.000%
Arrival Data Path Delay | cell: 0.000, 0.000%; route: 3.320, 90.941%; tC2Q: 0.331, 9.059%
Required Clock Path Delay | cell: 0.000, 0.000%; route: 3.363, 100.000%

### Path10

Path Summary:

Slack | 4.030
Data Arrival Time | 10.856
Data Required Time | 14.886
From | camera/perception_reset/release_pipe_2_s0
To | camera/bridge/event_payload_37_s0
Launch Clk | eth125:[R]
Latch Clk | eth125:[R]

Data Arrival Path:

AT | DELAY | TYPE | RF | FANOUT | LOC | NODE
0.000 | 0.000 | | | | | active clock edge time
0.000 | 0.000 | | | | | eth125
3.835 | 3.835 | tCL | RR | 5898 | PLL_B[2] | camera/pll/PLL_inst/CLKOUT1
7.204 | 3.369 | tNET | RR | 1 | R39C78[1][B] | camera/perception_reset/release_pipe_2_s0/CLK
7.535 | 0.331 | tC2Q | RF | 2032 | R39C78[1][B] | camera/perception_reset/release_pipe_2_s0/Q
10.856 | 3.320 | tNET | FF | 1 | R56C85[2][B] | camera/bridge/event_payload_37_s0/CLEAR

Data Required Path:

AT | DELAY | TYPE | RF | FANOUT | LOC | NODE
8.000 | 8.000 | | | | | active clock edge time
8.000 | 0.000 | | | | | eth125
11.835 | 3.835 | tCL | RR | 5898 | PLL_B[2] | camera/pll/PLL_inst/CLKOUT1
15.198 | 3.363 | tNET | RR | 1 | R56C85[2][B] | camera/bridge/event_payload_37_s0/CLK
14.886 | -0.313 | tSu | | 1 | R56C85[2][B] | camera/bridge/event_payload_37_s0

Path Statistics:

Clock Skew | -0.006
Setup Relationship | 8.000
Logic Level | 1
Arrival Clock Path Delay | cell: 0.000, 0.000%; route: 3.369, 100.000%
Arrival Data Path Delay | cell: 0.000, 0.000%; route: 3.320, 90.941%; tC2Q: 0.331, 9.059%
Required Clock Path Delay | cell: 0.000, 0.000%; route: 3.363, 100.000%

### Path11

Path Summary:

Slack | 4.030
Data Arrival Time | 10.856
Data Required Time | 14.886
From | camera/perception_reset/release_pipe_2_s0
To | camera/bridge/event_payload_38_s0
Launch Clk | eth125:[R]
Latch Clk | eth125:[R]

Data Arrival Path:

AT | DELAY | TYPE | RF | FANOUT | LOC | NODE
0.000 | 0.000 | | | | | active clock edge time
0.000 | 0.000 | | | | | eth125
3.835 | 3.835 | tCL | RR | 5898 | PLL_B[2] | camera/pll/PLL_inst/CLKOUT1
7.204 | 3.369 | tNET | RR | 1 | R39C78[1][B] | camera/perception_reset/release_pipe_2_s0/CLK
7.535 | 0.331 | tC2Q | RF | 2032 | R39C78[1][B] | camera/perception_reset/release_pipe_2_s0/Q
10.856 | 3.320 | tNET | FF | 1 | R56C83[1][B] | camera/bridge/event_payload_38_s0/CLEAR

Data Required Path:

AT | DELAY | TYPE | RF | FANOUT | LOC | NODE
8.000 | 8.000 | | | | | active clock edge time
8.000 | 0.000 | | | | | eth125
11.835 | 3.835 | tCL | RR | 5898 | PLL_B[2] | camera/pll/PLL_inst/CLKOUT1
15.198 | 3.363 | tNET | RR | 1 | R56C83[1][B] | camera/bridge/event_payload_38_s0/CLK
14.886 | -0.313 | tSu | | 1 | R56C83[1][B] | camera/bridge/event_payload_38_s0

Path Statistics:

Clock Skew | -0.006
Setup Relationship | 8.000
Logic Level | 1
Arrival Clock Path Delay | cell: 0.000, 0.000%; route: 3.369, 100.000%
Arrival Data Path Delay | cell: 0.000, 0.000%; route: 3.320, 90.941%; tC2Q: 0.331, 9.059%
Required Clock Path Delay | cell: 0.000, 0.000%; route: 3.363, 100.000%

### Path12

Path Summary:

Slack | 4.030
Data Arrival Time | 10.864
Data Required Time | 14.894
From | camera/perception_reset/release_pipe_2_s0
To | camera/bridge/event_payload_77_s0
Launch Clk | eth125:[R]
Latch Clk | eth125:[R]

Data Arrival Path:

AT | DELAY | TYPE | RF | FANOUT | LOC | NODE
0.000 | 0.000 | | | | | active clock edge time
0.000 | 0.000 | | | | | eth125
3.835 | 3.835 | tCL | RR | 5898 | PLL_B[2] | camera/pll/PLL_inst/CLKOUT1
7.204 | 3.369 | tNET | RR | 1 | R39C78[1][B] | camera/perception_reset/release_pipe_2_s0/CLK
7.535 | 0.331 | tC2Q | RF | 2032 | R39C78[1][B] | camera/perception_reset/release_pipe_2_s0/Q
10.864 | 3.329 | tNET | FF | 1 | R56C74[1][A] | camera/bridge/event_payload_77_s0/CLEAR

Data Required Path:

AT | DELAY | TYPE | RF | FANOUT | LOC | NODE
8.000 | 8.000 | | | | | active clock edge time
8.000 | 0.000 | | | | | eth125
11.835 | 3.835 | tCL | RR | 5898 | PLL_B[2] | camera/pll/PLL_inst/CLKOUT1
15.207 | 3.372 | tNET | RR | 1 | R56C74[1][A] | camera/bridge/event_payload_77_s0/CLK
14.894 | -0.313 | tSu | | 1 | R56C74[1][A] | camera/bridge/event_payload_77_s0

Path Statistics:

Clock Skew | 0.002
Setup Relationship | 8.000
Logic Level | 1
Arrival Clock Path Delay | cell: 0.000, 0.000%; route: 3.369, 100.000%
Arrival Data Path Delay | cell: 0.000, 0.000%; route: 3.329, 90.962%; tC2Q: 0.331, 9.038%
Required Clock Path Delay | cell: 0.000, 0.000%; route: 3.372, 100.000%

### Path13

Path Summary:

Slack | 4.030
Data Arrival Time | 10.864
Data Required Time | 14.894
From | camera/perception_reset/release_pipe_2_s0
To | camera/bridge/event_payload_78_s0
Launch Clk | eth125:[R]
Latch Clk | eth125:[R]

Data Arrival Path:

AT | DELAY | TYPE | RF | FANOUT | LOC | NODE
0.000 | 0.000 | | | | | active clock edge time
0.000 | 0.000 | | | | | eth125
3.835 | 3.835 | tCL | RR | 5898 | PLL_B[2] | camera/pll/PLL_inst/CLKOUT1
7.204 | 3.369 | tNET | RR | 1 | R39C78[1][B] | camera/perception_reset/release_pipe_2_s0/CLK
7.535 | 0.331 | tC2Q | RF | 2032 | R39C78[1][B] | camera/perception_reset/release_pipe_2_s0/Q
10.864 | 3.329 | tNET | FF | 1 | R56C74[1][B] | camera/bridge/event_payload_78_s0/CLEAR

Data Required Path:

AT | DELAY | TYPE | RF | FANOUT | LOC | NODE
8.000 | 8.000 | | | | | active clock edge time
8.000 | 0.000 | | | | | eth125
11.835 | 3.835 | tCL | RR | 5898 | PLL_B[2] | camera/pll/PLL_inst/CLKOUT1
15.207 | 3.372 | tNET | RR | 1 | R56C74[1][B] | camera/bridge/event_payload_78_s0/CLK
14.894 | -0.313 | tSu | | 1 | R56C74[1][B] | camera/bridge/event_payload_78_s0

Path Statistics:

Clock Skew | 0.002
Setup Relationship | 8.000
Logic Level | 1
Arrival Clock Path Delay | cell: 0.000, 0.000%; route: 3.369, 100.000%
Arrival Data Path Delay | cell: 0.000, 0.000%; route: 3.329, 90.962%; tC2Q: 0.331, 9.038%
Required Clock Path Delay | cell: 0.000, 0.000%; route: 3.372, 100.000%

### Path14

Path Summary:

Slack | 4.030
Data Arrival Time | 10.864
Data Required Time | 14.894
From | camera/perception_reset/release_pipe_2_s0
To | camera/bridge/event_payload_79_s0
Launch Clk | eth125:[R]
Latch Clk | eth125:[R]

Data Arrival Path:

AT | DELAY | TYPE | RF | FANOUT | LOC | NODE
0.000 | 0.000 | | | | | active clock edge time
0.000 | 0.000 | | | | | eth125
3.835 | 3.835 | tCL | RR | 5898 | PLL_B[2] | camera/pll/PLL_inst/CLKOUT1
7.204 | 3.369 | tNET | RR | 1 | R39C78[1][B] | camera/perception_reset/release_pipe_2_s0/CLK
7.535 | 0.331 | tC2Q | RF | 2032 | R39C78[1][B] | camera/perception_reset/release_pipe_2_s0/Q
10.864 | 3.329 | tNET | FF | 1 | R56C74[0][A] | camera/bridge/event_payload_79_s0/CLEAR

Data Required Path:

AT | DELAY | TYPE | RF | FANOUT | LOC | NODE
8.000 | 8.000 | | | | | active clock edge time
8.000 | 0.000 | | | | | eth125
11.835 | 3.835 | tCL | RR | 5898 | PLL_B[2] | camera/pll/PLL_inst/CLKOUT1
15.207 | 3.372 | tNET | RR | 1 | R56C74[0][A] | camera/bridge/event_payload_79_s0/CLK
14.894 | -0.313 | tSu | | 1 | R56C74[0][A] | camera/bridge/event_payload_79_s0

Path Statistics:

Clock Skew | 0.002
Setup Relationship | 8.000
Logic Level | 1
Arrival Clock Path Delay | cell: 0.000, 0.000%; route: 3.369, 100.000%
Arrival Data Path Delay | cell: 0.000, 0.000%; route: 3.329, 90.962%; tC2Q: 0.331, 9.038%
Required Clock Path Delay | cell: 0.000, 0.000%; route: 3.372, 100.000%

### Path15

Path Summary:

Slack | 4.030
Data Arrival Time | 10.864
Data Required Time | 14.894
From | camera/perception_reset/release_pipe_2_s0
To | camera/bridge/event_payload_80_s0
Launch Clk | eth125:[R]
Latch Clk | eth125:[R]

Data Arrival Path:

AT | DELAY | TYPE | RF | FANOUT | LOC | NODE
0.000 | 0.000 | | | | | active clock edge time
0.000 | 0.000 | | | | | eth125
3.835 | 3.835 | tCL | RR | 5898 | PLL_B[2] | camera/pll/PLL_inst/CLKOUT1
7.204 | 3.369 | tNET | RR | 1 | R39C78[1][B] | camera/perception_reset/release_pipe_2_s0/CLK
7.535 | 0.331 | tC2Q | RF | 2032 | R39C78[1][B] | camera/perception_reset/release_pipe_2_s0/Q
10.864 | 3.329 | tNET | FF | 1 | R56C74[0][B] | camera/bridge/event_payload_80_s0/CLEAR

Data Required Path:

AT | DELAY | TYPE | RF | FANOUT | LOC | NODE
8.000 | 8.000 | | | | | active clock edge time
8.000 | 0.000 | | | | | eth125
11.835 | 3.835 | tCL | RR | 5898 | PLL_B[2] | camera/pll/PLL_inst/CLKOUT1
15.207 | 3.372 | tNET | RR | 1 | R56C74[0][B] | camera/bridge/event_payload_80_s0/CLK
14.894 | -0.313 | tSu | | 1 | R56C74[0][B] | camera/bridge/event_payload_80_s0

Path Statistics:

Clock Skew | 0.002
Setup Relationship | 8.000
Logic Level | 1
Arrival Clock Path Delay | cell: 0.000, 0.000%; route: 3.369, 100.000%
Arrival Data Path Delay | cell: 0.000, 0.000%; route: 3.329, 90.962%; tC2Q: 0.331, 9.038%
Required Clock Path Delay | cell: 0.000, 0.000%; route: 3.372, 100.000%

### Path16

Path Summary:

Slack | 4.030
Data Arrival Time | 10.864
Data Required Time | 14.894
From | camera/perception_reset/release_pipe_2_s0
To | camera/bridge/event_payload_203_s0
Launch Clk | eth125:[R]
Latch Clk | eth125:[R]

Data Arrival Path:

AT | DELAY | TYPE | RF | FANOUT | LOC | NODE
0.000 | 0.000 | | | | | active clock edge time
0.000 | 0.000 | | | | | eth125
3.835 | 3.835 | tCL | RR | 5898 | PLL_B[2] | camera/pll/PLL_inst/CLKOUT1
7.204 | 3.369 | tNET | RR | 1 | R39C78[1][B] | camera/perception_reset/release_pipe_2_s0/CLK
7.535 | 0.331 | tC2Q | RF | 2032 | R39C78[1][B] | camera/perception_reset/release_pipe_2_s0/Q
10.864 | 3.329 | tNET | FF | 1 | R56C82[2][B] | camera/bridge/event_payload_203_s0/CLEAR

Data Required Path:

AT | DELAY | TYPE | RF | FANOUT | LOC | NODE
8.000 | 8.000 | | | | | active clock edge time
8.000 | 0.000 | | | | | eth125
11.835 | 3.835 | tCL | RR | 5898 | PLL_B[2] | camera/pll/PLL_inst/CLKOUT1
15.207 | 3.372 | tNET | RR | 1 | R56C82[2][B] | camera/bridge/event_payload_203_s0/CLK
14.894 | -0.313 | tSu | | 1 | R56C82[2][B] | camera/bridge/event_payload_203_s0

Path Statistics:

Clock Skew | 0.002
Setup Relationship | 8.000
Logic Level | 1
Arrival Clock Path Delay | cell: 0.000, 0.000%; route: 3.369, 100.000%
Arrival Data Path Delay | cell: 0.000, 0.000%; route: 3.329, 90.962%; tC2Q: 0.331, 9.038%
Required Clock Path Delay | cell: 0.000, 0.000%; route: 3.372, 100.000%

### Path17

Path Summary:

Slack | 4.030
Data Arrival Time | 10.856
Data Required Time | 14.886
From | camera/perception_reset/release_pipe_2_s0
To | camera/bridge/have_observation_s0
Launch Clk | eth125:[R]
Latch Clk | eth125:[R]

Data Arrival Path:

AT | DELAY | TYPE | RF | FANOUT | LOC | NODE
0.000 | 0.000 | | | | | active clock edge time
0.000 | 0.000 | | | | | eth125
3.835 | 3.835 | tCL | RR | 5898 | PLL_B[2] | camera/pll/PLL_inst/CLKOUT1
7.204 | 3.369 | tNET | RR | 1 | R39C78[1][B] | camera/perception_reset/release_pipe_2_s0/CLK
7.535 | 0.331 | tC2Q | RF | 2032 | R39C78[1][B] | camera/perception_reset/release_pipe_2_s0/Q
10.856 | 3.320 | tNET | FF | 1 | R56C83[0][B] | camera/bridge/have_observation_s0/CLEAR

Data Required Path:

AT | DELAY | TYPE | RF | FANOUT | LOC | NODE
8.000 | 8.000 | | | | | active clock edge time
8.000 | 0.000 | | | | | eth125
11.835 | 3.835 | tCL | RR | 5898 | PLL_B[2] | camera/pll/PLL_inst/CLKOUT1
15.198 | 3.363 | tNET | RR | 1 | R56C83[0][B] | camera/bridge/have_observation_s0/CLK
14.886 | -0.313 | tSu | | 1 | R56C83[0][B] | camera/bridge/have_observation_s0

Path Statistics:

Clock Skew | -0.006
Setup Relationship | 8.000
Logic Level | 1
Arrival Clock Path Delay | cell: 0.000, 0.000%; route: 3.369, 100.000%
Arrival Data Path Delay | cell: 0.000, 0.000%; route: 3.320, 90.941%; tC2Q: 0.331, 9.059%
Required Clock Path Delay | cell: 0.000, 0.000%; route: 3.363, 100.000%

### Path18

Path Summary:

Slack | 4.030
Data Arrival Time | 10.856
Data Required Time | 14.886
From | camera/perception_reset/release_pipe_2_s0
To | camera/bridge/latest_16_s0
Launch Clk | eth125:[R]
Latch Clk | eth125:[R]

Data Arrival Path:

AT | DELAY | TYPE | RF | FANOUT | LOC | NODE
0.000 | 0.000 | | | | | active clock edge time
0.000 | 0.000 | | | | | eth125
3.835 | 3.835 | tCL | RR | 5898 | PLL_B[2] | camera/pll/PLL_inst/CLKOUT1
7.204 | 3.369 | tNET | RR | 1 | R39C78[1][B] | camera/perception_reset/release_pipe_2_s0/CLK
7.535 | 0.331 | tC2Q | RF | 2032 | R39C78[1][B] | camera/perception_reset/release_pipe_2_s0/Q
10.856 | 3.320 | tNET | FF | 1 | R56C85[1][B] | camera/bridge/latest_16_s0/CLEAR

Data Required Path:

AT | DELAY | TYPE | RF | FANOUT | LOC | NODE
8.000 | 8.000 | | | | | active clock edge time
8.000 | 0.000 | | | | | eth125
11.835 | 3.835 | tCL | RR | 5898 | PLL_B[2] | camera/pll/PLL_inst/CLKOUT1
15.198 | 3.363 | tNET | RR | 1 | R56C85[1][B] | camera/bridge/latest_16_s0/CLK
14.886 | -0.313 | tSu | | 1 | R56C85[1][B] | camera/bridge/latest_16_s0

Path Statistics:

Clock Skew | -0.006
Setup Relationship | 8.000
Logic Level | 1
Arrival Clock Path Delay | cell: 0.000, 0.000%; route: 3.369, 100.000%
Arrival Data Path Delay | cell: 0.000, 0.000%; route: 3.320, 90.941%; tC2Q: 0.331, 9.059%
Required Clock Path Delay | cell: 0.000, 0.000%; route: 3.363, 100.000%

### Path19

Path Summary:

Slack | 4.030
Data Arrival Time | 10.856
Data Required Time | 14.886
From | camera/perception_reset/release_pipe_2_s0
To | camera/bridge/latest_17_s0
Launch Clk | eth125:[R]
Latch Clk | eth125:[R]

Data Arrival Path:

AT | DELAY | TYPE | RF | FANOUT | LOC | NODE
0.000 | 0.000 | | | | | active clock edge time
0.000 | 0.000 | | | | | eth125
3.835 | 3.835 | tCL | RR | 5898 | PLL_B[2] | camera/pll/PLL_inst/CLKOUT1
7.204 | 3.369 | tNET | RR | 1 | R39C78[1][B] | camera/perception_reset/release_pipe_2_s0/CLK
7.535 | 0.331 | tC2Q | RF | 2032 | R39C78[1][B] | camera/perception_reset/release_pipe_2_s0/Q
10.856 | 3.320 | tNET | FF | 1 | R56C83[2][B] | camera/bridge/latest_17_s0/CLEAR

Data Required Path:

AT | DELAY | TYPE | RF | FANOUT | LOC | NODE
8.000 | 8.000 | | | | | active clock edge time
8.000 | 0.000 | | | | | eth125
11.835 | 3.835 | tCL | RR | 5898 | PLL_B[2] | camera/pll/PLL_inst/CLKOUT1
15.198 | 3.363 | tNET | RR | 1 | R56C83[2][B] | camera/bridge/latest_17_s0/CLK
14.886 | -0.313 | tSu | | 1 | R56C83[2][B] | camera/bridge/latest_17_s0

Path Statistics:

Clock Skew | -0.006
Setup Relationship | 8.000
Logic Level | 1
Arrival Clock Path Delay | cell: 0.000, 0.000%; route: 3.369, 100.000%
Arrival Data Path Delay | cell: 0.000, 0.000%; route: 3.320, 90.941%; tC2Q: 0.331, 9.059%
Required Clock Path Delay | cell: 0.000, 0.000%; route: 3.363, 100.000%

### Path20

Path Summary:

Slack | 4.030
Data Arrival Time | 10.856
Data Required Time | 14.886
From | camera/perception_reset/release_pipe_2_s0
To | camera/bridge/latest_35_s0
Launch Clk | eth125:[R]
Latch Clk | eth125:[R]

Data Arrival Path:

AT | DELAY | TYPE | RF | FANOUT | LOC | NODE
0.000 | 0.000 | | | | | active clock edge time
0.000 | 0.000 | | | | | eth125
3.835 | 3.835 | tCL | RR | 5898 | PLL_B[2] | camera/pll/PLL_inst/CLKOUT1
7.204 | 3.369 | tNET | RR | 1 | R39C78[1][B] | camera/perception_reset/release_pipe_2_s0/CLK
7.535 | 0.331 | tC2Q | RF | 2032 | R39C78[1][B] | camera/perception_reset/release_pipe_2_s0/Q
10.856 | 3.320 | tNET | FF | 1 | R56C85[0][A] | camera/bridge/latest_35_s0/CLEAR

Data Required Path:

AT | DELAY | TYPE | RF | FANOUT | LOC | NODE
8.000 | 8.000 | | | | | active clock edge time
8.000 | 0.000 | | | | | eth125
11.835 | 3.835 | tCL | RR | 5898 | PLL_B[2] | camera/pll/PLL_inst/CLKOUT1
15.198 | 3.363 | tNET | RR | 1 | R56C85[0][A] | camera/bridge/latest_35_s0/CLK
14.886 | -0.313 | tSu | | 1 | R56C85[0][A] | camera/bridge/latest_35_s0

Path Statistics:

Clock Skew | -0.006
Setup Relationship | 8.000
Logic Level | 1
Arrival Clock Path Delay | cell: 0.000, 0.000%; route: 3.369, 100.000%
Arrival Data Path Delay | cell: 0.000, 0.000%; route: 3.320, 90.941%; tC2Q: 0.331, 9.059%
Required Clock Path Delay | cell: 0.000, 0.000%; route: 3.363, 100.000%

### Path21

Path Summary:

Slack | 4.030
Data Arrival Time | 10.856
Data Required Time | 14.886
From | camera/perception_reset/release_pipe_2_s0
To | camera/bridge/latest_37_s0
Launch Clk | eth125:[R]
Latch Clk | eth125:[R]

Data Arrival Path:

AT | DELAY | TYPE | RF | FANOUT | LOC | NODE
0.000 | 0.000 | | | | | active clock edge time
0.000 | 0.000 | | | | | eth125
3.835 | 3.835 | tCL | RR | 5898 | PLL_B[2] | camera/pll/PLL_inst/CLKOUT1
7.204 | 3.369 | tNET | RR | 1 | R39C78[1][B] | camera/perception_reset/release_pipe_2_s0/CLK
7.535 | 0.331 | tC2Q | RF | 2032 | R39C78[1][B] | camera/perception_reset/release_pipe_2_s0/Q
10.856 | 3.320 | tNET | FF | 1 | R56C85[1][A] | camera/bridge/latest_37_s0/CLEAR

Data Required Path:

AT | DELAY | TYPE | RF | FANOUT | LOC | NODE
8.000 | 8.000 | | | | | active clock edge time
8.000 | 0.000 | | | | | eth125
11.835 | 3.835 | tCL | RR | 5898 | PLL_B[2] | camera/pll/PLL_inst/CLKOUT1
15.198 | 3.363 | tNET | RR | 1 | R56C85[1][A] | camera/bridge/latest_37_s0/CLK
14.886 | -0.313 | tSu | | 1 | R56C85[1][A] | camera/bridge/latest_37_s0

Path Statistics:

Clock Skew | -0.006
Setup Relationship | 8.000
Logic Level | 1
Arrival Clock Path Delay | cell: 0.000, 0.000%; route: 3.369, 100.000%
Arrival Data Path Delay | cell: 0.000, 0.000%; route: 3.320, 90.941%; tC2Q: 0.331, 9.059%
Required Clock Path Delay | cell: 0.000, 0.000%; route: 3.363, 100.000%

### Path22

Path Summary:

Slack | 4.030
Data Arrival Time | 10.856
Data Required Time | 14.886
From | camera/perception_reset/release_pipe_2_s0
To | camera/bridge/latest_38_s0
Launch Clk | eth125:[R]
Latch Clk | eth125:[R]

Data Arrival Path:

AT | DELAY | TYPE | RF | FANOUT | LOC | NODE
0.000 | 0.000 | | | | | active clock edge time
0.000 | 0.000 | | | | | eth125
3.835 | 3.835 | tCL | RR | 5898 | PLL_B[2] | camera/pll/PLL_inst/CLKOUT1
7.204 | 3.369 | tNET | RR | 1 | R39C78[1][B] | camera/perception_reset/release_pipe_2_s0/CLK
7.535 | 0.331 | tC2Q | RF | 2032 | R39C78[1][B] | camera/perception_reset/release_pipe_2_s0/Q
10.856 | 3.320 | tNET | FF | 1 | R56C83[2][A] | camera/bridge/latest_38_s0/CLEAR

Data Required Path:

AT | DELAY | TYPE | RF | FANOUT | LOC | NODE
8.000 | 8.000 | | | | | active clock edge time
8.000 | 0.000 | | | | | eth125
11.835 | 3.835 | tCL | RR | 5898 | PLL_B[2] | camera/pll/PLL_inst/CLKOUT1
15.198 | 3.363 | tNET | RR | 1 | R56C83[2][A] | camera/bridge/latest_38_s0/CLK
14.886 | -0.313 | tSu | | 1 | R56C83[2][A] | camera/bridge/latest_38_s0

Path Statistics:

Clock Skew | -0.006
Setup Relationship | 8.000
Logic Level | 1
Arrival Clock Path Delay | cell: 0.000, 0.000%; route: 3.369, 100.000%
Arrival Data Path Delay | cell: 0.000, 0.000%; route: 3.320, 90.941%; tC2Q: 0.331, 9.059%
Required Clock Path Delay | cell: 0.000, 0.000%; route: 3.363, 100.000%

### Path23

Path Summary:

Slack | 4.030
Data Arrival Time | 10.856
Data Required Time | 14.886
From | camera/perception_reset/release_pipe_2_s0
To | camera/bridge/latest_39_s0
Launch Clk | eth125:[R]
Latch Clk | eth125:[R]

Data Arrival Path:

AT | DELAY | TYPE | RF | FANOUT | LOC | NODE
0.000 | 0.000 | | | | | active clock edge time
0.000 | 0.000 | | | | | eth125
3.835 | 3.835 | tCL | RR | 5898 | PLL_B[2] | camera/pll/PLL_inst/CLKOUT1
7.204 | 3.369 | tNET | RR | 1 | R39C78[1][B] | camera/perception_reset/release_pipe_2_s0/CLK
7.535 | 0.331 | tC2Q | RF | 2032 | R39C78[1][B] | camera/perception_reset/release_pipe_2_s0/Q
10.856 | 3.320 | tNET | FF | 1 | R56C83[0][A] | camera/bridge/latest_39_s0/CLEAR

Data Required Path:

AT | DELAY | TYPE | RF | FANOUT | LOC | NODE
8.000 | 8.000 | | | | | active clock edge time
8.000 | 0.000 | | | | | eth125
11.835 | 3.835 | tCL | RR | 5898 | PLL_B[2] | camera/pll/PLL_inst/CLKOUT1
15.198 | 3.363 | tNET | RR | 1 | R56C83[0][A] | camera/bridge/latest_39_s0/CLK
14.886 | -0.313 | tSu | | 1 | R56C83[0][A] | camera/bridge/latest_39_s0

Path Statistics:

Clock Skew | -0.006
Setup Relationship | 8.000
Logic Level | 1
Arrival Clock Path Delay | cell: 0.000, 0.000%; route: 3.369, 100.000%
Arrival Data Path Delay | cell: 0.000, 0.000%; route: 3.320, 90.941%; tC2Q: 0.331, 9.059%
Required Clock Path Delay | cell: 0.000, 0.000%; route: 3.363, 100.000%

### Path24

Path Summary:

Slack | 4.030
Data Arrival Time | 10.864
Data Required Time | 14.894
From | camera/perception_reset/release_pipe_2_s0
To | camera/bridge/latest_77_s0
Launch Clk | eth125:[R]
Latch Clk | eth125:[R]

Data Arrival Path:

AT | DELAY | TYPE | RF | FANOUT | LOC | NODE
0.000 | 0.000 | | | | | active clock edge time
0.000 | 0.000 | | | | | eth125
3.835 | 3.835 | tCL | RR | 5898 | PLL_B[2] | camera/pll/PLL_inst/CLKOUT1
7.204 | 3.369 | tNET | RR | 1 | R39C78[1][B] | camera/perception_reset/release_pipe_2_s0/CLK
7.535 | 0.331 | tC2Q | RF | 2032 | R39C78[1][B] | camera/perception_reset/release_pipe_2_s0/Q
10.864 | 3.329 | tNET | FF | 1 | R56C74[2][A] | camera/bridge/latest_77_s0/CLEAR

Data Required Path:

AT | DELAY | TYPE | RF | FANOUT | LOC | NODE
8.000 | 8.000 | | | | | active clock edge time
8.000 | 0.000 | | | | | eth125
11.835 | 3.835 | tCL | RR | 5898 | PLL_B[2] | camera/pll/PLL_inst/CLKOUT1
15.207 | 3.372 | tNET | RR | 1 | R56C74[2][A] | camera/bridge/latest_77_s0/CLK
14.894 | -0.313 | tSu | | 1 | R56C74[2][A] | camera/bridge/latest_77_s0

Path Statistics:

Clock Skew | 0.002
Setup Relationship | 8.000
Logic Level | 1
Arrival Clock Path Delay | cell: 0.000, 0.000%; route: 3.369, 100.000%
Arrival Data Path Delay | cell: 0.000, 0.000%; route: 3.329, 90.962%; tC2Q: 0.331, 9.038%
Required Clock Path Delay | cell: 0.000, 0.000%; route: 3.372, 100.000%

### Path25

Path Summary:

Slack | 4.030
Data Arrival Time | 10.864
Data Required Time | 14.894
From | camera/perception_reset/release_pipe_2_s0
To | camera/bridge/latest_78_s0
Launch Clk | eth125:[R]
Latch Clk | eth125:[R]

Data Arrival Path:

AT | DELAY | TYPE | RF | FANOUT | LOC | NODE
0.000 | 0.000 | | | | | active clock edge time
0.000 | 0.000 | | | | | eth125
3.835 | 3.835 | tCL | RR | 5898 | PLL_B[2] | camera/pll/PLL_inst/CLKOUT1
7.204 | 3.369 | tNET | RR | 1 | R39C78[1][B] | camera/perception_reset/release_pipe_2_s0/CLK
7.535 | 0.331 | tC2Q | RF | 2032 | R39C78[1][B] | camera/perception_reset/release_pipe_2_s0/Q
10.864 | 3.329 | tNET | FF | 1 | R56C74[2][B] | camera/bridge/latest_78_s0/CLEAR

Data Required Path:

AT | DELAY | TYPE | RF | FANOUT | LOC | NODE
8.000 | 8.000 | | | | | active clock edge time
8.000 | 0.000 | | | | | eth125
11.835 | 3.835 | tCL | RR | 5898 | PLL_B[2] | camera/pll/PLL_inst/CLKOUT1
15.207 | 3.372 | tNET | RR | 1 | R56C74[2][B] | camera/bridge/latest_78_s0/CLK
14.894 | -0.313 | tSu | | 1 | R56C74[2][B] | camera/bridge/latest_78_s0

Path Statistics:

Clock Skew | 0.002
Setup Relationship | 8.000
Logic Level | 1
Arrival Clock Path Delay | cell: 0.000, 0.000%; route: 3.369, 100.000%
Arrival Data Path Delay | cell: 0.000, 0.000%; route: 3.329, 90.962%; tC2Q: 0.331, 9.038%
Required Clock Path Delay | cell: 0.000, 0.000%; route: 3.372, 100.000%

### Removal Analysis Report

#### Report Command:report_timing -removal -max_paths 25 -max_common_paths 1

### Path1

Path Summary:

Slack | 0.619
Data Arrival Time | 2.479
Data Required Time | 1.860
From | camera/runtime_network.receive_reset/release_pipe_2_s1
To | camera/runtime_network.net/write_mask_62_s0
Launch Clk | eth_rx125:[R]
Latch Clk | eth_rx125:[R]

Data Arrival Path:

AT | DELAY | TYPE | RF | FANOUT | LOC | NODE
0.000 | 0.000 | | | | | active clock edge time
0.000 | 0.000 | | | | | eth_rx125
0.000 | 0.000 | tCL | RR | 1 | IOB122[A] | rgmii_rxc_ibuf/I
0.608 | 0.608 | tINS | RR | 825 | IOB122[A] | rgmii_rxc_ibuf/O
1.927 | 1.319 | tNET | RR | 1 | R57C104[2][A] | camera/runtime_network.receive_reset/release_pipe_2_s1/CLK
2.057 | 0.130 | tC2Q | RR | 206 | R57C104[2][A] | camera/runtime_network.receive_reset/release_pipe_2_s1/Q
2.479 | 0.422 | tNET | RR | 1 | R70C86[1][A] | camera/runtime_network.net/write_mask_62_s0/CLEAR

Data Required Path:

AT | DELAY | TYPE | RF | FANOUT | LOC | NODE
0.000 | 0.000 | | | | | active clock edge time
0.000 | 0.000 | | | | | eth_rx125
0.000 | 0.000 | tCL | RR | 1 | IOB122[A] | rgmii_rxc_ibuf/I
0.608 | 0.608 | tINS | RR | 825 | IOB122[A] | rgmii_rxc_ibuf/O
1.908 | 1.300 | tNET | RR | 1 | R70C86[1][A] | camera/runtime_network.net/write_mask_62_s0/CLK
1.860 | -0.048 | tHld | | 1 | R70C86[1][A] | camera/runtime_network.net/write_mask_62_s0

Path Statistics:

Clock Skew | -0.020
Hold Relationship | 0.000
Logic Level | 1
Arrival Clock Path Delay | cell: 0.608, 31.543%; route: 1.319, 68.457%
Arrival Data Path Delay | cell: 0.000, 0.000%; route: 0.422, 76.509%; tC2Q: 0.130, 23.491%
Required Clock Path Delay | cell: 0.608, 31.867%; route: 1.300, 68.133%

### Path2

Path Summary:

Slack | 0.619
Data Arrival Time | 2.479
Data Required Time | 1.860
From | camera/runtime_network.receive_reset/release_pipe_2_s1
To | camera/runtime_network.net/write_mask_69_s0
Launch Clk | eth_rx125:[R]
Latch Clk | eth_rx125:[R]

Data Arrival Path:

AT | DELAY | TYPE | RF | FANOUT | LOC | NODE
0.000 | 0.000 | | | | | active clock edge time
0.000 | 0.000 | | | | | eth_rx125
0.000 | 0.000 | tCL | RR | 1 | IOB122[A] | rgmii_rxc_ibuf/I
0.608 | 0.608 | tINS | RR | 825 | IOB122[A] | rgmii_rxc_ibuf/O
1.927 | 1.319 | tNET | RR | 1 | R57C104[2][A] | camera/runtime_network.receive_reset/release_pipe_2_s1/CLK
2.057 | 0.130 | tC2Q | RR | 206 | R57C104[2][A] | camera/runtime_network.receive_reset/release_pipe_2_s1/Q
2.479 | 0.422 | tNET | RR | 1 | R70C86[2][A] | camera/runtime_network.net/write_mask_69_s0/CLEAR

Data Required Path:

AT | DELAY | TYPE | RF | FANOUT | LOC | NODE
0.000 | 0.000 | | | | | active clock edge time
0.000 | 0.000 | | | | | eth_rx125
0.000 | 0.000 | tCL | RR | 1 | IOB122[A] | rgmii_rxc_ibuf/I
0.608 | 0.608 | tINS | RR | 825 | IOB122[A] | rgmii_rxc_ibuf/O
1.908 | 1.300 | tNET | RR | 1 | R70C86[2][A] | camera/runtime_network.net/write_mask_69_s0/CLK
1.860 | -0.048 | tHld | | 1 | R70C86[2][A] | camera/runtime_network.net/write_mask_69_s0

Path Statistics:

Clock Skew | -0.020
Hold Relationship | 0.000
Logic Level | 1
Arrival Clock Path Delay | cell: 0.608, 31.543%; route: 1.319, 68.457%
Arrival Data Path Delay | cell: 0.000, 0.000%; route: 0.422, 76.509%; tC2Q: 0.130, 23.491%
Required Clock Path Delay | cell: 0.608, 31.867%; route: 1.300, 68.133%

### Path3

Path Summary:

Slack | 0.619
Data Arrival Time | 2.479
Data Required Time | 1.860
From | camera/runtime_network.receive_reset/release_pipe_2_s1
To | camera/runtime_network.net/write_mask_72_s0
Launch Clk | eth_rx125:[R]
Latch Clk | eth_rx125:[R]

Data Arrival Path:

AT | DELAY | TYPE | RF | FANOUT | LOC | NODE
0.000 | 0.000 | | | | | active clock edge time
0.000 | 0.000 | | | | | eth_rx125
0.000 | 0.000 | tCL | RR | 1 | IOB122[A] | rgmii_rxc_ibuf/I
0.608 | 0.608 | tINS | RR | 825 | IOB122[A] | rgmii_rxc_ibuf/O
1.927 | 1.319 | tNET | RR | 1 | R57C104[2][A] | camera/runtime_network.receive_reset/release_pipe_2_s1/CLK
2.057 | 0.130 | tC2Q | RR | 206 | R57C104[2][A] | camera/runtime_network.receive_reset/release_pipe_2_s1/Q
2.479 | 0.422 | tNET | RR | 1 | R70C86[3][A] | camera/runtime_network.net/write_mask_72_s0/CLEAR

Data Required Path:

AT | DELAY | TYPE | RF | FANOUT | LOC | NODE
0.000 | 0.000 | | | | | active clock edge time
0.000 | 0.000 | | | | | eth_rx125
0.000 | 0.000 | tCL | RR | 1 | IOB122[A] | rgmii_rxc_ibuf/I
0.608 | 0.608 | tINS | RR | 825 | IOB122[A] | rgmii_rxc_ibuf/O
1.908 | 1.300 | tNET | RR | 1 | R70C86[3][A] | camera/runtime_network.net/write_mask_72_s0/CLK
1.860 | -0.048 | tHld | | 1 | R70C86[3][A] | camera/runtime_network.net/write_mask_72_s0

Path Statistics:

Clock Skew | -0.020
Hold Relationship | 0.000
Logic Level | 1
Arrival Clock Path Delay | cell: 0.608, 31.543%; route: 1.319, 68.457%
Arrival Data Path Delay | cell: 0.000, 0.000%; route: 0.422, 76.509%; tC2Q: 0.130, 23.491%
Required Clock Path Delay | cell: 0.608, 31.867%; route: 1.300, 68.133%

### Path4

Path Summary:

Slack | 0.625
Data Arrival Time | 2.488
Data Required Time | 1.863
From | camera/runtime_network.receive_reset/release_pipe_2_s1
To | camera/runtime_network.net/write_mask_7_s0
Launch Clk | eth_rx125:[R]
Latch Clk | eth_rx125:[R]

Data Arrival Path:

AT | DELAY | TYPE | RF | FANOUT | LOC | NODE
0.000 | 0.000 | | | | | active clock edge time
0.000 | 0.000 | | | | | eth_rx125
0.000 | 0.000 | tCL | RR | 1 | IOB122[A] | rgmii_rxc_ibuf/I
0.608 | 0.608 | tINS | RR | 825 | IOB122[A] | rgmii_rxc_ibuf/O
1.927 | 1.319 | tNET | RR | 1 | R57C104[2][A] | camera/runtime_network.receive_reset/release_pipe_2_s1/CLK
2.057 | 0.130 | tC2Q | RR | 206 | R57C104[2][A] | camera/runtime_network.receive_reset/release_pipe_2_s1/Q
2.488 | 0.431 | tNET | RR | 1 | R70C93[1][A] | camera/runtime_network.net/write_mask_7_s0/CLEAR

Data Required Path:

AT | DELAY | TYPE | RF | FANOUT | LOC | NODE
0.000 | 0.000 | | | | | active clock edge time
0.000 | 0.000 | | | | | eth_rx125
0.000 | 0.000 | tCL | RR | 1 | IOB122[A] | rgmii_rxc_ibuf/I
0.608 | 0.608 | tINS | RR | 825 | IOB122[A] | rgmii_rxc_ibuf/O
1.910 | 1.303 | tNET | RR | 1 | R70C93[1][A] | camera/runtime_network.net/write_mask_7_s0/CLK
1.863 | -0.048 | tHld | | 1 | R70C93[1][A] | camera/runtime_network.net/write_mask_7_s0

Path Statistics:

Clock Skew | -0.017
Hold Relationship | 0.000
Logic Level | 1
Arrival Clock Path Delay | cell: 0.608, 31.543%; route: 1.319, 68.457%
Arrival Data Path Delay | cell: 0.000, 0.000%; route: 0.431, 76.886%; tC2Q: 0.130, 23.114%
Required Clock Path Delay | cell: 0.608, 31.822%; route: 1.303, 68.178%

### Path5

Path Summary:

Slack | 0.625
Data Arrival Time | 2.488
Data Required Time | 1.863
From | camera/runtime_network.receive_reset/release_pipe_2_s1
To | camera/runtime_network.net/write_mask_35_s0
Launch Clk | eth_rx125:[R]
Latch Clk | eth_rx125:[R]

Data Arrival Path:

AT | DELAY | TYPE | RF | FANOUT | LOC | NODE
0.000 | 0.000 | | | | | active clock edge time
0.000 | 0.000 | | | | | eth_rx125
0.000 | 0.000 | tCL | RR | 1 | IOB122[A] | rgmii_rxc_ibuf/I
0.608 | 0.608 | tINS | RR | 825 | IOB122[A] | rgmii_rxc_ibuf/O
1.927 | 1.319 | tNET | RR | 1 | R57C104[2][A] | camera/runtime_network.receive_reset/release_pipe_2_s1/CLK
2.057 | 0.130 | tC2Q | RR | 206 | R57C104[2][A] | camera/runtime_network.receive_reset/release_pipe_2_s1/Q
2.488 | 0.431 | tNET | RR | 1 | R70C93[2][B] | camera/runtime_network.net/write_mask_35_s0/CLEAR

Data Required Path:

AT | DELAY | TYPE | RF | FANOUT | LOC | NODE
0.000 | 0.000 | | | | | active clock edge time
0.000 | 0.000 | | | | | eth_rx125
0.000 | 0.000 | tCL | RR | 1 | IOB122[A] | rgmii_rxc_ibuf/I
0.608 | 0.608 | tINS | RR | 825 | IOB122[A] | rgmii_rxc_ibuf/O
1.910 | 1.303 | tNET | RR | 1 | R70C93[2][B] | camera/runtime_network.net/write_mask_35_s0/CLK
1.863 | -0.048 | tHld | | 1 | R70C93[2][B] | camera/runtime_network.net/write_mask_35_s0

Path Statistics:

Clock Skew | -0.017
Hold Relationship | 0.000
Logic Level | 1
Arrival Clock Path Delay | cell: 0.608, 31.543%; route: 1.319, 68.457%
Arrival Data Path Delay | cell: 0.000, 0.000%; route: 0.431, 76.886%; tC2Q: 0.130, 23.114%
Required Clock Path Delay | cell: 0.608, 31.822%; route: 1.303, 68.178%

### Path6

Path Summary:

Slack | 0.625
Data Arrival Time | 2.488
Data Required Time | 1.863
From | camera/runtime_network.receive_reset/release_pipe_2_s1
To | camera/runtime_network.net/write_mask_43_s0
Launch Clk | eth_rx125:[R]
Latch Clk | eth_rx125:[R]

Data Arrival Path:

AT | DELAY | TYPE | RF | FANOUT | LOC | NODE
0.000 | 0.000 | | | | | active clock edge time
0.000 | 0.000 | | | | | eth_rx125
0.000 | 0.000 | tCL | RR | 1 | IOB122[A] | rgmii_rxc_ibuf/I
0.608 | 0.608 | tINS | RR | 825 | IOB122[A] | rgmii_rxc_ibuf/O
1.927 | 1.319 | tNET | RR | 1 | R57C104[2][A] | camera/runtime_network.receive_reset/release_pipe_2_s1/CLK
2.057 | 0.130 | tC2Q | RR | 206 | R57C104[2][A] | camera/runtime_network.receive_reset/release_pipe_2_s1/Q
2.488 | 0.431 | tNET | RR | 1 | R70C93[2][A] | camera/runtime_network.net/write_mask_43_s0/CLEAR

Data Required Path:

AT | DELAY | TYPE | RF | FANOUT | LOC | NODE
0.000 | 0.000 | | | | | active clock edge time
0.000 | 0.000 | | | | | eth_rx125
0.000 | 0.000 | tCL | RR | 1 | IOB122[A] | rgmii_rxc_ibuf/I
0.608 | 0.608 | tINS | RR | 825 | IOB122[A] | rgmii_rxc_ibuf/O
1.910 | 1.303 | tNET | RR | 1 | R70C93[2][A] | camera/runtime_network.net/write_mask_43_s0/CLK
1.863 | -0.048 | tHld | | 1 | R70C93[2][A] | camera/runtime_network.net/write_mask_43_s0

Path Statistics:

Clock Skew | -0.017
Hold Relationship | 0.000
Logic Level | 1
Arrival Clock Path Delay | cell: 0.608, 31.543%; route: 1.319, 68.457%
Arrival Data Path Delay | cell: 0.000, 0.000%; route: 0.431, 76.886%; tC2Q: 0.130, 23.114%
Required Clock Path Delay | cell: 0.608, 31.822%; route: 1.303, 68.178%

### Path7

Path Summary:

Slack | 0.635
Data Arrival Time | 2.518
Data Required Time | 1.883
From | camera/runtime_network.receive_reset/release_pipe_2_s1
To | camera/runtime_network.net/rx_active_s1
Launch Clk | eth_rx125:[R]
Latch Clk | eth_rx125:[R]

Data Arrival Path:

AT | DELAY | TYPE | RF | FANOUT | LOC | NODE
0.000 | 0.000 | | | | | active clock edge time
0.000 | 0.000 | | | | | eth_rx125
0.000 | 0.000 | tCL | RR | 1 | IOB122[A] | rgmii_rxc_ibuf/I
0.608 | 0.608 | tINS | RR | 825 | IOB122[A] | rgmii_rxc_ibuf/O
1.927 | 1.319 | tNET | RR | 1 | R57C104[2][A] | camera/runtime_network.receive_reset/release_pipe_2_s1/CLK
2.057 | 0.130 | tC2Q | RR | 206 | R57C104[2][A] | camera/runtime_network.receive_reset/release_pipe_2_s1/Q
2.518 | 0.461 | tNET | RR | 1 | R78C90[1][B] | camera/runtime_network.net/rx_active_s1/CLEAR

Data Required Path:

AT | DELAY | TYPE | RF | FANOUT | LOC | NODE
0.000 | 0.000 | | | | | active clock edge time
0.000 | 0.000 | | | | | eth_rx125
0.000 | 0.000 | tCL | RR | 1 | IOB122[A] | rgmii_rxc_ibuf/I
0.608 | 0.608 | tINS | RR | 825 | IOB122[A] | rgmii_rxc_ibuf/O
1.930 | 1.322 | tNET | RR | 1 | R78C90[1][B] | camera/runtime_network.net/rx_active_s1/CLK
1.883 | -0.048 | tHld | | 1 | R78C90[1][B] | camera/runtime_network.net/rx_active_s1

Path Statistics:

Clock Skew | 0.003
Hold Relationship | 0.000
Logic Level | 1
Arrival Clock Path Delay | cell: 0.608, 31.543%; route: 1.319, 68.457%
Arrival Data Path Delay | cell: 0.000, 0.000%; route: 0.461, 78.049%; tC2Q: 0.130, 21.951%
Required Clock Path Delay | cell: 0.608, 31.496%; route: 1.322, 68.504%

### Path8

Path Summary:

Slack | 0.635
Data Arrival Time | 2.518
Data Required Time | 1.883
From | camera/runtime_network.receive_reset/release_pipe_2_s1
To | camera/runtime_network.net/rx_count_4_s2
Launch Clk | eth_rx125:[R]
Latch Clk | eth_rx125:[R]

Data Arrival Path:

AT | DELAY | TYPE | RF | FANOUT | LOC | NODE
0.000 | 0.000 | | | | | active clock edge time
0.000 | 0.000 | | | | | eth_rx125
0.000 | 0.000 | tCL | RR | 1 | IOB122[A] | rgmii_rxc_ibuf/I
0.608 | 0.608 | tINS | RR | 825 | IOB122[A] | rgmii_rxc_ibuf/O
1.927 | 1.319 | tNET | RR | 1 | R57C104[2][A] | camera/runtime_network.receive_reset/release_pipe_2_s1/CLK
2.057 | 0.130 | tC2Q | RR | 206 | R57C104[2][A] | camera/runtime_network.receive_reset/release_pipe_2_s1/Q
2.518 | 0.461 | tNET | RR | 1 | R78C90[0][B] | camera/runtime_network.net/rx_count_4_s2/CLEAR

Data Required Path:

AT | DELAY | TYPE | RF | FANOUT | LOC | NODE
0.000 | 0.000 | | | | | active clock edge time
0.000 | 0.000 | | | | | eth_rx125
0.000 | 0.000 | tCL | RR | 1 | IOB122[A] | rgmii_rxc_ibuf/I
0.608 | 0.608 | tINS | RR | 825 | IOB122[A] | rgmii_rxc_ibuf/O
1.930 | 1.322 | tNET | RR | 1 | R78C90[0][B] | camera/runtime_network.net/rx_count_4_s2/CLK
1.883 | -0.048 | tHld | | 1 | R78C90[0][B] | camera/runtime_network.net/rx_count_4_s2

Path Statistics:

Clock Skew | 0.003
Hold Relationship | 0.000
Logic Level | 1
Arrival Clock Path Delay | cell: 0.608, 31.543%; route: 1.319, 68.457%
Arrival Data Path Delay | cell: 0.000, 0.000%; route: 0.461, 78.049%; tC2Q: 0.130, 21.951%
Required Clock Path Delay | cell: 0.608, 31.496%; route: 1.322, 68.504%

### Path9

Path Summary:

Slack | 0.635
Data Arrival Time | 2.518
Data Required Time | 1.883
From | camera/runtime_network.receive_reset/release_pipe_2_s1
To | camera/runtime_network.net/rx_count_5_s2
Launch Clk | eth_rx125:[R]
Latch Clk | eth_rx125:[R]

Data Arrival Path:

AT | DELAY | TYPE | RF | FANOUT | LOC | NODE
0.000 | 0.000 | | | | | active clock edge time
0.000 | 0.000 | | | | | eth_rx125
0.000 | 0.000 | tCL | RR | 1 | IOB122[A] | rgmii_rxc_ibuf/I
0.608 | 0.608 | tINS | RR | 825 | IOB122[A] | rgmii_rxc_ibuf/O
1.927 | 1.319 | tNET | RR | 1 | R57C104[2][A] | camera/runtime_network.receive_reset/release_pipe_2_s1/CLK
2.057 | 0.130 | tC2Q | RR | 206 | R57C104[2][A] | camera/runtime_network.receive_reset/release_pipe_2_s1/Q
2.518 | 0.461 | tNET | RR | 1 | R78C90[0][A] | camera/runtime_network.net/rx_count_5_s2/CLEAR

Data Required Path:

AT | DELAY | TYPE | RF | FANOUT | LOC | NODE
0.000 | 0.000 | | | | | active clock edge time
0.000 | 0.000 | | | | | eth_rx125
0.000 | 0.000 | tCL | RR | 1 | IOB122[A] | rgmii_rxc_ibuf/I
0.608 | 0.608 | tINS | RR | 825 | IOB122[A] | rgmii_rxc_ibuf/O
1.930 | 1.322 | tNET | RR | 1 | R78C90[0][A] | camera/runtime_network.net/rx_count_5_s2/CLK
1.883 | -0.048 | tHld | | 1 | R78C90[0][A] | camera/runtime_network.net/rx_count_5_s2

Path Statistics:

Clock Skew | 0.003
Hold Relationship | 0.000
Logic Level | 1
Arrival Clock Path Delay | cell: 0.608, 31.543%; route: 1.319, 68.457%
Arrival Data Path Delay | cell: 0.000, 0.000%; route: 0.461, 78.049%; tC2Q: 0.130, 21.951%
Required Clock Path Delay | cell: 0.608, 31.496%; route: 1.322, 68.504%

### Path10

Path Summary:

Slack | 0.635
Data Arrival Time | 2.518
Data Required Time | 1.883
From | camera/runtime_network.receive_reset/release_pipe_2_s1
To | camera/runtime_network.net/rx_count_7_s0
Launch Clk | eth_rx125:[R]
Latch Clk | eth_rx125:[R]

Data Arrival Path:

AT | DELAY | TYPE | RF | FANOUT | LOC | NODE
0.000 | 0.000 | | | | | active clock edge time
0.000 | 0.000 | | | | | eth_rx125
0.000 | 0.000 | tCL | RR | 1 | IOB122[A] | rgmii_rxc_ibuf/I
0.608 | 0.608 | tINS | RR | 825 | IOB122[A] | rgmii_rxc_ibuf/O
1.927 | 1.319 | tNET | RR | 1 | R57C104[2][A] | camera/runtime_network.receive_reset/release_pipe_2_s1/CLK
2.057 | 0.130 | tC2Q | RR | 206 | R57C104[2][A] | camera/runtime_network.receive_reset/release_pipe_2_s1/Q
2.518 | 0.461 | tNET | RR | 1 | R78C90[2][A] | camera/runtime_network.net/rx_count_7_s0/CLEAR

Data Required Path:

AT | DELAY | TYPE | RF | FANOUT | LOC | NODE
0.000 | 0.000 | | | | | active clock edge time
0.000 | 0.000 | | | | | eth_rx125
0.000 | 0.000 | tCL | RR | 1 | IOB122[A] | rgmii_rxc_ibuf/I
0.608 | 0.608 | tINS | RR | 825 | IOB122[A] | rgmii_rxc_ibuf/O
1.930 | 1.322 | tNET | RR | 1 | R78C90[2][A] | camera/runtime_network.net/rx_count_7_s0/CLK
1.883 | -0.048 | tHld | | 1 | R78C90[2][A] | camera/runtime_network.net/rx_count_7_s0

Path Statistics:

Clock Skew | 0.003
Hold Relationship | 0.000
Logic Level | 1
Arrival Clock Path Delay | cell: 0.608, 31.543%; route: 1.319, 68.457%
Arrival Data Path Delay | cell: 0.000, 0.000%; route: 0.461, 78.049%; tC2Q: 0.130, 21.951%
Required Clock Path Delay | cell: 0.608, 31.496%; route: 1.322, 68.504%

### Path11

Path Summary:

Slack | 0.643
Data Arrival Time | 2.521
Data Required Time | 1.878
From | camera/runtime_network.receive_reset/release_pipe_2_s1
To | camera/runtime_network.net/write_byte_0_s1
Launch Clk | eth_rx125:[R]
Latch Clk | eth_rx125:[R]

Data Arrival Path:

AT | DELAY | TYPE | RF | FANOUT | LOC | NODE
0.000 | 0.000 | | | | | active clock edge time
0.000 | 0.000 | | | | | eth_rx125
0.000 | 0.000 | tCL | RR | 1 | IOB122[A] | rgmii_rxc_ibuf/I
0.608 | 0.608 | tINS | RR | 825 | IOB122[A] | rgmii_rxc_ibuf/O
1.927 | 1.319 | tNET | RR | 1 | R57C104[2][A] | camera/runtime_network.receive_reset/release_pipe_2_s1/CLK
2.057 | 0.130 | tC2Q | RR | 206 | R57C104[2][A] | camera/runtime_network.receive_reset/release_pipe_2_s1/Q
2.521 | 0.464 | tNET | RR | 1 | R76C96[0][A] | camera/runtime_network.net/write_byte_0_s1/CLEAR

Data Required Path:

AT | DELAY | TYPE | RF | FANOUT | LOC | NODE
0.000 | 0.000 | | | | | active clock edge time
0.000 | 0.000 | | | | | eth_rx125
0.000 | 0.000 | tCL | RR | 1 | IOB122[A] | rgmii_rxc_ibuf/I
0.608 | 0.608 | tINS | RR | 825 | IOB122[A] | rgmii_rxc_ibuf/O
1.926 | 1.318 | tNET | RR | 1 | R76C96[0][A] | camera/runtime_network.net/write_byte_0_s1/CLK
1.878 | -0.048 | tHld | | 1 | R76C96[0][A] | camera/runtime_network.net/write_byte_0_s1

Path Statistics:

Clock Skew | -0.002
Hold Relationship | 0.000
Logic Level | 1
Arrival Clock Path Delay | cell: 0.608, 31.543%; route: 1.319, 68.457%
Arrival Data Path Delay | cell: 0.000, 0.000%; route: 0.464, 78.182%; tC2Q: 0.130, 21.818%
Required Clock Path Delay | cell: 0.608, 31.569%; route: 1.318, 68.431%

### Path12

Path Summary:

Slack | 0.644
Data Arrival Time | 2.528
Data Required Time | 1.883
From | camera/runtime_network.receive_reset/release_pipe_2_s1
To | camera/runtime_network.net/write_mask_0_s0
Launch Clk | eth_rx125:[R]
Latch Clk | eth_rx125:[R]

Data Arrival Path:

AT | DELAY | TYPE | RF | FANOUT | LOC | NODE
0.000 | 0.000 | | | | | active clock edge time
0.000 | 0.000 | | | | | eth_rx125
0.000 | 0.000 | tCL | RR | 1 | IOB122[A] | rgmii_rxc_ibuf/I
0.608 | 0.608 | tINS | RR | 825 | IOB122[A] | rgmii_rxc_ibuf/O
1.927 | 1.319 | tNET | RR | 1 | R57C104[2][A] | camera/runtime_network.receive_reset/release_pipe_2_s1/CLK
2.057 | 0.130 | tC2Q | RR | 206 | R57C104[2][A] | camera/runtime_network.receive_reset/release_pipe_2_s1/Q
2.528 | 0.471 | tNET | RR | 1 | R77C92[0][A] | camera/runtime_network.net/write_mask_0_s0/CLEAR

Data Required Path:

AT | DELAY | TYPE | RF | FANOUT | LOC | NODE
0.000 | 0.000 | | | | | active clock edge time
0.000 | 0.000 | | | | | eth_rx125
0.000 | 0.000 | tCL | RR | 1 | IOB122[A] | rgmii_rxc_ibuf/I
0.608 | 0.608 | tINS | RR | 825 | IOB122[A] | rgmii_rxc_ibuf/O
1.931 | 1.323 | tNET | RR | 1 | R77C92[0][A] | camera/runtime_network.net/write_mask_0_s0/CLK
1.883 | -0.048 | tHld | | 1 | R77C92[0][A] | camera/runtime_network.net/write_mask_0_s0

Path Statistics:

Clock Skew | 0.004
Hold Relationship | 0.000
Logic Level | 1
Arrival Clock Path Delay | cell: 0.608, 31.543%; route: 1.319, 68.457%
Arrival Data Path Delay | cell: 0.000, 0.000%; route: 0.471, 78.411%; tC2Q: 0.130, 21.589%
Required Clock Path Delay | cell: 0.608, 31.485%; route: 1.323, 68.515%

### Path13

Path Summary:

Slack | 0.644
Data Arrival Time | 2.528
Data Required Time | 1.883
From | camera/runtime_network.receive_reset/release_pipe_2_s1
To | camera/runtime_network.net/write_mask_6_s0
Launch Clk | eth_rx125:[R]
Latch Clk | eth_rx125:[R]

Data Arrival Path:

AT | DELAY | TYPE | RF | FANOUT | LOC | NODE
0.000 | 0.000 | | | | | active clock edge time
0.000 | 0.000 | | | | | eth_rx125
0.000 | 0.000 | tCL | RR | 1 | IOB122[A] | rgmii_rxc_ibuf/I
0.608 | 0.608 | tINS | RR | 825 | IOB122[A] | rgmii_rxc_ibuf/O
1.927 | 1.319 | tNET | RR | 1 | R57C104[2][A] | camera/runtime_network.receive_reset/release_pipe_2_s1/CLK
2.057 | 0.130 | tC2Q | RR | 206 | R57C104[2][A] | camera/runtime_network.receive_reset/release_pipe_2_s1/Q
2.528 | 0.471 | tNET | RR | 1 | R77C92[1][A] | camera/runtime_network.net/write_mask_6_s0/CLEAR

Data Required Path:

AT | DELAY | TYPE | RF | FANOUT | LOC | NODE
0.000 | 0.000 | | | | | active clock edge time
0.000 | 0.000 | | | | | eth_rx125
0.000 | 0.000 | tCL | RR | 1 | IOB122[A] | rgmii_rxc_ibuf/I
0.608 | 0.608 | tINS | RR | 825 | IOB122[A] | rgmii_rxc_ibuf/O
1.931 | 1.323 | tNET | RR | 1 | R77C92[1][A] | camera/runtime_network.net/write_mask_6_s0/CLK
1.883 | -0.048 | tHld | | 1 | R77C92[1][A] | camera/runtime_network.net/write_mask_6_s0

Path Statistics:

Clock Skew | 0.004
Hold Relationship | 0.000
Logic Level | 1
Arrival Clock Path Delay | cell: 0.608, 31.543%; route: 1.319, 68.457%
Arrival Data Path Delay | cell: 0.000, 0.000%; route: 0.471, 78.411%; tC2Q: 0.130, 21.589%
Required Clock Path Delay | cell: 0.608, 31.485%; route: 1.323, 68.515%

### Path14

Path Summary:

Slack | 0.644
Data Arrival Time | 2.528
Data Required Time | 1.883
From | camera/runtime_network.receive_reset/release_pipe_2_s1
To | camera/runtime_network.net/write_mask_15_s0
Launch Clk | eth_rx125:[R]
Latch Clk | eth_rx125:[R]

Data Arrival Path:

AT | DELAY | TYPE | RF | FANOUT | LOC | NODE
0.000 | 0.000 | | | | | active clock edge time
0.000 | 0.000 | | | | | eth_rx125
0.000 | 0.000 | tCL | RR | 1 | IOB122[A] | rgmii_rxc_ibuf/I
0.608 | 0.608 | tINS | RR | 825 | IOB122[A] | rgmii_rxc_ibuf/O
1.927 | 1.319 | tNET | RR | 1 | R57C104[2][A] | camera/runtime_network.receive_reset/release_pipe_2_s1/CLK
2.057 | 0.130 | tC2Q | RR | 206 | R57C104[2][A] | camera/runtime_network.receive_reset/release_pipe_2_s1/Q
2.528 | 0.471 | tNET | RR | 1 | R77C92[1][B] | camera/runtime_network.net/write_mask_15_s0/CLEAR

Data Required Path:

AT | DELAY | TYPE | RF | FANOUT | LOC | NODE
0.000 | 0.000 | | | | | active clock edge time
0.000 | 0.000 | | | | | eth_rx125
0.000 | 0.000 | tCL | RR | 1 | IOB122[A] | rgmii_rxc_ibuf/I
0.608 | 0.608 | tINS | RR | 825 | IOB122[A] | rgmii_rxc_ibuf/O
1.931 | 1.323 | tNET | RR | 1 | R77C92[1][B] | camera/runtime_network.net/write_mask_15_s0/CLK
1.883 | -0.048 | tHld | | 1 | R77C92[1][B] | camera/runtime_network.net/write_mask_15_s0

Path Statistics:

Clock Skew | 0.004
Hold Relationship | 0.000
Logic Level | 1
Arrival Clock Path Delay | cell: 0.608, 31.543%; route: 1.319, 68.457%
Arrival Data Path Delay | cell: 0.000, 0.000%; route: 0.471, 78.411%; tC2Q: 0.130, 21.589%
Required Clock Path Delay | cell: 0.608, 31.485%; route: 1.323, 68.515%

### Path15

Path Summary:

Slack | 0.656
Data Arrival Time | 2.511
Data Required Time | 1.854
From | camera/runtime_network.receive_reset/release_pipe_2_s1
To | camera/runtime_network.net/ack_sync1_s0
Launch Clk | eth_rx125:[R]
Latch Clk | eth_rx125:[R]

Data Arrival Path:

AT | DELAY | TYPE | RF | FANOUT | LOC | NODE
0.000 | 0.000 | | | | | active clock edge time
0.000 | 0.000 | | | | | eth_rx125
0.000 | 0.000 | tCL | RR | 1 | IOB122[A] | rgmii_rxc_ibuf/I
0.608 | 0.608 | tINS | RR | 825 | IOB122[A] | rgmii_rxc_ibuf/O
1.927 | 1.319 | tNET | RR | 1 | R57C104[2][A] | camera/runtime_network.receive_reset/release_pipe_2_s1/CLK
2.057 | 0.130 | tC2Q | RR | 206 | R57C104[2][A] | camera/runtime_network.receive_reset/release_pipe_2_s1/Q
2.511 | 0.454 | tNET | RR | 1 | R67C97[1][A] | camera/runtime_network.net/ack_sync1_s0/CLEAR

Data Required Path:

AT | DELAY | TYPE | RF | FANOUT | LOC | NODE
0.000 | 0.000 | | | | | active clock edge time
0.000 | 0.000 | | | | | eth_rx125
0.000 | 0.000 | tCL | RR | 1 | IOB122[A] | rgmii_rxc_ibuf/I
0.608 | 0.608 | tINS | RR | 825 | IOB122[A] | rgmii_rxc_ibuf/O
1.902 | 1.294 | tNET | RR | 1 | R67C97[1][A] | camera/runtime_network.net/ack_sync1_s0/CLK
1.854 | -0.048 | tHld | | 1 | R67C97[1][A] | camera/runtime_network.net/ack_sync1_s0

Path Statistics:

Clock Skew | -0.025
Hold Relationship | 0.000
Logic Level | 1
Arrival Clock Path Delay | cell: 0.608, 31.543%; route: 1.319, 68.457%
Arrival Data Path Delay | cell: 0.000, 0.000%; route: 0.454, 77.778%; tC2Q: 0.130, 22.222%
Required Clock Path Delay | cell: 0.608, 31.961%; route: 1.294, 68.039%

### Path16

Path Summary:

Slack | 0.656
Data Arrival Time | 2.511
Data Required Time | 1.854
From | camera/runtime_network.receive_reset/release_pipe_2_s1
To | camera/runtime_network.net/ack_sync0_s0
Launch Clk | eth_rx125:[R]
Latch Clk | eth_rx125:[R]

Data Arrival Path:

AT | DELAY | TYPE | RF | FANOUT | LOC | NODE
0.000 | 0.000 | | | | | active clock edge time
0.000 | 0.000 | | | | | eth_rx125
0.000 | 0.000 | tCL | RR | 1 | IOB122[A] | rgmii_rxc_ibuf/I
0.608 | 0.608 | tINS | RR | 825 | IOB122[A] | rgmii_rxc_ibuf/O
1.927 | 1.319 | tNET | RR | 1 | R57C104[2][A] | camera/runtime_network.receive_reset/release_pipe_2_s1/CLK
2.057 | 0.130 | tC2Q | RR | 206 | R57C104[2][A] | camera/runtime_network.receive_reset/release_pipe_2_s1/Q
2.511 | 0.454 | tNET | RR | 1 | R67C97[1][B] | camera/runtime_network.net/ack_sync0_s0/CLEAR

Data Required Path:

AT | DELAY | TYPE | RF | FANOUT | LOC | NODE
0.000 | 0.000 | | | | | active clock edge time
0.000 | 0.000 | | | | | eth_rx125
0.000 | 0.000 | tCL | RR | 1 | IOB122[A] | rgmii_rxc_ibuf/I
0.608 | 0.608 | tINS | RR | 825 | IOB122[A] | rgmii_rxc_ibuf/O
1.902 | 1.294 | tNET | RR | 1 | R67C97[1][B] | camera/runtime_network.net/ack_sync0_s0/CLK
1.854 | -0.048 | tHld | | 1 | R67C97[1][B] | camera/runtime_network.net/ack_sync0_s0

Path Statistics:

Clock Skew | -0.025
Hold Relationship | 0.000
Logic Level | 1
Arrival Clock Path Delay | cell: 0.608, 31.543%; route: 1.319, 68.457%
Arrival Data Path Delay | cell: 0.000, 0.000%; route: 0.454, 77.778%; tC2Q: 0.130, 22.222%
Required Clock Path Delay | cell: 0.608, 31.961%; route: 1.294, 68.039%

### Path17

Path Summary:

Slack | 0.669
Data Arrival Time | 2.551
Data Required Time | 1.882
From | camera/runtime_network.receive_reset/release_pipe_2_s1
To | camera/runtime_network.net/write_byte_2_s2
Launch Clk | eth_rx125:[R]
Latch Clk | eth_rx125:[R]

Data Arrival Path:

AT | DELAY | TYPE | RF | FANOUT | LOC | NODE
0.000 | 0.000 | | | | | active clock edge time
0.000 | 0.000 | | | | | eth_rx125
0.000 | 0.000 | tCL | RR | 1 | IOB122[A] | rgmii_rxc_ibuf/I
0.608 | 0.608 | tINS | RR | 825 | IOB122[A] | rgmii_rxc_ibuf/O
1.927 | 1.319 | tNET | RR | 1 | R57C104[2][A] | camera/runtime_network.receive_reset/release_pipe_2_s1/CLK
2.057 | 0.130 | tC2Q | RR | 206 | R57C104[2][A] | camera/runtime_network.receive_reset/release_pipe_2_s1/Q
2.551 | 0.494 | tNET | RR | 1 | R76C97[1][A] | camera/runtime_network.net/write_byte_2_s2/CLEAR

Data Required Path:

AT | DELAY | TYPE | RF | FANOUT | LOC | NODE
0.000 | 0.000 | | | | | active clock edge time
0.000 | 0.000 | | | | | eth_rx125
0.000 | 0.000 | tCL | RR | 1 | IOB122[A] | rgmii_rxc_ibuf/I
0.608 | 0.608 | tINS | RR | 825 | IOB122[A] | rgmii_rxc_ibuf/O
1.929 | 1.321 | tNET | RR | 1 | R76C97[1][A] | camera/runtime_network.net/write_byte_2_s2/CLK
1.882 | -0.048 | tHld | | 1 | R76C97[1][A] | camera/runtime_network.net/write_byte_2_s2

Path Statistics:

Clock Skew | 0.002
Hold Relationship | 0.000
Logic Level | 1
Arrival Clock Path Delay | cell: 0.608, 31.543%; route: 1.319, 68.457%
Arrival Data Path Delay | cell: 0.000, 0.000%; route: 0.494, 79.221%; tC2Q: 0.130, 20.779%
Required Clock Path Delay | cell: 0.608, 31.510%; route: 1.321, 68.490%

### Path18

Path Summary:

Slack | 0.669
Data Arrival Time | 2.551
Data Required Time | 1.882
From | camera/runtime_network.receive_reset/release_pipe_2_s1
To | camera/runtime_network.net/write_byte_2_s1
Launch Clk | eth_rx125:[R]
Latch Clk | eth_rx125:[R]

Data Arrival Path:

AT | DELAY | TYPE | RF | FANOUT | LOC | NODE
0.000 | 0.000 | | | | | active clock edge time
0.000 | 0.000 | | | | | eth_rx125
0.000 | 0.000 | tCL | RR | 1 | IOB122[A] | rgmii_rxc_ibuf/I
0.608 | 0.608 | tINS | RR | 825 | IOB122[A] | rgmii_rxc_ibuf/O
1.927 | 1.319 | tNET | RR | 1 | R57C104[2][A] | camera/runtime_network.receive_reset/release_pipe_2_s1/CLK
2.057 | 0.130 | tC2Q | RR | 206 | R57C104[2][A] | camera/runtime_network.receive_reset/release_pipe_2_s1/Q
2.551 | 0.494 | tNET | RR | 1 | R76C97[0][A] | camera/runtime_network.net/write_byte_2_s1/CLEAR

Data Required Path:

AT | DELAY | TYPE | RF | FANOUT | LOC | NODE
0.000 | 0.000 | | | | | active clock edge time
0.000 | 0.000 | | | | | eth_rx125
0.000 | 0.000 | tCL | RR | 1 | IOB122[A] | rgmii_rxc_ibuf/I
0.608 | 0.608 | tINS | RR | 825 | IOB122[A] | rgmii_rxc_ibuf/O
1.929 | 1.321 | tNET | RR | 1 | R76C97[0][A] | camera/runtime_network.net/write_byte_2_s1/CLK
1.882 | -0.048 | tHld | | 1 | R76C97[0][A] | camera/runtime_network.net/write_byte_2_s1

Path Statistics:

Clock Skew | 0.002
Hold Relationship | 0.000
Logic Level | 1
Arrival Clock Path Delay | cell: 0.608, 31.543%; route: 1.319, 68.457%
Arrival Data Path Delay | cell: 0.000, 0.000%; route: 0.494, 79.221%; tC2Q: 0.130, 20.779%
Required Clock Path Delay | cell: 0.608, 31.510%; route: 1.321, 68.490%

### Path19

Path Summary:

Slack | 0.669
Data Arrival Time | 2.551
Data Required Time | 1.882
From | camera/runtime_network.receive_reset/release_pipe_2_s1
To | camera/runtime_network.net/write_byte_3_s2
Launch Clk | eth_rx125:[R]
Latch Clk | eth_rx125:[R]

Data Arrival Path:

AT | DELAY | TYPE | RF | FANOUT | LOC | NODE
0.000 | 0.000 | | | | | active clock edge time
0.000 | 0.000 | | | | | eth_rx125
0.000 | 0.000 | tCL | RR | 1 | IOB122[A] | rgmii_rxc_ibuf/I
0.608 | 0.608 | tINS | RR | 825 | IOB122[A] | rgmii_rxc_ibuf/O
1.927 | 1.319 | tNET | RR | 1 | R57C104[2][A] | camera/runtime_network.receive_reset/release_pipe_2_s1/CLK
2.057 | 0.130 | tC2Q | RR | 206 | R57C104[2][A] | camera/runtime_network.receive_reset/release_pipe_2_s1/Q
2.551 | 0.494 | tNET | RR | 1 | R76C97[2][B] | camera/runtime_network.net/write_byte_3_s2/CLEAR

Data Required Path:

AT | DELAY | TYPE | RF | FANOUT | LOC | NODE
0.000 | 0.000 | | | | | active clock edge time
0.000 | 0.000 | | | | | eth_rx125
0.000 | 0.000 | tCL | RR | 1 | IOB122[A] | rgmii_rxc_ibuf/I
0.608 | 0.608 | tINS | RR | 825 | IOB122[A] | rgmii_rxc_ibuf/O
1.929 | 1.321 | tNET | RR | 1 | R76C97[2][B] | camera/runtime_network.net/write_byte_3_s2/CLK
1.882 | -0.048 | tHld | | 1 | R76C97[2][B] | camera/runtime_network.net/write_byte_3_s2

Path Statistics:

Clock Skew | 0.002
Hold Relationship | 0.000
Logic Level | 1
Arrival Clock Path Delay | cell: 0.608, 31.543%; route: 1.319, 68.457%
Arrival Data Path Delay | cell: 0.000, 0.000%; route: 0.494, 79.221%; tC2Q: 0.130, 20.779%
Required Clock Path Delay | cell: 0.608, 31.510%; route: 1.321, 68.490%

### Path20

Path Summary:

Slack | 0.669
Data Arrival Time | 2.551
Data Required Time | 1.882
From | camera/runtime_network.receive_reset/release_pipe_2_s1
To | camera/runtime_network.net/write_byte_3_s1
Launch Clk | eth_rx125:[R]
Latch Clk | eth_rx125:[R]

Data Arrival Path:

AT | DELAY | TYPE | RF | FANOUT | LOC | NODE
0.000 | 0.000 | | | | | active clock edge time
0.000 | 0.000 | | | | | eth_rx125
0.000 | 0.000 | tCL | RR | 1 | IOB122[A] | rgmii_rxc_ibuf/I
0.608 | 0.608 | tINS | RR | 825 | IOB122[A] | rgmii_rxc_ibuf/O
1.927 | 1.319 | tNET | RR | 1 | R57C104[2][A] | camera/runtime_network.receive_reset/release_pipe_2_s1/CLK
2.057 | 0.130 | tC2Q | RR | 206 | R57C104[2][A] | camera/runtime_network.receive_reset/release_pipe_2_s1/Q
2.551 | 0.494 | tNET | RR | 1 | R76C97[0][B] | camera/runtime_network.net/write_byte_3_s1/CLEAR

Data Required Path:

AT | DELAY | TYPE | RF | FANOUT | LOC | NODE
0.000 | 0.000 | | | | | active clock edge time
0.000 | 0.000 | | | | | eth_rx125
0.000 | 0.000 | tCL | RR | 1 | IOB122[A] | rgmii_rxc_ibuf/I
0.608 | 0.608 | tINS | RR | 825 | IOB122[A] | rgmii_rxc_ibuf/O
1.929 | 1.321 | tNET | RR | 1 | R76C97[0][B] | camera/runtime_network.net/write_byte_3_s1/CLK
1.882 | -0.048 | tHld | | 1 | R76C97[0][B] | camera/runtime_network.net/write_byte_3_s1

Path Statistics:

Clock Skew | 0.002
Hold Relationship | 0.000
Logic Level | 1
Arrival Clock Path Delay | cell: 0.608, 31.543%; route: 1.319, 68.457%
Arrival Data Path Delay | cell: 0.000, 0.000%; route: 0.494, 79.221%; tC2Q: 0.130, 20.779%
Required Clock Path Delay | cell: 0.608, 31.510%; route: 1.321, 68.490%

### Path21

Path Summary:

Slack | 0.669
Data Arrival Time | 2.551
Data Required Time | 1.882
From | camera/runtime_network.receive_reset/release_pipe_2_s1
To | camera/runtime_network.net/write_byte_6_s1
Launch Clk | eth_rx125:[R]
Latch Clk | eth_rx125:[R]

Data Arrival Path:

AT | DELAY | TYPE | RF | FANOUT | LOC | NODE
0.000 | 0.000 | | | | | active clock edge time
0.000 | 0.000 | | | | | eth_rx125
0.000 | 0.000 | tCL | RR | 1 | IOB122[A] | rgmii_rxc_ibuf/I
0.608 | 0.608 | tINS | RR | 825 | IOB122[A] | rgmii_rxc_ibuf/O
1.927 | 1.319 | tNET | RR | 1 | R57C104[2][A] | camera/runtime_network.receive_reset/release_pipe_2_s1/CLK
2.057 | 0.130 | tC2Q | RR | 206 | R57C104[2][A] | camera/runtime_network.receive_reset/release_pipe_2_s1/Q
2.551 | 0.494 | tNET | RR | 1 | R76C97[3][A] | camera/runtime_network.net/write_byte_6_s1/CLEAR

Data Required Path:

AT | DELAY | TYPE | RF | FANOUT | LOC | NODE
0.000 | 0.000 | | | | | active clock edge time
0.000 | 0.000 | | | | | eth_rx125
0.000 | 0.000 | tCL | RR | 1 | IOB122[A] | rgmii_rxc_ibuf/I
0.608 | 0.608 | tINS | RR | 825 | IOB122[A] | rgmii_rxc_ibuf/O
1.929 | 1.321 | tNET | RR | 1 | R76C97[3][A] | camera/runtime_network.net/write_byte_6_s1/CLK
1.882 | -0.048 | tHld | | 1 | R76C97[3][A] | camera/runtime_network.net/write_byte_6_s1

Path Statistics:

Clock Skew | 0.002
Hold Relationship | 0.000
Logic Level | 1
Arrival Clock Path Delay | cell: 0.608, 31.543%; route: 1.319, 68.457%
Arrival Data Path Delay | cell: 0.000, 0.000%; route: 0.494, 79.221%; tC2Q: 0.130, 20.779%
Required Clock Path Delay | cell: 0.608, 31.510%; route: 1.321, 68.490%

### Path22

Path Summary:

Slack | 0.669
Data Arrival Time | 2.551
Data Required Time | 1.882
From | camera/runtime_network.receive_reset/release_pipe_2_s1
To | camera/runtime_network.net/write_byte_7_s2
Launch Clk | eth_rx125:[R]
Latch Clk | eth_rx125:[R]

Data Arrival Path:

AT | DELAY | TYPE | RF | FANOUT | LOC | NODE
0.000 | 0.000 | | | | | active clock edge time
0.000 | 0.000 | | | | | eth_rx125
0.000 | 0.000 | tCL | RR | 1 | IOB122[A] | rgmii_rxc_ibuf/I
0.608 | 0.608 | tINS | RR | 825 | IOB122[A] | rgmii_rxc_ibuf/O
1.927 | 1.319 | tNET | RR | 1 | R57C104[2][A] | camera/runtime_network.receive_reset/release_pipe_2_s1/CLK
2.057 | 0.130 | tC2Q | RR | 206 | R57C104[2][A] | camera/runtime_network.receive_reset/release_pipe_2_s1/Q
2.551 | 0.494 | tNET | RR | 1 | R76C97[1][B] | camera/runtime_network.net/write_byte_7_s2/CLEAR

Data Required Path:

AT | DELAY | TYPE | RF | FANOUT | LOC | NODE
0.000 | 0.000 | | | | | active clock edge time
0.000 | 0.000 | | | | | eth_rx125
0.000 | 0.000 | tCL | RR | 1 | IOB122[A] | rgmii_rxc_ibuf/I
0.608 | 0.608 | tINS | RR | 825 | IOB122[A] | rgmii_rxc_ibuf/O
1.929 | 1.321 | tNET | RR | 1 | R76C97[1][B] | camera/runtime_network.net/write_byte_7_s2/CLK
1.882 | -0.048 | tHld | | 1 | R76C97[1][B] | camera/runtime_network.net/write_byte_7_s2

Path Statistics:

Clock Skew | 0.002
Hold Relationship | 0.000
Logic Level | 1
Arrival Clock Path Delay | cell: 0.608, 31.543%; route: 1.319, 68.457%
Arrival Data Path Delay | cell: 0.000, 0.000%; route: 0.494, 79.221%; tC2Q: 0.130, 20.779%
Required Clock Path Delay | cell: 0.608, 31.510%; route: 1.321, 68.490%

### Path23

Path Summary:

Slack | 0.669
Data Arrival Time | 2.551
Data Required Time | 1.882
From | camera/runtime_network.receive_reset/release_pipe_2_s1
To | camera/runtime_network.net/write_byte_7_s1
Launch Clk | eth_rx125:[R]
Latch Clk | eth_rx125:[R]

Data Arrival Path:

AT | DELAY | TYPE | RF | FANOUT | LOC | NODE
0.000 | 0.000 | | | | | active clock edge time
0.000 | 0.000 | | | | | eth_rx125
0.000 | 0.000 | tCL | RR | 1 | IOB122[A] | rgmii_rxc_ibuf/I
0.608 | 0.608 | tINS | RR | 825 | IOB122[A] | rgmii_rxc_ibuf/O
1.927 | 1.319 | tNET | RR | 1 | R57C104[2][A] | camera/runtime_network.receive_reset/release_pipe_2_s1/CLK
2.057 | 0.130 | tC2Q | RR | 206 | R57C104[2][A] | camera/runtime_network.receive_reset/release_pipe_2_s1/Q
2.551 | 0.494 | tNET | RR | 1 | R76C97[2][A] | camera/runtime_network.net/write_byte_7_s1/CLEAR

Data Required Path:

AT | DELAY | TYPE | RF | FANOUT | LOC | NODE
0.000 | 0.000 | | | | | active clock edge time
0.000 | 0.000 | | | | | eth_rx125
0.000 | 0.000 | tCL | RR | 1 | IOB122[A] | rgmii_rxc_ibuf/I
0.608 | 0.608 | tINS | RR | 825 | IOB122[A] | rgmii_rxc_ibuf/O
1.929 | 1.321 | tNET | RR | 1 | R76C97[2][A] | camera/runtime_network.net/write_byte_7_s1/CLK
1.882 | -0.048 | tHld | | 1 | R76C97[2][A] | camera/runtime_network.net/write_byte_7_s1

Path Statistics:

Clock Skew | 0.002
Hold Relationship | 0.000
Logic Level | 1
Arrival Clock Path Delay | cell: 0.608, 31.543%; route: 1.319, 68.457%
Arrival Data Path Delay | cell: 0.000, 0.000%; route: 0.494, 79.221%; tC2Q: 0.130, 20.779%
Required Clock Path Delay | cell: 0.608, 31.510%; route: 1.321, 68.490%

### Path24

Path Summary:

Slack | 0.670
Data Arrival Time | 2.537
Data Required Time | 1.867
From | camera/runtime_network.receive_reset/release_pipe_2_s1
To | camera/runtime_network.net/write_mask_3_s0
Launch Clk | eth_rx125:[R]
Latch Clk | eth_rx125:[R]

Data Arrival Path:

AT | DELAY | TYPE | RF | FANOUT | LOC | NODE
0.000 | 0.000 | | | | | active clock edge time
0.000 | 0.000 | | | | | eth_rx125
0.000 | 0.000 | tCL | RR | 1 | IOB122[A] | rgmii_rxc_ibuf/I
0.608 | 0.608 | tINS | RR | 825 | IOB122[A] | rgmii_rxc_ibuf/O
1.927 | 1.319 | tNET | RR | 1 | R57C104[2][A] | camera/runtime_network.receive_reset/release_pipe_2_s1/CLK
2.057 | 0.130 | tC2Q | RR | 206 | R57C104[2][A] | camera/runtime_network.receive_reset/release_pipe_2_s1/Q
2.537 | 0.480 | tNET | RR | 1 | R70C90[2][B] | camera/runtime_network.net/write_mask_3_s0/CLEAR

Data Required Path:

AT | DELAY | TYPE | RF | FANOUT | LOC | NODE
0.000 | 0.000 | | | | | active clock edge time
0.000 | 0.000 | | | | | eth_rx125
0.000 | 0.000 | tCL | RR | 1 | IOB122[A] | rgmii_rxc_ibuf/I
0.608 | 0.608 | tINS | RR | 825 | IOB122[A] | rgmii_rxc_ibuf/O
1.915 | 1.307 | tNET | RR | 1 | R70C90[2][B] | camera/runtime_network.net/write_mask_3_s0/CLK
1.867 | -0.048 | tHld | | 1 | R70C90[2][B] | camera/runtime_network.net/write_mask_3_s0

Path Statistics:

Clock Skew | -0.013
Hold Relationship | 0.000
Logic Level | 1
Arrival Clock Path Delay | cell: 0.608, 31.543%; route: 1.319, 68.457%
Arrival Data Path Delay | cell: 0.000, 0.000%; route: 0.480, 78.730%; tC2Q: 0.130, 21.270%
Required Clock Path Delay | cell: 0.608, 31.755%; route: 1.307, 68.245%

### Path25

Path Summary:

Slack | 0.670
Data Arrival Time | 2.537
Data Required Time | 1.867
From | camera/runtime_network.receive_reset/release_pipe_2_s1
To | camera/runtime_network.net/write_mask_51_s0
Launch Clk | eth_rx125:[R]
Latch Clk | eth_rx125:[R]

Data Arrival Path:

AT | DELAY | TYPE | RF | FANOUT | LOC | NODE
0.000 | 0.000 | | | | | active clock edge time
0.000 | 0.000 | | | | | eth_rx125
0.000 | 0.000 | tCL | RR | 1 | IOB122[A] | rgmii_rxc_ibuf/I
0.608 | 0.608 | tINS | RR | 825 | IOB122[A] | rgmii_rxc_ibuf/O
1.927 | 1.319 | tNET | RR | 1 | R57C104[2][A] | camera/runtime_network.receive_reset/release_pipe_2_s1/CLK
2.057 | 0.130 | tC2Q | RR | 206 | R57C104[2][A] | camera/runtime_network.receive_reset/release_pipe_2_s1/Q
2.537 | 0.480 | tNET | RR | 1 | R70C90[3][A] | camera/runtime_network.net/write_mask_51_s0/CLEAR

Data Required Path:

AT | DELAY | TYPE | RF | FANOUT | LOC | NODE
0.000 | 0.000 | | | | | active clock edge time
0.000 | 0.000 | | | | | eth_rx125
0.000 | 0.000 | tCL | RR | 1 | IOB122[A] | rgmii_rxc_ibuf/I
0.608 | 0.608 | tINS | RR | 825 | IOB122[A] | rgmii_rxc_ibuf/O
1.915 | 1.307 | tNET | RR | 1 | R70C90[3][A] | camera/runtime_network.net/write_mask_51_s0/CLK
1.867 | -0.048 | tHld | | 1 | R70C90[3][A] | camera/runtime_network.net/write_mask_51_s0

Path Statistics:

Clock Skew | -0.013
Hold Relationship | 0.000
Logic Level | 1
Arrival Clock Path Delay | cell: 0.608, 31.543%; route: 1.319, 68.457%
Arrival Data Path Delay | cell: 0.000, 0.000%; route: 0.480, 78.730%; tC2Q: 0.130, 21.270%
Required Clock Path Delay | cell: 0.608, 31.755%; route: 1.307, 68.245%

## Minimum Pulse Width Report:

#### Report Command:report_min_pulse_width -nworst 10 -detail

### MPW1

MPW Summary:

Slack: | -0.688
Actual Width: | 0.212
Required Width: | 0.900
Type: | High Pulse Width
Clock: | eth125
Objects: | camera/stream/ram_ram_0_6_s

Late clock Path:

AT | DELAY | TYPE | RF | NODE
0.000 | 0.000 | | | active clock edge time
0.000 | 0.000 | | | eth125
3.835 | 3.835 | tCL | RR | camera/pll/PLL_inst/CLKOUT1
7.176 | 3.341 | tNET | RR | camera/stream/ram_ram_0_6_s/CLKB

Early clock Path:

AT | DELAY | TYPE | RF | NODE
4.000 | 0.000 | | | active clock edge time
4.000 | 0.000 | | | eth125
5.869 | 1.869 | tCL | FF | camera/pll/PLL_inst/CLKOUT1
7.388 | 1.519 | tNET | FF | camera/stream/ram_ram_0_6_s/CLKB

### MPW2

MPW Summary:

Slack: | -0.688
Actual Width: | 0.212
Required Width: | 0.900
Type: | High Pulse Width
Clock: | eth125
Objects: | camera/stream/ram_ram_0_12_s

Late clock Path:

AT | DELAY | TYPE | RF | NODE
0.000 | 0.000 | | | active clock edge time
0.000 | 0.000 | | | eth125
3.835 | 3.835 | tCL | RR | camera/pll/PLL_inst/CLKOUT1
7.176 | 3.341 | tNET | RR | camera/stream/ram_ram_0_12_s/CLKB

Early clock Path:

AT | DELAY | TYPE | RF | NODE
4.000 | 0.000 | | | active clock edge time
4.000 | 0.000 | | | eth125
5.869 | 1.869 | tCL | FF | camera/pll/PLL_inst/CLKOUT1
7.388 | 1.519 | tNET | FF | camera/stream/ram_ram_0_12_s/CLKB

### MPW3

MPW Summary:

Slack: | -0.688
Actual Width: | 0.212
Required Width: | 0.900
Type: | High Pulse Width
Clock: | eth125
Objects: | camera/runtime_network.net/packet_ram_packet_ram_0_0_s

Late clock Path:

AT | DELAY | TYPE | RF | NODE
0.000 | 0.000 | | | active clock edge time
0.000 | 0.000 | | | eth125
3.835 | 3.835 | tCL | RR | camera/pll/PLL_inst/CLKOUT1
7.176 | 3.341 | tNET | RR | camera/runtime_network.net/packet_ram_packet_ram_0_0_s/CLKA

Early clock Path:

AT | DELAY | TYPE | RF | NODE
4.000 | 0.000 | | | active clock edge time
4.000 | 0.000 | | | eth125
5.869 | 1.869 | tCL | FF | camera/pll/PLL_inst/CLKOUT1
7.388 | 1.519 | tNET | FF | camera/runtime_network.net/packet_ram_packet_ram_0_0_s/CLKA

### MPW4

MPW Summary:

Slack: | -0.688
Actual Width: | 0.212
Required Width: | 0.900
Type: | High Pulse Width
Clock: | eth125
Objects: | camera/stream/ram_ram_1_0_s

Late clock Path:

AT | DELAY | TYPE | RF | NODE
0.000 | 0.000 | | | active clock edge time
0.000 | 0.000 | | | eth125
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
4.000 | 0.000 | | | active clock edge time
4.000 | 0.000 | | | eth125
5.869 | 1.869 | tCL | FF | camera/pll/PLL_inst/CLKOUT1
7.388 | 1.519 | tNET | FF | camera/stream/ram_ram_6_12_s/CLKB

## High Fanout Nets Report:

#### Report Command:report_high_fanout_nets -max_nets 10

FANOUT | NET NAME | WORST SLACK | MAX DELAY
8189 | camera_pclk_d | 0.023 | 4.861
7948 | clk50m_d | 7.277 | 3.328
6772 | camera/cap_rst_n | 1.675 | 3.868
5981 | led_d[0] | 7.277 | 4.800
5898 | camera/clk125 | 0.014 | 3.380
825 | rgmii_rxc_d | 1.490 | 3.599
369 | chassis/telemetry/sender/active_383_12 | 13.787 | 3.185
360 | camera/runtime_network.net/arp_crc_31_8 | 1.011 | 1.965
353 | imu_status/n281_3 | 11.664 | 3.721
341 | chassis/telemetry/diagnostic_enabled.diagnostics/crc/n1714_5 | 13.855 | 3.833

## Route Congestions Report:

#### Report Command:report_route_congestion -max_grids 10

GRID LOC | ROUTE CONGESTIONS
R67C66 | 88.89%
R69C70 | 87.50%
R65C59 | 86.11%
R44C61 | 84.72%
R66C69 | 84.72%
R44C65 | 84.72%
R79C72 | 84.72%
R45C64 | 83.33%
R48C75 | 83.33%
R66C66 | 81.94%

## Timing Exceptions Report:

### Setup Analysis Report

#### Report Command:report_exceptions -setup -max_paths 5 -max_common_paths 1

#### No timing exceptions to report!

### Hold Analysis Report

#### Report Command:report_exceptions -hold -max_paths 5 -max_common_paths 1

#### No timing exceptions to report!

### Recovery Analysis Report

#### Report Command:report_exceptions -recovery -max_paths 5 -max_common_paths 1

#### No timing exceptions to report!

### Removal Analysis Report

#### Report Command:report_exceptions -removal -max_paths 5 -max_common_paths 1

#### No timing exceptions to report!

## Timing Constraints Report:

SDC Command Type | State | Detail Command
TC_CLOCK | Actived | create_clock -name sys50 -period 20 [get_ports {clk50m}]
TC_CLOCK | Actived | create_clock -name cam_pclk -period 11.9047 [get_ports {camera_pclk}]
TC_CLOCK | Actived | create_clock -name eth_rx125 -period 8 [get_ports {rgmii_rxc}]
TC_GENERATED_CLOCK | Actived | create_generated_clock -name control50 -source [get_ports {clk50m}] -divide_by 1 [get_pins {camera/pll/PLL_inst/CLKOUT0}]
TC_GENERATED_CLOCK | Actived | create_generated_clock -name eth125 -source [get_ports {clk50m}] -multiply_by 5 -divide_by 2 [get_pins {camera/pll/PLL_inst/CLKOUT1}]
TC_INPUT_DELAY | Actived | set_input_delay -clock cam_pclk -clock_fall -max 2.0 [get_ports {camera_data[*] camera_href camera_vsync}]
TC_INPUT_DELAY | Actived | set_input_delay -clock cam_pclk -clock_fall -min 0.0 [get_ports {camera_data[*] camera_href camera_vsync}]
TC_INPUT_DELAY | Actived | set_input_delay -clock eth_rx125 -max 2.2 [get_ports {rgmii_rxd[*] rgmii_rxctl}]
TC_INPUT_DELAY | Actived | set_input_delay -clock eth_rx125 -min 1.8 [get_ports {rgmii_rxd[*] rgmii_rxctl}]
TC_INPUT_DELAY | Actived | set_input_delay -clock eth_rx125 -clock_fall -add_delay -max 2.2 [get_ports {rgmii_rxd[*] rgmii_rxctl}]
TC_INPUT_DELAY | Actived | set_input_delay -clock eth_rx125 -clock_fall -add_delay -min 1.8 [get_ports {rgmii_rxd[*] rgmii_rxctl}]
TC_FALSE_PATH | Actived | set_false_path -from [get_ports {reset_n}]
TC_FALSE_PATH | Actived | set_false_path -to [get_pins {camera/perception_reset/release_pipe*/CLEAR}]
TC_FALSE_PATH | Actived | set_false_path -to [get_pins {camera/runtime_network.network_reset/release_pipe*/CLEAR}]
TC_FALSE_PATH | Actived | set_false_path -to [get_pins {camera/runtime_network.receive_reset/release_pipe*/CLEAR}]
TC_FALSE_PATH | Actived | set_false_path -to [get_pins {imu/reader/bus/scl_sync_0_s0/D}]
TC_FALSE_PATH | Actived | set_false_path -to [get_pins {imu/reader/bus/sda_sync_0_s0/D}]
TC_FALSE_PATH | Actived | set_false_path -to [get_pins {chassis/rx/rx_meta_s0/D}]
TC_FALSE_PATH | Actived | set_false_path -to [get_pins {chassis/core/enc_l/ab_meta_0_s0/D}]
TC_FALSE_PATH | Actived | set_false_path -to [get_pins {chassis/core/enc_l/ab_meta_1_s0/D}]
TC_FALSE_PATH | Actived | set_false_path -to [get_pins {chassis/core/enc_r/ab_meta_0_s0/D}]
TC_FALSE_PATH | Actived | set_false_path -to [get_pins {chassis/core/enc_r/ab_meta_1_s0/D}]
TC_CLOCK_GROUP | Actived | set_clock_groups -asynchronous -group [get_clocks {cam_pclk}] -group [get_clocks {sys50 control50 eth125}]
TC_CLOCK_GROUP | Actived | set_clock_groups -asynchronous -group [get_clocks {eth_rx125}] -group [get_clocks {sys50 control50 eth125 cam_pclk}]
