LilywantbecomeNIUBI/fpga-system-integration/docs/MECANUM_NAV_STA_FIX_20261103.md

# STA问题核对与修改

冻结111214Z的实际结果为5557个Setup违例、0个Hold违例，不是合格上板候选。
最差路径omega/10为45.524ns；path数学初始化39.647ns；轨迹步长35.966ns；
LK绝对值29.883ns；相机地址长连线17.791ns/14.491ns。实际CLS59868/69120，
BSRAM241/340；综合232/340不能替代布局后资源。整机布线43分37秒。

修改保持五个时钟原频率，外部引脚、协议及安全许可不变。

| 项目 | 处理 |
|---|---|
| omega/10 | 有界幅值使用共享乘法器，分拍幅值/乘法/寄存符号恢复；最坏幅值22876 |
| planner步长/加速度 | 除10分拍乘法；除20选52429>>20覆盖完整u16。26215公式不是在436899内恒精确，43699即会出错 |
| planner代价/标志 | 预存速度、窗口许可；分拍合计/比较/提交；硬50ms预算不变 |
| 地图清除 | common rst_n直连异步复位；map_enable_q控制同步清除/失效，不生成LUT异步复位树 |
| nav_math | 乘法带符号累计；除法末拍符号恢复并行；开方OR/共享减法；绝对值按16位分段；有效操作延迟不变 |
| histogram | FIFO无复位同步RAM；两份128x32镜像SDP；known寄存器；标签与同址写旁路；VFH/服务等待相应延长 |
| VFH | px/py/py_turn s18，预存转弯偏移；RAM延迟对齐，226参考场景通过 |
| 雷达显示 | 有效角0..35999倒数乘法，72扇区加FIFO输出缓存；逐角验证 |
| LK | PREP_U/PREP_V分段幅值+符号寄存；下一拍仅移位并启动除法；单start/done与原状态恢复保留 |
| 相机帧流 | 同一四bank同深度RAM；写local级与读local级；commit3拍/fill5拍，所有标签同步调整 |

回归中发现旧bench以128字节寄存器保存路径；当前worktree绝对路径加pipeline.txt共129字节，
输出路径被截断。扩大测试路径缓冲并检查fopen，未改变期望像素、流场或周期预算。

CPU并行：本机16GB内存。V1.9.12.04的全部导出Tcl选项与SUG1220未提供线程数选项；
对multi_thread/num_threads/num_cpus/max_threads的显式探测均返回unknown option。
不伪造开启记录，不同时启动多份整机PnR。若发现受支持入口，再依据峰值内存启用。

最终仍以新版冻结整机综合、BSRAM映射、CDC/复位释放、扇出/拥塞与Setup/Hold报告为准。
旧PR1014及eth125 MPW -0.849ns单独记录，不能称完整STA通过。不下载、不写Flash。

当前整机冻结：20261103T125735Z，Place2/Route2，用户单独授权本轮全量。
不把先前失败的111214Z位流当作新版结果。旧完整.pr及SRAM保留，默认后续整机增量不变。

新增验证：18组导航bench通过；实际RTL寄存通路穷举111289个有符号角速度/步长，
全部65536个u16加速度；新旧数学1734例58248拍；新旧直方图2560次读，且在
Gowin综合后SDPB模型中同样通过；VFH226例及综合后原语逐项/周期一致。
光流13组金字塔场景及真实帧流/UDP像素、FCS/IPv4校验均通过。

CPU实际检查：Windows报告20个逻辑处理器，Gowin亲和性1048575（全部20位），
综合时实际21..24个线程。不存在操作系统强制单核限制；这不证明PnR每阶段都能
并行。当前版本没有已确认的线程数Tcl开关，未添加无效/不受支持选项。

核对修正：旧111214Z Recovery最差-2.296ns来自
camera/runtime_network.network_reset/release_pipe_2_s1/Q ->
camera/runtime_network.net/arp_crc_0_s1/PRESET（10.036ns），最差25条采样中
没有导航地图项。地图LUT异步复位改同步清除有结构依据，但不能因此宣称旧最差
Recovery根因已经关闭。新版需独立复核网络复位，不新增false path消除该报告。

新版整机综合审核：73619逻辑、51298寄存器、234/340 BSRAM；nav_histogram
实际整机优化后286个FF、4 SDPB；地图4 SDPB、相机129 SDPB；数学未用通路已裁剪。
注意最终PnR可能因合法SDP宽度转换增加BSRAM，仍以物理报告为准。

## 首次修正版物理结果125735Z

整机布局7分15秒、布线5分8秒，峰值2471MB；旧111214Z布线43分37秒。
布局/布线选项也由Place0/Route2改为Place2/Route2，因此不能把全部收益都归因于RTL。
物理资源74041逻辑、51424寄存器、247/340 BSRAM、154.5/298 DSP。

| 时钟 | 旧最差Setup余量ns | 新余量ns | 新违例数 |
|---|---:|---:|---:|
| sys50 | -25.595 | -0.187 |2 |
| control50 | -9.971 |1.140 |0 |
| cam_pclk | -2.511 |0.721 |0 |
| eth125 | -9.722 | -0.392 |33 |
| eth_rx125 |1.775 |3.059 |0 |

总Setup5557->35，Hold0；Recovery2.740ns、Removal0.348ns通过。
导航64bit mailbox动态52位实际捕获路径与10ns界限通过，所有相关约束Actived，
时钟连接清点通过；但35个Setup未过使完整时序审核保持false。
PR1014及MPW-0.849ns实验边界保留，未下载该位流。

剩余最差sys50在IMU时间新鲜度至电机PWM许可，eth125在网络复位/使能以及
少量帧RAM读地址连线（最差-0.392ns）。125735Z完整.pr/.fs和失败报告均保留。
下一轮131623Z源码/CST/SDC逐字节相同，使用Place2/Route1争取剩余物理余量；
功能证据按哈希复用，所有物理审计重新执行。没有降低时钟或新增时序例外。

## Route1复核与剩余控制路径

131623Z未放行：48个Setup违例，最差-0.391ns；Hold0，control50余量4.231ns、
cam_pclk4.281ns，帧缓存地址路径已通过。Recovery2.740ns、Removal0.339ns通过。
不是更换路由选项就一定改善，故不发布为合格候选。

剩余sys50链来自地图/IMU安全许可至PWM的32位内部phase计数器CE。修正为严格
有界位宽：phase=$clog2(PERIOD)、duty=$clog2(PERIOD+1)、wake_count按wake上限。
不寄存/延迟原始GPIO安全门，不改变任何PWM或唤醒周期。277000拍新旧逐周期
对照（含实际50MHz/10kHz、符号极值、异步禁用/复位）通过。

网络剩余复位至CE存在冗余：命令CDC内部已在非复位分支，却再次使用含复位的
src_ready。保留外部ready复位限定，内部改为request==ack_sync的同等准入。
遥测桥和网络共用同一复位，增加仅内部连接的telemetry_ready_local槽许可，
外部telemetry_ready仍复位限定；桥在自身非复位分支使用槽许可，避免复位再
穿过数据CE。板级端口与协议、丢帧/握手行为不变。

事件仲裁按32位小组保留组合load网络，无新增拍；5000拍新旧仲裁/背压/保持对照通过。
UDP重放字节的三层嵌套选择改为等价互斥掩码OR，不增加FIFO、时钟或字节延迟。
360点/视频/遥测真实线缆字节/FCS回归、麦轮全兼容性回归通过；整机及物理复核重跑。
新冻结134947Z，Place2/Route2，原完整.pr和失败位流均保留。

134947Z综合审核通过：73244逻辑、51138FF、234BSRAM；四路PWM的phase均13位，
wake_count均16位。注意事件仲裁的八组组合load被Gowin合并，实际一个load锥仍
驱动222个非常量payload FF，因此不把“语法分组”称为已经修好物理扇出；
最终按该版本实际STA/扇出结果验收，不能仅依据syn_maxfan属性宣称达到8负载。

## 最终物理审核134947Z

全量整机Place2/Route2完成。Setup0、Hold0；五个时钟域TNS均0。

| 时钟 | Setup最差余量ns |
|---|---:|
| sys50 |0.037 |
| control50 |2.157 |
| cam_pclk |2.764 |
| eth125 |0.005 |
| eth_rx125 |1.861 |

Recovery最差1.560ns、Removal0.303ns；导航CDC52个动态捕获位覆盖完整，
最大数据延迟2.014ns<10ns，相关约束全部Actived；所有五项整机审计通过。
最差余量很薄，报告数值原样保留，不写成宽裕裕量。物理资源73663逻辑、51265FF、
247/340 BSRAM、154.5/298 DSP；相机综合映射129SDPB保持不变，地图4SDPB。

布局8分6秒、布线6分2秒、输出14秒，总PnR14分22秒，峰值2489MB。
旧111214Z布线43分37秒、总PnR48分29秒；源代码及实现选项均有变化，不能把
全部速度收益单独归因于某一项优化或CPU多线程。

PR1014与eth125 MPW-0.849ns是既有实验边界，本轮仍存在；result.passed和
full_sta_signoff仍为false，不冒充完整STA。可以发布带该边界的SRAM实验候选，
须实测标定和车辆验收；未下载SRAM、未写Flash。完整.pr作为后续兼容增量参考保留。

最终验证：18导航RTL bench；35旧麦轮bench及Python回归；原Task4全部检查；
相机13组金字塔oracle及事件/帧流/UDP精确像素与CRC；最新整机12000原始雷达点、
25圈、视频并发、M4/P4/N4 CRC及未使能输出；SDPB原语、新旧算术/直方图/门控
对照与真实LK综合网表检查。最新小修正后的相机包测试复用未改动光流oracle，
事件/帧/UDP及全整机数据通路已重新执行，未把复用当成新增光流实测。
