LilywantbecomeNIUBI/fpga-system-integration/docs/VIDEO_FIX_20261103.md

# Nano 共享页面图传修复（2026-11-03）

## 版本追溯

- `f32b8c5`（10月31日）修复 PC `host/dashboard.py` 的持续视频流，历史验收原图约30 FPS、识别约24 FPS。
- `55b273e`（11月2日）新增 Nano `nano/web_console.py` 入口，重新引入结果与原图串行轮询后等待100ms、预览编码最多10Hz、输出检查20Hz。PC修复没有丢失；新入口遗漏等价回归，不能沿用PC入口的验收结果。
- 本次版本：`nano-video-20261103`，由共享页面 `/api/state` 的 `software_version` 返回。部署目录仍是 `/home/liwei/robot_system_web_20261102`，目录日期不代表源代码版本；见 `evidence/video_fix_20261103/deployment.json` 中本地/远端 SHA256。

## 修改

共享页面的两个MJPEG入口302跳转到同一Nano视觉服务的原图/识别持续流。JSON轮询只供状态和静态截图，不参与浏览器视频供帧。原图按源帧号和时间戳缓存编码；读取缓存与帧键在同一个锁内完成，避免不同浏览器错配帧键。停流时接收进程的历史FPS、识别FPS及共享页面的旧统计会归零。页面“完整收帧”明确表示底层帧率，不能当作浏览器显示FPS。

现场另查到slot0关闭、slot1误指向PC `.10`。已通过既有NCFG接口把slot1恢复到Nano `.20:6102`，ARP确认成功；此端点也承载遥测。没有下载FPGA位流。运行时端点会被其他下载/配置入口覆盖，因此其他工程切换后需要重新核对slot1。

## 验证与限制

10项Nano网页Python测试、6项接收延迟测试及Nano页面JS检查通过。新增每源帧只编码一次（连续30帧）、HTTP在线但视频过期时统计归零、两路视频跳转到源服务等回归。

首次轮询加速方案实际只交付原图23.49/识别20.77 FPS，未作为最终方案；最终采用独立持续流。

`evidence/video_fix_20261103/final_live.json` 是实际公共入口并发取流20秒证据：原图425个不同帧键、20.66 FPS；识别388个不同帧键、18.81 FPS。没有宣称达到30 FPS。测量期间Nano发生重启；重启后CPU四核82–98%占用，接收/事件/推理与packagekitd/gnome-software竞争，底层收帧也下降。需要在稳定设备负载下继续评估30 FPS；识别源本身通常约24 FPS。

复测命令：

```powershell
python tools/measure_video_delivery.py --seconds 30 --out runs/video_delivery.json
```

该工具跟随共享入口的实际跳转，计数MJPEG完整帧及不同帧键，不能用JSON中旧FPS替代验收。

## 负载稳定后的追加验收

`evidence/video_fix_20261103/stable_live.json`：同一最终部署版本，在启动负载降低后，经公共共享页面入口并发取流20秒，原图578个唯一帧键、28.84 FPS；识别564个唯一帧键、28.10 FPS。该窗口队列追赶丢弃事件/包数均为0；末端队列p95约19.95ms。已经解除原10/20 FPS软件上限，尚不宣称持续满30 FPS。软件API返回版本号已核对为nano-video-20261103。
