LilywantbecomeNIUBI/fpga-system-integration/docs/evidence/nano_lidar_fix_20261103/unified_live.png

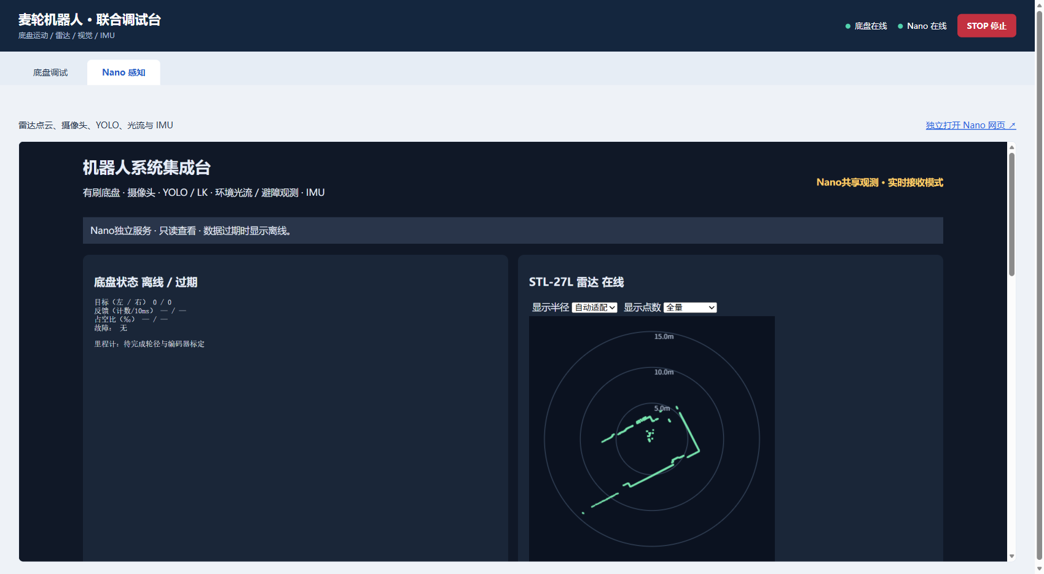
docs/evidence/nano_lidar_fix_20261103/unified_live.png
