LilywantbecomeNIUBI/fpga-system-integration/(commit log)

2026-10-28 docs: plan caster-supported differential chassis integration and FPGA pins
    [pins.csv]
2026-10-28 docs: confirm D157B driver module selection
2026-10-28 feat: implement dual D157B brushed motor FPGA controller and offline validation
2026-10-28 feat: integrate brushed chassis, sensing RTL, Nano gateway and unified console
2026-10-29 Move D157B signals to ADC header and disable retained BLDC stages
    [pins.csv]
2026-10-29 Archive ADC pin remap timing and retained-driver disable evidence
    [pins.csv]
2026-10-29 Make brushed drive speed-loop only and add dedicated tuner
    [motor_build.json, motor_simulations.json, pins.csv]
2026-10-29 Archive verified AT8236 slow-decay PWM diagnostic and console
2026-10-29 Checkpoint brushed speed-loop bring-up and tuning handoff
    [motor_regressions.json]
2026-10-30 feat(motor): improve encoder feedback and add reconnecting wireless tuner
2026-10-30 Record attended chassis tests and add selectable speed and isolated PWM builds
2026-10-30 Integrate optional chassis IMU telemetry and expose IMU status in host console
    [motor_imu_20261030.json]
2026-10-30 Record verified motor and IMU SRAM deployment and static telemetry
    [motor_imu_board_20261030.json]
2026-10-30 Integrate reusable perception observers and isolate brushed chassis control
    [pins.csv]
2026-10-30 Pipeline tracker sorting and simplify frame payload selection
2026-10-30 Improve perception timing, recover LK stalls, and reduce live video latency
    [at8236_pwm.sv, brushed_chassis.sv, brushed_motor_top.sv, calibration.py, capture_process.py, control.py, dashboard.py, encoder_ab.sv]
2026-10-31 Move LK perception and frame ownership to stable 50 MHz processing
    Add ordered frame-event CDC, independent reset/ownership handling, and bounded mailbox constraints. Preserve prior LK fault evidence and archive the verified Place 2 candidate, full digital regressions, and 300-second concurrent board test. MPW remains unresolved and dynamic vehicle acceptance is pending.
    [at8236_pwm.sv, brushed_chassis.sv, brushed_motor_top.sv, calibration.py, capture_process.py, control.py, dashboard.py, encoder_ab.sv]
2026-10-31 Add isolated task-four navigation, LiDAR integration and diagnostic console
    Keep the M2 chassis candidate in a separate top and build flow. Include RPP/VFH+, calibration and ownership gates, replay diagnostics, pin mapping, and offline evidence. Revalidate against the current control50 perception sources; full vehicle PnR and hardware navigation acceptance remain pending.
    [M2_pin_assignment.csv]
2026-11-01 Checkpoint M2 static board validation before scan telemetry
2026-11-01 Add optical flow video background and M2 LiDAR scan telemetry
2026-11-02 docs: audit corridor centering and optical-flow braking
2026-11-02 docs: derive R3X footprint and specify 1 kHz wheel control
2026-11-02 Checkpoint IMU compatibility, RAM LiDAR and telemetry integration
    Save MPU6050/6500 support, STM32 bus comparison, immutable direct-wiring diagnostic sources and board evidence. Include the current 1 kHz wheel, raw LiDAR Ethernet and host changes. Offline regressions pass; direct IMU hardware and full dynamic integration remain pending.
    [pins.csv]
2026-11-02 Record experimental 360-point full-system routing trial and SRAM download
    Bank frame RAM writes and enable resource replication. Preserve explicit timing failures (881 setup, negative pulse width, PR1014); this is not a stable release. Include the exact downloaded image and source snapshot.
    [at8236_pwm.sv, brushed_motor_top.sv, encoder_ab.sv, encoder_diagnostics.sv, event_packet_mux.v, flow_observer.v, frame_transport.sv, imu_1khz_core.v]
2026-11-02 Pipeline frame RAM reads within each bank
    Preserve the routed 550-violation checkpoint. Bank output and cached_word setup pass; full-system timing does not. No hardware download.
2026-11-02 Refactor timing-critical counters, event queues and dispatch words
    Reduce reported setup violations from 550 to 6; sys50 and RX125 reach zero. Preserve the four data setup and two reset-release failures, negative MPW and PR1014. Freeze exact RTL, image and validation evidence. No download.
    [at8236_pwm.sv, brushed_motor_top.sv, encoder_ab.sv, encoder_diagnostics.sv, ethernet_pll_model.v, event_packet_mux.v, flow_observer.v, frame_transport.sv]
2026-11-02 Integrate isolated four-wheel Mecanum chassis with Ethernet telemetry
    [motor.json]
2026-11-02 Migrate verified timing fixes to raw Mecanum system and harden ARP retry paths
    [at8236_pwm.sv, brushed_motor_top.sv, cordic_sincos.sv, encoder_ab.sv, encoder_control_scale.sv, encoder_diagnostics.sv, event_packet_mux.v, flow_observer.v]
2026-11-02 Fix Nano viewer video throttling and expire stale FPS
    [capture_process.py, preview.py, web_console.py]
2026-11-02 Pin verified Nano video baseline with frozen runtime and recovery archives
2026-11-02 Verify router Mecanum control on raised-wheel hardware
2026-11-02 Enable online wireless debugging and fresh per-process telemetry observation
2026-11-03 Add pipelined 1kHz Mecanum wheel control and extended pose goals
    [motor.json]
2026-11-03 Validate optimized 1kHz firmware on hardware and correct raised-wheel evidence
2026-11-03 Record IMU reconnection stationary and low-speed verification
2026-11-03 Verify IMU after supply change and SRAM reload
2026-11-03 Restore complete live LiDAR scans with a dedicated Nano receiver
2026-11-03 Publish board-verified full-system SRAM bitstream and checksum
2026-11-03 Add opt-in Mecanum navigation and teach-and-repeat controls
    * Add opt-in Mecanum navigation and teach-and-repeat controls
    * Verify hashes for existing vision reset adaptations
    [at8236_pwm.sv, command_cdc.sv, console.py, event_packet_mux.v, flow_observer.v, gui.py, mc_nav_cell_index.sv, mc_nav_direction_gate.sv]
